gredzikk/kubisat/hardware/resource/RP2040-zero-09.png

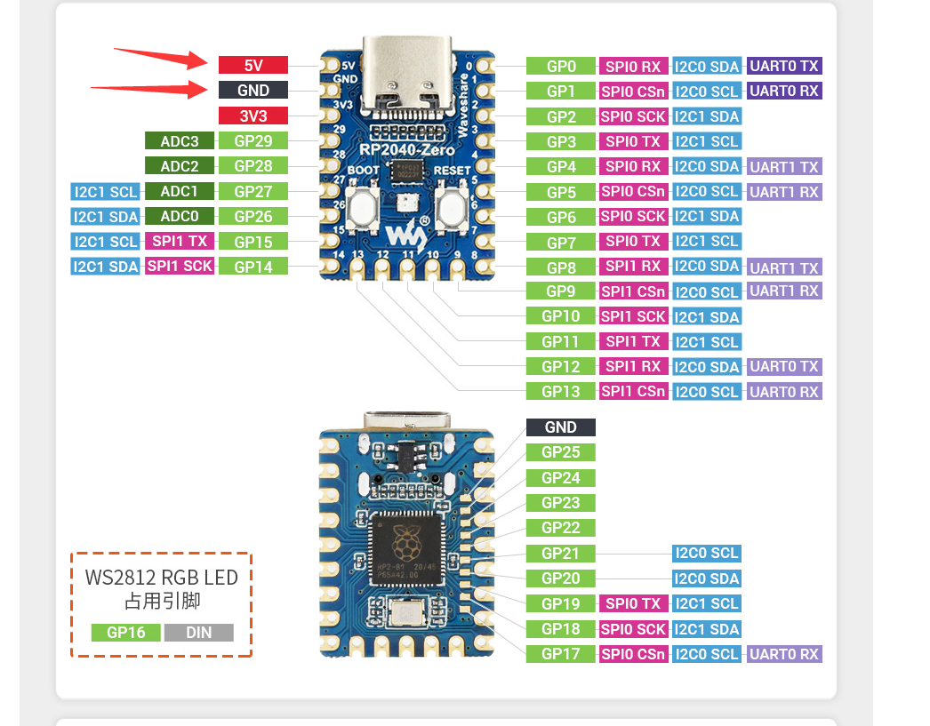
hardware/resource/RP2040-zero-09.png
