gredzikk/kubisat/hardware/resource/6bpcdpvqeob91.webp

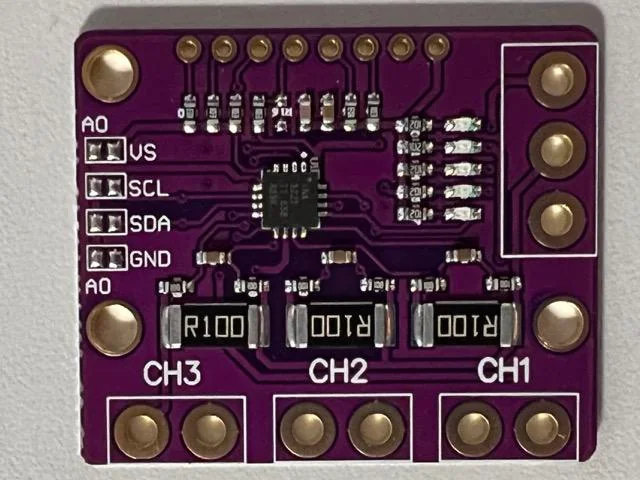
hardware/resource/6bpcdpvqeob91.webp
