gredzikk/kubisat/main.pdf

### Uniwersytet Mikołaja Kopernika w Toruniu

### Wydział Matematyki i Informatyki

### Jakub Gr˛edzicki

nr albumu: 316246

Praca dyplomowa inzynierska ˙

na kierunku Informatyka

# Budowa i działanie amatorskiego mikrosatelity w formacie CubeSat

Promotor

dr Marta Burzanska ´

Torun 2025 ´

# Spis tresci ´

1 Wst˛ep | 1
1.2 Przegl ˛ad aktualnych rozwi ˛azan | ´ | 2
2 Projekt | 6
3 Warstwa sprz˛etowa | 10
4 Software | 31
4.3 Menadzer stanu systemu | ˙ | 39
4.4 Menadzer zasilania | ˙ | 41
4.5 System zdarzen | ´ | 43

5 System operatora satelity | 72
6 Testy | 80
6.1 Testy polecen | ´ | 80
7 Podsumowanie | 84
7.2 Mozliwo ˙ | sci rozwoju | ´ | 84

# Wst˛ep

## 1.1 Wprowadzenie

W dzisiejszych czasach kosmiczne projekty uzytkowe, takie jak satelity mete- ˙

orologiczne, obserwacyjne, systemy nawigacyjne GPS czy Galileo, systemy telefonii

satelitarnej i Internetu, s ˛a powszechne w naszym codziennym zyciu. ˙

Wzrost liczby startów rakiet nosnych, rozwój współpracy agencji kosmicznych z ´

przemysłem i nauk ˛a oraz spadek cen komponentów elektronicznych i specjalistycz-

nych materiałów, umozliwiły mniejszym przedsi˛ebiorstwom specjalizuj ˛acym si˛e w okre- ˙

slonych obszarach technologii, udział w opracowaniu i przygotowaniu do wystrzelenia ´

sztucznych satelitów.

Koszty wysyłki sprz˛etu w przestrzen kosmiczn ˛a s ˛a przeliczane w dolarach na kilo- ´

gram masy ładunku, okreslanego jako tzw. payload. Współcze ´ | snie, komercyjne satelity ´

tworzone przez uczelnie i konsorcja, takze polskie, s ˛a faktem. ˙

Elektronika w przestrzeni kosmicznej to nie tylko sztuczne satelity, ale takze sys- ˙

temy kontrolne rakiet, łazików czy tez kombinezonów przeznaczonych do pracy pod- ˙

czas tzw. spacerów kosmicznych.

Sztuczne satelity mozna podzieli ˙ | c nie tylko ze wzgl˛edu na funkcjonalno ´ | s´c ale ´

takze z uwagi na rozmiary, a dokładniej - mas˛e startow ˛a: ˙

- Minisatelity - od 100 do 500 kg,
- Mikrosatelity - od 10 do 100 kg,
- Nanosatelity - od 1 do 10 kg,
- Pikosatelity - od 0,1 do 1 kg.
- Femtosatelity - ponizej 100 g. ˙
Jak widac, do kategorii satelitów małych mo ´ | zna zaliczy ˙ | c nawet relatywnie ci˛e ´ | zkie ˙
urz ˛adzenia, umozliwiaj ˛ace ˙ | swiadczenie usług komercyjnych. ´
Z uwagi na wci ˛az du ˙ | ze koszty wi ˛a ˙ | z ˛ace si˛e z wystrzeleniem aparatury na orbit˛e ˙

okołoziemsk ˛a, nowe firmy wkraczaj ˛ace w branz˛e space inwestuj ˛a głównie w mniejsze ˙

konstrukcje - nanosatelity.

Szczególnie obiecuj ˛acy okazuje si˛e przy tym standard znany jako CubeSat - jest

to szczególna grupa nanosatelitów o masie rz˛edu około 1-2 kg oraz formie, b˛ed ˛acej

wielokrotnosci ˛a “kostki jednostkowej"o wymiarach 100x100x113,5 mm [13], okre ´ | slanej ´

mianem unit st ˛ad tez cz˛esto spotykane oznaczenia typu 1U, 2U, 3U b ˛ad´z 6U. ˙

Najcz˛esciej stosowane s ˛a konstrukcje u ´ | zytkowe maj ˛ace wymiary na poziomie 3U ˙

podczas gdy mniejsze satelity (głównie 1U, rzadziej 2U) s ˛a ch˛etnie opracowywane

przez zespoły studenckie z wyzszych uczelni technicznych czy nawet amatorów elek- ˙

troniki.

Ograniczenia masowe i wymiarowe popychaj ˛a konstruktorów do stosowania nie-

zwykle interesuj ˛acych rozwi ˛azan, umo ´ | zliwiaj ˛acych zwi˛ekszenie funkcjonalno ˙ | sci minia- ´
turowego satelity juz po jego wystrzeleniu w otwart ˛a przestrze ˙ | n kosmiczn ˛a. ´

Otwarcie dost˛epu do przestrzeni kosmicznej - przede wszystkim niskiej orbity

okołoziemskiej - dla małych i srednich firm oraz wy ´ | zszych uczelni technicznych po- ˙
woduje, ze ro ˙ | snie liczba przedsi˛ebiorstw oraz projektów badawczych zwi ˛azanych z ´

branz ˛a space. ˙

## 1.2 Przegl ˛ad aktualnych rozwi ˛azan´

### 1.2.1 PW-SAT2

PW-Sat2 to innowacyjny projekt studentów Politechniki Warszawskiej, którego

głównym celem technologicznym było skonstruowanie i przetestowanie autorskiego

systemu deorbitacji. Podczas misji zostały przetestowane takze czujnik Sło ˙ | nca oraz ´

system otwieranych paneli słonecznych.

Studenci PW wpadli na pomysł, by po zakonczeniu swojej planowej misji satelita ´

rozwin ˛ał specjalny zagiel, który stopniowo obni ˙ | zaj ˛ac orbit˛e - spowoduje samoczynne ˙

spłoni˛ecie satelity w atmosferze. Dzi˛eki zastosowaniu odpowiedniej konstrukcji opartej

na spr˛ezynach płaskich oraz supercienkiej folii mylarowej, powierzchnia w pełni rozło- ˙

zonego ˙ | zagla wynosiła około 4m ˙

2
. Tak duza powierzchnia poprzez zwi˛ekszenie oporu ˙

aerodynamicznego skutecznie spowolniła ruch satelity i spowodowała jego deorbitacj˛e.

### 1.2.2 ARDUSAT

W 2013 roku wystrzelono w przestrzen kosmiczn ˛a dwa nanosatelity bazuj ˛ace na ´

platformie Arduino ArduSat-1 i ArduSat-X. Dwa bli´zniacze satelity o rozmiarze 1U były

wyposazone w komputery pokładowe o architekturze hierarchicznej (jeden procesor ˙

główny ATmega2561 zarz ˛adzaj ˛acy az szesnastoma podrz˛ednymi mikrokontrolerami ˙

ATmega328P, przeznaczonymi do realizacji poszczególnych eksperymentów).

Na pokładzie niepozornych konstrukcji znalazły si˛e liczne czujniki, w tym 3-osiowe

magnetometry, akcelerometry i zyroskopy, pirometry MLX90614, półprzewodnikowe ˙

czujniki temperatury TMP102, a takze sensory nat˛e ˙ | zenia ˙ | swiatła TSL2561, podwójne ´

liczniki Geigera, spektrometry optyczne oraz 1,3-megapikselowe kamery. CubeSaty

komunikowały si˛e z Ziemi ˛a za pomoc ˛a półdupleksowych transceiverów UHF w pasmie ´

435...438 MHz.

### 1.2.3 FossaSat-1

FossaSat-1 to kolejne osi ˛agni˛ecie w technologii pikosatelitarnej. Dzi˛eki swoim

rozmiarom wynosz ˛acym zaledwie 5 x 5 x 5 cm i wadze zaledwie 250 g jest jednym z

najmniejszych satelitów, jakie kiedykolwiek wystrzelono w przestrzen kosmiczn ˛a. ´

FossaSat-1 zapewnia bezpłatn ˛a komunikacj˛e IoT typu open source na całym

swiecie przy u ´ | zyciu niedrogich modułów radiowych LoRa, dzi˛eki którym studenci i ama- ˙

torzy radiotechniki mog ˛a komunikowac si˛e z satelit ˛a. ´

## 1.3 Cel pracy

Celem pracy było opracowanie oraz wykonanie od podstaw modelu mikrosatelity

zdolnego do odbycia lotu na balonie stratosferycznym w celu dokonania podstawowych

pomiarów oraz przetestowania sposobów komunikacji na odległos´c.´

Głównym motywem była ciekawos´c, ch˛e ´ | c poszerzenia wiedzy i umiej˛etno ´ | sci a ´

takze zainteresowanie technologiami kosmicznymi, informatyk ˛a oraz elektronik ˛a. Zde- ˙

cydowałem si˛e na samodzielne rozwi ˛azanie z racji wysokich kosztów rozwi ˛azan ko- ´

mercyjnych.

Ci ˛agły rozwój elektroniki uzytkowej i mo ˙ | zliwo ˙ | sci technologiczne pozwalaj ˛a na bu- ´

dow˛e tego typu satelit coraz mniejszym kosztem - dysponuj ˛ac budzetem 30 tys. euro ˙

jest mozliwym zbudowanie i wystrzelenie mikrosatelity na orbit˛e LEO. ˙

Przez coraz wi˛eksz ˛a dost˛epnos´c technologii space-grade powstały nawet spe- ´

cjalne serwisy oferuj ˛ace sprzedaz cz˛e ˙ sci i modułów do satelit jednak ich ceny nadal ´

s ˛a bardzo wysokie i cz˛esto nieosi ˛agalne bez sponsora lub innej formy finansowego

wsparcia.

Zmotywowało to mnie do zaprojektowania i zbudowania modelu satelity formatu

CubeSat b˛ed ˛acego w stanie odbyc co najmniej lot balonem stratosferycznym. ´

## 1.4 Zakres pracy

W niniejszej pracy poza w pełni samodzielnym projektem i wykonaniem skorzy-

stałem w pewnym stopniu z istniej ˛acych juz rozwi ˛aza ˙ | n - najcz˛e ´ | sciej sprawdzonych - ´

przeprowadzaj ˛ac na nich ewentualne modyfikacje.

Zakres pracy obejmuje trzy główne etapy: software, hardware oraz dokumentacj˛e.

### 1.4.1 Dokumentacja

- Spis wymagan funkcjonalnych i niefunkcjonalnych ´
- Diagram działania systemu operacyjnego
- Schemat obwodów elektronicznych modelu
- Zdefiniowanie modelu danych do komunikacji z modelem

### 1.4.2 Strona programowa

- Napisanie głównego programu kontroluj ˛acego prac˛e modelu
- Napisanie programu do obsługi stacji naziemnej do zdalnej komunikacji
- Testy jednostkowe i funkcjonalne

### 1.4.3 Strona sprz˛etowa

- Stworzenie obwodów drukowanych PCB
- Montaz podzespołów ˙
- Testy sprz˛etu
Przejscie wszystkich etapów powinno da ´ | c w wyniku operacyjny model satelity ´
zdolny do prowadzenia pomiarów podstawowych wielkosci fizycznych oraz umo ´ | zliwa- ˙

j ˛acym komunikacj˛e w trybie half-duplex w celu kontroli modelu oraz przesyłania zgro-

madzonych danych.

Dodatkowo w ramach pracy zaprojektowałem i skonstruowałem tez prost ˛a stacj˛e ˙

naziemn ˛a pozwalaj ˛aca na komunikacj˛e z modelem na odległos´c.´

## 1.5 Struktura pracy

Praca składa si˛e z XX rozdziałów. Rozdział pierwszy poza wprowadzeniem do

tematyki mikrosatelitów i technologii kosmicznej, oraz opisem wybranych projektów o

podobnej tematyce i funkcjonalnosci, zawiera tak ´ | ze zakres działa ˙ | n przeprowadzonych ´

w celu spełnienia stawianych załoze˙ n.´

W rozdziale drugim zdefiniowałem wymagania zarówno funkcjonalne jak i nie-

funkcjonalne przedstawianego projektu, przedstawiłem uzyte narz˛edzia oraz technolo- ˙

gie, oraz zaprezentowałem schemat blokowy modelu.

Rozdział trzeci zawiera opis projektu od strony sprz˛etowej, czyli wybór elementów

elektronicznych, wybrane schematy obwodów oraz opis wykonania.

Na rozdział czwarty składaj ˛a si˛e opisy i analizy poszczególnych elementów opro-

gramowania steruj ˛acego.

W rozdziale pi ˛atym znajduje si˛e prezentacja przykładowych danych zgromadzo-

nych podczas testu funkcjonalnego modelu oraz analiza wyników.

Ostatni rozdział to całokształt wykonanych prac, a takze wyci ˛agni˛ete przeze mnie ˙

wnioski podczas procesu tworzenia modelu.

# Projekt

## 2.1 Wprowadzenie

Całos´c projektu tworz ˛a dwa ´ | sci ´ sle poł ˛aczone ze sob ˛a moduły: ´
- sprz˛etowy - w jego skład wchodz ˛a: procesor, który kontroluje działanie pozosta-

łych podsystemów, a takze zestaw czujników zbieraj ˛acych dane fizyczne, moduł ˙

komunikacji odpowiadaj ˛acy za przesyłanie danych do i z satelity, moduł GPS

słuz ˛acy do okre ˙ | slenia pozycji oraz system zasilania. Cało ´ | s´c jest poł ˛aczona za ´

pomoc ˛a obwodów drukowanych i zamkni˛eta w obudowie formatu 1U.

- programowy - jego główn ˛a cz˛esci ˛a jest oprogramowanie pracuj ˛ace w pami˛eci ´

procesora, za posrednictwem portów IO i szyn komunikacyjnych jest w stanie ´

zarz ˛adzac cz˛e ´ | sci ˛a sprz˛etow ˛a projektu, realizowa ´ | c operacje odczytu i zapisu do ´
pami˛eci a takze odpowiada ˙ | c na pakiety komunikacyjne. ´

W ponizszym rozdziale omówiłem niektóre aspekty implementacji projektu. ˙

## 2.2 Wymagania funkcjonalne

System musi spełniac nast˛epuj ˛ace wymagania funkcjonalne: ´

- Wysyłanie danych z pomiarów do stacji naziemnych na z ˛adanie - jednorazowo ˙

lub cyklicznie

- Mozliwo ˙ s´c zmiany konfiguracji poprzez zdalne polecenie ´
- Odpowiednie reagowanie i odpowiadanie na polecenia
- Rejestrowanie danych z czujników i podsystemów do pami˛eci nieulotnej
- Podstawowa weryfikacja i kontrola poprawnosci przesyłanych danych ´
- Wykrywanie i raportowanie anomalii w systemie oparte na systemie zdarzen´
- Wszystkie operacje musz ˛a byc wykonywane w okre ´ | slonym czasie, np. przesył ´
danych nie moze trwa ˙ | c dłu ´ | zej ni ˙ | z 2 sekundy. ˙

## 2.3 Schemat blokowy modelu

Rysunek ponizej przedstawia ogólny schemat budowy modelu od strony sprz˛eto- ˙

wej. Cały system jest podzielony na mniejsze, cz˛esciowo niezale ´ | zne sekcje: ˙
- Procesor - jego głównymi zadaniami jest kontrola układów podrz˛ednych, obłsuga

pami˛eci oraz kodowanie i dekodowanie pakietów komunikacji modułu radiowego.

- Zasilanie - w skład sekcji wchodz ˛a ogniwa fotowoltaiczne, ładowarki, kontroler

zasilania oraz magazyn energii.

- Pami˛ec - na t ˛a cz˛e ´ | s´c składa si˛e karta pami˛eci SD która rejestruje dane teleme- ´

tryczne, pomiary z czujników oraz zdarzenia systemowe

- Komunikacja - podstaw ˛a tego podsystemu jest moduł radiowy działaj ˛acy w trybie

half-duplex oraz antena - słuz ˛a do wysyłania i odbierania danych telemetrycz- ˙

nych, kontrolnych oraz konfiguracyjnych

- Czujniki - ta sekcja składa si˛e z zestawu czujników maj ˛acych za zadanie dokony-
wac pomiarów ró ´ | znych wielko ˙ | sci fizycznych w trakcie lotu ´

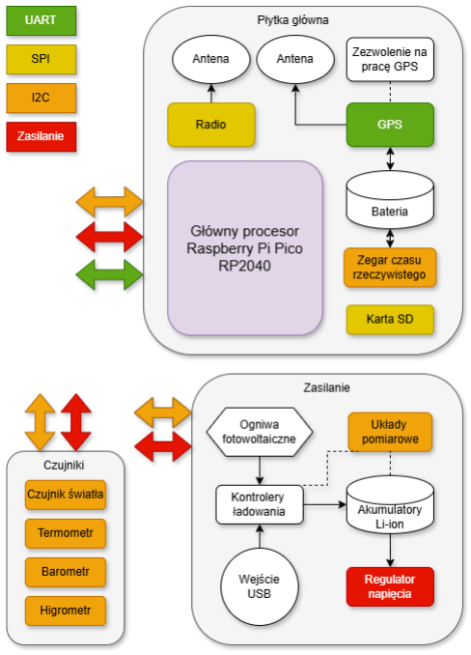
[picture p3: figure]

Rysunek 1: Schemat blokowy

## 2.4 Wykorzystane narz˛edzia

Do implementacji oprogramowania uzyłem ˙ srodowiska programistycznego Visual ´

Studio Code firmy Microsoft które jest wszechstronnym IDE wspieraj ˛acym proces two-

rzenia oprogramowania na mikrokontrolery oraz pozwalaj ˛acym na sprawne debugowa-

nie i monitorowanie działania aplikacji. Kompilacja odbywa si˛e przy uzyciu CMake. Za ˙

dostarczenie bibliotek do obsługi peryferiów mikrokontrolera odpowiada Pi Pico SDK.

W trakcie powstawania projektu korzystałem takze z platformy GitHub jako systemu ˙

kontroli wersji w celu łatwego kontrolowania zmian zachodz ˛acych w strukturze kodu.

Fusion 360 stworzony przez Autodesk były kluczowy w procesie projektowania

modelu 3d satelity. Do projektowania układów elektronicznych i obwodów drukowanych

uzyłem programu KiCad który jest open-source, a dzi˛eki du ˙ | zej dost˛epno ˙ | sci bibliotek ´
oraz rozbudowanej funkcjonalnosci pozwolił sprawnie wykona ´ | c projekt. Zarz ˛adzanie ´

projektem zrealizowałem przy uzyciu Trello produkcji Atlassian oraz funkcji Github Is- ˙

sues, co umozliwiło łatw ˛a organizacj˛e zada ˙ | n, kontrol˛e nad post˛epami w projekcie oraz ´

sledzenie bugów i wprowadzanie poprawek. ´

Wydrukowanie obudowy satelity oraz wyprodukowanie obwodów drukowanych

zrealizowałem korzystaj ˛ac z oferty firmy JLCPCB, która oferuje usługi wytwarzania ob-

wodów drukowanych w praktycznie dowolnej konfiguracji oraz drukowania 3D w wielu

technologiach.

# Warstwa sprz˛etowa

Dobór elementów elektronicznych do prezentowanego projektu nie był łatwym za-

daniem poniewaz wymagał gł˛ebszej analizy specyfikacji poszczególnych układów i ele- ˙

mentów dyskretnych w celu spełnienienia wi˛ekszych wymagan ni ´ | z typowa naziemna ˙
elektronika uzytkowa. Za cel stawiaj ˛ac sobie stworzenie modelu zdolnego odby ˙ | c lot ´

balonem stratosferycznym konieczne było dobranie elementów zdolnych do pracy w

szerszym zakresie temperatur. Bior ˛ac pod uwag˛e wysokos´c nad poziomem morza na ´

jak ˛a jest w stanie wznies´c si˛e tego typu balon odbiornik GPS równie ´ | z musi mie ˙ | c wi˛ek- ´
sze mozliwo ˙ | sci mi˛edzy innymi zdolno ´ | s´c pracy do wysoko ´ | sci 50000 m n.p.m. ´
Wi˛eksza wysokos´c oznacza równie ´ | z ni ˙ | zsz ˛a temperatur˛e co z kolei wymaga bar- ˙

dziej dokładnego zaprojektowania układu zasilania oraz izolacji termicznej całej obu-

dowy tak aby cenne ciepło zostawało w srodku. Kluczowym podzespołem s ˛a akumula- ´

tory, których pojemnos´c i sprawno ´ | s´c drastycznie spada wraz ze spadkiem temperatury. ´

Warstw˛e sprz˛etow ˛a podzieliłem na 3 osobne płytki b˛ed ˛ace niezaleznymi modu- ˙

łami.

## 3.1 Moduł zasilania

W skład tego modułu wchodz ˛a akumulatory wraz z zabezpieczeniami, układy

ładowania, przetwornica napi˛ecia oraz układ pomiarowy.

Interfejs tej płytki stanowi gniazdo JST 6 pin w którym umiesciłem sygnały szyny ´

I2C do komunikacji z układem pomiarowym, napi˛ecie wyjsciowe przetwornicy 5V oraz ´

dwa piny potencjału masowego. Ponizej umie ˙ | sciłem schemat przedstawi ˛acy przepływ ´
energii oraz zalezno ˙ | sci mi˛edzy poszczególnymi podzespołami. ´

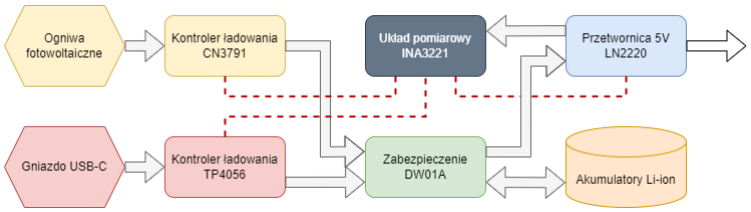
[picture p4: figure]

Rysunek 2: Diagram modułu zasilania

Magazyn energii stanowi ˛a dwa akumulatory litowo-jonowe w powszechnym for-

macie 18650 o napi˛eciu nominalnym 3.7V i pojemnosci 2000mAh. Łacz ˛ac je szere- ´

gowo uzyskałem ł ˛aczn ˛a pojemnos´c na poziomie 4000mAh. ´

Podczas pracy procesora z akumulatorów pobierany jest pr ˛ad o wartosci około ´

40mA co pozwala na teoretyczny czas pracy na poziomie 100 godzin. W praktyce czas

ten jest krótszy ze wzgl˛edu na inne układy pobieraj ˛ace pr ˛ad oraz straty w przetwornicy

napi˛ecia. Moduł GPS skonfigurowany w trybie High-Performance mode pobiera pr ˛ad

o wartosci około 80mA co w sumie daje 120mA - co skraca czas pracy 33 godzin. W ´

praktyce przelot balonu stratosferycznego trwa około 3 godzin co pozwala na zapew-

nienie zasilania przez cały lot.

Korzystaj ˛ac z tego faktu zaprojektowałem system zasilania tak aby mógł byc ła- ´

dowany na ziemi przez gniazdo USB typu C. Projekt przewiduje montaz paneli fotowol- ˙

taicznych na obudowie satelity w celu zbadania mozliwo ˙ sci ładowania akumulatorów w ´

trakcie lotu przez pomiar pr ˛adów i napi˛ec oraz pó´zniejsz ˛a analiz˛e tych danych. ´

### 3.1.1 Układ pomiaru napi˛ec i pr ˛adów ´

W trakcie pracy konieczny jest pomiar napi˛ecia baterii oraz napi˛ecia przetwornicy

5V, a takze pr ˛adów ładowania i rozładowania. Do tego celu u ˙ | zyłem układu INA3221, ˙
który pozwala na pomiar napi˛ec i pr ˛adów na trzech niezale ´ | znych kanałach. [6] Układ ˙

ten jako jedyny jest zasilany napi˛eciem 5V a komunikacja z układem steruj ˛acym od-

bywa si˛e po szynie I2C - konieczny jest konwerter poziomów logicznych z 5V na 3.3V

poniewaz na takim poziomie napi˛e ˙ | c operuje procesor. ´

INA3221 umozliwiaj pomiar pr ˛adu przez pmiar spadku napi˛ecia na rezystorach ˙

bocznikowych. Układ charakteryzuje si˛e wysok ˛a dokładnosci ˛a pomiaru ( ´ | ±0.5%) oraz

niskim poborem pr ˛adu (około 1mA w trybie pracy ci ˛agłej). Zastosowałem nast˛epuj ˛ace

konfiguracje kanałów pomiarowych:

Kanał Opis

1 | Napi˛ecie baterii i ładowanie USB
2 | Napi˛ecie przetwornicy 5V
3 | Pr ˛ad ładowania z paneli fotowoltaicznych

Tabela 3.1: Konfiguracja kanałów pomiarowych INA3221

Dzi˛eki rejestrowi konfiguracyjnemu mozliwe jest ustawienie liczby u ˙ | srednie ´ | n dla ´

pojedynczego pomiaru (od 1 do 1024), co pozwala na zwi˛ekszenie dokładnosci kosz- ´

tem cz˛estotliwosci akwizycji danych. W moim projekcie zastosowałem u ´ | srednianie 16 ´

próbek w ci ˛agłym trybie pracy, co zapewnia dobr ˛a równowag˛e mi˛edzy dokładnosci ˛a a ´

szybkosci ˛a pomiaru. ´

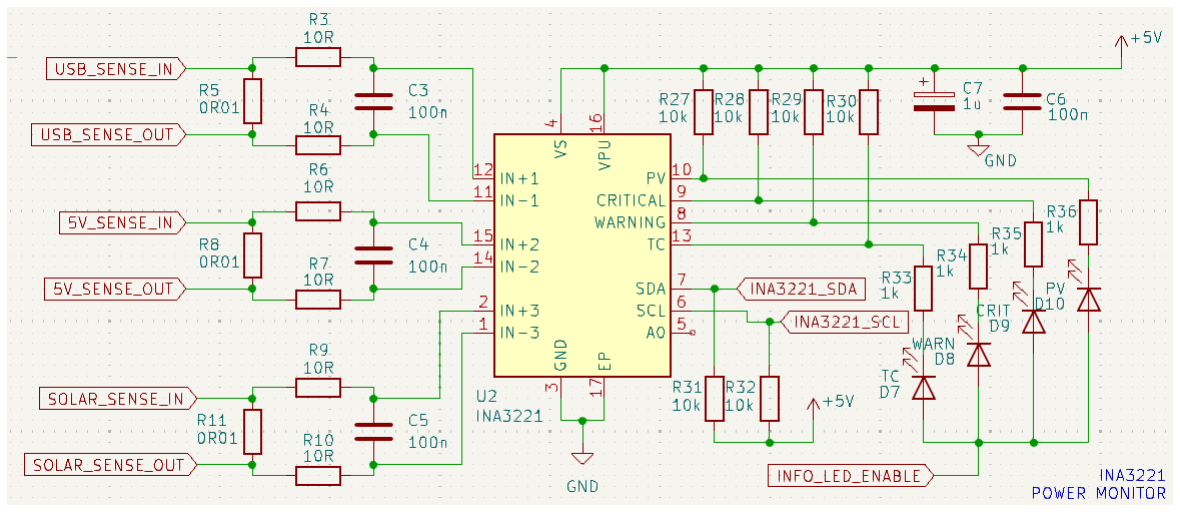
[picture p5: figure]

Rysunek 3: Schemat układu pomiarowego

### 3.1.2 Zabezpieczenie akumulatorów

Do zabezpieczenia akumulatorów uzyłem układu DW01A b˛ed ˛acego jednocze- ˙

snie zabezpieczeniem przed nadmiernym naładowaniem oraz rozładowaniem. Mini- ´

malne napi˛ecie akumulatorów jest ograniczone do 2.4V a maksymalne do 4.3V. Za-

chowuj ˛ac napi˛ecie akumulatorów mi˛edzy tymi dwiema wartosciami skutecznie chroni ´

je to przed degradacj ˛a i uszkodzeniem.

Układ DW01A współpracuje z podwójnym tranzystorem MOSFET FS8205A, two-

rz ˛ac pełne zabezpieczenie akumulatorów. Tranzystor FS8205A zawiera dwa kanały

typu N poł ˛aczone szeregowo ´zródłami, co tworzy przeł ˛acznik dwukierunkowy umoz-˙

liwiaj ˛acy odci˛ecie przepływu pr ˛adu zarówno podczas ładowania jak i rozładowywa-

nia. Taka konfiguracja eliminuje potrzeb˛e stosowania dodatkowych diod zabezpiecza-

j ˛acych.

W normalnym trybie pracy układ DW01A pobiera jedynie około 3 µA, co minimali-

zuje jego wpływ na samorozładowanie akumulatorów [3] Dzi˛eki zastosowaniu obudowy

SOT-23-6 zajmuje równiez niewiele miejsca na płytce PCB, co jest istotne przy kom- ˙

paktowej konstrukcji urz ˛adzenia.

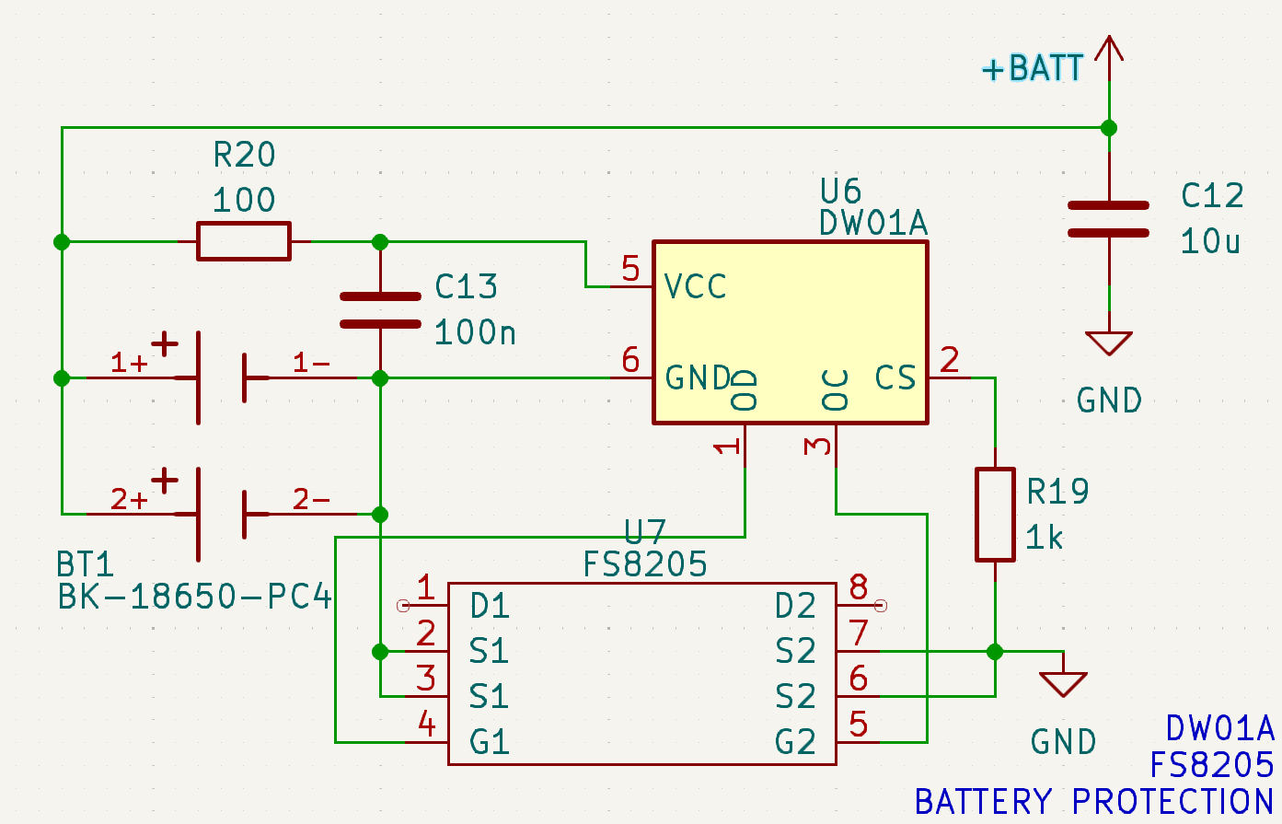
[picture p6: figure]

Rysunek 4: Schemat zabezpieczenia akumulatorów

### 3.1.3 Ładowarka 1 (USB)

W celu ładowania akumulatorów przez gniazdo USB typu C wykorzystałem po-

wszechnie stosowany układ TP4056, jego dost˛epnos´c jest bardzo wysoka i bardzo ła- ´

two go zintegrowac do własnego rozwi ˛azania. Maksymalne napi˛ecie zasilania TP4056 ´

to 8V jednak piny steruj ˛ace CC1 i CC2 gniazda USB skonfigurowałem tak aby napi˛e-

cie było równe 5V. Pr ˛ad ładowania jest konfigurowalny w zakresie 130-1000mA. Aby

ograniczyc wydzielanie ciepła w trakcie ładowania ograniczyłem je do około 780mA. ´

Układ TP4056 implementuje algorytm ładowania CC/CV (stały pr ˛ad/stałe napi˛e-

cie) odpowiedni dla akumulatorów litowo-jonowych. W pierwszej fazie ładowania do-

starcza stały pr ˛ad ustawiony za pomoc ˛a rezystora RPROG, po czym przechodzi do fazy

stałego napi˛ecia 4.2V, gdy akumulator osi ˛agnie odpowiedni poziom naładowania. Efek-

tywnos´c energetyczna układu wynosi około 80%, co jest typow ˛a warto ´ | sci ˛a dla linio- ´

wych ładowarek tego typu.

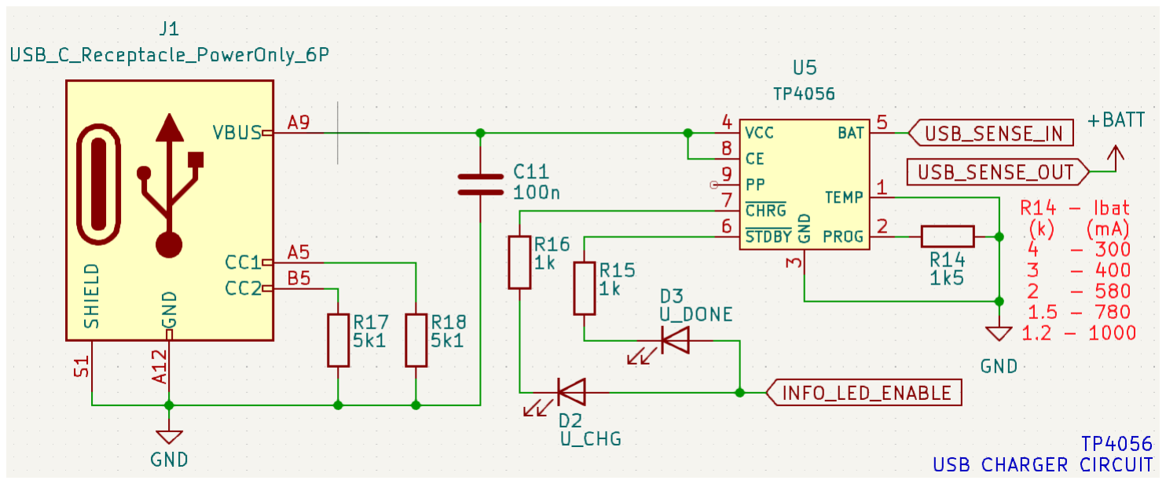
[picture p7: figure]

Rysunek 5: Schemat układu ładowania USB

### 3.1.4 Ładowarka 2 (panele fotowoltaiczne)

Do ładowania akumulatorów z paneli fotowoltaicznych zastosowałem układ CN3791.

Jest to kontroler ładowania MPPT (Maximum Power Point Tracking), który automatycz-

nie dostosowuje punkt pracy paneli fotowoltaicznych tak, aby uzyskac maksymaln ˛a ´

mozliw ˛a moc. Układ mo ˙ | ze pracowa ˙ | c z napi˛eciem wej ´ | sciowym od 4.5V do 28V, co po- ´

zwala na wykorzystanie szerokiej gamy paneli słonecznych.

CN3791 równiez realizuje algorytm ładowania CC/CV, jednak w przeciwie ˙ | nstwie ´

do TP4056 jest to przetwornica impulsowa typu buck, co zapewnia wi˛eksz ˛a sprawnos´c´

energetyczn ˛a przy konwersji napi˛ecia (do 96%). Napi˛ecie pracy MPPT ustawiłem na

poziom 4.9V, co jest optymalne dla zastosowanych paneli fotowoltaicznych.

Do sprawdzenia mozliwo ˙ | sci ładowania akumulatorów u ´ | zyłem ogniw o nast˛epuj ˛a- ˙

cych parametrach:

| | Parametr | Wartos´c´

Napi˛ecie znamionowe 5,5 V

| | Pr ˛ad znamionowy | 110 mA
| | Moc szczytowa | 0,55 W

Tabela 3.2: Parametry zastosowanego panelu fotowoltaicznego

Obudow˛e satelity zaprojektowałem tak aby umozliwi ˙ | c monta ´ | z 4 paneli fotowoltaicz- ˙

nych, po jednym na kazdej ˙ | scianie. Podstawa obudowy ma plan kwadratu co ozna- ´
cza ze maksymaln ˛a wydajno ˙ | s´c mog ˛a osi ˛agn ˛a ´ | c maksymalnie 2 panele jednocze ´ | snie. ´

Ogniwa zostały poł ˛aczone szeregowo w celu zwi˛ekszenia napi˛ecia wyjsciowego, a na- ´

st˛epnie podł ˛aczone do układu CN3791.

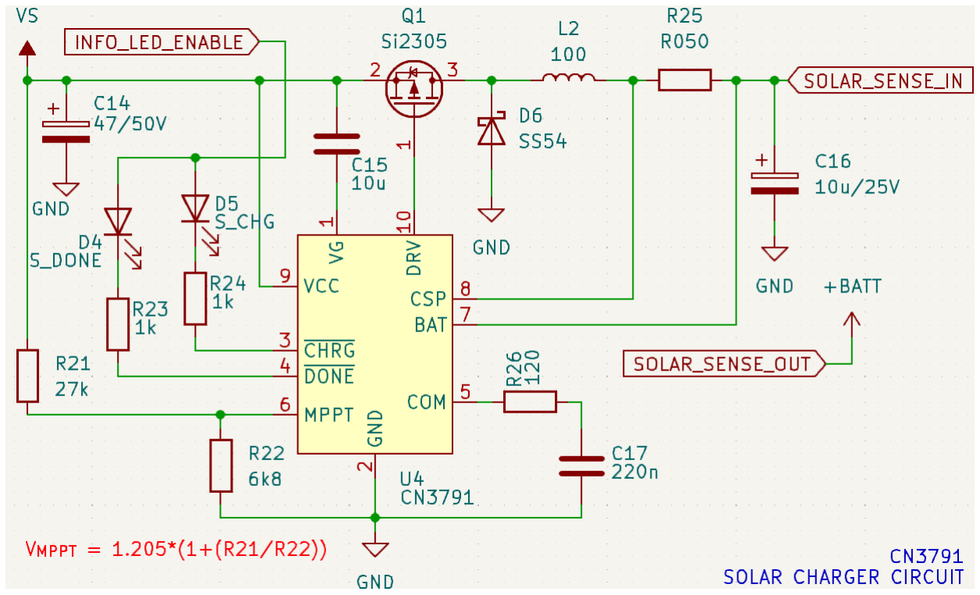
[picture p8: figure]

Rysunek 6: Schemat układu ładowania paneli fotowoltaicznych

### 3.1.5 Przetwornica 5V

Do konwersji napi˛ecia akumulatorów (3.7V nominalnie) na stabilne napi˛ecie 5V

wymagane przez układ pomiarowy INA3221 oraz inne komponenty systemu zasto-

sowałem przetwornic˛e impulsow ˛a opart ˛a na układzie LN2220. Jest to synchroniczna

przetwornica buck charakteryzuj ˛aca si˛e wysok ˛a sprawnosci ˛a (do 92%) przy obci ˛a ´ | ze- ˙

niach typowych dla projektowanego systemu [10]. Na ponizszych diagramach produ- ˙

centa mozna zauwa ˙ | zy˙ c´ ze przy obci ˛a ˙ | zeniu nieprzekraczaj ˛acym 150mA sprawno ˙ | s´c po- ´
zostaje na poziomie 90% z niewielkimi spadkami przy nizszych napi˛eciach wej ˙ | scio- ´

wych.

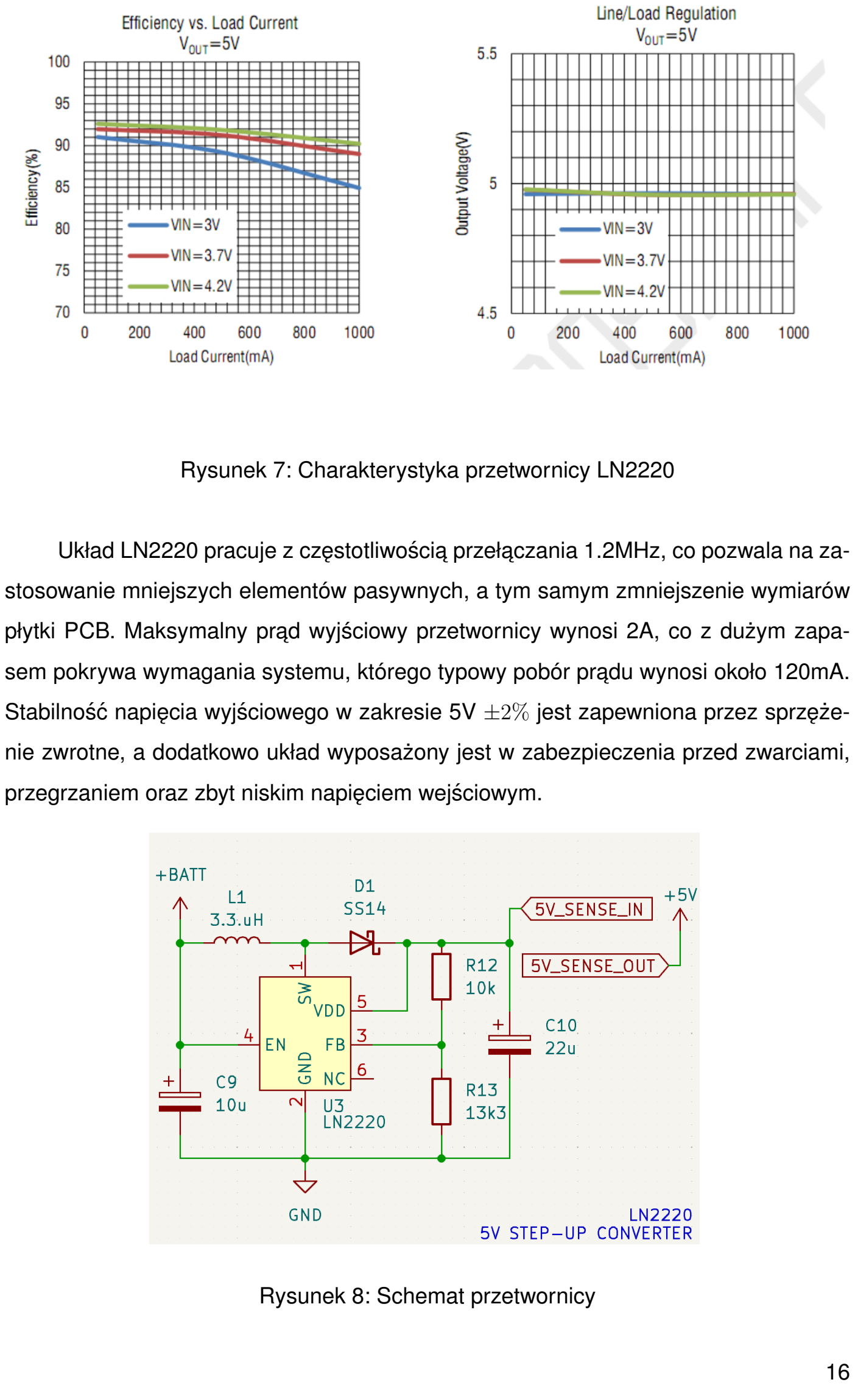
[picture p9: page 20]

Rysunek 7: Charakterystyka przetwornicy LN2220

Układ LN2220 pracuje z cz˛estotliwosci ˛a przeł ˛aczania 1.2MHz, co pozwala na za- ´

stosowanie mniejszych elementów pasywnych, a tym samym zmniejszenie wymiarów

płytki PCB. Maksymalny pr ˛ad wyjsciowy przetwornicy wynosi 2A, co z du ´ | zym zapa- ˙

sem pokrywa wymagania systemu, którego typowy pobór pr ˛adu wynosi około 120mA.

Stabilnos´c napi˛ecia wyj ´ | sciowego w zakresie 5V ´ | ±2% jest zapewniona przez sprz˛eze- ˙

nie zwrotne, a dodatkowo układ wyposazony jest w zabezpieczenia przed zwarciami, ˙

przegrzaniem oraz zbyt niskim napi˛eciem wejsciowym. ´

Rysunek 8: Schemat przetwornicy

## 3.2 Moduł steruj ˛acy

Sekcj˛e kontroli i sterowania zbudowałem w oparciu o płytk˛e prototypow ˛a Rasp-

berry Pi Pico, wspomagan ˛a odbiornikiem GPS, modułem radiowym LoRa pracuj ˛acym

w trybie half-duplex, zegarem RTC oraz kart ˛a SD do przechowywania danych. Praca

całego programu jest podzielona na dwa w ˛atki, po jednym na kazdy rdze ˙ | n procesora. ´

Rdzen 0 odpowiada tylko za obsług˛e komunikacji - odbieranie, przetwarzanie i ´

wysyłanie ramek komunikacji 4.2. Rdzen 1 odpowiada za zbieranie danych z GPS ´

oraz dane telemetryczne - pomiary z czujników, napi˛ec i pr ˛adów oraz zapisywanie ich ´

na kart˛e SD.

Wyprowadziłem osobne zł ˛acza zawieraj ˛ace magistrale I2C, SPI oraz dodatkowe

zasilanie - słuz ˛a one do podł ˛aczenia płytki z czujnikami. Uruchomienie systemu od- ˙

bywa si˛e poprzez zasilenie płytki Pi Pico z wewn˛etrznego zasilania lub z zewn˛etrznego

´zródła 5V. Sekwencja startowa została opisana w 4.1.1

### 3.2.1 Procesor

Głównym procesorem jest dwurdzeniowy mikrokontroler RP2040 produkowany

przez Raspberry Pi Foundation. Jest on zbudowany w oparciu o architektur˛e ARM Cor-

tex M0+ z taktowaniem 133MHz. Jest wyposazony w 264kB pami˛eci operacyjnej, po- ˙

dwójne interfejsy UART, SPI oraz I2C. Zaletami układu s ˛a jego mozliwo ˙ | sci, dost˛epno ´ | s´c,´
cena a takze popularno ˙ | s´c i wsparcie które oferuje sam producent oraz społeczno ´ | s´c en- ´
tuzjastów Raspberry. Przekłada si˛e to na duz ˛a dost˛epno ˙ | s´c materiałów, dokumentacji ´

oraz dobrze przygotowane SDK, które poza tworzeniem kodu pozwala takze na jego ˙

debugowanie w czasie rzeczywistym. Program aktualnie wykonywany przez procesor

znajduje si˛e w pami˛eci QSPI FLASH, w której mozna równie ˙ | z umie ˙ | sci ´ c inne dane jak ´

konfiguracje, pomiary lub logi. Przetwornica dostarcza napi˛ecia 3.3V wymaganego do

zasilania procesora, pami˛eci oraz zewn˛etrznych podzespołów.

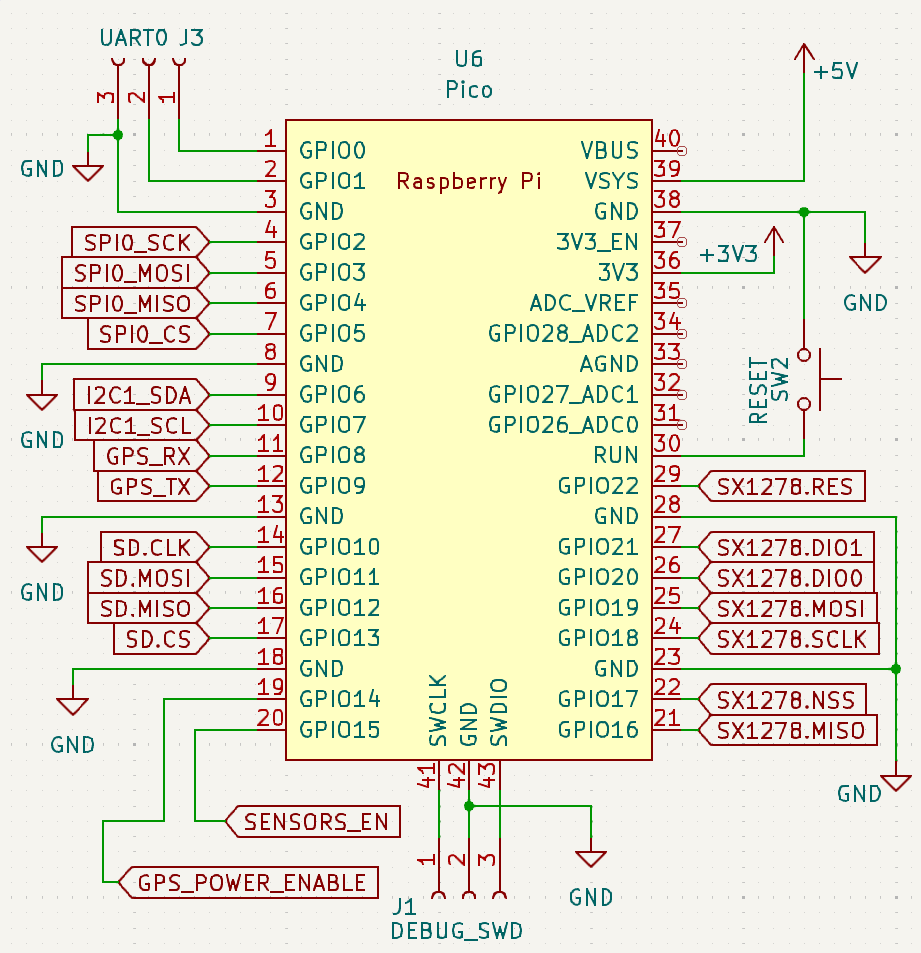
[picture p10: figure]

Rysunek 9: Schemat poł ˛aczen procesora ´

### 3.2.2 Moduł komunikacji radiowej

Odpowiada za komunikacj˛e modelu z stacj ˛a naziemn ˛a, moze pracowa ˙ | c z cz˛esto- ´
tliwosci ˛a z zakresu 410-525MHz z maksymaln ˛a pr˛edko ´ | sci ˛a 300 kbps [8]. ´

Moc wyjsciowa to +18dBi co w otwartej przestrzeni pozwala na uzyskanie zasi˛egu ´

do 700m jednak s ˛a dowody na udane przesyłanie danych na odległos´c ponad 700km. ´

[11] Moduł LoRa s ˛a bardzo popularne w przemysle i komunikacji urz ˛adze ´ | n przeno- ´
snych, cz˛esto s ˛a te ´ | z wykorzystywane jako główny moduł komunikacyjny w satelitach ˙

typu CubeSat [5].

Zuzycie pr ˛adu w stosunku do zasi˛egu jest bardzo niskie dlatego jest to idealny ˙

moduł do zastosowan gdzie zasilanie jest ograniczone np. w modelach lataj ˛acych. Dla ´

pracy na cz˛estotliwosci 433MHz pobór pr ˛adu prezentuje si˛e nast˛epuj ˛aco: ´

Stan | Pobór pr ˛adu [mA]
Odbiór | 12.1
Nadawanie | 93
Oczekiwanie | 1.6

Tabela 3.3: Pobór pr ˛adu modułu SX1278

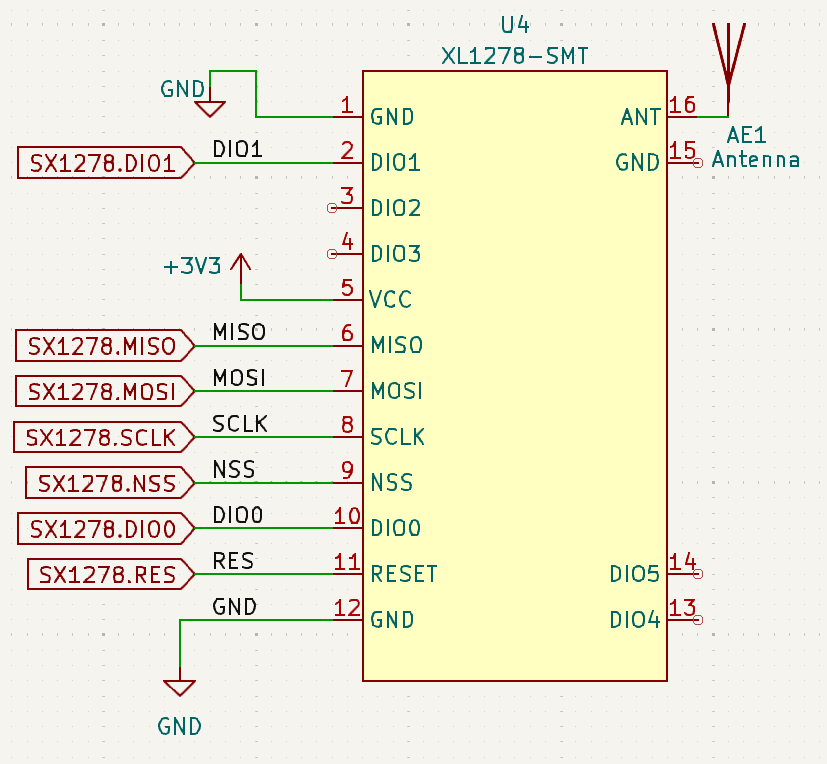
[picture p11: figure]

Rysunek 10: Schemat poł ˛aczen modułu radiowego ´

### 3.2.3 Odbiornik GPS

Moduł GPS NEO-6M jest odbiornikiem GPS pracuj ˛acym w pasmie L1 (1575.42 ´

MHz), dane nawigacyjne s ˛a aktualizowane i przesyłane co sekund˛e przez port szeregowy UART [12]. Format danych to NMEA-0183, który jest standardem w nawigacji

morskiej i lotniczej.

Słuzy do ˙ | sledzenia pozycji modelu z precyzj ˛a 2.5m co po zako ´ | nczeniu lotu po- ´

zwala na odnalezienie modelu w terenie. Z tego powodu zasilanie modułu GPS jest

wł ˛aczone na cały czas i w trybie lotu nie jest mozliwe jego zdalne wył ˛aczenie. ˙

Zmiana stanu zasilania modułu jest realizowana przez miniaturow ˛a przetwornic˛e

DC-DC, która dostarcza napi˛ecie 3.3V z zasilania 5V. Posiada ona wejscie EN (Enable) ´

które pozwala na wł ˛aczenie/wył ˛aczenie w przetwornicy i w efekcie wł ˛aczenie/wył ˛acze-

nie modułu GPS. Wejscie EN jest podł ˛aczone do pinu GPIO procesora, co pozwala na ´

zmian˛e stanu zasilania modułu GPS z poziomu oprogramowania.

Moduł posiada wbudowan ˛a anten˛e ceramiczn ˛a, która jest wystarczaj ˛aca do uzy-

skania sygnału w otwartej przestrzeni.

Zimny start ¹
| | trwa około 30 sekund, nast˛epnie almanach i efemeryda zostaj ˛a zapi-

sane w pami˛eci modułu - przy kolejnych uruchomieniach modułu (hot start²
) obliczenie

pozycji zajmuje znacznie mniej czasu gdy dane s ˛a w miar˛e aktualne.

Dodatkowa bateria CR2032 zapobiega utracie danych w przypadku zaniku zasi-

lania. Proces uzyskiwania lokalizacji przez moduł GPS przebiega nast˛epuj ˛aco:

1. Inicjalizacja modułu.
2. Nasłuchiwanie sygnałów z widocznych satelitów (minimum 3 dla pozycji 2D, 4 dla

pozycji 3D).

3. Dekodowanie danych nawigacyjnych zawieraj ˛acych efemerydy i almanachy.
4. Obliczenie pseudoodległosci do ka ´ | zdego satelity na podstawie opó´znienia sy- ˙

gnału.

5. Triangulacja pozycji na podstawie danych z wielu satelitów.

1Zimny start oznacza uruchomienie modułu po całkowitym wyczyszczeniu danych nawigacyjnych -

np. przy pierwszym uruchomieniu lub po rozładowaniu baterii podtrzymuj ˛acej. W tym trybie moduł musi

pozyskac pełne dane efemerydy od satelitów, co trwa zwykle ponad 30 sekund. ´
2Hot start to tryb uruchomienia, w którym moduł GPS posiada aktualne dane efemerydy, wazn ˛a ˙

pozycj˛e, czas oraz almanach. W takim przypadku czas do uzyskania pierwszej poprawnej pozycji (TTFF)

wynosi zaledwie 1-3 sekundy.

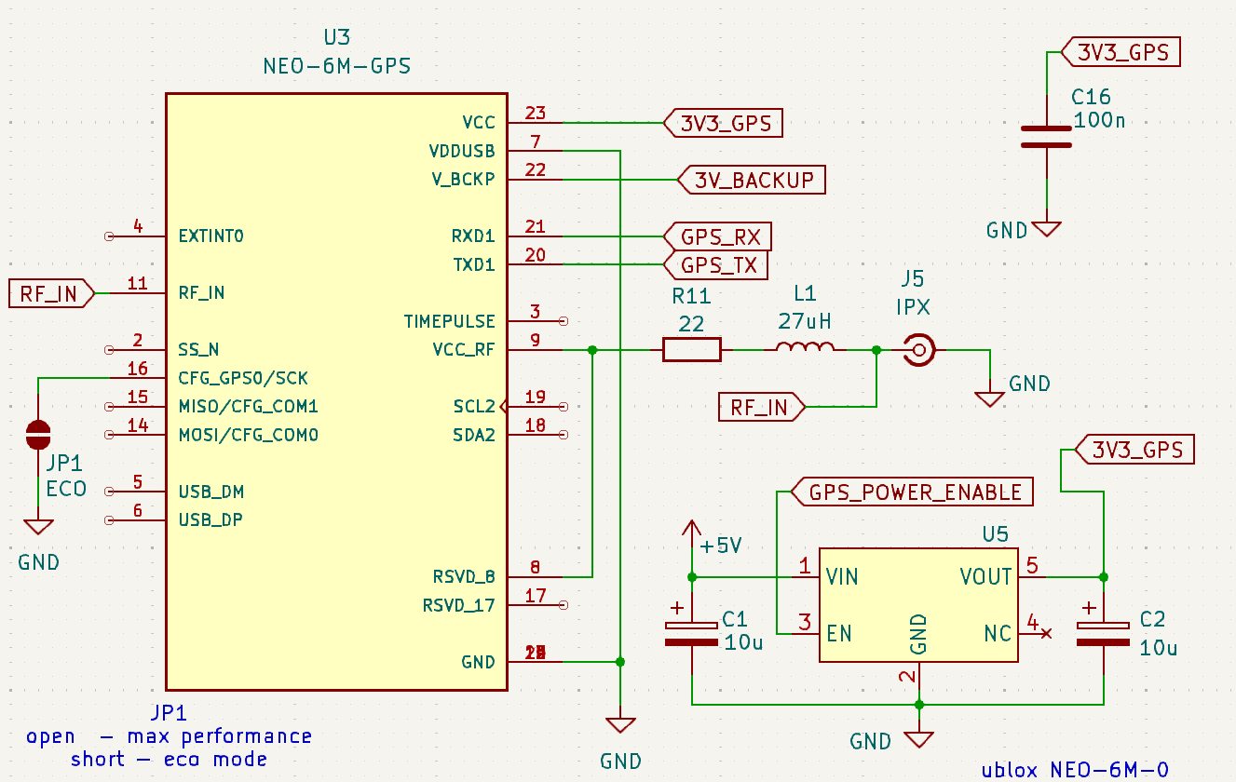
[picture p12: figure]

Rysunek 11: Schemat poł ˛aczen modułu GPS ´

### 3.2.4 Zegar czasu rzeczywistego

DS3231 to precyzyjny zegar czasu rzeczywistego z wbudowanym termometrem,

komunikuj ˛acy si˛e przez interfejs I2C.

Ten moduł przechowuje czas w postaci godzin, minut i sekund oraz dat˛e w po-

staci roku, miesi ˛aca i dnia. Cechuje go wysoka dokładnos´c - ´ ±3.5 ppm w zakresie tem-

peratur od −40◦C do +85◦C, co odpowiada odchyleniu maksymalnie około 9 sekund

na miesi ˛ac. Jest to mozliwe dzi˛eki wbudowanemu kompensowanemu temperaturowo ˙

oscylatorowi kwarcowemu (TCXO).

Zegar obsługuje format 12/24-godzinny oraz automatycznie uwzgl˛ednia róznice ˙

w długosci miesi˛ecy i lata przest˛epne, dzi˛eki czemu nie wymaga r˛ecznego korygowania ´

daty.

Do podtrzymania chodu zegara przy zaniku zasilania słuzy bateria CR2032 współ- ˙

dzielona z odbiornikiem GPS. Dzi˛eki temu system zachowuje aktualn ˛a dat˛e i czas

nawet po wył ˛aczeniu zasilania, co jest kluczowe dla prawidłowego znakowania czasowego wszystkich zbieranych danych telemetrycznych.

Moduł DS3231 jest konfigurowany przez mikrokontroler przy starcie systemu, a

w razie potrzeby jego ustawienia mog ˛a byc zmieniane zdalnie poprzez odpowiednie ´

komendy wysyłane przez ł ˛acze radiowe.

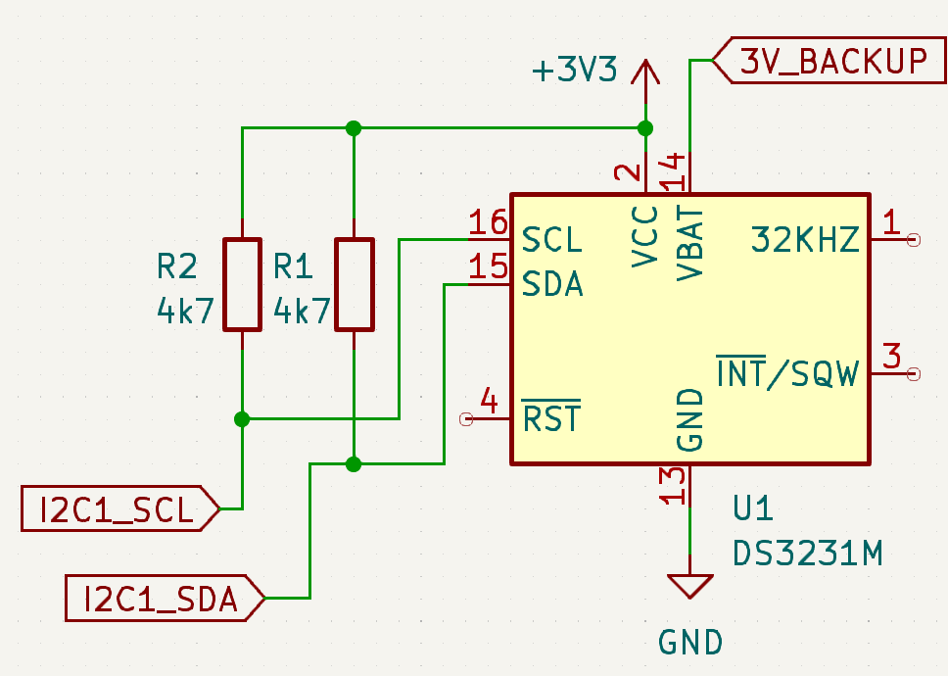
[picture p13: figure]

Rysunek 12: Schemat poł ˛aczen zegara czasu rzeczywistego ´

### 3.2.5 Pami˛ec´

Jako magazyn na dane telemetryczne, pomiary z czujników oraz logi zdarzen syste- ´

mowych uzyłem karty pami˛eci SD o pojemno ˙ | sci 2GB. Zapisuj ˛ac dane na karcie, po ´
zakonczeniu lotu mo ´ | zna w łatwy sposób odczyta ˙ | c wszystkie zebrane informacje. Karta ´

korzysta ekskluzywnie z interfejsu spi1 co pozwala na szybki i niezakłócony dost˛ep do

danych. Na karcie s ˛a rejestrowane dwa rodzaje danych: wszystkie pomiary z czujników

srodowiskowych, pomiary napi˛e ´ | c i pr ˛adów, aktualna lokalizacja oraz data i godzina, a ´
takze zdarzenia np. obni ˙ | zenie napi˛ecia poni ˙ | zej progu, zmiana zegaru itp. wraz z do- ˙
kładn ˛a dat ˛a i godzin ˛a wyst ˛apienia. Te dane mozna równie ˙ | z odczyta ˙ | c zdalnie u ´ | zywaj ˛ac ˙

odpowiednich polecen.´

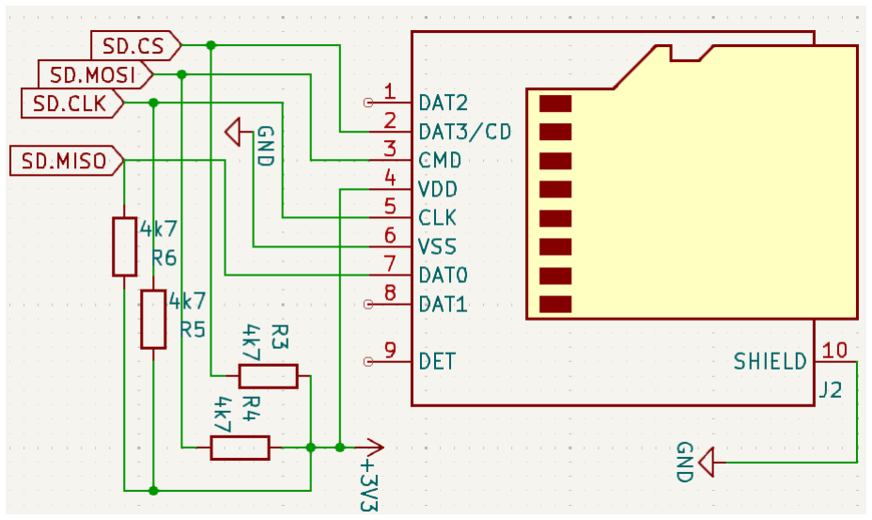
[picture p14: figure]

Rysunek 13: Schemat poł ˛aczen karty pami˛eci SD ´

## 3.3 Moduł czujników

Poza wyzej wymienionymi model daje mo ˙ | zliwo ˙ | s´c podł ˛aczenia szeregu ró ´ | znych ˙
czujników srodowiskowych, zarówno po szynie I2C jak i SPI. Płytka jest wyposa ´ | zona ˙

w zł ˛acze zasilania 5V, zł ˛acze I2C oraz SPI. W biez ˛acej konfiguracji zdecydowałem ˙

si˛e na 4 standardowe listy kołkowe o rastrze 2.54mm z 8 pinami kazda, poł ˛aczone z ˙

gniazdem I2C. Pozwala to na podł ˛aczenie 4 róznych czujników jednocze ˙ | snie, co jest ´

wystarczaj ˛ace do celów testowych. Oba moduły czujników maj ˛a identyczn ˛a kolejnos´c´

wyprowadzen co znacznie ułatwiło projektowanie oraz zadecydowało o wyborze takiej ´

a nie innej konfiguracji. Schemat poł ˛aczen modułu czujników przedstawia rysunek 14. ´

### 3.3.1 Barometr, termometr, higrometr

W projekcie wykorzystałem czujnik BME280 firmy Bosch, który integruje w jed-

nym układzie trzy podstawowe czujniki srodowiskowe. Jest to układ o niewielkich wy- ´

miarach (2.5 x 2.5 x 0.93 mm), komunikuj ˛acy si˛e przez interfejs I2C lub SPI. W moim

projekcie wybrałem komunikacj˛e I2C ze wzgl˛edu na mniejsz ˛a liczb˛e wymaganych linii.

BME280 oferuje nast˛epuj ˛ace mozliwo ˙ | sci pomiarowe: ´
- Pomiar cisnienia atmosferycznego w zakresie 300-1100 hPa z dokładno ´ | sci ˛a ´ | ±1

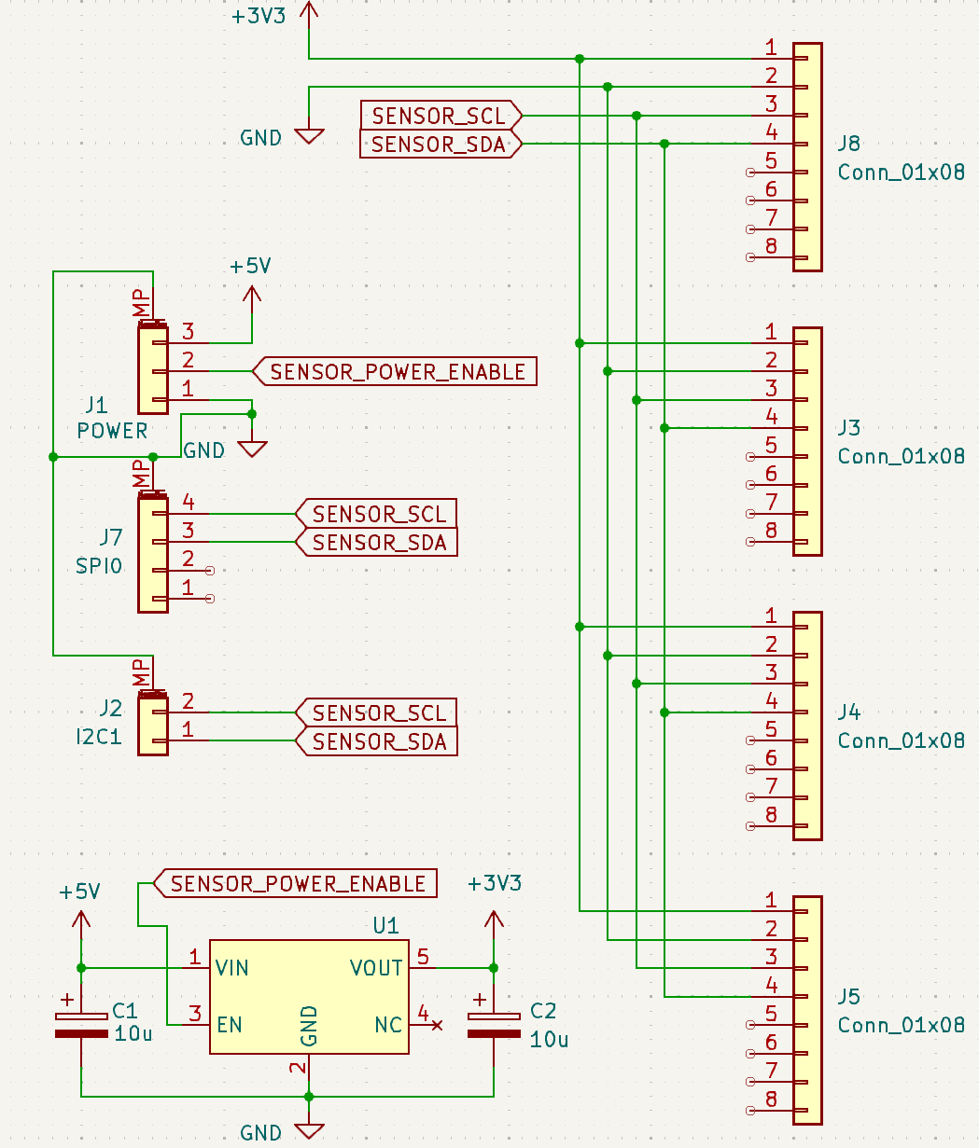
[picture p15: figure]

Rysunek 14: Schemat poł ˛aczen modułu czujników ´

hPa

- Pomiar temperatury w zakresie -40°C do +85°C z dokładnosci ˛a ´ ±1

◦C

- Pomiar wilgotnosci wzgl˛ednej w zakresie 0-100% z dokładno ´ | sci ˛a ´ | ±3%

Układ charakteryzuje si˛e niskim poborem pr ˛adu (3.6 µA przy pomiarze raz na

sekund˛e) oraz szybkim czasem reakcji. Dzi˛eki pomiarowi cisnienia atmosferycznego ´

mozliwe jest okre ˙ | slenie przybli ´ | zonej wysoko ˙ | sci modelu nad poziomem morza, co sta- ´
nowi uzupełnienie danych z GPS. Róznica ci ˙ | snienia o 1 hPa odpowiada w przybli ´ | zeniu ˙
zmianie wysokosci o około 8,3 m na niskich wysoko ´ | sciach. ´

Dane z czujnika s ˛a odczytywane w regularnych interwałach czasowych i zapisy-

wane na karcie SD oraz przekazywane w ramkach telemetrycznych do stacji naziem-

nej, dostarczaj ˛ac informacji o warunkach atmosferycznych otoczenia modelu podczas

lotu.

### 3.3.2 Czujnik swiatła ´

Do pomiaru nat˛ezenia ˙ swiatła wykorzystałem czujnik cyfrowy BH1750 komuni- ´

kuj ˛acy si˛e przez magistral˛e I2C. Jest to kompletny 16-bitowy przetwornik swiatła na ´

wartos´c cyfrow ˛a z wbudowan ˛a funkcj ˛a kompensacji czuło ´ | sci widmowej zgodnej z ludz- ´

kim okiem.

Czujnik BH1750 oferuje nast˛epuj ˛ace mozliwo ˙ sci: ´

- Szeroki zakres pomiarowy od 1 do 65535 luksów
- Pomiar z rózn ˛a rozdzielczo ˙ | sci ˛a (0.5 lx, 1 lx, 4 lx) zale ´ | znie od wybranego trybu ˙
- Niewielki pobór pr ˛adu: 120 µA podczas pomiaru, <1 µA w trybie uspienia ´
- Wbudowany filtr odpowiadaj ˛acy krzywej czułosci spektralnej oka ludzkiego ´

Czujnik ten pozwala na monitorowanie warunków oswietleniowych podczas lotu, ´

co moze by ˙ | c u´ zyteczne do rejestracji warunków ˙ | srodowiskowych. Ponadto, nagłe zmiany ´
nat˛ezenia ˙ | swiatła mog ˛a sygnalizowa ´ | c przej ´ | scie modelu z cienia w ´ | swiatło słoneczne ´
lub odwrotnie, co moze mie ˙ | c znaczenie dla interpretacji danych z innych czujników, ´

szczególnie temperatury.

Dane z czujnika swiatła s ˛a odczytywane w regularnych odst˛epach czasu i za- ´

pisywane wraz z pozostałymi danymi telemetrycznymi, co pozwala na ich pó´zniejsz ˛a

analiz˛e w kontekscie trasy lotu modelu. ´

## 3.4 Obudowa

Obudow˛e zaprojektowałem w programie Autodesk Fusion 360, który pozwala

na tworzenie modeli 3D oraz generowanie dokumentacji technicznej. Model obudowy

składa si˛e z 6 cz˛esci: 4 elementów naro ´ | znych oraz 2 elementów podstawy. Wszyst- ˙
kie elementy zostały zaprojektowane tak, aby mozna je było wydrukowa ˙ | c na drukarce ´
3D FDM. Zgodnie z wczesniejszymi zało ´ | zeniami zgodno ˙ | sci ze standardem CubeSat, ´

obudowa ma wymiary 100 x 100 x 113,5mm [13].

Podstawa ma grubos´c 10mm co jest kompromisem mi˛edzy wytrzymało ´ | sci ˛a a ilo- ´
sci ˛a miejsca wewn ˛atrz obudowy. Na ka ´ | zdym boku znajduj ˛a si˛e otwory monta ˙ | zowe o ˙
srednicy 3mm, które umo ´ | zliwiaj ˛a przykr˛ecenie elementów naro ˙ | znych. Dodatkowo w ˙
poblizu naro ˙ | zników znajduj ˛a si˛e otwory o ˙ | srednicy 3mm do monta ´ | zu obwodów dru- ˙

kowanych. Pusty obszar w srodku zapewnia łatwy dost˛ep do akumulatorów i gniazd ´

ładowania od spodu, natomiast jako górna cz˛es´c obudowy pozwala na łatwy dost˛ep do ´

modułów czujników i gniazd komunikacyjnych.

Kazdy z modułów opisanych wcze ˙ | sniej (3.1, 3.2, 3.3) posiada na swojej płytce ´
otwory montazowe, które umo ˙ | zliwiaj ˛a przykr˛ecenie ich do obudowy za pomoc ˛a po- ˙

liamidowych elementów dystansowych o długosci 22mm. Dobrałem je tak, aby suma ´

ich długosci oraz grubo ´ | sci płytki wynosiła 93.5mm dzi˛eki czemu zniwelowałem ryzyko ´

napr˛eze˙ n w obudowie. ´

Obudow˛e mozna łatwo rozdzieli ˙ | c na dwie cze ´ | sci co zapewniło łatwy dost˛ep do ´

wn˛etrza w razie potrzeby co widac na renderach 17 oraz 19. ´

Dodatkowo po zmontowaniu mi˛edzy elementami naroznymi przewidziałem moco- ˙

wania na ogniwa fotowoltaiczne o wymiarach 70x70x3mm. Render w pełni złozonego ˙

modelu bez ogniw przedstawiłem na rysunku 20. W pełni kompletny model znajduje

si˛e na rysunku 21.

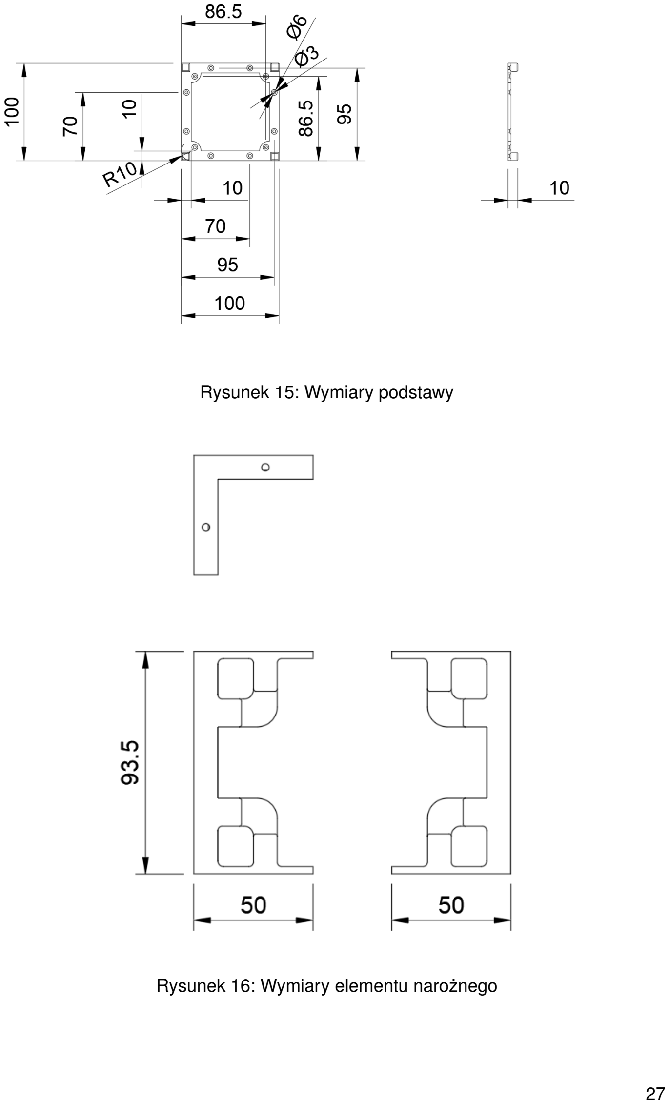
[picture p16: page 31]

Rysunek 15: Wymiary podstawy

Rysunek 16: Wymiary elementu naroznego ˙

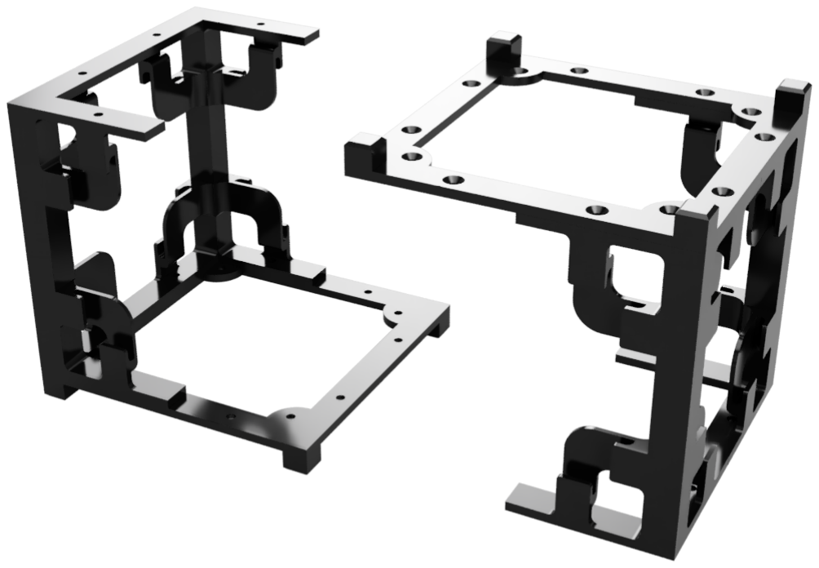
[picture p17: figure]

Rysunek 17: Obudowa podzielona na dwie czesci ´

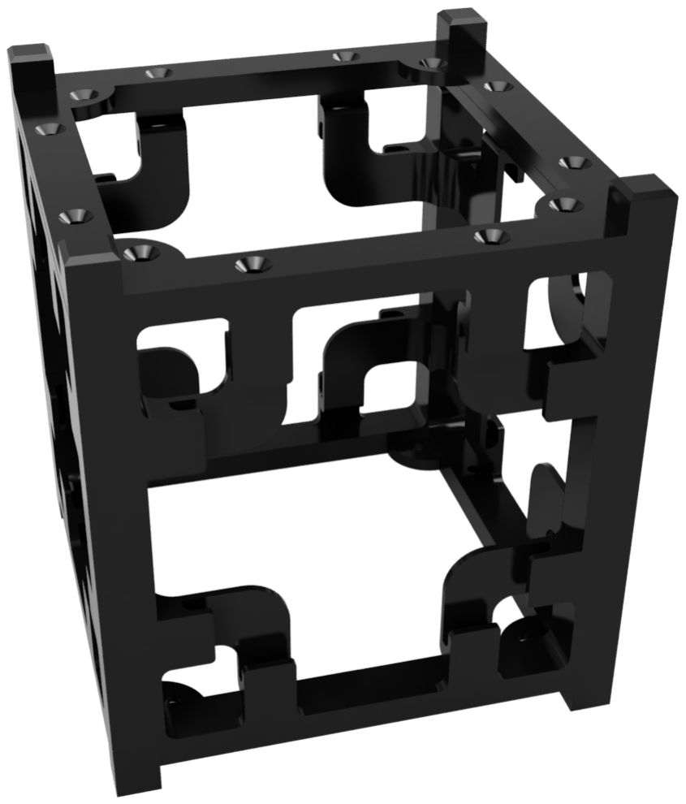
[picture p18: figure]

Rysunek 18: Obudowa zmontowana

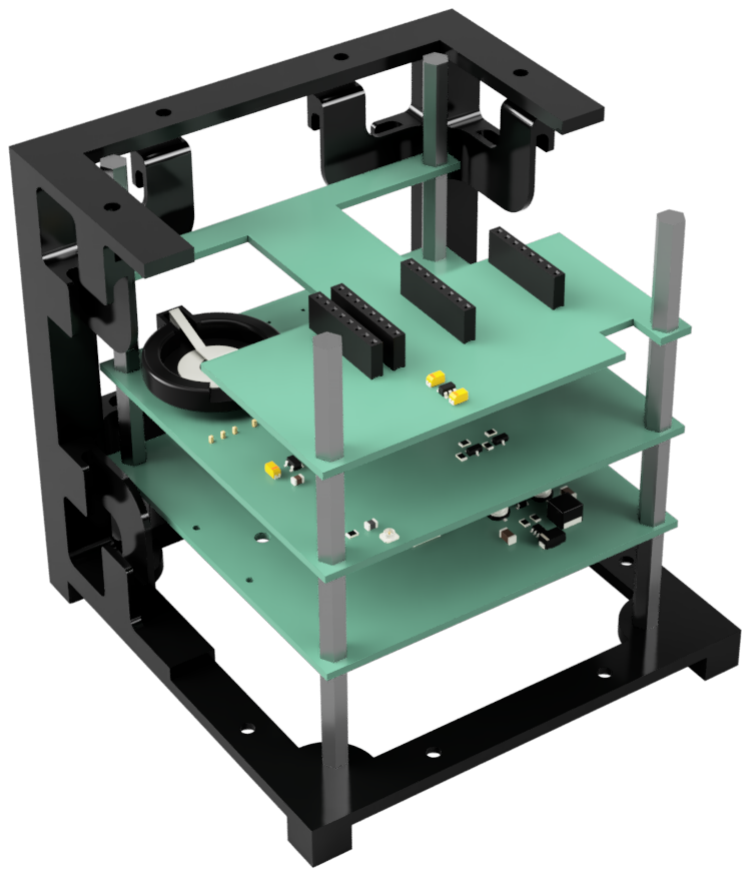
[picture p19: figure]

Rysunek 19: Czesciowo otwarta obudowa. Widoczne s ˛a elementy dystansowe oraz ´

mocuj ˛ace. Z odkrytej strony znajduj ˛a si˛e gniazdo USB płytki Raspberry Pi, slot kart SD

oraz gniazdo baterii zapasowej.

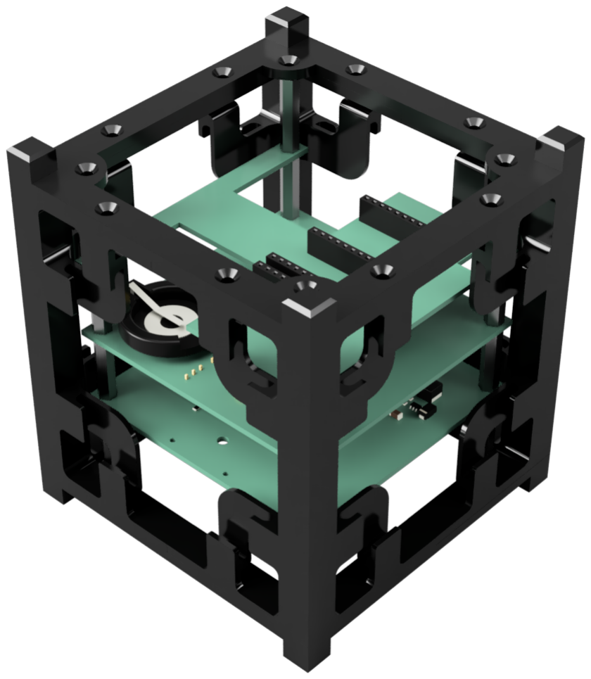
[picture p20: figure]

Rysunek 20: Obudowa kompletna bez ogniw

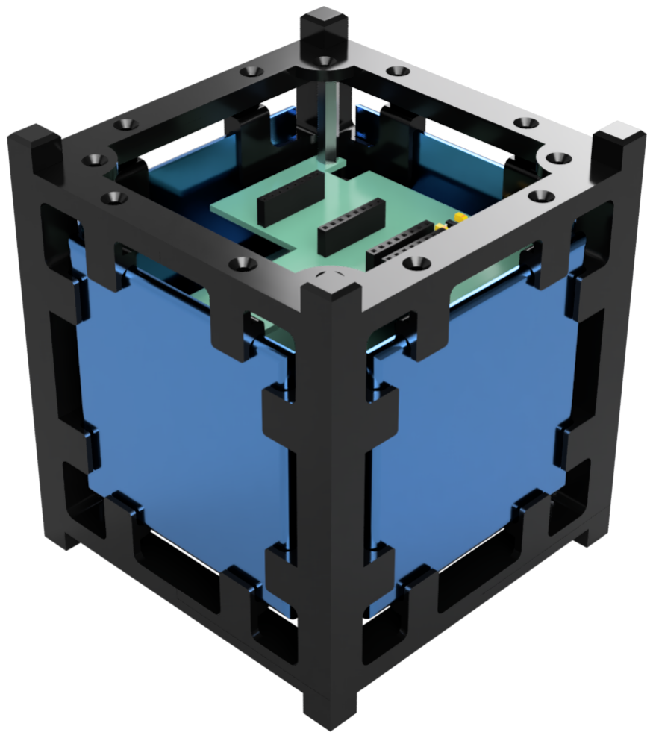
[picture p21: figure]

Rysunek 21: Obudowa z ogniwami fotowoltaicznymi

# Software

## 4.1 Architektura systemu

### 4.1.1 Uruchamianie systemu

Sekwencja startowa przebiega w nast˛epuj ˛acy sposób:

1. Inicjalizacja sprz˛etowa mikrokontrolera Raspberry Pi Pico:
(a) Konfiguracja standardowego wejscia/wyj ´ | scia poprzez ´ | stdio_init_all()
(b) Inicjalizacja portów UART:
- uart0 - debugowanie i komunikacja
- uart1 - GPS
(c) Konfiguracja pinów GPIO, w tym diody LED
(d) Inicjalizacja magistral I2C:
- i2c0 - INA3221 oraz zegar czasu rzeczywistego
- i2c1 - czujniki srodowiskowe ´
(e) Wł ˛aczenie zasilania GPS i czujników
(f) Utworzenie instancji SystemStateManager
(g) Emisja zdarzenia GPSEvent::POWER_ON
2. Inicjalizacja modułów peryferyjnych:
(a) Inicjalizacja modułu radiowego i zapisanie statusu
(b) Montowanie karty SD i weryfikacja statusu
(c) Utworzenie pliku dziennika na karcie SD (jesli dost˛epna) ´
(d) Inicjalizacja czujników srodowiskowych i ´ | swiatła ´
(e) Zapisanie statusów inicjalizacji w menedzerze stanu systemu ˙
(f) Wysłanie ramki potwierdzaj ˛acej rozpocz˛ecie pracy przez radio
3. Okreslenie trybu pracy systemu: ´

(a) Inicjalizacja i konfiguracja menedzera zasilania ˙
(b) Odczyt napi˛ecia baterii i poboru pr ˛adu
(c) Okreslenie ´zródła zasilania (USB lub bateria) ´
(d) Ustawienie odpowiedniego trybu pracy w SystemStateManager
4. Uruchomienie drugiego rdzenia:
(a) Start funkcji core1_entry() na drugim rdzeniu procesora
(b) Inicjalizacja menedzera telemetrii ˙
(c) Uruchomienie p˛etli obsługuj ˛acej:
- Zbieranie danych GPS
- Zbieranie i zapisywanie danych telemetrycznych
- Obsług˛e z ˛ada ˙ n resetu do trybu bootloadera ´
5. Finalizacja procesu uruchomienia:
(a) Wygenerowanie i wysłanie komunikatu o trybie pracy
(b) Zapisanie informacji o zakonczeniu inicjalizacji z timestampem ´
(c) Przejscie do głównej p˛etli programu na pierwszym rdzeniu ´

## 4.2 Model komunikacji

W trakcie działania satelity konieczna jest komunikacja z systemem naziemnym

w celu przesyłania danych telemetrycznych, konfiguracji oraz zarz ˛adzania systemem.

Generowane i przetwarzane s ˛a duze ilo ˙ | sci ró ´ | znego rodzaju danych - steruj ˛ace działa- ˙

niem systemu, zawieraj ˛ace informacje o stanie technicznym oraz pomiary z czujników.

Uzytkownik nie powinien mie ˙ | c mo ´ | zliwo ˙ | sci wpływania na działanie systemu w spo- ´

sób niezamierzony, dlatego zaimplementowałem prosty protokół komunikacyjny, który

pozwala na odczyt i modyfikacj˛e tylko wybranych parametrów oraz wykonywanie okre-

slonych polece ´ | n.´

Odczytywanie danych oraz zmiana parametrów odbywa si˛e za pomoc ˛a systemu

komend które bezposrednio operuj ˛a na poszczególnych podsystemach. Zdecydowa- ´

łem si˛e na to w celu zapewnienia pewnego poziomu izolacji mi˛edzy uzytkownikiem a ˙

systemem, co zwi˛eksza bezpieczenstwo i stabilno ´ | s´c działania. ´
Kazde polecenie ma zdefiniowane prawa dost˛epu, które okre ˙ | slaj ˛a dozwolone ro- ´

dzaje operacji - odczyt, zapis lub odczyt i zapis. Proces przetwarzania ramki komuni-

kacyjnej jest zabezpieczony przed bł˛edami i zapewnia bezpieczne wykonanie operacji.

Przebiega on w nast˛epuj ˛acy sposób:

1. Pocz ˛atkowy odbiór danych
- Główna p˛etla w main.cpp sprawdza czy moduł radiowy lub port szeregowy

otrzymały dane

- Po odebraniu pakietu LoRa wywoływana jest funkcja on_receive(packet_size)
- Dla danych z portu szeregowego wywoływana jest funkcja handle_uart_input()
2. Przetwarzanie odebranych danych LoRa w on_receive
- Odczyt surowych bajtów z modułu LoRa do bufora
- Sprawdzenie rozmiaru pakietu (nieprzekraczaj ˛acy MAX_PACKET_SIZE)
- Przekazanie bufora do funkcji process_lora_packet()
3. Przetwarzanie metadanych pakietu w process_lora_packet
- Sprawdzenie rozmiaru pakietu (minimum 2 bajty)
- Ekstrakcja i walidacja informacji adresowych (pierwsze 2 bajty)
- Sprawdzenie czy adres docelowy zgadza si˛e z adresem lokalnym
- Sprawdzenie czy adres ´zródłowy zgadza si˛e z oczekiwanym adresem zdal-

nym

- Utworzenie ci ˛agu znaków z pozostałych bajtów (własciwy ładunek) ´
- Wyswietlenie zrzutu szesnastkowego dla celów debugowania ´
- Przekazanie wyodr˛ebnionego ci ˛agu znaków do extract_and_process_frames()
4. Przetwarzanie danych UART w handle_uart_input
- Odczyt znaków z portu szeregowego do bufora
- Gdy napotkany zostanie znak konca linii ( ´ | \r lub \n):

– Wyswietlenie odebranego ci ˛agu znaków dla celów debugowania ´

– Przekazanie bufora do extract_and_process_frames()

– Wyczyszczenie bufora

5. Ekstrakcja i przetwarzanie ramek w extract_and_process_frames
- Iteracyjne wyszukiwanie par znaczników FRAME_BEGIN ("KBST") i FRAME_END

("TSBK")

- Dla kazdej znalezionej pary: ˙

– Wyodr˛ebnienie kompletnej ramki mi˛edzy znacznikami

– Przekazanie wyodr˛ebnionej ramki do frame_process() z odpowiednim

typem interfejsu

- Obsługa przypadku braku prawidłowych ramek w danych
6. Przetwarzanie ramki w frame_process
- Dekodowanie ramki przy uzyciu ˙ frame_decode()
- Obliczenie klucza komendy na podstawie grupy i ID komendy
- Wywołanie execute_command() z kluczem komendy, wartosci ˛a i typem ope- ´

racji

7. Wykonanie komendy w execute_command
- Wyszukanie obsługi komendy w mapie command_handlers
- Wywołanie odpowiedniej funkcji obsługi (np. handle_list_files)
- Sprawdzenie poprawnosci rodzaju operacji (GET/SET) ´
- Wygenerowanie odpowiedzi w postaci jednej lub wi˛ecej ramek
8. Wysyłanie odpowiedzi
- Zakodowanie kazdej ramki odpowiedzi przy u ˙ | zyciu ˙ | frame_encode()
- W przypadku interfejsu LoRa, przekazanie ramki przez radio
- W przypadku interfejsu UART, wysłanie ramki przez port szeregowy

### 4.2.1 Interfejsy komunikacyjne

W modelu satelity dost˛epne s ˛a dwa interfejsy: lokalny - port UART oraz zdalny

- moduł LoRa. Oba interfejsy obsługuj ˛a z ˛adania i odpowiedzi w formie ramek w iden- ˙

tyczny sposób przy czym odpowied´z jest zwracana na interfejs który wysłał z ˛adanie. ˙

Ponizszy rysunek w uproszczeniu przedstawia schemat komunikacji w systemie: ˙

Rysunek 22: Schemat komunikacji w systemie

Port szeregowy

W ramach implementacji systemu komunikacji, wykorzystałem interfejs UART

jako podstawowy kanał do debugowania i kontroli satelity. Zaimplementowałem wie-

lopoziomowy system logowania z nast˛epuj ˛acymi poziomami szczegółowosci: ´

- ERROR - krytyczne bł˛edy systemu (czerwony kolor)
- WARNING - ostrzezenia i wa ˙ | zne zdarzenia ( ˙ | zółty kolor) ˙
- INFO - informacje o normalnej pracy (zielony kolor)
- DEBUG - szczegółowe informacje diagnostyczne (niebieski kolor)

Komunikacja przez UART została zabezpieczona mutexem, co zapewnia bez-

pieczny dost˛ep z obu rdzeni procesora. Kazdy komunikat jest opatrzony znacznikiem ˙

czasu (w milisekundach od uruchomienia) oraz identyfikatorem rdzenia, z którego zo-

stał wysłany.

Port szeregowy wykorzystywany do bezposredniej interakcji z systemem, konfi- ´

guracji oraz monitorowania stanu systemu to port uart0 pracuj ˛acy z pr˛edkosci ˛a 115200 ´

baud.

Zaimplementowałem równiez tryb przekierowania komunikacji GPS na port de- ˙

bugowania, co umozliwia bezpo ˙ | sredni ˛a konfiguracj˛e modułu GPS poprzez oprogramo- ´

wanie u-center - szczegółowy opis tego trybu znajduje si˛e w sekcji4.10.5.

Moduł radiowy

Obsług˛e modułu radiowego LoRa zrealizowałem za pomoc ˛a biblioteki pico-lora[2],

która dostarcza interfejs do obsługi modułu SX1278. Moduł komunikuje si˛e z proceso-

rem za pomoc ˛a interfejsu spi0 z cz˛estotliwosci ˛a 8MHz, do którego ma ekskluzywny ´

dost˛ep. Wysyłanie i odbieranie danych odbywa si˛e w trybie half-duplex, co oznacza ze˙

moduł nie moze odbiera ˙ | c danych podczas nadawania i odwrotnie. ´

### 4.2.2 Struktura ramki komunikacyjnej

Rozmiar ramki jest ograniczony przez mozliwo ˙ sci modułu radiowego i wynosi ´

maksymalnie 255 bajtów. Odliczaj ˛ac informacje dodatkowe (nagłówek, stopka, typ ope-

racji, identyfikatory grupy i polecenia oraz znaki oddzielaj ˛ace) pozostaje około 235 baj-

tów na dane. W przypadku polecen których zło ´ | zono ˙ | s´c przekracza ten limit, dane s ˛a ´

przesyłane w formie sekwencji, gdzie kazda ramka zawiera fragment danych. ˙

Komendy s ˛a przesyłane w ustandaryzowanej formie ramki komunikacji a jej ogólna

struktura jest opisana w tabeli 4.2.

Typy operacji

Typ operacji Opis

GET | Z ˛adanie odczytu danych, wysyłane przez stacj˛e naziemn ˛a ˙
SET | Z ˛adanie ustawienia warto ˙ | sci parametru ´
RES | Potwierdzenie wykonania operacji
VAL | Przesłanie wartosci (odpowied´z na GET) ´
SEQ | Element sekwencji danych (np. przy przesyłaniu logów)
ERR | Sygnalizacja bł˛edu wykonania operacji

Tabela 4.1: Typy operacji

Element | Format | Opis
Nagłówek | KBST | Stały znacznik pocz ˛atku ramki
Kierunek | 0/1 | 0: stacja→satelita, 1: satelita→stacja

Typ operacji GET/SET
| RES/VAL/ERR/SEQ | Rodzaj operacji w ramce
Grupa | 0-10 | Identyfikator podsystemu (np. zasilanie,
| | GPS)
Polecenie | 0-10 | Identyfikator konkretnej komendy w grupie
Wartos´c | string | Parametry lub dane odpowiedzi ´
Jednostka | string | Jednostka wartosci (np. V, mA, s) (opcjo- ´
| | nalnie)
Stopka | TSBK | Stały znacznik konca ramki ´

Tabela 4.2: Struktura ramki komunikacyjnej

Poszczególne pola s ˛a oddzielone znakiem srednika (;), co ułatwia parsowanie i ´

debugowanie.

Grupy komend

Grupa Opis

1 | Diagnostyka systemu
3 | Zarz ˛adzanie zegarem
5 | System zdarzen´
7 | Obsługa GPS
8 | System telemetrii

Tabela 4.3: Grupy komend

Przykładowe ramki dla róznych typów operacji: ˙

KBST;0;GET;1;1;;TSBK

Pobranie wartosci parametru z grupy 1, polecenie 1 - wersja oprogramowania. W ´

przypadku operacji GET pole wartosci jest puste. ´

KBST;0;SET;7;1;1;TSBK

Zapis wartosci 1 do parametru z grupy 7, polecenie 1 - sterowanie zasilaniem ´

GPS (0 - wył ˛aczony, 1 - wł ˛aczony). W przypadku operacji SET pole wartosci ´

zawiera wartos´c do zapisu. ´

KBST;1;RES;1;8;3;TSBK

Potwierdzenie wykonania operacji SET w grupie 1, polecenie 5 - zmiana poziomu

logowania wiadomosci UART. Pole warto ´ | sci zawiera warto ´ | s´c w postaci tekstowej ´

oznaczaj ˛acy wynik operacji.

KBST;1;VAL;3;4;25.25;C;TSBK

Odpowied´z na z ˛adanie odczytu warto ˙ | sci z grupy 3, polecenie 4 - temperatura ´
zmierzona przez układ zegara. Pole wartosci zawiera odczytan ˛a warto ´ | s´c (25.25), ´

a pole jednostki zawiera ’C’.

KBST;1;SEQ;1;0;1.0-1.1-1.2-1.3-1.8-1.9-3.0-3.1-3.4-5.1-5.2-7.1-7.2-8.2-8.3;TSBK

KBST;1;VAL;1;0;SEQ_DONE;TSBK

Element sekwencji danych - odpowied´z na z ˛adanie odczytu danych z grupy 1, po- ˙

lecenie 0 - odczyt informacji o dost˛epnosci polece ´ | n w aktualnie pracuj ˛acej wersji ´

programu. Pole wartosci zawiera sekwencj˛e grupa-polecenie oddzielone krop- ´

kami. W przypadku gdy dost˛epnych polecen byłoby wi˛ecej, sekwencja zostałaby ´

podzielona na kilka ramek. Ostatnia ramka zawiera informacj˛e o zakonczeniu se- ´

kwencji.

KBST;1;ERR;3;0;INVALID_FORMAT;;TSBK

Sygnalizacja bł˛edu w przetwarzaniu polecenia w grupie 3, polecenie 0 - ustawie-

nie czasu. Pole wartosci zawiera kod bł˛edu ’INVALID_FORMAT’ informuj ˛acy o ´

przyczynie bł˛edu - nieprawidłowy format danych.

Taka struktura ramek zapewnia jednoznaczn ˛a identyfikacj˛e pocz ˛atku i konca ramki, ´

łatw ˛a rozszerzalnos´c protokołu o nowe komendy, efektywne wykrywanie i obsług˛e bł˛e- ´

dów oraz mozliwo ˙ | s´c przesyłania danych w ró ´ | znych formatach i jednostkach. ˙

## 4.3 Menad˙zer stanu systemu

### 4.3.1 Wprowadzenie

W ramach implementacji systemu zarz ˛adzania stanem całego systemu stwo-

rzyłem klas˛e SystemStateManager, która wykorzystuje wzorzec projektowy Singleton.

Klasa ta słuzy jako centralny punkt do przechowywania i zarz ˛adzania ró ˙ | znymi stanami ˙

systemowymi satelity.

### 4.3.2 Zarz ˛adzanie stanem

Zaimplementowałem nast˛epuj ˛ace stany systemowe:

1 | // Flaga oznaczająca oczekujące żądanie ponownego uruchomienia systemu w trybie
| wymiany oprogramowania
| bool pending_bootloader_reset;
| // Flaga oznaczająca żadanie wstrzymania zbierania danych GPS
| bool gps_collection_paused;
| // Flaga oznaczająca stan zamontowania karty SD
6 | bool sd_card_mounted;
| // Poziom szczegółowości logów UART
| VerbosityLevel uart_verbosity;
| // Flaga oznaczają stan inicjacjizacji karty SD
| bool sd_card_init_status;
11 | // Flaga oznaczają stan inicjalizacji radia
| bool radio_init_status;
| // Flaga oznaczają stan inicjalizacji czujnika poziomu oświetlenia
| bool light_sensor_init_status;
| // Flaga informująca o stanie inicjalizacji czujnika środowiskowego
16 | bool env_sensor_init_status;
| // Mutex dla bezpiecznego dostępu do zmiennych stanu
| recursive_mutex_t mutex_;

Listing 4.1: Stany systemowe

### 4.3.3 Tryb pracy satelity

Przy starcie systemu, układ pomiarowy na podstawie wartosci napi˛e ´ | c baterii i ´

zasilania oraz pobieranego przez system pr ˛adu okresla czy satelita jest w trakcie lotu ´

(pracuje na własnym zasilaniu) czy w trybie naziemnym (zasilany z USB).

W trybie naziemnym wszystkie polecenia s ˛a aktywne i dozwolone jest ich wyko-

nywanie. W trybie lotu niektóre polecenia np. wył ˛aczenie zasilania GPS s ˛a dezaktywo-

wane aby zapobiec niepoz ˛adanemu działaniu systemu. ˙

### 4.3.4 Komendy diagnostyczne

System diagnostyczny udost˛epnia nast˛epuj ˛ace komendy słuz ˛ace do monitorowa- ˙

nia i kontroli stanu systemu:

ID | Format komendy | Opis
1.0 KBST;0;GET;1;0;;TSBK | Wyswietla list˛e wszystkich dost˛epnych ko- ´
| | mend systemowych wraz z ich identyfika-
| | torami.
1.1 KBST;0;GET;1;1;;TSBK | Pobiera numer wersji oprogramowania
| | układowego (firmware).
1.2 KBST;0;GET;1;2;;TSBK | Pobiera aktualny tryb pracy systemu
| | (USB/akumulatory).
1.3 KBST;0;GET;1;3;;TSBK | Pobiera czas pracy w sekundach od uru-
| | chomienia.
1.8 KBST;0;GET;1;8;;TSBK | Pobiera aktualny poziom szczegółowosci ´
| | logów UART (0-4).

1.8 KBST;0;SET;1;8;[poziom];TSBK Ustawia nowy poziom szczegółowosci lo- ´

| | gów UART (0-4).
1.9 KBST;0;SET;1;9;USB;TSBK | Uruchamia system ponownie w trybie bo-
| | otloadera USB (tryb programowania).

Tabela 4.4: Komendy diagnostyczne systemu

## 4.4 Menad˙zer zasilania

### 4.4.1 Wprowadzenie

Klasa PowerManager stanowi centralny punkt interakcji z układem INA3221. Jej

głównym zadaniem jest zapewnienie abstrakcji sprz˛etowej, umozliwiaj ˛ac łatwy odczyt ˙

danych pomiarowych oraz konfiguracj˛e parametrów pracy układu. W ramach tej klasy

zaimplementowałem szereg funkcji, które obejmuj ˛a inicjalizacj˛e układu INA3221, od-

czyt jego identyfikatorów, pomiar napi˛ec i pr ˛adów na poszczególnych kanałach oraz ´

konfiguracj˛e trybów pracy.

### 4.4.2 Architektura systemu

Inicjalizacja układu odbywa si˛e przez wywołanie metody INA3221::begin(). Me-

toda ta sprawdza poprawnos´c poł ˛aczenia z układem oraz weryfikuje jego identyfika- ´

tory, aby upewnic si˛e, ´ ze komunikacja przebiega prawidłowo. Odczyt identyfikatorów ˙

urz ˛adzenia, takich jak identyfikator producenta (INA3221::get_manufacturer_id())

oraz identyfikator wersji (INA3221::get_die_id()), pozwala na jednoznaczn ˛a identyfi-

kacj˛e układu i weryfikacj˛e jego autentycznosci. ´

Konstruktor klasy PowerManager przyjmuje jako argument wska´znik na instancj˛e

i2c_inst_t, co daje duz ˛a elastyczno ˙ | s´c w wyborze portu I2C, do którego podł ˛aczony ´

jest układ INA3221. Dodatkowo, w konstruktorze inicjalizowany jest mutex o nazwie

powerman_mutex_. Mutex ten pełni kluczow ˛a rol˛e w zapewnieniu bezpiecznego dost˛epu

do zasobów klasy z róznych rdzeni procesora, co jest szczególnie istotne w systemach ˙

wielow ˛atkowych, gdzie równoczesny dost˛ep do danych pomiarowych mógłby prowa-

dzic do niepo ´ | z ˛adanych konfliktów i bł˛edów. ˙
1 | class PowerManager {
2 | private: INA3221 ina3221_; bool initialized_; recursive_mutex_t powerman_mutex_;

7 | static constexpr float SOLAR_CURRENT_THRESHOLD = 50.0f;
| static constexpr float USB_CURRENT_THRESHOLD = 50.0f;
| static constexpr float BATTERY_LOW_THRESHOLD = 2.8f;
| static constexpr float BATTERY_FULL_THRESHOLD = 4.2f;

Listing 4.2: Klasa PowerManager

### 4.4.3 Konfiguracja INA3221

Po pomyslnej inicjalizacji układu INA3221, nast˛epuje proces jego konfiguracji. ´

W ramach tego procesu ustawiane s ˛a progi alarmowe dla napi˛ecia baterii, definiuj ˛ac

zakresy wartosci, które uznawane s ˛a za normalne, zbyt niskie lub zbyt wysokie. Progi ´

te, zdefiniowane jako VOLTAGE_LOW_THRESHOLD oraz VOLTAGE_OVERCHARGE_THRESHOLD,

pozwalaj ˛a na wczesne wykrywanie potencjalnych problemów z zasilaniem.

Do konfiguracji układu słuzy metoda ˙ | configure, która przyjmuje jako argument

map˛e konfiguracji. Mapa ta zawiera pary klucz-wartos´c, gdzie kluczem jest nazwa pa- ´

rametru do skonfigurowania, a wartosci ˛a jest jego nowa warto ´ | s´c. Metoda ´ | configure

pozwala na zmian˛e trybu pracy układu (ci ˛agły, wyzwalany) oraz trybu usredniania pró- ´

bek. Dost˛epne tryby usredniania pozwalaj ˛a na redukcj˛e szumów i zwi˛ekszenie dokład- ´

nosci pomiarów, kosztem wydłu ´ | zenia czasu konwersji. ˙

### 4.4.4 Pomiary

Klasa PowerManager udost˛epnia szereg metod, które umozliwiaj ˛a odczyt kluczo- ˙

wych parametrów systemu zasilania. Metody te obejmuj ˛a pomiary napi˛ec: baterii oraz ´

wyjscia przetwornicy 5V, a tak ´ | ze pr ˛adów: ładowania - zarówno z paneli fotowoltaicz- ˙

nych jak i z USB - oraz rozładowania.

| Wszystkie metody odczytu s ˛a zabezpieczone mutexem powerman_mutex_, co gwa-

rantuje spójnos´c danych i zapobiega konfliktom w przypadku równoczesnego dost˛epu ´

z róznych rdzeni procesora. Z metod tych korzysta system telemetrii do przesyłania ˙

danych o stanie zasilania do stacji naziemnej oraz logowania ich na karcie SD.

## 4.5 System zdarzen´

System zdarzen jest kluczowym elementem oprogramowania satelity, pozwalaj ˛a- ´

cym na sledzenie wszystkich istotnych procesów zachodz ˛acych w systemie. Głównym ´

celem systemu zarz ˛adzania zdarzeniami jest umozliwienie: ˙

- Rejestrowania wszystkich istotnych zdarzen w systemie ´
- Przechowywania historii zdarzen w pami˛eci nieulotnej (na karcie SD) ´
- Szybkiego dost˛epu do ostatnich zdarzen nawet w przypadku braku dost˛epu do ´

pami˛eci trwałej

- Kategoryzacji zdarzen według grup i typów ´
- Zdalnego dost˛epu do zarejestrowanych zdarzen poprzez system komunikacji ´

### 4.5.1 Architektura systemu zarz ˛adzania zdarzeniami

Struktura klas

System zarz ˛adzania zdarzeniami składa si˛e z nast˛epuj ˛acych głównych kompo-

nentów:

1. Klasa EventManager - singleton zarz ˛adzaj ˛acy buforem zdarzen i operacjami I/O ´
2. Klasa EventEmitter - interfejs umozliwiaj ˛acy emisj˛e zdarze ˙ | n z dowolnego miej- ´

sca w kodzie

3. Struktura EventLog - przechowuj ˛aca dane pojedynczego zdarzenia
4. Enumy EventGroup i specyficzne dla grup - definiuj ˛ace kategorie i typy zda-

rzen´

Struktura EventLog

Dla efektywnego przechowywania zdarzen zaprojektowałem struktur˛e EventLog, ´

która zawiera nast˛epuj ˛ace pola:

1 class EventLog {

public:

uint32_t timestamp; | // znacznik czasu w formacie Unix
uint16_t id; | // unikalne ID zdarzenia
5 | uint8_t group; | // grupa zdarzeń (np. SYSTEM, POWER)
uint8_t event; | // konkretny typ zdarzenia

} __attribute__((packed));

Listing 4.3: Struktura EventLog

Struktura ta jest zoptymalizowana pod k ˛atem rozmiaru - zajmuje tylko 8 bajtów

w pami˛eci, co umozliwia efektywne przechowywanie du ˙ | zej liczby zdarze ˙ | n nawet przy ´

ograniczonych zasobach pami˛eciowych mikrokontrolera RP2040.

Klasa EventManager

Sercem całego systemu jest klasa EventManager, któr ˛a zaimplementowałem zgod-

nie z wzorcem projektowym Singleton. Zapewnia to jeden punkt dost˛epu do funkcji

zarz ˛adzania zdarzeniami w całym systemie. Jej implementacja wygl ˛ada nast˛epuj ˛aco:

1 | class EventManager {
| private:
3 | EventLog events[EVENT_BUFFER_SIZE]; // bufor cykliczny zdarzeń
| size_t eventCount; | // liczba zdarzeń w buforze
| size_t writeIndex; | // indeks do zapisu nowego zdarzenia
| mutex_t eventMutex; | // mutex do synchronizacji wątków
| uint16_t nextEventId; | // inkrementalne ID dla zdarzeń
8 | size_t eventsSinceFlush; | // liczba zdarzeń od ostatniego zapisu na
| SD

// prywatny konstruktor - wzorzec Singleton

EventManager();

13 | public:
| static EventManager& get_instance();

bool init();

void log_event(uint8_t group, uint8_t event);

const EventLog& get_event(size_t index) const;

18 | size_t get_event_count() const;
| bool save_to_storage();

};

Listing 4.4: Klasa EventManager

Grupy i typy zdarzen´

Przy projektowaniu systemu okresliłem hierarchiczn ˛a struktur˛e zdarze ´ | n, co umo ´ | z-˙

liwia ich efektywn ˛a kategoryzacj˛e i filtrowanie. Zdarzenia s ˛a podzielone na grupy, a w

ramach kazdej grupy wyró ˙ | znione s ˛a konkretne typy zdarze ˙ | n:´
1 | enum class EventGroup : uint8_t {
| SYSTEM = 0x00,
| POWER = 0x01,
| COMMS = 0x02,
5 | GPS = 0x03,
| CLOCK = 0x04

};

enum class SystemEvent : uint8_t {

10 | BOOT = 0x01, SHUTDOWN = 0x02, WATCHDOG_RESET = 0x03, CORE1_START = 0x04, CORE1_STOP = 0x05
15 | };

// Podobne enumy istnieją dla pozostałych grup

Listing 4.5: Przykładowe enumeracje zdarzen´

Ta hierarchiczna struktura pozwala mi na łatwe dodawanie nowych grup i typów

zdarzen w przyszło ´ | sci, bez konieczno ´ | sci znacz ˛acych zmian w istniej ˛acym kodzie. ´

### 4.5.2 Generowanie zdarzen´

Dzi˛eki zastosowaniu klasy EventEmitter, kazdy moduł systemu mo ˙ | ze generowa ˙ | c´
zdarzenia w prosty sposób - wystarczy wywołac funkcj˛e ´ | emit z odpowiednimi parame-

trami, na przykład:

1 | EventEmitter::emit(EventGroup::SYSTEM, SystemEvent::BOOT);

Listing 4.6: Funkcja emituj ˛aca zdarzenie

Wywołanie tej funkcji spowoduje zarejestrowanie zdarzenia z grupy SYSTEM i

typie BOOT w buforze zdarzen przez metod˛e ´ | log_event klasy EventManager.
1 | class EventEmitter {
| public: /**
4 | * @brief Emits an event. * @param[in] group Event group. * @param[in] event Event code.
| * @tparam T Type of the event enumeration. */
9 | template<typename T> static void emit(EventGroup group, T event) { EventManager::get_instance().log_event( static_cast<uint8_t>(group), static_cast<uint8_t>(event)
14 | );

}

};

Listing 4.7: Klasa EventEmitter

### 4.5.3 Rejestracja zdarzen´

Centralnym punktem systemu jest funkcja log_event. Odpowiada ona za zapisy-

wanie zdarzen w buforze cyklicznym, aktualizacj˛e indeksów, logowanie do UART oraz ´

automatyczne zapisywanie zdarzen do pami˛eci nieulotnej. Zapis do pami˛eci nieulotnej ´

odbywa si˛e wtedy, gdy osi ˛agni˛eto próg zdarzen lub gdy zdarzenie jest krytyczne (np. ´

zwi ˛azane z zasilaniem).

1 | void EventManager::log_event(uint8_t group, uint8_t event) {
| // Blokowanie mutexu, aby zapewnić atomowość operacji
| mutex_enter_blocking(&eventMutex);

4

// Pobieranie znacznika czasu z zegara RTC

uint32_t timestamp = DS3231::get_instance().get_local_time();

uint16_t id = nextEventId++;

9 | // Zapisanie zdarzenia w buforze cyklicznym
| EventLog& log = events[writeIndex];
| log.id = id;
| log.timestamp = timestamp;
| log.group = group;
14 | log.event = event;

// Aktualizacja indeksów i liczników

writeIndex = (writeIndex + 1) % EVENT_BUFFER_SIZE;

if (eventCount < EVENT_BUFFER_SIZE) {

19 | eventCount++;

}

| eventsSinceFlush++;

// Zwolnienie mutexu

24 | mutex_exit(&eventMutex);

// Logowanie do UART dla celów diagnostycznych

std::string event_string = "Event: " + std::to_string(id) +

" Group: " + std::to_string(group) +

29 | " Event: " + std::to_string(event);
| uart_print(event_string, VerbosityLevel::WARNING);

// Automatyczny zapis do pamięci trwałej jeśli:

// - osiągnięto próg zdarzeń lub

34 | // - zdarzenie dotyczy zasilania (krytyczne)
| if (eventsSinceFlush >= EVENT_FLUSH_THRESHOLD ||
| group == static_cast<uint8_t>(EventGroup::POWER)) {
| save_to_storage();
| eventsSinceFlush = 0;
39 | }

}

Listing 4.8: Implementacja funkcji log_event

### 4.5.4 Dost˛ep do zdarzen´

Dla dost˛epu do zarejestrowanych zdarzen zaimplementowałem funkcj˛e ´ | get_event.
Jest ona uzywana przez system polece ˙ | n do zdalnego odczytu logu zdarze ´ | n.´
1 | const EventLog& EventManager::get_event(size_t index) const {
| mutex_enter_blocking(const_cast<mutex_t*>(&eventMutex));

// Sprawdzenie poprawności indeksu

5 | if (index >= eventCount) {
| static EventLog emptyEvent; mutex_exit(const_cast<mutex_t*>(&eventMutex));
| return emptyEvent;

}

10

// Obliczenie rzeczywistego indeksu w buforze cyklicznym

size_t readIndex;

if (eventCount == EVENT_BUFFER_SIZE) {

readIndex = (writeIndex + index) % EVENT_BUFFER_SIZE;

15 | }

else {

readIndex = index;

}

20 | const EventLog& event = events[readIndex];
| mutex_exit(const_cast<mutex_t*>(&eventMutex));
| return event;

}

Listing 4.9: Implementacja funkcji get_event

### 4.5.5 Polecenia systemu zdarzen´

Z systemem zdarzen s ˛a zwi ˛azane nast˛epuj ˛ace polecenia: ´

ID | Format komendy | Opis
5.1 KBST;0;GET;5;1;[N];TSBK Pobiera ostatnie N zdarzen z logu zdarze ´ | n.´
| | Jesli N=0, pobiera wszystkie zdarzenia. ´
5.2 KBST;0;GET;5;2;;TSBK | Pobiera całkowit ˛a liczb˛e zdarzen w logu. ´

Tabela 4.5: Komendy systemu zdarzen´

## 4.6 System telemetrii

### 4.6.1 Wprowadzenie

System telemetrii jest jednym z kluczowych podsystemów, który zaprojektowa-

łem, aby umozliwi ˙ c monitoring stanu urz ˛adzenia podczas jego pracy. W niniejszym ´

rozdziale szczegółowo omówi˛e architektur˛e systemu, jego implementacj˛e oraz zasad˛e

działania.

System telemetrii odpowiada za zbieranie, przechowywanie i udost˛epnianie da-

nych z róznych czujników i podsystemów satelity, takich jak: podsystem zasilania, czuj- ˙

niki srodowiskowe oraz moduł GPS. Gromadzenie tych danych pozwala na bie ´ | z ˛acy ˙

monitoring parametrów satelity oraz umozliwia wykrywanie potencjalnych problemów ˙

zanim stan ˛a si˛e krytyczne.

### 4.6.2 Architektura systemu telemetrii

System telemetrii zaimplementowałem w oparciu o wzorzec projektowy Single-

ton, co zapewnia istnienie tylko jednej instancji menedzera telemetrii w całym syste- ˙

mie. Jest to szczególnie istotne, poniewaz dost˛ep do systemu telemetrii jest wymagany ˙

z róznych miejsc w kodzie, a jednocze ˙ | snie musimy zapewni ´ | c spójno ´ | s´c gromadzonych ´

danych.

Centralnym elementem systemu jest klasa TelemetryManager, która udost˛epnia

interfejs do zbierania i zarz ˛adzania danymi telemetrycznymi. Dost˛ep do tej klasy mozna ˙

uzyskac poprzez metod˛e statyczn ˛a ´ | get_instance().

Dane telemetryczne przechowywane s ˛a w dwóch strukturach: TelemetryRecord

przechowuje informacje o napi˛eciach, pr ˛adach oraz dane z GPS, oraz SensorDataRecord

która przechowuje odczyty z czujników srodowiskowych. Obie struktury wyposa ´ | zyłem ˙

w metod˛e to_csv(), która konwertuje dane na format CSV, co ułatwia zapisywanie

rekordów telemetrycznych do plików oraz ich przesyłanie za pomoc ˛a systemu komuni-

kacji.

Inicjalizacja systemu telemetrii jest przeprowadzana przez metod˛e init(), która

wykonuje nast˛epuj ˛ace kroki:

1. Inicjalizacja muteksu do synchronizacji dost˛epu do buforów
2. Sprawdzenie, czy karta SD jest zamontowana
3. Utworzenie plików CSV z nagłówkami, jesli nie istniej ˛a, w przeciwnym razie wy- ´

czyszczenie zawartosci istniej ˛acych plików ´

Pole | Opis
timestamp | Znacznik czasu (Unix timestamp)
build_version | Wersja oprogramowania
battery_voltage | Napi˛ecie baterii (V)
system_voltage | Napi˛ecie systemowe 5V (V)
charge_current_usb | Pr ˛ad ładowania z USB (mA)
charge_current_solar | Pr ˛ad ładowania z paneli słonecznych (mA)
discharge_current | Pr ˛ad rozładowania baterii (mA)
time | Czas UTC (GPS RMC)
latitude | Szerokos´c geograficzna (GPS RMC) ´
lat_dir | Kierunek szerokosci geograficznej (N/S, GPS RMC) ´
longitude | Długos´c geograficzna (GPS RMC) ´
lon_dir | Kierunek długosci geograficznej (E/W, GPS RMC) ´
speed | Pr˛edkos´c (w w˛ezłach, GPS RMC) ´
course | Kurs (w stopniach, GPS RMC)
date | Data (GPS RMC)
fix_quality | Jakos´c fixa GPS (GPS GGA) ´
satellites | Liczba satelitów (GPS GGA)
altitude | Wysokos´c (m, GPS GGA) ´
Tabela 4.6: Zawartos´c struktury ´ | TelemetryRecord
Pole | Opis
timestamp | Znacznik czasu
temperature | Temperatura
pressure | Cisnienie ´
humidity | Wilgotnos´c´
light | Nat˛ezenie ˙ | swiatła ´
Tabela 4.7: Zawartos´c struktury ´ | | SensorDataRecord

### 4.6.3 Zbieranie danych telemetrycznych

Zbieranie danych telemetrycznych podzieliłem na kilka specjalizowanych funkcji,

co pozwala na lepsz ˛a organizacj˛e kodu oraz jego łatwiejsz ˛a konserwacj˛e. Główn ˛a funk-

cj ˛a odpowiedzialn ˛a za zbieranie danych jest collect_telemetry(), która koordynuje

proces pozyskiwania informacji z róznych podsystemów. ˙

Proces zbierania danych rozpoczyna si˛e od pobrania aktualnego czasu z mo-

dułu RTC (DS3231), który słuzy jako znacznik czasowy dla rekordów telemetrycznych. ˙

Nast˛epnie kolejno zbierane s ˛a dane z poszczególnych podsystemów: dane o stanie

zasilania pozyskiwane s ˛a za pomoc ˛a metody collect_power_telemetry(), która ko-

rzysta z instancji klasy PowerManager do odczytu aktualnych wartosci napi˛e ´ | c i pr ˛adów. ´

Na podstawie tych danych generowane s ˛a równiez zdarzenia systemowe, które mog ˛a ˙

byc wykorzystane przez inne podsystemy do reagowania na zmiany w stanie zasilania. ´

Na podstawie zebranych danych o zasilaniu, system telemetrii generuje zdarze-

nia informuj ˛ace o istotnych zmianach stanu, takich jak podł ˛aczenie zasilania USB, roz-

pocz˛ecie ładowania z paneli słonecznych czy niski poziom naładowania baterii. Funk-

cja emit_power_events() analizuje aktualne parametry i emituje odpowiednie zdarze-

nia, które s ˛a nast˛epnie przetwarzane przez system zarz ˛adzania zdarzeniami satelity.

Dane z modułu GPS pobierane s ˛a za pomoc ˛a funkcji collect_gps_telemetry(),

która odczytuje przetworzone ramki NMEA z klasy NMEAData. System analizuje za-

równo ramki RMC (Recommended Minimum Navigation Information), które zawieraj ˛a

podstawowe informacje nawigacyjne, jak i ramki GGA (Global Positioning System Fix

Data), które dostarczaj ˛a dodatkowych informacji o jakosci fixa GPS i wysoko ´ | sci. ´
Dane srodowiskowe s ˛a zbierane przez funkcj˛e ´ | collect_sensor_telemetry(),

która korzysta z klasy SensorWrapper do komunikacji z czujnikami. System odczy-

tuje wartosci temperatury, ci ´ | snienia, wilgotno ´ | sci oraz nat˛e ´ | zenia ˙ | swiatła i zapisuje je ´

w strukturze SensorDataRecord.

Zebrane dane telemetryczne s ˛a przechowywane w buforach cyklicznych, co po-

zwala na efektywne zarz ˛adzanie pami˛eci ˛a. System wykorzystuje dwa bufory: jeden dla

danych TelemetryRecord i drugi dla danych SensorDataRecord. Zaimplementowany

mechanizm buforowania pozwala na przechowywanie okreslonej liczby najnowszych ´

rekordów (domyslnie 20), która jest definiowana przez stał ˛a ´ | TELEMETRY_BUFFER_SIZE.

Bufor cykliczny to efektywna struktura danych, która działa jak kolejka o stałym

rozmiarze. Gdy bufor jest pełny, najstarsze dane s ˛a nadpisywane przez nowe. W im-

plementacji systemu telemetrii wykorzystałem tablice o stałym rozmiarze wraz z indek-

sami wskazuj ˛acymi na pozycje zapisu i licznikiem przechowywanych rekordów.

Poniewaz dane telemetryczne mog ˛a by ˙ | c zbierane i odczytywane z ró ´ | znych w ˛at- ˙

ków, konieczne było zastosowanie mechanizmów synchronizacji. W tym celu wykorzy-

stałem muteksy z biblioteki Raspberry Pi Pico, które zapewniaj ˛a bezpieczny dost˛ep

do buforów. Wszystkie operacje na buforach s ˛a chronione przez telemetry_mutex, co

zapobiega konfliktom dost˛epu i zapewnia spójnos´c danych. ´

Bufory telemetryczne s ˛a okresowo zapisywane na karcie SD, co pozwala na prze-

chowywanie danych w przypadku braku zasilania oraz ich odzyskanie po zakonczeniu ´

lotu. Za zapisywanie danych odpowiada funkcja flush_telemetry(), która zapisuje

wszystkie rekordy z buforów do plików CSV. System tworzy dwa pliki: /telemetry.csv

dla głównych danych telemetrycznych oraz /sensors.csv dla danych z czujników.

System telemetrii działa według ustalonego harmonogramu, który okresla cz˛e- ´

stotliwos´c zbierania danych i ich zapisywania na karcie SD. Harmonogram ten jest ´

kontrolowany przez dwie kluczowe funkcje: is_telemetry_collection_time() oraz

is_telemetry_flush_time().

Dane telemetryczne s ˛a zbierane w regularnych odst˛epach czasu, które domysl- ´

nie wynosz ˛a 1 sekund˛e (zdefiniowane przez DEFAULT_SAMPLE_INTERVAL_MS). Funkcja

is_telemetry_collection_time() sprawdza, czy min ˛ał wymagany czas od ostatniego

pomiaru i aktualizuje znacznik czasowy ostatniego zbierania danych.

Zebrane dane s ˛a zapisywane na karcie SD po zgromadzeniu okreslonej liczby re- ´

kordów, domyslnie 10 (zdefiniowane przez stał ˛a ´ | | DEFAULT_FLUSH_THRESHOLD). Funkcja

is_telemetry_flush_time() sprawdza, czy licznik zebranych rekordów osi ˛agn ˛ał próg

zapisywania i resetuje licznik, jesli jest to konieczne. ´

Opisane mechanizmy zbierania i zapisywania danych s ˛a zintegrowane z główn ˛a

p˛etl ˛a drugiego rdzenia mikrokontrolera (Core 1). W kazdej iteracji p˛etli sprawdzany ˙

jest czas zbierania danych, a po zgromadzeniu odpowiedniej liczby rekordów, s ˛a one

zapisywane na karcie SD.

### 4.6.4 Dost˛ep do danych telemetrycznych przez system komunika-

### cji

System telemetrii udost˛epnia zebrane dane za posrednictwem interfejsu komu- ´

nikacyjnego satelity. Zaimplementowałem dwie komendy, które pozwalaj ˛a na pobranie

ostatnich zarejestrowanych rekordów telemetrycznych i czujnikowych.

Funkcja handle_get_last_telemetry_record() obsługuje komend˛e pobierania

ostatniego rekordu telemetrycznego. Funkcja ta pobiera ostatni rekord z menedzera ˙

telemetrii, konwertuje go na format CSV i zwraca jako ramk˛e komunikacyjn ˛a.

Podobnie działa funkcja handle_get_last_sensor_record(), która obsługuje ko-

mend˛e pobierania ostatniego rekordu czujnikowego. Funkcja ta pobiera ostatni rekord

danych z czujników i zwraca go jako ramk˛e komunikacyjn ˛a.

### 4.6.5 Komendy systemu telemetrii

System telemetrii udost˛epnia nast˛epuj ˛ace komendy, które mog ˛a byc wykorzy- ´

stane do interakcji z danymi telemetrycznymi:

ID | Format komendy | Opis

8.2 KBST;0;GET;8;2;;TSBK Pobiera ostatni rekord telemetryczny w for-

macie CSV. Zwraca dane o zasilaniu, poło-

zeniu GPS i inne parametry systemowe. ˙

8.3 KBST;0;GET;8;3;;TSBK Pobiera ostatni rekord danych z czujników

w formacie CSV. Zwraca wartosci tempera- ´

tury, cisnienia, wilgotno ´ | sci i nat˛e ´ | zenia ˙ | swia- ´

tła.

Tabela 4.8: Komendy systemu telemetrii

## 4.7 Implementacja systemu plików

### 4.7.1 Architektura systemu

System plików został zaimplementowany w sposób warstwowy, gdzie główne

komponenty to:

- Warstwa urz ˛adzen blokowych (obsługa karty SD) ´
- Warstwa systemu plików (FAT)
- Warstwa abstrakcji VFS (pico-vfs)

W ramach implementacji systemu plików dla KubiSat zdecydowałem si˛e wyko-

rzystac bibliotek˛e pico-vfs[7], Bazuje ona na architekturze wirtualnego systemu plików ´

zaprojektowanej specjalnie dla Raspberry Pi Pico. Zapewnia ona ujednolicony interfejs

do operacji plikowych poprzez standardowe API POSIX oraz funkcje standardowe j˛e-

zyka C, umozliwiaj ˛ac tym samym efektywne i proste wykorzystanie ró ˙ | znych no ˙ | sników ´

pami˛eci, takich jak wbudowana pami˛ec flash oraz karty SD. ´

Modularna architektura pico-vfs pozwala na wymian˛e i dodawanie poszczegól-

nych komponentów, dzi˛eki czemu system jest elastyczny i skalowalny. Do jej uzycia ˙

wymagane jest wywołanie funkcji fs_init z odpowiednimi parametrami, które two-

rz ˛a instancje systemu plików i urz ˛adzenia blokowego; w przypadku karty SD jest to

blockdevice_sd_create.

1 | bool fs_init(void) {
2 | blockdevice_t *sd = blockdevice_sd_create(SD_SPI_PORT,
| SD_MOSI_PIN,
| SD_MISO_PIN,
| SD_SCK_PIN,
| SD_CS_PIN,
7 | 24 * MHZ, false);
| filesystem_t *fat = filesystem_fat_create();

int err = fs_mount("/", fat, sd);

12 | if (err == -1) {
| err = fs_format(fat, sd);
| if (err == -1) {
| return false;

}

17 | err = fs_mount("/", fat, sd);

}

| return err != -1;

}

Listing 4.10: Inicjalizacja systemu plików

Powyzszy kod inicjalizuje system plików, montuje system plików FAT na karcie ˙

SD i formatuje go w przypadku braku dost˛epu.

### 4.7.2 Monitorowanie stanu

Stan systemu plików jest monitorowany poprzez klas˛e SystemStateManager: 4.3.2.

1 | SystemStateManager::get_instance()
| .set_sd_card_mounted(true);

Listing 4.11: Pobieranie stanu karty SD

Kazda operacja zamontowania/odmontowania systemu plików karty SD jest au- ˙

tomatycznie odzwierciedlana w mendadzerze stanu. Magazyn danych jest wykorzysty- ˙

wany przez system telemetrii oraz system zdarzen do zapisywania ich stanu. ´

## 4.8 System czujników

### 4.8.1 Wprowadzenie

Moduł czujników stanowi kluczowy podsystem, który zaprojektowałem w celu mo-

nitorowania warunków srodowiskowych zarówno wewn ˛atrz samego satelity, jak i w jego ´

otoczeniu.

Głównym celem systemu czujników jest dostarczanie aktualnych danych o para-

metrach fizycznych, które s ˛a istotne z punktu widzenia misji satelity oraz monitorowa-

nia jego stanu. System zaprojektowałem z mysl ˛a o modularno ´ | sci i rozszerzalno ´ | sci, co ´
pozwala na łatwe dodawanie nowych czujników w przyszłosci bez konieczno ´ | sci mody- ´

fikacji całej architektury.

### 4.8.2 Architektura systemu czujników

System czujników opiera si˛e na interfejsie abstrakcyjnym ISensor, który zapew-

nia jednolity sposób interakcji z róznymi typami czujników, niezale ˙ | znie od ich produ- ˙

centa czy modelu. Ta abstrakcja pozwala na łatw ˛a wymian˛e czujników i upraszcza kod

obsługuj ˛acy dane pomiarowe.

Architektura systemu czujników składa si˛e z kilku kluczowych elementów:

- Interfejs ISensor - definiuje wspólny interfejs dla wszystkich czujników
- Klasa SensorWrapper - zarz ˛adza wszystkimi czujnikami w systemie
- Implementacje konkretnych czujników (np. BME280, BH1750)
- Klasy opakowuj ˛ace (wrappery) dla czujników, implementuj ˛ace interfejs ISensor

Interfejs ISensor

Sercem systemu czujników jest interfejs ISensor, który zdefiniowałem jako abs-

trakcyjn ˛a klas˛e bazow ˛a dla wszystkich czujników w satelicie. Interfejs ten zapewnia

jednolity sposób inicjalizacji czujników, konfiguracji ich parametrów oraz odczytywania

danych pomiarowych. Dzi˛eki temu reszta systemu moze korzysta ˙ | c z czujników bez ´

znajomosci ich szczegółów implementacyjnych. ´

1 | class ISensor {
| public:
3 | virtual ~ISensor() = default;
| virtual bool init() = 0;

virtual float read_data(SensorDataTypeIdentifier type) = 0;

virtual bool is_initialized() const = 0;

virtual SensorType get_type() const = 0;

8 | virtual bool configure(const std::map<std::string, std::string>& config) =
| 0; virtual uint8_t get_address() const = 0;

};

Listing 4.12: Definicja interfejsu ISensor

Interfejs ISensor definiuje nast˛epuj ˛ace metody:

- init() - inicjalizuje czujnik i przygotowuje go do pracy
- read_data() - odczytuje dane z czujnika dla okreslonego typu pomiaru ´
- is_initialized() - sprawdza, czy czujnik został poprawnie zainicjalizowany
- get_type() - zwraca typ czujnika
- configure() - konfiguruje czujnik za pomoc ˛a mapy parametrów
- get_address() - zwraca adres I2C czujnika

Typy czujników i danych

Aby uprosci ´ c zarz ˛adzanie ró ´ | znymi rodzajami czujników i typami danych, które ˙

oferuj ˛a, zdefiniowałem dwie enumeracje: SensorType oraz SensorDataTypeIdentifier.

Enumeracja SensorType okresla rodzaj czujnika, natomiast ´ | SensorDataTypeIdentifier

definiuje rodzaje danych, które mog ˛a byc odczytane z czujników. ´

1 | enum class SensorType : uint8_t {
| NONE = 0x00,
| LIGHT = 0x01,
| ENVIRONMENT = 0x02,
5 | };

enum class SensorDataTypeIdentifier : uint8_t {

NONE = 0x00,

LIGHT_LEVEL = 0x01,

10 | TEMPERATURE = 0x02,

HUMIDITY = 0x03,

PRESSURE = 0x04,

};

Listing 4.13: Definicje typów czujników i danych

Takie podejscie pozwala na jednoznaczne identyfikowanie czujników i danych, ´

co jest szczególnie istotne w systemie, który moze zawiera ˙ | c wiele ró ´ | znych czujników ˙

dostarczaj ˛acych rózne rodzaje pomiarów. ˙

Klasa SensorWrapper

Klasa SensorWrapper pełni rol˛e centralnego menedzera dla wszystkich czujników ˙

w systemie. Implementuje ona wzorzec projektowy Singleton, co zapewnia jednolity

punkt dost˛epu do wszystkich czujników w całym systemie. Jest to szczególnie przy-

datne, gdy rózne podsystemy satelity potrzebuj ˛a dost˛epu do tych samych danych z ˙

czujników.

Klasa SensorWrapper udost˛epnia metody do inicjalizacji, konfiguracji i odczyty-

wania danych z czujników.

### 4.8.3 Implementacja czujnika srodowiskowego BME280 ´

Klasa BME280

Klasa BME280 implementuje niskopoziomow ˛a komunikacj˛e z czujnikiem poprzez

interfejs I2C. Jest odpowiedzialna za inicjalizacj˛e sprz˛etu, konfiguracj˛e rejestrów, od-

czytywanie surowych danych pomiarowych oraz ich konwersj˛e na wartosci fizyczne w ´

odpowiednich jednostkach.

Procedura inicjalizacji czujnika BME280 jest wieloetapowa i obejmuje:

1. Sprawdzenie poprawnosci inicjalizacji portu I2C ´
2. Weryfikacj˛e identyfikatora urz ˛adzenia (chip ID)

3. Konfiguracj˛e parametrów pracy czujnika
4. Odczytanie parametrów kalibracyjnych z czujnika

Konwersja danych pomiarowych

Jednym z najwazniejszych aspektów działania czujnika BME280 jest konwersja ˙

surowych wartosci odczytanych z rejestrów na rzeczywiste warto ´ | sci fizyczne. W tym ´

celu BME280 wykorzystuje zaawansowane algorytmy kompensacji, które uwzgl˛edniaj ˛a

parametry kalibracyjne zapisane w pami˛eci czujnika. W celu implementacji tych algo-

rytmów, skorzystałem z oficjalnej dokumentacji producenta [9] oraz udost˛epnionych

przez niego przykładowych implementacji.

Klasa opakowuj ˛aca BME280Wrapper

Aby zintegrowac czujnik BME280 z abstrakcyjnym interfejsem ´ | ISensor, stworzy-

łem klas˛e opakowuj ˛ac ˛a BME280Wrapper. Klasa ta implementuje interfejs ISensor i prze-

kierowuje wywołania metod do odpowiednich funkcji własciwego czujnika. ´

Warto zwrócic uwag˛e na metod˛e ´ | read_data(), która odczytuje wszystkie dane

surowe jednoczesnie (co jest bardziej efektywne), a nast˛epnie dokonuje odpowiedniej ´

konwersji w zalezno ˙ | sci od ´ | z ˛adanego typu danych. Jest to optymalizacja, która pozwala ˙

na zmniejszenie liczby operacji I2C, co przekłada si˛e na wi˛eksz ˛a dost˛epnos´c czasow ˛a ´

szyny dla innych czujników.

### 4.8.4 Implementacja czujnika swiatła BH1750 ´

Klasa BH1750

Klasa BH1750 implementuje niskopoziomow ˛a komunikacj˛e z czujnikiem poprzez

interfejs I2C. Podobnie jak w przypadku BME280, jest odpowiedzialna za inicjalizacj˛e

sprz˛etu, konfiguracj˛e rejestrów i odczytywanie danych pomiarowych.

Czujnik BH1750 oferuje rózne tryby pracy, które ró ˙ | zni ˛a si˛e rozdzielczo ˙ | sci ˛a i cz˛e- ´

stotliwosci ˛a pomiarów. Zaimplementowałem obsług˛e wszystkich trybów pracy poprzez ´

enumeracj˛e Mode i metod˛e configure().

Odczyt danych z czujnika BH1750

Odczyt danych z czujnika BH1750 jest znacznie prostszy niz w przypadku BME280, ˙

poniewaz czujnik ten dokonuje konwersji warto ˙ | sci surowej na luksy wewn˛etrznie. Wy- ´
starczy wi˛ec odczytac 2 bajty danych z rejestru i zastosowa ´ | c prosty wzór konwersji. ´

Klasa opakowuj ˛aca BH1750Wrapper

Podobnie jak w przypadku BME280, stworzyłem klas˛e opakowuj ˛ac ˛a BH1750Wrapper,

która implementuje interfejs ISensor i przekierowuje wywołania metod do własciwego ´

czujnika.

Interesuj ˛acym aspektem implementacji klasy BH1750Wrapper jest metoda configure(),

która pozwala na dynamiczn ˛a zmian˛e trybu pracy czujnika za pomoc ˛a mapy parame-

trów. Domyslnie czujnik jest konfigurowany w trybie ci ˛agłym wysokiej rozdzielczo ´ | sci. ´

### 4.8.5 Implementacja klasy SensorWrapper

Implementacja klasy SensorWrapper obejmuje szereg metod, które umozliwiaj ˛a ˙

zarz ˛adzanie czujnikami w systemie. Jedn ˛a z najwazniejszych funkcjonalno ˙ | sci jest ini- ´

cjalizacja czujników, która jest realizowana przez metod˛e sensor_init().

1 | bool SensorWrapper::sensor_init(SensorType type, i2c_inst_t* i2c) {
2 | switch (type) {
| case SensorType::LIGHT:
| sensors[type] = new BH1750Wrapper(i2c);
| break;
| case SensorType::ENVIRONMENT:
7 | sensors[type] = new BME280Wrapper(i2c);
| break;
| default:
| return false;

}

12 | return sensors[type]->init();

}

Listing 4.14: Inicjalizacja czujników w klasie SensorWrapper

Metoda ta tworzy odpowiedni ˛a instancj˛e klasy opakowuj ˛acej w zalezno ˙ sci od ´

typu czujnika, a nast˛epnie wywołuje metod˛e init(), która inicjalizuje sprz˛et. Nast˛ep-

nie czujnik jest przechowywany w mapie sensors, która mapuje typy czujników na ich

instancje.

Kolejn ˛a wazn ˛a funkcjonalno ˙ | sci ˛a jest odczytywanie danych z czujników, które jest ´

realizowane przez metod˛e sensor_read_data():

1 | float SensorWrapper::sensor_read_data(SensorType sensorType,
| SensorDataTypeIdentifier dataType) {
2 | if (sensors.find(sensorType) == sensors.end()) {
| return -1.0f;

}

| return sensors[sensorType]->read_data(dataType);

}

Listing 4.15: Odczytywanie danych z czujników w klasie SensorWrapper

### 4.8.6 Integracja z systemem telemetrii

System czujników jest sci ´ sle zintegrowany z systemem telemetrii satelity. Dane ´

z czujników s ˛a regularnie odczytywane i zapisywane w rekordach telemetrycznych,

które s ˛a nast˛epnie przechowywane w buforze i zapisywane na karcie SD. Szczegółowo

opisałem t˛e funkcjonalnos´c w rozdziale 4.6.3. ´

## 4.9 Zegar

Klasa DS3231 stanowi interfejs do odczytu i konfiguracji układu DS3231. Jej głów-

nym zadaniem jest zapewnienie abstrakcji sprz˛etowej, umozliwiaj ˛ac łatwy odczyt da- ˙

nych czasowych oraz konfiguracj˛e parametrów pracy układu.

W ramach tej klasy zaimplementowałem szereg funkcji, które obejmuj ˛a odczyt i zapis czasu i daty, odczyt temperatury, konwersj˛e mi˛edzy formatami BCD i binar-

nym oraz obsług˛e stref czasowych . Konstruktor klasy DS3231 przyjmuje jako argument

wska´znik na instancj˛e i2c_inst_t, co daje duz ˛a elastyczno ˙ | s´c w wyborze portu I2C, ´

do którego podł ˛aczony jest układ DS3231.

Dodatkowo, w konstruktorze inicjalizowany jest mutex clock_mutex_, który pełni

kluczow ˛a rol˛e w zapewnieniu bezpiecznego dost˛epu do zasobów klasy z róznych rdzeni ˙

procesora.

### 4.9.1 Odczyt i zapis czasu

Do odczytu czasu z układu DS3231 słuzy metoda ˙ | get_time(), która pobiera dane

z odpowiednich rejestrów układu i zapisuje je w strukturze ds3231_data_t. Struktura

ta zawiera pola reprezentuj ˛ace sekundy, minuty, godziny, dzien tygodnia, dzie ´ | n mie- ´

si ˛aca, miesi ˛ac, rok oraz informacj˛e o stuleciu. Metoda set_time() pozwala na usta-

wienie czasu w układzie DS3231. Obie metody korzystaj ˛a z funkcji i2c_read_reg() i

i2c_write_reg() do komunikacji z układem poprzez interfejs I2C.

Układ DS3231 przechowuje czas w formacie BCD (Binary Coded Decimal), dla-

tego konieczna jest konwersja mi˛edzy formatami binarnym i BCD.

1 | /**
| * @brief Gets current RTC time as Unix timestamp
| * @return Unix timestamp or -1 on error
4 | */ time_t DS3231::get_time() { uint8_t time_data[7]; if (i2c_read_reg(DS3231_SECONDS_REG, 7, time_data) != 0) { uart_print("Failed to read time from RTC", VerbosityLevel::ERROR);
9 | return -1;

}

struct tm timeinfo = {};

// Konwersja z formatu BCD na binarny i zapis do struktury tm

14 | timeinfo.tm_sec = ((time_data[0] >> 4) * 10) + (time_data[0] & 0x0F);
| timeinfo.tm_min = ((time_data[1] >> 4) * 10) + (time_data[1] & 0x0F);

timeinfo.tm_hour = ((time_data[2] >> 4) * 10) + (time_data[2] & 0x0F);

timeinfo.tm_mday = ((time_data[4] >> 4) * 10) + (time_data[4] & 0x0F);

timeinfo.tm_mon = (((time_data[5] & 0x1F) >> 4) * 10) + (time_data[5] & 0x0F

) - 1;

19 | timeinfo.tm_year = ((time_data[6] >> 4) * 10) + (time_data[6] & 0x0F) + 100;
| timeinfo.tm_isdst = 0;

time_t unix_time = mktime(&timeinfo);

if (unix_time == -1) {

24 | uart_print("Failed to convert RTC time", VerbosityLevel::ERROR);
| return -1;

}

return unix_time;

29 }

Listing 4.16: Funkcja pobieraj ˛aca czas z układu DS3231

### 4.9.2 Strefa czasowa

Klasa DS3231 umozliwia ustawienie strefy czasowej za pomoc ˛a metody ˙ | set_timezone_offset().

Przesuni˛ecie strefy czasowej jest przechowywane w zmiennej timezone_offset_minutes_

i jest uwzgl˛edniane podczas odczytu czasu lokalnego za pomoc ˛a metody get_local_time().

### 4.9.3 Temperatura

Pomiar temperatury jest uzywany przez układ głównie do kompensacji tempera- ˙

turowej oscylatora kwarcowego, jednak producent daje mozliwo ˙ | s´c odczytu tej warto ´ | sci ´

przez interfejs I2C. Klasa DS3231 udost˛epnia metod˛e get_temperature(), która zwraca

temperatur˛e w stopniach Celsjusza z dokładnosci ˛a do 0.25°C. Dzi˛eki temu mo ´ | zna mo- ˙

nitorowac temperatur˛e wewn ˛atrz obudowy satelity. ´

### 4.9.4 Polecenia zegara

ID | Format komendy | Opis
3.0 KBST;0;GET;3;0;;TSBK | Pobiera aktualny czas. Zwraca czas w for-
| | macie Unix timestamp.

KBST;0;SET;3;0;TIMESTAMP;TSBK Ustawia aktualny czas. Oczekuje Unix ti-

| | mestamp jako parametr.
3.1 KBST;0;GET;3;1;;TSBK | Pobiera aktualne przesuni˛ecie strefy cza-
| | sowej w minutach.
| KBST;0;SET;3;1;OFFSET;TSBK | Ustawia przesuni˛ecie strefy czasowej w mi-
| | nutach (od -720 do +720).
3.4 KBST;0;GET;3;4;;TSBK | Pobiera temperatur˛e wewn˛etrzn ˛a z czuj-
| | nika DS3231. Zwraca temperatur˛e w stop-
| | niach Celsjusza.

Tabela 4.9: Komendy systemu zegara

## 4.10 System lokalizacji i komunikacji GPS

### 4.10.1 Wprowadzenie

System lokalizacji stanowi kluczowy element funkcjonalny, który zaprojektowa-

łem, aby umozliwi ˙ | c precyzyjne okre ´ | slanie pozycji satelity. W niniejszym rozdziale omó- ´

wi˛e szczegółowo architektur˛e systemu lokalizacji, mechanizmy przetwarzania danych

GPS oraz implementacj˛e protokołu NMEA, który jest standardem komunikacji z modu-

łami GPS.

Głównym celem systemu lokalizacji jest ci ˛agły odbiór, przetwarzanie i udost˛ep-

nianie danych pozycyjnych z modułu GPS dla innych podsystemów satelity.

### 4.10.2 Architektura systemu lokalizacji

System lokalizacji składa si˛e z kilku kluczowych komponentów:

- Moduł odbiornika GPS podł ˛aczony do mikrokontrolera poprzez interfejs UART
- Kolektor danych GPS (gps_collector) odpowiedzialny za odczytywanie suro-

wych danych z UART

- Klasa NMEAData przechowuj ˛aca przetworzone dane z protokołu NMEA
- Zestaw komend do zarz ˛adzania i odczytu danych GPS

Najwazniejszym elementem systemu jest moduł odbiorczy GPS, który komuni- ˙

kuje si˛e z mikrokontrolerem poprzez dedykowany port UART. Komunikacja odbywa si˛e

przy wykorzystaniu standardowego protokołu NMEA 0183 [1], który definiuje format

komunikatów wysyłanych przez odbiornik GPS. Zdecydowałem si˛e na wykorzystanie

tego protokołu ze wzgl˛edu na jego powszechne zastosowanie w przemysle oraz do- ´

st˛epnos´c gotowych bibliotek do jego obsługi. ´

### 4.10.3 Protokół NMEA i jego obsługa

Protokół NMEA 0183 jest standardowym protokołem komunikacyjnym uzywanym ˙

przez wi˛ekszos´c odbiorników GPS. Protokół ten definiuje format komunikatów teksto- ´

wych, które składaj ˛a si˛e z sekwencji ASCII rozpoczynaj ˛acych si˛e znakiem $ i zakon-´

czonych znakami konca linii (\r\n). Ka ´ | zda wiadomo ˙ | s´c protokołu NMEA zawiera okre- ´

slony typ danych identyfikowany przez prefiks po znaku $. ´

Typy komunikatów NMEA

W systemie lokalizacji satelity KubiSat zdecydowałem si˛e na przetwarzanie dwóch

najwazniejszych typów komunikatów NMEA: ˙

- GPRMC (Recommended Minimum Navigation Information) - zawiera podstawowe

informacje nawigacyjne takie jak czas, data, pozycja, pr˛edkos´c i kurs ´

- GPGGA (Global Positioning System Fix Data) - zawiera dane o jakosci fixa GPS, ´

liczbie widocznych satelitów i wysokosci nad poziomem morza ´

Ponizej przedstawiam przykład komunikatu GPRMC: ˙

$GPRMC,123519,A,4807.038,N,01131.000,E,022.4,084.4,230394,003.1,W*6A

Gdzie:

- 123519 - czas UTC w formacie hhmmss (12:35:19)
- A - status (A = aktywny, V = niewazny) ˙
- 4807.038,N - szerokos´c geograficzna (48° 07.038’ N) ´
- 01131.000,E - długos´c geograficzna (11° 31.000’ E) ´
- 022.4 - pr˛edkos´c w w˛ezłach ´
- 084.4 - kierunek w stopniach
- 230394 - data w formacie ddmmyy (23.03.1994)
- 003.1,W - deklinacja magnetyczna
- *6A - suma kontrolna

Klasa NMEAData

Do przechowywania i zarz ˛adzania danymi z protokołu NMEA stworzyłem klas˛e

NMEAData, która implementuje wzorzec projektowy Singleton. Klasa ta przechowuje to-

keny z ostatnio odebranych komunikatów GPRMC i GPGGA oraz udost˛epnia metody

do ich aktualizacji i odczytu. Dzi˛eki zastosowaniu wzorca Singleton, dane GPS s ˛a do-

st˛epne dla wszystkich podsystemów satelity za pomoc ˛a jednej instancji klasy.

Zdecydowałem si˛e na zabezpieczenie dost˛epu do danych GPS za pomoc ˛a mu-

teksów, poniewaz dane te mog ˛a by ˙ | c aktualizowane i odczytywane z ró ´ | znych w ˛atków. ˙
Muteksy zapewniaj ˛a, ze operacje odczytu i zapisu nie b˛ed ˛a si˛e nakłada ˙ | | c, co mogłoby ´
prowadzic do niespójno ´ | sci danych. ´

### 4.10.4 Kolektor danych GPS

Głównym elementem systemu odpowiedzialnym za zbieranie danych z odbior-

nika GPS jest funkcja collect_gps_data(). Funkcja ta jest wywoływana cyklicznie w

głównej p˛etli programu i odpowiada za:

- Odczytywanie surowych danych z portu UART podł ˛aczonego do odbiornika GPS
- Buforowanie danych i wykrywanie kompletnych komunikatów NMEA
- Przetwarzanie komunikatów NMEA i aktualizacj˛e danych w klasie NMEAData
1 | void collect_gps_data() {

if (SystemStateManager::get_instance().is_gps_collection_paused()) {

return;

}

6

std::array<char, MAX_RAW_DATA_LENGTH> raw_data_buffer;

static int raw_data_index = 0;

while (uart_is_readable(GPS_UART_PORT)) {

11 | char c = uart_getc(GPS_UART_PORT);

if (c == ’\r’ || c == ’\n’) {

// End of message

if (raw_data_index > 0) {

16 | raw_data_buffer[raw_data_index] = ’\0’;
| std::string message(raw_data_buffer.data());
| raw_data_index = 0;

// Split the message into tokens

21 | std::vector<std::string> tokens = splitString(message, ’,’);

// Update the global vectors based on the sentence type

if (message.find("$GPRMC") == 0) {

NMEAData::get_instance().update_rmc_tokens(tokens);

26 | } else if (message.find("$GPGGA") == 0) {
| NMEAData::get_instance().update_gga_tokens(tokens);

}

}

} else {

31 | // Append to buffer
| if (raw_data_index < MAX_RAW_DATA_LENGTH - 1) {
| raw_data_buffer[raw_data_index++] = c;
| } else {
| raw_data_index = 0;
36 | }

}

}

}

Listing 4.17: Funkcja zbieraj ˛aca dane GPS

Stan systemowy is_gps_collection_paused jest sprawdzany na pocz ˛atku funk-

cji, aby w przypadku jego aktywacji zatrzymac zbieranie danych GPS - jest to koniecz- ´

nie w sytuacji aktywnego trybu przekierowania UART (opisanego w 4.10.5).

### 4.10.5 Komendy systemu lokalizacji

System lokalizacji udost˛epnia nast˛epuj ˛ace komendy, które mog ˛a byc wykorzy- ´

stane do zarz ˛adzania modułem GPS:

Sterowanie zasilaniem modułu GPS

Funkcja handle_gps_power_status() obsługuje komend˛e sterowania zasilaniem

modułu GPS. Pozwala ona na wł ˛aczenie lub wył ˛aczenie modułu GPS, co jest istotne

dla oszcz˛edzania energii w okresach, gdy dane pozycyjne nie s ˛a potrzebne.

To polecenie jest dost˛epne tylko w trybie naziemnym, opisanym w 4.3.3 - w trybie

lotu nie ma mozliwo ˙ sci r˛ecznego wył ˛aczenia zasilania. ´

Algorytm funkcji handle_gps_power_status() realizuje nast˛epuj ˛ac ˛a logik˛e:

W pierwszym kroku funkcja inicjalizuje pust ˛a tablic˛e ramek odpowiedzi. Nast˛ep-

nie, zaleznie od typu operacji, wykonuje odpowiednie działania. ˙

Dla operacji typu SET (ustawianie stanu zasilania):

1. Sprawdza, czy system pracuje w trybie zasilania bateryjnego. Jesli tak, zwraca ´

ID | Format komendy | Opis
7.1 KBST;0;GET;7;1;;TSBK | Pobiera aktualny stan zasilania modułu
| | GPS (wł ˛aczony/wył ˛aczony).
7.1 KBST;0;SET;7;1;POWER;TSBK | Ustawia stan zasilania modułu GPS. PO-
| | WER=0 (wył ˛aczony), POWER=1 (wł ˛a-
| | czony).

7.2 KBST;0;SET;7;2;TIMEOUT;TSBK Wł ˛acza tryb transparentny UART dla mo-

| | dułu GPS. TIMEOUT okresla czas trwa- ´
| | nia trybu w sekundach (domyslnie 60s). W ´
trybie transparentnym mozna bezpo ˙ | sred- ´
| | nio komunikowac si˛e z modułem GPS. Aby ´
| | wyjs´c z trybu przed upływem limitu czasu, ´
nalezy wysła ˙ | c sekwencj˛e "##EXIT##". ´

Tabela 4.10: Komendy systemu lokalizacji

bł ˛ad INVALID_OPERATION, poniewaz zmiana stanu zasilania GPS jest niedo- ˙

zwolona w tym trybie.

2. Weryfikuje, czy parametr jest pusty. W przypadku braku parametru zwraca bł ˛ad
PARAM_REQUIRED, poniewaz warto ˙ | s´c stanu zasilania jest wymagana. ´
3. Próbuje skonwertowac parametr na warto ´ | s´c liczbow ˛a całkowit ˛a. Je ´ | sli konwersja ´

nie powiedzie si˛e lub wartos´c nie jest równa 0 lub 1, zwraca bł ˛ad PARAM_INVALID. ´

4. Po pomyslnej walidacji ustawia pin zasilaj ˛acy moduł GPS na ´ | z ˛adan ˛a warto ˙ | s´c (0 ´
- wył ˛aczony, 1 - wł ˛aczony).
5. Emituje odpowiednie zdarzenie systemowe (POWER_ON lub POWER_OFF).
6. Zwraca odpowied´z sukcesu wraz z informacj ˛a o nowym stanie zasilania.

Dla operacji typu GET (odczyt stanu zasilania):

1. Sprawdza, czy parametr nie jest pusty. Jesli zawiera jak ˛a ´ | s warto ´ | s´c, zwraca bł ˛ad ´

PARAM_UNNECESSARY, poniewaz operacja odczytu nie wymaga parametrów. ˙

2. Odczytuje aktualny stan pinu zasilaj ˛acego moduł GPS.

3. Zwraca odpowied´z zawieraj ˛ac ˛a aktualny stan zasilania modułu GPS.

Taka implementacja zapewnia bezpieczn ˛a kontrol˛e nad zasilaniem modułu GPS,

uwzgl˛edniaj ˛ac aktualny tryb pracy systemu oraz poprawnos´c parametrów wej ´ | sciowych. ´

Tryb transparentny UART

Funkcja handle_enable_gps_uart_passthrough() umozliwia wej ˙ | scie w tryb trans- ´

parentny, w którym komunikacja z modułem GPS odbywa si˛e bezposrednio przez port ´

UART. Jest to szczególnie przydatne podczas debugowania i konfiguracji modułu GPS,

poniewaz pozwala na wysyłanie specjalnych komend konfiguracyjnych do odbiornika ˙

przez oprogramowanie producenta.

Ten tryb jest dost˛epny tylko w trybie naziemnym 4.3.3, poniewaz jego aktywacja ˙

blokuje zbieranie danych GPS przez system lokalizacji na czas trwania trybu.

Funkcja handle_enable_gps_uart_passthrough() realizuje nast˛epuj ˛acy algorytm:

1. Sprawdzenie typu operacji (musi byc SET). ´
2. Wył ˛aczenie komendy w trybie bateryjnym.
3. Parsowanie i walidacja parametru timeout.
4. Konfiguracja parametrów UART i sekwencji wyjscia. ´
5. Wstrzymanie zbierania danych GPS.
6. Emisja zdarzenia rozpocz˛ecia trybu.
7. Zmiana baudrate UART na baudrate GPS.
8. Przekazywanie danych mi˛edzy portami UART.
9. Przywrócenie oryginalnego baudrate UART.
10. Wznowienie zbierania danych GPS.
11. Emisja zdarzenia zakonczenia trybu. ´
12. Budowa i zwrot ramki odpowiedzi.

# System operatora satelity

W celu ułatwienia zdalnej komunikacji z modelem stworzyłem prosty system słu-

z ˛acy do wysyłania polece ˙ | n i odbierania danych z satelity. System ten składa si˛e z płytki ´

Raspberry Pi RP2040-Zero, modułu LoRa SX1278, identycznego jak w satelicie, oraz

z konwertera USB-UART słuz ˛acego do komunikacji z komputerem. Funkcj˛e konwer- ˙

tera realizuje prosty i powszechny układ CH340N, który emuluje port szeregowy na

komputerze.

Prosty program pracuj ˛acy w pami˛eci mikrokontrolera RP2040 odpowiada za dwu-

stronn ˛a komunikacj˛e z modułem LoRa. Wysyła on dane odebrane z komputera przez

port szeregowy do modułu LoRa i odbiera dane z modułu LoRa, które przekazuje do

komputera. Główna p˛etla programu jest wywoływana praktycznie od razu po podł ˛acze-

niu konwertera do komputera, co pozwala na natychmiastow ˛a komunikacj˛e z modelem.

Istnieje mozliwo ˙ | s´c wysyłania ramek komunikacji bezpo ´ | srednio na utworzony wir- ´

tualny port COM, jednak w celu ułatwienia interakcji z uzytkownikiem stworzyłem pro- ˙

sty interfejs graficzny bazuj ˛acy na j˛ezyku C# i frameworku WPF (Windows Presentation

Foundation). Interfejs ten pozwala na wysyłanie komend do satelity, odbieranie odpo-

wiedzi, wizualizacj˛e danych telemetrycznych, zarz ˛adanie konfiguracj ˛a systemu oraz

podgl ˛ad komunikacji w czasie rzeczywistym.

Ponadto program pozwala na eksport wizualizacji telemetrii do formatu PNG, za-

pisywanie logów komunikacji do pliku tekstowego a co najwazniejsze, umo ˙ | zliwia wczy- ˙
tanie danych telemetrycznych z pliku i ich wizualizacj˛e. Dzi˛eki temu uzytkownik mo ˙ | ze˙
analizowac dane telemetryczne zebrane na kart˛e SD w trakcie lotu po jego zako ´ | ncze- ´
niu, bez koniecznosci korzystania z ł ˛aczno ´ | sci radiowej z modelem. ´

## 5.1 Warstwa sprz˛etowa

## 5.2 Warstwa programowa

### 5.2.1 Wprowadzenie

Program został zaprojektowany z mysl ˛a o zapewnieniu prostego w obsłudze in- ´

terfejsu do monitorowania i kontrolowania satelity poprzez port szeregowy, realizuj ˛ac

komunikacj˛e w oparciu o protokół LoRa.

### 5.2.2 Architektura systemu

Model komunikacji

W sercu systemu znajduje si˛e model komunikacji oparty na protokole tekstowym,

który zaimplementowałem przy pomocy klas SerialCommunicator i CommandManager.

Struktura klas

System kubisat_operator zorganizowałem wokół nast˛epuj ˛acych kluczowych klas:

- SerialCommunicator - odpowiada za niskopoziomow ˛a komunikacj˛e przez port

szeregowy, buforowanie danych oraz wykrywanie kompletnych ramek.

- CommandManager - implementuje mechanizm asynchronicznego wywołania ko-

mend i oczekiwania na odpowiedzi przy uzyciu ˙ TaskCompletionSource.

- CommandDefinition - definiuje struktur˛e komendy wraz z jej identyfikatorami, na-

zw ˛a, uprawnieniami dost˛epu i opisem.

- CommandRegistry - centralny rejestr wszystkich dost˛epnych komend w systemie.
- CommandViewModel - implementuje wzorzec MVVM dla komend, umozliwiaj ˛ac po- ˙

wi ˛azanie logiki aplikacji z interfejsem uzytkownika. ˙

Wykorzystałem architektur˛e MVVM (Model-View-ViewModel), która umozliwia se- ˙

paracj˛e logiki biznesowej od warstwy prezentacji, co znacz ˛aco ułatwia testowanie i

rozbudow˛e systemu.

### 5.2.3 Asynchroniczny system obsługi komend

Mechanizm wywołania i oczekiwania

Jednym z kluczowych elementów, który zaimplementowałem, jest asynchroniczny

system obsługi komend. Zastosowałem nowoczesne podejscie oparte na ´ | async/await
w C#, które eliminuje złozon ˛a logik˛e obsługi wywoła ˙ | n zwrotnych (callbacks). ´
Kazde wywołanie komendy zwraca ˙ | Task<string>, który jest realizowany dopiero

po otrzymaniu odpowiedzi z satelity. Przykładowo:

1 | public async Task<string> ExecuteCommandAsync(CommandDefinition command,
| string parameter = "", string operationType = "GET")

{

| // Utworzenie klucza komendy
6 | string commandKey = $"{command.GroupId}-{command.Id}-{operationType}";

// Utworzenie źródła zakończenia zadania (TaskCompletionSource)

var commandTask = new TaskCompletionSource<string>();

_pendingCommands[commandKey] = commandTask;

11

// Wysłanie komendy

await _serialCommunicator.SendFrameAsync(CreateCommandFrame(...));

// Oczekiwanie na odpowiedź z timeout’em

16 | return await commandTask.Task.WaitAsync(TimeSpan.FromSeconds(10));

}

Listing 5.1: Asynchroniczne wywołanie komendy

Gdy odpowied´z z satelity zostanie odebrana, system automatycznie identyfikuje odpowiedni ˛a TaskCompletionSource i sygnalizuje jej zakonczenie, co wznawia wyko- ´

nanie kodu czekaj ˛acego na wynik.

Obsługa bł˛edów i timeout’ów

W ramach systemu zaimplementowałem kompleksow ˛a obsług˛e bł˛edów, która

uwzgl˛ednia:

- Timeout komunikacji (maksymalnie 2 sekundy oczekiwania na odpowied´z)
- Bł˛edy raportowane przez satelit˛e (ramki typu ERR)
- Wyj ˛atki zwi ˛azane z komunikacj ˛a szeregow ˛a
- Bł˛edy parsowania danych

Dzi˛eki mechanizmowi wyj ˛atków C# i konstrukcji try/catch, kazdy bł ˛ad jest od- ˙

powiednio przechwytywany i prezentowany uzytkownikowi w sposób przyst˛epny. ˙

### 5.2.4 Wizualizacja danych

Z ˛adanie pobrania ostatniego rekordu telemtrii lub odczytów ˙ | srodowiskowych z ´

satelity automatycznie wypełnia pola tabeli w interfejsie uzytkownika. Zaimplemento- ˙

wałem mechanizm automatycznego odswie ´ zania danych co 1 sekund˛e, co pozwala na ˙

monitorowanie zmian w czasie rzeczywistym - w tym przypadku dane s ˛a na biez ˛aco ˙

wizualizowane na wykresach.

System wykresów

Dla efektywnego monitorowania parametrów satelity, zaimplementowałem sys-

tem wizualizacji danych oparty na bibliotece OxyPlot [4]. Dane s ˛a organizowane w

kilku kategoriach:

- Telemetria zasilania (napi˛ecia, pr ˛ady ładowania i rozładowania)
- Dane sensoryczne (temperatura, cisnienie, wilgotno ´ | s´c, nat˛e ´ | zenie ˙ | swiatła) ´

- Dane pozycyjne GPS

Dla kazdego typu danych utworzyłem dedykowane klasy zarz ˛adzaj ˛ace wykre- ˙

sami, takie jak TelemetryPlotManager i SensorPlotManager, które obsługuj ˛a:

- Dynamiczne dodawanie punktów danych
- Automatyczne skalowanie osi
- Obsług˛e legendy
- Eksport wykresów do plików PNG

Wizualizacja lokalizacji

W przypadku pobrania jednego rekordu z lokalizacj ˛a GPS, system automatycznie

wyswietla link przekierowuj ˛acy do mapy Google z zaznaczon ˛a pozycj ˛a, natomiast po ´

zakonczeniu trybu monitorowania, system generuje plik KML, który mo ´ | zna zaimporto- ˙
wac do Google Earth w celu wizualizacji trasy w trzech wymiarach. Plik KML mo ´ | zna ˙
takze wygenerowa ˙ | c dla zaimportowanych danych historycznych. ´

### 5.2.5 Zarz ˛adzanie danymi

System obsługuje nast˛epuj ˛ace formaty danych:

- Format CSV dla importu/eksportu danych telemetrycznych i sensorycznych
- Format tekstowy dla logów komunikacji
- Format PNG dla eksportu wykresów

Dane s ˛a przechowywane w strukturach takich jak TelemetryRecord i SensorDataRecord,

które enkapsuluj ˛a wszystkie istotne parametry wraz z metodami konwersji.

System automatycznie generuje nazwy plików zawieraj ˛ace dat˛e i czas, ułatwiaj ˛ac

organizacj˛e danych.

### 5.2.6 Interfejs u˙zytkownika

Organizacja interfejsu

Interfejs uzytkownika zorganizowałem wokół zakładek tematycznych, odpowiada- ˙

j ˛acych głównym funkcjom systemu:

- Parametry systemowe - ustawienia i diagnostyka
- GPS - kontrola modułu GPS i wizualizacja pozycji
- Telemetria - monitoring parametrów zasilania i pracy systemu
- Sensory - dane z czujników srodowiskowych ´
- Log komunikacji - monitorowanie surowej komunikacji

Kazda zakładka zawiera odpowiednie elementy steruj ˛ace i prezentacyjne, zorga- ˙

nizowane w logiczne grupy.

Kolorowanie logów

Dla ułatwienia analizy komunikacji, zaimplementowałem system kolorowania lo-

gów w monitorze komunikacji:

- Kolor niebieski - komunikaty przychodz ˛ace (kierunek = 1)
- Kolor zielony - komunikaty wychodz ˛ace (kierunek = 0)
- Kolor czarny - pozostałe informacje diagnostyczne

System obsługuje równiez opcjonalne znaczniki czasu oraz automatyczne prze- ˙

wijanie do najnowszych wpisów.

### 5.2.7 Automatyczne wykrywanie urz ˛adzen´

Zaimplementowałem mechanizm automatycznego wykrywania zmian w dost˛ep-

nych portach szeregowych, wykorzystuj ˛ac klas˛e ManagementEventWatcher z przestrzeni

nazw System.Management. System reaguje na podł ˛aczenie lub odł ˛aczenie urz ˛adzen,´

dynamicznie aktualizuj ˛ac list˛e dost˛epnych portów.

### 5.2.8 Mechanizmy odswie˙zania danych ´

Dla zapewnienia aktualnosci informacji, zaimplementowałem kilka mechanizmów ´

odswie ´ | zania danych: ˙
- R˛eczne odswie ´ | zanie po klikni˛eciu odpowiednich przycisków ˙
- Automatyczne odswie ´ | zanie z konfigurowalnymi czasem trwania dla telemetrii i ˙

danych sensorycznych

- Pasek post˛epu wizualizuj ˛acy pozostały czas

Mechanizm ten opiera si˛e na klasie DispatcherTimer, która zapewnia wykony-

wanie operacji odswie ´ | zania w kontek ˙ | scie w ˛atku UI. Po ustawieniu czasu od ´ | swie ´ | zania, ˙

system automatycznie aktualizuje dane i wykresy co 1 sekund˛e poprzez wysłanie za-

pytania do satelity o aktualne wartosci. ´

### 5.2.9 Informacje o jakosci poł ˛aczenia ´

Na górze okna programu umiesciłem przeł ˛acznik diagnostyki poł ˛aczenia - po wł ˛a- ´

czeniu tej opcji, do kazdej ramki przesyłanej przez port szeregowy do stacji naziemnej ˙

dodawany jest wczesniej ustalony znak specjalny - w tym przypadku znak zapytania ´

(?). Po otrzymaniu ramki z tym znakiem, program ustawia flag˛e zad ˛ania informacji o ja- ˙

kosci poł ˛aczenia, a nast˛epnie po oedbraniu ramki odpowiedzi z satelity, doł ˛acza do niej ´

informacje o RSSI i SNR, a nast˛epnie przekazuje do portu UART. Program na stacji

naziemnej odczytuje te dane i prezentuje je w interfejsie uzytkownika. ˙

### 5.2.10 Zrzuty ekranu

W tej sekcji prezentuj˛e kilka zrzutów ekranu z działania systemu kubisat_operator,

które ilustruj ˛a główne funkcje i interfejs uzytkownika. ˙

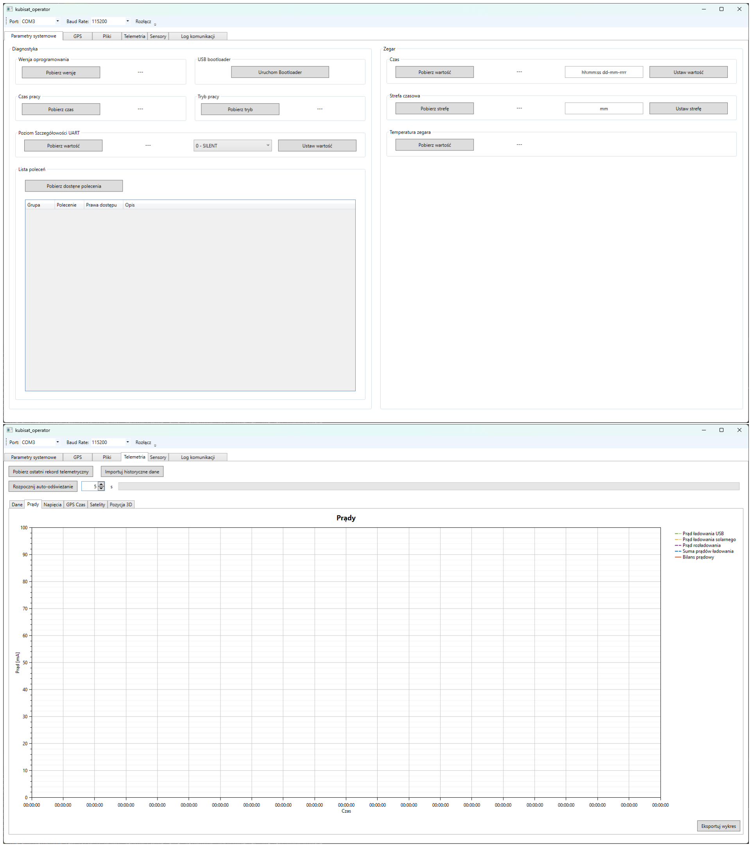
[picture p22: figure]

Rysunek 23: Główne okno programu kubisat_operator

# Testy

## 6.1 Testy polecen´

Testy poprawnosci działania systemu komunikacji oraz zale ´ | zno ˙ | sci mi˛edzy syste- ´

mami wykonałem uzywaj ˛ac do tego celu zakładki Testy w programie Operator 5. ˙

Kazde z dost˛epnych polece ˙ | n przetestowałem pod k ˛atem poprawno ´ | sci działania, ´

poprzez wysłanie odpowiednich komend do modelu i sprawdzenie czy odpowied´z jest

zgodna z oczekiwaniami. Sprawdziłem czy polecenia maj ˛a prawa dostepu zgodne z

załozeniami, poprawno ˙ | s´c odpowiedzi, formatowanie oraz czas odpowiedzi systemu na ´

polecenie.

## 6.2 Testy telemetrii

Testy systemu telemetrii przeprowadziłem w formie ograniczonej symulacji lotu

modelu. W tym celu wykonałem przejazd samochodem z wł ˛aczonym modelem na tra-

sie o długosci około 17km Satelita pracował cały czas na własnym zasilaniu, zgodnie ´

z załozeniami system telemetrii rejestrował dane z modułu GPS, pomiary parametrów ˙

zasilania oraz dane z czujników.

Korzystaj ˛ac z programu Operator (opis w 5) odczytałem zapisane dane z pami˛eci

urz ˛adzenia. Dane zostały zapisane w pliku CSV, który nast˛epnie zaimportowałem jako

dane historyczne do programu w celu analizy. Ponizej przedstawiam wyniki testów w ˙

formie wykresów, tabel oraz sladu GPS. ´

Na wykresie nat˛ezenia ˙ | swiatła oraz temperatury i wilgotno ´ | sci około godziny 21:58 ´
widac nagłe zmiany warto ´ | sci. Wynika to z faktu ´ | ze w tym momencie przenosiłem model ˙

z samochodu do domu, co spowodowało zmian˛e warunków srodowiskowych. ´

Skoki pobieranego pr ˛adu zasilania wynikaj ˛a z pracy modułu radiowego - po prze-

niesieniu modelu do domu odczytałem zdalnie jego parametry w celu sprawdzenia

poprawnosci działania. ´

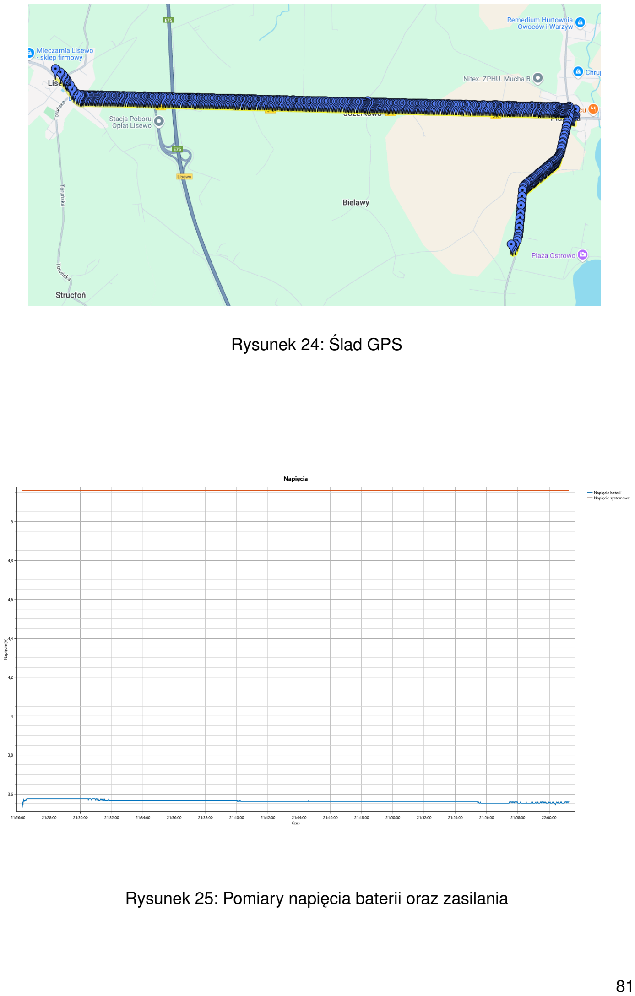
[picture p23: page 85]

Rysunek 24: Slad GPS ´

Rysunek 25: Pomiary napi˛ecia baterii oraz zasilania

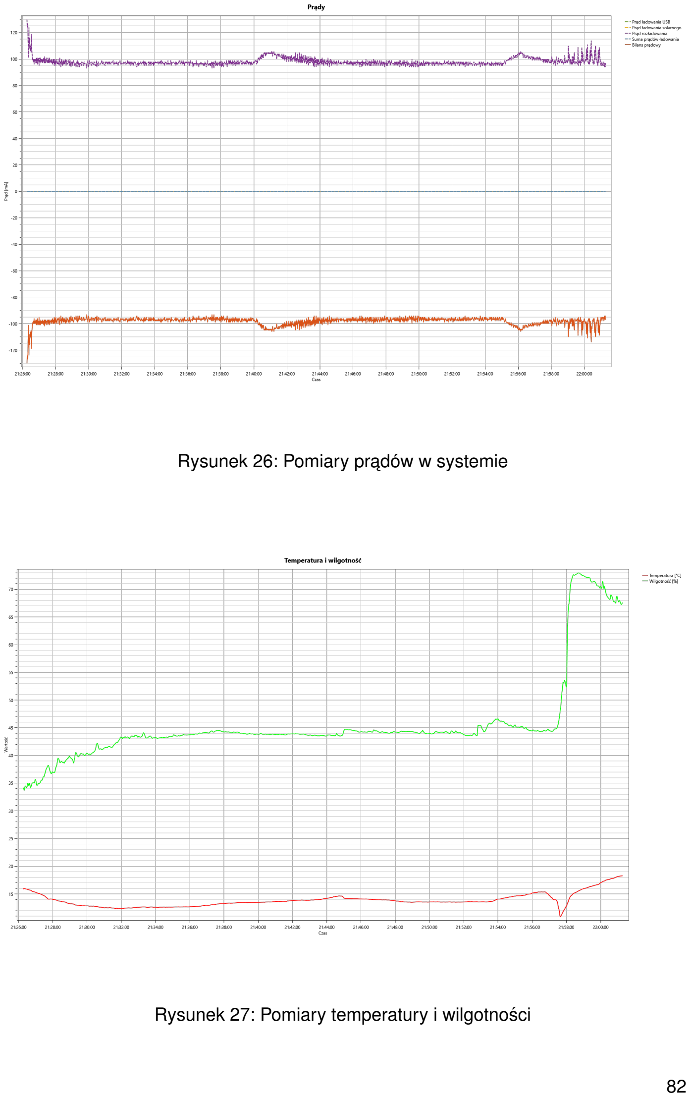
[picture p24: page 86]

Rysunek 26: Pomiary pr ˛adów w systemie

Rysunek 27: Pomiary temperatury i wilgotnosci ´

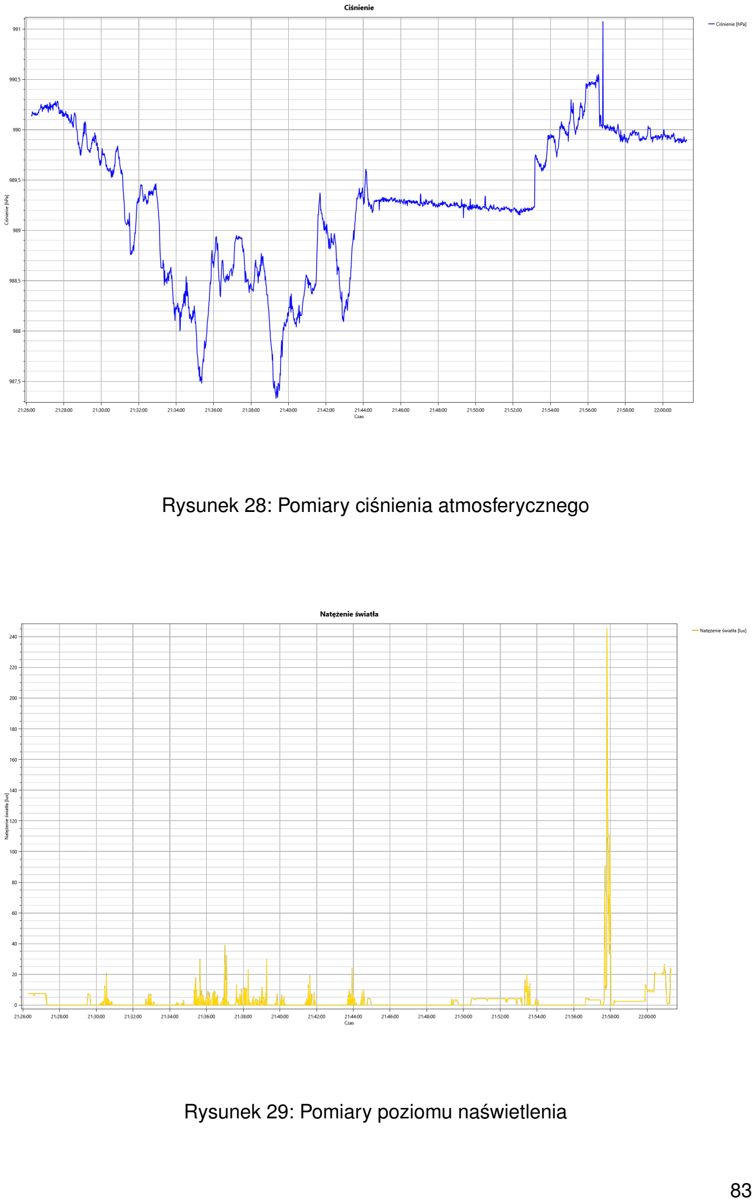
[picture p25: page 87]

Rysunek 28: Pomiary cisnienia atmosferycznego ´

Rysunek 29: Pomiary poziomu naswietlenia ´

# Podsumowanie

## 7.1 Wnioski

Celem pracy było zaprojektowanie i zbudowanie systemu komunikacji z satelit ˛a

typu CubeSat. System miał umozliwi ˙ c zdalne sterowanie satelit ˛a, pobieranie danych ´

telemetrii oraz konfiguracj˛e parametrów pracy. Postawione cele zrealizowałem a sys-

tem działa zgodnie z załozeniami co potwierdzaj ˛a testy przeprowadzone na modelu ˙

satelity.

## 7.2 Mo˙zliwosci rozwoju ´

System komunikacji z satelit ˛a jest w pełni funkcjonalny, jednak istnieje wiele moz-˙

liwosci rozwoju i ulepszenia. Poni ´ | zej przedstawiam kilka propozycji rozwoju systemu: ˙
- Rozbudowa systemu o dodatkowe moduły komunikacji, takie jak moduł GSM,

który umozliwiłby komunikacj˛e z satelit ˛a w dowolnym miejscu na ziemi. ˙

- Implementacja systemu w oparciu o FreeRTOS, co pozwoliłoby na zwi˛ekszenie
stabilnosci systemu oraz mo ´ | zliwo ˙ | s´c uruchomienia wielu zada ´ | n równolegle. ´
- Implementacja trybów oszcz˛edzania energii, które pozwoliłyby na zwi˛ekszenie

czasu pracy satelity.

- Rozbudowa systemu o dodatkowe czujniki, które pozwoliłyby na zbieranie dodat-

kowych danych telemetrii.

- Implementacja systemu kontroli dost˛epu, który pozwoliłby na zabezpieczenie do-

st˛epu do systemu przed niepowołanymi osobami.

- Rozbudowa systemu o prost ˛a kamer˛e, która pozwoliłaby na wykonywanie zdj˛ec´

z orbity.

Dla docelowego systemu satelitarnego mozliwe jest równie ˙ | z rozszerzenie funk- ˙
cjonalnosci o polecenia pobierania plików z karty SD, a tak ´ | ze system automatycznej ˙

synchronizacji czasu z GPS, automatycznego wykrywania i inicjalizacji nowych mo-

dułów w trakcie pracy systemu oraz rozbudowa systemu zarz ˛adzania energi ˛a w celu

zwi˛ekszenia czasu pracy satelity.

Aby ładowanie z ogniw fotowołtaicznych było bardziej efektywne, nalezałoby zmie- ˙

nic ich konfiguracj˛e na wi˛eksz ˛a ilo ´ | s´c paneli mniejszego rozmiaru, co przez zwi˛ekszenie ´

napi˛ecia zwi˛ekszyłoby sprawnos´c ładowania. ´

# Bibliografia

[1] National Marine Electronics Association. Nmea 0183 standard for interfacing

marine electronic devices. https://www.plaisance-pratique.com/IMG/pdf/

NMEA0183-2.pdf, (https://www.plaisance-pratique.com/IMG/pdf/NMEA0183-2.pdf) 2002. Version 3.01, dost˛ep 03-2025.

[2] Akshaya Bali. Raspberry pi pico lora library. https://github.com/akshayabali/

pico-lora, (https://github.com/akshayabali/pico-lora) 2021. MIT, dost˛ep 12-2024.

[3] Shenzhen H&M Semiconductor Co.Ltd. Dw01a. https://hmsemi.com/downfile/

dw01a.pdf, (https://hmsemi.com/downfile/dw01a.pdf) 2023. Dost˛ep 11-2024.

[4] OxyPlot Contributors. Oxyplot: Cross-platform plotting library for .net, 2024. Do-

st˛ep 03-2025.

[5] Doroshkin, Alexander, Zadorozhny, Alexander, Kus, Oleg, Prokopyev, Vitaliy, and

Prokopyev, Yuri. Laboratory testing of lora modulation for cubesat radio commu-

nications. MATEC Web Conf., 158:01008, 2018.

[6] Texas Instruments. Ina3221. https://www.ti.com/lit/ds/symlink/ina3221.

pdf, (https://www.ti.com/lit/ds/symlink/ina3221.pdf) 2012. SBOS576B, dost˛ep 11-2024.

[7] Hiroyuki OYAMA. pico-vfs: Virtual file system for raspberry pi pico. https://

github.com/raspberrypi/pico-vfs, 2024. BSD-3-Clause, dost˛ep 02-2025.

[8] Semtech. | Sx1278. | https://semtech.my.salesforce.com/sfc/p/

#E0000000JelG/a/2R0000001Rc1/QnUuV9TviODKUgt_rpBlPz.EZA_PNK7Rpi8HA5.

.Sbo, (https://semtech.my.salesforce.com/sfc/p/) 2020. Rev. 7 - May 2020, dost˛ep 11-2024.

[9] Bosch Sensortec. | Bme280. | https://www.bosch-sensortec.com/media/
boschsensortec/downloads/datasheets/bst-bme280-ds002.pdf, (https://www.bosch-sensortec.com/media/boschsensortec/downloads/datasheets/bst-bme280-ds002.pdf) 2015. | BST-

BME280-DS002, dost˛ep 11-2024.

[10] Ltd. Shanghai Natlinear Electronics Co. | Ln2220 2a high efficiency boost
dc/dc voltage regulator. | https://www.lcsc.com/datasheet/lcsc_datasheet_

2105242005_NATLINEAR-LN2220PAR_C2833712.pdf, (https://www.lcsc.com/datasheet/lcsc_datasheet_2105242005_NATLINEAR-LN2220PAR_C2833712.pdf) 2014. Rev. 1.0, dost˛ep 11-

2024.

[11] The Things Network Global Team. Lorawan® distance world record broken,

twice. 766 km (476 miles) using 25mw transmission power. https://www.

thethingsnetwork.org/article/lorawan-distance-world-record, 2019, do-

st˛ep 11-2024.

[12] u blox. Neo-6m. https://www.u-blox.com/sites/default/files/products/

documents/NEO-6_DataSheet_%28GPS.G6-HW-09005%29.pdf, (https://www.u-blox.com/sites/default/files/products/documents/NEO-6_DataSheet_%28GPS.G6-HW-09005%29.pdf) 2015. GPS.G6-HW-

09005, dost˛ep 12-2024.

[13] California Polytechnic State University. Cubesat design specification rev.
13. https://static1.squarespace.com/static/5418c831e4b0fa4ecac1bacd/t/

56e9b62337013b6c063a655a/1458157095454/cds_rev13_final2.pdf, (https://static1.squarespace.com/static/5418c831e4b0fa4ecac1bacd/t/56e9b62337013b6c063a655a/1458157095454/cds_rev13_final2.pdf) 2014. The

CubeSat Program, Cal Poly SLO, dost˛ep 09-2024.

# Spis rysunków

1 | Schemat blokowy | | 8
2 | Diagram modułu zasilania | | 10
3 | Schemat układu pomiarowego | | 12
4 | Schemat zabezpieczenia akumulatorów | | 13
5 | Schemat układu ładowania USB | | 14
6 | Schemat układu ładowania paneli fotowoltaicznych | | 15
7 | Charakterystyka przetwornicy LN2220 | | 16
8 | Schemat przetwornicy | | 16
9 | Schemat poł ˛aczen procesora | ´ | 18
10 | Schemat poł ˛aczen modułu radiowego | ´ | 19
11 | Schemat poł ˛aczen modułu GPS | ´ | 21
12 | Schemat poł ˛aczen zegara czasu rzeczywistego | ´ | 22
13 | Schemat poł ˛aczen karty pami˛eci SD | ´ | 23
14 | Schemat poł ˛aczen modułu czujników | ´ | 24
15 | Wymiary podstawy | | 27
16 | Wymiary elementu naroznego | ˙ | 27
17 | Obudowa podzielona na dwie czesci | ´ | 28
18 | Obudowa zmontowana | | 28
19 | Cz˛esciowo otwarta obudowa | ´ | 29
20 | Obudowa kompletna bez ogniw | | 29
21 | Obudowa z ogniwami fotowoltaicznymi | | 30
22 | Schemat komunikacji w systemie | | 35
23 | Główne okno programu kubisat_operator | | 79
24 | Slad GPS | ´ | 81

25 | Pomiary napi˛ecia baterii oraz zasilania | | 81
26 | Pomiary pr ˛adów w systemie | | 82
27 | Pomiary temperatury i wilgotnosci | ´ | 82
28 | Pomiary cisnienia atmosferycznego | ´ | 83
29 | Pomiary poziomu naswietlenia | ´ | 83

# Spis listingów

4.1 Stany systemowe | | 39
4.2 Klasa PowerManager | | 41
4.3 Struktura EventLog | | 44
4.4 Klasa EventManager | | 44
4.5 Przykładowe enumeracje zdarzen | ´ | 45
4.6 Funkcja emituj ˛aca zdarzenie | | 46
4.7 Klasa EventEmitter | | 46
4.8 Implementacja funkcji log_event | | 47
4.9 Implementacja funkcji get_event | | 48
4.10 Inicjalizacja systemu plików | | 55
4.11 Pobieranie stanu karty SD | | 56
4.12 Definicja interfejsu ISensor | | 57
4.13 Definicje typów czujników i danych | | 58
4.14 Inicjalizacja czujników w klasie SensorWrapper | | 61
4.15 Odczytywanie danych z czujników w klasie SensorWrapper | | 62
4.16 Funkcja pobieraj ˛aca czas z układu DS3231 | | 63
4.17 Funkcja zbieraj ˛aca dane GPS | | 68
5.1 Asynchroniczne wywołanie komendy | | 74

# Spis tabel

4.5 Komendy systemu zdarzen | ´ | 49
