gredzikk/kubisat/software/kubisat_firmware/release/doc/doc_540.pdf

## KubiSat Firmware

Generated by Doxygen 1.13.2

i

1 credits | 1
2 Clock Commands | 3
3 Topic Index | 5
4 Hierarchical Index | 7
5 Class Index | 9
6 File Index | 11
7 Topic Documentation | 13

Generated by Doxygen

ii

iii

iv

v

vi

8 Class Documentation | 97

vii

viii

ix

x

xi

xii

xiii

9 File Documentation | 185

xiv

xv

xvi

xvii

xviii

xix

xx

Index | 319

# Chapter 1

# credits

this software uses following external libraries

## 1.1 pico-vfs

Copyright 2024, Hiroyuki OYAMA. All rights reserved.

Redistribution and use in source and binary forms, with or without modification, are permitted provided that the following conditions are met:

- Redistributions of source code must retain the above copyright notice, this list of conditions and the following disclaimer.
- Redistributions in binary form must reproduce the above copyright notice, this list of conditions and the following disclaimer in the documentation and/or other materials provided with the distribution.
- Neither the name of the copyright holder nor the names of its contributors may be used to endorse or promote products derived from this software without specific prior written permission.

THIS SOFTWARE IS PROVIDED BY THE COPYRIGHT HOLDERS AND CONTRIBUTORS “ AS IS” AND ANY EXPRESS OR IMPLIED WARRANTIES, INCLUDING, BUT NOT LIMITED TO, THE IMPLIED WARRANTIES OF MERCHANTABILITY AND FITNESS FOR A PARTICULAR PURPOSE ARE DISCLAIMED. IN NO EVENT SHALL THE COPYRIGHT HOLDER OR CONTRIBUTORS BE LIABLE FOR ANY DIRECT, INDIRECT, INCIDENTAL, SPE-CIAL, EXEMPLARY, OR CONSEQUENTIAL DAMAGES (INCLUDING, BUT NOT LIMITED TO, PROCUREMENT OF SUBSTITUTE GOODS OR SERVICES; LOSS OF USE, DATA, OR PROFITS; OR BUSINESS INTERRUPTION) HOWEVER CAUSED AND ON ANY THEORY OF LIABILITY, WHETHER IN CONTRACT, STRICT LIABILITY, OR TORT (INCLUDING NEGLIGENCE OR OTHERWISE) ARISING IN ANY WAY OUT OF THE USE OF THIS SOFT-WARE, EVEN IF ADVISED OF THE POSSIBILITY OF SUCH DAMAGE.

The following source code has been written with reference to the ARM Embed OS (https://github.com/ARMmbed/mbed-os) source code; ARM Embed OS is licensed under the Apache 2.0 licence.

- src/blockdevice/sd.c

Folders containing files by third parties are listed below. Each folder must contain a README file specifying the licence for that file. The original licence text is contained in these source files.

- vendor/ff15 - BSD-2-Clause, Copyright ChaN (http://www.elm-chan.org/fsw/ff/doc/appnote.html)
- vendor/littlefs- BSD-3-Clause

### 2 credits

## 1.2 pico-lora

MIT License

Copyright (c) 2021 Akshaya Bali

Permission is hereby granted, free of charge, to any person obtaining a copy of this software and associated documentation files (the "Software"), to deal in the Software without restriction, including without limitation the rights to use, copy, modify, merge, publish, distribute, sublicense, and/or sell copies of the Software, and to permit persons to whom the Software is furnished to do so, subject to the following conditions:

The above copyright notice and this permission notice shall be included in all copies or substantial portions of the Software.

THE SOFTWARE IS PROVIDED "AS IS", WITHOUT WARRANTY OF ANY KIND, EXPRESS OR IMPLIED, IN-CLUDING BUT NOT LIMITED TO THE WARRANTIES OF MERCHANTABILITY, FITNESS FOR A PARTICULAR PURPOSE AND NONINFRINGEMENT. IN NO EVENT SHALL THE AUTHORS OR COPYRIGHT HOLDERS BE LIABLE FOR ANY CLAIM, DAMAGES OR OTHER LIABILITY, WHETHER IN AN ACTION OF CONTRACT, TORT OR OTHERWISE, ARISING FROM, OUT OF OR IN CONNECTION WITH THE SOFTWARE OR THE USE OR OTHER DEALINGS IN THE SOFTWARE.

# Chapter 2

# Clock Commands

Member handle_enable_gps_uart_passthrough (const std::string &param, OperationType operationType)

Command ID: 7.2

Member handle_enter_bootloader_mode (const std::string &param, OperationType operationType)

Command ID: 2

Member handle_get_build_version (const std::string &param, OperationType operationType)

Command ID: 1

Member handle_get_commands_list (const std::string &param, OperationType operationType)

Command ID: 0

Member handle_get_event_count (const std::string &param, OperationType operationType)

Command ID: 5.2

Member handle_get_internal_temperature (const std::string &param, OperationType operationType)

Command ID: 3.4

Member handle_get_last_events (const std::string &param, OperationType operationType)

Command ID: 5.1

Member handle_get_last_telemetry_record (const std::string &param, OperationType operationType)

Command ID: 8.2

Member handle_get_power_mode (const std::string &param, OperationType operationType)

Command ID: 1.2

Member handle_get_uptime (const std::string &param, OperationType operationType)

Command ID: 1.3

Member handle_gps_power_status (const std::string &param, OperationType operationType)

Command ID: 7.1

### 4 Clock Commands

Member handle_time (const std::string &param, OperationType operationType)

Command ID: 3.0

Member handle_timezone_offset (const std::string &param, OperationType operationType)

Command ID: 3.1

Member handle_verbosity (const std::string &param, OperationType operationType)

Command ID: 1.8

# Chapter 3

# Topic Index

## 3.1 Topics

Here is a list of all topics with brief descriptions:

### 6 Topic Index

# Chapter 4

# Hierarchical Index

## 4.1 Class Hierarchy

This inheritance list is sorted roughly, but not completely, alphabetically:

BH1750 | 97
BME280 | 103
BME280CalibParam | 114
INA3221::conf_reg_t | 122
DS3231 | 124
ds3231_data_t | 128
EventEmitter | 130
EventLog | 131
EventManager | 133
Frame | 137
INA3221 | 139
ISensor | 143
BH1750Wrapper | 99
BME280Wrapper | 119
INA3221::masken_reg_t | 146
NMEAData | 148
PowerManager | 153
SensorDataRecord | 158
SensorWrapper | 159
SystemStateManager | 162
TelemetryManager | 175
TelemetryRecord | 180

### 8 Hierarchical Index

# Chapter 5

# Class Index

## 5.1 Class List

Here are the classes, structs, unions and interfaces with brief descriptions:

BH1750

BME280

BME280CalibParam

INA3221::conf_reg_t

DS3231

ds3231_data_t

EventEmitter

EventLog

EventManager

Frame

INA3221

ISensor

INA3221::masken_reg_t

NMEAData

PowerManager

SensorDataRecord

SensorWrapper

### 10 Class Index

SystemStateManager

TelemetryManager

TelemetryRecord

# Chapter 6

# File Index

## 6.1 File List

Here is a list of all files with brief descriptions:

build_number.h | 185
includes.h | 186
main.cpp | 311
lib/pin_config.h | 249
lib/system_state_manager.h
Manages the system state of the Kubisat firmware | 291
lib/utils.cpp
Implementation of utility functions for the Kubisat firmware | 301
lib/utils.h
Utility functions and definitions for the Kubisat firmware | 306
lib/clock/DS3231.cpp | 187
lib/clock/DS3231.h | 190
lib/comms/communication.cpp | 212
lib/comms/communication.h | 214
lib/comms/frame.cpp
Implements functions for encoding, decoding, building, and processing Frames | 221
lib/comms/protocol.h | 224
lib/comms/receive.cpp | 227
lib/comms/send.cpp
Implements functions for sending data, including LoRa messages and Frames | 232
lib/comms/utils_converters.cpp
Implements utility functions for converting between different data types | 235
lib/comms/commands/clock_commands.cpp | 195
lib/comms/commands/commands.cpp | 198
lib/comms/commands/commands.h | 199
lib/comms/commands/diagnostic_commands.cpp | 202
lib/comms/commands/event_commands.cpp | 205
lib/comms/commands/gps_commands.cpp | 207
lib/comms/commands/telemetry_commands.cpp | 210
lib/eventman/event_manager.cpp
Implementation of the Event Manager and Event Emitter classes | 237
lib/eventman/event_manager.h
Header file for the Event Manager and Event Emitter classes | 239
lib/location/gps_collector.cpp
Implementation of the GPS data collector module | 243

### 12 File Index

lib/location/gps_collector.h
Header file for the GPS data collector module | 245
lib/location/NMEA/NMEA_data.h
Header file for the NMEAData class, which manages parsed NMEA sentences | 247
lib/powerman/PowerManager.cpp
Implementation of the PowerManager class, which manages power-related functions | 265
lib/powerman/PowerManager.h
Header file for the PowerManager class, which manages power-related functions | 267
lib/powerman/INA3221/INA3221.cpp
Implementation of the INA3221 power monitor driver | 256
lib/powerman/INA3221/INA3221.h
Header file for the INA3221 triple-channel power monitor driver | 259
lib/sensors/ISensor.cpp
Implementation of the ISensor interface and SensorWrapper class | 284
lib/sensors/ISensor.h
Header file for the ISensor interface and SensorWrapper class | 286
lib/sensors/BH1750/BH1750.cpp
Implementation of the BH1750 light sensor class | 269
lib/sensors/BH1750/BH1750.h
Header file for the BH1750 light sensor class | 270
lib/sensors/BH1750/BH1750_WRAPPER.cpp | 272
lib/sensors/BH1750/BH1750_WRAPPER.h | 274
lib/sensors/BME280/BME280.cpp
Implementation of the BME280 environmental sensor class | 275
lib/sensors/BME280/BME280.h
Header file for the BME280 environmental sensor class | 279
lib/sensors/BME280/BME280_WRAPPER.cpp | 282
lib/sensors/BME280/BME280_WRAPPER.h | 283
lib/storage/storage.cpp
Implements file system operations for the Kubisat firmware | 288
lib/storage/storage.h
Header file for file system operations on the Kubisat firmware | 289
lib/telemetry/telemetry_manager.cpp
Implementation of telemetry collection and storage functionality | 293
lib/telemetry/telemetry_manager.h
System telemetry collection and logging | 298

# Chapter 7

# Topic Documentation

## 7.1 Clock Management Commands

Commands for managing system time and clock settings.

Functions

- std::vector< Frame > handle_time (const std::string &param, OperationType operationType)

Handler for getting and setting system time.
- std::vector< Frame > handle_timezone_offset (const std::string &param, OperationType operationType)

Handler for getting and setting timezone offset.
- std::vector< Frame > handle_get_internal_temperature (const std::string &param, OperationType operationType)

Handler for reading the DS3231's internal temperature sensor.

### 7.1.1 Detailed Description

Commands for managing system time and clock settings.

### 7.1.2 Function Documentation

### 7.1.2.1 handle_time()

std::vector< Frame > handle_time (

const std::string & param,

OperationType operationType)

Handler for getting and setting system time.

Parameters

param | For SET: Unix timestamp as string, for GET: empty string
operationType | GET/SET

### 14 Topic Documentation

Returns

Vector of frames containing success/error and current time or confirmation

Note

GET: KBST;0;GET;3;0;;KBST

When getting time, returns format "HH:MM:SS Weekday DD.MM.YYYY"

SET: KBST;0;SET;3;0;TIMESTAMP;KBST

When setting time, expects Unix timestamp as parameter

Command Command ID: 3.0

Definition at line 29 of file clock_commands.cpp.

Here is the call graph for this function:

### 7.1.2.2 handle_timezone_offset()

std::vector< Frame > handle_timezone_offset (

const std::string & param,

OperationType operationType)

Handler for getting and setting timezone offset.

Parameters

param | For SET: Timezone offset in minutes (-720 to +720), for GET: empty string
operationType | GET/SET

Returns

Vector of frames containing success/error and timezone offset in minutes

7.1 Clock Management Commands | 15

Note

GET: KBST;0;GET;3;1;;KBST

SET: KBST;0;SET;3;1;OFFSET;KBST

Command Command ID: 3.1

Definition at line 94 of file clock_commands.cpp.

Here is the call graph for this function:

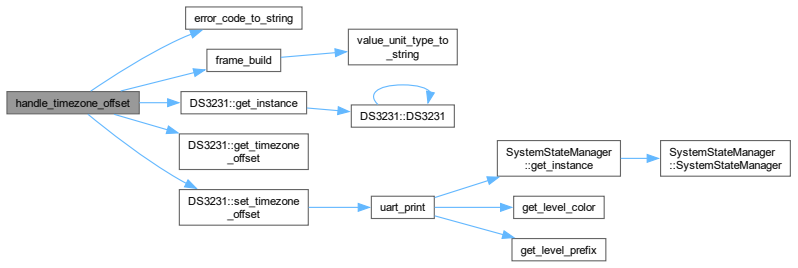
[picture p32: figure]
handle_timezone_offset; error_code_to_string; frame_build; DS3231::get_instance; DS3231::get_timezone _offset; DS3231::set_timezone _offset; value_unit_type_to _string; uart_print; SystemStateManager ::get_instance; get_level_color; get_level_prefix; SystemStateManager ::SystemStateManager

### 7.1.2.3 handle_get_internal_temperature()

std::vector< Frame > handle_get_internal_temperature (

const std::string & param,

OperationType operationType)

Handler for reading the DS3231's internal temperature sensor.

Parameters

param | Empty string expected
operationType | GET

Returns

Vector with frame containing success/error and temperature in Celsius

Note

GET: KBST;0;GET;3;4;;KBST

Returns temperature in format "XX.XX" where XX.XX is temperature in Celsius

Command Command ID: 3.4

### 16 Topic Documentation

Definition at line 153 of file clock_commands.cpp.

Here is the call graph for this function:

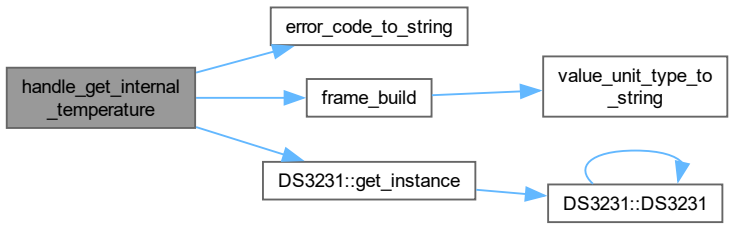
[picture p33: figure]
handle_get_internal _temperature; error_code_to_string; frame_build; DS3231::get_instance; value_unit_type_to _string

## 7.2 Command System

Core command system implementation.

Macros

- #define CMD(group, cmd)

Typedefs

- using CommandHandler = std::function<std::vector<Frame>(const std::string&, OperationType)>

Function type for command handlers.
- using CommandMap = std::map<uint32_t, CommandHandler>

Map type for storing command handlers.

Functions

- std::vector< Frame > execute_command (uint32_t commandKey, const std::string &param, OperationType operationType)

Executes a command based on its key.

Variables

- CommandMap command_handlers

Global map of all command handlers.

### 7.2.1 Detailed Description

Core command system implementation.

7.2 Command System | 17

### 7.2.2 Macro Definition Documentation

### 7.2.2.1 CMD

#define CMD(

group,

cmd)

Value:

((static_cast<uint32_t>(group) « 8) | static_cast<uint32_t>(cmd))

Definition at line 10 of file commands.cpp.

### 7.2.3 Typedef Documentation

### 7.2.3.1 CommandHandler

using CommandHandler = std::function<std::vector<Frame>(const std::string&, OperationType)>

Function type for command handlers.

Definition at line 16 of file commands.cpp.

### 7.2.3.2 CommandMap

using CommandMap = std::map<uint32_t, CommandHandler>

Map type for storing command handlers.

Definition at line 22 of file commands.cpp.

### 7.2.4 Function Documentation

### 7.2.4.1 execute_command()

std::vector< Frame > execute_command (

uint32_t commandKey,

const std::string & param,

OperationType operationType)

Executes a command based on its key.

Parameters

commandKey | Combined group and command ID (group << 8 | command)
param | Command parameter string
operationType | Operation type (GET/SET)

### 18 Topic Documentation

Returns

Frame Response frame containing execution result

Looks up the command handler in commandHandlers map and executes it

Definition at line 59 of file commands.cpp.

Here is the call graph for this function:

execute_command | frame_build | value_unit_type_to _string

Here is the caller graph for this function:

frame_process | execute_command extract_and_process
_frames

handle_uart_input

process_lora_packet

main
on_receive

### 7.2.5 Variable Documentation

### 7.2.5.1 command_handlers

CommandMap command_handlers

Initial value:

= {
{CMD(1, 0), handle_get_commands_list}, {CMD(1, 1), handle_get_build_version}, {CMD(1, 2), handle_get_power_mode}, {CMD(1, 3), handle_get_uptime},
{CMD(1, 8), handle_verbosity},
{CMD(1, 9), handle_enter_bootloader_mode},

{CMD(3, 0), handle_time},
{CMD(3, 1), handle_timezone_offset}, {CMD(3, 4), handle_get_internal_temperature},

{CMD(5, 1), handle_get_last_events}, {CMD(5, 2), handle_get_event_count},

{CMD(7, 1), handle_gps_power_status},
{CMD(7, 2), handle_enable_gps_uart_passthrough},

{CMD(8, 2), handle_get_last_telemetry_record}, {CMD(8, 3), handle_get_last_sensor_record},
}

Global map of all command handlers.

Maps command keys (group << 8 | command) to their handler functions

Definition at line 28 of file commands.cpp.

7.3 Diagnostic Commands | 19

## 7.3 Diagnostic Commands

Functions

- std::vector< Frame > handle_get_commands_list (const std::string &param, OperationType operationType)

Handler for listing all available commands on UART.
- std::vector< Frame > handle_get_build_version (const std::string &param, OperationType operationType)

Get firmware build version.
- std::vector< Frame > handle_get_uptime (const std::string &param, OperationType operationType)

Get system uptime.
- std::vector< Frame > handle_get_power_mode (const std::string &param, OperationType operationType)

Get system power mode.
- std::vector< Frame > handle_verbosity (const std::string &param, OperationType operationType)

Handles setting or getting the UART verbosity level.
- std::vector< Frame > handle_enter_bootloader_mode (const std::string &param, OperationType operation←-Type)

Reboot system to USB firmware loader.

Variables

- static constexpr uint8_t diagnostic_commands_group_id = 1
- static constexpr uint8_t commands_list_command_id = 0
- static constexpr uint8_t build_version_command_id = 1
- static constexpr uint8_t power_mode_command_id = 2
- static constexpr uint8_t uptime_command_id = 3
- static constexpr uint8_t verbosity_command_id = 8
- static constexpr uint8_t enter_bootloader_command_id = 9

### 7.3.1 Detailed Description

### 7.3.2 Function Documentation

### 7.3.2.1 handle_get_commands_list()

std::vector< Frame > handle_get_commands_list (

const std::string & param,

OperationType operationType)

Handler for listing all available commands on UART.

Parameters

param | Empty string expected
operationType | GET

Returns

Vector of response frames - start frame, sequence of elements, end frame

### 20 Topic Documentation

Note

KBST;0;GET;1;0;;TSBK

Print all available commands on UART port

Command Command ID: 0

Definition at line 29 of file diagnostic_commands.cpp.

Here is the call graph for this function:

handle_get_commands_list

error_code_to_string

frame_build | value_unit_type_to _string

### 7.3.2.2 handle_get_build_version()

std::vector< Frame > handle_get_build_version (

const std::string & param,

OperationType operationType)

Get firmware build version.

Parameters

param | Empty string expected
operationType | GET

Returns

One-element vector with result frame

Note

KBST;0;GET;1;1;;TSBK

Get the firmware build version

Command Command ID: 1

Definition at line 83 of file diagnostic_commands.cpp.

Here is the call graph for this function:

handle_get_build_version

error_code_to_string

frame_build | value_unit_type_to
_string | Generated by Doxygen

7.3 Diagnostic Commands | 21

### 7.3.2.3 handle_get_uptime()

std::vector< Frame > handle_get_uptime (

const std::string & param,

OperationType operationType)

Get system uptime.

Parameters

param | Empty string expected
operationType | GET

Returns

One-element vector with result frame

Note

KBST;0;GET;1;3;;TSBK

Get the system uptime in seconds

Command Command ID: 1.3

Definition at line 114 of file diagnostic_commands.cpp.

Here is the call graph for this function:

handle_get_uptime

error_code_to_string

frame_build | value_unit_type_to _string

### 7.3.2.4 handle_get_power_mode()

std::vector< Frame > handle_get_power_mode (

const std::string & param,

OperationType operationType)

Get system power mode.

Parameters

param | Empty string expected
operationType | GET

### 22 Topic Documentation

Returns

One-element vector with result frame

Note

KBST;0;GET;1;2;;TSBK

Get the system power mode (BATTERY or USB)

Command Command ID: 1.2

Definition at line 146 of file diagnostic_commands.cpp.

Here is the call graph for this function:

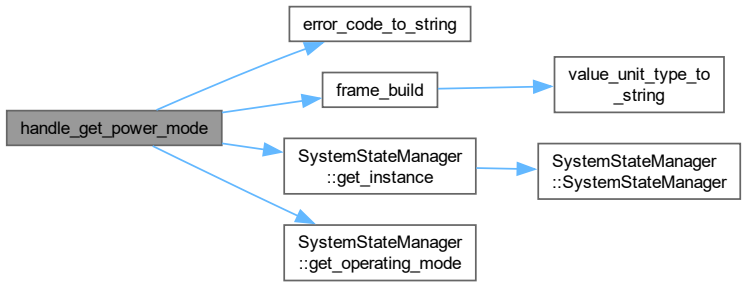
[picture p34: figure]
handle_get_power_mode; error_code_to_string; frame_build; SystemStateManager ::get_instance; SystemStateManager ::get_operating_mode; value_unit_type_to _string; SystemStateManager ::SystemStateManager

### 7.3.2.5 handle_verbosity()

std::vector< Frame > handle_verbosity (

const std::string & param,

OperationType operationType)

Handles setting or getting the UART verbosity level.

This function allows the user to either retrieve the current UART verbosity level or set a new verbosity level.

Parameters

param | The desired verbosity level (0-5) as a string. If empty, the current level is returned.
operationType | The operation type. Must be GET to retrieve the current level, or SET to set a new level.

Returns

Vector containing one frame indicating the result of the operation.

- Success (GET): Frame containing the current verbosity level.
- Success (SET): Frame with "LEVEL SET" message.
- Error: Frame with error message (e.g., "INVALID LEVEL (0-5)", "INVALID FORMAT").

7.3 Diagnostic Commands | 23

Note

KBST;0;GET;1;8;;TSBK - Gets the current verbosity level.

KBST;0;SET;1;8;[level];TSBK - Sets the verbosity level.

Example: KBST;0;SET;1;8;2;TSBK - Sets the verbosity level to 2.

Command Command ID: 1.8

Definition at line 190 of file diagnostic_commands.cpp.

Here is the call graph for this function:

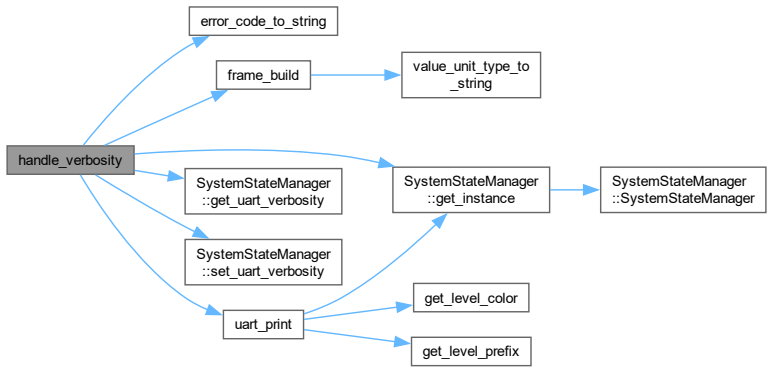
[picture p35: figure]
handle_verbosity; error_code_to_string; frame_build; SystemStateManager ::get_instance; SystemStateManager ::get_uart_verbosity; SystemStateManager ::set_uart_verbosity; uart_print; value_unit_type_to _string; SystemStateManager ::SystemStateManager; get_level_color; get_level_prefix

### 7.3.2.6 handle_enter_bootloader_mode()

std::vector< Frame > handle_enter_bootloader_mode (

const std::string & param,

OperationType operationType)

Reboot system to USB firmware loader.

Parameters

param | Empty string expected
operationType | Must be SET

Returns

Frame with operation result

### 24 Topic Documentation

Note

KBST;0;SET;1;9;;TSBK

Reboot the system to USB firmware loader

Command Command ID: 2

Definition at line 243 of file diagnostic_commands.cpp.

Here is the call graph for this function:

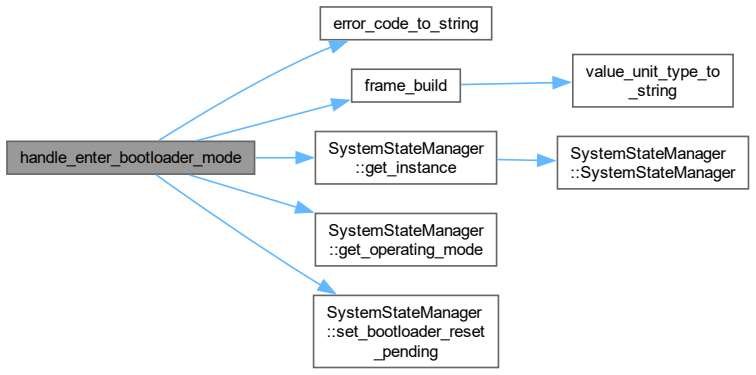
[picture p36: figure]
handle_enter_bootloader_mode; error_code_to_string; frame_build; SystemStateManager ::get_instance; SystemStateManager ::get_operating_mode; SystemStateManager ::set_bootloader_reset _pending; value_unit_type_to _string; SystemStateManager ::SystemStateManager

### 7.3.3 Variable Documentation

### 7.3.3.1 diagnostic_commands_group_id

uint8_t diagnostic_commands_group_id = 1 [static], [constexpr]

Definition at line 11 of file diagnostic_commands.cpp.

### 7.3.3.2 commands_list_command_id

uint8_t commands_list_command_id = 0 [static], [constexpr]

Definition at line 12 of file diagnostic_commands.cpp.

### 7.3.3.3 build_version_command_id

uint8_t build_version_command_id = 1 [static], [constexpr]

Definition at line 13 of file diagnostic_commands.cpp.

7.4 Event Commands | 25

### 7.3.3.4 power_mode_command_id

uint8_t power_mode_command_id = 2 [static], [constexpr]

Definition at line 14 of file diagnostic_commands.cpp.

### 7.3.3.5 uptime_command_id

uint8_t uptime_command_id = 3 [static], [constexpr]

Definition at line 15 of file diagnostic_commands.cpp.

### 7.3.3.6 verbosity_command_id

uint8_t verbosity_command_id = 8 [static], [constexpr]

Definition at line 16 of file diagnostic_commands.cpp.

### 7.3.3.7 enter_bootloader_command_id

uint8_t enter_bootloader_command_id = 9 [static], [constexpr]

Definition at line 17 of file diagnostic_commands.cpp.

## 7.4 Event Commands

Commands for accessing and managing system event logs.

Functions

- std::vector< Frame > handle_get_last_events (const std::string &param, OperationType operationType)

Handler for retrieving last N events from the event log.
- std::vector< Frame > handle_get_event_count (const std::string &param, OperationType operationType)

Handler for getting total number of events in the log.

Variables

- static constexpr uint8_t event_commands_group_id = 5
- static constexpr uint8_t last_events_command_id = 1
- static constexpr uint8_t event_count_command_id = 2

### 7.4.1 Detailed Description

Commands for accessing and managing system event logs.

### 7.4.2 Function Documentation

### 7.4.2.1 handle_get_last_events()

std::vector< Frame > handle_get_last_events (

const std::string & param,

OperationType operationType)

Handler for retrieving last N events from the event log.

### 26 Topic Documentation

Parameters

param | Number of events to retrieve (optional, default 10). If 0, all events are returned.
operationType | GET

Returns

Frame containing:

- Success: A sequence of frames, each containing up to 10 hex-encoded events. Each event is in the format IIIITTTTTTTTGGEE, separated by '-'.

– IIII: Event ID (16-bit, 4 hex characters)
– TTTTTTTT: Unix Timestamp (32-bit, 8 hex characters)
– GG: Event Group (8-bit, 2 hex characters)
– EE: Event Type (8-bit, 2 hex characters) The last frame in the sequence is a VAL frame with the message "SEQ_DONE".
- Error: A single frame with an error message:

– "INVALID OPERATION": If the operation type is not GET.
– "INVALID COUNT": If the count is greater than EVENT_BUFFER_SIZE. – "INVALID PARAMETER": If the parameter is not a valid unsigned integer.

Note

KBST;0;GET;5;1;[N];TSBK - Retrieves the last N events. If N is 0, retrieves all events.

Returns up to 10 most recent events per frame.

Command Command ID: 5.1

Definition at line 38 of file event_commands.cpp.

Here is the call graph for this function:

handle_get_last_events

error_code_to_string

frame_build

EventManager::get_instance

value_unit_type_to
_string

EventManager::EventManager

### 7.4.2.2 handle_get_event_count()

std::vector< Frame > handle_get_event_count (

const std::string & param,

OperationType operationType)

Handler for getting total number of events in the log.

7.4 Event Commands | 27

Parameters

param | Empty string expected
operationType | GET

Returns

Frame containing:

- Success: Number of events currently in the log
- Error: "INVALID REQUEST"

Note

KBST;0;GET;5;2;;TSBK

Returns the total number of events in the log

Command Command ID: 5.2

Definition at line 106 of file event_commands.cpp.

Here is the call graph for this function:

handle_get_event_count

error_code_to_string

frame_build

EventManager::get_instance

value_unit_type_to
_string

EventManager::EventManager

### 7.4.3 Variable Documentation

### 7.4.3.1 event_commands_group_id

uint8_t event_commands_group_id = 5 [static], [constexpr]

Definition at line 12 of file event_commands.cpp.

### 7.4.3.2 last_events_command_id

uint8_t last_events_command_id = 1 [static], [constexpr]

Definition at line 13 of file event_commands.cpp.

### 28 Topic Documentation

### 7.4.3.3 event_count_command_id

uint8_t event_count_command_id = 2 [static], [constexpr]

Definition at line 14 of file event_commands.cpp.

## 7.5 GPS Commands

Commands for controlling and monitoring the GPS module.

Functions

- std::vector< Frame > handle_gps_power_status (const std::string &param, OperationType operationType)

Handler for controlling GPS module power state.
- std::vector< Frame > handle_enable_gps_uart_passthrough (const std::string &param, OperationType operationType)

Handler for enabling GPS transparent mode (UART pass-through)

### 7.5.1 Detailed Description

Commands for controlling and monitoring the GPS module.

### 7.5.2 Function Documentation

### 7.5.2.1 handle_gps_power_status()

std::vector< Frame > handle_gps_power_status (

const std::string & param,

OperationType operationType)

Handler for controlling GPS module power state.

Parameters

param | For SET: "0" to power off, "1" to power on. For GET: empty
operationType | GET to read current state, SET to change state

Returns

Vector of Frames containing:

- Success: Current power state (0/1) or
- Error: Error reason

7.5 GPS Commands | 29

Note

KBST;0;GET;7;1;;TSBK

Return current GPS module power state: ON/OFF

KBST;0;SET;7;1;POWER;TSBK

POWER - 0 - OFF, 1 - ON

Command Command ID: 7.1

Definition at line 31 of file gps_commands.cpp.

Here is the call graph for this function:

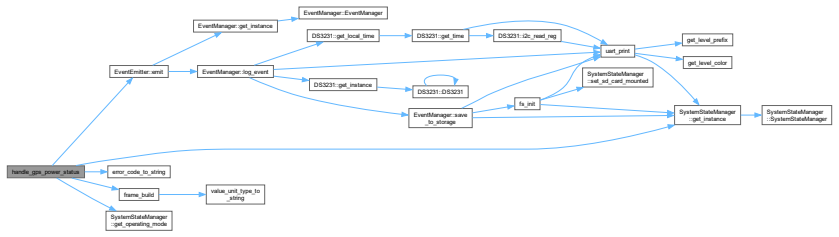
[picture p37: figure]
handle_gps_power_status; EventEmitter::emit; SystemStateManager ::get_instance; error_code_to_string; frame_build; SystemStateManager ::get_operating_mode; EventManager::get_instance; EventManager::log_event; EventManager::EventManager; DS3231::get_instance; DS3231::get_local_time; uart_print; EventManager::save _to_storage; DS3231::get_time; DS3231::i2c_read_reg; get_level_color; get_level_prefix; SystemStateManager ::SystemStateManager; fs_init; SystemStateManager ::set_sd_card_mounted; value_unit_type_to _string

### 7.5.2.2 handle_enable_gps_uart_passthrough()

std::vector< Frame > handle_enable_gps_uart_passthrough (

const std::string & param,

OperationType operationType)

Handler for enabling GPS transparent mode (UART pass-through)

Parameters

param | TIMEOUT in seconds (optional, defaults to 60)
operationType | SET

Returns

Vector of Frames containing:

- Success: Exit message + reason or
- Error: Error reason

### 30 Topic Documentation

Note

KBST;0;SET;7;2;TIMEOUT;TSBK

TIMEOUT - 1-600s, default 60s

Enters a pass-through mode where UART communication is bridged directly to GPS

Send "##EXIT##" to exit mode before TIMEOUT

Command Command ID: 7.2

Definition at line 100 of file gps_commands.cpp.

Here is the call graph for this function:

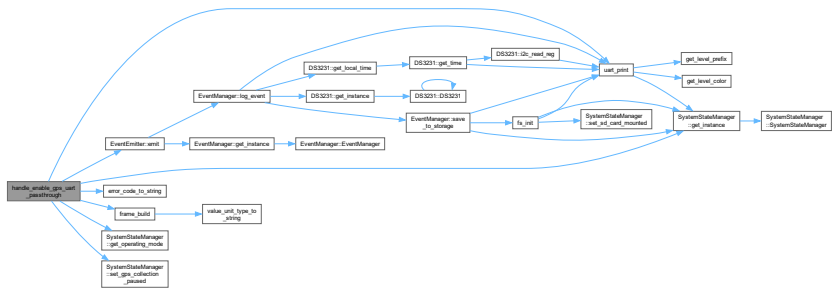
[picture p38: figure]
handle_enable_gps_uart _passthrough; EventEmitter::emit; uart_print; SystemStateManager ::get_instance; error_code_to_string; frame_build; SystemStateManager ::get_operating_mode; SystemStateManager ::set_gps_collection _paused; EventManager::get_instance; EventManager::log_event; EventManager::EventManager; DS3231::get_instance; DS3231::get_local_time; EventManager::save _to_storage; DS3231::get_time; DS3231::i2c_read_reg; get_level_color; get_level_prefix; SystemStateManager ::SystemStateManager fs_init; SystemStateManager ::set_sd_card_mounted; value_unit_type_to _string

## 7.6 Telemetry Buffer Commands

Commands for interacting with the telemetry buffer.

Functions

- std::vector< Frame > handle_get_last_telemetry_record (const std::string &param, OperationType operationType)

Handles the get last record command.
- std::vector< Frame > handle_get_last_sensor_record (const std::string &param, OperationType operation←-Type)

Handles the get last sensor record command.

### 7.6.1 Detailed Description

Commands for interacting with the telemetry buffer.

### 7.6.2 Function Documentation

### 7.6.2.1 handle_get_last_telemetry_record()

std::vector< Frame > handle_get_last_telemetry_record (

const std::string & param,

OperationType operationType)

Handles the get last record command.

This function reads the last record from the telemetry buffer, base64 encodes it, and sends the encoded data as a response.

7.6 Telemetry Buffer Commands | 31

Parameters

param | Unused.
operationType | The operation type (must be GET).

Returns

A vector of Frames indicating the result of the operation.

- Success: Frame with base64 encoded telemetry data.
- Error: Frame with error message (e.g., "No telemetry data available").

Note

KBST;0;GET;8;2;;TSBK

This command retrieves the last telemetry record from the buffer and sends it base64 encoded.

Command Command ID: 8.2

Definition at line 32 of file telemetry_commands.cpp.

Here is the call graph for this function:

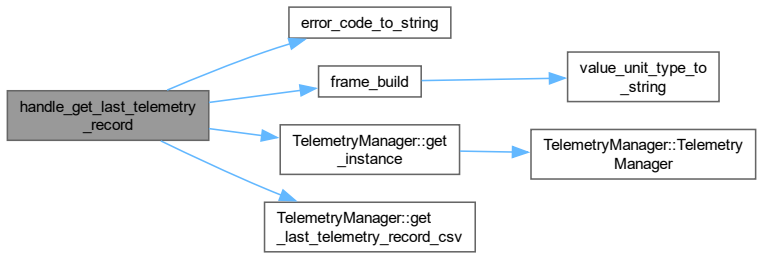
[picture p39: figure]
handle_get_last_telemetry _record; error_code_to_string; frame_build; TelemetryManager::get _instance; TelemetryManager::get _last_telemetry_record_csv; value_unit_type_to _string; TelemetryManager::Telemetry Manager

### 7.6.2.2 handle_get_last_sensor_record()

std::vector< Frame > handle_get_last_sensor_record (

const std::string & param,

OperationType operationType)

Handles the get last sensor record command.

This function retrieves the last sensor record from the telemetry manager, and sends the data as a response.

Parameters

param | Unused.
operationType | The operation type (must be GET).

### 32 Topic Documentation

Returns

A vector of Frames indicating the result of the operation.

Definition at line 71 of file telemetry_commands.cpp.

Here is the call graph for this function:

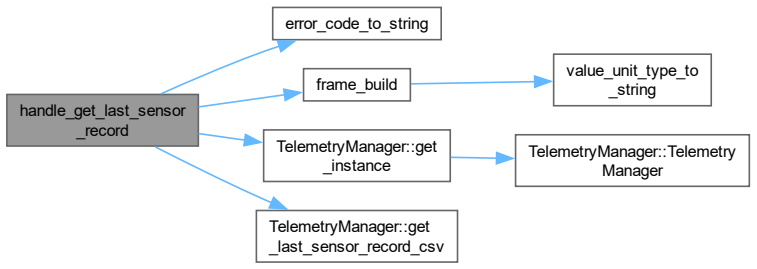
[picture p40: figure]
handle_get_last_sensor _record; error_code_to_string; frame_build; TelemetryManager::get _instance; TelemetryManager::get _last_sensor_record_csv; value_unit_type_to _string; TelemetryManager::Telemetry Manager

## 7.7 Frame Handling

Functions for encoding, decoding and building communication frames.

Functions

- std::string frame_encode (const Frame &frame)

Encodes a Frame instance into a string.
- Frame frame_decode (const std::string &data)

Decodes a string into a Frame instance.
- void frame_process (const std::string &data, Interface interface)

Executes a command based on the command key and the parameter.
- Frame frame_build (OperationType operation, uint8_t group, uint8_t command, const std::string &value, const ValueUnit unitType)

Builds a Frame instance based on the execution result, group, command, value, and unit.

### 7.7.1 Detailed Description

Functions for encoding, decoding and building communication frames.

### 7.7.2 Function Documentation

### 7.7.2.1 frame_encode()

std::string frame_encode (

const Frame & frame)

Encodes a Frame instance into a string.

7.7 Frame Handling | 33

Parameters

frame The Frame instance to encode.

Returns

The Frame encoded as a string.

The encoded string includes the frame direction, operation type, group, command, value, and unit, all delimited by the DELIMITER character. The string is encapsulated by FRAME_BEGIN and FRAME_END.

Frame myFrame;
myFrame.header = FRAME_BEGIN;
myFrame.direction = 0;
myFrame.operationType = OperationType::GET; myFrame.group = 1;
myFrame.command = 1;
myFrame.value = "";
myFrame.unit = "";
myFrame.footer = FRAME_END;

std::string encoded = frame_encode(myFrame); // encoded will be "KBST;0;GET;1;1;;TSBK"

Definition at line 36 of file frame.cpp.

Here is the call graph for this function:

frame_encode | operation_type_to_string

Here is the caller graph for this function:

frame_encode
send_frame_lora
frame_process | send_frame_uart
main

init_modules

extract_and_process
_frames

handle_uart_input

on_receive | process_lora_packet

### 7.7.2.2 frame_decode()

Frame frame_decode (

const std::string & data)

Decodes a string into a Frame instance.

### 34 Topic Documentation

Parameters

encodedFrame The string to decode.

Returns

The Frame instance decoded from the string.

Exceptions

std::runtime_error if the frame is invalid.

The decoded string is expected to be in the format: FRAME_BEGIN;direction;operationType;group;command;value;unit;FRAME←-_END

Definition at line 61 of file frame.cpp.

Here is the call graph for this function:

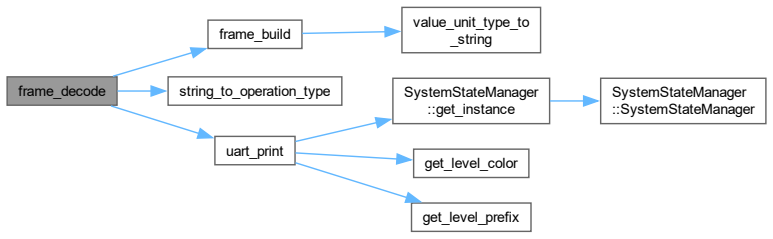
[picture p41: figure]
frame_decode; frame_build; string_to_operation_type; uart_print; value_unit_type_to _string; SystemStateManager ::get_instance; get_level_color; get_level_prefix; SystemStateManager ::SystemStateManager

Here is the caller graph for this function:

frame_process | frame_decode extract_and_process
_frames

handle_uart_input

process_lora_packet

main
on_receive

### 7.7.2.3 frame_process()

void frame_process (

const std::string & data,

Interface interface)

Executes a command based on the command key and the parameter.

7.7 Frame Handling | 35

Parameters

data The Frame data in string format.

Decodes the frame data, extracts the command key, and executes the corresponding command. Sends the response frame. If an error occurs, an error frame is built and sent.

Definition at line 131 of file frame.cpp.

Here is the call graph for this function:

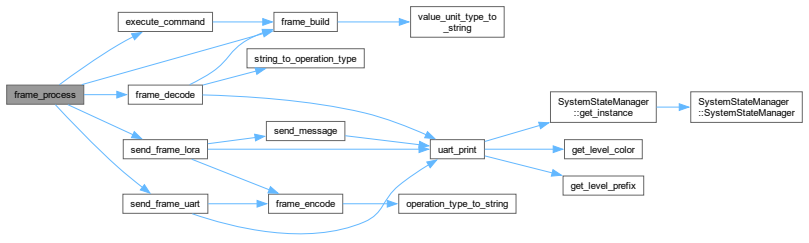
[picture p42: figure]
frame_process; execute_command; frame_build; frame_decode; send_frame_lora; send_frame_uart; value_unit_type_to _string; string_to_operation_type; uart_print; SystemStateManager ::get_instance; get_level_color; get_level_prefix; SystemStateManager ::SystemStateManager; frame_encode; send_message; operation_type_to_string

Here is the caller graph for this function:

frame_process extract_and_process _frames

handle_uart_input

process_lora_packet

main
on_receive

### 7.7.2.4 frame_build()

Frame frame_build (

OperationType operation,

uint8_t group,

uint8_t command,

const std::string & value,

const ValueUnit unitType)

Builds a Frame instance based on the execution result, group, command, value, and unit.

Parameters

result | The execution result.
group | The group ID.
command | The command ID within the group.
value | The payload value.
unit | The unit of measurement for the payload value.

### 36 Topic Documentation

Returns

The Frame instance.

Definition at line 171 of file frame.cpp.

Here is the call graph for this function:

frame_build | value_unit_type_to _string

Here is the caller graph for this function:

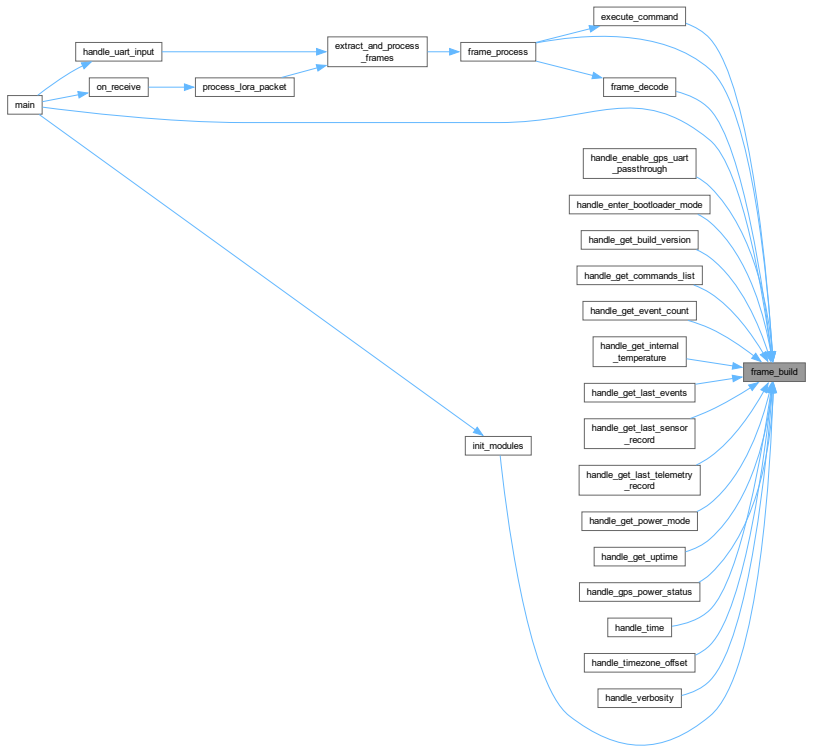
[picture p43: figure]
frame_build; execute_command; frame_process; main; frame_decode; handle_enable_gps_uart _passthrough; handle_enter_bootloader_mode; handle_get_build_version; handle_get_commands_list; handle_get_event_count; handle_get_internal _temperature; handle_get_last_events; handle_get_last_sensor _record; handle_get_last_telemetry _record; handle_get_power_mode; handle_get_uptime; handle_gps_power_status; handle_time; handle_timezone_offset; handle_verbosity; init_modules; extract_and_process _frames handle_uart_input; on_receive; process_lora_packet

## 7.8 Protocol

Definitions for the communication protocol used by the satellite.

7.8 Protocol | 37

Classes

- struct Frame

Represents a communication frame used for data exchange.

Enumerations

- enum class ErrorCode : uint8_t {
ErrorCode::PARAM_UNNECESSARY , ErrorCode::PARAM_REQUIRED , ErrorCode::PARAM_INVALID , ErrorCode::INVALID_OPERATION ,
ErrorCode::NOT_ALLOWED , ErrorCode::INVALID_FORMAT , ErrorCode::INVALID_VALUE , ErrorCode::FAIL_TO_SET ,
ErrorCode::INTERNAL_FAIL_TO_READ , ErrorCode::UNKNOWN_ERROR }

Standard error codes for command responses.
- enum class OperationType : uint8_t {
OperationType::GET , OperationType::SET , OperationType::RES , OperationType::VAL , OperationType::SEQ , OperationType::ERR }

Represents the type of operation being performed.
- enum class ValueUnit : uint8_t {
ValueUnit::UNDEFINED , ValueUnit::SECOND , ValueUnit::VOLT , ValueUnit::BOOL , ValueUnit::DATETIME , ValueUnit::TEXT , ValueUnit::MILIAMP , ValueUnit::CELSIUS }

Represents the unit of measurement for a payload value.
- enum class Interface : uint8_t { Interface::UART , Interface::LORA }

Represents the communication interface being used.

### 7.8.1 Detailed Description

Definitions for the communication protocol used by the satellite.

### 7.8.2 Enumeration Type Documentation

### 7.8.2.1 ErrorCode

enum class ErrorCode : | uint8_t | [strong]

Standard error codes for command responses.

Enumerator

PARAM_UNNECESSARY
PARAM_REQUIRED
PARAM_INVALID
INVALID_OPERATION
NOT_ALLOWED
INVALID_FORMAT
INVALID_VALUE
FAIL_TO_SET
INTERNAL_FAIL_TO_READ
UNKNOWN_ERROR

Definition at line 53 of file protocol.h.

### 38 Topic Documentation

### 7.8.2.2 OperationType

enum class OperationType : | uint8_t | [strong]

Represents the type of operation being performed.

Enumerator

GET | Get data.
SET | Set data.
RES | Set command result.
VAL | Get command value.
SEQ | Sequence element response.
ERR | Error occurred during command execution.

Definition at line 72 of file protocol.h.

### 7.8.2.3 ValueUnit

enum class ValueUnit : | uint8_t | [strong]

Represents the unit of measurement for a payload value.

Enumerator

UNDEFINED | Unit is undefined.
SECOND | Unit is seconds.
VOLT | Unit is volts.
BOOL | Unit is boolean.
DATETIME | Unit is date and time.
TEXT | Unit is text.
MILIAMP | Unit is milliamperes.
CELSIUS | Unit is degrees Celsius.

Definition at line 94 of file protocol.h.

### 7.8.2.4 Interface

enum class Interface : | uint8_t | [strong]

Represents the communication interface being used.

Enumerator

UART | UART interface.
LORA | LoRa interface.

Definition at line 119 of file protocol.h.

7.9 Utility Converters | 39

## 7.9 Utility Converters

Functions

- std::string value_unit_type_to_string (ValueUnit unit)

Converts a ValueUnit to a string.
- std::string operation_type_to_string (OperationType type)

Converts an OperationType to a string.
- OperationType string_to_operation_type (const std::string &str)

Converts a string to an OperationType.
- std::string error_code_to_string (ErrorCode code)

Converts an ErrorCode to its string representation.

### 7.9.1 Detailed Description

### 7.9.2 Function Documentation

### 7.9.2.1 value_unit_type_to_string()

std::string value_unit_type_to_string (

ValueUnit unit)

Converts a ValueUnit to a string.

Parameters

unit The ValueUnit to convert.

Returns

The string representation of the ValueUnit.

Definition at line 17 of file utils_converters.cpp.

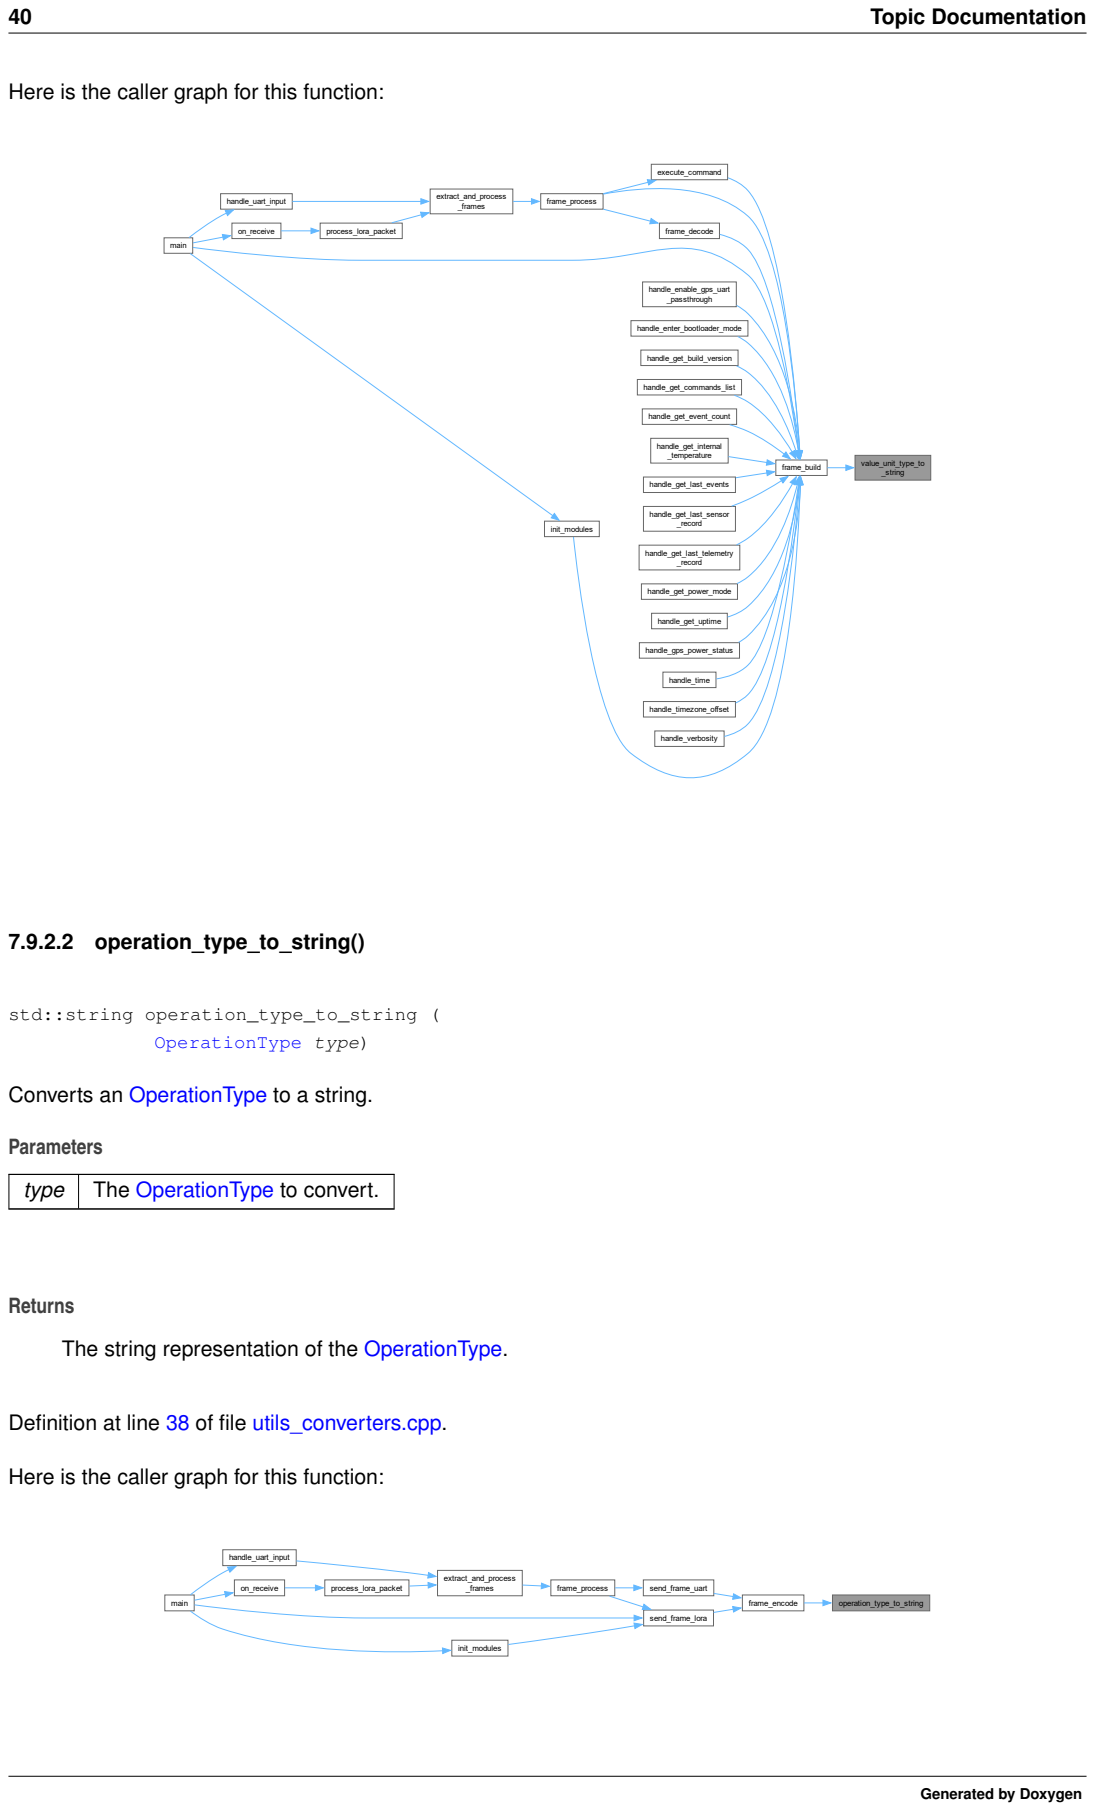
[picture p44: page 62]
40 Topic Documentation; value_unit_type_to _string frame_build; execute_command; frame_process; main; frame_decode; handle_enable_gps_uart _passthrough; handle_enter_bootloader_mode; handle_get_build_version; handle_get_commands_list; handle_get_event_count; handle_get_internal _temperature; handle_get_last_events; handle_get_last_sensor _record; handle_get_last_telemetry _record; handle_get_power_mode; handle_get_uptime; handle_gps_power_status; handle_time; handle_timezone_offset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

Here is the caller graph for this function:

Converts an OperationType to a string.

The string representation of the OperationType.

Definition at line 38 of file utils_converters.cpp.

7.9 Utility Converters | 41

### 7.9.2.3 string_to_operation_type()

OperationType string_to_operation_type (

const std::string & str)

Converts a string to an OperationType.

Parameters

str The string to convert.

Returns

The OperationType corresponding to the string. Defaults to GET if the string is not recognized.

Definition at line 57 of file utils_converters.cpp.

Here is the caller graph for this function:

frame_process | frame_decode | string_to_operation_type extract_and_process
_frames

handle_uart_input

process_lora_packet

main

on_receive

### 7.9.2.4 error_code_to_string()

std::string error_code_to_string (

ErrorCode code)

Converts an ErrorCode to its string representation.

Parameters

code The error code

Returns

String representation of the error code

Definition at line 73 of file utils_converters.cpp.

### 42 Topic Documentation

Here is the caller graph for this function:

## 7.10 RTC clock

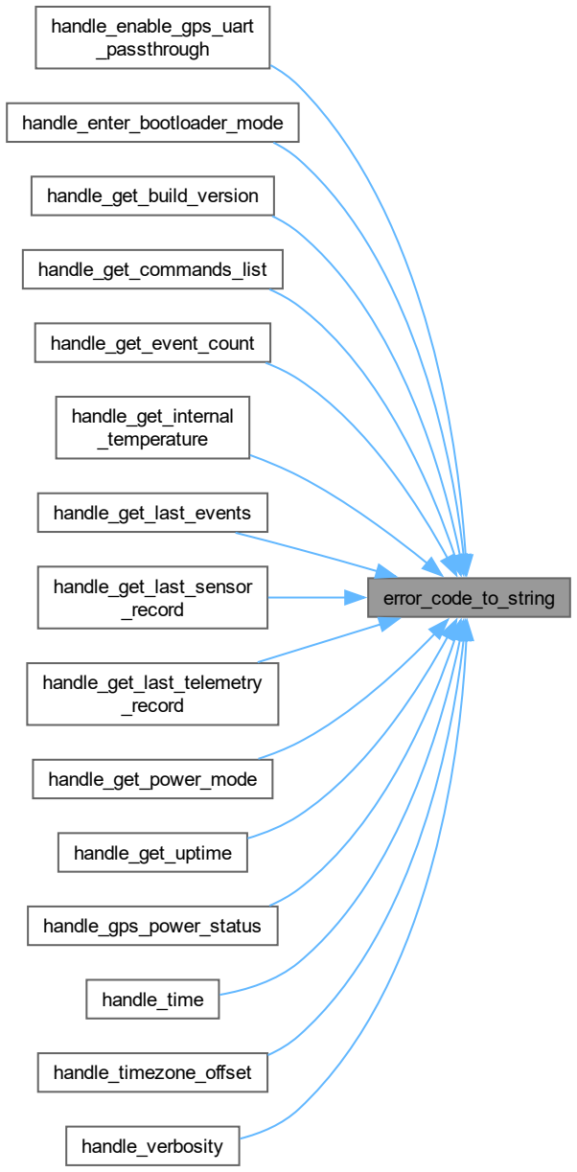
[picture p45: figure]
error_code_to_string; handle_enable_gps_uart _passthrough; handle_enter_bootloader_mode; handle_get_build_version; handle_get_commands_list; handle_get_event_count; handle_get_internal _temperature; handle_get_last_events; handle_get_last_sensor _record; handle_get_last_telemetry _record; handle_get_power_mode; handle_get_uptime; handle_gps_power_status; handle_time; handle_timezone_offset; handle_verbosity

Functions for interfacing with the DS3231 RTC module.

7.10 RTC clock | 43

Functions

- DS3231::DS3231 ()

Constructor for the DS3231 class.
- static DS3231 & DS3231::get_instance ()

Gets the singleton instance of the DS3231 class.
- time_t DS3231::get_time ()

Gets the current RTC time as Unix timestamp.
- int DS3231::set_time (time_t unix_time)

Sets the RTC time using a Unix timestamp.
- int DS3231::read_temperature (float ∗resolution)

Reads the current temperature from the DS3231.
- int16_t DS3231::get_timezone_offset () const

Gets the current timezone offset.
- void DS3231::set_timezone_offset (int16_t offset_minutes)

Sets the timezone offset.
- time_t DS3231::get_local_time ()

Gets the current local time (including timezone offset)
- int DS3231::i2c_read_reg (uint8_t reg_addr, size_t length, uint8_t ∗data)

Reads data from a specific register on the DS3231.
- int DS3231::i2c_write_reg (uint8_t reg_addr, size_t length, uint8_t ∗data)

Writes data to a specific register on the DS3231.

### 7.10.1 Detailed Description

Functions for interfacing with the DS3231 RTC module.

### 7.10.2 Function Documentation

### 7.10.2.1 DS3231()

DS3231::DS3231 () [private]

Constructor for the DS3231 class.

Initializes the I2C interface and sets the device address for the DS3231 RTC module. The constructor is private to enforce the singleton pattern, ensuring that only one instance of the class can be created. The mutex for the class is also initialized.

Note

The DS3231 device address is defined in the header file as DS3231_DEVICE_ADRESS.

Definition at line 23 of file DS3231.cpp.

### 44 Topic Documentation

### 7.10.2.2 get_instance()

DS3231 & DS3231::get_instance () [static]

Gets the singleton instance of the DS3231 class.

Returns

A reference to the singleton instance of the DS3231 class

A reference to the singleton instance of the DS3231 class

This function provides access to the single instance of the DS3231 class, ensuring that only one object manages the RTC module. The instance is created upon the first call to this function and remains available for the lifetime of the program.

Definition at line 38 of file DS3231.cpp.

Here is the call graph for this function:

DS3231::get_instance | DS3231::DS3231

Here is the caller graph for this function:

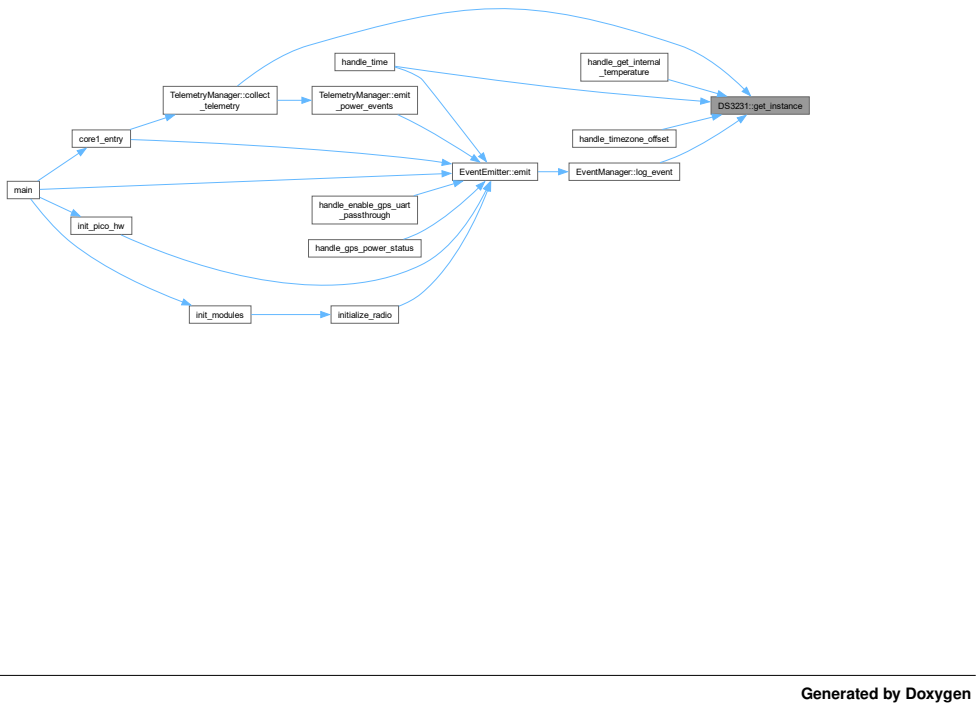
[picture p46: figure]
DS3231::get_instance; TelemetryManager::collect _telemetry; handle_get_internal _temperature; handle_time; handle_timezone_offset; EventManager::log_event; core1_entry; main; EventEmitter::emit; TelemetryManager::emit _power_events; handle_enable_gps_uart _passthrough; handle_gps_power_status; init_pico_hw; init_modules; initialize_radio; Generated by Doxygen

7.10 RTC clock | 45

### 7.10.2.3 get_time()

time_t DS3231::get_time ()

Gets the current RTC time as Unix timestamp.

Gets current RTC time as Unix timestamp.

Returns

Unix timestamp or -1 on error

Definition at line 47 of file DS3231.cpp.

Here is the call graph for this function:

DS3231::get_time

DS3231::i2c_read_reg
uart_print

SystemStateManager
::get_instance

get_level_color

get_level_prefix

SystemStateManager
::SystemStateManager

Here is the caller graph for this function:

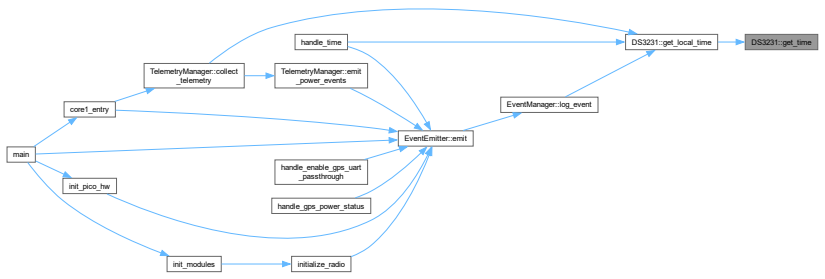
[picture p47: figure]
DS3231::get_local_time; DS3231::get_time; TelemetryManager::collect _telemetry; handle_time; EventManager::log_event core1_entry; main; EventEmitter::emit; TelemetryManager::emit _power_events; handle_enable_gps_uart _passthrough; handle_gps_power_status; init_pico_hw; init_modules; initialize_radio

### 7.10.2.4 set_time()

int DS3231::set_time (

time_t unix_time)

Sets the RTC time using a Unix timestamp.

Sets the RTC time using Unix timestamp.

Parameters

unix_time Time in seconds since Unix epoch

### 46 Topic Documentation

Returns

0 on success, -1 on failure

Definition at line 79 of file DS3231.cpp.

Here is the call graph for this function:

DS3231::set_time

DS3231::i2c_write_reg
uart_print

SystemStateManager
::get_instance

get_level_color

get_level_prefix

SystemStateManager
::SystemStateManager

### 7.10.2.5 read_temperature()

int DS3231::read_temperature (

float ∗ resolution)

Reads the current temperature from the DS3231.

Reads the temperature from the DS3231's internal temperature sensor.

Parameters

out | resolution | Pointer to store the temperature value in Celsius

Returns

0 on success, -1 on failure

Parameters

out | resolution | Pointer to a float to store the temperature value

Returns

0 on success, -1 on failure

The DS3231 includes an internal temperature sensor with 0.25°C resolution. This function reads the sensor value and calculates the temperature in degrees Celsius. The temperature sensor is primarily used for the oscillator's temperature compensation, but can be used for general temperature monitoring as well.

Definition at line 118 of file DS3231.cpp.

Here is the call graph for this function:

DS3231::read_temperature

DS3231::i2c_read_reg

uart_print

SystemStateManager
::get_instance

get_level_color

get_level_prefix

SystemStateManager
::SystemStateManager

7.10 RTC clock | 47

### 7.10.2.6 get_timezone_offset()

int16_t DS3231::get_timezone_offset () const

Gets the current timezone offset.

Gets the currently configured timezone offset.

Returns

Timezone offset in minutes (-720 to +720)

The timezone offset in minutes

Returns the current timezone offset in minutes relative to UTC. Positive values represent timezones ahead of UTC (east), negative values represent timezones behind UTC (west).

Definition at line 146 of file DS3231.cpp.

Here is the caller graph for this function:

### DS3231::get_timezone _offset handle_timezone_offset

### 7.10.2.7 set_timezone_offset()

void DS3231::set_timezone_offset (

int16_t offset_minutes)

Sets the timezone offset.

Parameters

| offset_minutes | Offset in minutes (-720 to +720)
in | offset_minutes | The timezone offset in minutes

Sets the timezone offset in minutes relative to UTC. This value is used when converting between UTC and local time. The function validates that the offset is within a valid range (-720 to +720 minutes, which corresponds to -12 to +12 hours).

### 48 Topic Documentation

Note

This setting is stored in memory and does not persist across reboots.

Definition at line 162 of file DS3231.cpp.

Here is the call graph for this function:

DS3231::set_timezone
_offset | uart_print

SystemStateManager
::get_instance

get_level_color

get_level_prefix

SystemStateManager
::SystemStateManager

Here is the caller graph for this function:

### DS3231::set_timezone _offset handle_timezone_offset

### 7.10.2.8 get_local_time()

time_t DS3231::get_local_time ()

Gets the current local time (including timezone offset)

Gets the current local time by applying the timezone offset to UTC time.

Returns

Unix timestamp adjusted for timezone, or -1 on error

Local time as Unix timestamp, or -1 on error

Retrieves the current UTC time from the RTC and applies the configured timezone offset (in minutes) to calculate the local time.

Definition at line 179 of file DS3231.cpp.

7.10 RTC clock | 49

Here is the call graph for this function:

DS3231::get_local_time | DS3231::get_time

DS3231::i2c_read_reg
uart_print

SystemStateManager
::get_instance

get_level_color

get_level_prefix

SystemStateManager
::SystemStateManager

Here is the caller graph for this function:

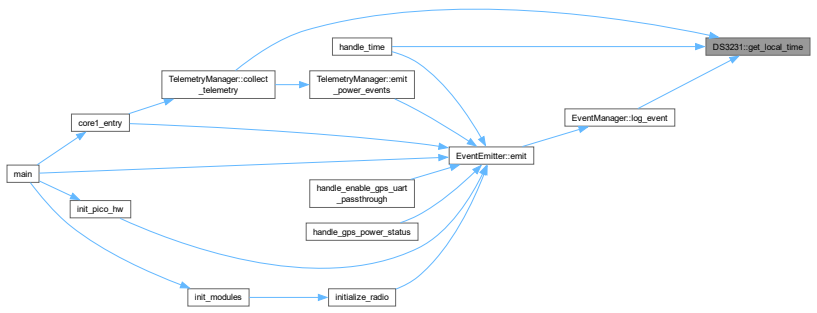
[picture p48: figure]
DS3231::get_local_time; TelemetryManager::collect _telemetry; handle_time; EventManager::log_event core1_entry; main; EventEmitter::emit; TelemetryManager::emit _power_events; handle_enable_gps_uart _passthrough; handle_gps_power_status; init_pico_hw; init_modules; initialize_radio

### 7.10.2.9 i2c_read_reg()

int DS3231::i2c_read_reg (

uint8_t reg_addr,

size_t length,

uint8_t ∗ data) [private]

Reads data from a specific register on the DS3231.

Parameters

in | reg_addr | Register address to read from
in | length | Number of bytes to read
out | data | Buffer to store read data

Returns

0 on success, -1 on failure

Parameters

in | reg_addr | Register address to read from
in | length | Number of bytes to read
out | data | Buffer to store read data

### 50 Topic Documentation

Returns

0 on success, -1 on failure

This method performs a thread-safe I²C read operation from the DS3231. It first writes the register address to the device, then reads the requested number of bytes. All access is protected by a mutex to prevent concurrent I²C operations that could corrupt data.

Note

This is a low-level method used internally by the class.

Definition at line 206 of file DS3231.cpp.

Here is the call graph for this function:

DS3231::i2c_read_reg | uart_print

SystemStateManager
::get_instance

get_level_color

get_level_prefix

SystemStateManager
::SystemStateManager

Here is the caller graph for this function:

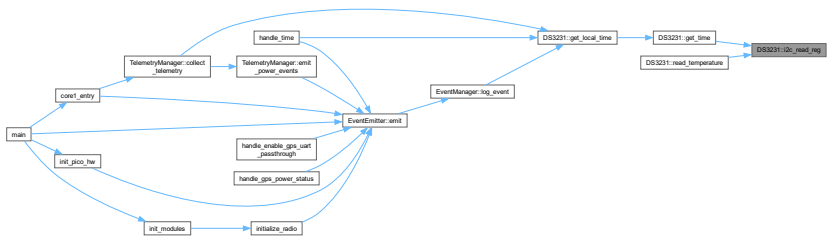
[picture p49: figure]
DS3231::i2c_read_reg; DS3231::get_time; DS3231::read_temperature; DS3231::get_local_time; TelemetryManager::collect _telemetry; handle_time; EventManager::log_event core1_entry; main; EventEmitter::emit; TelemetryManager::emit _power_events; handle_enable_gps_uart _passthrough; handle_gps_power_status; init_pico_hw; init_modules; initialize_radio

### 7.10.2.10 i2c_write_reg()

int DS3231::i2c_write_reg (

uint8_t reg_addr,

size_t length,

uint8_t ∗ data) [private]

Writes data to a specific register on the DS3231.

Parameters

in | reg_addr | Register address to write to
in | length | Number of bytes to write
in | data | Buffer containing data to write

Returns

0 on success, -1 on failure

7.11 Event Management | 51

Parameters

in | reg_addr | Register address to write to
in | length | Number of bytes to write
in | data | Buffer containing data to write

Returns

0 on success, -1 on failure

This method performs a thread-safe I²C write operation to the DS3231. It combines the register address and data into a single buffer and sends it to the device. All access is protected by a mutex to prevent concurrent I²C operations that could corrupt data.

Note

This is a low-level method used internally by the class.

Definition at line 247 of file DS3231.cpp.

Here is the call graph for this function:

DS3231::i2c_write_reg | uart_print

SystemStateManager
::get_instance

get_level_color

get_level_prefix

SystemStateManager
::SystemStateManager

Here is the caller graph for this function:

DS3231::set_time | DS3231::i2c_write_reg

## 7.11 Event Management

Classes and enums for handling system events.

### 52 Topic Documentation

Classes

- class EventLog

Structure for storing event log data.
- class EventManager

Manages event logging and storage.
- class EventEmitter

Provides a simple interface for emitting events.

Macros

- #define EVENT_BUFFER_SIZE 100

Size of the event buffer.
- #define EVENT_FLUSH_THRESHOLD 10

Number of events to accumulate before flushing to storage.
- #define EVENT_LOG_FILE "/event_log.csv"

Path to the event log file.

Enumerations

- enum class EventGroup : uint8_t {
EventGroup::SYSTEM = 0x00 , EventGroup::POWER = 0x01 , EventGroup::COMMS = 0x02 , EventGroup::GPS = 0x03 ,
EventGroup::CLOCK = 0x04 }

Enumeration of event groups.
- enum class SystemEvent : uint8_t {
SystemEvent::BOOT = 0x01 , SystemEvent::SHUTDOWN = 0x02 , SystemEvent::WATCHDOG_RESET = 0x03 , SystemEvent::CORE1_START = 0x04 ,
SystemEvent::CORE1_STOP = 0x05 }

Enumeration of system events.
- enum class PowerEvent : uint8_t {
PowerEvent::BATTERY_LOW = 0x01 , PowerEvent::BATTERY_FULL = 0x02 , PowerEvent::POWER_FALLING
= 0x03 , PowerEvent::BATTERY_NORMAL = 0x04 ,
PowerEvent::SOLAR_ACTIVE = 0x05 , PowerEvent::SOLAR_INACTIVE = 0x06 , PowerEvent::USB_CONNECTED = 0x07 , PowerEvent::USB_DISCONNECTED = 0x08 ,
PowerEvent::DISCHARGING = 0x09 , PowerEvent::CHARGING = 0x0A }

Enumeration of power events.
- enum class CommsEvent : uint8_t {
CommsEvent::RADIO_INIT = 0x01 , CommsEvent::RADIO_ERROR = 0x02 , CommsEvent::MSG_RECEIVED = 0x03 , CommsEvent::MSG_SENT = 0x04 ,
CommsEvent::UART_ERROR = 0x06 }

Enumeration of communications events.
- enum class GPSEvent : uint8_t {
GPSEvent::LOCK = 0x01 , GPSEvent::LOST = 0x02 , GPSEvent::ERROR = 0x03 , GPSEvent::POWER_ON = 0x04 ,
GPSEvent::POWER_OFF = 0x05 , GPSEvent::DATA_READY = 0x06 , GPSEvent::PASS_THROUGH_START = 0x07 , GPSEvent::PASS_THROUGH_END = 0x08 }

Enumeration of GPS events.
- enum class ClockEvent : uint8_t { ClockEvent::CHANGED = 0x01 , ClockEvent::GPS_SYNC = 0x02 , ClockEvent::GPS_SYNC_DATA_NOT_READY = 0x03 }

Enumeration of clock events.

7.11 Event Management | 53

Functions

- class EventLog __attribute__ ((packed))
- bool EventManager::init ()

Initializes the event manager.
- void EventManager::log_event (uint8_t group, uint8_t event)

Logs an event to the event buffer.
- const EventLog & EventManager::get_event (size_t index) const

Gets an event from the event buffer.
- bool EventManager::save_to_storage ()

Saves the event buffer to persistent storage.

Variables

- class EventManager __attribute__

### 7.11.1 Detailed Description

Classes and enums for handling system events.

### 7.11.2 Macro Definition Documentation

### 7.11.2.1 EVENT_BUFFER_SIZE

#define EVENT_BUFFER_SIZE 100

Size of the event buffer.

Definition at line 32 of file event_manager.h.

### 7.11.2.2 EVENT_FLUSH_THRESHOLD

#define EVENT_FLUSH_THRESHOLD 10

Number of events to accumulate before flushing to storage.

Definition at line 37 of file event_manager.h.

### 7.11.2.3 EVENT_LOG_FILE

#define EVENT_LOG_FILE "/event_log.csv"

Path to the event log file.

Definition at line 42 of file event_manager.h.

### 7.11.3 Enumeration Type Documentation

### 7.11.3.1 EventGroup

enum class EventGroup : | uint8_t | [strong]

Enumeration of event groups.

Defines the different categories of events that can be logged.

### 54 Topic Documentation

Enumerator

SYSTEM | System-level events.
POWER | Power management events.
COMMS | Communications events.
GPS | GPS events.
CLOCK | Clock events.

Definition at line 50 of file event_manager.h.

### 7.11.3.2 SystemEvent

enum class SystemEvent : | uint8_t | [strong]

Enumeration of system events.

Defines specific system-level events.

Enumerator

BOOT | System boot event.
SHUTDOWN | System shutdown event.
WATCHDOG_RESET | Watchdog reset event.
CORE1_START | Core 1 start event.
CORE1_STOP | Core 1 stop event.

Definition at line 69 of file event_manager.h.

### 7.11.3.3 PowerEvent

enum class PowerEvent : | uint8_t | [strong]

Enumeration of power events.

Defines specific power management events.

Enumerator

BATTERY_LOW | Low battery event.
BATTERY_FULL | Overcharge event.
POWER_FALLING | Power falling event.
BATTERY_NORMAL | Power normal event.
SOLAR_ACTIVE | Solar charging active event.
SOLAR_INACTIVE | Solar charging inactive event.
USB_CONNECTED | USB connected event.
USB_DISCONNECTED | USB disconnected event.
DISCHARGING | Current balance negative.
CHARGING | Current balance positive.

Definition at line 87 of file event_manager.h.

7.11 Event Management | 55

### 7.11.3.4 CommsEvent

enum class CommsEvent : | uint8_t | [strong]

Enumeration of communications events.

Defines specific communications events.

Enumerator

RADIO_INIT | Radio initialization event.
RADIO_ERROR | Radio error event.
MSG_RECEIVED | Message received event.
MSG_SENT | Message sent event.
UART_ERROR | UART error event.

Definition at line 116 of file event_manager.h.

### 7.11.3.5 GPSEvent

enum class GPSEvent : | uint8_t | [strong]

Enumeration of GPS events.

Defines specific GPS events.

Enumerator

LOCK | GPS lock event.
LOST | GPS lost event.
ERROR | GPS error event.
POWER_ON | GPS power on event.
POWER_OFF | GPS power off event.
DATA_READY | GPS data ready event.
PASS_THROUGH_START | GPS pass-through start event.
PASS_THROUGH_END | GPS pass-through end event.

Definition at line 134 of file event_manager.h.

### 7.11.3.6 ClockEvent

enum class ClockEvent : | uint8_t | [strong]

Enumeration of clock events.

Defines specific clock-related events.

### 56 Topic Documentation

Enumerator

CHANGED | Clock changed event.
GPS_SYNC | GPS sync event.
GPS_SYNC_DATA_NOT_READY | GPS sync data not ready event.

Definition at line 158 of file event_manager.h.

### 7.11.4 Function Documentation

### 7.11.4.1 __attribute__()

class EventLog __attribute__ (

(packed) )

### 7.11.4.2 init()

bool EventManager::init ()

Initializes the event manager.

Returns

True if initialization was successful, false otherwise.

Definition at line 30 of file event_manager.cpp.

Here is the call graph for this function:

EventManager::init

SystemStateManager
::get_instance

uart_print

SystemStateManager
::SystemStateManager

get_level_color

get_level_prefix

### 7.11.4.3 log_event()

void EventManager::log_event (

uint8_t group,

uint8_t event)

Logs an event to the event buffer.

7.11 Event Management | 57

Parameters

in | group | Event group.
in | event | Event code.

Definition at line 63 of file event_manager.cpp.

Here is the call graph for this function:

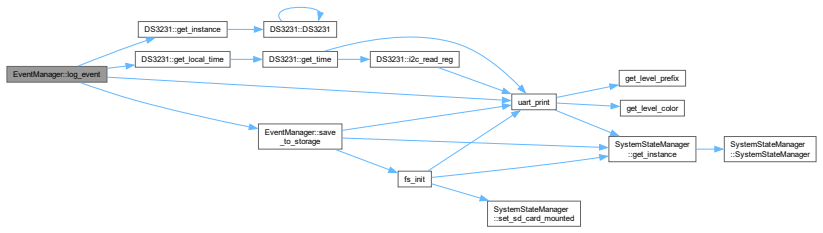
[picture p50: figure]
EventManager::log_event; DS3231::get_instance; DS3231::get_local_time; uart_print; EventManager::save _to_storage; DS3231::get_time; DS3231::i2c_read_reg; SystemStateManager ::get_instance; get_level_color; get_level_prefix; SystemStateManager ::SystemStateManager; fs_init; SystemStateManager ::set_sd_card_mounted

Here is the caller graph for this function:

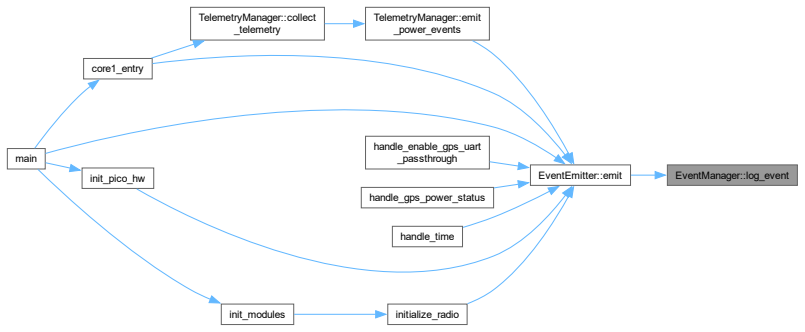
[picture p51: figure]
EventEmitter::emit; EventManager::log_event; core1_entry; main; TelemetryManager::emit _power_events; handle_enable_gps_uart _passthrough; handle_gps_power_status; handle_time; init_pico_hw; initialize_radio; TelemetryManager::collect _telemetry; init_modules

### 7.11.4.4 get_event()

const EventLog & EventManager::get_event (

size_t index) const

Gets an event from the event buffer.

Parameters

in | index | Index of the event to retrieve.

Returns

A const reference to the event log entry.

Definition at line 102 of file event_manager.cpp.

### 58 Topic Documentation

### 7.11.4.5 save_to_storage()

bool EventManager::save_to_storage ()

Saves the event buffer to persistent storage.

Returns

True if the save was successful, false otherwise.

Definition at line 128 of file event_manager.cpp.

Here is the call graph for this function:

EventManager::save
_to_storage | fs_init

SystemStateManager
::get_instance

uart_print

SystemStateManager
::set_sd_card_mounted

SystemStateManager
::SystemStateManager

get_level_color

get_level_prefix

Here is the caller graph for this function:

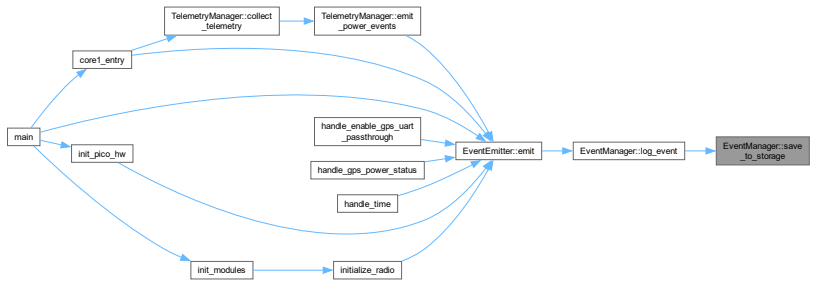
[picture p52: figure]
EventManager::save; _to_storage EventEmitter::emit; EventManager::log_event; core1_entry; main; TelemetryManager::emit _power_events; handle_enable_gps_uart _passthrough; handle_gps_power_status; handle_time; init_pico_hw; initialize_radio; TelemetryManager::collect _telemetry; init_modules

### 7.11.5 Variable Documentation

### 7.11.5.1 __attribute__

class EventManager __attribute__

## 7.12 Location

Classes for handling location data.

7.12 Location | 59

Classes

- class NMEAData

Manages parsed NMEA sentences.

Macros

- #define MAX_RAW_DATA_LENGTH 256

Maximum length of the raw data buffer for NMEA sentences.

Functions

- std::vector< std::string > splitString (const std::string &str, char delimiter)

Splits a string into tokens based on a delimiter.
- void collect_gps_data ()

Collects GPS data from the UART and updates the NMEA data.

### 7.12.1 Detailed Description

Classes for handling location data.

### 7.12.2 Macro Definition Documentation

### 7.12.2.1 MAX_RAW_DATA_LENGTH

#define MAX_RAW_DATA_LENGTH 256

Maximum length of the raw data buffer for NMEA sentences.

Definition at line 30 of file gps_collector.cpp.

### 7.12.3 Function Documentation

### 7.12.3.1 splitString()

std::vector< std::string > splitString (

const std::string & str,

char delimiter)

Splits a string into tokens based on a delimiter.

Parameters

in | str | The string to split.
in | delimiter | The delimiter character.

### 60 Topic Documentation

Returns

A vector of strings representing the tokens.

Definition at line 40 of file gps_collector.cpp.

Here is the caller graph for this function:

main | core1_entry | collect_gps_data | splitString

### 7.12.3.2 collect_gps_data()

void collect_gps_data ()

Collects GPS data from the UART and updates the NMEA data.

This function reads raw NMEA sentences from the GPS UART, parses them, and updates the RMC and GGA tokens in the NMEAData singleton. It also handles buffer overflow and checks for bootloader reset pending status.

Definition at line 59 of file gps_collector.cpp.

Here is the call graph for this function:

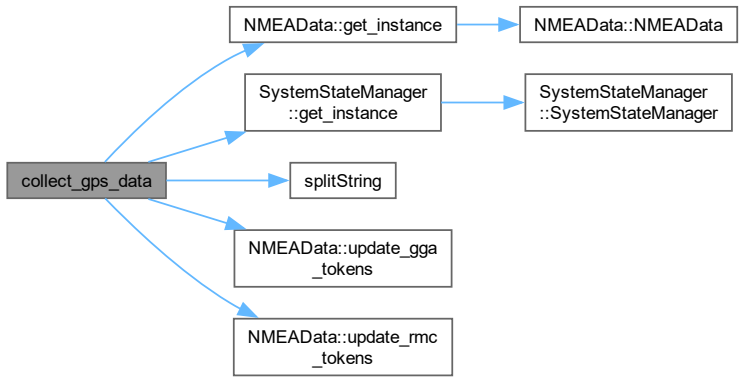
[picture p53: figure]
collect_gps_data; NMEAData::get_instance; SystemStateManager ::get_instance; splitString; NMEAData::update_gga _tokens; NMEAData::update_rmc _tokens; NMEAData::NMEAData; SystemStateManager ::SystemStateManager

Here is the caller graph for this function:

main | core1_entry | collect_gps_data | Generated by Doxygen

7.13 INA3221 Power Monitor | 61

## 7.13 INA3221 Power Monitor

Collaboration diagram for INA3221 Power Monitor:

### INA3221 Power Monitor

### Configuration Functions

### Measurement Functions

Topics

- Configuration Functions
- Measurement Functions

### 7.13.1 Detailed Description

### 7.13.2 Configuration Functions

Collaboration diagram for Configuration Functions:

INA3221 Power Monitor | Configuration Functions

Functions

- INA3221::INA3221 (ina3221_addr_t addr, i2c_inst_t ∗i2c)

Constructor for INA3221 class.
- bool INA3221::begin ()

Initialize the INA3221 device.
- uint16_t INA3221::get_manufacturer_id ()

Get the manufacturer ID of the device.
- uint16_t INA3221::get_die_id ()

Get the die ID of the device.
- uint16_t INA3221::read_register (ina3221_reg_t reg)

Read a register from the device.
- void INA3221::set_mode_continuous ()

Set device to continuous measurement mode.
- void INA3221::set_mode_triggered ()

Set device to triggered measurement mode.
- void INA3221::set_averaging_mode (ina3221_avg_mode_t mode)

Set the averaging mode for measurements.

### 62 Topic Documentation

### 7.13.2.1 Detailed Description

Functions for configuring the INA3221 device

### 7.13.2.2 Function Documentation

### 7.13.2.2.1 INA3221()

INA3221::INA3221 (

ina3221_addr_t addr,

i2c_inst_t ∗ i2c)

Constructor for INA3221 class.

Parameters

addr | I2C address of the device
i2c | Pointer to I2C instance

Definition at line 41 of file INA3221.cpp.

### 7.13.2.2.2 begin()

bool INA3221::begin ()

Initialize the INA3221 device.

Returns

true if initialization successful, false otherwise

Sets up shunt resistors, filter resistors, and verifies device IDs

Definition at line 51 of file INA3221.cpp.

Here is the call graph for this function:

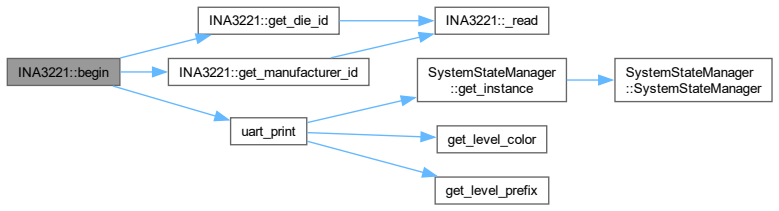
[picture p54: figure]
INA3221::begin; INA3221::get_die_id; INA3221::get_manufacturer_id; uart_print; INA3221::_read; SystemStateManager ::get_instance; get_level_color; get_level_prefix; SystemStateManager ::SystemStateManager

7.13 INA3221 Power Monitor | 63

### 7.13.2.2.3 get_manufacturer_id()

uint16_t INA3221::get_manufacturer_id ()

Get the manufacturer ID of the device.

Returns

16-bit manufacturer ID (should be 0x5449)

Definition at line 83 of file INA3221.cpp.

Here is the call graph for this function:

INA3221::get_manufacturer_id | INA3221::_read

Here is the caller graph for this function:

INA3221::begin | INA3221::get_manufacturer_id

### 7.13.2.2.4 get_die_id()

uint16_t INA3221::get_die_id ()

Get the die ID of the device.

### 64 Topic Documentation

Returns

16-bit die ID (should be 0x3220)

Definition at line 95 of file INA3221.cpp.

Here is the call graph for this function:

INA3221::get_die_id | INA3221::_read

Here is the caller graph for this function:

INA3221::begin | INA3221::get_die_id

### 7.13.2.2.5 read_register()

uint16_t INA3221::read_register (

ina3221_reg_t reg)

Read a register from the device.

Parameters

reg Register address to read

Returns

16-bit value read from the register

Definition at line 108 of file INA3221.cpp.

Here is the call graph for this function:

INA3221::read_register | INA3221::_read | Generated by Doxygen

7.13 INA3221 Power Monitor | 65

### 7.13.2.2.6 set_mode_continuous()

void INA3221::set_mode_continuous ()

Set device to continuous measurement mode.

Enables continuous measurement of bus voltage and shunt voltage

Definition at line 122 of file INA3221.cpp.

Here is the call graph for this function:

### INA3221::set_mode_continuous

### INA3221::_read

### INA3221::_write

### 7.13.2.2.7 set_mode_triggered()

void INA3221::set_mode_triggered ()

Set device to triggered measurement mode.

Disables continuous measurements, requiring manual triggers

Definition at line 136 of file INA3221.cpp.

Here is the call graph for this function:

### INA3221::set_mode_triggered

### INA3221::_read

### INA3221::_write

### 7.13.2.2.8 set_averaging_mode()

void INA3221::set_averaging_mode (

ina3221_avg_mode_t mode)

Set the averaging mode for measurements.

### 66 Topic Documentation

Parameters

mode Number of samples to average

Definition at line 149 of file INA3221.cpp.

Here is the call graph for this function:

### INA3221::set_averaging_mode

### INA3221::_read

### INA3221::_write

### 7.13.3 Measurement Functions

Collaboration diagram for Measurement Functions:

INA3221 Power Monitor | Measurement Functions

Functions

- int32_t INA3221::get_shunt_voltage (ina3221_ch_t channel)

Get shunt voltage for a specific channel.
- float INA3221::get_current_ma (ina3221_ch_t channel)

Get current for a specific channel.
- float INA3221::get_voltage (ina3221_ch_t channel)

Get bus voltage for a specific channel.

### 7.13.3.1 Detailed Description

Functions for reading voltage, current and power measurements

### 7.13.3.2 Function Documentation

### 7.13.3.2.1 get_shunt_voltage()

int32_t INA3221::get_shunt_voltage (

ina3221_ch_t channel)
Get shunt voltage for a specific channel.

7.13 INA3221 Power Monitor | 67

Parameters

channel Channel number (1-3)

Returns

Shunt voltage in microvolts (µV)

Definition at line 164 of file INA3221.cpp.

Here is the call graph for this function:

### INA3221::get_shunt

_voltage | INA3221::_read

Here is the caller graph for this function:

### INA3221::get_shunt _voltage INA3221::get_current_ma

### 7.13.3.2.2 get_current_ma()

float INA3221::get_current_ma (

ina3221_ch_t channel)

Get current for a specific channel.

Parameters

channel Channel number (1-3)

### 68 Topic Documentation

Returns

Current in milliamps (mA)

Definition at line 196 of file INA3221.cpp.

Here is the call graph for this function:

INA3221::get_current_ma | INA3221::get_shunt
_voltage | INA3221::_read

### 7.13.3.2.3 get_voltage()

float INA3221::get_voltage (

ina3221_ch_t channel)

Get bus voltage for a specific channel.

Parameters

channel Channel number (1-3)

Returns

Voltage in volts (V)

Definition at line 212 of file INA3221.cpp.

Here is the call graph for this function:

INA3221::get_voltage | INA3221::_read

## 7.14 Power Management

Classes for handling power-related functions.

7.14 Power Management | 69

Classes

- class PowerManager

Manages power-related functions.

Functions

- PowerManager::PowerManager ()

Private constructor for the singleton pattern.
- static PowerManager & PowerManager::get_instance ()

Gets the singleton instance of the PowerManager class.
- bool PowerManager::initialize ()

Initializes the PowerManager.
- std::string PowerManager::read_device_ids ()

Reads the manufacturer and die IDs from the INA3221.
- float PowerManager::get_voltage_battery ()

Gets the battery voltage.
- float PowerManager::get_voltage_5v ()

Gets the 5V voltage.
- float PowerManager::get_voltage_solar ()

Gets solar voltage.
- float PowerManager::get_current_charge_usb ()

Gets the USB charging current.
- float PowerManager::get_current_draw ()

Gets the current draw.
- float PowerManager::get_current_charge_solar ()

Gets the solar charging current.
- float PowerManager::get_current_charge_total ()

Gets the total charging current.
- void PowerManager::configure (ina3221_op_mode_t op_mode, ina3221_avg_mode_t avg_mode)

Configures the INA3221.

### 7.14.1 Detailed Description

Classes for handling power-related functions.

### 7.14.2 Function Documentation

### 7.14.2.1 PowerManager()

PowerManager::PowerManager () [private]

Private constructor for the singleton pattern.

Initializes the INA3221 and mutex.

Definition at line 25 of file PowerManager.cpp.

### 70 Topic Documentation

### 7.14.2.2 get_instance()

PowerManager & PowerManager::get_instance () [static]

Gets the singleton instance of the PowerManager class.

Returns

A reference to the singleton instance.

Definition at line 35 of file PowerManager.cpp.

Here is the call graph for this function:

PowerManager::get_instance | PowerManager::PowerManager

Here is the caller graph for this function:

PowerManager::get_instance

TelemetryManager::collect
_power_telemetry

main

define_system_operating_mode

TelemetryManager::collect
_telemetry core1_entry

### 7.14.2.3 initialize()

bool PowerManager::initialize ()

Initializes the PowerManager.

Returns

True if initialization was successful, false otherwise.

Definition at line 45 of file PowerManager.cpp.

Here is the caller graph for this function:

main | PowerManager::initialize | Generated by Doxygen

7.14 Power Management | 71

### 7.14.2.4 read_device_ids()

std::string PowerManager::read_device_ids ()

Reads the manufacturer and die IDs from the INA3221.

Returns

A string containing the manufacturer and die IDs.

Definition at line 58 of file PowerManager.cpp.

### 7.14.2.5 get_voltage_battery()

float PowerManager::get_voltage_battery ()

Gets the battery voltage.

Returns

The battery voltage in volts.

Definition at line 77 of file PowerManager.cpp.

Here is the caller graph for this function:

PowerManager::get_voltage
_battery

TelemetryManager::collect
_power_telemetry

define_system_operating_mode

TelemetryManager::collect
_telemetry core1_entry

main

### 7.14.2.6 get_voltage_5v()

float PowerManager::get_voltage_5v ()

Gets the 5V voltage.

Returns

The 5V voltage in volts.

Definition at line 90 of file PowerManager.cpp.

Here is the caller graph for this function:

PowerManager::get_voltage_5v TelemetryManager::collect _power_telemetry

TelemetryManager::collect
_telemetry main | core1_entry

### 72 Topic Documentation

### 7.14.2.7 get_voltage_solar()

float PowerManager::get_voltage_solar ()

Gets solar voltage.

Gets the solar voltage.

Returns

The solar voltage in volts.

Definition at line 103 of file PowerManager.cpp.

### 7.14.2.8 get_current_charge_usb()

float PowerManager::get_current_charge_usb ()

Gets the USB charging current.

Returns

The USB charging current in milliamperes.

Definition at line 116 of file PowerManager.cpp.

Here is the caller graph for this function:

PowerManager::get_current
_charge_usb

TelemetryManager::collect
_power_telemetry

TelemetryManager::collect
_telemetry main | core1_entry

### 7.14.2.9 get_current_draw()

float PowerManager::get_current_draw ()

Gets the current draw.

Returns

The current draw in milliamperes.

Definition at line 129 of file PowerManager.cpp.

Here is the caller graph for this function:

PowerManager::get_current_draw

TelemetryManager::collect
_power_telemetry

define_system_operating_mode

TelemetryManager::collect
_telemetry core1_entry

main

7.14 Power Management | 73

### 7.14.2.10 get_current_charge_solar()

float PowerManager::get_current_charge_solar ()

Gets the solar charging current.

Returns

The solar charging current in milliamperes.

Definition at line 142 of file PowerManager.cpp.

Here is the caller graph for this function:

PowerManager::get_current
_charge_solar

TelemetryManager::collect
_power_telemetry

TelemetryManager::collect
_telemetry main | core1_entry

### 7.14.2.11 get_current_charge_total()

float PowerManager::get_current_charge_total ()

Gets the total charging current.

Returns

The total charging current in milliamperes.

Definition at line 155 of file PowerManager.cpp.

### 7.14.2.12 configure()

void PowerManager::configure (

ina3221_op_mode_t op_mode,

ina3221_avg_mode_t avg_mode)

Configures the INA3221.

Parameters

in | config | A map of configuration parameters.
in | op_mode | Operating mode
in | avg_mode | Averaging mode.

Definition at line 169 of file PowerManager.cpp.

Here is the caller graph for this function:

main | PowerManager::configure Generated by Doxygen

### 74 Topic Documentation

## 7.15 BH1750 Light Sensor

Driver for the BH1750 digital light sensor.

Collaboration diagram for BH1750 Light Sensor:

### BH1750 Light Sensor

### Constants

### Types

Topics

- Constants

Defines constants used by the BH1750 driver.
- Types

Defines types used by the BH1750 driver.

Classes

- class BH1750

Class to interface with the BH1750 light sensor.

Functions

- BH1750::BH1750 (i2c_inst_t ∗i2c, uint8_t addr=0x23)

Constructor for the BH1750 class.
- bool BH1750::begin (Mode mode=Mode::CONTINUOUS_HIGH_RES_MODE)

Initializes the BH1750 sensor.
- bool BH1750::configure (Mode mode)

Configures the BH1750 sensor with the specified mode.
- float BH1750::get_light_level ()

Reads the light level from the BH1750 sensor.
- void BH1750::write8 (uint8_t data)

Writes a single byte of data to the BH1750 sensor.

### 7.15.1 Detailed Description

Driver for the BH1750 digital light sensor.

7.15 BH1750 Light Sensor | 75

### 7.15.2 Function Documentation

### 7.15.2.1 BH1750()

BH1750::BH1750 (

i2c_inst_t ∗ i2c,

uint8_t addr = 0x23)

Constructor for the BH1750 class.

Parameters

i2c | Pointer to the I2C interface.
addr | I2C address of the BH1750 sensor (default: 0x23).

Definition at line 20 of file BH1750.cpp.

### 7.15.2.2 begin()

bool BH1750::begin (

Mode mode = Mode::CONTINUOUS_HIGH_RES_MODE)

Initializes the BH1750 sensor.

Parameters

mode Measurement mode to use (default: CONTINUOUS_HIGH_RES_MODE).

Returns

True if initialization was successful, false otherwise.

Definition at line 28 of file BH1750.cpp.

Here is the call graph for this function:

BH1750::begin

BH1750::configure
BH1750::write8

### 7.15.2.3 configure()

bool BH1750::configure (

Mode mode)

Configures the BH1750 sensor with the specified mode.

### 76 Topic Documentation

Parameters

mode Measurement mode to configure.

Returns

True if configuration was successful, false otherwise.

Definition at line 42 of file BH1750.cpp.

Here is the call graph for this function:

BH1750::configure | BH1750::write8

Here is the caller graph for this function:

BH1750::begin | BH1750::configure

### 7.15.2.4 get_light_level()

float BH1750::get_light_level ()

Reads the light level from the BH1750 sensor.

Returns

Light level in lux.

Definition at line 67 of file BH1750.cpp.

### 7.15.2.5 write8()

void BH1750::write8 (

uint8_t data) [private]

Writes a single byte of data to the BH1750 sensor.

7.15 BH1750 Light Sensor | 77

Parameters

data Byte of data to write.

Definition at line 81 of file BH1750.cpp.

Here is the caller graph for this function:

BH1750::begin | BH1750::write8
BH1750::configure

### 7.15.3 Constants

Defines constants used by the BH1750 driver.

Collaboration diagram for Constants:

BH1750 Light Sensor | Constants

Macros

- #define _BH1750_DEVICE_ID 0xE1

Correct content of WHO_AM_I register (not actually used in this driver).
- #define _BH1750_MTREG_MIN 31

Minimum value for the MTREG register.
- #define _BH1750_MTREG_MAX 254

Maximum value for the MTREG register.
- #define _BH1750_DEFAULT_MTREG 69

Default value for the MTREG register.

### 7.15.3.1 Detailed Description

Defines constants used by the BH1750 driver.

### 78 Topic Documentation

### 7.15.3.2 Macro Definition Documentation

### 7.15.3.2.1 _BH1750_DEVICE_ID

#define _BH1750_DEVICE_ID 0xE1

Correct content of WHO_AM_I register (not actually used in this driver).

Definition at line 36 of file BH1750.h.

### 7.15.3.2.2 _BH1750_MTREG_MIN

#define _BH1750_MTREG_MIN 31

Minimum value for the MTREG register.

Definition at line 42 of file BH1750.h.

### 7.15.3.2.3 _BH1750_MTREG_MAX

#define _BH1750_MTREG_MAX 254

Maximum value for the MTREG register.

Definition at line 48 of file BH1750.h.

### 7.15.3.2.4 _BH1750_DEFAULT_MTREG

#define _BH1750_DEFAULT_MTREG 69

Default value for the MTREG register.

Definition at line 54 of file BH1750.h.

### 7.15.4 Types

Defines types used by the BH1750 driver.

Collaboration diagram for Types:

BH1750 Light Sensor | Types | Generated by Doxygen

7.16 Sensors | 79

Enumerations

- enum class BH1750::Mode : uint8_t {
BH1750::Mode::UNCONFIGURED_POWER_DOWN = 0x00 , BH1750::Mode::POWER_ON = 0x01 , BH1750::Mode::RESET = 0x07 , BH1750::Mode::CONTINUOUS_HIGH_RES_MODE = 0x10 , BH1750::Mode::CONTINUOUS_HIGH_RES_MODE_2 = 0x11 , BH1750::Mode::CONTINUOUS_LOW_RES_MODE = 0x13 , BH1750::Mode::ONE_TIME_HIGH_RES_MODE = 0x20 , BH1750::Mode::ONE_TIME_HIGH_RES_MODE_2 = 0x21 ,
BH1750::Mode::ONE_TIME_LOW_RES_MODE = 0x23 }

Enumeration of measurement modes for the BH1750 sensor.

### 7.15.4.1 Detailed Description

Defines types used by the BH1750 driver.

### 7.15.4.2 Enumeration Type Documentation

### 7.15.4.2.1 Mode

enum class BH1750::Mode : | uint8_t | [strong]

Enumeration of measurement modes for the BH1750 sensor.

Enumerator

UNCONFIGURED_POWER_DOWN | Power down mode.
POWER_ON | Power on mode.
RESET | Reset mode.
CONTINUOUS_HIGH_RES_MODE | Continuous high resolution mode.
CONTINUOUS_HIGH_RES_MODE←-_2 | Continuous high resolution mode 2.
CONTINUOUS_LOW_RES_MODE | Continuous low resolution mode.
ONE_TIME_HIGH_RES_MODE | One-time high resolution mode.
ONE_TIME_HIGH_RES_MODE_2 | One-time high resolution mode 2.
ONE_TIME_LOW_RES_MODE | One-time low resolution mode.

Definition at line 66 of file BH1750.h.

## 7.16 Sensors

Classes for handling sensor-related functions.

Classes

- class ISensor

Abstract base class for sensors.
- class SensorWrapper

Manages a collection of sensors.

### 80 Topic Documentation

Enumerations

- enum class SensorType : uint8_t { SensorType::NONE = 0x00 , SensorType::LIGHT = 0x01 , SensorType::ENVIRONMENT = 0x02 }

Enumeration of sensor types.
- enum class SensorDataTypeIdentifier : uint8_t {
SensorDataTypeIdentifier::NONE = 0x00 , SensorDataTypeIdentifier::LIGHT_LEVEL = 0x01 , SensorDataTypeIdentifier::TEMPERATURE = 0x02 , SensorDataTypeIdentifier::HUMIDITY = 0x03 ,
SensorDataTypeIdentifier::PRESSURE = 0x04 }

Enumeration of sensor data type identifiers.

Functions

- bool SensorWrapper::sensor_init (SensorType type, i2c_inst_t ∗i2c=nullptr)

Initializes a sensor.
- bool SensorWrapper::sensor_configure (SensorType type, const std::map< std::string, std::string > &config)

Configures a sensor.
- float SensorWrapper::sensor_read_data (SensorType sensorType, SensorDataTypeIdentifier dataType)

Reads data from a sensor.
- ISensor ∗ SensorWrapper::get_sensor (SensorType type)

Gets a sensor.

### 7.16.1 Detailed Description

Classes for handling sensor-related functions.

### 7.16.2 Enumeration Type Documentation

### 7.16.2.1 SensorType

enum class SensorType : | uint8_t | [strong]

Enumeration of sensor types.

Defines the different types of sensors that can be managed.

Enumerator

NONE | No sensor.
LIGHT | Light sensor.
ENVIRONMENT | Environment sensor.

Definition at line 31 of file ISensor.h.

### 7.16.2.2 SensorDataTypeIdentifier

enum class SensorDataTypeIdentifier : | uint8_t | [strong]

Enumeration of sensor data type identifiers.

Defines the different types of data that can be read from a sensor.

7.16 Sensors | 81

Enumerator

NONE | No data.
LIGHT_LEVEL | Light level.
TEMPERATURE | Temperature.
HUMIDITY | Humidity.
PRESSURE | Pressure.

Definition at line 45 of file ISensor.h.

### 7.16.3 Function Documentation

### 7.16.3.1 sensor_init()

bool SensorWrapper::sensor_init (

SensorType type,

i2c_inst_t ∗ i2c = nullptr)

Initializes a sensor.

Parameters

in | type | Sensor type to initialize.
in | i2c | I2C instance to use for communication.

Returns

True if initialization was successful, false otherwise.

Definition at line 27 of file ISensor.cpp.

Here is the caller graph for this function:

main | init_modules | SensorWrapper::sensor_init

### 7.16.3.2 sensor_configure()

bool SensorWrapper::sensor_configure (

SensorType type,

const std::map< std::string, std::string > & config)

Configures a sensor.

### 82 Topic Documentation

Parameters

in | type | Sensor type to configure.
in | config | A map of configuration parameters.

Returns

True if configuration was successful, false otherwise.

Definition at line 48 of file ISensor.cpp.

### 7.16.3.3 sensor_read_data()

float SensorWrapper::sensor_read_data (

SensorType sensorType,

SensorDataTypeIdentifier dataType)

Reads data from a sensor.

Parameters

in | sensorType | Sensor type to read from.
in | dataType | Data type to read.

Returns

The sensor data.

Definition at line 62 of file ISensor.cpp.

Here is the caller graph for this function:

SensorWrapper::sensor
_read_data

TelemetryManager::collect
_sensor_telemetry

TelemetryManager::collect
_telemetry main | core1_entry

### 7.16.3.4 get_sensor()

ISensor ∗ SensorWrapper::get_sensor (

SensorType type)

Gets a sensor.

Parameters

in | type | Sensor type to get.

Returns

A pointer to the sensor.

Definition at line 75 of file ISensor.cpp.

7.17 Storage | 83

## 7.17 Storage

Classes and functions for managing file system operations.

Functions

- bool fs_init (void)

Initializes the file system on the SD card.
- bool fs_stop (void)

Unmounts the file system from the SD card.

### 7.17.1 Detailed Description

Classes and functions for managing file system operations.

### 7.17.2 Function Documentation

### 7.17.2.1 fs_init()

bool fs_init (

void )

Initializes the file system on the SD card.

Returns

True if initialization was successful, false otherwise.

Mounts the littlefs file system on the SD card. If mounting fails, it formats the SD card with littlefs and then attempts to mount again.

Returns

True if initialization was successful, false otherwise.

Mounts the FAT file system on the SD card. If mounting fails, it formats the SD card with FAT and then attempts to mount again.

Definition at line 25 of file storage.cpp.

Here is the call graph for this function:

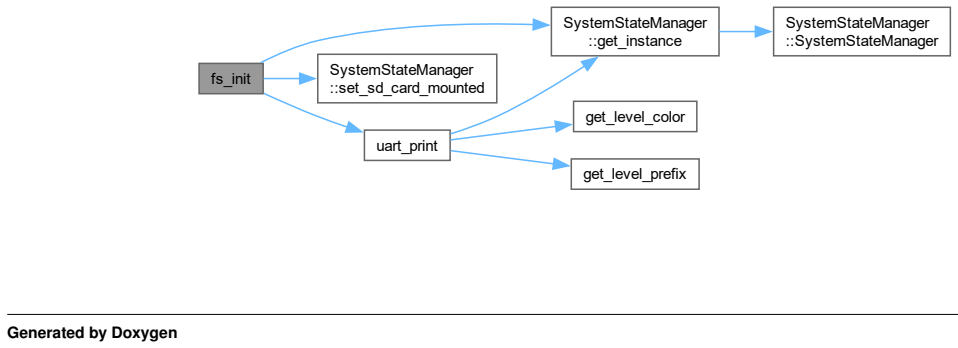
[picture p55: figure]
fs_init; SystemStateManager ::get_instance; SystemStateManager ::set_sd_card_mounted; uart_print; SystemStateManager ::SystemStateManager; get_level_color; get_level_prefix Generated by Doxygen

### 84 Topic Documentation

Here is the caller graph for this function:

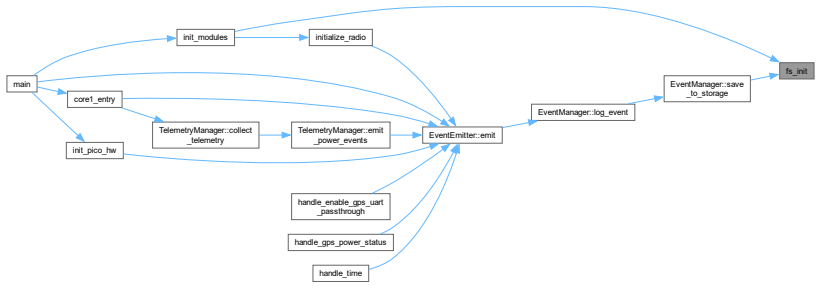
[picture p56: figure]
fs_init; init_modules; EventManager::save _to_storage; main; EventManager::log_event; EventEmitter::emit; core1_entry; TelemetryManager::emit _power_events; handle_enable_gps_uart _passthrough; handle_gps_power_status; handle_time; init_pico_hw; initialize_radio; TelemetryManager::collect _telemetry

### 7.17.2.2 fs_stop()

bool fs_stop (

void )

Unmounts the file system from the SD card.

Returns

True if unmounting was successful, false otherwise.

Definition at line 65 of file storage.cpp.

Here is the call graph for this function:

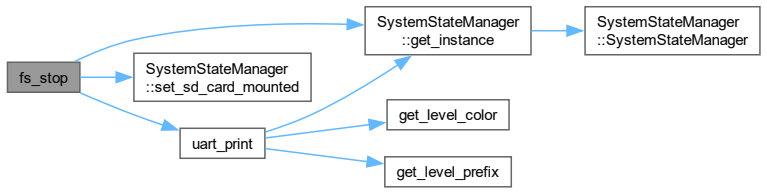
[picture p57: figure]
fs_stop; SystemStateManager ::get_instance; SystemStateManager ::set_sd_card_mounted; uart_print; SystemStateManager ::SystemStateManager; get_level_color; get_level_prefix

## 7.18 System State Manager

Classes for handling system state management.

Classes

- class SystemStateManager

Manages the system state of the Kubisat firmware.

7.19 Telemetry Manager | 85

Enumerations

- enum class SystemOperatingMode : uint8_t { SystemOperatingMode::BATTERY_POWERED = 0 , SystemOperatingMode::USB_POWERED = 1 }

Enumeration of system operating modes.

### 7.18.1 Detailed Description

Classes for handling system state management.

### 7.18.2 Enumeration Type Documentation

### 7.18.2.1 SystemOperatingMode

enum class SystemOperatingMode : | uint8_t | [strong]

Enumeration of system operating modes.

Enumerator

BATTERY_POWERED | Battery powered mode
USB_POWERED | USB powered mode

Definition at line 27 of file system_state_manager.h.

## 7.19 Telemetry Manager

Classes

- struct TelemetryRecord

Structure representing a single telemetry data point.
- struct SensorDataRecord

Structure representing a single sensor data point.
- class TelemetryManager

Manages the collection, storage, and retrieval of telemetry data.

Macros

- #define TELEMETRY_CSV_PATH "/telemetry.csv"

Path to the telemetry CSV file on storage media.
- #define SENSOR_DATA_CSV_PATH "/sensors.csv"

Path to the sensor data CSV file on storage media.
- #define DEFAULT_SAMPLE_INTERVAL_MS 1000

Default interval between telemetry samples in milliseconds (2 seconds)
- #define DEFAULT_FLUSH_THRESHOLD 10

Default number of records to collect before flushing to storage.

### 86 Topic Documentation

Functions

- std::string TelemetryRecord::to_csv () const

Converts the telemetry record to a CSV string.
- std::string SensorDataRecord::to_csv () const

Converts the sensor data record to a CSV string.
- void TelemetryManager::collect_power_telemetry (TelemetryRecord &record)

Collects power subsystem telemetry data.
- void TelemetryManager::emit_power_events (float battery_voltage, float charge_current_usb, float charge←-_current_solar, float discharge_current)

Emits power-related events based on current and voltage levels.
- void TelemetryManager::collect_gps_telemetry (TelemetryRecord &record)

Collects GPS telemetry data.
- void TelemetryManager::collect_sensor_telemetry (SensorDataRecord &sensor_record)

Collects sensor telemetry data.
- TelemetryManager::TelemetryManager ()
- bool TelemetryManager::init ()

Initialize the telemetry system.
- bool TelemetryManager::collect_telemetry ()

Collect telemetry data from sensors and power subsystems.
- bool TelemetryManager::flush_telemetry ()

Save buffered telemetry data to storage.
- bool TelemetryManager::is_telemetry_collection_time (uint32_t current_time, uint32_t &last_collection_time)

Check if it's time to collect telemetry based on interval.
- bool TelemetryManager::is_telemetry_flush_time (uint32_t &collection_counter)

Check if it's time to flush telemetry buffer based on count.
- std::string TelemetryManager::get_last_telemetry_record_csv ()

Gets the last telemetry record as a CSV string.
- std::string TelemetryManager::get_last_sensor_record_csv ()

Gets the last sensor data record as a CSV string.

### 7.19.1 Detailed Description

### 7.19.2 Macro Definition Documentation

### 7.19.2.1 TELEMETRY_CSV_PATH

#define TELEMETRY_CSV_PATH "/telemetry.csv"

Path to the telemetry CSV file on storage media.

Definition at line 27 of file telemetry_manager.cpp.

### 7.19.2.2 SENSOR_DATA_CSV_PATH

#define SENSOR_DATA_CSV_PATH "/sensors.csv"

Path to the sensor data CSV file on storage media.

Definition at line 32 of file telemetry_manager.cpp.

7.19 Telemetry Manager | 87

### 7.19.2.3 DEFAULT_SAMPLE_INTERVAL_MS

#define DEFAULT_SAMPLE_INTERVAL_MS 1000

Default interval between telemetry samples in milliseconds (2 seconds)

Definition at line 37 of file telemetry_manager.cpp.

### 7.19.2.4 DEFAULT_FLUSH_THRESHOLD

#define DEFAULT_FLUSH_THRESHOLD 10

Default number of records to collect before flushing to storage.

Definition at line 42 of file telemetry_manager.cpp.

### 7.19.3 Function Documentation

### 7.19.3.1 to_csv() [1/2]

std::string TelemetryRecord::to_csv () const [inline]

Converts the telemetry record to a CSV string.

Returns

A CSV string representing the telemetry record.

Definition at line 77 of file telemetry_manager.h.

### 7.19.3.2 to_csv() [2/2]

std::string SensorDataRecord::to_csv () const [inline]

Converts the sensor data record to a CSV string.

Returns

A CSV string representing the sensor data record.

Definition at line 123 of file telemetry_manager.h.

### 7.19.3.3 collect_power_telemetry()

void TelemetryManager::collect_power_telemetry (

TelemetryRecord & record)

Collects power subsystem telemetry data.

### 88 Topic Documentation

Parameters

out | record | The telemetry record to update with power data.

Definition at line 108 of file telemetry_manager.cpp.

Here is the call graph for this function:

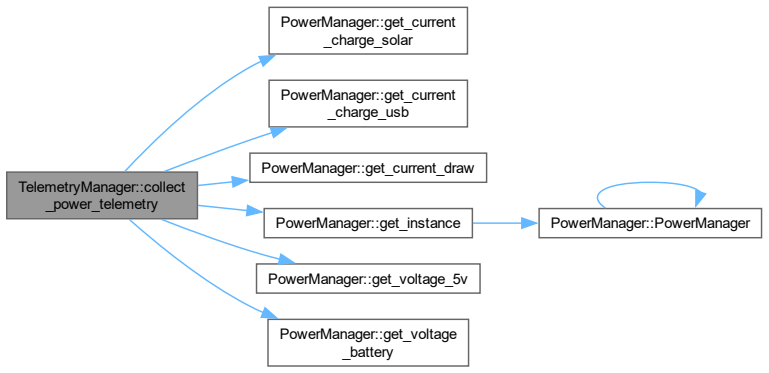
[picture p58: figure]
TelemetryManager::collect _power_telemetry; PowerManager::get_current _charge_solar; PowerManager::get_current _charge_usb; PowerManager::get_current_draw; PowerManager::get_instance; PowerManager::get_voltage_5v; PowerManager::get_voltage _battery; PowerManager::PowerManager

Here is the caller graph for this function:

TelemetryManager::collect
_power_telemetry

TelemetryManager::collect
_telemetry main | core1_entry

### 7.19.3.4 emit_power_events()

void TelemetryManager::emit_power_events (

float battery_voltage,

float charge_current_usb,

float charge_current_solar,

float discharge_current)

Emits power-related events based on current and voltage levels.

Parameters

in | battery_voltage | The current battery voltage.
in | charge_current_usb | The current USB charging current.
in | charge_current_solar | The current solar charging current.
in | discharge_current | The current battery discharge current.

7.19 Telemetry Manager | 89

Definition at line 124 of file telemetry_manager.cpp.

Here is the call graph for this function:

TelemetryManager::emit
_power_events | EventEmitter::emit

EventManager::get_instance

EventManager::log_event

EventManager::EventManager

DS3231::get_instance

DS3231::get_local_time

uart_print

EventManager::save
_to_storage

DS3231::DS3231

DS3231::get_time | DS3231::i2c_read_reg

SystemStateManager
::get_instance

get_level_color

get_level_prefix

SystemStateManager
fs_init | ::SystemStateManager

SystemStateManager
::set_sd_card_mounted

Here is the caller graph for this function:

TelemetryManager::emit
_power_events

TelemetryManager::collect
_telemetry main | core1_entry

### 7.19.3.5 collect_gps_telemetry()

void TelemetryManager::collect_gps_telemetry (

TelemetryRecord & record)

Collects GPS telemetry data.

Parameters

out | record | The telemetry record to update with GPS data.

Definition at line 183 of file telemetry_manager.cpp.

Here is the call graph for this function:

TelemetryManager::collect
_gps_telemetry | NMEAData::get_instance | NMEAData::NMEAData

Here is the caller graph for this function:

TelemetryManager::collect
_gps_telemetry

TelemetryManager::collect
_telemetry main | core1_entry

### 90 Topic Documentation

### 7.19.3.6 collect_sensor_telemetry()

void TelemetryManager::collect_sensor_telemetry (

SensorDataRecord & sensor_record)

Collects sensor telemetry data.

Parameters

out | sensor_record | The sensor data record to update with sensor data.

Definition at line 233 of file telemetry_manager.cpp.

Here is the call graph for this function:

TelemetryManager::collect
_sensor_telemetry

SensorWrapper::get
_instance

SensorWrapper::sensor
_read_data

SensorWrapper::SensorWrapper

Here is the caller graph for this function:

TelemetryManager::collect
_sensor_telemetry

TelemetryManager::collect
_telemetry main | core1_entry

### 7.19.3.7 TelemetryManager()

TelemetryManager::TelemetryManager () [private]

Definition at line 44 of file telemetry_manager.cpp.

Here is the caller graph for this function:

7.19 Telemetry Manager | 91

### 7.19.3.8 init()

bool TelemetryManager::init ()

Initialize the telemetry system.

Initializes the telemetry manager.

Returns

True if initialization was successful

Sets up the mutex for thread-safe buffer access and creates a telemetry CSV file with appropriate headers if it doesn't already exist

Returns

True if initialization was successful, false otherwise.

Initializes the telemetry mutex, checks if the SD card is mounted, and creates the telemetry and sensor data CSV files if they don't exist. Also writes the CSV headers to the files.

Definition at line 54 of file telemetry_manager.cpp.

Here is the call graph for this function:

TelemetryManager::init

SystemStateManager
::get_instance

uart_print

SystemStateManager
::SystemStateManager

get_level_color

get_level_prefix

Here is the caller graph for this function:

main | core1_entry | TelemetryManager::init Generated by Doxygen

### 92 Topic Documentation

### 7.19.3.9 collect_telemetry()

bool TelemetryManager::collect_telemetry ()

Collect telemetry data from sensors and power subsystems.

Returns

True if data was successfully collected

Reads data from power manager, sensors, and GPS and stores it in the telemetry buffer with proper mutex protection

Definition at line 248 of file telemetry_manager.cpp.

Here is the call graph for this function:

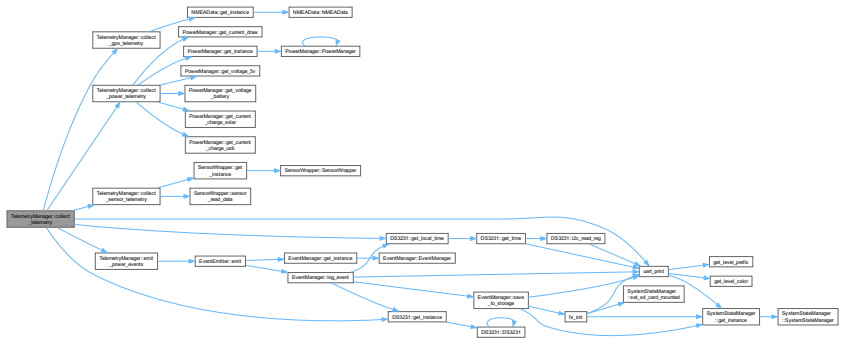
[picture p59: figure]
TelemetryManager::collect _telemetry; TelemetryManager::collect _gps_telemetry; TelemetryManager::collect _power_telemetry; TelemetryManager::collect _sensor_telemetry; TelemetryManager::emit _power_events; DS3231::get_instance; DS3231::get_local_time; uart_print; NMEAData::get_instance; NMEAData::NMEAData; PowerManager::get_current _charge_solar; PowerManager::get_current _charge_usb; PowerManager::get_current_draw; PowerManager::get_instance; PowerManager::get_voltage_5v; PowerManager::get_voltage _battery; PowerManager::PowerManager; SensorWrapper::get _instance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

Here is the caller graph for this function:

TelemetryManager::collect
_telemetry main | core1_entry

### 7.19.3.10 flush_telemetry()

bool TelemetryManager::flush_telemetry ()

Save buffered telemetry data to storage.

Save buffered telemetry and sensor data to storage.

7.19 Telemetry Manager | 93

Returns

True if data was successfully saved

Writes all records from the telemetry buffer to the CSV file and clears the buffer after successful writing

Returns

True if data was successfully saved

Writes all records from the telemetry and sensor data buffers to their respective CSV files and clears the buffers after successful writing

Definition at line 290 of file telemetry_manager.cpp.

Here is the call graph for this function:

TelemetryManager::flush
_telemetry

SystemStateManager
::get_instance

uart_print

SystemStateManager
::SystemStateManager

get_level_color

get_level_prefix

Here is the caller graph for this function:

### TelemetryManager::flush

_telemetry main | core1_entry

### 7.19.3.11 is_telemetry_collection_time()

bool TelemetryManager::is_telemetry_collection_time (

uint32_t current_time,

uint32_t & last_collection_time)

Check if it's time to collect telemetry based on interval.

Parameters

current_time | Current system time in milliseconds
last_collection_time | Previous collection time in milliseconds

Returns

True if collection interval has passed

Updates last_collection_time if the interval has passed

Definition at line 346 of file telemetry_manager.cpp.

### 94 Topic Documentation

### 7.19.3.12 is_telemetry_flush_time()

bool TelemetryManager::is_telemetry_flush_time (

uint32_t & collection_counter)

Check if it's time to flush telemetry buffer based on count.

Parameters

collection_counter Current collection counter

Returns

True if flush threshold has been reached

Resets collection_counter to zero if the threshold has been reached

Definition at line 362 of file telemetry_manager.cpp.

### 7.19.3.13 get_last_telemetry_record_csv()

std::string TelemetryManager::get_last_telemetry_record_csv ()

Gets the last telemetry record as a CSV string.

Returns

A CSV string representing the last telemetry record, or an empty string if no data is available.

Definition at line 375 of file telemetry_manager.cpp.

Here is the caller graph for this function:

TelemetryManager::get
_last_telemetry_record_csv

handle_get_last_telemetry

_record | Generated by Doxygen

7.19 Telemetry Manager | 95

### 7.19.3.14 get_last_sensor_record_csv()

std::string TelemetryManager::get_last_sensor_record_csv ()

Gets the last sensor data record as a CSV string.

Returns

A CSV string representing the last sensor data record, or an empty string if no data is available.

Definition at line 384 of file telemetry_manager.cpp.

Here is the caller graph for this function:

### TelemetryManager::get _last_sensor_record_csv

### handle_get_last_sensor

# _record Generated by Doxygen

### 96 Topic Documentation

# Chapter 8

# Class Documentation

## 8.1 BH1750 Class Reference

Class to interface with the BH1750 light sensor.

#include <BH1750.h>

Public Types

- enum class Mode : uint8_t {
Mode::UNCONFIGURED_POWER_DOWN = 0x00 , Mode::POWER_ON = 0x01 , Mode::RESET = 0x07 , Mode::CONTINUOUS_HIGH_RES_MODE = 0x10 ,
Mode::CONTINUOUS_HIGH_RES_MODE_2 = 0x11 , Mode::CONTINUOUS_LOW_RES_MODE = 0x13 , Mode::ONE_TIME_HIGH_RES_MODE = 0x20 , Mode::ONE_TIME_HIGH_RES_MODE_2 = 0x21 , Mode::ONE_TIME_LOW_RES_MODE = 0x23 }

Enumeration of measurement modes for the BH1750 sensor.

Public Member Functions

- BH1750 (i2c_inst_t ∗i2c, uint8_t addr=0x23)

Constructor for the BH1750 class.
- bool begin (Mode mode=Mode::CONTINUOUS_HIGH_RES_MODE)

Initializes the BH1750 sensor.
- bool configure (Mode mode)

Configures the BH1750 sensor with the specified mode.
- float get_light_level ()

Reads the light level from the BH1750 sensor.

Private Member Functions

- void write8 (uint8_t data)

Writes a single byte of data to the BH1750 sensor.

### 98 Class Documentation

Private Attributes

- uint8_t _i2c_addr

I2C address of the BH1750 sensor.
- i2c_inst_t ∗ i2c_port_

Pointer to the I2C interface.

### 8.1.1 Detailed Description

Class to interface with the BH1750 light sensor.

Definition at line 60 of file BH1750.h.

### 8.1.2 Member Data Documentation

### 8.1.2.1 _i2c_addr

uint8_t BH1750::_i2c_addr [private]

I2C address of the BH1750 sensor.

Definition at line 122 of file BH1750.h.

### 8.1.2.2 i2c_port_

i2c_inst_t∗ BH1750::i2c_port_ [private]

Pointer to the I2C interface.

Definition at line 124 of file BH1750.h.

The documentation for this class was generated from the following files:

- lib/sensors/BH1750/BH1750.h
- lib/sensors/BH1750/BH1750.cpp

8.2 BH1750Wrapper Class Reference | 99

## 8.2 BH1750Wrapper Class Reference

#include <BH1750_WRAPPER.h>

Inheritance diagram for BH1750Wrapper:

### BH1750Wrapper

### ISensor

Collaboration diagram for BH1750Wrapper:

### BH1750Wrapper

ISensor | BH1750
| sensor_

Public Member Functions

- BH1750Wrapper (i2c_inst_t ∗i2c)
- BH1750Wrapper ()
- int get_i2c_addr ()
- bool init () override

Initializes the sensor.
- float read_data (SensorDataTypeIdentifier type) override

Reads data from the sensor.
- bool is_initialized () const override

Checks if the sensor is initialized.
- SensorType get_type () const override

Gets the sensor type.
- bool configure (const std::map< std::string, std::string > &config)

Configures the sensor.
- uint8_t get_address () const override

Gets the I2C address of the sensor.

100 Class Documentation

Public Member Functions inherited from ISensor

- virtual ∼ISensor ()=default

Virtual destructor.

Private Attributes

- BH1750 sensor_
- bool initialized_ = false

### 8.2.1 Detailed Description

Definition at line 9 of file BH1750_WRAPPER.h.

### 8.2.2 Constructor & Destructor Documentation

### 8.2.2.1 BH1750Wrapper() [1/2]

BH1750Wrapper::BH1750Wrapper (

i2c_inst_t ∗ i2c)

Definition at line 5 of file BH1750_WRAPPER.cpp.

### 8.2.2.2 BH1750Wrapper() [2/2]

BH1750Wrapper::BH1750Wrapper ()

### 8.2.3 Member Function Documentation

### 8.2.3.1 get_i2c_addr()

int BH1750Wrapper::get_i2c_addr ()

### 8.2.3.2 init()

bool BH1750Wrapper::init () [override], [virtual]

Initializes the sensor.

Returns

True if initialization was successful, false otherwise.

Implements ISensor.

Definition at line 9 of file BH1750_WRAPPER.cpp.

### 8.2.3.3 read_data()

float BH1750Wrapper::read_data (

SensorDataTypeIdentifier type) [override], [virtual]

Reads data from the sensor.

8.2 BH1750Wrapper Class Reference | 101

Parameters

in | type | Data type to read.

Returns

The sensor data.

Implements ISensor.

Definition at line 14 of file BH1750_WRAPPER.cpp.

### 8.2.3.4 is_initialized()

bool BH1750Wrapper::is_initialized () const [override], [virtual]

Checks if the sensor is initialized.

Returns

True if the sensor is initialized, false otherwise.

Implements ISensor.

Definition at line 21 of file BH1750_WRAPPER.cpp.

### 8.2.3.5 get_type()

SensorType BH1750Wrapper::get_type () const [override], [virtual]

Gets the sensor type.

Returns

The sensor type.

Implements ISensor.

Definition at line 25 of file BH1750_WRAPPER.cpp.

### 8.2.3.6 configure()

bool BH1750Wrapper::configure (

const std::map< std::string, std::string > & config) [virtual]

Configures the sensor.

102 Class Documentation

Parameters

in | config | A map of configuration parameters.

Returns

True if configuration was successful, false otherwise.

Implements ISensor.

Definition at line 29 of file BH1750_WRAPPER.cpp.

### 8.2.3.7 get_address()

uint8_t BH1750Wrapper::get_address () const [inline], [override], [virtual]

Gets the I2C address of the sensor.

Returns

The I2C address of the sensor.

Implements ISensor.

Definition at line 25 of file BH1750_WRAPPER.h.

### 8.2.4 Member Data Documentation

### 8.2.4.1 sensor_

BH1750 BH1750Wrapper::sensor_ [private]

Definition at line 11 of file BH1750_WRAPPER.h.

### 8.2.4.2 initialized_

bool BH1750Wrapper::initialized_ = false [private]

Definition at line 12 of file BH1750_WRAPPER.h.

The documentation for this class was generated from the following files:

- lib/sensors/BH1750/BH1750_WRAPPER.h
- lib/sensors/BH1750/BH1750_WRAPPER.cpp

8.3 BME280 Class Reference | 103

## 8.3 BME280 Class Reference

Class to interface with the BME280 environmental sensor.

#include <BME280.h>

Collaboration diagram for BME280:

### BME280

### BME280CalibParam

### calib_params

Public Types

- enum { ADDR_SDO_LOW = 0x76 , ADDR_SDO_HIGH = 0x77 }

I2C Address Options for the BME280 sensor.
- enum class Oversampling : uint8_t {
OSR_X0 = 0x00 , OSR_X1 = 0x01 , OSR_X2 = 0x02 , OSR_X4 = 0x03 , OSR_X8 = 0x04 , OSR_X16 = 0x05 }

Enum class for oversampling settings.

Public Member Functions

- BME280 (i2c_inst_t ∗i2cPort, uint8_t address=ADDR_SDO_LOW)

Constructor for the BME280 class.
- bool init ()

Initializes the BME280 sensor.
- void reset ()

Resets the BME280 sensor.
- bool read_raw_all (int32_t ∗temperature, int32_t ∗pressure, int32_t ∗humidity)

Reads all raw data from the sensor.
- float convert_temperature (int32_t temp_raw) const

Converts raw temperature data to degrees Celsius.
- float convert_pressure (int32_t pressure_raw) const

Converts raw pressure data to hectopascals (hPa).
- float convert_humidity (int32_t humidity_raw) const

Converts raw humidity data to relative humidity (%).

104 Class Documentation

Private Types

- enum {
REG_CONFIG = 0xF5 , REG_CTRL_MEAS = 0xF4 , REG_CTRL_HUM = 0xF2 , REG_RESET = 0xE0 , REG_PRESSURE_MSB = 0xF7 , REG_TEMPERATURE_MSB = 0xFA , REG_HUMIDITY_MSB = 0xFD , REG_DIG_T1_LSB = 0x88 ,
REG_DIG_T1_MSB = 0x89 , REG_DIG_T2_LSB = 0x8A , REG_DIG_T2_MSB = 0x8B , REG_DIG_T3_LSB = 0x8C ,
REG_DIG_T3_MSB = 0x8D , REG_DIG_P1_LSB = 0x8E , REG_DIG_P1_MSB = 0x8F , REG_DIG_P2_LSB = 0x90 ,
REG_DIG_P2_MSB = 0x91 , REG_DIG_P3_LSB = 0x92 , REG_DIG_P3_MSB = 0x93 , REG_DIG_P4_LSB = 0x94 ,
REG_DIG_P4_MSB = 0x95 , REG_DIG_P5_LSB = 0x96 , REG_DIG_P5_MSB = 0x97 , REG_DIG_P6_LSB = 0x98 ,
REG_DIG_P6_MSB = 0x99 , REG_DIG_P7_LSB = 0x9A , REG_DIG_P7_MSB = 0x9B , REG_DIG_P8_LSB = 0x9C ,
REG_DIG_P8_MSB = 0x9D , REG_DIG_P9_LSB = 0x9E , REG_DIG_P9_MSB = 0x9F , REG_DIG_H1 = 0xA1 ,
REG_DIG_H2 = 0xE1 , REG_DIG_H3 = 0xE3 , REG_DIG_H4 = 0xE4 , REG_DIG_H5 = 0xE5 ,
REG_DIG_H6 = 0xE7 }

Register Definitions for the BME280 sensor.
- enum { HUMIDITY_OVERSAMPLING = static_cast<uint8_t>(Oversampling::OSR_X16) , TEMPERATURE_OVERSAMPLING = static_cast<uint8_t>(Oversampling::OSR_X16) , PRESSURE_OVERSAMPLING = static_cast<uint8_←-t>(Oversampling::OSR_X16) , NORMAL_MODE = 0xB7 }

Sensor settings.
- enum { NUM_CALIB_PARAMS = 26 , NUM_HUM_CALIB_PARAMS = 7 }

Calibration data length.

Private Member Functions

- bool write_register (uint8_t reg, uint8_t value)

Helper function for I2C writes.
- bool read_register (uint8_t reg, uint8_t ∗data)

Helper function for I2C reads.
- bool read_register (uint8_t reg, uint8_t ∗data, size_t len)

Helper function for I2C reads with a specified length.
- bool configure_sensor ()

Configures the sensor with default settings.
- bool get_calibration_parameters ()

Retrieves the calibration parameters from the sensor.

Private Attributes

- i2c_inst_t ∗ i2c_port

Pointer to the I2C interface.
- uint8_t device_addr

I2C device address.
- BME280CalibParam calib_params

Calibration parameters for the sensor.
- bool initialized_

Initialization status of the sensor.
- int32_t t_fine

Fine temperature parameter needed for compensation.

8.3 BME280 Class Reference | 105

### 8.3.1 Detailed Description

Class to interface with the BME280 environmental sensor.

This class provides methods to initialize the sensor, read raw data, convert raw data to physical units (temperature, pressure, humidity), and configure the sensor's operating mode.

Definition at line 71 of file BME280.h.

### 8.3.2 Member Enumeration Documentation

### 8.3.2.1 anonymous enum

anonymous enum

I2C Address Options for the BME280 sensor.

Enumerator

ADDR_SDO_LOW | I2C address when SDO pin is low.
ADDR_SDO_HIGH | I2C address when SDO pin is high.

Definition at line 76 of file BME280.h.

### 8.3.2.2 Oversampling

enum class BME280::Oversampling : | uint8_t | [strong]

Enum class for oversampling settings.

These settings determine the number of measurements that are averaged to reduce noise and improve the accuracy of the sensor readings.

Enumerator

OSR_X0 | No oversampling.
OSR_X1 | 1x oversampling
OSR_X2 | 2x oversampling
OSR_X4 | 4x oversampling
OSR_X8 | 8x oversampling
OSR_X16 | 16x oversampling

Definition at line 89 of file BME280.h.

### 8.3.2.3 anonymous enum

anonymous enum [private]

Register Definitions for the BME280 sensor.

106 Class Documentation

Enumerator

REG_CONFIG | Configuration register.
REG_CTRL_MEAS | Control measurement register.
REG_CTRL_HUM | Control humidity register.
REG_RESET | Reset register.
REG_PRESSURE_MSB | Pressure data MSB.
REG_TEMPERATURE_MSB | Temperature data MSB.
REG_HUMIDITY_MSB | Humidity data MSB.
REG_DIG_T1_LSB | Calibration data LSB.
REG_DIG_T1_MSB | Calibration data MSB.
REG_DIG_T2_LSB | Calibration data LSB.
REG_DIG_T2_MSB | Calibration data MSB.
REG_DIG_T3_LSB | Calibration data LSB.
REG_DIG_T3_MSB | Calibration data MSB.
REG_DIG_P1_LSB | Calibration data LSB.
REG_DIG_P1_MSB | Calibration data MSB.
REG_DIG_P2_LSB | Calibration data LSB.
REG_DIG_P2_MSB | Calibration data MSB.
REG_DIG_P3_LSB | Calibration data LSB.
REG_DIG_P3_MSB | Calibration data MSB.
REG_DIG_P4_LSB | Calibration data LSB.
REG_DIG_P4_MSB | Calibration data MSB.
REG_DIG_P5_LSB | Calibration data LSB.
REG_DIG_P5_MSB | Calibration data MSB.
REG_DIG_P6_LSB | Calibration data LSB.
REG_DIG_P6_MSB | Calibration data MSB.
REG_DIG_P7_LSB | Calibration data LSB.
REG_DIG_P7_MSB | Calibration data MSB.
REG_DIG_P8_LSB | Calibration data LSB.
REG_DIG_P8_MSB | Calibration data MSB.
REG_DIG_P9_LSB | Calibration data LSB.
REG_DIG_P9_MSB | Calibration data MSB.
REG_DIG_H1 | Humidity calibration data.
REG_DIG_H2 | Humidity calibration data.
REG_DIG_H3 | Humidity calibration data.
REG_DIG_H4 | Humidity calibration data.
REG_DIG_H5 | Humidity calibration data.
REG_DIG_H6 | Humidity calibration data.

Definition at line 207 of file BME280.h.

### 8.3.2.4 anonymous enum

anonymous enum [private]

Sensor settings.

8.3 BME280 Class Reference | 107

Enumerator

HUMIDITY_OVERSAMPLING | Humidity oversampling setting.
TEMPERATURE_OVERSAMPLING | Temperature oversampling setting.
PRESSURE_OVERSAMPLING | Pressure oversampling setting.
NORMAL_MODE | Normal mode setting.

Definition at line 256 of file BME280.h.

### 8.3.2.5 anonymous enum

anonymous enum [private]

Calibration data length.

Enumerator

NUM_CALIB_PARAMS | Number of calibration parameters.
NUM_HUM_CALIB_PARAMS | Number of humidity calibration parameters.

Definition at line 266 of file BME280.h.

### 8.3.3 Constructor & Destructor Documentation

### 8.3.3.1 BME280()

BME280::BME280 (

i2c_inst_t ∗ i2cPort,

uint8_t address = ADDR_SDO_LOW)

Constructor for the BME280 class.

Parameters

i2cPort | Pointer to the I2C interface.
address | I2C address of the BME280 sensor (default: ADDR_SDO_LOW).

Definition at line 24 of file BME280.cpp.

108 Class Documentation

### 8.3.4 Member Function Documentation

### 8.3.4.1 init()

bool BME280::init ()

Initializes the BME280 sensor.

Returns

True if initialization was successful, false otherwise.

Definition at line 32 of file BME280.cpp.

Here is the call graph for this function:

### 8.3.4.2 reset()

void BME280::reset ()

Resets the BME280 sensor.

Definition at line 70 of file BME280.cpp.

Here is the call graph for this function:

BME280::reset | BME280::write_register

### 8.3.4.3 read_raw_all()

bool BME280::read_raw_all (

int32_t ∗ temperature,

int32_t ∗ pressure,

int32_t ∗ humidity)

Reads all raw data from the sensor.

8.3 BME280 Class Reference | 109

Parameters

temperature | Pointer to store the raw temperature value.
pressure | Pointer to store the raw pressure value.
humidity | Pointer to store the raw humidity value.

Returns

True if the data was read successfully, false otherwise.

Definition at line 82 of file BME280.cpp.

Here is the call graph for this function:

BME280::read_raw_all

uart_print

BME280::write_register

SystemStateManager
::get_instance

get_level_color

get_level_prefix

SystemStateManager
::SystemStateManager

### 8.3.4.4 convert_temperature()

float BME280::convert_temperature (

int32_t temp_raw) const

Converts raw temperature data to degrees Celsius.

Parameters

temp_raw Raw temperature value.

Returns

Temperature in degrees Celsius.

Definition at line 119 of file BME280.cpp.

### 8.3.4.5 convert_pressure()

float BME280::convert_pressure (

int32_t pressure_raw) const

Converts raw pressure data to hectopascals (hPa).

110 Class Documentation

Parameters

pressure_raw Raw pressure value.

Returns

Pressure in hPa.

Definition at line 133 of file BME280.cpp.

### 8.3.4.6 convert_humidity()

float BME280::convert_humidity (

int32_t humidity_raw) const

Converts raw humidity data to relative humidity (%).

Parameters

humidity_raw Raw humidity value.

Returns

Relative humidity in %.

Definition at line 159 of file BME280.cpp.

### 8.3.4.7 write_register()

bool BME280::write_register (

uint8_t reg,

uint8_t value) [private]

Helper function for I2C writes.

Parameters

reg | Register address to write to.
value | Value to write to the register.

Returns

True if the write was successful, false otherwise.

Definition at line 250 of file BME280.cpp.

Here is the caller graph for this function:

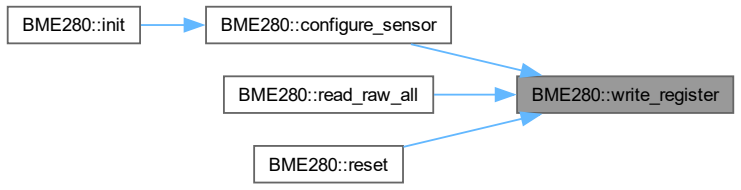
[picture p60: figure]
BME280::write_register; BME280::configure_sensor; BME280::read_raw_all; BME280::reset; BME280::init

8.3 BME280 Class Reference | 111

### 8.3.4.8 read_register() [1/2]

bool BME280::read_register (

uint8_t reg,

uint8_t ∗ data) [private]

Helper function for I2C reads.

Parameters

reg | Register address to read from.
data | Pointer to store the read data.

Returns

True if the read was successful, false otherwise.

Definition at line 278 of file BME280.cpp.

Here is the call graph for this function:

### BME280::read_register

Here is the caller graph for this function:

BME280::read_register

BME280::get_calibration
_parameters
BME280::init

### 8.3.4.9 read_register() [2/2]

bool BME280::read_register (

uint8_t reg,

uint8_t ∗ data,

size_t len) [private]

Helper function for I2C reads with a specified length.

112 Class Documentation

Parameters

reg | Register address to read from.
data | Pointer to store the read data.
len | Number of bytes to read.

Returns

True if the read was successful, false otherwise.

Definition at line 263 of file BME280.cpp.

### 8.3.4.10 configure_sensor()

bool BME280::configure_sensor () [private]

Configures the sensor with default settings.

Returns

True if the configuration was successful, false otherwise.

Definition at line 222 of file BME280.cpp.

Here is the call graph for this function:

BME280::configure_sensor

uart_print

BME280::write_register

SystemStateManager
::get_instance

get_level_color

get_level_prefix

SystemStateManager
::SystemStateManager

Here is the caller graph for this function:

BME280::init | BME280::configure_sensor | Generated by Doxygen

8.3 BME280 Class Reference | 113

### 8.3.4.11 get_calibration_parameters()

bool BME280::get_calibration_parameters () [private]

Retrieves the calibration parameters from the sensor.

Returns

True if the parameters were read successfully, false otherwise.

Definition at line 175 of file BME280.cpp.

Here is the call graph for this function:

BME280::get_calibration
_parameters

BME280::read_register

uart_print

SystemStateManager
::get_instance

get_level_color

get_level_prefix

SystemStateManager
::SystemStateManager

Here is the caller graph for this function:

### BME280::get_calibration _parameters BME280::init

### 8.3.5 Member Data Documentation

### 8.3.5.1 i2c_port

i2c_inst_t∗ BME280::i2c_port [private]

Pointer to the I2C interface.

Definition at line 191 of file BME280.h.

### 8.3.5.2 device_addr

uint8_t BME280::device_addr [private]

I2C device address.

Definition at line 193 of file BME280.h.

114 Class Documentation

### 8.3.5.3 calib_params

BME280CalibParam BME280::calib_params [private]

Calibration parameters for the sensor.

Definition at line 196 of file BME280.h.

### 8.3.5.4 initialized_

bool BME280::initialized_ [private]

Initialization status of the sensor.

Definition at line 199 of file BME280.h.

### 8.3.5.5 t_fine

int32_t BME280::t_fine [mutable], [private]

Fine temperature parameter needed for compensation.

Definition at line 202 of file BME280.h.

The documentation for this class was generated from the following files:

- lib/sensors/BME280/BME280.h
- lib/sensors/BME280/BME280.cpp

## 8.4 BME280CalibParam Struct Reference

Structure to hold the BME280 calibration parameters.

#include <BME280.h>

8.4 BME280CalibParam Struct Reference | 115

Public Attributes

- uint16_t dig_t1

Temperature calibration parameter 1.
- int16_t dig_t2

Temperature calibration parameter 2.
- int16_t dig_t3

Temperature calibration parameter 3.
- uint16_t dig_p1

Pressure calibration parameter 1.
- int16_t dig_p2

Pressure calibration parameter 2.
- int16_t dig_p3

Pressure calibration parameter 3.
- int16_t dig_p4

Pressure calibration parameter 4.
- int16_t dig_p5

Pressure calibration parameter 5.
- int16_t dig_p6

Pressure calibration parameter 6.
- int16_t dig_p7

Pressure calibration parameter 7.
- int16_t dig_p8

Pressure calibration parameter 8.
- int16_t dig_p9

Pressure calibration parameter 9.
- uint8_t dig_h1

Humidity calibration parameter 1.
- int16_t dig_h2

Humidity calibration parameter 2.
- uint8_t dig_h3

Humidity calibration parameter 3.
- int16_t dig_h4

Humidity calibration parameter 4.
- int16_t dig_h5

Humidity calibration parameter 5.
- int8_t dig_h6

Humidity calibration parameter 6.

### 8.4.1 Detailed Description

Structure to hold the BME280 calibration parameters.

These parameters are unique to each sensor and are used to compensate for manufacturing variations and improve the accuracy of the sensor readings.

Definition at line 23 of file BME280.h.

116 Class Documentation

### 8.4.2 Member Data Documentation

### 8.4.2.1 dig_t1

uint16_t BME280CalibParam::dig_t1

Temperature calibration parameter 1.

Definition at line 25 of file BME280.h.

### 8.4.2.2 dig_t2

int16_t BME280CalibParam::dig_t2

Temperature calibration parameter 2.

Definition at line 27 of file BME280.h.

### 8.4.2.3 dig_t3

int16_t BME280CalibParam::dig_t3

Temperature calibration parameter 3.

Definition at line 29 of file BME280.h.

### 8.4.2.4 dig_p1

uint16_t BME280CalibParam::dig_p1

Pressure calibration parameter 1.

Definition at line 32 of file BME280.h.

### 8.4.2.5 dig_p2

int16_t BME280CalibParam::dig_p2

Pressure calibration parameter 2.

Definition at line 34 of file BME280.h.

### 8.4.2.6 dig_p3

int16_t BME280CalibParam::dig_p3

Pressure calibration parameter 3.

Definition at line 36 of file BME280.h.

8.4 BME280CalibParam Struct Reference | 117

### 8.4.2.7 dig_p4

int16_t BME280CalibParam::dig_p4

Pressure calibration parameter 4.

Definition at line 38 of file BME280.h.

### 8.4.2.8 dig_p5

int16_t BME280CalibParam::dig_p5

Pressure calibration parameter 5.

Definition at line 40 of file BME280.h.

### 8.4.2.9 dig_p6

int16_t BME280CalibParam::dig_p6

Pressure calibration parameter 6.

Definition at line 42 of file BME280.h.

### 8.4.2.10 dig_p7

int16_t BME280CalibParam::dig_p7

Pressure calibration parameter 7.

Definition at line 44 of file BME280.h.

### 8.4.2.11 dig_p8

int16_t BME280CalibParam::dig_p8

Pressure calibration parameter 8.

Definition at line 46 of file BME280.h.

### 8.4.2.12 dig_p9

int16_t BME280CalibParam::dig_p9

Pressure calibration parameter 9.

Definition at line 48 of file BME280.h.

118 Class Documentation

### 8.4.2.13 dig_h1

uint8_t BME280CalibParam::dig_h1

Humidity calibration parameter 1.

Definition at line 51 of file BME280.h.

### 8.4.2.14 dig_h2

int16_t BME280CalibParam::dig_h2

Humidity calibration parameter 2.

Definition at line 53 of file BME280.h.

### 8.4.2.15 dig_h3

uint8_t BME280CalibParam::dig_h3

Humidity calibration parameter 3.

Definition at line 55 of file BME280.h.

### 8.4.2.16 dig_h4

int16_t BME280CalibParam::dig_h4

Humidity calibration parameter 4.

Definition at line 57 of file BME280.h.

### 8.4.2.17 dig_h5

int16_t BME280CalibParam::dig_h5

Humidity calibration parameter 5.

Definition at line 59 of file BME280.h.

### 8.4.2.18 dig_h6

int8_t BME280CalibParam::dig_h6

Humidity calibration parameter 6.

Definition at line 61 of file BME280.h.

The documentation for this struct was generated from the following file:

- lib/sensors/BME280/BME280.h

8.5 BME280Wrapper Class Reference | 119

## 8.5 BME280Wrapper Class Reference

#include <BME280_WRAPPER.h>

Inheritance diagram for BME280Wrapper:

### BME280Wrapper

### ISensor

Collaboration diagram for BME280Wrapper:

### BME280Wrapper

ISensor | BME280
| sensor_

### BME280CalibParam

### calib_params

Public Member Functions

- BME280Wrapper (i2c_inst_t ∗i2c)
- bool init () override

Initializes the sensor.
- float read_data (SensorDataTypeIdentifier type) override

Reads data from the sensor.
- bool is_initialized () const override

Checks if the sensor is initialized.
- SensorType get_type () const override

120 Class Documentation

Gets the sensor type.
- bool configure (const std::map< std::string, std::string > &config) override

Configures the sensor.
- uint8_t get_address () const override

Gets the I2C address of the sensor.

Public Member Functions inherited from ISensor

- virtual ∼ISensor ()=default

Virtual destructor.

Private Attributes

- BME280 sensor_
- bool initialized_ = false

### 8.5.1 Detailed Description

Definition at line 8 of file BME280_WRAPPER.h.

### 8.5.2 Constructor & Destructor Documentation

### 8.5.2.1 BME280Wrapper()

BME280Wrapper::BME280Wrapper (

i2c_inst_t ∗ i2c)

Definition at line 3 of file BME280_WRAPPER.cpp.

### 8.5.3 Member Function Documentation

### 8.5.3.1 init()

bool BME280Wrapper::init () [override], [virtual]

Initializes the sensor.

Returns

True if initialization was successful, false otherwise.

Implements ISensor.

Definition at line 5 of file BME280_WRAPPER.cpp.

### 8.5.3.2 read_data()

float BME280Wrapper::read_data (

SensorDataTypeIdentifier type) [override], [virtual]

Reads data from the sensor.

8.5 BME280Wrapper Class Reference | 121

Parameters

in | type | Data type to read.

Returns

The sensor data.

Implements ISensor.

Definition at line 10 of file BME280_WRAPPER.cpp.

### 8.5.3.3 is_initialized()

bool BME280Wrapper::is_initialized () const [override], [virtual]

Checks if the sensor is initialized.

Returns

True if the sensor is initialized, false otherwise.

Implements ISensor.

Definition at line 26 of file BME280_WRAPPER.cpp.

### 8.5.3.4 get_type()

SensorType BME280Wrapper::get_type () const [override], [virtual]

Gets the sensor type.

Returns

The sensor type.

Implements ISensor.

Definition at line 30 of file BME280_WRAPPER.cpp.

### 8.5.3.5 configure()

bool BME280Wrapper::configure (

const std::map< std::string, std::string > & config) [override], [virtual]

Configures the sensor.

122 Class Documentation

Parameters

in | config | A map of configuration parameters.

Returns

True if configuration was successful, false otherwise.

Implements ISensor.

Definition at line 34 of file BME280_WRAPPER.cpp.

### 8.5.3.6 get_address()

uint8_t BME280Wrapper::get_address () const [inline], [override], [virtual]

Gets the I2C address of the sensor.

Returns

The I2C address of the sensor.

Implements ISensor.

Definition at line 22 of file BME280_WRAPPER.h.

### 8.5.4 Member Data Documentation

### 8.5.4.1 sensor_

BME280 BME280Wrapper::sensor_ [private]

Definition at line 10 of file BME280_WRAPPER.h.

### 8.5.4.2 initialized_

bool BME280Wrapper::initialized_ = false [private]

Definition at line 11 of file BME280_WRAPPER.h.

The documentation for this class was generated from the following files:

- lib/sensors/BME280/BME280_WRAPPER.h
- lib/sensors/BME280/BME280_WRAPPER.cpp

## 8.6 INA3221::conf_reg_t Struct Reference

Configuration register bit fields.

8.6 INA3221::conf_reg_t Struct Reference | 123

Public Attributes

- uint16_t mode_shunt_en:1
- uint16_t mode_bus_en:1
- uint16_t mode_continious_en:1
- uint16_t shunt_conv_time:3
- uint16_t bus_conv_time:3
- uint16_t avg_mode:3
- uint16_t ch3_en:1
- uint16_t ch2_en:1
- uint16_t ch1_en:1
- uint16_t reset:1

### 8.6.1 Detailed Description

Configuration register bit fields.

Definition at line 91 of file INA3221.h.

### 8.6.2 Member Data Documentation

### 8.6.2.1 mode_shunt_en

uint16_t INA3221::conf_reg_t::mode_shunt_en

Definition at line 92 of file INA3221.h.

### 8.6.2.2 mode_bus_en

uint16_t INA3221::conf_reg_t::mode_bus_en

Definition at line 93 of file INA3221.h.

### 8.6.2.3 mode_continious_en

uint16_t INA3221::conf_reg_t::mode_continious_en

Definition at line 94 of file INA3221.h.

### 8.6.2.4 shunt_conv_time

uint16_t INA3221::conf_reg_t::shunt_conv_time

Definition at line 95 of file INA3221.h.

124 Class Documentation

### 8.6.2.5 bus_conv_time

uint16_t INA3221::conf_reg_t::bus_conv_time

Definition at line 96 of file INA3221.h.

### 8.6.2.6 avg_mode

uint16_t INA3221::conf_reg_t::avg_mode

Definition at line 97 of file INA3221.h.

### 8.6.2.7 ch3_en

uint16_t INA3221::conf_reg_t::ch3_en

Definition at line 98 of file INA3221.h.

### 8.6.2.8 ch2_en

uint16_t INA3221::conf_reg_t::ch2_en

Definition at line 99 of file INA3221.h.

### 8.6.2.9 ch1_en

uint16_t INA3221::conf_reg_t::ch1_en

Definition at line 100 of file INA3221.h.

### 8.6.2.10 reset

uint16_t INA3221::conf_reg_t::reset

Definition at line 101 of file INA3221.h.

The documentation for this struct was generated from the following file:

- lib/powerman/INA3221/INA3221.h

## 8.7 DS3231 Class Reference

Class for interfacing with the DS3231 real-time clock.

#include <DS3231.h>

8.7 DS3231 Class Reference | 125

Public Member Functions

- DS3231 (i2c_inst_t ∗i2c_instance)

Constructor for the DS3231 class.
- int set_time (time_t unix_time)

Sets the RTC time using a Unix timestamp.
- time_t get_time ()

Gets the current RTC time as Unix timestamp.
- int read_temperature (float ∗resolution)

Reads the current temperature from the DS3231.
- int16_t get_timezone_offset () const

Gets the current timezone offset.
- void set_timezone_offset (int16_t offset_minutes)

Sets the timezone offset.
- time_t get_local_time ()

Gets the current local time (including timezone offset)

Static Public Member Functions

- static DS3231 & get_instance ()

Gets the singleton instance of the DS3231 class.

Private Member Functions

- DS3231 ()

Constructor for the DS3231 class.
- DS3231 (const DS3231 &)=delete
- DS3231 & operator= (const DS3231 &)=delete
- int i2c_read_reg (uint8_t reg_addr, size_t length, uint8_t ∗data)

Reads data from a specific register on the DS3231.
- int i2c_write_reg (uint8_t reg_addr, size_t length, uint8_t ∗data)

Writes data to a specific register on the DS3231.

Private Attributes

- i2c_inst_t ∗ i2c
- uint8_t ds3231_addr
- recursive_mutex_t clock_mutex_
- int16_t timezone_offset_minutes_ = 60
- uint32_t sync_interval_minutes_ = 1440
- time_t last_sync_time_ = 0

### 8.7.1 Detailed Description

Class for interfacing with the DS3231 real-time clock.

This class provides methods to set and get time from a DS3231 RTC module, handle timezone offsets, perform clock synchronization, and more.

Definition at line 108 of file DS3231.h.

126 Class Documentation

### 8.7.2 Constructor & Destructor Documentation

### 8.7.2.1 DS3231() [1/2]

DS3231::DS3231 (

i2c_inst_t ∗ i2c_instance)

Constructor for the DS3231 class.

Parameters

in | i2c_instance | Pointer to the I2C instance to use

Here is the call graph for this function:

### DS3231::DS3231

Here is the caller graph for this function:

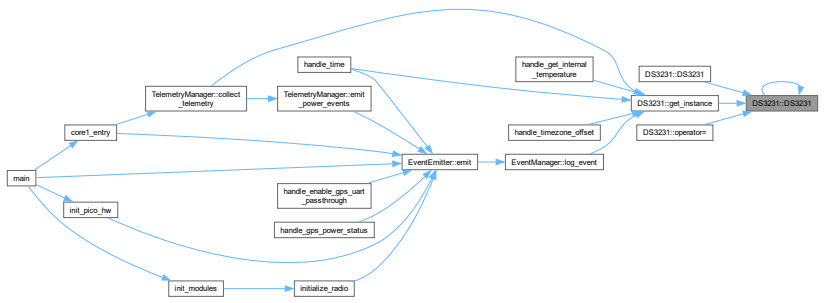
[picture p61: figure]
DS3231::get_instance; DS3231::operator=; TelemetryManager::collect _telemetry; handle_get_internal _temperature; handle_time; handle_timezone_offset; EventManager::log_event; core1_entry; main; EventEmitter::emit; TelemetryManager::emit _power_events; handle_enable_gps_uart _passthrough; handle_gps_power_status; init_pico_hw; init_modules; initialize_radio

### 8.7.2.2 DS3231() [2/2]

DS3231::DS3231 (

const DS3231 & ) [private], [delete]

8.7 DS3231 Class Reference | 127

Here is the call graph for this function:

DS3231::DS3231 | DS3231::DS3231

### 8.7.3 Member Function Documentation

### 8.7.3.1 operator=()

DS3231 & DS3231::operator= (

const DS3231 & ) [private], [delete]

Here is the call graph for this function:

DS3231::operator= | DS3231::DS3231

### 8.7.4 Member Data Documentation

### 8.7.4.1 i2c

i2c_inst_t∗ DS3231::i2c [private]

Definition at line 169 of file DS3231.h.

### 8.7.4.2 ds3231_addr

uint8_t DS3231::ds3231_addr [private]

Definition at line 170 of file DS3231.h.

128 Class Documentation

### 8.7.4.3 clock_mutex_

recursive_mutex_t DS3231::clock_mutex_ [private]

Definition at line 171 of file DS3231.h.

### 8.7.4.4 timezone_offset_minutes_

int16_t DS3231::timezone_offset_minutes_ = 60 [private]

Definition at line 172 of file DS3231.h.

### 8.7.4.5 sync_interval_minutes_

uint32_t DS3231::sync_interval_minutes_ = 1440 [private]

Definition at line 173 of file DS3231.h.

### 8.7.4.6 last_sync_time_

time_t DS3231::last_sync_time_ = 0 [private]

Definition at line 174 of file DS3231.h.

The documentation for this class was generated from the following files:

- lib/clock/DS3231.h
- lib/clock/DS3231.cpp

## 8.8 ds3231_data_t Struct Reference

Structure to hold time and date information from DS3231.

#include <DS3231.h>

Public Attributes

- uint8_t seconds

Seconds (0-59)
- uint8_t minutes

Minutes (0-59)
- uint8_t hours

Hours (0-23)
- uint8_t day

Day of the week (1-7)
- uint8_t date

Date (1-31)
- uint8_t month

Month (1-12)
- uint8_t year

Year (0-99)
- bool century

Century flag (0-1)

8.8 ds3231_data_t Struct Reference | 129

### 8.8.1 Detailed Description

Structure to hold time and date information from DS3231.

Definition at line 90 of file DS3231.h.

### 8.8.2 Member Data Documentation

### 8.8.2.1 seconds

uint8_t ds3231_data_t::seconds

Seconds (0-59)

Definition at line 91 of file DS3231.h.

### 8.8.2.2 minutes

uint8_t ds3231_data_t::minutes

Minutes (0-59)

Definition at line 92 of file DS3231.h.

### 8.8.2.3 hours

uint8_t ds3231_data_t::hours

Hours (0-23)

Definition at line 93 of file DS3231.h.

### 8.8.2.4 day

uint8_t ds3231_data_t::day

Day of the week (1-7)

Definition at line 94 of file DS3231.h.

### 8.8.2.5 date

uint8_t ds3231_data_t::date

Date (1-31)

Definition at line 95 of file DS3231.h.

130 Class Documentation

### 8.8.2.6 month

uint8_t ds3231_data_t::month

Month (1-12)

Definition at line 96 of file DS3231.h.

### 8.8.2.7 year

uint8_t ds3231_data_t::year

Year (0-99)

Definition at line 97 of file DS3231.h.

### 8.8.2.8 century

bool ds3231_data_t::century

Century flag (0-1)

Definition at line 98 of file DS3231.h.

The documentation for this struct was generated from the following file:

- lib/clock/DS3231.h

## 8.9 EventEmitter Class Reference

Provides a simple interface for emitting events.

#include <event_manager.h>

Static Public Member Functions

- template<typename T>
static void emit (EventGroup group, T event)

Emits an event.

### 8.9.1 Detailed Description

Provides a simple interface for emitting events.

This class provides a static method for emitting events, which logs the event to the EventManager.

Definition at line 264 of file event_manager.h.

### 8.9.2 Member Function Documentation

### 8.9.2.1 emit()

template<typename T>

static void EventEmitter::emit (

EventGroup group,

T event) [inline], [static]

Emits an event.

8.10 EventLog Class Reference | 131

Parameters

in | group | Event group.
in | event | Event code.

Template Parameters

T Type of the event enumeration.

Definition at line 273 of file event_manager.h.

Here is the call graph for this function:

EventEmitter::emit

EventManager::get_instance

EventManager::log_event

EventManager::EventManager

DS3231::get_instance

DS3231::get_local_time

uart_print

EventManager::save
_to_storage

DS3231::DS3231

DS3231::get_time | DS3231::i2c_read_reg

SystemStateManager
::get_instance

get_level_color

get_level_prefix

SystemStateManager
fs_init | ::SystemStateManager

SystemStateManager
::set_sd_card_mounted

Here is the caller graph for this function:

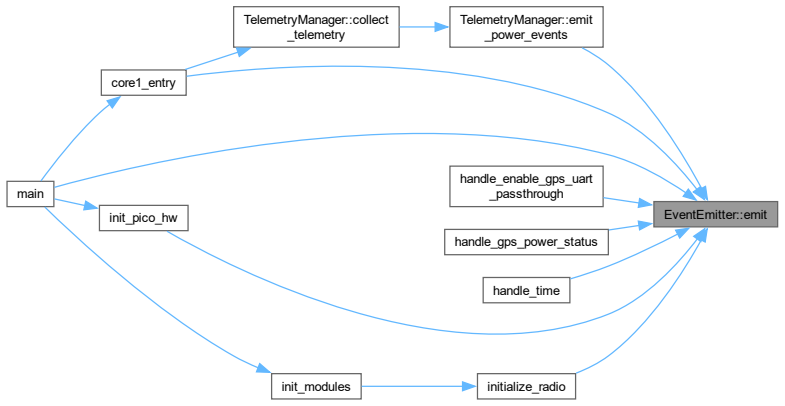
[picture p62: figure]
EventEmitter::emit; core1_entry; main; TelemetryManager::emit _power_events; handle_enable_gps_uart _passthrough; handle_gps_power_status; handle_time; init_pico_hw; initialize_radio; TelemetryManager::collect _telemetry; init_modules

The documentation for this class was generated from the following file:

- lib/eventman/event_manager.h

## 8.10 EventLog Class Reference

Structure for storing event log data.

#include <event_manager.h>

132 Class Documentation

Public Attributes

- uint32_t timestamp

Timestamp of the event in milliseconds since boot.
- uint16_t id

Unique identifier for the event.
- uint8_t group

Event group.
- uint8_t event

Event code.

### 8.10.1 Detailed Description

Structure for storing event log data.

Represents a single event log entry with an ID, timestamp, group, and event code.

Definition at line 173 of file event_manager.h.

### 8.10.2 Member Data Documentation

### 8.10.2.1 timestamp

uint32_t EventLog::timestamp

Timestamp of the event in milliseconds since boot.

Definition at line 176 of file event_manager.h.

### 8.10.2.2 id

uint16_t EventLog::id

Unique identifier for the event.

Definition at line 178 of file event_manager.h.

### 8.10.2.3 group

uint8_t EventLog::group

Event group.

Definition at line 180 of file event_manager.h.

8.11 EventManager Class Reference | 133

### 8.10.2.4 event

uint8_t EventLog::event

Event code.

Definition at line 182 of file event_manager.h.

The documentation for this class was generated from the following file:

- lib/eventman/event_manager.h

## 8.11 EventManager Class Reference

Manages event logging and storage.

#include <event_manager.h>

Collaboration diagram for EventManager:

### EventManager

### EventLog

### events

Public Member Functions

- bool init ()

Initializes the event manager.
- void log_event (uint8_t group, uint8_t event)

Logs an event to the event buffer.
- const EventLog & get_event (size_t index) const

Gets an event from the event buffer.
- size_t get_event_count () const

Gets the number of events in the buffer.
- bool save_to_storage ()

Saves the event buffer to persistent storage.

134 Class Documentation

Static Public Member Functions

- static EventManager & get_instance ()

Gets the singleton instance of the EventManager class.

Private Member Functions

- EventManager ()
- EventManager (const EventManager &)=delete
- EventManager & operator= (const EventManager &)=delete

Private Attributes

- EventLog events [EVENT_BUFFER_SIZE]
- size_t eventCount
- size_t writeIndex
- mutex_t eventMutex
- uint16_t nextEventId
- size_t eventsSinceFlush

### 8.11.1 Detailed Description

Manages event logging and storage.

This class provides a singleton instance for logging events to a circular buffer and saving them to persistent storage. It ensures thread-safe access to the event log and provides methods for initializing, logging, retrieving, saving, and loading events.

Definition at line 194 of file event_manager.h.

### 8.11.2 Constructor & Destructor Documentation

### 8.11.2.1 EventManager() [1/2]

EventManager::EventManager () [inline], [private]

Definition at line 203 of file event_manager.h.

Here is the caller graph for this function:

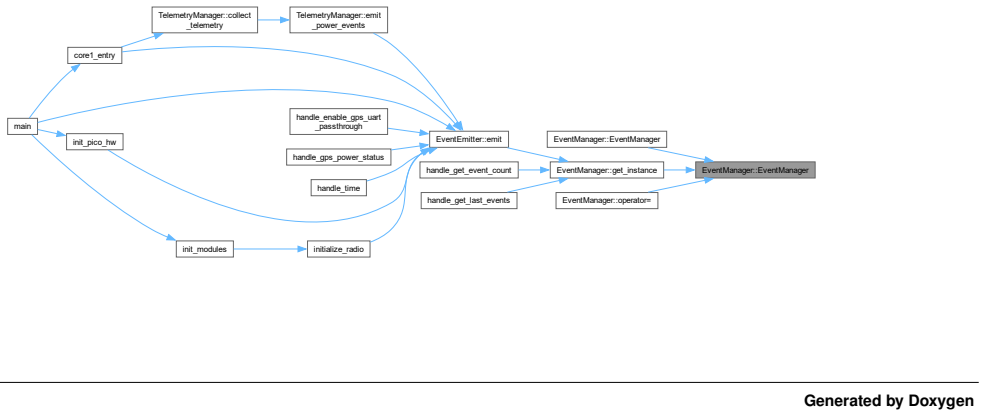
[picture p63: figure]
EventManager::EventManager; EventManager::get_instance; EventManager::operator=; EventEmitter::emit; handle_get_event_count; handle_get_last_events; core1_entry; main; TelemetryManager::emit _power_events; handle_enable_gps_uart _passthrough; handle_gps_power_status; handle_time; init_pico_hw; initialize_radio; TelemetryManager::collect _telemetry; init_modules; Generated by Doxygen

8.11 EventManager Class Reference | 135

### 8.11.2.2 EventManager() [2/2]

EventManager::EventManager (

const EventManager & ) [private], [delete]

Here is the call graph for this function:

EventManager::EventManager | EventManager::EventManager

### 8.11.3 Member Function Documentation

### 8.11.3.1 operator=()

EventManager & EventManager::operator= (

const EventManager & ) [private], [delete]

Here is the call graph for this function:

EventManager::operator= | EventManager::EventManager

### 8.11.3.2 get_instance()

static EventManager & EventManager::get_instance () [inline], [static]

Gets the singleton instance of the EventManager class.

136 Class Documentation

Returns

A reference to the singleton instance.

Definition at line 220 of file event_manager.h.

Here is the call graph for this function:

EventManager::get_instance | EventManager::EventManager

Here is the caller graph for this function:

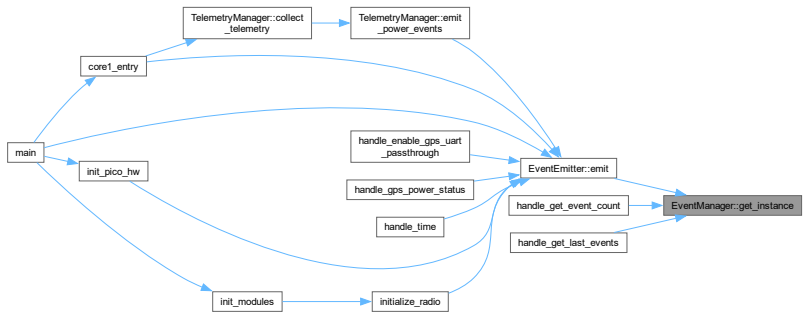
[picture p64: figure]
EventManager::get_instance; EventEmitter::emit; handle_get_event_count; handle_get_last_events; core1_entry; main; TelemetryManager::emit _power_events; handle_enable_gps_uart _passthrough; handle_gps_power_status; handle_time; init_pico_hw; initialize_radio; TelemetryManager::collect _telemetry; init_modules

### 8.11.3.3 get_event_count()

size_t EventManager::get_event_count () const [inline]

Gets the number of events in the buffer.

Returns

The number of events in the buffer.

Definition at line 249 of file event_manager.h.

### 8.11.4 Member Data Documentation

### 8.11.4.1 events

EventLog EventManager::events[EVENT_BUFFER_SIZE] [private]

Definition at line 196 of file event_manager.h.

8.12 Frame Struct Reference | 137

### 8.11.4.2 eventCount

size_t EventManager::eventCount [private]

Definition at line 197 of file event_manager.h.

### 8.11.4.3 writeIndex

size_t EventManager::writeIndex [private]

Definition at line 198 of file event_manager.h.

### 8.11.4.4 eventMutex

mutex_t EventManager::eventMutex [private]

Definition at line 199 of file event_manager.h.

### 8.11.4.5 nextEventId

uint16_t EventManager::nextEventId [private]

Definition at line 200 of file event_manager.h.

### 8.11.4.6 eventsSinceFlush

size_t EventManager::eventsSinceFlush [private]

Definition at line 201 of file event_manager.h.

The documentation for this class was generated from the following files:

- lib/eventman/event_manager.h
- lib/eventman/event_manager.cpp

## 8.12 Frame Struct Reference

Represents a communication frame used for data exchange.

#include <protocol.h>

138 Class Documentation

Public Attributes

- std::string header
- uint8_t direction
- OperationType operationType
- uint8_t group
- uint8_t command
- std::string value
- std::string unit
- std::string footer

### 8.12.1 Detailed Description

Represents a communication frame used for data exchange.

This structure encapsulates the different components of a communication frame, including the header, direction, operation type, group ID, command ID, payload value, unit, and footer. It is used for both encoding and decoding messages.

Note

The header and footer fields are used to mark the beginning and end of the frame, respectively.

The direction field indicates the direction of the communication (0 = ground->sat, 1 = sat->ground).

The operationType field specifies the type of operation being performed (e.g., GET, SET, ANS, ERR, INF).

The group and command fields identify the specific command being executed.

The value field contains the payload data.

The unit field specifies the unit of measurement for the payload data.

Definition at line 143 of file protocol.h.

### 8.12.2 Member Data Documentation

### 8.12.2.1 header

std::string Frame::header

Definition at line 144 of file protocol.h.

### 8.12.2.2 direction

uint8_t Frame::direction

Definition at line 145 of file protocol.h.

### 8.12.2.3 operationType

OperationType Frame::operationType

Definition at line 146 of file protocol.h.

8.13 INA3221 Class Reference | 139

### 8.12.2.4 group

uint8_t Frame::group

Definition at line 147 of file protocol.h.

### 8.12.2.5 command

uint8_t Frame::command

Definition at line 148 of file protocol.h.

### 8.12.2.6 value

std::string Frame::value

Definition at line 149 of file protocol.h.

### 8.12.2.7 unit

std::string Frame::unit

Definition at line 150 of file protocol.h.

### 8.12.2.8 footer

std::string Frame::footer

Definition at line 151 of file protocol.h.

The documentation for this struct was generated from the following file:

- lib/comms/protocol.h

## 8.13 INA3221 Class Reference

INA3221 Triple-Channel Power Monitor driver class.

#include <INA3221.h>

Collaboration diagram for INA3221:

### INA3221

### INA3221::masken_reg_t

### _masken_reg

140 Class Documentation

Classes

- struct conf_reg_t

Configuration register bit fields.
- struct masken_reg_t

Mask/Enable register bit fields.

Public Member Functions

- INA3221 (ina3221_addr_t addr, i2c_inst_t ∗i2c)

Constructor for INA3221 class.
- bool begin ()

Initialize the INA3221 device.
- uint16_t read_register (ina3221_reg_t reg)

Read a register from the device.
- void set_mode_continuous ()

Set device to continuous measurement mode.
- void set_mode_triggered ()

Set device to triggered measurement mode.
- void set_averaging_mode (ina3221_avg_mode_t mode)

Set the averaging mode for measurements.
- uint16_t get_manufacturer_id ()

Get the manufacturer ID of the device.
- uint16_t get_die_id ()

Get the die ID of the device.
- int32_t get_shunt_voltage (ina3221_ch_t channel)

Get shunt voltage for a specific channel.
- float get_current_ma (ina3221_ch_t channel)

Get current for a specific channel.
- float get_voltage (ina3221_ch_t channel)

Get bus voltage for a specific channel.

Private Member Functions

- void _read (ina3221_reg_t reg, uint16_t ∗val)

Read a 16-bit register from the device.
- void _write (ina3221_reg_t reg, uint16_t ∗val)

Write a 16-bit value to a register.

Private Attributes

- ina3221_addr_t _i2c_addr
- i2c_inst_t ∗ _i2c
- uint32_t _shuntRes [INA3221_CH_NUM]
- uint32_t _filterRes [INA3221_CH_NUM]
- masken_reg_t _masken_reg

8.13 INA3221 Class Reference | 141

### 8.13.1 Detailed Description

INA3221 Triple-Channel Power Monitor driver class.

Provides functionality for voltage, current, and power monitoring with configurable alerts and power valid monitoring

Definition at line 86 of file INA3221.h.

### 8.13.2 Member Function Documentation

### 8.13.2.1 _read()

void INA3221::_read (

ina3221_reg_t reg,

uint16_t ∗ val) [private]

Read a 16-bit register from the device.

Parameters

reg | Register address
val | Pointer to store the read value

Definition at line 242 of file INA3221.cpp.

Here is the caller graph for this function:

### 8.13.2.2 _write()

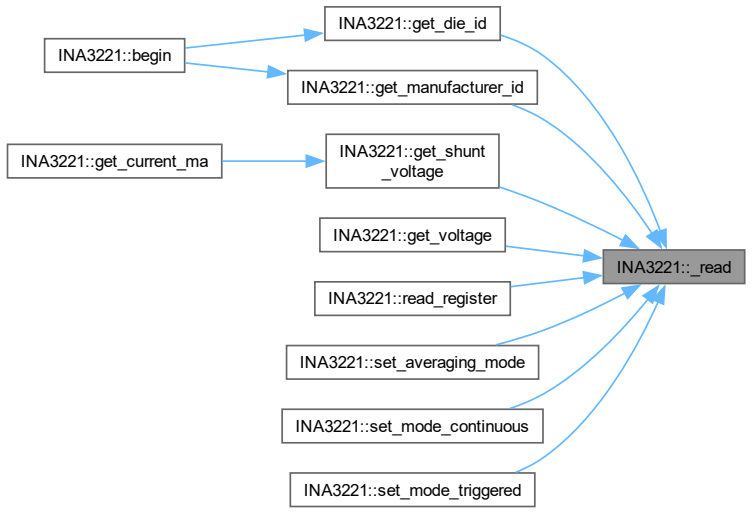
[picture p65: figure]
INA3221::_read; INA3221::get_die_id; INA3221::get_manufacturer_id; INA3221::get_shunt _voltage; INA3221::get_voltage; INA3221::read_register; INA3221::set_averaging_mode; INA3221::set_mode_continuous; INA3221::set_mode_triggered; INA3221::begin; INA3221::get_current_ma

void INA3221::_write (

ina3221_reg_t reg,

uint16_t ∗ val) [private]

Write a 16-bit value to a register.

142 Class Documentation

Parameters

reg | Register address
val | Pointer to the value to write

Definition at line 268 of file INA3221.cpp.

Here is the caller graph for this function:

### INA3221::_write

### INA3221::set_averaging_mode

### INA3221::set_mode_continuous

### INA3221::set_mode_triggered

### 8.13.3 Member Data Documentation

### 8.13.3.1 _i2c_addr

ina3221_addr_t INA3221::_i2c_addr [private]

Definition at line 127 of file INA3221.h.

### 8.13.3.2 _i2c

i2c_inst_t∗ INA3221::_i2c [private]

Definition at line 128 of file INA3221.h.

### 8.13.3.3 _shuntRes

uint32_t INA3221::_shuntRes[INA3221_CH_NUM] [private]

Definition at line 131 of file INA3221.h.

### 8.13.3.4 _filterRes

uint32_t INA3221::_filterRes[INA3221_CH_NUM] [private]

Definition at line 134 of file INA3221.h.

8.14 ISensor Class Reference | 143

### 8.13.3.5 _masken_reg

masken_reg_t INA3221::_masken_reg [private]

Definition at line 137 of file INA3221.h.

The documentation for this class was generated from the following files:

- lib/powerman/INA3221/INA3221.h
- lib/powerman/INA3221/INA3221.cpp

## 8.14 ISensor Class Reference

Abstract base class for sensors.

#include <ISensor.h>

Inheritance diagram for ISensor:

### ISensor

BH1750Wrapper | BME280Wrapper

Public Member Functions

- virtual ∼ISensor ()=default

Virtual destructor.
- virtual bool init ()=0

Initializes the sensor.
- virtual float read_data (SensorDataTypeIdentifier type)=0

Reads data from the sensor.
- virtual bool is_initialized () const =0

Checks if the sensor is initialized.
- virtual SensorType get_type () const =0

Gets the sensor type.
- virtual bool configure (const std::map< std::string, std::string > &config)=0

Configures the sensor.
- virtual uint8_t get_address () const =0

Gets the I2C address of the sensor.

144 Class Documentation

### 8.14.1 Detailed Description

Abstract base class for sensors.

Defines the interface for interacting with different types of sensors.

Definition at line 63 of file ISensor.h.

### 8.14.2 Constructor & Destructor Documentation

8.14.2.1 ∼ISensor()

virtual ISensor::∼ISensor () [virtual], [default]

Virtual destructor.

Ensures proper cleanup of derived classes.

### 8.14.3 Member Function Documentation

### 8.14.3.1 init()

virtual bool ISensor::init () [pure virtual]

Initializes the sensor.

Returns

True if initialization was successful, false otherwise.

Implemented in BH1750Wrapper, and BME280Wrapper.

### 8.14.3.2 read_data()

virtual float ISensor::read_data (

SensorDataTypeIdentifier type) [pure virtual]

Reads data from the sensor.

Parameters

in | type | Data type to read.

Returns

The sensor data.

Implemented in BH1750Wrapper, and BME280Wrapper.

8.14 ISensor Class Reference | 145

### 8.14.3.3 is_initialized()

virtual bool ISensor::is_initialized () const [pure virtual]

Checks if the sensor is initialized.

Returns

True if the sensor is initialized, false otherwise.

Implemented in BH1750Wrapper, and BME280Wrapper.

### 8.14.3.4 get_type()

virtual SensorType ISensor::get_type () const [pure virtual]

Gets the sensor type.

Returns

The sensor type.

Implemented in BH1750Wrapper, and BME280Wrapper.

### 8.14.3.5 configure()

virtual bool ISensor::configure (

const std::map< std::string, std::string > & config) [pure virtual]

Configures the sensor.

Parameters

in | config | A map of configuration parameters.

Returns

True if configuration was successful, false otherwise.

Implemented in BH1750Wrapper, and BME280Wrapper.

### 8.14.3.6 get_address()

virtual uint8_t ISensor::get_address () const [pure virtual]

Gets the I2C address of the sensor.

Returns

The I2C address of the sensor.

Implemented in BH1750Wrapper, and BME280Wrapper.

The documentation for this class was generated from the following file:

- lib/sensors/ISensor.h

146 Class Documentation

## 8.15 INA3221::masken_reg_t Struct Reference

Mask/Enable register bit fields.

Public Attributes

- uint16_t conv_ready:1
- uint16_t timing_ctrl_alert:1
- uint16_t pwr_valid_alert:1
- uint16_t warn_alert_ch3:1
- uint16_t warn_alert_ch2:1
- uint16_t warn_alert_ch1:1
- uint16_t shunt_sum_alert:1
- uint16_t crit_alert_ch3:1
- uint16_t crit_alert_ch2:1
- uint16_t crit_alert_ch1:1
- uint16_t crit_alert_latch_en:1
- uint16_t warn_alert_latch_en:1
- uint16_t shunt_sum_en_ch3:1
- uint16_t shunt_sum_en_ch2:1
- uint16_t shunt_sum_en_ch1:1
- uint16_t reserved:1

### 8.15.1 Detailed Description

Mask/Enable register bit fields.

Definition at line 107 of file INA3221.h.

### 8.15.2 Member Data Documentation

### 8.15.2.1 conv_ready

uint16_t INA3221::masken_reg_t::conv_ready

Definition at line 108 of file INA3221.h.

### 8.15.2.2 timing_ctrl_alert

uint16_t INA3221::masken_reg_t::timing_ctrl_alert

Definition at line 109 of file INA3221.h.

### 8.15.2.3 pwr_valid_alert

uint16_t INA3221::masken_reg_t::pwr_valid_alert

Definition at line 110 of file INA3221.h.

8.15 INA3221::masken_reg_t Struct Reference | 147

### 8.15.2.4 warn_alert_ch3

uint16_t INA3221::masken_reg_t::warn_alert_ch3

Definition at line 111 of file INA3221.h.

### 8.15.2.5 warn_alert_ch2

uint16_t INA3221::masken_reg_t::warn_alert_ch2

Definition at line 112 of file INA3221.h.

### 8.15.2.6 warn_alert_ch1

uint16_t INA3221::masken_reg_t::warn_alert_ch1

Definition at line 113 of file INA3221.h.

### 8.15.2.7 shunt_sum_alert

uint16_t INA3221::masken_reg_t::shunt_sum_alert

Definition at line 114 of file INA3221.h.

### 8.15.2.8 crit_alert_ch3

uint16_t INA3221::masken_reg_t::crit_alert_ch3

Definition at line 115 of file INA3221.h.

### 8.15.2.9 crit_alert_ch2

uint16_t INA3221::masken_reg_t::crit_alert_ch2

Definition at line 116 of file INA3221.h.

### 8.15.2.10 crit_alert_ch1

uint16_t INA3221::masken_reg_t::crit_alert_ch1

Definition at line 117 of file INA3221.h.

### 8.15.2.11 crit_alert_latch_en

uint16_t INA3221::masken_reg_t::crit_alert_latch_en

Definition at line 118 of file INA3221.h.

148 Class Documentation

### 8.15.2.12 warn_alert_latch_en

uint16_t INA3221::masken_reg_t::warn_alert_latch_en

Definition at line 119 of file INA3221.h.

### 8.15.2.13 shunt_sum_en_ch3

uint16_t INA3221::masken_reg_t::shunt_sum_en_ch3

Definition at line 120 of file INA3221.h.

### 8.15.2.14 shunt_sum_en_ch2

uint16_t INA3221::masken_reg_t::shunt_sum_en_ch2

Definition at line 121 of file INA3221.h.

### 8.15.2.15 shunt_sum_en_ch1

uint16_t INA3221::masken_reg_t::shunt_sum_en_ch1

Definition at line 122 of file INA3221.h.

### 8.15.2.16 reserved

uint16_t INA3221::masken_reg_t::reserved

Definition at line 123 of file INA3221.h.

The documentation for this struct was generated from the following file:

- lib/powerman/INA3221/INA3221.h

## 8.16 NMEAData Class Reference

Manages parsed NMEA sentences.

#include <NMEA_data.h>

Public Member Functions

- void update_rmc_tokens (const std::vector< std::string > &tokens)

Updates the RMC tokens with new data.
- void update_gga_tokens (const std::vector< std::string > &tokens)

Updates the GGA tokens with new data.
- std::vector< std::string > get_rmc_tokens () const

Gets a copy of the RMC tokens.
- std::vector< std::string > get_gga_tokens () const

Gets a copy of the GGA tokens.

8.16 NMEAData Class Reference | 149

Static Public Member Functions

- static NMEAData & get_instance ()

Gets the singleton instance of the NMEAData class.

Private Member Functions

- NMEAData ()

Private constructor for the singleton pattern.
- NMEAData (const NMEAData &)=delete

Deleted copy constructor to prevent copying.
- NMEAData & operator= (const NMEAData &)=delete

Deleted assignment operator to prevent assignment.

Private Attributes

- std::vector< std::string > rmc_tokens_

Vector of tokens from the most recent RMC sentence.
- std::vector< std::string > gga_tokens_

Vector of tokens from the most recent GGA sentence.
- mutex_t rmc_mutex_

Mutex for thread-safe access to the RMC tokens.
- mutex_t gga_mutex_

Mutex for thread-safe access to the GGA tokens.

### 8.16.1 Detailed Description

Manages parsed NMEA sentences.

This class is a singleton that stores and provides access to parsed data from NMEA sentences received from a GPS module. It includes methods for updating and retrieving RMC and GGA tokens, as well as converting the data to a Unix timestamp.

Definition at line 32 of file NMEA_data.h.

### 8.16.2 Constructor & Destructor Documentation

### 8.16.2.1 NMEAData() [1/2]

NMEAData::NMEAData () [inline], [private]

Private constructor for the singleton pattern.

Initializes the mutexes.

Definition at line 47 of file NMEA_data.h.

Here is the caller graph for this function:

NMEAData::NMEAData

NMEAData::get_instance

NMEAData::NMEAData

NMEAData::operator=

collect_gps_data

TelemetryManager::collect
_gps_telemetry
main | core1_entry
TelemetryManager::collect
_telemetry

150 Class Documentation

### 8.16.2.2 NMEAData() [2/2]

NMEAData::NMEAData (

const NMEAData & ) [private], [delete]

Deleted copy constructor to prevent copying.

Here is the call graph for this function:

NMEAData::NMEAData | NMEAData::NMEAData

### 8.16.3 Member Function Documentation

### 8.16.3.1 operator=()

NMEAData & NMEAData::operator= (

const NMEAData & ) [private], [delete]

Deleted assignment operator to prevent assignment.

Here is the call graph for this function:

NMEAData::operator= | NMEAData::NMEAData

### 8.16.3.2 get_instance()

static NMEAData & NMEAData::get_instance () [inline], [static]

Gets the singleton instance of the NMEAData class.

8.16 NMEAData Class Reference | 151

Returns

A reference to the singleton instance.

Definition at line 66 of file NMEA_data.h.

Here is the call graph for this function:

NMEAData::get_instance | NMEAData::NMEAData

Here is the caller graph for this function:

NMEAData::get_instance

collect_gps_data

TelemetryManager::collect
_gps_telemetry
main | core1_entry
TelemetryManager::collect
_telemetry

### 8.16.3.3 update_rmc_tokens()

void NMEAData::update_rmc_tokens (

const std::vector< std::string > & tokens) [inline]

Updates the RMC tokens with new data.

Parameters

in | tokens | Vector of strings representing the RMC tokens.

Definition at line 75 of file NMEA_data.h.

Here is the caller graph for this function:

NMEAData::update_rmc
_tokens main | core1_entry | collect_gps_data

### 8.16.3.4 update_gga_tokens()

void NMEAData::update_gga_tokens (

const std::vector< std::string > & tokens) [inline]

Updates the GGA tokens with new data.

152 Class Documentation

Parameters

in | tokens | Vector of strings representing the GGA tokens.

Definition at line 85 of file NMEA_data.h.

Here is the caller graph for this function:

NMEAData::update_gga
_tokens main | core1_entry | collect_gps_data

### 8.16.3.5 get_rmc_tokens()

std::vector< std::string > NMEAData::get_rmc_tokens () const [inline]

Gets a copy of the RMC tokens.

Returns

A copy of the RMC tokens.

Definition at line 95 of file NMEA_data.h.

### 8.16.3.6 get_gga_tokens()

std::vector< std::string > NMEAData::get_gga_tokens () const [inline]

Gets a copy of the GGA tokens.

Returns

A copy of the GGA tokens.

Definition at line 106 of file NMEA_data.h.

### 8.16.4 Member Data Documentation

### 8.16.4.1 rmc_tokens_

std::vector<std::string> NMEAData::rmc_tokens_ [private]

Vector of tokens from the most recent RMC sentence.

Definition at line 35 of file NMEA_data.h.

8.17 PowerManager Class Reference | 153

### 8.16.4.2 gga_tokens_

std::vector<std::string> NMEAData::gga_tokens_ [private]

Vector of tokens from the most recent GGA sentence.

Definition at line 37 of file NMEA_data.h.

### 8.16.4.3 rmc_mutex_

mutex_t NMEAData::rmc_mutex_ [private]

Mutex for thread-safe access to the RMC tokens.

Definition at line 39 of file NMEA_data.h.

### 8.16.4.4 gga_mutex_

mutex_t NMEAData::gga_mutex_ [private]

Mutex for thread-safe access to the GGA tokens.

Definition at line 41 of file NMEA_data.h.

The documentation for this class was generated from the following file:

- lib/location/NMEA/NMEA_data.h

## 8.17 PowerManager Class Reference

Manages power-related functions.

#include <PowerManager.h>

Collaboration diagram for PowerManager:

### PowerManager

### INA3221

### ina3221_

### INA3221::masken_reg_t

### _masken_reg

154 Class Documentation

Public Member Functions

- PowerManager (i2c_inst_t ∗i2c)

Constructor for the PowerManager class.
- bool initialize ()

Initializes the PowerManager.
- std::string read_device_ids ()

Reads the manufacturer and die IDs from the INA3221.
- float get_current_charge_solar ()

Gets the solar charging current.
- float get_current_charge_usb ()

Gets the USB charging current.
- float get_current_charge_total ()

Gets the total charging current.
- float get_current_draw ()

Gets the current draw.
- float get_voltage_battery ()

Gets the battery voltage.
- float get_voltage_5v ()

Gets the 5V voltage.
- float get_voltage_solar ()

Gets solar voltage.
- void configure (ina3221_op_mode_t op_mode, ina3221_avg_mode_t avg_mode)

Configures the INA3221.

Static Public Member Functions

- static PowerManager & get_instance ()

Gets the singleton instance of the PowerManager class.

Static Public Attributes

- static constexpr float SOLAR_CURRENT_THRESHOLD = 50.0f

Solar current threshold in milliamperes.
- static constexpr float USB_CURRENT_THRESHOLD = 50.0f

USB current threshold in milliamperes.
- static constexpr float BATTERY_LOW_THRESHOLD = 2.8f

Low voltage threshold in volts.
- static constexpr float BATTERY_FULL_THRESHOLD = 4.2f

Overcharge voltage threshold in volts.

Private Member Functions

- PowerManager ()

Private constructor for the singleton pattern.
- PowerManager (const PowerManager &)=delete

Deleted copy constructor to prevent copying.
- PowerManager & operator= (const PowerManager &)=delete

Deleted assignment operator to prevent assignment.

8.17 PowerManager Class Reference | 155

Private Attributes

- INA3221 ina3221_

INA3221 instance for power monitoring.
- bool initialized_

Flag indicating if the PowerManager is initialized.
- recursive_mutex_t powerman_mutex_

Mutex for thread-safe access to the PowerManager.

### 8.17.1 Detailed Description

Manages power-related functions.

This class is a singleton that provides methods for reading voltage and current values, configuring the INA3221 power monitor, and checking power alerts.

Definition at line 32 of file PowerManager.h.

### 8.17.2 Constructor & Destructor Documentation

### 8.17.2.1 PowerManager() [1/2]

PowerManager::PowerManager (

i2c_inst_t ∗ i2c)

Constructor for the PowerManager class.

Parameters

in | i2c | I2C instance to use for communication with the INA3221.

Here is the call graph for this function:

### PowerManager::PowerManager

Here is the caller graph for this function:

PowerManager::PowerManager

PowerManager::get_instance

PowerManager::operator=

PowerManager::PowerManager

TelemetryManager::collect
_power_telemetry

main

define_system_operating_mode

TelemetryManager::collect
_telemetry core1_entry

156 Class Documentation

### 8.17.2.2 PowerManager() [2/2]

PowerManager::PowerManager (

const PowerManager & ) [private], [delete]

Deleted copy constructor to prevent copying.

Here is the call graph for this function:

PowerManager::PowerManager | PowerManager::PowerManager

### 8.17.3 Member Function Documentation

### 8.17.3.1 operator=()

PowerManager & PowerManager::operator= (

const PowerManager & ) [private], [delete]

Deleted assignment operator to prevent assignment.

Here is the call graph for this function:

PowerManager::operator= | PowerManager::PowerManager

### 8.17.4 Member Data Documentation

### 8.17.4.1 SOLAR_CURRENT_THRESHOLD

float PowerManager::SOLAR_CURRENT_THRESHOLD = 50.0f [static], [constexpr]

Solar current threshold in milliamperes.

Definition at line 108 of file PowerManager.h.

8.17 PowerManager Class Reference | 157

### 8.17.4.2 USB_CURRENT_THRESHOLD

float PowerManager::USB_CURRENT_THRESHOLD = 50.0f [static], [constexpr]

USB current threshold in milliamperes.

Definition at line 110 of file PowerManager.h.

### 8.17.4.3 BATTERY_LOW_THRESHOLD

float PowerManager::BATTERY_LOW_THRESHOLD = 2.8f [static], [constexpr]

Low voltage threshold in volts.

Definition at line 112 of file PowerManager.h.

### 8.17.4.4 BATTERY_FULL_THRESHOLD

float PowerManager::BATTERY_FULL_THRESHOLD = 4.2f [static], [constexpr]

Overcharge voltage threshold in volts.

Definition at line 114 of file PowerManager.h.

### 8.17.4.5 ina3221_

INA3221 PowerManager::ina3221_ [private]

INA3221 instance for power monitoring.

Definition at line 118 of file PowerManager.h.

### 8.17.4.6 initialized_

bool PowerManager::initialized_ [private]

Flag indicating if the PowerManager is initialized.

Definition at line 120 of file PowerManager.h.

### 8.17.4.7 powerman_mutex_

recursive_mutex_t PowerManager::powerman_mutex_ [private]

Mutex for thread-safe access to the PowerManager.

Definition at line 122 of file PowerManager.h.

The documentation for this class was generated from the following files:

- lib/powerman/PowerManager.h
- lib/powerman/PowerManager.cpp

158 Class Documentation

## 8.18 SensorDataRecord Struct Reference

Structure representing a single sensor data point.

#include <telemetry_manager.h>

Public Member Functions

- std::string to_csv () const

Converts the sensor data record to a CSV string.

Public Attributes

- uint32_t timestamp
- float temperature
- float pressure
- float humidity
- float light

### 8.18.1 Detailed Description

Structure representing a single sensor data point.

Contains measurements from the environment and light sensors collected at a specific point in time

Definition at line 111 of file telemetry_manager.h.

### 8.18.2 Member Data Documentation

### 8.18.2.1 timestamp

uint32_t SensorDataRecord::timestamp

Unix timestamp of the record

Definition at line 112 of file telemetry_manager.h.

### 8.18.2.2 temperature

float SensorDataRecord::temperature

Temperature in degrees Celsius

Definition at line 113 of file telemetry_manager.h.

8.19 SensorWrapper Class Reference | 159

### 8.18.2.3 pressure

float SensorDataRecord::pressure

Pressure in hPa

Definition at line 114 of file telemetry_manager.h.

### 8.18.2.4 humidity

float SensorDataRecord::humidity

Relative humidity in %

Definition at line 115 of file telemetry_manager.h.

### 8.18.2.5 light

float SensorDataRecord::light

Light intensity in lux

Definition at line 116 of file telemetry_manager.h.

The documentation for this struct was generated from the following file:

- lib/telemetry/telemetry_manager.h

## 8.19 SensorWrapper Class Reference

Manages a collection of sensors.

#include <ISensor.h>

Public Member Functions

- bool sensor_init (SensorType type, i2c_inst_t ∗i2c=nullptr)

Initializes a sensor.
- bool sensor_configure (SensorType type, const std::map< std::string, std::string > &config)

Configures a sensor.
- float sensor_read_data (SensorType sensorType, SensorDataTypeIdentifier dataType)

Reads data from a sensor.
- ISensor ∗ get_sensor (SensorType type)

Gets a sensor.
- std::vector< std::pair< SensorType, uint8_t > > scan_connected_sensors (i2c_inst_t ∗i2c)

Scans for connected sensors.
- std::vector< std::pair< SensorType, uint8_t > > get_available_sensors ()

Gets a list of available sensors.

160 Class Documentation

Static Public Member Functions

- static SensorWrapper & get_instance ()

Gets the singleton instance of the SensorWrapper class.

Private Member Functions

- SensorWrapper ()=default

Private constructor for the singleton pattern.

Private Attributes

- std::map< SensorType, ISensor ∗ > sensors

Map of sensor types to sensor instances.

### 8.19.1 Detailed Description

Manages a collection of sensors.

This class provides methods for initializing, configuring, and reading data from different types of sensors.

Definition at line 116 of file ISensor.h.

### 8.19.2 Constructor & Destructor Documentation

### 8.19.2.1 SensorWrapper()

SensorWrapper::SensorWrapper () [private], [default]

Private constructor for the singleton pattern.

Here is the caller graph for this function:

SensorWrapper::SensorWrapper SensorWrapper::get _instance

TelemetryManager::collect
_sensor_telemetry

init_modules

TelemetryManager::collect
_telemetry core1_entry

main

8.19 SensorWrapper Class Reference | 161

### 8.19.3 Member Function Documentation

### 8.19.3.1 get_instance()

static SensorWrapper & SensorWrapper::get_instance () [inline], [static]

Gets the singleton instance of the SensorWrapper class.

Returns

A reference to the singleton instance.

Definition at line 122 of file ISensor.h.

Here is the call graph for this function:

### SensorWrapper::get

_instance | SensorWrapper::SensorWrapper

Here is the caller graph for this function:

SensorWrapper::get
_instance

TelemetryManager::collect
_sensor_telemetry

init_modules

TelemetryManager::collect
_telemetry core1_entry

main

### 8.19.3.2 scan_connected_sensors()

std::vector< std::pair< SensorType, uint8_t > > SensorWrapper::scan_connected_sensors (

i2c_inst_t ∗ i2c)

Scans for connected sensors.

Parameters

in | i2c | I2C instance to use for scanning.

Returns

A vector of pairs, where each pair contains a sensor type and its address.

162 Class Documentation

### 8.19.3.3 get_available_sensors()

std::vector< std::pair< SensorType, uint8_t > > SensorWrapper::get_available_sensors ()

Gets a list of available sensors.

Returns

A vector of pairs, where each pair contains a sensor type and its address.

### 8.19.4 Member Data Documentation

### 8.19.4.1 sensors

std::map<SensorType, ISensor∗> SensorWrapper::sensors [private]

Map of sensor types to sensor instances.

Definition at line 173 of file ISensor.h.

The documentation for this class was generated from the following files:

- lib/sensors/ISensor.h
- lib/sensors/ISensor.cpp

## 8.20 SystemStateManager Class Reference

Manages the system state of the Kubisat firmware.

#include <system_state_manager.h>

Public Member Functions

- bool is_bootloader_reset_pending () const

Checks if a bootloader reset is pending.
- void set_bootloader_reset_pending (bool pending)

Sets whether a bootloader reset is pending.
- bool is_gps_collection_paused () const

Checks if GPS collection is paused.
- void set_gps_collection_paused (bool paused)

Sets whether GPS collection is paused.
- bool is_sd_card_mounted () const

Checks if the SD card is mounted.
- void set_sd_card_mounted (bool mounted)

Sets whether the SD card is mounted.
- VerbosityLevel get_uart_verbosity () const

Gets the UART verbosity level.
- void set_uart_verbosity (VerbosityLevel level)

Sets the UART verbosity level.

8.20 SystemStateManager Class Reference | 163
- bool is_radio_init_ok () const

Checks if the radio initialization was successful.
- void set_radio_init_ok (bool status)

Sets whether the radio initialization was successful.
- bool is_light_sensor_init_ok () const

Checks if the light sensor initialization was successful.
- void set_light_sensor_init_ok (bool status)

Sets whether the light sensor initialization was successful.
- bool is_env_sensor_init_ok () const

Checks if the environment sensor initialization was successful.
- void set_env_sensor_init_ok (bool status)

Sets whether the environment sensor initialization was successful.
- SystemOperatingMode get_operating_mode () const

Gets the system operating mode.
- void set_operating_mode (SystemOperatingMode mode)

Sets the system operating mode.

Static Public Member Functions

- static SystemStateManager & get_instance ()

Gets the singleton instance of the SystemStateManager class.

Private Member Functions

- SystemStateManager ()

Private constructor for the singleton pattern.
- SystemStateManager (const SystemStateManager &)=delete

Deleted copy constructor to prevent copying.
- SystemStateManager & operator= (const SystemStateManager &)=delete

Deleted assignment operator to prevent assignment.

Private Attributes

- bool pending_bootloader_reset

Flag indicating whether a bootloader reset is pending.
- bool gps_collection_paused

Flag indicating whether GPS collection is paused.
- bool sd_card_mounted

Flag indicating whether the SD card is mounted.
- VerbosityLevel uart_verbosity

The UART verbosity level.
- bool sd_card_init_status

Flag indicating whether the SD card initialization was successful.
- bool radio_init_status

Flag indicating whether the radio initialization was successful.
- bool light_sensor_init_status

Flag indicating whether the light sensor initialization was successful.
- bool env_sensor_init_status

Flag indicating whether the environment sensor initialization was successful.
- SystemOperatingMode system_operating_mode

The system operating mode.
- recursive_mutex_t mutex_

Mutex for thread-safe access to the system state.

164 Class Documentation

### 8.20.1 Detailed Description

Manages the system state of the Kubisat firmware.

This class is a singleton that provides methods for getting and setting various system states, such as whether a bootloader reset is pending, whether GPS collection is paused, whether the SD card is mounted, and the UART verbosity level.

Definition at line 40 of file system_state_manager.h.

### 8.20.2 Constructor & Destructor Documentation

### 8.20.2.1 SystemStateManager() [1/2]

SystemStateManager::SystemStateManager () [inline], [private]

Private constructor for the singleton pattern.

Initializes the system state and mutex.

Definition at line 67 of file system_state_manager.h.

Here is the caller graph for this function:

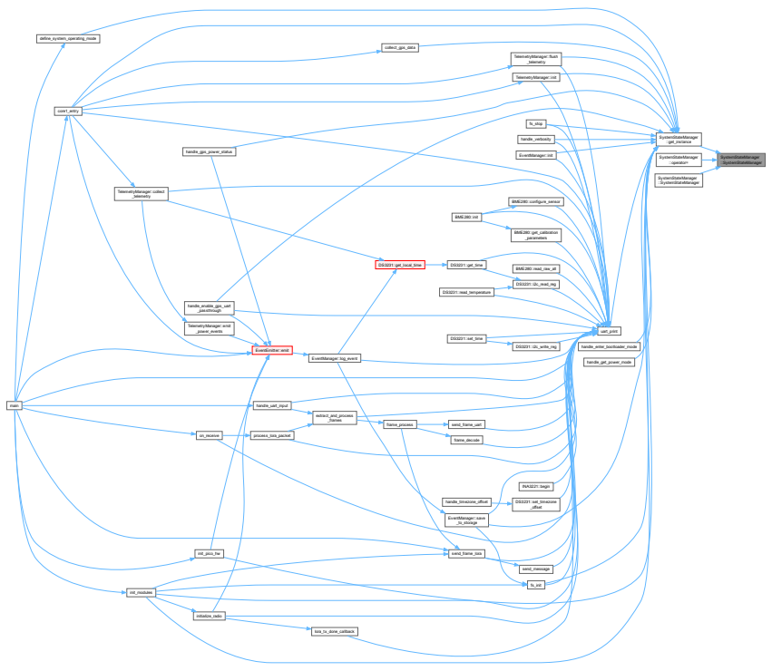
[picture p66: figure]
SystemStateManager ::SystemStateManager; SystemStateManager ::get_instance; SystemStateManager ::operator=; collect_gps_data; core1_entry; define_system_operating_mode; TelemetryManager::flush _telemetry; fs_init; init_modules; EventManager::save _to_storage; handle_enable_gps_uart _passthrough; handle_gps_power_status; init_pico_hw; fs_stop; handle_enter_bootloader_mode; handle_get_power_mode; handle_verbosity; EventManager::init; TelemetryManager::init; uart_print; main; EventManager::log_event; EventEmitter::emit; TelemetryManager::emit _power_events; initialize_radio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

8.20 SystemStateManager Class Reference | 165

### 8.20.2.2 SystemStateManager() [2/2]

SystemStateManager::SystemStateManager (

const SystemStateManager & ) [private], [delete]

Deleted copy constructor to prevent copying.

Here is the call graph for this function:

### SystemStateManager ::SystemStateManager

### SystemStateManager ::SystemStateManager

### 8.20.3 Member Function Documentation

### 8.20.3.1 operator=()

SystemStateManager & SystemStateManager::operator= (

const SystemStateManager & ) [private], [delete]

Deleted assignment operator to prevent assignment.

Here is the call graph for this function:

### SystemStateManager ::operator=

### SystemStateManager ::SystemStateManager

### 8.20.3.2 get_instance()

static SystemStateManager & SystemStateManager::get_instance () [inline], [static]

Gets the singleton instance of the SystemStateManager class.

### SystemStateManager

### SystemStateManager

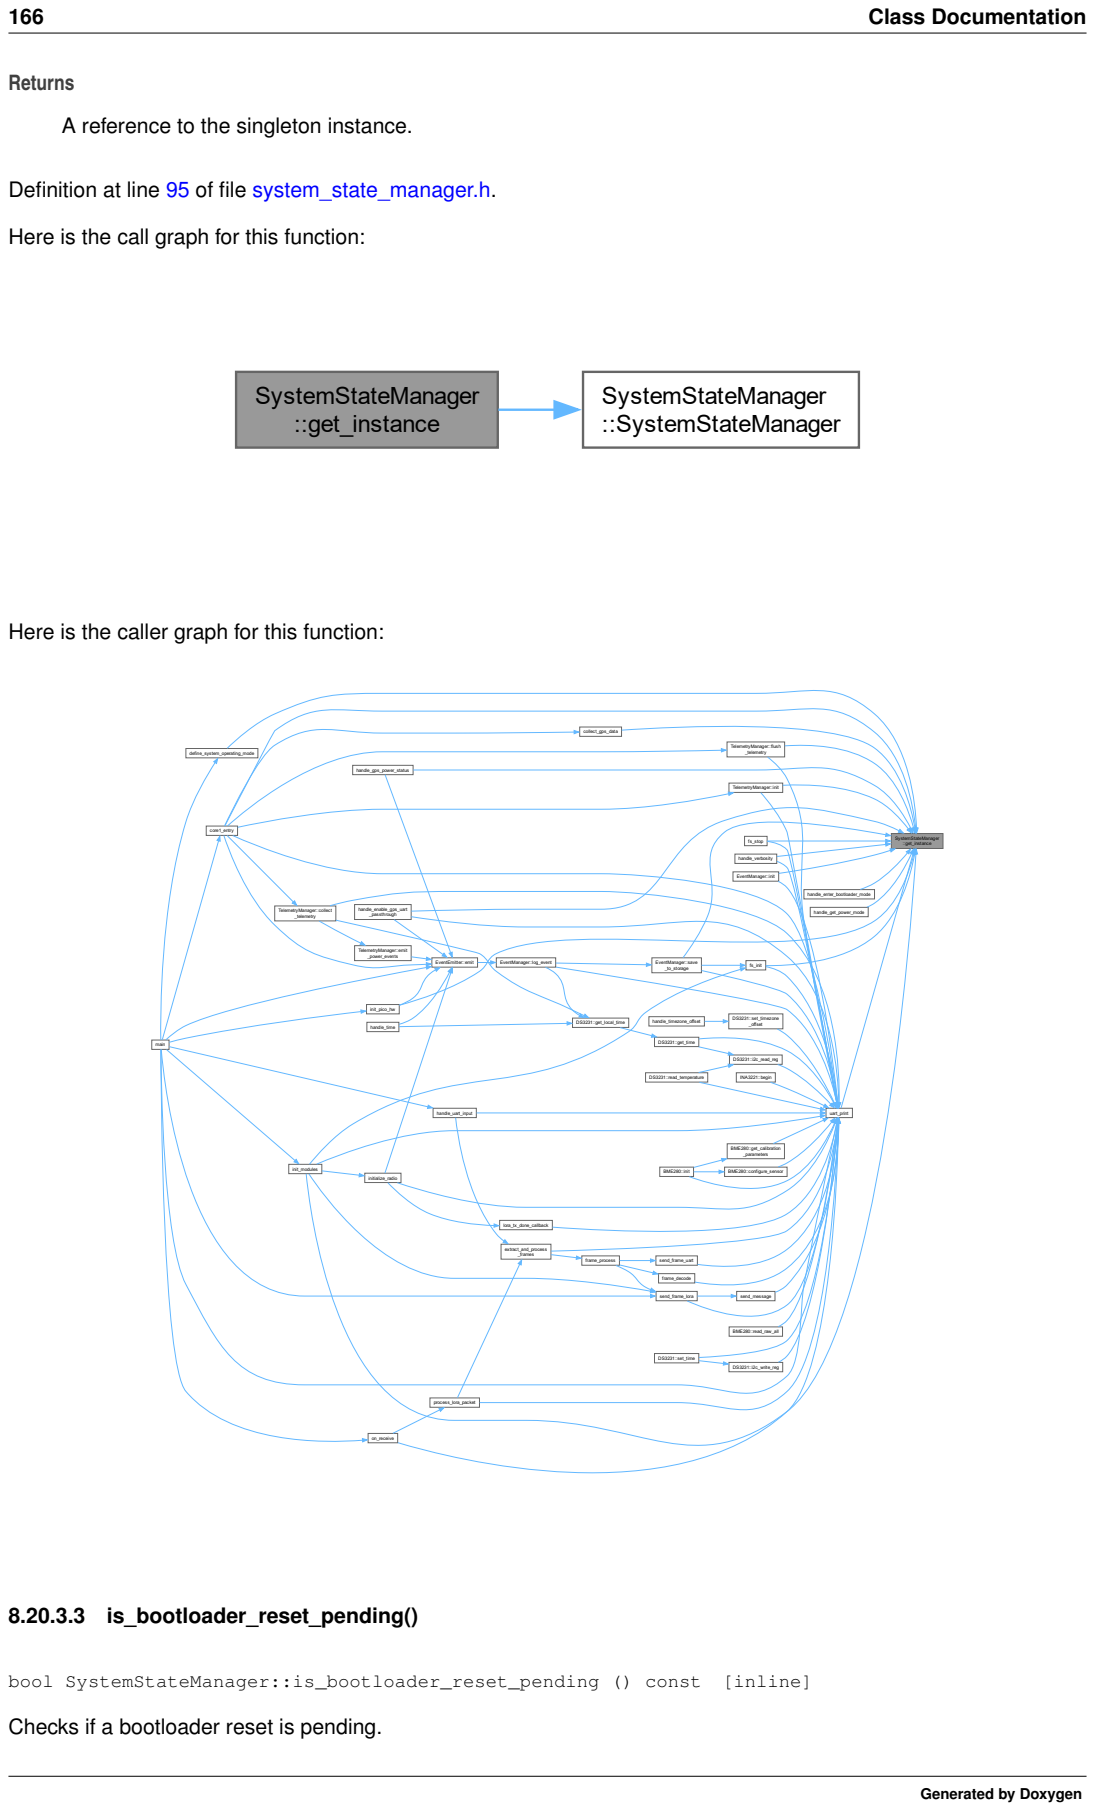
[picture p67: page 188]
166 Class Documentation; Returns; ::get_instance; ::SystemStateManager; SystemStateManager ::get_instance; collect_gps_data; core1_entry; define_system_operating_mode; TelemetryManager::flush _telemetry; fs_init; init_modules; EventManager::save _to_storage; handle_enable_gps_uart _passthrough; handle_gps_power_status; init_pico_hw; fs_stop; handle_enter_bootloader_mode; handle_get_power_mode; handle_verbosity; EventManager::init; TelemetryManager::init; uart_print; main; EventEmitter::emit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

A reference to the singleton instance.

Definition at line 95 of file system_state_manager.h.

Here is the call graph for this function:

Here is the caller graph for this function:

Checks if a bootloader reset is pending.

8.20 SystemStateManager Class Reference | 167

Returns

True if a bootloader reset is pending, false otherwise.

Definition at line 104 of file system_state_manager.h.

### 8.20.3.4 set_bootloader_reset_pending()

void SystemStateManager::set_bootloader_reset_pending (

bool pending) [inline]

Sets whether a bootloader reset is pending.

Parameters

in | pending | True if a bootloader reset is pending, false otherwise.

Definition at line 115 of file system_state_manager.h.

Here is the caller graph for this function:

SystemStateManager
::set_bootloader_reset
_pending

handle_enter_bootloader_mode

### 8.20.3.5 is_gps_collection_paused()

bool SystemStateManager::is_gps_collection_paused () const [inline]

Checks if GPS collection is paused.

Returns

True if GPS collection is paused, false otherwise.

Definition at line 125 of file system_state_manager.h.

### 8.20.3.6 set_gps_collection_paused()

void SystemStateManager::set_gps_collection_paused (

bool paused) [inline]

Sets whether GPS collection is paused.

168 Class Documentation

Parameters

in | paused | True if GPS collection is paused, false otherwise.

Definition at line 136 of file system_state_manager.h.

Here is the caller graph for this function:

### SystemStateManager ::set_gps_collection _paused

### handle_enable_gps_uart _passthrough

### 8.20.3.7 is_sd_card_mounted()

bool SystemStateManager::is_sd_card_mounted () const [inline]

Checks if the SD card is mounted.

Returns

True if the SD card is mounted, false otherwise.

Definition at line 146 of file system_state_manager.h.

### 8.20.3.8 set_sd_card_mounted()

void SystemStateManager::set_sd_card_mounted (

bool mounted) [inline]

Sets whether the SD card is mounted.

Parameters

in | mounted | True if the SD card is mounted, false otherwise.

Definition at line 157 of file system_state_manager.h.

8.20 SystemStateManager Class Reference | 169

Here is the caller graph for this function:

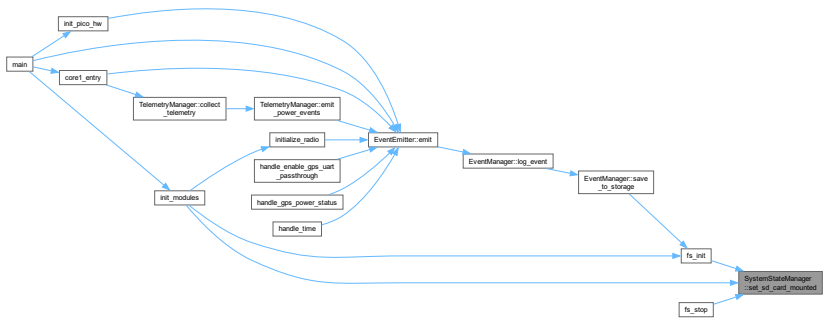
[picture p68: figure]
SystemStateManager ::set_sd_card_mounted; fs_init; init_modules; fs_stop; EventManager::save _to_storage; main; EventManager::log_event; EventEmitter::emit; core1_entry; TelemetryManager::emit _power_events; handle_enable_gps_uart _passthrough; handle_gps_power_status; handle_time; init_pico_hw; initialize_radio; TelemetryManager::collect _telemetry

### 8.20.3.9 get_uart_verbosity()

VerbosityLevel SystemStateManager::get_uart_verbosity () const [inline]

Gets the UART verbosity level.

Returns

The UART verbosity level.

Definition at line 167 of file system_state_manager.h.

Here is the caller graph for this function:

### SystemStateManager ::get_uart_verbosity handle_verbosity

### 8.20.3.10 set_uart_verbosity()

void SystemStateManager::set_uart_verbosity (

VerbosityLevel level) [inline]

Sets the UART verbosity level.

Parameters

in | level | The UART verbosity level.

170 Class Documentation

Definition at line 178 of file system_state_manager.h.

Here is the caller graph for this function:

### SystemStateManager ::set_uart_verbosity handle_verbosity

### 8.20.3.11 is_radio_init_ok()

bool SystemStateManager::is_radio_init_ok () const [inline]

Checks if the radio initialization was successful.

Returns

True if the radio initialization was successful, false otherwise.

Definition at line 188 of file system_state_manager.h.

### 8.20.3.12 set_radio_init_ok()

void SystemStateManager::set_radio_init_ok (

bool status) [inline]

Sets whether the radio initialization was successful.

Parameters

in | status | True if the radio initialization was successful, false otherwise.

Definition at line 199 of file system_state_manager.h.

Here is the caller graph for this function:

### SystemStateManager

::set_radio_init_ok main | init_modules

8.20 SystemStateManager Class Reference | 171

### 8.20.3.13 is_light_sensor_init_ok()

bool SystemStateManager::is_light_sensor_init_ok () const [inline]

Checks if the light sensor initialization was successful.

Returns

True if the light sensor initialization was successful, false otherwise.

Definition at line 209 of file system_state_manager.h.

### 8.20.3.14 set_light_sensor_init_ok()

void SystemStateManager::set_light_sensor_init_ok (

bool status) [inline]

Sets whether the light sensor initialization was successful.

Parameters

in | status | True if the light sensor initialization was successful, false otherwise.

Definition at line 220 of file system_state_manager.h.

Here is the caller graph for this function:

SystemStateManager
::set_light_sensor_init_ok main | init_modules

### 8.20.3.15 is_env_sensor_init_ok()

bool SystemStateManager::is_env_sensor_init_ok () const [inline]

Checks if the environment sensor initialization was successful.

Returns

True if the environment sensor initialization was successful, false otherwise.

Definition at line 230 of file system_state_manager.h.

### 8.20.3.16 set_env_sensor_init_ok()

void SystemStateManager::set_env_sensor_init_ok (

bool status) [inline]

Sets whether the environment sensor initialization was successful.

172 Class Documentation

Parameters

in | status | True if the environment sensor initialization was successful, false otherwise.

Definition at line 241 of file system_state_manager.h.

Here is the caller graph for this function:

SystemStateManager
::set_env_sensor_init_ok main | init_modules

### 8.20.3.17 get_operating_mode()

SystemOperatingMode SystemStateManager::get_operating_mode () const [inline]

Gets the system operating mode.

Returns

The system operating mode.

Definition at line 251 of file system_state_manager.h.

Here is the caller graph for this function:

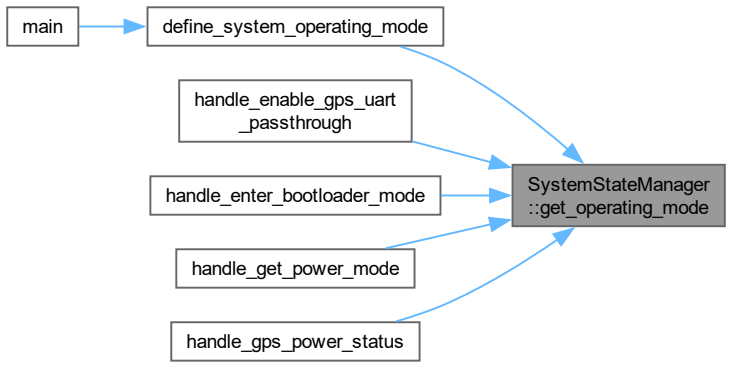
[picture p69: figure]
SystemStateManager ::get_operating_mode; define_system_operating_mode; handle_enable_gps_uart _passthrough; handle_enter_bootloader_mode; handle_get_power_mode; handle_gps_power_status; main

### 8.20.3.18 set_operating_mode()

void SystemStateManager::set_operating_mode (

SystemOperatingMode mode) [inline]

Sets the system operating mode.

8.20 SystemStateManager Class Reference | 173

Parameters

in | mode | The system operating mode.

Definition at line 262 of file system_state_manager.h.

Here is the caller graph for this function:

SystemStateManager
::set_operating_mode main | define_system_operating_mode

### 8.20.4 Member Data Documentation

### 8.20.4.1 pending_bootloader_reset

bool SystemStateManager::pending_bootloader_reset [private]

Flag indicating whether a bootloader reset is pending.

Definition at line 43 of file system_state_manager.h.

### 8.20.4.2 gps_collection_paused

bool SystemStateManager::gps_collection_paused [private]

Flag indicating whether GPS collection is paused.

Definition at line 45 of file system_state_manager.h.

### 8.20.4.3 sd_card_mounted

bool SystemStateManager::sd_card_mounted [private]

Flag indicating whether the SD card is mounted.

Definition at line 47 of file system_state_manager.h.

### 8.20.4.4 uart_verbosity

VerbosityLevel SystemStateManager::uart_verbosity [private]

The UART verbosity level.

Definition at line 49 of file system_state_manager.h.

174 Class Documentation

### 8.20.4.5 sd_card_init_status

bool SystemStateManager::sd_card_init_status [private]

Flag indicating whether the SD card initialization was successful.

Definition at line 51 of file system_state_manager.h.

### 8.20.4.6 radio_init_status

bool SystemStateManager::radio_init_status [private]

Flag indicating whether the radio initialization was successful.

Definition at line 53 of file system_state_manager.h.

### 8.20.4.7 light_sensor_init_status

bool SystemStateManager::light_sensor_init_status [private]

Flag indicating whether the light sensor initialization was successful.

Definition at line 55 of file system_state_manager.h.

### 8.20.4.8 env_sensor_init_status

bool SystemStateManager::env_sensor_init_status [private]

Flag indicating whether the environment sensor initialization was successful.

Definition at line 57 of file system_state_manager.h.

### 8.20.4.9 system_operating_mode

SystemOperatingMode SystemStateManager::system_operating_mode [private]

The system operating mode.

Definition at line 59 of file system_state_manager.h.

### 8.20.4.10 mutex_

recursive_mutex_t SystemStateManager::mutex_ [private]

Mutex for thread-safe access to the system state.

Definition at line 61 of file system_state_manager.h.

The documentation for this class was generated from the following file:

- lib/system_state_manager.h

8.21 TelemetryManager Class Reference | 175

## 8.21 TelemetryManager Class Reference

Manages the collection, storage, and retrieval of telemetry data.

#include <telemetry_manager.h>

Collaboration diagram for TelemetryManager:

### TelemetryManager

### TelemetryRecord

### last_telemetry_record_copy

### SensorDataRecord

### last_sensor_record_copy

Public Member Functions

- bool init ()

Initialize the telemetry system.
- bool collect_telemetry ()

Collect telemetry data from sensors and power subsystems.
- void collect_power_telemetry (TelemetryRecord &record)

Collects power subsystem telemetry data.
- void emit_power_events (float battery_voltage, float charge_current_usb, float charge_current_solar, float discharge_current)

Emits power-related events based on current and voltage levels.
- void collect_gps_telemetry (TelemetryRecord &record)

Collects GPS telemetry data.
- void collect_sensor_telemetry (SensorDataRecord &sensor_record)

Collects sensor telemetry data.
- bool flush_telemetry ()

Save buffered telemetry data to storage.
- bool flush_sensor_data ()

Save buffered sensor data to storage.
- bool is_telemetry_collection_time (uint32_t current_time, uint32_t &last_collection_time)

Check if it's time to collect telemetry based on interval.
- bool is_telemetry_flush_time (uint32_t &collection_counter)

Check if it's time to flush telemetry buffer based on count.
- std::string get_last_telemetry_record_csv ()

Gets the last telemetry record as a CSV string.
- std::string get_last_sensor_record_csv ()

Gets the last sensor data record as a CSV string.
- size_t get_telemetry_buffer_count () const
- size_t get_telemetry_buffer_write_index () const

176 Class Documentation

Static Public Member Functions

- static TelemetryManager & get_instance ()

Gets the singleton instance of the TelemetryManager class.

Static Public Attributes

- static constexpr int TELEMETRY_BUFFER_SIZE = 20

Private Member Functions

- TelemetryManager ()
- ∼TelemetryManager ()=default

Private Attributes

- uint32_t sample_interval_ms = DEFAULT_SAMPLE_INTERVAL_MS
- uint32_t flush_threshold = DEFAULT_FLUSH_THRESHOLD

Current flush threshold (number of records that triggers a flush)
- std::array< TelemetryRecord, TELEMETRY_BUFFER_SIZE > telemetry_buffer

Circular buffer for telemetry records.
- size_t telemetry_buffer_count = 0
- size_t telemetry_buffer_write_index = 0
- std::array< SensorDataRecord, TELEMETRY_BUFFER_SIZE > sensor_data_buffer

Circular buffer for sensor data records.
- TelemetryRecord last_telemetry_record_copy

Last record copies for retrieval.
- SensorDataRecord last_sensor_record_copy
- mutex_t telemetry_mutex

Mutex for thread-safe access to the telemetry buffer.

Static Private Attributes

- static constexpr uint32_t DEFAULT_SAMPLE_INTERVAL_MS = 1000

Current sampling interval in milliseconds.
- static constexpr uint32_t DEFAULT_FLUSH_THRESHOLD = 10

Default number of records to collect before flushing to storage.

### 8.21.1 Detailed Description

Manages the collection, storage, and retrieval of telemetry data.

This class implements a singleton pattern to provide a single point of access for managing telemetry data. It handles the collection of data from various subsystems, stores the data in circular buffers, and provides methods for flushing the data to persistent storage and retrieving the last recorded data.

Definition at line 146 of file telemetry_manager.h.

8.21 TelemetryManager Class Reference | 177

### 8.21.2 Constructor & Destructor Documentation

8.21.2.1 ∼TelemetryManager()

TelemetryManager::∼TelemetryManager () [private], [default]

### 8.21.3 Member Function Documentation

### 8.21.3.1 get_instance()

static TelemetryManager & TelemetryManager::get_instance () [inline], [static]

Gets the singleton instance of the TelemetryManager class.

Returns

A reference to the singleton instance.

Definition at line 152 of file telemetry_manager.h.

Here is the call graph for this function:

### TelemetryManager::get _instance

### TelemetryManager::Telemetry Manager

Here is the caller graph for this function:

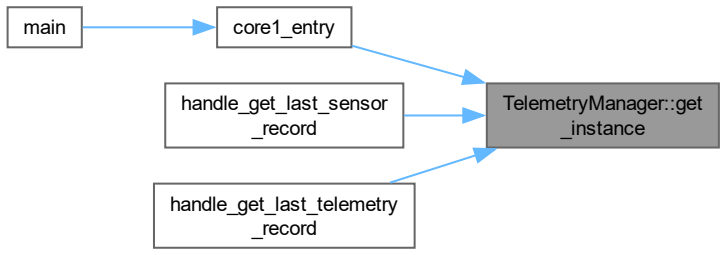
[picture p70: figure]
TelemetryManager::get _instance; core1_entry; handle_get_last_sensor _record; handle_get_last_telemetry _record; main

178 Class Documentation

### 8.21.3.2 flush_sensor_data()

bool TelemetryManager::flush_sensor_data ()

Save buffered sensor data to storage.

Returns

True if data was successfully saved

Writes all records from the sensor data buffer to the CSV file and clears the buffer after successful writing

### 8.21.3.3 get_telemetry_buffer_count()

size_t TelemetryManager::get_telemetry_buffer_count () const [inline]

Definition at line 252 of file telemetry_manager.h.

### 8.21.3.4 get_telemetry_buffer_write_index()

size_t TelemetryManager::get_telemetry_buffer_write_index () const [inline]

Definition at line 253 of file telemetry_manager.h.

### 8.21.4 Member Data Documentation

### 8.21.4.1 TELEMETRY_BUFFER_SIZE

int TelemetryManager::TELEMETRY_BUFFER_SIZE = 20 [static], [constexpr]

Definition at line 250 of file telemetry_manager.h.

### 8.21.4.2 DEFAULT_SAMPLE_INTERVAL_MS

uint32_t TelemetryManager::DEFAULT_SAMPLE_INTERVAL_MS = 1000 [static], [constexpr], [private]

Current sampling interval in milliseconds.

Definition at line 262 of file telemetry_manager.h.

### 8.21.4.3 DEFAULT_FLUSH_THRESHOLD

uint32_t TelemetryManager::DEFAULT_FLUSH_THRESHOLD = 10 [static], [constexpr], [private]

Default number of records to collect before flushing to storage.

Definition at line 267 of file telemetry_manager.h.

8.21 TelemetryManager Class Reference | 179

### 8.21.4.4 sample_interval_ms

uint32_t TelemetryManager::sample_interval_ms = DEFAULT_SAMPLE_INTERVAL_MS [private]

Definition at line 269 of file telemetry_manager.h.

### 8.21.4.5 flush_threshold

uint32_t TelemetryManager::flush_threshold = DEFAULT_FLUSH_THRESHOLD [private]

Current flush threshold (number of records that triggers a flush)

Definition at line 274 of file telemetry_manager.h.

### 8.21.4.6 telemetry_buffer

std::array<TelemetryRecord, TELEMETRY_BUFFER_SIZE> TelemetryManager::telemetry_buffer [private]

Circular buffer for telemetry records.

Definition at line 278 of file telemetry_manager.h.

### 8.21.4.7 telemetry_buffer_count

size_t TelemetryManager::telemetry_buffer_count = 0 [private]

Definition at line 279 of file telemetry_manager.h.

### 8.21.4.8 telemetry_buffer_write_index

size_t TelemetryManager::telemetry_buffer_write_index = 0 [private]

Definition at line 280 of file telemetry_manager.h.

### 8.21.4.9 sensor_data_buffer

std::array<SensorDataRecord, TELEMETRY_BUFFER_SIZE> TelemetryManager::sensor_data_buffer

[private]

Circular buffer for sensor data records.

Definition at line 285 of file telemetry_manager.h.

### 8.21.4.10 last_telemetry_record_copy

TelemetryRecord TelemetryManager::last_telemetry_record_copy [private]

Last record copies for retrieval.

Definition at line 290 of file telemetry_manager.h.

180 Class Documentation

### 8.21.4.11 last_sensor_record_copy

SensorDataRecord TelemetryManager::last_sensor_record_copy [private]

Definition at line 291 of file telemetry_manager.h.

### 8.21.4.12 telemetry_mutex

mutex_t TelemetryManager::telemetry_mutex [private]

Mutex for thread-safe access to the telemetry buffer.

Definition at line 296 of file telemetry_manager.h.

The documentation for this class was generated from the following files:

- lib/telemetry/telemetry_manager.h
- lib/telemetry/telemetry_manager.cpp

## 8.22 TelemetryRecord Struct Reference

Structure representing a single telemetry data point.

#include <telemetry_manager.h>

Public Member Functions

- std::string to_csv () const

Converts the telemetry record to a CSV string.

Public Attributes

- uint32_t timestamp
- std::string build_version
- float battery_voltage
- float system_voltage
- float charge_current_usb
- float charge_current_solar
- float discharge_current
- std::string time
- std::string latitude
- std::string lat_dir
- std::string longitude
- std::string lon_dir
- std::string speed
- std::string course
- std::string date
- std::string fix_quality
- std::string satellites
- std::string altitude

8.22 TelemetryRecord Struct Reference | 181

### 8.22.1 Detailed Description

Structure representing a single telemetry data point.

Contains all measurements from power subsystem, sensors, and GPS data collected at a specific point in time

Definition at line 44 of file telemetry_manager.h.

### 8.22.2 Member Data Documentation

### 8.22.2.1 timestamp

uint32_t TelemetryRecord::timestamp

Unix timestamp of the record

Definition at line 45 of file telemetry_manager.h.

### 8.22.2.2 build_version

std::string TelemetryRecord::build_version

Build version of the firmware

Definition at line 47 of file telemetry_manager.h.

### 8.22.2.3 battery_voltage

float TelemetryRecord::battery_voltage

Battery voltage in volts

Definition at line 50 of file telemetry_manager.h.

### 8.22.2.4 system_voltage

float TelemetryRecord::system_voltage

System 5V rail voltage in volts

Definition at line 51 of file telemetry_manager.h.

### 8.22.2.5 charge_current_usb

float TelemetryRecord::charge_current_usb

USB charging current in mA

Definition at line 52 of file telemetry_manager.h.

182 Class Documentation

### 8.22.2.6 charge_current_solar

float TelemetryRecord::charge_current_solar

Solar charging current in mA

Definition at line 53 of file telemetry_manager.h.

### 8.22.2.7 discharge_current

float TelemetryRecord::discharge_current

Battery discharge current in mA

Definition at line 54 of file telemetry_manager.h.

### 8.22.2.8 time

std::string TelemetryRecord::time

UTC time from GPS

Definition at line 57 of file telemetry_manager.h.

### 8.22.2.9 latitude

std::string TelemetryRecord::latitude

Latitude from GPS

Definition at line 58 of file telemetry_manager.h.

### 8.22.2.10 lat_dir

std::string TelemetryRecord::lat_dir

N/S latitude direction

Definition at line 59 of file telemetry_manager.h.

### 8.22.2.11 longitude

std::string TelemetryRecord::longitude

Longitude from GPS

Definition at line 60 of file telemetry_manager.h.

8.22 TelemetryRecord Struct Reference | 183

### 8.22.2.12 lon_dir

std::string TelemetryRecord::lon_dir

E/W longitude direction

Definition at line 61 of file telemetry_manager.h.

### 8.22.2.13 speed

std::string TelemetryRecord::speed

Speed in knots

Definition at line 62 of file telemetry_manager.h.

### 8.22.2.14 course

std::string TelemetryRecord::course

Course in degrees

Definition at line 63 of file telemetry_manager.h.

### 8.22.2.15 date

std::string TelemetryRecord::date

Date from GPS

Definition at line 64 of file telemetry_manager.h.

### 8.22.2.16 fix_quality

std::string TelemetryRecord::fix_quality

GPS fix quality

Definition at line 67 of file telemetry_manager.h.

### 8.22.2.17 satellites

std::string TelemetryRecord::satellites

Number of satellites in view

Definition at line 68 of file telemetry_manager.h.

### 8.22.2.18 altitude

std::string TelemetryRecord::altitude

Altitude in meters

Definition at line 69 of file telemetry_manager.h.

The documentation for this struct was generated from the following file:

- lib/telemetry/telemetry_manager.h

184 Class Documentation

# Chapter 9

# File Documentation

## 9.1 build_number.h File Reference

This graph shows which files directly or indirectly include this file:

Macros

- #define BUILD_NUMBER 541

### 9.1.1 Macro Definition Documentation

### 9.1.1.1 BUILD_NUMBER

#define BUILD_NUMBER 541

Definition at line 6 of file build_number.h.

## 9.2 build_number.h

Go to the documentation of this file.

00001 //This file is automatically generated by build_number.cmake 00002
00003 #ifndef CMAKE_BUILD_NUMBER_HEADER
00004 #define CMAKE_BUILD_NUMBER_HEADER
00005
00006 #define BUILD_NUMBER 541
00007
00008 #endif

## 9.3 credits.md File Reference

## 9.4 includes.h File Reference

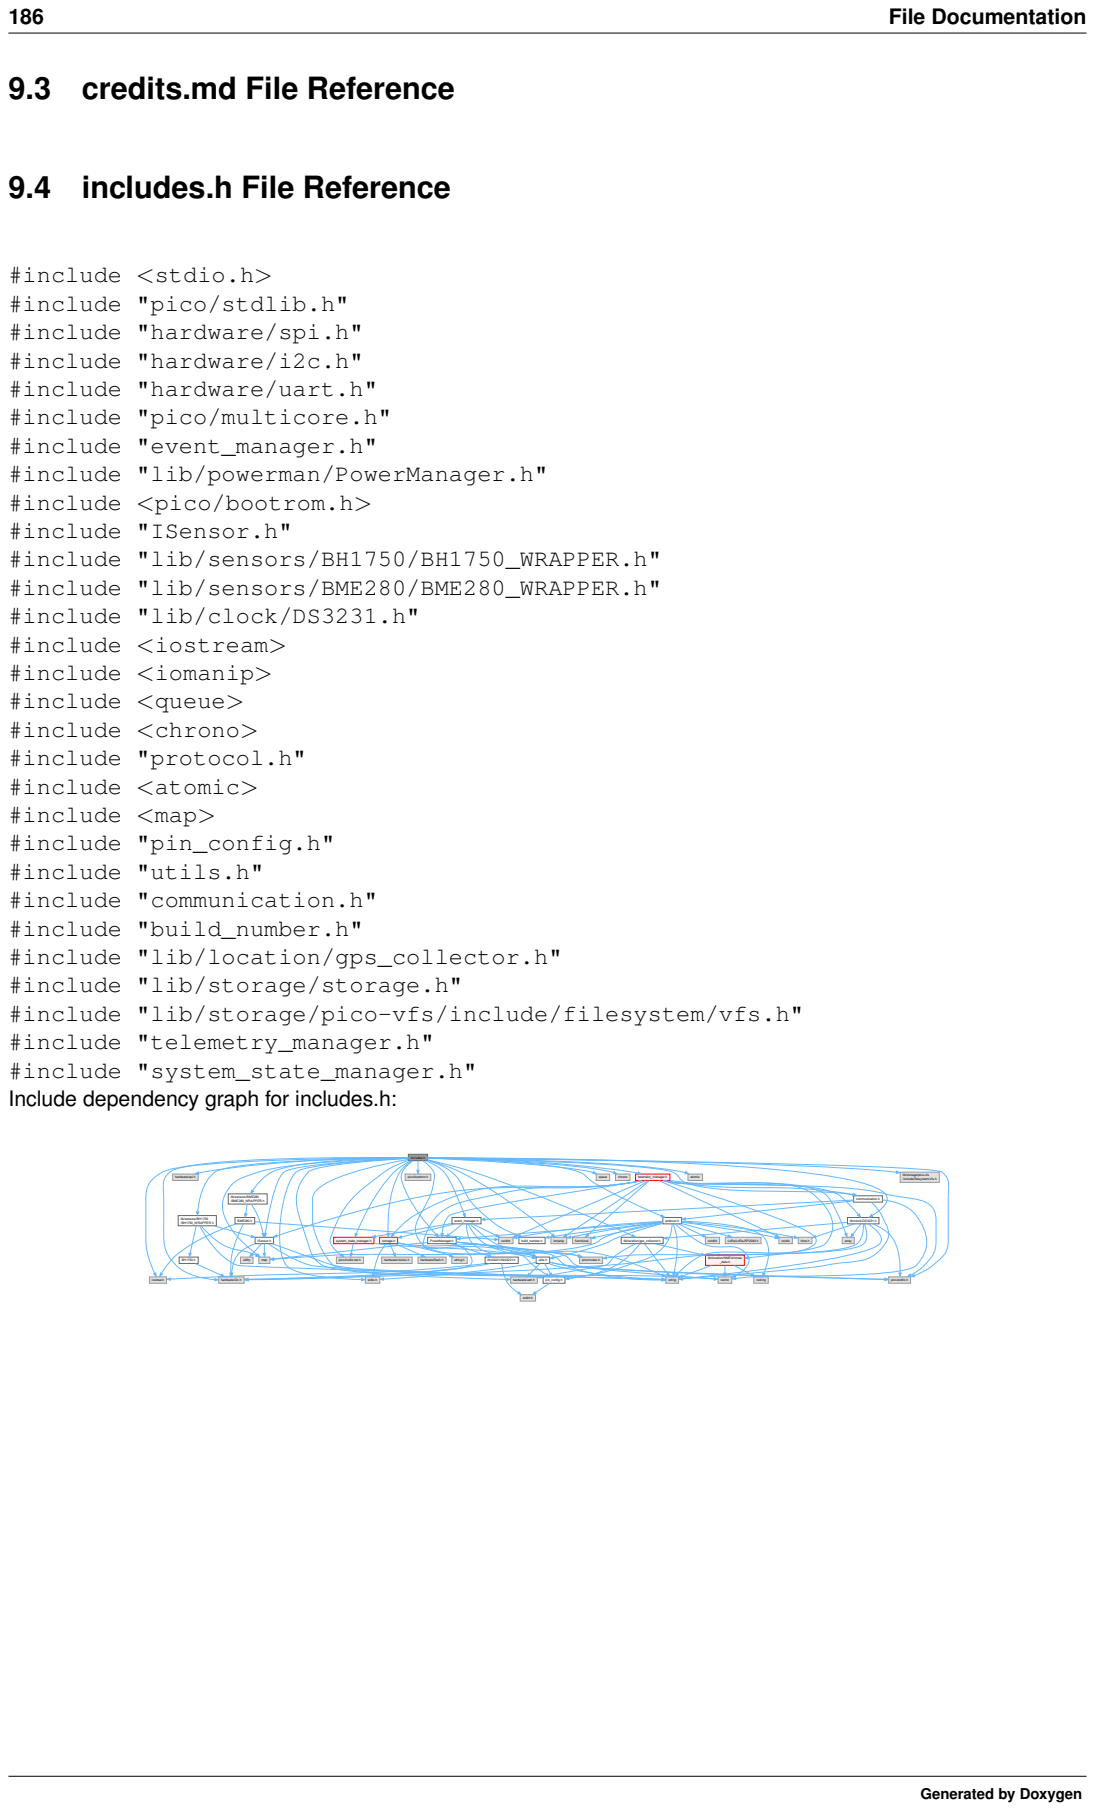
[picture p71: page 208]
186 File Documentation; includes.h; stdio.h; pico/stdlib.h; hardware/spi.h; hardware/i2c.h; hardware/uart.h; pico/multicore.h; event_manager.h; PowerManager.h; iostream; map; storage.h; pin_config.h; utils.h; system_state_manager.h; pico/bootrom.h; ISensor.h; lib/sensors/BH1750 /BH1750_WRAPPER.h; lib/sensors/BME280 /BME280_WRAPPER.h; lib/clock/DS3231.h; iomanip; lib/location/gps_collector.h; queue; chrono; protocol.h; build_number.h; atomic; communication.h; string; pico/mutex.h; cstdint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

#include <stdio.h>
#include "pico/stdlib.h"
#include "hardware/spi.h"
#include "hardware/i2c.h"
#include "hardware/uart.h"
#include "pico/multicore.h"
#include "event_manager.h"
#include "lib/powerman/PowerManager.h"
#include <pico/bootrom.h>
#include "ISensor.h"
#include "lib/sensors/BH1750/BH1750_WRAPPER.h"
#include "lib/sensors/BME280/BME280_WRAPPER.h"
#include "lib/clock/DS3231.h"
#include <iostream>
#include <iomanip>
#include <queue>
#include <chrono>
#include "protocol.h"
#include <atomic>
#include <map>
#include "pin_config.h"
#include "utils.h"
#include "communication.h"
#include "build_number.h"
#include "lib/location/gps_collector.h"
#include "lib/storage/storage.h"
#include "lib/storage/pico-vfs/include/filesystem/vfs.h"
#include "telemetry_manager.h"
#include "system_state_manager.h"
Include dependency graph for includes.h:

/include/filesystem/vfs.h telemetry_manager.h

lib/storage/pico-vfs

lib/location/NMEA/nmea

9.5 includes.h | 187

This graph shows which files directly or indirectly include this file:

### includes.h

### main.cpp

## 9.5 includes.h

Go to the documentation of this file.

00001 #ifndef INCLUDES_H
00002 #define INCLUDES_H
00003
00004 #include <stdio.h>
00005 #include "pico/stdlib.h" 00006 #include "hardware/spi.h" 00007 #include "hardware/i2c.h" 00008 #include "hardware/uart.h"
00009 #include "pico/multicore.h"
00010 #include "event_manager.h"
00011 #include "lib/powerman/PowerManager.h" 00012 #include <pico/bootrom.h>
00013
00014 #include "ISensor.h"
00015 #include "lib/sensors/BH1750/BH1750_WRAPPER.h" 00016 #include "lib/sensors/BME280/BME280_WRAPPER.h" 00017 #include "lib/clock/DS3231.h"
00018 #include <iostream>
00019 #include <iomanip>
00020 #include <queue>
00021 #include <chrono>
00022 #include "protocol.h" 00023 #include <atomic>
00024 #include <iostream>
00025 #include <map>
00026 #include "pin_config.h" 00027 #include "utils.h"
00028 #include "communication.h"
00029 #include "build_number.h"
00030 #include "lib/location/gps_collector.h"
00031 #include "lib/storage/storage.h"
00032 #include "lib/storage/pico-vfs/include/filesystem/vfs.h" 00033 #include "telemetry_manager.h"
00034 #include "system_state_manager.h"
00035
00036 #endif

## 9.6 lib/clock/DS3231.cpp File Reference

#include "DS3231.h"

#include "utils.h"

#include <cstdio>

#include <mutex>

#include "event_manager.h"

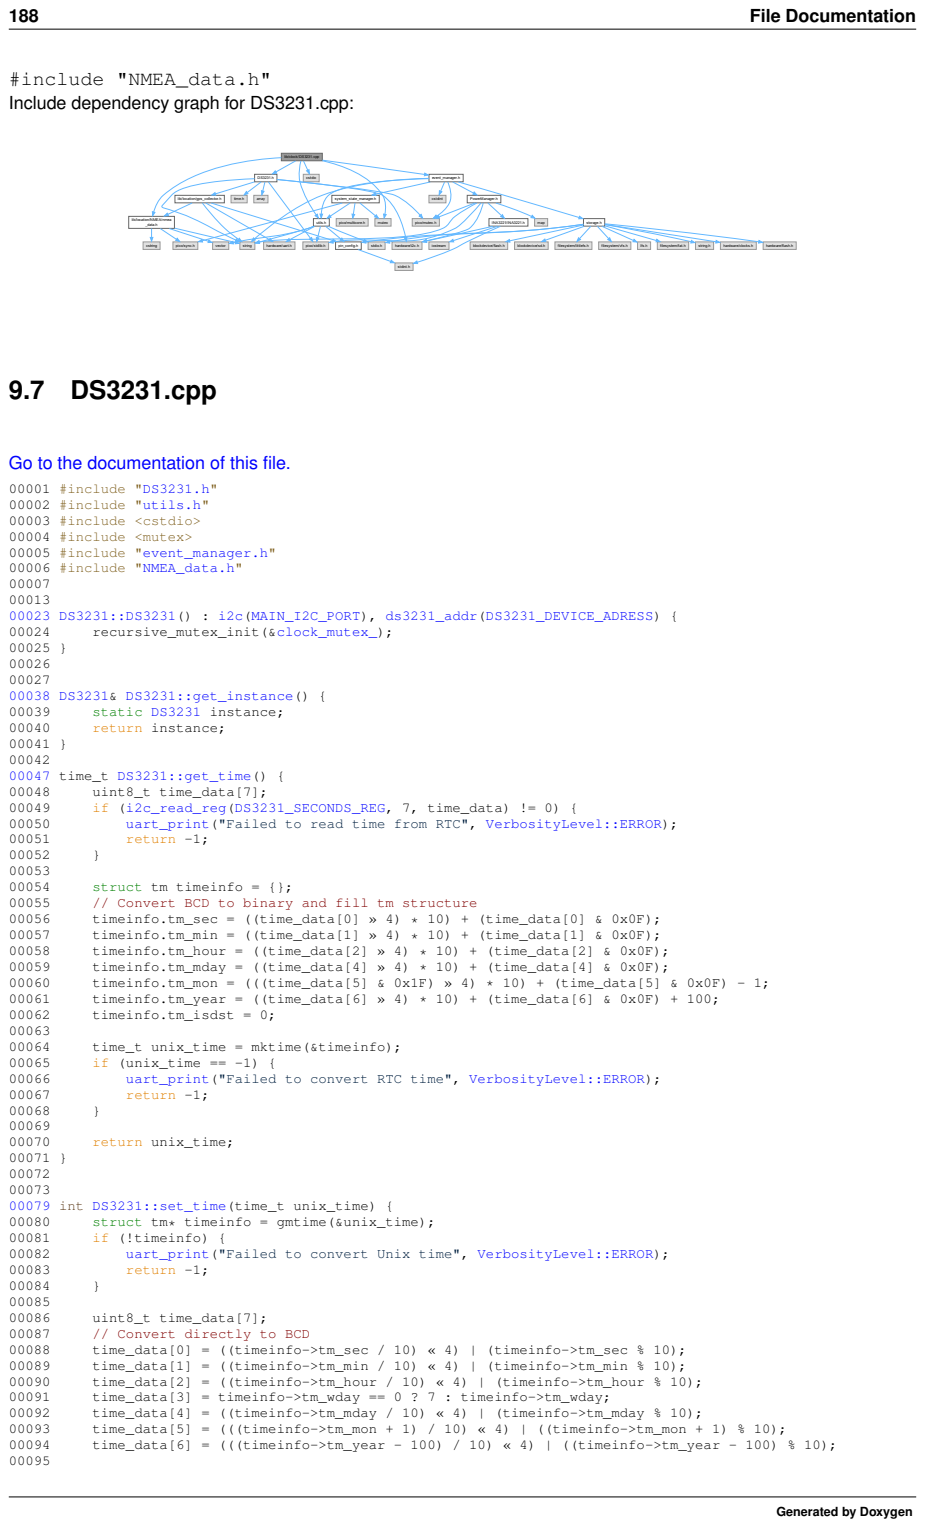
[picture p72: page 210]
188 File Documentation; _data.h; utils.h; cstdio; mutex; event_manager.h; string; array; pico/stdlib.h; hardware/i2c.h; time.h; pico/mutex.h; lib/location/gps_collector.h; cstring; pico/sync.h; vector; hardware/uart.h; pin_config.h; stdint.h; stdio.h; cstdint; PowerManager.h; storage.h; system_state_manager.h; INA3221/INA3221.h; map; iostream; blockdevice/flash.h; blockdevice/sd.h; filesystem/littlefs.h; filesystem/vfs.h; lfs.h; filesystem/fat.h; string.h; hardware/clocks.h; hardware/flash.h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

#include "NMEA_data.h"
Include dependency graph for DS3231.cpp:

lib/clock/DS3231.cpp

lib/location/NMEA/nmea

Go to the documentation of this file.

9.7 DS3231.cpp | 189
00096 | if (i2c_write_reg(DS3231_SECONDS_REG, 7, time_data) != 0) {
00097 | uart_print("Failed to write time to RTC", VerbosityLevel::ERROR);
00098
00099 | return -1;
00100 | }
00101
00102 | return 0;
00103 }
00104
00105
00118 int DS3231::read_temperature(float *resolution) {
00119 | std::string status;
00120 | uint8_t temp[2];
00121 | int result = i2c_read_reg(DS3231_TEMPERATURE_MSB_REG, 2, temp);
00122 | if (result != 0) {
00123 | status = "Failed to read temperature from DS3231";
00124 | uart_print(status, VerbosityLevel::ERROR);
00125 | return -1;
00126 | }
00127
00128 | int8_t temperature_msb = (int8_t)temp[0];
00129 | uint8_t temperature_lsb = temp[1] » 6; | // Only the 2 MSB are valid
00130
00131 | *resolution = temperature_msb + (temperature_lsb * 0.25f); // 0.25 degree resolution
00132
00133 | return 0;
00134 }
00135
00136
00146 int16_t DS3231::get_timezone_offset() const {
00147 | return timezone_offset_minutes_;
00148 }
00149
00150
00162 void DS3231::set_timezone_offset(int16_t offset_minutes) {
00163 | // Validate range: -12 hours to +12 hours (-720 to +720 minutes)
00164 | if (offset_minutes >= -720 && offset_minutes <= 720) {
00165 | timezone_offset_minutes_ = offset_minutes;
00166 | } else {
00167 | uart_print("Error: Invalid timezone offset", VerbosityLevel::ERROR);
00168 | }
00169 }
00170
00179 time_t DS3231::get_local_time() {
00180 | time_t utc_time = get_time();
00181 | if (utc_time == -1) {
00182 | return -1;
00183 | }
00184
00185 | return utc_time + (timezone_offset_minutes_ * 60);
00186 }
00187
00188
00189 // ==================== private methods
00190
00206 int DS3231::i2c_read_reg(uint8_t reg_addr, size_t length, uint8_t *data) {
00207 | if (!length)
00208 | return -1;
00209 | std::string status;
00210
00211 | recursive_mutex_enter_blocking(&clock_mutex_);
00212 | uint8_t reg = reg_addr;
00213 | int write_result = i2c_write_blocking(i2c, ds3231_addr, &reg, 1, true);
00214 | if (write_result == PICO_ERROR_GENERIC) {
00215 | status = "Failed to write register address to DS3231";
00216 | uart_print(status, VerbosityLevel::ERROR);
00217 | recursive_mutex_exit(&clock_mutex_);
00218 | return -1;
00219 | }
00220 | int read_result = i2c_read_blocking(i2c, ds3231_addr, data, length, false);
00221 | if (read_result == PICO_ERROR_GENERIC) {
00222 | status = "Failed to read register data from DS3231";
00223 | uart_print(status, VerbosityLevel::ERROR);
00224 | recursive_mutex_exit(&clock_mutex_);
00225 | return -1;
00226 | }
00227 | recursive_mutex_exit(&clock_mutex_);
00228
00229 | return 0;
00230 }
00231
00247 int DS3231::i2c_write_reg(uint8_t reg_addr, size_t length, uint8_t *data) {
00248 | if (!length)
00249 | return -1;
00250
00251 | recursive_mutex_enter_blocking(&clock_mutex_);
00252 | std::vector<uint8_t> message(length + 1);

190 File Documentation

00253 | message[0] = reg_addr;
00254 | for (size_t i = 0; i < length; i++) {
00255 | message[i + 1] = data[i];
00256 | }
00257 | int write_result = i2c_write_blocking(i2c, ds3231_addr, message.data(), (length + 1), false);
00258 | if (write_result == PICO_ERROR_GENERIC) {
00259 | uart_print("Error: i2c_write_blocking failed in i2c_write_reg", VerbosityLevel::ERROR);
00260 | recursive_mutex_exit(&clock_mutex_);
00261 | return -1;
00262 | }
00263 | recursive_mutex_exit(&clock_mutex_);
00264
00265 | return 0;
00266 } // End of DS3231_RTC group

## 9.8 lib/clock/DS3231.h File Reference

#include <string>

#include <array>

#include "pico/stdlib.h"

#include "hardware/i2c.h"

#include <time.h>

#include "pico/mutex.h"

#include "lib/location/gps_collector.h" Include dependency graph for DS3231.h:

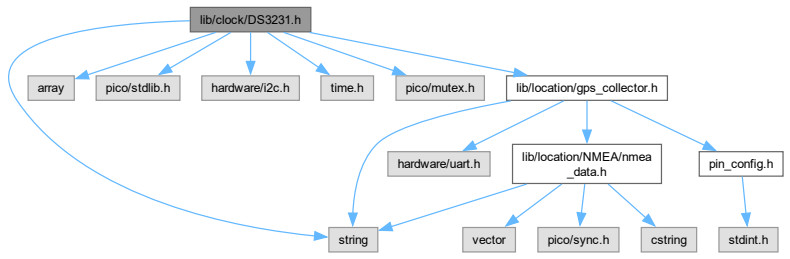
[picture p73: figure]
lib/clock/DS3231.h; string; array; pico/stdlib.h; hardware/i2c.h; time.h; pico/mutex.h; lib/location/gps_collector.h; hardware/uart.h; lib/location/NMEA/nmea; _data.h; pin_config.h; vector; pico/sync.h; cstring; stdint.h

This graph shows which files directly or indirectly include this file:

Classes

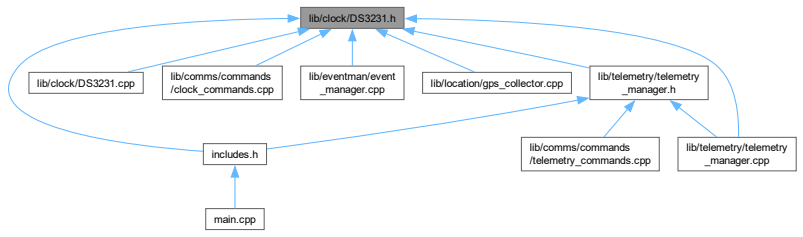
[picture p74: figure]
lib/clock/DS3231.h; includes.h; lib/clock/DS3231.cpp; lib/comms/commands; /clock_commands.cpp; lib/eventman/event; _manager.cpp; lib/location/gps_collector.cpp; lib/telemetry/telemetry _manager.cpp; lib/telemetry/telemetry _manager.h; main.cpp; lib/comms/commands /telemetry_commands.cpp

- struct ds3231_data_t

Structure to hold time and date information from DS3231.
- class DS3231

Class for interfacing with the DS3231 real-time clock.

9.8 lib/clock/DS3231.h File Reference | 191

Macros

- #define DS3231_DEVICE_ADRESS 0x68

DS3231 I2C device address.
- #define DS3231_SECONDS_REG 0x00

Register address: Seconds (0-59)
- #define DS3231_MINUTES_REG 0x01

Register address: Minutes (0-59)
- #define DS3231_HOURS_REG 0x02

Register address: Hours (0-23 in 24hr mode)
- #define DS3231_DAY_REG 0x03

Register address: Day of the week (1-7)
- #define DS3231_DATE_REG 0x04

Register address: Date (1-31)
- #define DS3231_MONTH_REG 0x05

Register address: Month (1-12) & Century bit.
- #define DS3231_YEAR_REG 0x06

Register address: Year (00-99)
- #define DS3231_CONTROL_REG 0x0E

Register address: Control register.
- #define DS3231_CONTROL_STATUS_REG 0x0F

Register address: Control/Status register.
- #define DS3231_TEMPERATURE_MSB_REG 0x11

Register address: Temperature register (MSB)
- #define DS3231_TEMPERATURE_LSB_REG 0x12

Register address: Temperature register (LSB)

Enumerations

- enum days_of_week {
MONDAY = 1 , TUESDAY , WEDNESDAY , THURSDAY , FRIDAY , SATURDAY , SUNDAY }

Enumeration of days of the week.

### 9.8.1 Macro Definition Documentation

### 9.8.1.1 DS3231_DEVICE_ADRESS

#define DS3231_DEVICE_ADRESS 0x68

DS3231 I2C device address.

Definition at line 15 of file DS3231.h.

### 9.8.1.2 DS3231_SECONDS_REG

#define DS3231_SECONDS_REG 0x00

Register address: Seconds (0-59)

Definition at line 20 of file DS3231.h.

192 File Documentation

### 9.8.1.3 DS3231_MINUTES_REG

#define DS3231_MINUTES_REG 0x01

Register address: Minutes (0-59)

Definition at line 25 of file DS3231.h.

### 9.8.1.4 DS3231_HOURS_REG

#define DS3231_HOURS_REG 0x02

Register address: Hours (0-23 in 24hr mode)

Definition at line 30 of file DS3231.h.

### 9.8.1.5 DS3231_DAY_REG

#define DS3231_DAY_REG 0x03

Register address: Day of the week (1-7)

Definition at line 35 of file DS3231.h.

### 9.8.1.6 DS3231_DATE_REG

#define DS3231_DATE_REG 0x04

Register address: Date (1-31)

Definition at line 40 of file DS3231.h.

### 9.8.1.7 DS3231_MONTH_REG

#define DS3231_MONTH_REG 0x05

Register address: Month (1-12) & Century bit.

Definition at line 45 of file DS3231.h.

### 9.8.1.8 DS3231_YEAR_REG

#define DS3231_YEAR_REG 0x06

Register address: Year (00-99)

Definition at line 50 of file DS3231.h.

9.8 lib/clock/DS3231.h File Reference | 193

### 9.8.1.9 DS3231_CONTROL_REG

#define DS3231_CONTROL_REG 0x0E

Register address: Control register.

Definition at line 55 of file DS3231.h.

### 9.8.1.10 DS3231_CONTROL_STATUS_REG

#define DS3231_CONTROL_STATUS_REG 0x0F

Register address: Control/Status register.

Definition at line 60 of file DS3231.h.

### 9.8.1.11 DS3231_TEMPERATURE_MSB_REG

#define DS3231_TEMPERATURE_MSB_REG 0x11

Register address: Temperature register (MSB)

Definition at line 65 of file DS3231.h.

### 9.8.1.12 DS3231_TEMPERATURE_LSB_REG

#define DS3231_TEMPERATURE_LSB_REG 0x12

Register address: Temperature register (LSB)

Definition at line 70 of file DS3231.h.

### 9.8.2 Enumeration Type Documentation

### 9.8.2.1 days_of_week

enum days_of_week

Enumeration of days of the week.

Enumerator

MONDAY | Monday.
TUESDAY | Tuesday.
WEDNESDAY | Wednesday.
THURSDAY | Thursday.
FRIDAY | Friday.
SATURDAY | Saturday.
SUNDAY | Sunday.

Definition at line 76 of file DS3231.h.

194 File Documentation

## 9.9 DS3231.h

Go to the documentation of this file.

00001 #ifndef DS3231_H
00002 #define DS3231_H
00003
00004 #include <string>
00005 #include <array>
00006 #include "pico/stdlib.h" 00007 #include "hardware/i2c.h"
00008 #include <time.h>
00009 #include "pico/mutex.h"
00010 #include "lib/location/gps_collector.h" 00011
00015 #define DS3231_DEVICE_ADRESS | 0x68
00016
00020 #define DS3231_SECONDS_REG | 0x00
00021
00025 #define DS3231_MINUTES_REG | 0x01
00026
00030 #define DS3231_HOURS_REG | 0x02
00031
00035 #define DS3231_DAY_REG | 0x03
00036
00040 #define DS3231_DATE_REG | 0x04
00041
00045 #define DS3231_MONTH_REG | 0x05
00046
00050 #define DS3231_YEAR_REG | 0x06
00051
00055 #define DS3231_CONTROL_REG | 0x0E
00056
00060 #define DS3231_CONTROL_STATUS_REG | 0x0F
00061
00065 #define DS3231_TEMPERATURE_MSB_REG | 0x11
00066
00070 #define DS3231_TEMPERATURE_LSB_REG | 0x12
00071
00076 enum days_of_week {
00077 | MONDAY | = 1,
00078 | TUESDAY,
00079 | WEDNESDAY,
00080 | THURSDAY,
00081 | FRIDAY,
00082 | SATURDAY,
00083 | SUNDAY
00084 };
00085
00090 typedef struct {
00091 | uint8_t seconds;
00092 | uint8_t minutes;
00093 | uint8_t hours;
00094 | uint8_t day;
00095 | uint8_t date;
00096 | uint8_t month;
00097 | uint8_t year;
00098 | bool century;
00099 } ds3231_data_t;
00100
00108 class DS3231 {
00109 public:
00115 | DS3231(i2c_inst_t *i2c_instance);
00121 | static DS3231& get_instance();
00122
00128 | int set_time(time_t unix_time);
00129
00134 | time_t get_time();
00135
00142 | int read_temperature(float *resolution);
00143
00144
00150 | int16_t get_timezone_offset() const;
00151
00157 | void set_timezone_offset(int16_t offset_minutes);
00158
00164 | time_t get_local_time();
00165
00166
00167
00168 private:
00169 | i2c_inst_t *i2c;
00170 | uint8_t ds3231_addr;
00171 | recursive_mutex_t clock_mutex_;
00172 | int16_t timezone_offset_minutes_ = 60;
00173 | uint32_t sync_interval_minutes_ = 1440;

9.10 lib/comms/commands/clock_commands.cpp File Reference | 195
00174 | time_t last_sync_time_ = 0;
00175
00176 | // Private constructor
00177 | DS3231();
00178
00179 | // Delete copy constructor and assignment operator
00180 | DS3231(const DS3231&) = delete;
00181 | DS3231& operator=(const DS3231&) = delete;
00182
00191 | int i2c_read_reg(uint8_t reg_addr, size_t length, uint8_t *data);
00192
00201 | int i2c_write_reg(uint8_t reg_addr, size_t length, uint8_t *data);
00202
00203 };
00204
00205 #endif // DS3231_H

## 9.10 lib/comms/commands/clock_commands.cpp File Reference

#include "communication.h"

#include <time.h>

#include "DS3231.h"

Include dependency graph for clock_commands.cpp:

lib/comms/commands
/clock_commands.cpp

communication.h

time.h

DS3231.h

string | vector
event_manager.h | protocol.h

map

cstdint | functional | iomanip

pin_config.h

PowerManager.h | cstdio | cstdlib

cstring

utils.h

build_number.h | LoRa/LoRa-RP2040.h

stdint.h

INA3221/INA3221.h

pico/stdlib.h | hardware/i2c.h

pico/mutex.h

iostream | stdio.h | hardware/uart.h

storage.h

system_state_manager.h

blockdevice/sd.h | filesystem/littlefs.h | filesystem/vfs.h | lfs.h | filesystem/fat.h | string.h | hardware/clocks.h | hardware/flash.h | blockdevice/flash.h
| | | | | | | mutex | pico/multicore.h

pico/sync.h

lib/location/gps_collector.h | array

lib/location/NMEA/nmea
_data.h

Functions

- std::vector< Frame > handle_time (const std::string &param, OperationType operationType)

Handler for getting and setting system time.
- std::vector< Frame > handle_timezone_offset (const std::string &param, OperationType operationType)

Handler for getting and setting timezone offset.
- std::vector< Frame > handle_get_internal_temperature (const std::string &param, OperationType operationType)

Handler for reading the DS3231's internal temperature sensor.

Variables

- static constexpr uint8_t clock_commands_group_id = 3
- static constexpr uint8_t time_command_id = 0
- static constexpr uint8_t timezone_offset_command_id = 1
- static constexpr uint8_t internal_temperature_command_id = 4

### 9.10.1 Variable Documentation

### 9.10.1.1 clock_commands_group_id

uint8_t clock_commands_group_id = 3 [static], [constexpr]

Definition at line 5 of file clock_commands.cpp.

196 File Documentation

### 9.10.1.2 time_command_id

uint8_t time_command_id = 0 [static], [constexpr]

Definition at line 6 of file clock_commands.cpp.

### 9.10.1.3 timezone_offset_command_id

uint8_t timezone_offset_command_id = 1 [static], [constexpr]

Definition at line 7 of file clock_commands.cpp.

### 9.10.1.4 internal_temperature_command_id

uint8_t internal_temperature_command_id = 4 [static], [constexpr]

Definition at line 8 of file clock_commands.cpp.

## 9.11 clock_commands.cpp

Go to the documentation of this file.

00001 #include "communication.h"
00002 #include <time.h>
00003 #include "DS3231.h" // Include the DS3231 header

00005 static constexpr uint8_t clock_commands_group_id = 3;
00006 static constexpr uint8_t time_command_id = 0;
00007 static constexpr uint8_t timezone_offset_command_id = 1; 00008 static constexpr uint8_t internal_temperature_command_id = 4;

00029 std::vector<Frame> handle_time(const std::string& param, OperationType operationType) { std::vector<Frame> frames;
std::string error_msg;

if (operationType == OperationType::SET) {
if (param.empty()) {
error_msg = error_code_to_string(ErrorCode::PARAM_REQUIRED); frames.push_back(frame_build(OperationType::ERR, clock_commands_group_id, time_command_id, error_msg));
return frames;
}
try {
time_t newTime = std::stoll(param);
if (newTime <= 1742487032 || newTime >= 1893520044) {
error_msg = error_code_to_string(ErrorCode::INVALID_VALUE); frames.push_back(frame_build(OperationType::ERR, clock_commands_group_id, time_command_id, error_msg)); return frames;
}

if (DS3231::get_instance().set_time(newTime) != 0) {
error_msg = error_code_to_string(ErrorCode::FAIL_TO_SET); frames.push_back(frame_build(OperationType::ERR, clock_commands_group_id, time_command_id, error_msg)); return frames;
}

EventEmitter::emit(EventGroup::CLOCK, ClockEvent::CHANGED); frames.push_back(frame_build(OperationType::RES, clock_commands_group_id, time_command_id, std::to_string(DS3231::get_instance().get_time()))); return frames;
} catch (...) {
error_msg = error_code_to_string(ErrorCode::INVALID_FORMAT); frames.push_back(frame_build(OperationType::ERR, clock_commands_group_id, time_command_id, error_msg));
return frames;

9.11 clock_commands.cpp | 197

}
} else if (operationType == OperationType::GET) {
if (!param.empty()) {
error_msg = error_code_to_string(ErrorCode::PARAM_UNNECESSARY); frames.push_back(frame_build(OperationType::ERR, clock_commands_group_id, time_command_id, error_msg));
return frames;
}

uint32_t time_unix = DS3231::get_instance().get_local_time();
if (time_unix == 0) {
error_msg = error_code_to_string(ErrorCode::INTERNAL_FAIL_TO_READ); frames.push_back(frame_build(OperationType::ERR, clock_commands_group_id, time_command_id, error_msg));
return frames;
}

frames.push_back(frame_build(OperationType::VAL, clock_commands_group_id, time_command_id, std::to_string(time_unix)));
return frames;
}

error_msg = error_code_to_string(ErrorCode::INVALID_OPERATION); frames.push_back(frame_build(OperationType::ERR, clock_commands_group_id, time_command_id, error_msg));
return frames;
00082 }

00094 std::vector<Frame> handle_timezone_offset(const std::string& param, OperationType operationType) { std::vector<Frame> frames;
std::string error_msg;

if (!(operationType == OperationType::GET || operationType == OperationType::SET)) { error_msg = error_code_to_string(ErrorCode::INVALID_OPERATION); frames.push_back(frame_build(OperationType::ERR, clock_commands_group_id, timezone_offset_command_id, error_msg));
return frames;
}

if (operationType == OperationType::GET) {
if (!param.empty()) {
error_msg = error_code_to_string(ErrorCode::PARAM_UNNECESSARY); frames.push_back(frame_build(OperationType::ERR, clock_commands_group_id, timezone_offset_command_id, error_msg)); return frames;
}

int offset = DS3231::get_instance().get_timezone_offset();
std::string offset_set = std::to_string(offset); frames.push_back(frame_build(OperationType::VAL, clock_commands_group_id, timezone_offset_command_id, offset_set));
return frames;
}

if (param.empty()) {
error_msg = error_code_to_string(ErrorCode::PARAM_REQUIRED); frames.push_back(frame_build(OperationType::ERR, clock_commands_group_id, timezone_offset_command_id, error_msg));
return frames;
}

try {
int16_t offset = std::stoi(param);
if (offset < -720 || offset > 720) {
error_msg = error_code_to_string(ErrorCode::PARAM_INVALID); frames.push_back(frame_build(OperationType::ERR, clock_commands_group_id, timezone_offset_command_id, error_msg)); return frames;
}

DS3231::get_instance().set_timezone_offset(offset);
std::string offset_set = std::to_string(offset); frames.push_back(frame_build(OperationType::RES, clock_commands_group_id, timezone_offset_command_id, offset_set));
return frames;
} catch (...) {
error_msg = error_code_to_string(ErrorCode::PARAM_INVALID); frames.push_back(frame_build(OperationType::ERR, clock_commands_group_id, timezone_offset_command_id, error_msg));
return frames;
}
00140 }

00153 std::vector<Frame> handle_get_internal_temperature(const std::string& param, OperationType operationType) {
std::vector<Frame> frames;

198 File Documentation

00155 | std::string error_msg;
00156
00157 | if (operationType != OperationType::GET || !param.empty()) {
00158 | error_msg = error_code_to_string(ErrorCode::INVALID_OPERATION);
00159 | frames.push_back(frame_build(OperationType::ERR, clock_commands_group_id,
| internal_temperature_command_id, error_msg));
00160 | return frames;
00161 | }
00162
00163 | float temperature;
00164 | if (DS3231::get_instance().read_temperature(&temperature) != 0) {
00165 | error_msg = error_code_to_string(ErrorCode::INTERNAL_FAIL_TO_READ);
00166 | frames.push_back(frame_build(OperationType::ERR, clock_commands_group_id,
| internal_temperature_command_id, error_msg));
00167 | return frames;
00168 | }
00169
00170 | std::stringstream ss;
00171 | ss « std::fixed « std::setprecision(2) « temperature;
00172 | frames.push_back(frame_build(OperationType::VAL, clock_commands_group_id,
| internal_temperature_command_id, ss.str(), ValueUnit::CELSIUS));
00173
00174 | return frames;
00175 }
00176 // end of ClockCommands group

## 9.12 lib/comms/commands/commands.cpp File Reference

#include "commands.h"

#include "communication.h" Include dependency graph for commands.cpp:

lib/comms/commands
/commands.cpp

commands.h

communication.h

string

functional

map

protocol.h

vector

iomanip | cstdint

pin_config.h

cstdio | cstdlib | cstring | time.h | build_number.h | LoRa/LoRa-RP2040.h | utils.h | PowerManager.h

stdint.h

INA3221/INA3221.h

hardware/i2c.h

pico/stdlib.h | pico/mutex.h

iostream

hardware/uart.h | stdio.h

event_manager.h

storage.h

system_state_manager.h

hardware/clocks.h | hardware/flash.h | blockdevice/flash.h | blockdevice/sd.h | filesystem/littlefs.h | filesystem/vfs.h | lfs.h | filesystem/fat.h | string.h
mutex | pico/multicore.h | pico/sync.h

Macros

- #define CMD(group, cmd)

Typedefs

- using CommandHandler = std::function<std::vector<Frame>(const std::string&, OperationType)>

Function type for command handlers.
- using CommandMap = std::map<uint32_t, CommandHandler>

Map type for storing command handlers.

Functions

- std::vector< Frame > execute_command (uint32_t commandKey, const std::string &param, OperationType operationType)

Executes a command based on its key.

9.13 commands.cpp | 199

Variables

- CommandMap command_handlers

Global map of all command handlers.

## 9.13 commands.cpp

Go to the documentation of this file.

00001 // commands/commands.cpp 00002 #include "commands.h"
00003 #include "communication.h"
00004
00010 #define CMD(group, cmd) ((static_cast<uint32_t>(group) « 8) | static_cast<uint32_t>(cmd))
00011
00016 using CommandHandler = std::function<std::vector<Frame>(const std::string&, OperationType)>; 00017
00022 using CommandMap = std::map<uint32_t, CommandHandler>;
00023
00028 CommandMap command_handlers = {
00029 | {CMD(1, 0), handle_get_commands_list}, | // Group 1, Command 0
00030 | {CMD(1, 1), handle_get_build_version}, | // Group 1, Command 1
00031 | {CMD(1, 2), handle_get_power_mode}, | // Group 1, Command 2
00032 | {CMD(1, 3), handle_get_uptime}, | // Group 1, Command 3
00033 | {CMD(1, 8), handle_verbosity}, | // Group 1, Command 8
00034 | {CMD(1, 9), handle_enter_bootloader_mode}, | // Group 1, Command 9
00035
00036 | {CMD(3, 0), handle_time}, | // Group 3, Command 0
00037 | {CMD(3, 1), handle_timezone_offset}, | // Group 3, Command 1
00038 | {CMD(3, 4), handle_get_internal_temperature}, | // Group 3, Command 4
00039
00040 | {CMD(5, 1), handle_get_last_events}, | // Group 5, Command 1
00041 | {CMD(5, 2), handle_get_event_count}, | // Group 5, Command 2
00042
00043 | {CMD(7, 1), handle_gps_power_status}, | // Group 7, Command 1
00044 | {CMD(7, 2), handle_enable_gps_uart_passthrough}, | // Group 7, Command 2
00045
00046 | {CMD(8, 2), handle_get_last_telemetry_record}, | // Group 8, Command 2
00047 | {CMD(8, 3), handle_get_last_sensor_record}, | // Group 8, Command 3
00048 };
00049
00050
00059 std::vector<Frame> execute_command(uint32_t commandKey, const std::string& param, OperationType
| operationType) {
00060 | auto it = command_handlers.find(commandKey);
00061 | if (it != command_handlers.end()) {
00062 | CommandHandler handler = it->second;
00063 | return handler(param, operationType);
00064 | } else {
00065 | std::vector<Frame> frames;
00066 | frames.push_back(frame_build(OperationType::ERR, 0, 0, "INVALID COMMAND"));
00067 | return frames;
00068 | }
00069 } // end of CommandSystem group

## 9.14 lib/comms/commands/commands.h File Reference

#include <string>

#include <functional>

#include <map>

#include "protocol.h"

200 File Documentation

Include dependency graph for commands.h:

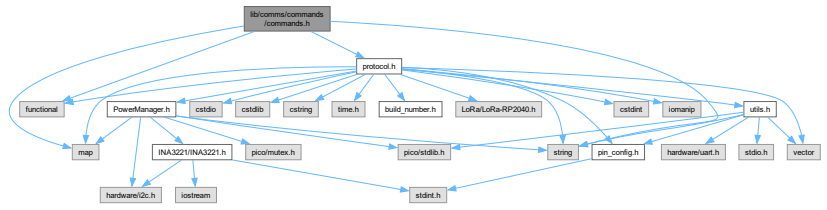
[picture p75: figure]
lib/comms/commands /commands.h; string; functional; map; protocol.h; vector; cstdint; iomanip; pin_config.h; PowerManager.h; cstdio; cstdlib; cstring; time.h; build_number.h; LoRa/LoRa-RP2040.h; utils.h; stdint.h; INA3221/INA3221.h; hardware/i2c.h; pico/mutex.h; pico/stdlib.h; iostream; hardware/uart.h; stdio.h

This graph shows which files directly or indirectly include this file:

lib/comms/commands
/commands.h

lib/comms/commands
/commands.cpp

lib/comms/commands
/diagnostic_commands.cpp

lib/comms/commands
/telemetry_commands.cpp

Functions

- std::vector< Frame > handle_time (const std::string &param, OperationType operationType)

Handler for getting and setting system time.
- std::vector< Frame > handle_timezone_offset (const std::string &param, OperationType operationType)

Handler for getting and setting timezone offset.
- std::vector< Frame > handle_get_internal_temperature (const std::string &param, OperationType operationType)

Handler for reading the DS3231's internal temperature sensor.
- std::vector< Frame > handle_get_commands_list (const std::string &param, OperationType operationType)

Handler for listing all available commands on UART.
- std::vector< Frame > handle_get_build_version (const std::string &param, OperationType operationType)

Get firmware build version.
- std::vector< Frame > handle_get_power_mode (const std::string &param, OperationType operationType)

Get system power mode.
- std::vector< Frame > handle_get_uptime (const std::string &param, OperationType operationType)

Get system uptime.
- std::vector< Frame > handle_verbosity (const std::string &param, OperationType operationType)

Handles setting or getting the UART verbosity level.
- std::vector< Frame > handle_enter_bootloader_mode (const std::string &param, OperationType operation←-Type)

Reboot system to USB firmware loader.
- std::vector< Frame > handle_gps_power_status (const std::string &param, OperationType operationType)

Handler for controlling GPS module power state.
- std::vector< Frame > handle_enable_gps_uart_passthrough (const std::string &param, OperationType operationType)

9.15 commands.h | 201

Handler for enabling GPS transparent mode (UART pass-through)
- std::vector< Frame > handle_get_last_events (const std::string &param, OperationType operationType)

Handler for retrieving last N events from the event log.
- std::vector< Frame > handle_get_event_count (const std::string &param, OperationType operationType)

Handler for getting total number of events in the log.
- std::vector< Frame > handle_get_last_telemetry_record (const std::string &param, OperationType operationType)

Handles the get last record command.
- std::vector< Frame > handle_get_last_sensor_record (const std::string &param, OperationType operation←-Type)

Handles the get last sensor record command.
- std::vector< Frame > execute_command (uint32_t commandKey, const std::string &param, OperationType operationType)

Executes a command based on its key.

Variables

- std::map< uint32_t, std::function< std::vector< Frame >(const std::string &, OperationType)> > command_handlers

Global map of all command handlers.

## 9.15 commands.h

Go to the documentation of this file.

00001 // commands/commands.h 00002 #ifndef COMMANDS_H
00003 #define COMMANDS_H
00004
00005 #include <string>
00006 #include <functional> 00007 #include <map>
00008 #include "protocol.h"
00009
00010 // CLOCK
00011 std::vector<Frame> handle_time(const std::string& param, OperationType operationType);
00012 std::vector<Frame> handle_timezone_offset(const std::string& param, OperationType operationType); 00013 std::vector<Frame> handle_get_internal_temperature(const std::string& param, OperationType operationType);
00014
00015
00016 // DIAG
00017 std::vector<Frame> handle_get_commands_list(const std::string& param, OperationType operationType); 00018 std::vector<Frame> handle_get_build_version(const std::string& param, OperationType operationType); 00019 std::vector<Frame> handle_get_power_mode(const std::string& param, OperationType operationType); 00020 std::vector<Frame> handle_get_uptime(const std::string& param, OperationType operationType); 00021 std::vector<Frame> handle_verbosity(const std::string& param, OperationType operationType);
00022 std::vector<Frame> handle_enter_bootloader_mode(const std::string& param, OperationType operationType);
00023
00024
00025 // GPS
00026 std::vector<Frame> handle_gps_power_status(const std::string& param, OperationType operationType); 00027 std::vector<Frame> handle_enable_gps_uart_passthrough(const std::string& param, OperationType operationType);
00028
00029
00030 // EVENT
00031 std::vector<Frame> handle_get_last_events(const std::string& param, OperationType operationType); 00032 std::vector<Frame> handle_get_event_count(const std::string& param, OperationType operationType); 00033
00034
00035 // TELEMETRY
00036 std::vector<Frame> handle_get_last_telemetry_record(const std::string& param, OperationType operationType);
00037 std::vector<Frame> handle_get_last_sensor_record(const std::string& param, OperationType operationType);
00038

202 File Documentation

00039 std::vector<Frame> execute_command(uint32_t commandKey, const std::string& param, OperationType operationType);
00040 extern std::map<uint32_t, std::function<std::vector<Frame>(const std::string&, OperationType)» command_handlers;
00041
00042 #endif

## 9.16 lib/comms/commands/diagnostic_commands.cpp File Reference

#include "communication.h" #include "commands.h"

#include "pico/stdlib.h"

#include "pico/bootrom.h"

#include "system_state_manager.h" Include dependency graph for diagnostic_commands.cpp:

lib/comms/commands
/diagnostic_commands.cpp

communication.h

pico/stdlib.h

system_state_manager.h

commands.h

pico/bootrom.h

vector | string

protocol.h

event_manager.h

map

cstdint | iomanip | functional

pin_config.h

utils.h | PowerManager.h | cstdlib | cstring | time.h | build_number.h | LoRa/LoRa-RP2040.h | cstdio

stdint.h

INA3221/INA3221.h

hardware/i2c.h

pico/mutex.h

iostream

stdio.h | hardware/uart.h

storage.h

blockdevice/flash.h | blockdevice/sd.h | filesystem/littlefs.h | filesystem/vfs.h | lfs.h | string.h | filesystem/fat.h | hardware/clocks.h | hardware/flash.h
pico/multicore.h | pico/sync.h | mutex

Functions

- std::vector< Frame > handle_get_commands_list (const std::string &param, OperationType operationType)

Handler for listing all available commands on UART.
- std::vector< Frame > handle_get_build_version (const std::string &param, OperationType operationType)

Get firmware build version.
- std::vector< Frame > handle_get_uptime (const std::string &param, OperationType operationType)

Get system uptime.
- std::vector< Frame > handle_get_power_mode (const std::string &param, OperationType operationType)

Get system power mode.
- std::vector< Frame > handle_verbosity (const std::string &param, OperationType operationType)

Handles setting or getting the UART verbosity level.
- std::vector< Frame > handle_enter_bootloader_mode (const std::string &param, OperationType operation←-Type)

Reboot system to USB firmware loader.

Variables

- static constexpr uint8_t diagnostic_commands_group_id = 1
- static constexpr uint8_t commands_list_command_id = 0
- static constexpr uint8_t build_version_command_id = 1
- static constexpr uint8_t power_mode_command_id = 2
- static constexpr uint8_t uptime_command_id = 3
- static constexpr uint8_t verbosity_command_id = 8
- static constexpr uint8_t enter_bootloader_command_id = 9

9.17 diagnostic_commands.cpp | 203

## 9.17 diagnostic_commands.cpp

Go to the documentation of this file.

00001 #include "communication.h" 00002 #include "commands.h"
00003 #include "pico/stdlib.h"
00004 #include "pico/bootrom.h"
00005 #include "system_state_manager.h"

00011 static constexpr uint8_t diagnostic_commands_group_id = 1; 00012 static constexpr uint8_t commands_list_command_id = 0; 00013 static constexpr uint8_t build_version_command_id = 1; 00014 static constexpr uint8_t power_mode_command_id = 2; 00015 static constexpr uint8_t uptime_command_id = 3;
00016 static constexpr uint8_t verbosity_command_id = 8;
00017 static constexpr uint8_t enter_bootloader_command_id = 9;

00029 std::vector<Frame> handle_get_commands_list(const std::string& param, OperationType operationType) { std::vector<Frame> frames;
std::string error_msg;

if (!(operationType == OperationType::GET)) {
error_msg = error_code_to_string(ErrorCode::INVALID_OPERATION); frames.push_back(frame_build(OperationType::ERR, diagnostic_commands_group_id, commands_list_command_id, error_msg));
return frames;
}

if (!param.empty()) {
error_msg = error_code_to_string(ErrorCode::PARAM_UNNECESSARY); frames.push_back(frame_build(OperationType::ERR, diagnostic_commands_group_id, commands_list_command_id, error_msg));
return frames;
}

std::string combined_command_details;
for (const auto& entry : command_handlers) { uint32_t command_key = entry.first; uint8_t group = (command_key » 8) & 0xFF;
uint8_t command = command_key & 0xFF;

std::string command_details = std::to_string(group) + "." + std::to_string(command);

if (combined_command_details.length() + command_details.length() + 1 > 100) { frames.push_back(frame_build(OperationType::SEQ, diagnostic_commands_group_id, commands_list_command_id, combined_command_details));
combined_command_details = "";
}

if (!combined_command_details.empty()) { combined_command_details += "-";
}
combined_command_details += command_details; }

if (!combined_command_details.empty()) { frames.push_back(frame_build(OperationType::SEQ, diagnostic_commands_group_id, commands_list_command_id, combined_command_details));
}

frames.push_back(frame_build(OperationType::VAL, diagnostic_commands_group_id, commands_list_command_id, "SEQ_DONE"));
return frames;
00070 }

00083 std::vector<Frame> handle_get_build_version(const std::string& param, OperationType operationType) { std::vector<Frame> frames;
std::string error_msg;

if (!(operationType == OperationType::GET)) {
error_msg = error_code_to_string(ErrorCode::INVALID_OPERATION); frames.push_back(frame_build(OperationType::ERR, diagnostic_commands_group_id, build_version_command_id, error_msg));
return frames;
}

if (!param.empty()) {
error_msg = error_code_to_string(ErrorCode::PARAM_UNNECESSARY); frames.push_back(frame_build(OperationType::ERR, diagnostic_commands_group_id, build_version_command_id, error_msg));
return frames;
}

204 File Documentation

frames.push_back(frame_build(OperationType::VAL, diagnostic_commands_group_id, build_version_command_id, std::to_string(BUILD_NUMBER)));
return frames;
00101 }

00114 std::vector<Frame> handle_get_uptime(const std::string& param, OperationType operationType) { std::vector<Frame> frames;
std::string error_msg;

if (!(operationType == OperationType::GET)) {
error_msg = error_code_to_string(ErrorCode::INVALID_OPERATION); frames.push_back(frame_build(OperationType::ERR, diagnostic_commands_group_id, uptime_command_id, error_msg));
return frames;
}

if (!param.empty()) {
error_msg = error_code_to_string(ErrorCode::PARAM_UNNECESSARY); frames.push_back(frame_build(OperationType::ERR, diagnostic_commands_group_id, uptime_command_id, error_msg));
return frames;
}

uint32_t uptime = to_ms_since_boot(get_absolute_time()) / 1000; frames.push_back(frame_build(OperationType::VAL, diagnostic_commands_group_id, uptime_command_id, std::to_string(uptime)));
return frames;
00133 }

00146 std::vector<Frame> handle_get_power_mode(const std::string& param, OperationType operationType) { std::vector<Frame> frames;
std::string error_msg;

if (!(operationType == OperationType::GET)) {
error_msg = error_code_to_string(ErrorCode::INVALID_OPERATION); frames.push_back(frame_build(OperationType::ERR, diagnostic_commands_group_id, power_mode_command_id, error_msg));
return frames;
}

if (!param.empty()) {
error_msg = error_code_to_string(ErrorCode::PARAM_UNNECESSARY); frames.push_back(frame_build(OperationType::ERR, diagnostic_commands_group_id, power_mode_command_id, error_msg));
return frames;
}

SystemOperatingMode mode = SystemStateManager::get_instance().get_operating_mode(); std::string mode_str = (mode == SystemOperatingMode::BATTERY_POWERED) ? "BATTERY" : "USB"; frames.push_back(frame_build(OperationType::VAL, diagnostic_commands_group_id, power_mode_command_id, mode_str));
return frames;
00166 }

00190 std::vector<Frame> handle_verbosity(const std::string& param, OperationType operationType) { std::vector<Frame> frames;
std::string error_msg;

if (operationType == OperationType::GET) {
if (!param.empty()) {
error_msg = error_code_to_string(ErrorCode::PARAM_UNNECESSARY); frames.push_back(frame_build(OperationType::ERR, diagnostic_commands_group_id, verbosity_command_id, error_msg)); return frames;
}

VerbosityLevel current_level = SystemStateManager::get_instance().get_uart_verbosity(); uart_print("GET_VERBOSITY_" + std::to_string(static_cast<int>(current_level)), VerbosityLevel::INFO);
frames.push_back(frame_build(OperationType::VAL, diagnostic_commands_group_id, verbosity_command_id,
std::to_string(static_cast<int>(current_level)))); return frames;
}
else if (operationType == OperationType::SET) { try {
int level = std::stoi(param);
if (level < 0 || level > 4) {
error_msg = error_code_to_string(ErrorCode::PARAM_INVALID); frames.push_back(frame_build(OperationType::ERR, diagnostic_commands_group_id, verbosity_command_id, error_msg)); return frames;
}
SystemStateManager::get_instance().set_uart_verbosity(static_cast<VerbosityLevel>(level));

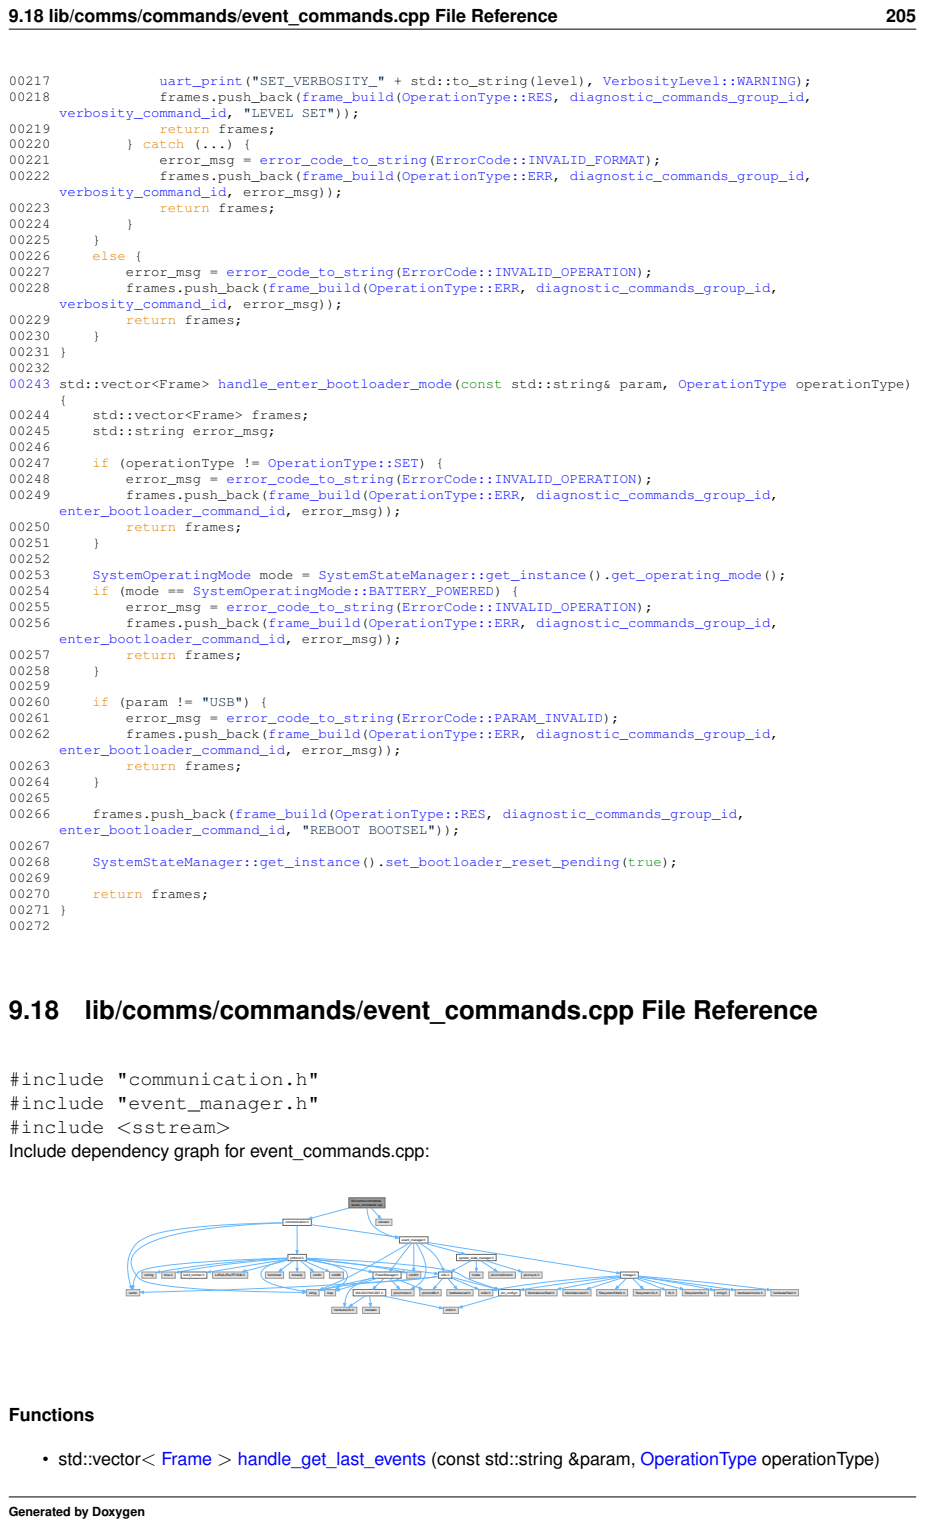
[picture p76: page 227]
9.18 lib/comms/commands/event_commands.cpp File Reference; uart_print("SET_VERBOSITY_" + std::to_string(level), VerbosityLevel::WARNING);; frames.push_back(frame_build(OperationType::RES, diagnostic_commands_group_id,; verbosity_command_id, "LEVEL SET"));; return frames;; } catch (...) {; error_msg = error_code_to_string(ErrorCode::INVALID_FORMAT);; frames.push_back(frame_build(OperationType::ERR, diagnostic_commands_group_id,; verbosity_command_id, error_msg));; else {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

00243 std::vector<Frame> handle_enter_bootloader_mode(const std::string& param, OperationType operationType)

9.18 lib/comms/commands/event_commands.cpp File Reference

#include "communication.h"
#include "event_manager.h"
#include <sstream>
Include dependency graph for event_commands.cpp:

lib/comms/commands
/event_commands.cpp

• std::vector< Frame > handle_get_last_events (const std::string &param, OperationType operationType)

206 File Documentation

Handler for retrieving last N events from the event log.
- std::vector< Frame > handle_get_event_count (const std::string &param, OperationType operationType)

Handler for getting total number of events in the log.

Variables

- static constexpr uint8_t event_commands_group_id = 5
- static constexpr uint8_t last_events_command_id = 1
- static constexpr uint8_t event_count_command_id = 2

## 9.19 event_commands.cpp

Go to the documentation of this file.

00001 #include "communication.h" 00002 #include "event_manager.h" 00003 #include <sstream>

00012 static constexpr uint8_t event_commands_group_id = 5; 00013 static constexpr uint8_t last_events_command_id = 1; 00014 static constexpr uint8_t event_count_command_id = 2;

00038 std::vector<Frame> handle_get_last_events(const std::string& param, OperationType operationType) { std::vector<Frame> frames;
std::string error_msg;

if (operationType != OperationType::GET) {
error_msg = error_code_to_string(ErrorCode::INVALID_OPERATION); frames.push_back(frame_build(OperationType::ERR, event_commands_group_id, last_events_command_id, error_msg));
return frames;
}

size_t count = 10; // Default number of events to return if (!param.empty()) {
try {
count = std::stoul(param);
if (count > EVENT_BUFFER_SIZE) {
error_msg = error_code_to_string(ErrorCode::INVALID_VALUE); frames.push_back(frame_build(OperationType::ERR, event_commands_group_id, last_events_command_id, error_msg)); return frames;
}
} catch (...) {
error_msg = error_code_to_string(ErrorCode::PARAM_INVALID); frames.push_back(frame_build(OperationType::ERR, event_commands_group_id, last_events_command_id, error_msg)); return frames;
}
}

auto& event_manager = EventManager::get_instance();
size_t available = event_manager.get_event_count();
size_t to_return = (count == 0) ? available : std::min(count, available); size_t event_index = available;

while (to_return > 0) {
std::stringstream ss;
ss « std::hex « std::uppercase « std::setfill(’0’); size_t events_in_frame = 0;

for (size_t i = 0; i < 10 && to_return > 0; ++i) { event_index--;
const EventLog& event = event_manager.get_event(event_index);

ss « std::setw(4) « event.id
« std::setw(8) « event.timestamp
« std::setw(2) « static_cast<int>(event.group) « std::setw(2) « static_cast<int>(event.event);

if (to_return > 1) ss « "-";
to_return--;

9.20 lib/comms/commands/gps_commands.cpp File Reference | 207
00085 | events_in_frame++;
00086 | }
00087 | frames.push_back(frame_build(OperationType::SEQ, event_commands_group_id,
| last_events_command_id, ss.str()));
00088 | }
00089 | frames.push_back(frame_build(OperationType::VAL, event_commands_group_id, last_events_command_id,
| "SEQ_DONE"));
00090 | return frames;
00091 }
00092
00093
00106 std::vector<Frame> handle_get_event_count(const std::string& param, OperationType operationType) {
00107 | std::vector<Frame> frames;
00108 | std::string error_msg;
00109
00110 | if (operationType != OperationType::GET || !param.empty()) {
00111 | error_msg = error_code_to_string(ErrorCode::INVALID_OPERATION);
00112 | frames.push_back(frame_build(OperationType::ERR, event_commands_group_id,
| event_count_command_id, error_msg));
00113 | return frames;
00114 | }
00115
00116 | auto& event_manager = EventManager::get_instance();
00117 | frames.push_back(frame_build(OperationType::VAL, event_commands_group_id, event_count_command_id,
00118 | std::to_string(event_manager.get_event_count())));
00119 | return frames;
00120 } // end of EventCommands group

## 9.20 lib/comms/commands/gps_commands.cpp File Reference

#include "communication.h"

#include "lib/location/gps_collector.h" #include <sstream>

#include "system_state_manager.h" Include dependency graph for gps_commands.cpp:

lib/comms/commands
/gps_commands.cpp

communication.h

lib/location/gps_collector.h | system_state_manager.h

sstream

string | vector

protocol.h

event_manager.h

map

cstdint | iomanip | functional

pin_config.h

PowerManager.h | cstdio | cstdlib

cstring

time.h | build_number.h | LoRa/LoRa-RP2040.h | utils.h

stdint.h

INA3221/INA3221.h

hardware/i2c.h

pico/mutex.h | pico/stdlib.h

iostream

stdio.h | hardware/uart.h

storage.h

hardware/flash.h | blockdevice/flash.h | blockdevice/sd.h | filesystem/littlefs.h | filesystem/vfs.h | lfs.h | filesystem/fat.h | string.h | hardware/clocks.h
mutex | pico/multicore.h

pico/sync.h

lib/location/NMEA/nmea
_data.h

Functions

- std::vector< Frame > handle_gps_power_status (const std::string &param, OperationType operationType)

Handler for controlling GPS module power state.
- std::vector< Frame > handle_enable_gps_uart_passthrough (const std::string &param, OperationType operationType)

Handler for enabling GPS transparent mode (UART pass-through)

Variables

- static constexpr uint8_t gps_commands_group_id = 7
- static constexpr uint8_t power_status_command_id = 1
- static constexpr uint8_t passthrough_command_id = 2

208 File Documentation

### 9.20.1 Variable Documentation

### 9.20.1.1 gps_commands_group_id

uint8_t gps_commands_group_id = 7 [static], [constexpr]

Definition at line 6 of file gps_commands.cpp.

### 9.20.1.2 power_status_command_id

uint8_t power_status_command_id = 1 [static], [constexpr]

Definition at line 7 of file gps_commands.cpp.

### 9.20.1.3 passthrough_command_id

uint8_t passthrough_command_id = 2 [static], [constexpr]

Definition at line 8 of file gps_commands.cpp.

## 9.21 gps_commands.cpp

Go to the documentation of this file.

00001 #include "communication.h"
00002 #include "lib/location/gps_collector.h" 00003 #include <sstream>
00004 #include "system_state_manager.h"

00006 static constexpr uint8_t gps_commands_group_id = 7; 00007 static constexpr uint8_t power_status_command_id = 1; 00008 static constexpr uint8_t passthrough_command_id = 2;

00031 std::vector<Frame> handle_gps_power_status(const std::string& param, OperationType operationType) { std::vector<Frame> frames;
std::string error_str;

if (operationType == OperationType::SET) {
// command allowed only in ground mode
SystemOperatingMode mode = SystemStateManager::get_instance().get_operating_mode(); if (mode == SystemOperatingMode::BATTERY_POWERED) {
error_str = error_code_to_string(ErrorCode::INVALID_OPERATION); frames.push_back(frame_build(OperationType::ERR, gps_commands_group_id, power_status_command_id, error_str));
return frames;
}

if (param.empty()) {
error_str = error_code_to_string(ErrorCode::PARAM_REQUIRED); frames.push_back(frame_build(OperationType::ERR, gps_commands_group_id, power_status_command_id, error_str)); return frames;
}

try {
int power_status = std::stoi(param);
if (power_status != 0 && power_status != 1) {
error_str = error_code_to_string(ErrorCode::PARAM_INVALID); frames.push_back(frame_build(OperationType::ERR, gps_commands_group_id, power_status_command_id, error_str)); return frames;
}
gpio_put(GPS_POWER_ENABLE_PIN, power_status); EventEmitter::emit(EventGroup::GPS, power_status ? GPSEvent::POWER_ON : GPSEvent::POWER_OFF);

9.21 gps_commands.cpp | 209

frames.push_back(frame_build(OperationType::RES, gps_commands_group_id, power_status_command_id, std::to_string(power_status))); return frames;
} catch (...) {
error_str = error_code_to_string(ErrorCode::PARAM_INVALID); frames.push_back(frame_build(OperationType::ERR, gps_commands_group_id, power_status_command_id, error_str)); return frames;
}
}
else if (operationType == OperationType::GET) {
if (!param.empty()) {
error_str = error_code_to_string(ErrorCode::PARAM_UNNECESSARY); frames.push_back(frame_build(OperationType::ERR, gps_commands_group_id, power_status_command_id, error_str)); return frames;
}

bool power_status = gpio_get(GPS_POWER_ENABLE_PIN); frames.push_back(frame_build(OperationType::VAL, gps_commands_group_id, power_status_command_id, std::to_string(power_status)));
return frames;
}

error_str = error_code_to_string(ErrorCode::INVALID_OPERATION); frames.push_back(frame_build(OperationType::ERR, gps_commands_group_id, power_status_command_id, error_str));
return frames;
00082 }

00100 std::vector<Frame> handle_enable_gps_uart_passthrough(const std::string& param, OperationType operationType) {
std::vector<Frame> frames;
std::string error_str;

if (!(operationType == OperationType::SET)) {
error_str = error_code_to_string(ErrorCode::INVALID_OPERATION); frames.push_back(frame_build(OperationType::ERR, gps_commands_group_id, passthrough_command_id, error_str));
return frames;
}

// disable command if in battery mode
SystemOperatingMode mode = SystemStateManager::get_instance().get_operating_mode(); if (mode == SystemOperatingMode::BATTERY_POWERED) {
error_str = error_code_to_string(ErrorCode::INVALID_OPERATION); frames.push_back(frame_build(OperationType::ERR, gps_commands_group_id, passthrough_command_id, error_str));
return frames;
}

// Parse and validate timeout parameter
uint32_t timeout_ms;
try {
timeout_ms = param.empty() ? 60000u : std::stoul(param) * 1000;
} catch (...) {
error_str = error_code_to_string(ErrorCode::INVALID_VALUE); frames.push_back(frame_build(OperationType::ERR, gps_commands_group_id, passthrough_command_id, error_str));
return frames;
}

// Setup UART parameters and exit sequence const std::string EXIT_SEQUENCE = "##EXIT##";
std::string input_buffer;
bool exit_requested = false; SystemStateManager::get_instance().set_gps_collection_paused(true); sleep_ms(100);

uint32_t original_baud_rate = DEBUG_UART_BAUD_RATE;
uint32_t gps_baud_rate = GPS_UART_BAUD_RATE;
uint32_t start_time = to_ms_since_boot(get_absolute_time());

EventEmitter::emit(EventGroup::GPS, GPSEvent::PASS_THROUGH_START);

std::string message = "Entering GPS Serial Pass-Through Mode @" + std::to_string(gps_baud_rate) + " for " + std::to_string(timeout_ms/1000) + "s\r\n" + "Send " + EXIT_SEQUENCE + " to exit"; uart_print(message, VerbosityLevel::INFO);

sleep_ms(10);

// Change main UART baudrate to GPS module baudrate for passthrough duration uart_set_baudrate(DEBUG_UART_PORT, gps_baud_rate);

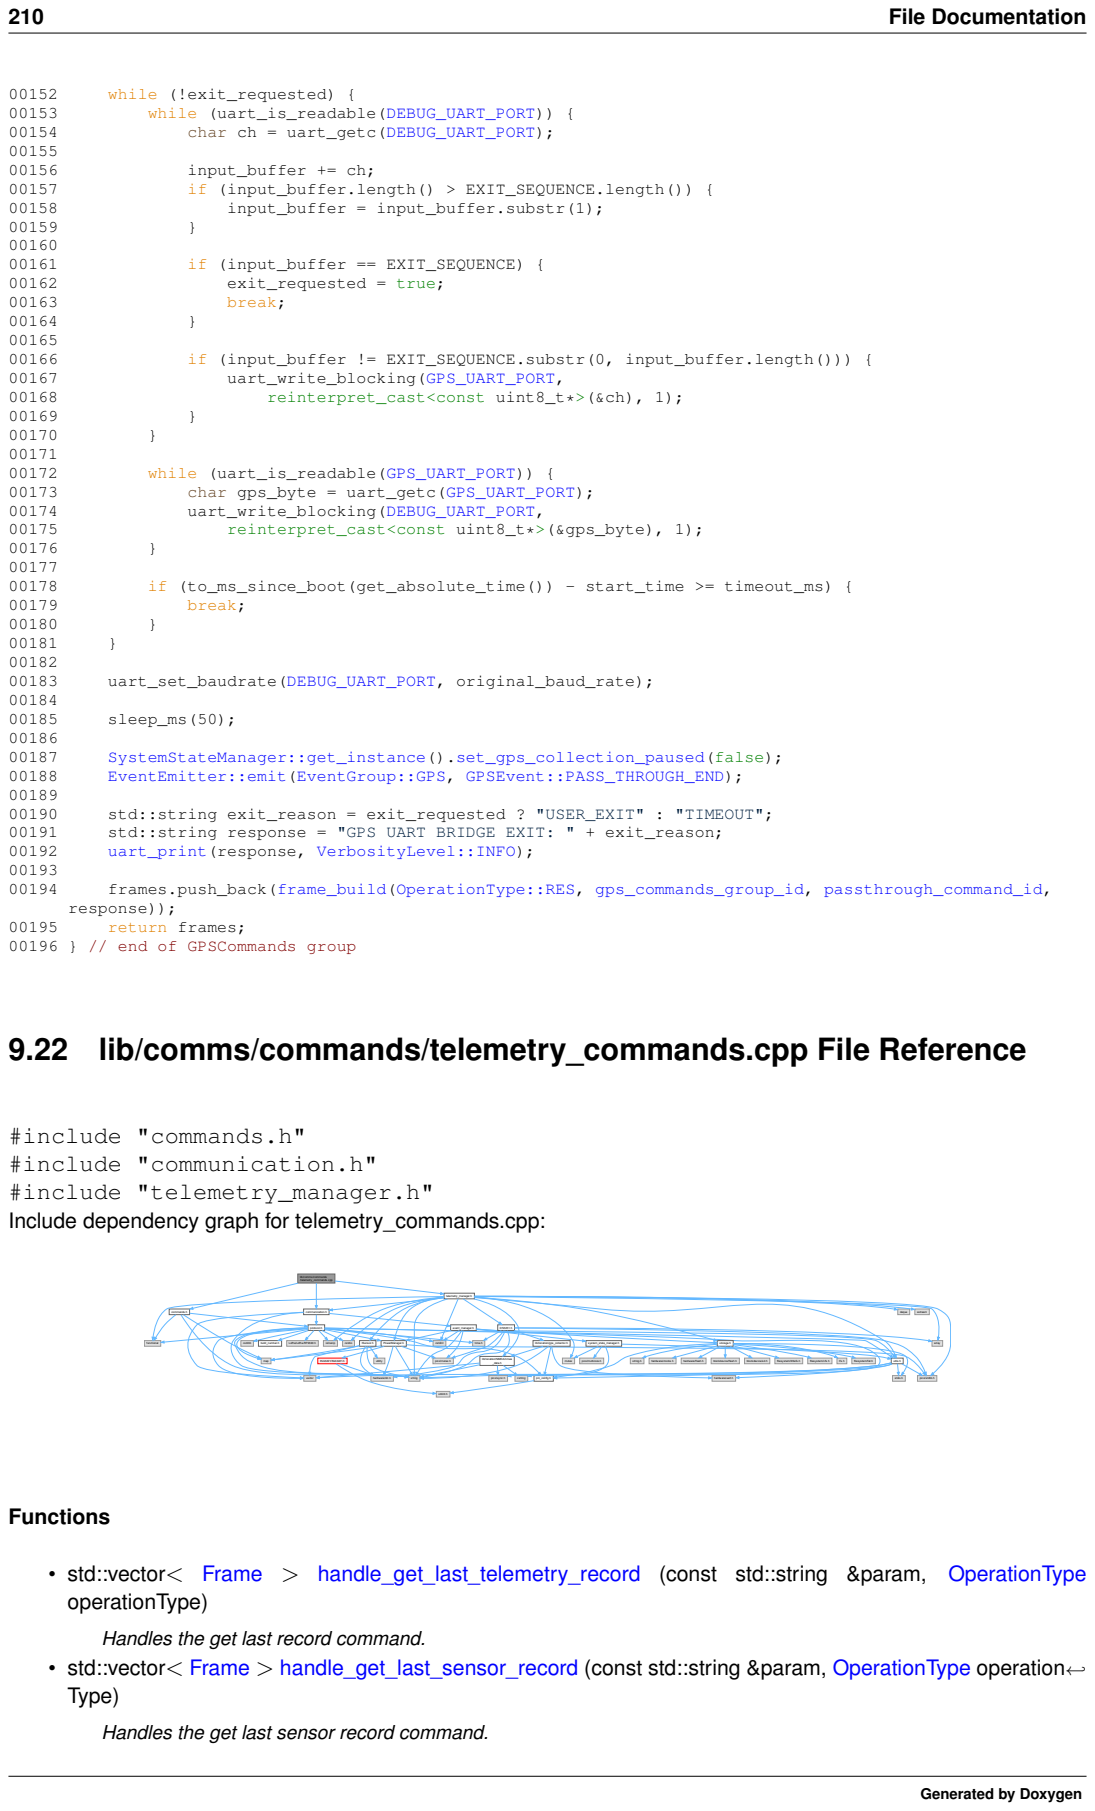
[picture p77: page 232]
210 File Documentation; while (!exit_requested) {; while (uart_is_readable(DEBUG_UART_PORT)) {; char ch = uart_getc(DEBUG_UART_PORT);; input_buffer += ch;; if (input_buffer.length() > EXIT_SEQUENCE.length()) {; input_buffer = input_buffer.substr(1);; if (input_buffer == EXIT_SEQUENCE) {; exit_requested = true;; break;; if (input_buffer != EXIT_SEQUENCE.substr(0, input_buffer.length())) {; uart_write_blocking(GPS_UART_PORT,; reinterpret_cast<const uint8_t*>(&ch), 1);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

00196 } // end of GPSCommands group

9.22 lib/comms/commands/telemetry_commands.cpp File Reference

#include "commands.h"
#include "communication.h"
#include "telemetry_manager.h"
Include dependency graph for telemetry_commands.cpp:

lib/comms/commands
/telemetry_commands.cpp

lib/location/NMEA/nmea
_data.h

• std::vector< Frame > handle_get_last_telemetry_record (const std::string &param, OperationType
operationType)

Handles the get last record command.
• std::vector< Frame > handle_get_last_sensor_record (const std::string &param, OperationType operation←-
Type)

Handles the get last sensor record command.

9.23 telemetry_commands.cpp | 211

Variables

- static constexpr uint8_t telemetry_commands_group = 8
- static constexpr uint8_t last_telemetry_command_id = 2
- static constexpr uint8_t last_sensor_command_id = 3

### 9.22.1 Variable Documentation

### 9.22.1.1 telemetry_commands_group

uint8_t telemetry_commands_group = 8 [static], [constexpr]

Definition at line 5 of file telemetry_commands.cpp.

### 9.22.1.2 last_telemetry_command_id

uint8_t last_telemetry_command_id = 2 [static], [constexpr]

Definition at line 6 of file telemetry_commands.cpp.

### 9.22.1.3 last_sensor_command_id

uint8_t last_sensor_command_id = 3 [static], [constexpr]

Definition at line 7 of file telemetry_commands.cpp.

## 9.23 telemetry_commands.cpp

Go to the documentation of this file.

00001 #include "commands.h"
00002 #include "communication.h"
00003 #include "telemetry_manager.h"

00005 static constexpr uint8_t telemetry_commands_group = 8; 00006 static constexpr uint8_t last_telemetry_command_id = 2; 00007 static constexpr uint8_t last_sensor_command_id = 3;

00032 std::vector<Frame> handle_get_last_telemetry_record([[maybe_unused]] const std::string& param, OperationType operationType) {
std::vector<Frame> frames;
std::string error_msg;

if (operationType != OperationType::GET) {
if (!(param.empty())) {
error_msg = error_code_to_string(ErrorCode::PARAM_UNNECESSARY); frames.push_back(frame_build(OperationType::ERR, telemetry_commands_group, last_telemetry_command_id, error_msg));
return frames;
}
error_msg = error_code_to_string(ErrorCode::INVALID_OPERATION); frames.push_back(frame_build(OperationType::ERR, telemetry_commands_group, last_telemetry_command_id, error_msg));
return frames;
}

std::string csv_data = TelemetryManager::get_instance().get_last_telemetry_record_csv(); sleep_ms(10);

if (csv_data.empty()) {

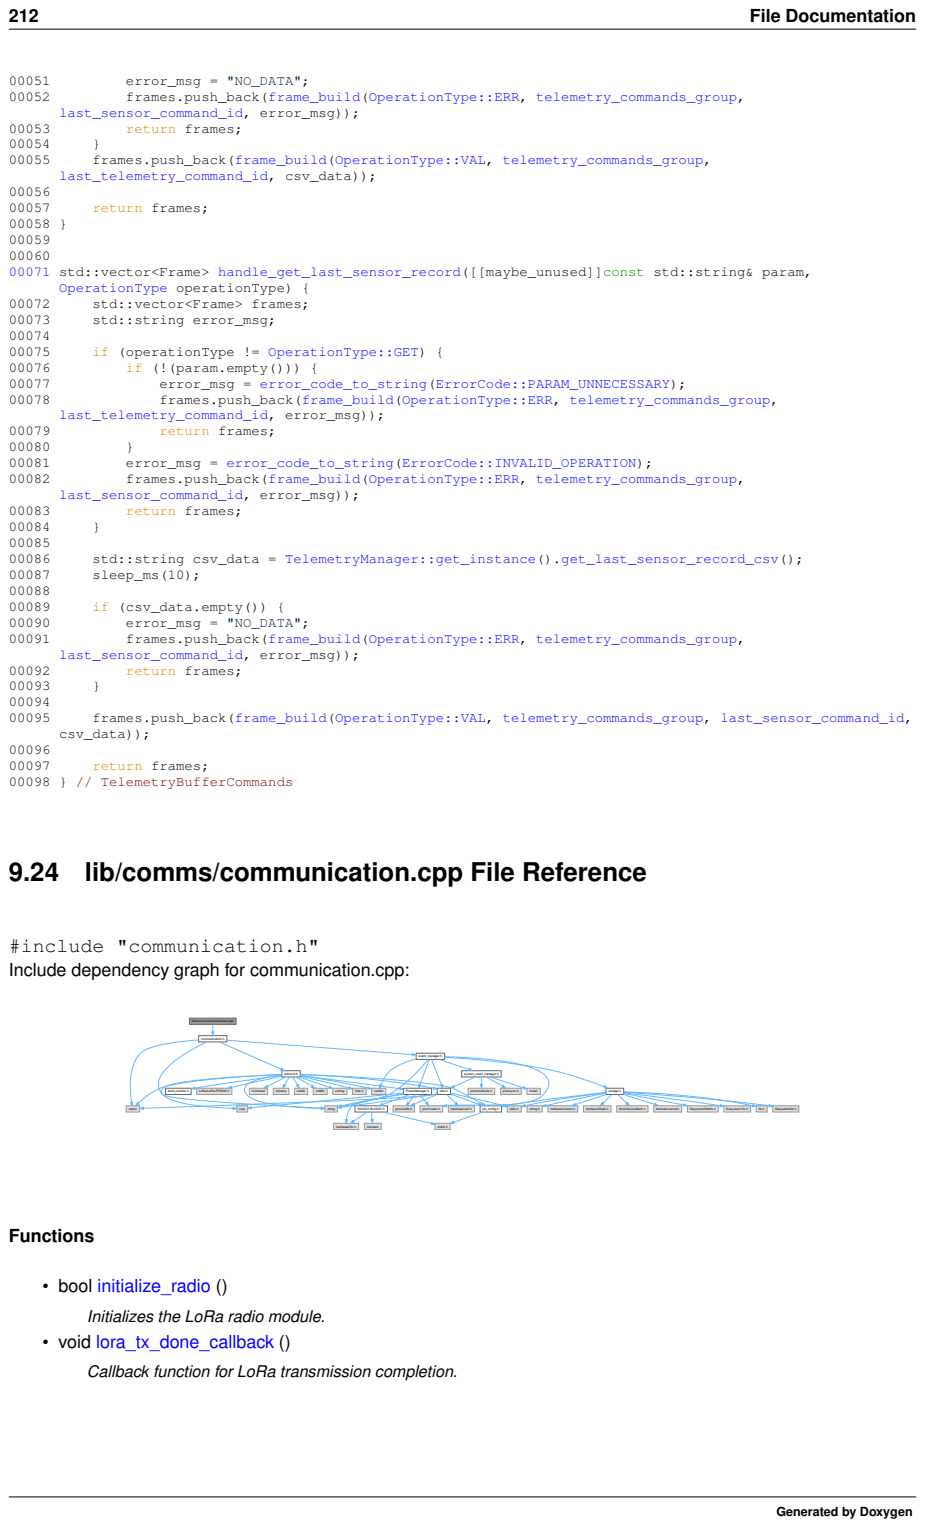
[picture p78: page 234]
212 File Documentation; error_msg = "NO_DATA";; frames.push_back(frame_build(OperationType::ERR, telemetry_commands_group,; last_sensor_command_id, error_msg));; return frames;; frames.push_back(frame_build(OperationType::VAL, telemetry_commands_group,; last_telemetry_command_id, csv_data));; 00058 } 00059 00060 00071 std::vector<Frame> handle_get_last_sensor_record([[maybe_unused]]const std::string& param, OperationType operationType) {; std::vector<Frame> frames;; std::string error_msg;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

9.24 lib/comms/communication.cpp File Reference

#include "communication.h"
Include dependency graph for communication.cpp:

lib/comms/communication.cpp

Initializes the LoRa radio module.
• void lora_tx_done_callback ()

Callback function for LoRa transmission completion.

9.24 lib/comms/communication.cpp File Reference | 213

### 9.24.1 Function Documentation

### 9.24.1.1 initialize_radio()

bool initialize_radio ()

Initializes the LoRa radio module.

Returns

True if initialization was successful, false otherwise.

Sets the LoRa pins and attempts to begin LoRa communication at a specified frequency. Emits a CommsEvent::RADIO_INIT event on success or a CommsEvent::RADIO_ERROR event on failure.

Definition at line 9 of file communication.cpp.

Here is the call graph for this function:

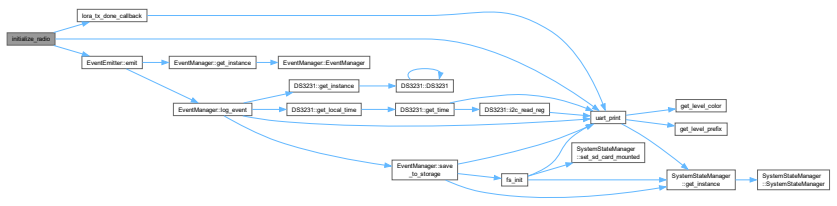
[picture p79: figure]
initialize_radio; EventEmitter::emit; uart_print; lora_tx_done_callback; EventManager::get_instance; EventManager::log_event; EventManager::EventManager; DS3231::get_instance; DS3231::get_local_time; EventManager::save _to_storage; DS3231::get_time; DS3231::i2c_read_reg; SystemStateManager ::get_instance; get_level_color; get_level_prefix; SystemStateManager ::SystemStateManager fs_init; SystemStateManager ::set_sd_card_mounted

Here is the caller graph for this function:

main | init_modules | initialize_radio

### 9.24.1.2 lora_tx_done_callback()

void lora_tx_done_callback ()

Callback function for LoRa transmission completion.

Prints a debug message to the UART and sets the LoRa module to receive mode.

Definition at line 36 of file communication.cpp.

214 File Documentation

Here is the call graph for this function:

lora_tx_done_callback | uart_print

SystemStateManager
::get_instance

get_level_color

get_level_prefix

SystemStateManager
::SystemStateManager

Here is the caller graph for this function:

main | init_modules | initialize_radio | lora_tx_done_callback

## 9.25 communication.cpp

Go to the documentation of this file.

00001 #include "communication.h"
00002
00009 bool initialize_radio() {
00010 | LoRa.set_pins(lora_cs_pin, lora_reset_pin, lora_irq_pin);
00011 | long frequency = 433E6;
00012 | bool init_status = false;
00013 | if (!LoRa.begin(frequency))
00014 | {
00015 | uart_print("LoRa init failed. Check your connections.", VerbosityLevel::WARNING);
00016 | init_status = false;
00017 | } else {
00018 | uart_print("LoRa initialized with frequency " + std::to_string(frequency),
| VerbosityLevel::INFO);
00019
00020 | LoRa.onTxDone(lora_tx_done_callback);
00021
00022 | LoRa.receive(0);
00023
00024 | init_status = true;
00025 | }
00026
00027 | EventEmitter::emit(EventGroup::COMMS, init_status ? CommsEvent::RADIO_INIT :
| CommsEvent::RADIO_ERROR);
00028
00029 | return init_status;
00030 }
00031
00036 void lora_tx_done_callback() {
00037 | uart_print("LoRa transmission complete", VerbosityLevel::DEBUG);
00038 | LoRa.receive(0);
00039 }

## 9.26 lib/comms/communication.h File Reference

#include <string>

#include <vector>

9.26 lib/comms/communication.h File Reference | 215

#include "protocol.h"

#include "event_manager.h" Include dependency graph for communication.h:

lib/comms/communication.h

vector | string

protocol.h

event_manager.h

map

functional | iomanip | cstdint

pin_config.h

build_number.h | LoRa/LoRa-RP2040.h | cstdio | cstdlib | cstring | time.h | PowerManager.h | utils.h

stdint.h

INA3221/INA3221.h

hardware/i2c.h

pico/stdlib.h | pico/mutex.h

iostream

hardware/uart.h | stdio.h

storage.h

system_state_manager.h

string.h | hardware/clocks.h | hardware/flash.h | blockdevice/flash.h | blockdevice/sd.h | filesystem/littlefs.h | filesystem/vfs.h | lfs.h | filesystem/fat.h
pico/multicore.h | pico/sync.h | mutex

This graph shows which files directly or indirectly include this file:

lib/comms/communication.h

includes.h

lib/comms/commands
/clock_commands.cpp

lib/comms/commands
/commands.cpp

lib/comms/commands
/diagnostic_commands.cpp

lib/comms/commands
/event_commands.cpp

lib/comms/commands
/gps_commands.cpp

lib/comms/commands
/telemetry_commands.cpp
lib/comms/communication.cpp | lib/comms/frame.cpp | lib/comms/receive.cpp | lib/comms/send.cpp | lib/comms/utils_converters.cpp | lib/eventman/event _manager.cpp

lib/telemetry/telemetry
_manager.cpp

lib/telemetry/telemetry
_manager.h

main.cpp

Functions

- bool initialize_radio ()

Initializes the LoRa radio module.
- void lora_tx_done_callback ()

Callback function for LoRa transmission completion.
- void on_receive (int packetSize)

Callback function for handling received LoRa packets.
- void handle_uart_input ()

Handles UART input.
- void send_message (std::string outgoing)

Sends a message using LoRa.
- void send_frame_uart (const Frame &frame)
- void send_frame_lora (const Frame &frame)
- std::vector< Frame > execute_command (uint32_t commandKey, const std::string &param, OperationType operationType)

Executes a command based on its key.
- void frame_process (const std::string &data, Interface interface)

Executes a command based on the command key and the parameter.
- std::string frame_encode (const Frame &frame)

Encodes a Frame instance into a string.
- Frame frame_decode (const std::string &data)

Decodes a string into a Frame instance.
- Frame frame_build (OperationType operation, uint8_t group, uint8_t command, const std::string &value, const ValueUnit unitType=ValueUnit::UNDEFINED)

Builds a Frame instance based on the execution result, group, command, value, and unit.

216 File Documentation

### 9.26.1 Function Documentation

### 9.26.1.1 initialize_radio()

bool initialize_radio ()

Initializes the LoRa radio module.

Returns

True if initialization was successful, false otherwise.

Sets the LoRa pins and attempts to begin LoRa communication at a specified frequency. Emits a CommsEvent::RADIO_INIT event on success or a CommsEvent::RADIO_ERROR event on failure.

Definition at line 9 of file communication.cpp.

Here is the call graph for this function:

Here is the caller graph for this function:

main | init_modules | initialize_radio

### 9.26.1.2 lora_tx_done_callback()

void lora_tx_done_callback ()

Callback function for LoRa transmission completion.

Prints a debug message to the UART and sets the LoRa module to receive mode.

Definition at line 36 of file communication.cpp.

9.26 lib/comms/communication.h File Reference | 217

Here is the call graph for this function:

lora_tx_done_callback | uart_print

SystemStateManager
::get_instance

get_level_color

get_level_prefix

SystemStateManager
::SystemStateManager

Here is the caller graph for this function:

main | init_modules | initialize_radio | lora_tx_done_callback

### 9.26.1.3 on_receive()

void on_receive (

int packet_size)

Callback function for handling received LoRa packets.

Parameters

packet_size The size of the received packet.

Reads the received LoRa packet, extracts metadata, validates addresses, and processes any frames found in the data.

Definition at line 92 of file receive.cpp.

Here is the call graph for this function:

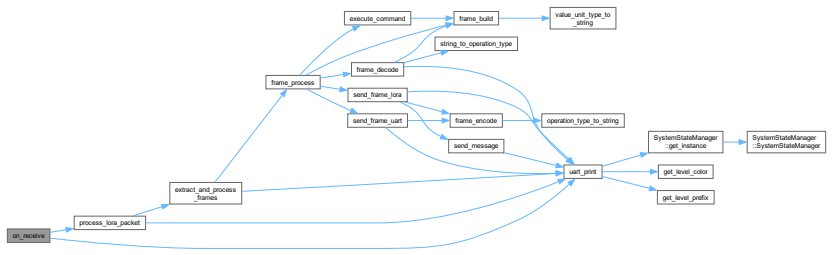
[picture p80: figure]
on_receive; process_lora_packet; uart_print; extract_and_process _frames; frame_process; execute_command; frame_build; frame_decode; send_frame_lora; send_frame_uart; value_unit_type_to _string; string_to_operation_type; SystemStateManager ::get_instance; get_level_color; get_level_prefix; SystemStateManager ::SystemStateManager; frame_encode; send_message; operation_type_to_string

218 File Documentation

Here is the caller graph for this function:

main | on_receive

### 9.26.1.4 handle_uart_input()

void handle_uart_input ()

Handles UART input.

Reads characters from the UART port, appends them to a buffer, and processes the buffer when a newline character is received, looking for valid frames in the received data.

Definition at line 121 of file receive.cpp.

Here is the call graph for this function:

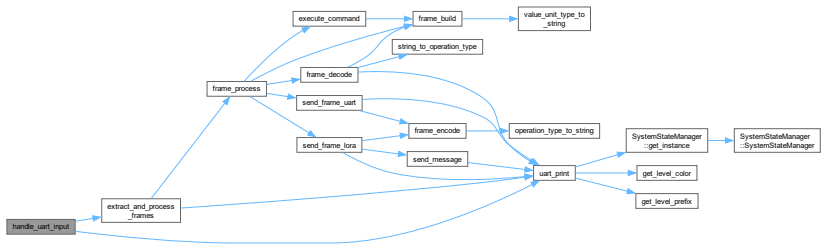
[picture p81: figure]
handle_uart_input; extract_and_process _frames; uart_print; frame_process; execute_command; frame_build; frame_decode; send_frame_lora; send_frame_uart; value_unit_type_to _string; string_to_operation_type; SystemStateManager ::get_instance; get_level_color; get_level_prefix; SystemStateManager ::SystemStateManager; frame_encode; send_message; operation_type_to_string

Here is the caller graph for this function:

main | handle_uart_input

### 9.26.1.5 send_message()

void send_message (

std::string outgoing)

Sends a message using LoRa.

9.26 lib/comms/communication.h File Reference | 219

Parameters

outgoing The message to send.

Converts the outgoing string to a C-style string, adds destination and local addresses, and sends the message using LoRa. Prints a log message to the UART.

Definition at line 15 of file send.cpp.

Here is the call graph for this function:

Here is the caller graph for this function:

send_frame_lora | send_message

frame_process

main

init_modules

extract_and_process
_frames

handle_uart_input

on_receive | process_lora_packet

### 9.26.1.6 send_frame_uart()

void send_frame_uart (

const Frame & frame)

Definition at line 49 of file send.cpp.

Here is the call graph for this function:

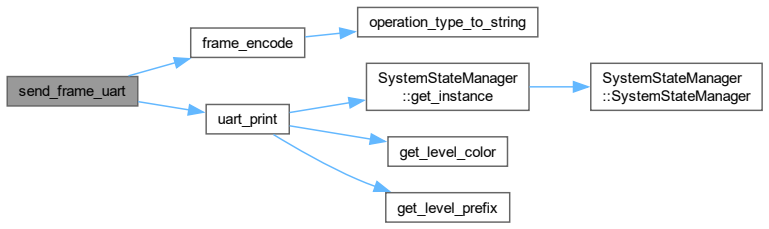
[picture p82: figure]
send_frame_uart; frame_encode; uart_print; operation_type_to_string; SystemStateManager ::get_instance; get_level_color; get_level_prefix; SystemStateManager ::SystemStateManager

220 File Documentation

Here is the caller graph for this function:

frame_process | send_frame_uart extract_and_process
_frames

handle_uart_input

process_lora_packet

main
on_receive

### 9.26.1.7 send_frame_lora()

void send_frame_lora (

const Frame & frame)

Definition at line 41 of file send.cpp.

Here is the call graph for this function:

send_frame_lora

frame_encode

send_message

uart_print

operation_type_to_string | SystemStateManager
| ::get_instance

get_level_color

get_level_prefix

SystemStateManager
::SystemStateManager

Here is the caller graph for this function:

send_frame_lora

frame_process

main

init_modules

extract_and_process
_frames

handle_uart_input

on_receive | process_lora_packet

## 9.27 communication.h

Go to the documentation of this file.

00001 #ifndef COMMUNICATION_H 00002 #define COMMUNICATION_H 00003
00004 #include <string>
00005 #include <vector>
00006 #include "protocol.h" 00007 #include "event_manager.h" 00008
00009 bool initialize_radio();
00010 void lora_tx_done_callback();
00011 void on_receive(int packetSize);
00012 void handle_uart_input();
00013 void send_message(std::string outgoing);

9.28 lib/comms/frame.cpp File Reference | 221

00014 void send_frame_uart(const Frame& frame);
00015 void send_frame_lora(const Frame& frame);
00016
00017 std::vector<Frame> execute_command(uint32_t commandKey, const std::string& param, OperationType operationType);
00018
00019 void frame_process(const std::string& data, Interface interface);
00020 std::string frame_encode(const Frame& frame);
00021 Frame frame_decode(const std::string& data);
00022 Frame frame_build(OperationType operation, uint8_t group, uint8_t command,const std::string& value, const ValueUnit unitType = ValueUnit::UNDEFINED);
00023
00024 #endif

## 9.28 lib/comms/frame.cpp File Reference

Implements functions for encoding, decoding, building, and processing Frames.

#include "communication.h"

Include dependency graph for frame.cpp:

lib/comms/frame.cpp

communication.h

vector | string

protocol.h

event_manager.h

map

functional | iomanip | cstdint

pin_config.h

build_number.h | LoRa/LoRa-RP2040.h | cstdio | cstdlib | cstring | time.h | PowerManager.h | utils.h

stdint.h

INA3221/INA3221.h

hardware/i2c.h

pico/stdlib.h | pico/mutex.h

iostream

hardware/uart.h | stdio.h

storage.h

system_state_manager.h

string.h | hardware/clocks.h | hardware/flash.h | blockdevice/flash.h | blockdevice/sd.h | filesystem/littlefs.h | filesystem/vfs.h | lfs.h | filesystem/fat.h
pico/multicore.h | pico/sync.h | mutex

Typedefs

- using CommandHandler = std::function<std::vector<Frame>(const std::string&, OperationType)>

Functions

- std::string frame_encode (const Frame &frame)

Encodes a Frame instance into a string.
- Frame frame_decode (const std::string &data)

Decodes a string into a Frame instance.
- void frame_process (const std::string &data, Interface interface)

Executes a command based on the command key and the parameter.
- Frame frame_build (OperationType operation, uint8_t group, uint8_t command, const std::string &value, const ValueUnit unitType)

Builds a Frame instance based on the execution result, group, command, value, and unit.

Variables

- std::map< uint32_t, CommandHandler > command_handlers

Global map of all command handlers.

### 9.28.1 Detailed Description

Implements functions for encoding, decoding, building, and processing Frames.

Definition in file frame.cpp.

222 File Documentation

### 9.28.2 Typedef Documentation

### 9.28.2.1 CommandHandler

using CommandHandler = std::function<std::vector<Frame>(const std::string&, OperationType)>

Definition at line 3 of file frame.cpp.

## 9.29 frame.cpp

Go to the documentation of this file.

00001 #include "communication.h"

00003 using CommandHandler = std::function<std::vector<Frame>(const std::string&, OperationType)>; 00004 extern std::map<uint32_t, CommandHandler> command_handlers;

00036 std::string frame_encode(const Frame& frame) { std::stringstream ss;
ss « static_cast<int>(frame.direction) « DELIMITER
« operation_type_to_string(frame.operationType) « DELIMITER « static_cast<int>(frame.group) « DELIMITER
« static_cast<int>(frame.command) « DELIMITER
« frame.value;

if (!frame.unit.empty()) {
ss « DELIMITER « frame.unit;
}

return FRAME_BEGIN + DELIMITER + ss.str() + DELIMITER + FRAME_END; 00049 }

00061 Frame frame_decode(const std::string& data) { Frame frame;
frame.header = FRAME_BEGIN; frame.footer = FRAME_END;
try {
std::stringstream ss(data);
std::string token;

uart_print("Decoding frame: " + data, VerbosityLevel::WARNING);

if (!std::getline(ss, token, DELIMITER) || token != FRAME_BEGIN) { throw std::runtime_error("DECODE_INVALID_HEADER");
}

std::getline(ss, token, DELIMITER);
int direction = std::stoi(token);
if (direction != 0 && direction != 1) {
throw std::runtime_error("DECODE_INVALID_DIR"); }
frame.direction = direction;

if (!std::getline(ss, token, DELIMITER)) {
throw std::runtime_error("DECODE_MISSING_OP");
}
frame.operationType = string_to_operation_type(token);

if (!std::getline(ss, token, DELIMITER)) {
throw std::runtime_error("DECODE_MISSING_GROUP"); }
int group = std::stoi(token);
if (group < 0 || group > 10) {
throw std::runtime_error("DECODE_INVALID_GROUP"); }
frame.group = group;

if (!std::getline(ss, token, DELIMITER)) {
throw std::runtime_error("DECODE_MISSING_CMD"); }
int command = std::stoi(token);
if (command < 0 || command > 10) {
throw std::runtime_error("DECODE_INVALID_CMD"); }
frame.command = command;

9.29 frame.cpp | 223

if (!std::getline(ss, token, DELIMITER)) frame.value = ""; else frame.value = token;

if (!std::getline(ss, token, DELIMITER)) frame.unit = ""; else frame.unit = token;

std::getline(ss, token, DELIMITER);
if (token != FRAME_END) {
throw std::runtime_error("DECODE_INVALID_FOOTER"); }
frame.footer = token;

return frame;

} catch (const std::exception& e) {
uart_print("Frame decode error: " + std::string(e.what()), VerbosityLevel::ERROR); return frame_build(OperationType::ERR, 0, 0, e.what());
}
00123 }

00131 void frame_process(const std::string& data, Interface interface) { gpio_put(PICO_DEFAULT_LED_PIN, false);

try {
Frame frame = frame_decode(data);
uint32_t command_key = (static_cast<uint32_t>(frame.group) « 8) | static_cast<uint32_t>(frame.command);

std::vector<Frame> response_frames = execute_command(command_key, frame.value, frame.operationType);

gpio_put(PICO_DEFAULT_LED_PIN, true);

// Send all responses through the same interface that received the command for (const auto& response_frame : response_frames) {
if (interface == Interface::UART) {
send_frame_uart(response_frame);
} else if (interface == Interface::LORA) { send_frame_lora(response_frame); sleep_ms(25);
}
}
} catch (const std::exception& e) {
Frame error_frame = frame_build(OperationType::ERR, 0, 0, e.what()); if (interface == Interface::UART) {
send_frame_uart(error_frame);
} else if (interface == Interface::LORA) { send_frame_lora(error_frame);
}
}
00159 }

00171 Frame frame_build(OperationType operation, uint8_t group, uint8_t command, const std::string& value, const ValueUnit unitType) { Frame frame;
frame.header = FRAME_BEGIN; frame.footer = FRAME_END;

switch (operation) {
case OperationType::VAL:
frame.direction = 1;
frame.operationType = OperationType::VAL; frame.value = value;
frame.unit = value_unit_type_to_string(unitType); break;

case OperationType::ERR:
frame.direction = 1;
frame.operationType = OperationType::ERR;
frame.value = value;
frame.unit = value_unit_type_to_string(ValueUnit::UNDEFINED); break;

case OperationType::RES:
frame.direction = 1;
frame.operationType = OperationType::RES; frame.value = value;
frame.unit = value_unit_type_to_string(unitType); break;

case OperationType::SEQ:
frame.direction = 1;
frame.operationType = OperationType::SEQ; frame.value = value;
frame.unit = value_unit_type_to_string(unitType); break;

## 9.30 lib/comms/protocol.h File Reference

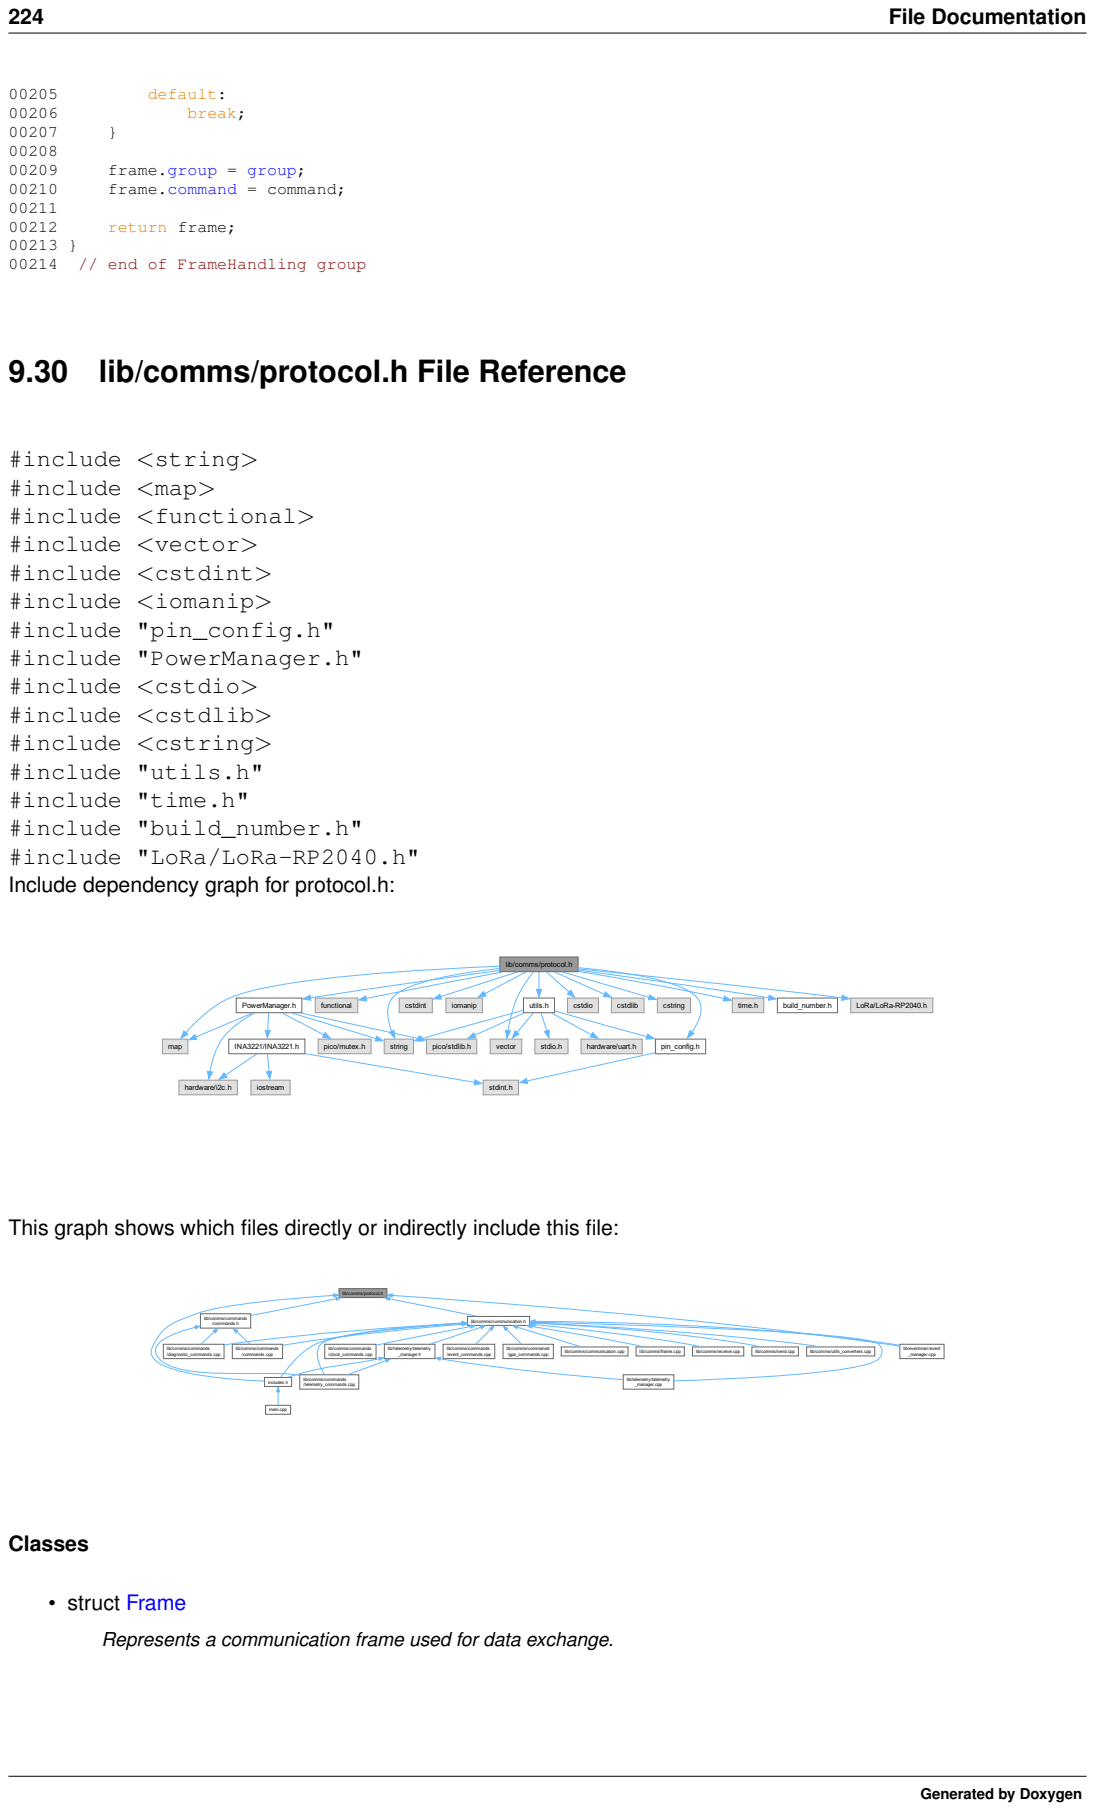
[picture p83: page 246]
224 File Documentation; default:; break;; frame.group = group;; frame.command = command;; return frame;; // end of FrameHandling group; map; string; functional; vector; cstdint; iomanip; pin_config.h; PowerManager.h; utils.h; cstdio; cstdlib; cstring; time.h; build_number.h; LoRa/LoRa-RP2040.h; stdint.h; INA3221/INA3221.h; hardware/i2c.h; pico/mutex.h; pico/stdlib.h; iostream; stdio.h; hardware/uart.h; includes.h; /commands.h; lib/comms/communication.h; main.cpp; /gps_commands.cpp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

#include <string>
#include <map>
#include <functional>
#include <vector>
#include <cstdint>
#include <iomanip>
#include "pin_config.h"
#include "PowerManager.h"
#include <cstdio>
#include <cstdlib>
#include <cstring>
#include "utils.h"
#include "time.h"
#include "build_number.h"
#include "LoRa/LoRa-RP2040.h"
Include dependency graph for protocol.h:

lib/comms/protocol.h

This graph shows which files directly or indirectly include this file:

lib/comms/commands

/diagnostic_commands.cpp

/commands.cpp

/clock_commands.cpp

lib/telemetry/telemetry
_manager.h

/event_commands.cpp

lib/eventman/event
_manager.cpp

/telemetry_commands.cpp

Represents a communication frame used for data exchange.

9.30 lib/comms/protocol.h File Reference | 225

Enumerations

- enum class ErrorCode : uint8_t {
ErrorCode::PARAM_UNNECESSARY , ErrorCode::PARAM_REQUIRED , ErrorCode::PARAM_INVALID , ErrorCode::INVALID_OPERATION ,
ErrorCode::NOT_ALLOWED , ErrorCode::INVALID_FORMAT , ErrorCode::INVALID_VALUE , ErrorCode::FAIL_TO_SET ,
ErrorCode::INTERNAL_FAIL_TO_READ , ErrorCode::UNKNOWN_ERROR }

Standard error codes for command responses.
- enum class OperationType : uint8_t {
OperationType::GET , OperationType::SET , OperationType::RES , OperationType::VAL , OperationType::SEQ , OperationType::ERR }

Represents the type of operation being performed.
- enum class ValueUnit : uint8_t {
ValueUnit::UNDEFINED , ValueUnit::SECOND , ValueUnit::VOLT , ValueUnit::BOOL , ValueUnit::DATETIME , ValueUnit::TEXT , ValueUnit::MILIAMP , ValueUnit::CELSIUS }

Represents the unit of measurement for a payload value.
- enum class Interface : uint8_t { Interface::UART , Interface::LORA }

Represents the communication interface being used.

Functions

- std::string error_code_to_string (ErrorCode code)

Converts an ErrorCode to its string representation.
- std::string operation_type_to_string (OperationType type)

Converts an OperationType to a string.
- OperationType string_to_operation_type (const std::string &str)

Converts a string to an OperationType.
- std::string value_unit_type_to_string (ValueUnit unit)

Converts a ValueUnit to a string.

Variables

- const std::string FRAME_BEGIN = "KBST"
- const std::string FRAME_END = "TSBK"
- const char DELIMITER = ';'

### 9.30.1 Variable Documentation

### 9.30.1.1 FRAME_BEGIN

const std::string FRAME_BEGIN = "KBST"

Definition at line 31 of file protocol.h.

### 9.30.1.2 FRAME_END

const std::string FRAME_END = "TSBK"

Definition at line 38 of file protocol.h.

226 File Documentation

### 9.30.1.3 DELIMITER

const char DELIMITER = ';'

Definition at line 45 of file protocol.h.

## 9.31 protocol.h

Go to the documentation of this file.

00001 // protocol.h
00002 #ifndef PROTOCOL_H
00003 #define PROTOCOL_H
00004
00005 #include <string>
00006 #include <map>
00007 #include <functional> 00008 #include <vector>
00009 #include <cstdint>
00010 #include <iomanip>
00011 #include "pin_config.h" 00012 #include "PowerManager.h" 00013 #include <cstdio>
00014 #include <cstdlib>
00015 #include <map>
00016 #include <cstring>
00017 #include "utils.h"
00018 #include "time.h"
00019 #include "build_number.h"
00020 #include "LoRa/LoRa-RP2040.h"
00021
00031 const std::string FRAME_BEGIN = "KBST"; 00032
00038 const std::string FRAME_END = "TSBK"; 00039
00045 const char DELIMITER = ’;’;
00046
00047
00053 enum class ErrorCode : uint8_t {
00054 | PARAM_UNNECESSARY, | // Parameter provided but not needed
00055 | PARAM_REQUIRED, | // Required parameter missing
00056 | PARAM_INVALID, | // Parameter has invalid format or value
00057 | INVALID_OPERATION, | // Operation not allowed for this command
00058 | NOT_ALLOWED, | // Operation not permitted
00059 | INVALID_FORMAT, | // Input format is incorrect
00060 | INVALID_VALUE, | // Value is outside expected range
00061 | FAIL_TO_SET, | // Failed to set provided value
00062 | INTERNAL_FAIL_TO_READ,// Failed to read from device in remote
00063 | UNKNOWN_ERROR | // Generic error
00064 };
00065
00066
00072 enum class OperationType : uint8_t {
00074 | GET,
00076 | SET,
00078 | RES,
00080 | VAL,
00082 | SEQ,
00084 | ERR,
00085
00086 };
00087
00088
00094 enum class ValueUnit : uint8_t {
00096 | UNDEFINED,
00098 | SECOND,
00100 | VOLT,
00102 | BOOL,
00104 | DATETIME,
00106 | TEXT,
00108 | MILIAMP,
00110 | CELSIUS,
00111 };
00112
00113
00119 enum class Interface : uint8_t {
00121 | UART,
00123 | LORA
00124 };

9.32 lib/comms/receive.cpp File Reference | 227

00125
00126
00143 struct Frame {
00144 | std::string header; | // Start marker
00145 | uint8_t direction; | // 0 = ground->sat, 1 = sat->ground
00146 | OperationType operationType;
00147 | uint8_t group; | // Group ID
00148 | uint8_t command; | // Command ID within group
00149 | std::string value; | // Payload value
00150 | std::string unit; | // Payload unit
00151 | std::string footer; | // End marker
00152 };
00153
00154 std::string error_code_to_string(ErrorCode code);
00155 std::string operation_type_to_string(OperationType type); 00156 OperationType string_to_operation_type(const std::string& str); 00157 std::string value_unit_type_to_string(ValueUnit unit);
00158
00159 #endif
00160

## 9.32 lib/comms/receive.cpp File Reference

#include "communication.h" Include dependency graph for receive.cpp:

lib/comms/receive.cpp

communication.h

vector | string

protocol.h

event_manager.h

map

functional | iomanip | cstdint

pin_config.h

build_number.h | LoRa/LoRa-RP2040.h | cstdio | cstdlib | cstring | time.h | PowerManager.h | utils.h

stdint.h

INA3221/INA3221.h

hardware/i2c.h

pico/stdlib.h | pico/mutex.h

iostream

hardware/uart.h | stdio.h

storage.h

system_state_manager.h

string.h | hardware/clocks.h | hardware/flash.h | blockdevice/flash.h | blockdevice/sd.h | filesystem/littlefs.h | filesystem/vfs.h | lfs.h | filesystem/fat.h
pico/multicore.h | pico/sync.h | mutex

Macros

- #define MAX_PACKET_SIZE 255

Functions

- bool extract_and_process_frames (const std::string &buffer, Interface interface)

Extract and process frames from a buffer.
- bool process_lora_packet (const std::vector< uint8_t > &buffer, int bytes_read)

Process LoRa packet metadata and extract frame data.
- void on_receive (int packet_size)

Callback function for handling received LoRa packets.
- void handle_uart_input ()

Handles UART input.

### 9.32.1 Macro Definition Documentation

### 9.32.1.1 MAX_PACKET_SIZE

#define MAX_PACKET_SIZE 255

Definition at line 3 of file receive.cpp.

228 File Documentation

### 9.32.2 Function Documentation

### 9.32.2.1 extract_and_process_frames()

bool extract_and_process_frames (

const std::string & buffer,

Interface interface)

Extract and process frames from a buffer.

Parameters

buffer | The buffer containing potential frame data
interface | The interface the data was received on (UART or LoRa)

Returns

bool True if at least one valid frame was found and processed

Definition at line 12 of file receive.cpp.

Here is the call graph for this function:

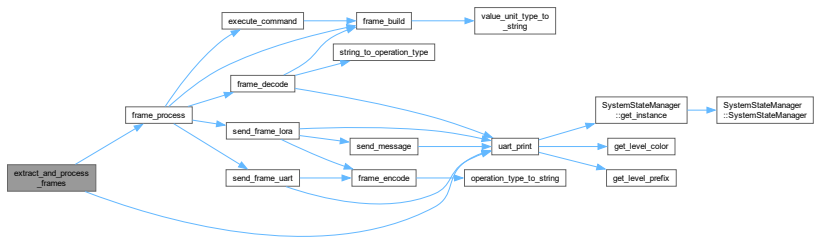
[picture p84: figure]
extract_and_process _frames; frame_process; uart_print; execute_command; frame_build; frame_decode; send_frame_lora; send_frame_uart; value_unit_type_to _string; string_to_operation_type; SystemStateManager ::get_instance; get_level_color; get_level_prefix; SystemStateManager ::SystemStateManager; frame_encode; send_message; operation_type_to_string

Here is the caller graph for this function:

extract_and_process
_frames

handle_uart_input

process_lora_packet

main
on_receive

### 9.32.2.2 process_lora_packet()

bool process_lora_packet (

const std::vector< uint8_t > & buffer,

int bytes_read)

Process LoRa packet metadata and extract frame data.

9.32 lib/comms/receive.cpp File Reference | 229

Parameters

buffer | The raw buffer containing the LoRa packet
bytes_read | The number of bytes in the buffer

Returns

bool True if packet was valid and processed

Definition at line 48 of file receive.cpp.

Here is the call graph for this function:

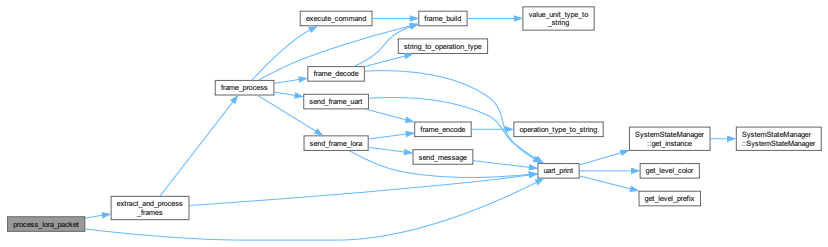
[picture p85: figure]
process_lora_packet; extract_and_process _frames; uart_print; frame_process; execute_command; frame_build; frame_decode; send_frame_lora; send_frame_uart; value_unit_type_to _string; string_to_operation_type; SystemStateManager ::get_instance; get_level_color; get_level_prefix; SystemStateManager ::SystemStateManager; frame_encode; send_message; operation_type_to_string

Here is the caller graph for this function:

main | on_receive | process_lora_packet

### 9.32.2.3 on_receive()

void on_receive (

int packet_size)

Callback function for handling received LoRa packets.

Parameters

packet_size The size of the received packet.

230 File Documentation

Reads the received LoRa packet, extracts metadata, validates addresses, and processes any frames found in the data.

Definition at line 92 of file receive.cpp.

Here is the call graph for this function:

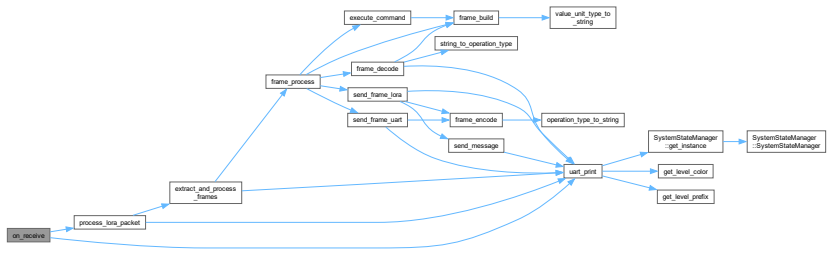
[picture p86: figure]
on_receive; process_lora_packet; uart_print; extract_and_process _frames; frame_process; execute_command; frame_build; frame_decode; send_frame_lora; send_frame_uart; value_unit_type_to _string; string_to_operation_type; SystemStateManager ::get_instance; get_level_color; get_level_prefix; SystemStateManager ::SystemStateManager; frame_encode; send_message; operation_type_to_string

Here is the caller graph for this function:

main | on_receive

### 9.32.2.4 handle_uart_input()

void handle_uart_input ()

Handles UART input.

Reads characters from the UART port, appends them to a buffer, and processes the buffer when a newline character is received, looking for valid frames in the received data.

Definition at line 121 of file receive.cpp.

Here is the call graph for this function:

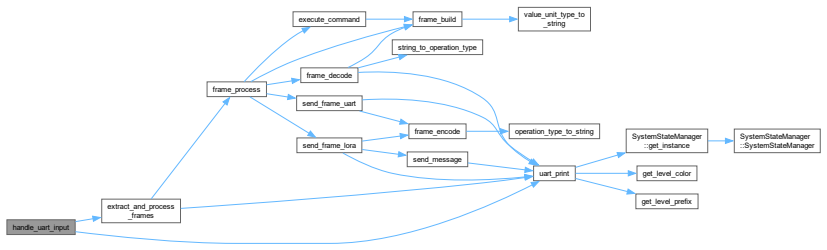
[picture p87: figure]
handle_uart_input; extract_and_process _frames; uart_print; frame_process; execute_command; frame_build; frame_decode; send_frame_lora; send_frame_uart; value_unit_type_to _string; string_to_operation_type; SystemStateManager ::get_instance; get_level_color; get_level_prefix; SystemStateManager ::SystemStateManager; frame_encode; send_message; operation_type_to_string

9.33 receive.cpp | 231

Here is the caller graph for this function:

main | handle_uart_input

## 9.33 receive.cpp

Go to the documentation of this file.

00001 #include "communication.h"

00003 #define MAX_PACKET_SIZE 255

00012 bool extract_and_process_frames(const std::string& buffer, Interface interface) { size_t search_pos = 0;
bool found_frame = false;

while (search_pos < buffer.length()) {
size_t header_pos = buffer.find(FRAME_BEGIN, search_pos); if (header_pos == std::string::npos) break;

size_t footer_pos = buffer.find(FRAME_END, header_pos); if (footer_pos == std::string::npos) break;

if (footer_pos > header_pos) {
std::string frame_data = buffer.substr(header_pos, footer_pos + FRAME_END.length() -header_pos);
uart_print("Extracted frame (length=" + std::to_string(frame_data.length()) +
"): " + frame_data, VerbosityLevel::DEBUG); frame_process(frame_data, interface);
found_frame = true;
}

search_pos = footer_pos + FRAME_END.length(); }

if (!found_frame) {
uart_print("No valid frame found in received data", VerbosityLevel::WARNING); }

return found_frame;
00039 }

00048 bool process_lora_packet(const std::vector<uint8_t>& buffer, int bytes_read) { if (bytes_read < 2) {
uart_print("Error: Packet too small to contain metadata!", VerbosityLevel::ERROR); return false;
}

uint8_t received_destination = buffer[0]; uint8_t received_local_address = buffer[1];

if (received_destination != lora_address_local) {
uart_print("Error: Destination address mismatch!", VerbosityLevel::ERROR); return false;
}

if (received_local_address != lora_address_remote) { uart_print("Error: Local address mismatch!", VerbosityLevel::ERROR); return false;
}

// Skip 2 bytes being local and remote address appended by ground station int start_index = 2;
std::string received(buffer.begin() + start_index, buffer.end());

if (received.empty()) return false;

std::stringstream hex_dump;

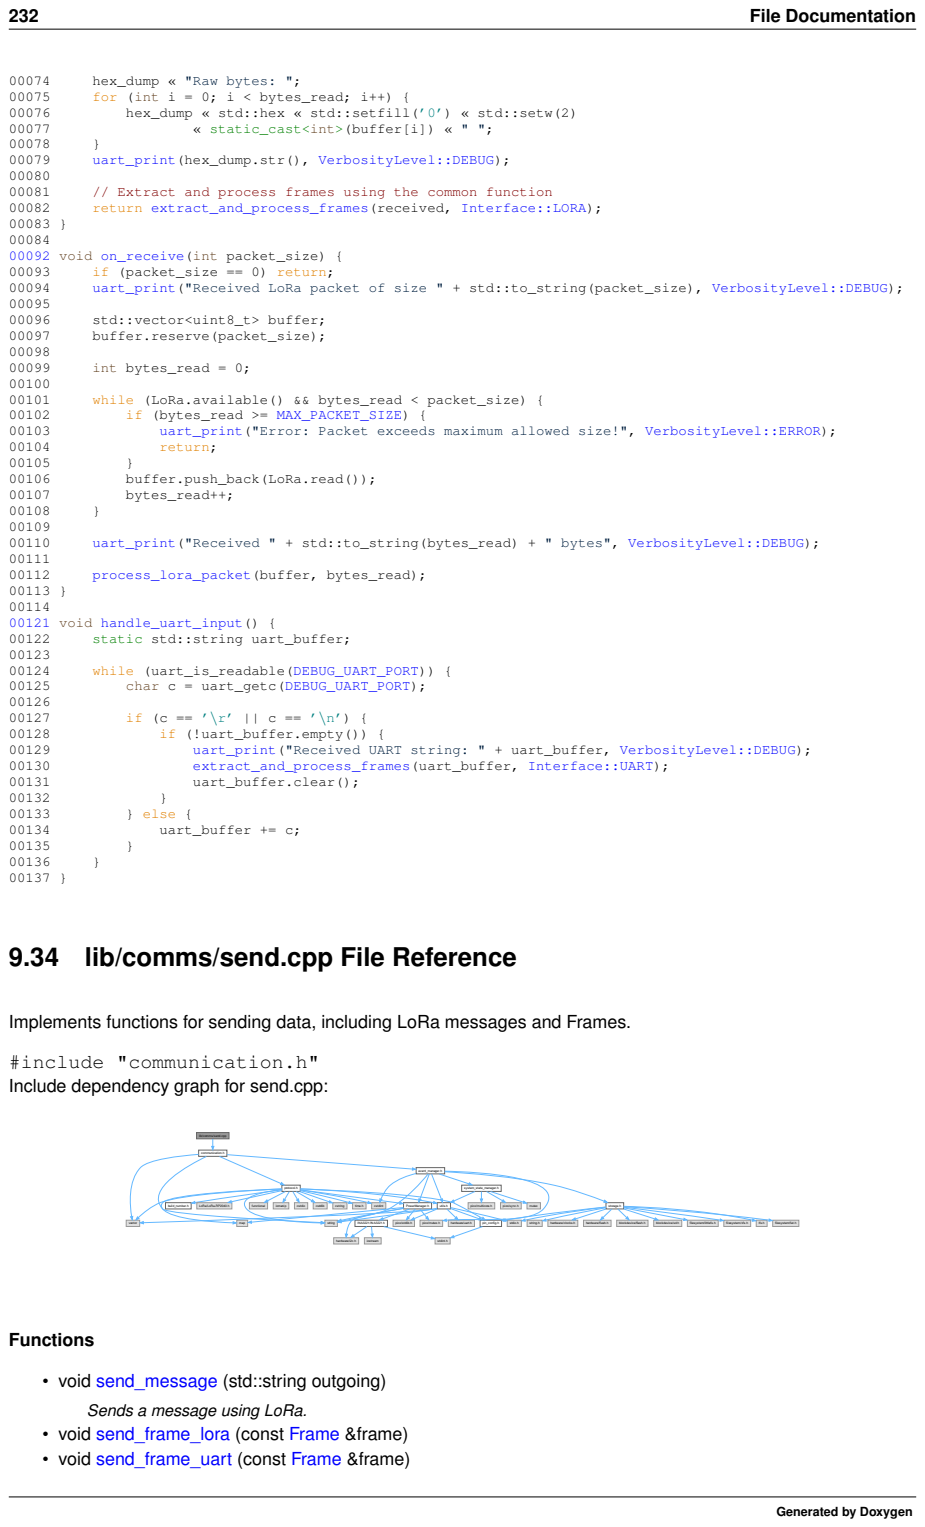
[picture p88: page 254]
232 File Documentation; hex_dump « "Raw bytes: ";; for (int i = 0; i < bytes_read; i++) {; hex_dump « std::hex « std::setfill(’0’) « std::setw(2); « static_cast<int>(buffer[i]) « " ";; uart_print(hex_dump.str(), VerbosityLevel::DEBUG);; // Extract and process frames using the common function; return extract_and_process_frames(received, Interface::LORA);; 00083 } 00084 00092 void on_receive(int packet_size) {; if (packet_size == 0) return;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

9.34 lib/comms/send.cpp File Reference

Implements functions for sending data, including LoRa messages and Frames.

#include "communication.h"
Include dependency graph for send.cpp:

lib/comms/send.cpp

• void send_message (std::string outgoing)

Sends a message using LoRa.
• void send_frame_lora (const Frame &frame)
• void send_frame_uart (const Frame &frame)

9.34 lib/comms/send.cpp File Reference | 233

### 9.34.1 Detailed Description

Implements functions for sending data, including LoRa messages and Frames.

Definition in file send.cpp.

### 9.34.2 Function Documentation

### 9.34.2.1 send_message()

void send_message (

std::string outgoing)

Sends a message using LoRa.

Parameters

outgoing The message to send.

Converts the outgoing string to a C-style string, adds destination and local addresses, and sends the message using LoRa. Prints a log message to the UART.

Definition at line 15 of file send.cpp.

Here is the call graph for this function:

Here is the caller graph for this function:

send_frame_lora | send_message

frame_process

main

init_modules

extract_and_process
_frames

handle_uart_input

on_receive | process_lora_packet

234 File Documentation

### 9.34.2.2 send_frame_lora()

void send_frame_lora (

const Frame & frame)

Definition at line 41 of file send.cpp.

Here is the call graph for this function:

send_frame_lora

frame_encode

send_message

uart_print

operation_type_to_string | SystemStateManager
| ::get_instance

get_level_color

get_level_prefix

SystemStateManager
::SystemStateManager

Here is the caller graph for this function:

send_frame_lora

frame_process

main

init_modules

extract_and_process
_frames

handle_uart_input

on_receive | process_lora_packet

### 9.34.2.3 send_frame_uart()

void send_frame_uart (

const Frame & frame)

Definition at line 49 of file send.cpp.

Here is the call graph for this function:

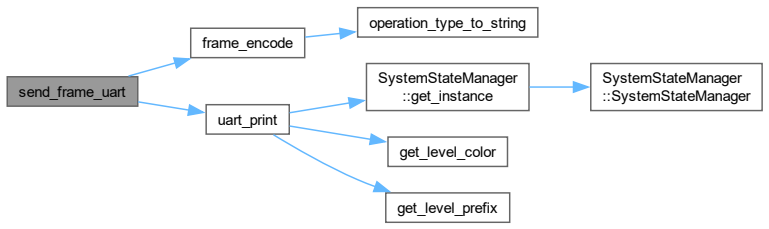
[picture p89: figure]
send_frame_uart; frame_encode; uart_print; operation_type_to_string; SystemStateManager ::get_instance; get_level_color; get_level_prefix; SystemStateManager ::SystemStateManager

9.35 send.cpp | 235

Here is the caller graph for this function:

frame_process | send_frame_uart extract_and_process
_frames

handle_uart_input

process_lora_packet

main
on_receive

## 9.35 send.cpp

Go to the documentation of this file.

00001 #include "communication.h" 00002
00003
00008
00015 void send_message(std::string outgoing)
00016 {
00017 | std::vector<char> send(outgoing.length() + 1);
00018 | strcpy(send.data(), outgoing.c_str());
00019
00020 | uart_print("LoRa packet begin", VerbosityLevel::DEBUG);
00021 | LoRa.beginPacket(); | // start packet
00022 | LoRa.write(lora_address_remote); | // add destination address
00023 | LoRa.write(lora_address_local); // add sender address
00024 | for(size_t i = 0; i < send.size(); i++) {
00025 | LoRa.write(static_cast<uint8_t>(send[i])); | // add payload byte by byte
00026 | }
00027 | LoRa.endPacket(false); | // finish packet and send it, param - async
00028
00029 | uart_print("LoRa packet end", VerbosityLevel::DEBUG);
00030
00031 | std::string message_to_log = "Sent message of size " + std::to_string(send.size());
00032 | message_to_log += " to 0x" + std::to_string(lora_address_remote);
00033 | message_to_log += " containing: " + std::string(send.data());
00034
00035 | uart_print(message_to_log, VerbosityLevel::DEBUG);
00036
00037 | LoRa.flush();
00038 }
00039
00040
00041 void send_frame_lora(const Frame& frame) {
00042 | uart_print("Sending frame via LoRa", VerbosityLevel::DEBUG);
00043 | std::string outgoing = frame_encode(frame);
00044 | send_message(outgoing);
00045 | uart_print("Frame sent via LoRa", VerbosityLevel::DEBUG);
00046 }
00047
00048 // If level is 0 - SILENT it means no diagnostic output but frame communications should still work 00049 void send_frame_uart(const Frame& frame) {
00050 | std::string encoded_frame = frame_encode(frame);
00051 | uart_print(encoded_frame, VerbosityLevel::SILENT);
00052 }
00053
00054

## 9.36 lib/comms/utils_converters.cpp File Reference

Implements utility functions for converting between different data types.

#include "communication.h"

Include dependency graph for utils_converters.cpp:

lib/comms/utils_converters.cpp

communication.h

vector | string

protocol.h

event_manager.h

map

functional | iomanip | cstdint

pin_config.h

build_number.h | LoRa/LoRa-RP2040.h | cstdio | cstdlib | cstring | time.h | PowerManager.h | utils.h

stdint.h

INA3221/INA3221.h

hardware/i2c.h

pico/stdlib.h | pico/mutex.h

iostream

hardware/uart.h | stdio.h

storage.h

system_state_manager.h

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

236 File Documentation

Functions

- std::string value_unit_type_to_string (ValueUnit unit)

Converts a ValueUnit to a string.
- std::string operation_type_to_string (OperationType type)

Converts an OperationType to a string.
- OperationType string_to_operation_type (const std::string &str)

Converts a string to an OperationType.
- std::string error_code_to_string (ErrorCode code)

Converts an ErrorCode to its string representation.

### 9.36.1 Detailed Description

Implements utility functions for converting between different data types.

Definition in file utils_converters.cpp.

## 9.37 utils_converters.cpp

Go to the documentation of this file.

00001 #include "communication.h" 00002
00003
00009
00010
00017 std::string value_unit_type_to_string(ValueUnit unit) {
00018 | switch (unit) {
00019 | case ValueUnit::UNDEFINED: | return "";
00020 | case ValueUnit::SECOND: | return "s";
00021 | case ValueUnit::VOLT: | return "V";
00022 | case ValueUnit::BOOL: | return "";
00023 | case ValueUnit::DATETIME: | return "";
00024 | case ValueUnit::TEXT: | return "";
00025 | case ValueUnit::MILIAMP: | return "mA";
00026 | case ValueUnit::CELSIUS: | return "C";
00027 | default: return "";
00028 | }
00029 }
00030
00031
00038 std::string operation_type_to_string(OperationType type) {
00039 | switch (type) {
00040 | case OperationType::GET: return "GET";
00041 | case OperationType::SET: return "SET";
00042 | case OperationType::VAL: return "VAL";
00043 | case OperationType::ERR: return "ERR";
00044 | case OperationType::RES: return "RES";
00045 | case OperationType::SEQ: return "SEQ";
00046 | default: return "UNKNOWN";
00047 | }
00048 }
00049
00050
00057 OperationType string_to_operation_type(const std::string& str) {
00058 | if (str == "GET") return OperationType::GET;
00059 | if (str == "SET") return OperationType::SET;
00060 | if (str == "VAL") return OperationType::VAL;
00061 | if (str == "ERR") return OperationType::ERR;
00062 | if (str == "RES") return OperationType::RES;
00063 | if (str == "SEQ") return OperationType::SEQ;
00064 | return OperationType::GET; // Default to GET
00065 }
00066
00073 std::string error_code_to_string(ErrorCode code) {
00074 | switch (code) {
00075 | case ErrorCode::PARAM_UNNECESSARY: | return "PARAM_UNNECESSARY";
00076 | case ErrorCode::PARAM_REQUIRED: | return "PARAM_REQUIRED";
00077 | case ErrorCode::PARAM_INVALID: | return "PARAM_INVALID";
00078 | case ErrorCode::INVALID_OPERATION: | return "INVALID_OPERATION";

9.38 lib/eventman/event_manager.cpp File Reference | 237
00079 | case ErrorCode::NOT_ALLOWED: | return "NOT_ALLOWED";
00080 | case ErrorCode::INVALID_FORMAT: | return "INVALID_FORMAT";
00081 | case ErrorCode::INVALID_VALUE: | return "INVALID_VALUE";
00082 | case ErrorCode::FAIL_TO_SET: | return "FAIL_TO_SET";
00083 | case ErrorCode::INTERNAL_FAIL_TO_READ: | return "INTERNAL_FAIL_TO_READ";
00084 | default: | return "UNKNOWN_ERROR";
00085 | }
00086 }
00087

## 9.38 lib/eventman/event_manager.cpp File Reference

Implementation of the Event Manager and Event Emitter classes.

#include "event_manager.h"

#include <cstdio>

#include "protocol.h"

#include "pico/multicore.h" #include "communication.h" #include "utils.h"

#include "DS3231.h"

Include dependency graph for event_manager.cpp:

### 9.38.1 Detailed Description

Implementation of the Event Manager and Event Emitter classes.

This file implements the EventManager class, which provides a singleton instance for logging events to a circular buffer and saving them to persistent storage. The EventEmitter class provides a simple interface for emitting events throughout the system.

Definition in file event_manager.cpp.

## 9.39 event_manager.cpp

Go to the documentation of this file.

00001
00015
00016 #include "event_manager.h" 00017 #include <cstdio>
00018 #include "protocol.h" 00019 #include "pico/multicore.h" 00020 #include "communication.h" 00021 #include "utils.h"
00022 #include "DS3231.h"
00023
00024
00030 bool EventManager::init() {
00031 | if (!SystemStateManager::get_instance().is_sd_card_mounted()) {
00032 | uart_print("Event manager initialized (storage not available)", VerbosityLevel::WARNING);

238 File Documentation

00033 | return false;
00034 | }
00035
00036 | FILE* file = fopen(EVENT_LOG_FILE, "w");
00037 | if (!file) {
00038 | file = fopen(EVENT_LOG_FILE, "w");
00039 | if (file) {
00040 | fclose(file);
00041 | uart_print("Created new event log", VerbosityLevel::INFO);
00042 | }
00043 | else {
00044 | uart_print("Failed to create event log", VerbosityLevel::ERROR);
00045 | return false;
00046 | }
00047 | }
00048 | else {
00049 | fclose(file);
00050 | }
00051
00052 | uart_print("Event manager initialized", VerbosityLevel::INFO);
00053 | return true;
00054 }
00055
00056
00063 void EventManager::log_event(uint8_t group, uint8_t event) {
00064 | mutex_enter_blocking(&eventMutex);
00065
00066 | uint32_t timestamp = DS3231::get_instance().get_local_time();
00067 | uint16_t id = nextEventId++;
00068
00069 | EventLog& log = events[writeIndex];
00070 | log.id = id;
00071 | log.timestamp = timestamp;
00072 | log.group = group;
00073 | log.event = event;
00074
00075 | writeIndex = (writeIndex + 1) % EVENT_BUFFER_SIZE;
00076 | if (eventCount < EVENT_BUFFER_SIZE) {
00077 | eventCount++;
00078 | }
00079
00080 | eventsSinceFlush++;
00081
00082 | mutex_exit(&eventMutex);
00083
00084 | std::string event_string = "Event: " + std::to_string(id) +
00085 | " Group: " + std::to_string(group) +
00086 | " Event: " + std::to_string(event);
00087 | uart_print(event_string, VerbosityLevel::WARNING);
00088
00089 | if (eventsSinceFlush >= EVENT_FLUSH_THRESHOLD || group == static_cast<uint8_t>(EventGroup::POWER))
{
00090 | save_to_storage();
00091 | eventsSinceFlush = 0;
00092 | }
00093 }
00094
00095
00102 const EventLog& EventManager::get_event(size_t index) const {
00103 | mutex_enter_blocking(const_cast<mutex_t*>(&eventMutex));
00104 | if (index >= eventCount) {
00105 | static EventLog emptyEvent;
00106 | mutex_exit(const_cast<mutex_t*>(&eventMutex));
00107 | return emptyEvent;
00108 | }
00109
00110 | size_t readIndex;
00111 | if (eventCount == EVENT_BUFFER_SIZE) {
00112 | readIndex = (writeIndex + index) % EVENT_BUFFER_SIZE;
00113 | }
00114 | else {
00115 | readIndex = index;
00116 | }
00117 | const EventLog& event = events[readIndex];
00118 | mutex_exit(const_cast<mutex_t*>(&eventMutex));
00119 | return event;
00120 }
00121
00122
00128 bool EventManager::save_to_storage() {
00129 | if (!SystemStateManager::get_instance().is_sd_card_mounted()) {
00130 | bool status = fs_init();
00131 | if (!status) {
00132 | return false;
00133 | }
00134 | }
00135

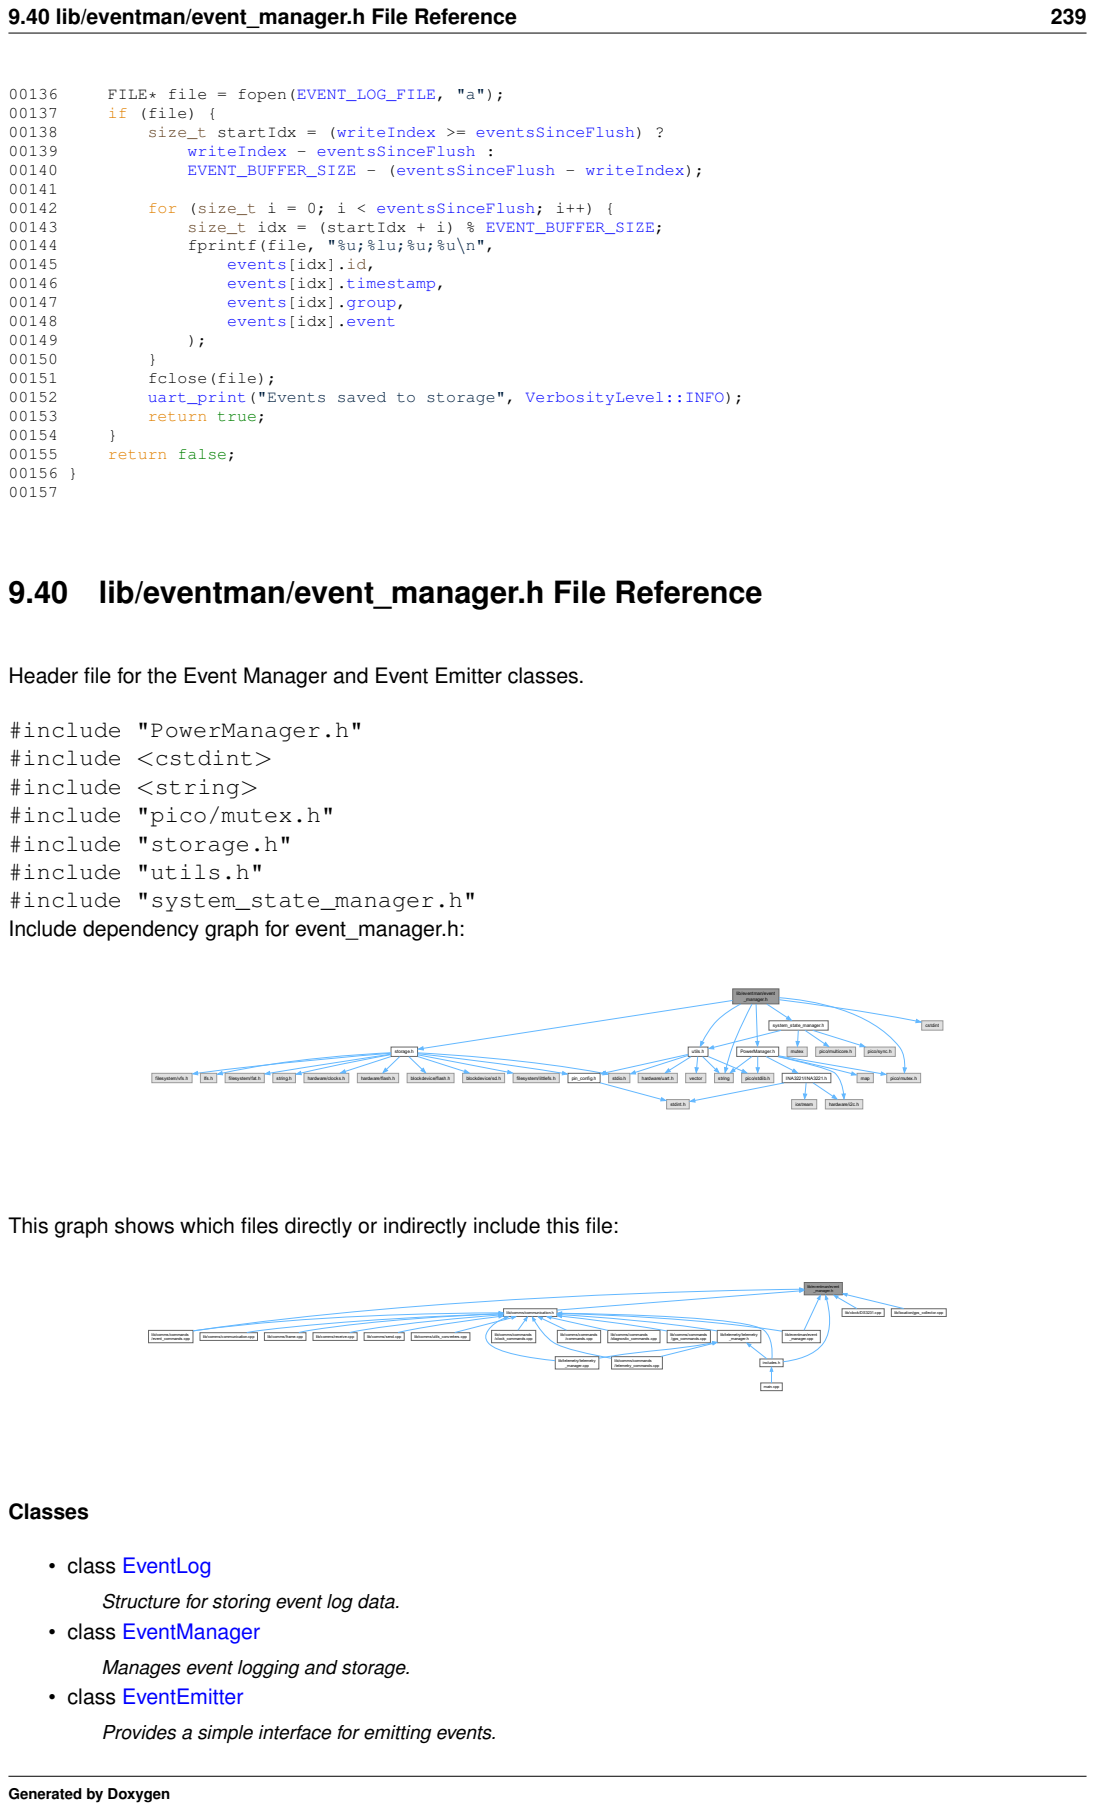
[picture p90: page 261]
9.40 lib/eventman/event_manager.h File Reference; FILE* file = fopen(EVENT_LOG_FILE, "a");; if (file) {; size_t startIdx = (writeIndex >= eventsSinceFlush) ?; writeIndex - eventsSinceFlush :; EVENT_BUFFER_SIZE - (eventsSinceFlush - writeIndex);; for (size_t i = 0; i < eventsSinceFlush; i++) {; size_t idx = (startIdx + i) % EVENT_BUFFER_SIZE;; fprintf(file, "%u;%lu;%u;%u\n",; events[idx].id,; events[idx].timestamp,; events[idx].group,; events[idx].event; fclose(file);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

9.40 lib/eventman/event_manager.h File Reference

Header file for the Event Manager and Event Emitter classes.

#include "PowerManager.h"
#include <cstdint>
#include <string>
#include "pico/mutex.h"
#include "storage.h"
#include "utils.h"
#include "system_state_manager.h"
Include dependency graph for event_manager.h:

lib/eventman/event
_manager.h

This graph shows which files directly or indirectly include this file:

lib/comms/communication.h

lib/clock/DS3231.cpp

lib/location/gps_collector.cpp

lib/comms/commands
/event_commands.cpp

/clock_commands.cpp

/commands.cpp

/diagnostic_commands.cpp

/gps_commands.cpp

lib/telemetry/telemetry

_manager.cpp

/telemetry_commands.cpp

Structure for storing event log data.
• class EventManager

Manages event logging and storage.
• class EventEmitter

Provides a simple interface for emitting events.

240 File Documentation

Macros

- #define EVENT_BUFFER_SIZE 100

Size of the event buffer.
- #define EVENT_FLUSH_THRESHOLD 10

Number of events to accumulate before flushing to storage.
- #define EVENT_LOG_FILE "/event_log.csv"

Path to the event log file.

Enumerations

- enum class EventGroup : uint8_t {
EventGroup::SYSTEM = 0x00 , EventGroup::POWER = 0x01 , EventGroup::COMMS = 0x02 , EventGroup::GPS = 0x03 ,
EventGroup::CLOCK = 0x04 }

Enumeration of event groups.
- enum class SystemEvent : uint8_t {
SystemEvent::BOOT = 0x01 , SystemEvent::SHUTDOWN = 0x02 , SystemEvent::WATCHDOG_RESET = 0x03 , SystemEvent::CORE1_START = 0x04 ,
SystemEvent::CORE1_STOP = 0x05 }

Enumeration of system events.
- enum class PowerEvent : uint8_t {
PowerEvent::BATTERY_LOW = 0x01 , PowerEvent::BATTERY_FULL = 0x02 , PowerEvent::POWER_FALLING
= 0x03 , PowerEvent::BATTERY_NORMAL = 0x04 ,
PowerEvent::SOLAR_ACTIVE = 0x05 , PowerEvent::SOLAR_INACTIVE = 0x06 , PowerEvent::USB_CONNECTED = 0x07 , PowerEvent::USB_DISCONNECTED = 0x08 ,
PowerEvent::DISCHARGING = 0x09 , PowerEvent::CHARGING = 0x0A }

Enumeration of power events.
- enum class CommsEvent : uint8_t {
CommsEvent::RADIO_INIT = 0x01 , CommsEvent::RADIO_ERROR = 0x02 , CommsEvent::MSG_RECEIVED = 0x03 , CommsEvent::MSG_SENT = 0x04 ,
CommsEvent::UART_ERROR = 0x06 }

Enumeration of communications events.
- enum class GPSEvent : uint8_t {
GPSEvent::LOCK = 0x01 , GPSEvent::LOST = 0x02 , GPSEvent::ERROR = 0x03 , GPSEvent::POWER_ON = 0x04 ,
GPSEvent::POWER_OFF = 0x05 , GPSEvent::DATA_READY = 0x06 , GPSEvent::PASS_THROUGH_START = 0x07 , GPSEvent::PASS_THROUGH_END = 0x08 }

Enumeration of GPS events.
- enum class ClockEvent : uint8_t { ClockEvent::CHANGED = 0x01 , ClockEvent::GPS_SYNC = 0x02 , ClockEvent::GPS_SYNC_DATA_NOT_READY = 0x03 }

Enumeration of clock events.

Functions

- class EventLog __attribute__ ((packed))

9.40 lib/eventman/event_manager.h File Reference | 241

Variables

- uint32_t timestamp

Timestamp of the event in milliseconds since boot.
- uint16_t id

Unique identifier for the event.
- uint8_t group

Event group.
- uint8_t event

Event code.
- class EventManager __attribute__

### 9.40.1 Detailed Description

Header file for the Event Manager and Event Emitter classes.

This file defines the classes and enumerations necessary for managing and emitting system events. The EventManager class provides a singleton instance for logging events to a circular buffer and saving them to persistent storage. The EventEmitter class provides a simple interface for emitting events throughout the system.

Definition in file event_manager.h.

### 9.40.2 Variable Documentation

### 9.40.2.1 timestamp

uint32_t timestamp

Timestamp of the event in milliseconds since boot.

Definition at line 2 of file event_manager.h.

### 9.40.2.2 id

uint16_t id

Unique identifier for the event.

Definition at line 4 of file event_manager.h.

### 9.40.2.3 group

uint8_t group

Event group.

Definition at line 6 of file event_manager.h.

242 File Documentation

### 9.40.2.4 event

uint8_t event

Event code.

Definition at line 8 of file event_manager.h.

## 9.41 event_manager.h

Go to the documentation of this file.

00001
00017
00018 #ifndef EVENT_MANAGER_H 00019 #define EVENT_MANAGER_H 00020
00021 #include "PowerManager.h" 00022 #include <cstdint>
00023 #include <string>
00024 #include "pico/mutex.h"
00025 #include "storage.h"
00026 #include "utils.h"
00027 #include "system_state_manager.h" 00028
00032 #define EVENT_BUFFER_SIZE 100 00033
00037 #define EVENT_FLUSH_THRESHOLD 10
00038
00042 #define EVENT_LOG_FILE "/event_log.csv" 00043
00044
00050 enum class EventGroup : uint8_t {
00052 | SYSTEM = 0x00,
00054 | POWER = 0x01,
00056 | COMMS = 0x02,
00058 | GPS = 0x03,
00060 | CLOCK = 0x04
00061 };
00062
00063
00069 enum class SystemEvent : uint8_t {
00071 | BOOT = 0x01,
00073 | SHUTDOWN = 0x02,
00075 | WATCHDOG_RESET = 0x03,
00077 | CORE1_START = 0x04,
00079 | CORE1_STOP = 0x05
00080 };
00081
00087 enum class PowerEvent : uint8_t {
00089 | BATTERY_LOW = 0x01,
00091 | BATTERY_FULL = 0x02,
00093 | POWER_FALLING = 0x03,
00095 | BATTERY_NORMAL = 0x04,
00097 | SOLAR_ACTIVE = 0x05,
00099 | SOLAR_INACTIVE = 0x06,
00101 | USB_CONNECTED = 0x07,
00103 | USB_DISCONNECTED = 0x08,
00105 | DISCHARGING = 0x09,
00107 | CHARGING = 0x0A,
00108 };
00109
00110
00116 enum class CommsEvent : uint8_t {
00118 | RADIO_INIT = 0x01,
00120 | RADIO_ERROR = 0x02,
00122 | MSG_RECEIVED = 0x03,
00124 | MSG_SENT = 0x04,
00126 | UART_ERROR = 0x06
00127 };
00128
00134 enum class GPSEvent : uint8_t {
00136 | LOCK = 0x01,
00138 | LOST = 0x02,
00140 | ERROR = 0x03,
00142 | POWER_ON = 0x04,
00144 | POWER_OFF = 0x05,
00146 | DATA_READY = 0x06,

9.42 lib/location/gps_collector.cpp File Reference | 243
00148 | PASS_THROUGH_START = 0x07,
00150 | PASS_THROUGH_END = 0x08
00151 };
00152
00158 enum class ClockEvent : uint8_t {
00160 | CHANGED = 0x01,
00162 | GPS_SYNC = 0x02,
00164 | GPS_SYNC_DATA_NOT_READY = 0x03
00165 };
00166
00167
00173 class EventLog {
00174 | public:
00176 | uint32_t timestamp;
00178 | uint16_t id;
00180 | uint8_t group;
00182 | uint8_t event;
00183 | } __attribute__((packed));
00184
00185
00194 class EventManager {
00195 private:
00196 | EventLog events[EVENT_BUFFER_SIZE];
00197 | size_t eventCount;
00198 | size_t writeIndex;
00199 | mutex_t eventMutex;
00200 | uint16_t nextEventId;
00201 | size_t eventsSinceFlush;
00202
00203 | EventManager() :
00204 | eventCount(0),
00205 | writeIndex(0),
00206 | nextEventId(0),
00207 | eventsSinceFlush(0)
00208 | {
00209 | mutex_init(&eventMutex);
00210 | }
00211
00212 | EventManager(const EventManager&) = delete;
00213 | EventManager& operator=(const EventManager&) = delete;
00214
00215 | public:
00220 | static EventManager& get_instance() {
00221 | static EventManager instance;
00222 | return instance;
00223 | }
00224
00229 | bool init();
00230
00236 | void log_event(uint8_t group, uint8_t event);
00237
00243 | const EventLog& get_event(size_t index) const;
00244
00249 | size_t get_event_count() const { return eventCount; }
00250
00255 | bool save_to_storage();
00256 };
00257
00264 class EventEmitter {
00265 public:
00272 | template<typename T>
00273 | static void emit(EventGroup group, T event) {
00274 | EventManager::get_instance().log_event(
00275 | static_cast<uint8_t>(group),
00276 | static_cast<uint8_t>(event)
00277 | );
00278 | }
00279 };
00280
00281 #endif // EVENT_MANAGER_H

## 9.42 lib/location/gps_collector.cpp File Reference

Implementation of the GPS data collector module.

#include "lib/location/gps_collector.h" #include "utils.h"

#include "pico/time.h"

#include "lib/location/NMEA/nmea_data.h"

244 File Documentation

#include "event_manager.h"

#include <vector>

#include <ctime>

#include <cstring>

#include "DS3231.h"

#include <sstream>

#include "system_state_manager.h" Include dependency graph for gps_collector.cpp:

lib/location/gps_collector.cpp

lib/location/gps_collector.h

lib/location/NMEA/nmea
_data.h
vector | cstring

utils.h

event_manager.h | pico/time.h

system_state_manager.h

DS3231.h | ctime | sstream
pin_config.h | string | hardware/uart.h | pico/sync.h

stdint.h

stdio.h | pico/stdlib.h

PowerManager.h

pico/mutex.h

cstdint

storage.h | INA3221/INA3221.h

hardware/i2c.h

map

blockdevice/sd.h | filesystem/littlefs.h | filesystem/vfs.h | lfs.h | filesystem/fat.h | string.h | hardware/clocks.h | hardware/flash.h | blockdevice/flash.h | iostream
pico/multicore.h | mutex
array | time.h

Macros

- #define MAX_RAW_DATA_LENGTH 256

Maximum length of the raw data buffer for NMEA sentences.

Functions

- std::vector< std::string > splitString (const std::string &str, char delimiter)

Splits a string into tokens based on a delimiter.
- void collect_gps_data ()

Collects GPS data from the UART and updates the NMEA data.

### 9.42.1 Detailed Description

Implementation of the GPS data collector module.

This file implements the function collect_gps_data, which is responsible for reading raw NMEA sentences from the GPS UART, parsing them, and updating the NMEA data in the NMEAData singleton.

Definition in file gps_collector.cpp.

## 9.43 gps_collector.cpp

Go to the documentation of this file.

00001
00014
00015 #include "lib/location/gps_collector.h" 00016 #include "utils.h"
00017 #include "pico/time.h"
00018 #include "lib/location/NMEA/nmea_data.h" 00019 #include "event_manager.h"
00020 #include <vector>
00021 #include <ctime>
00022 #include <cstring>
00023 #include "DS3231.h"
00024 #include <sstream>
00025 #include "system_state_manager.h" 00026
00030 #define MAX_RAW_DATA_LENGTH 256

9.44 lib/location/gps_collector.h File Reference | 245

00040 std::vector<std::string> splitString(const std::string& str, char delimiter) { std::vector<std::string> tokens; std::stringstream ss(str);
std::string token;
while (std::getline(ss, token, delimiter)) { tokens.push_back(token);
}
return tokens;
00048 }

00059 void collect_gps_data() {

if (SystemStateManager::get_instance().is_gps_collection_paused()) { return;
}

std::array<char, MAX_RAW_DATA_LENGTH> raw_data_buffer; static int raw_data_index = 0;

while (uart_is_readable(GPS_UART_PORT)) {
char c = uart_getc(GPS_UART_PORT);

if (c == ’\r’ || c == ’\n’) {
// End of message
if (raw_data_index > 0) {
raw_data_buffer[raw_data_index] = ’\0’; std::string message(raw_data_buffer.data()); raw_data_index = 0;

// Split the message into tokens
std::vector<std::string> tokens = splitString(message, ’,’);

// Update the global vectors based on the sentence type
if (message.find("$GPRMC") == 0) { NMEAData::get_instance().update_rmc_tokens(tokens); } else if (message.find("$GPGGA") == 0) { NMEAData::get_instance().update_gga_tokens(tokens); }
}
} else {
if (raw_data_index < MAX_RAW_DATA_LENGTH - 1) { raw_data_buffer[raw_data_index++] = c;
} else {
raw_data_index = 0;
}
}
}
00096 }

## 9.44 lib/location/gps_collector.h File Reference

Header file for the GPS data collector module.

#include <string>

#include "hardware/uart.h"

#include "lib/location/NMEA/nmea_data.h" #include "pin_config.h"

246 File Documentation

Include dependency graph for gps_collector.h:

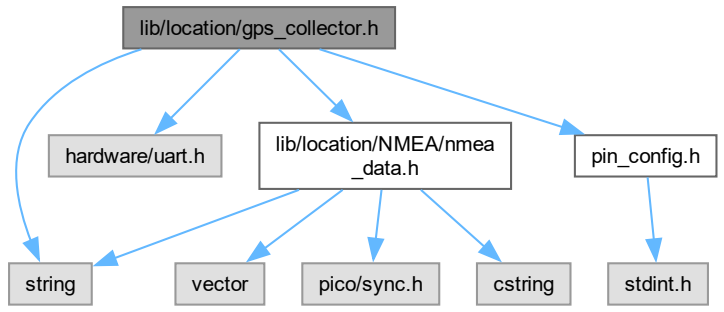
[picture p91: figure]
lib/location/gps_collector.h; string; hardware/uart.h; lib/location/NMEA/nmea; _data.h; pin_config.h; vector; pico/sync.h; cstring; stdint.h

This graph shows which files directly or indirectly include this file:

Functions

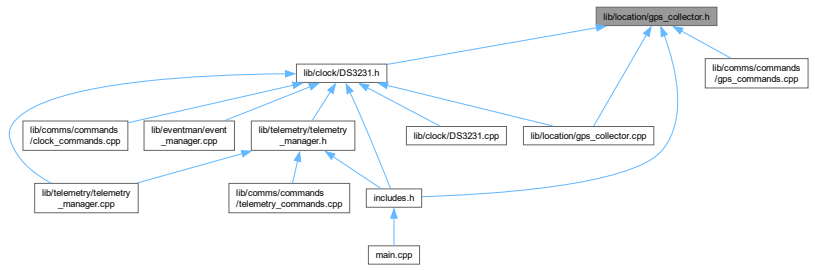
[picture p92: figure]
lib/location/gps_collector.h; includes.h; lib/clock/DS3231.h; lib/location/gps_collector.cpp; lib/comms/commands /gps_commands.cpp; main.cpp; lib/clock/DS3231.cpp lib/comms/commands /clock_commands.cpp; lib/eventman/event _manager.cpp; lib/telemetry/telemetry _manager.cpp; lib/telemetry/telemetry _manager.h; lib/comms/commands /telemetry_commands.cpp

- void collect_gps_data ()

Collects GPS data from the UART and updates the NMEA data.

### 9.44.1 Detailed Description

Header file for the GPS data collector module.

This file defines the function collect_gps_data, which is responsible for reading raw NMEA sentences from the GPS UART, parsing them, and updating the NMEA data in the NMEAData singleton.

Definition in file gps_collector.h.

9.45 gps_collector.h | 247

## 9.45 gps_collector.h

Go to the documentation of this file.

00001
00014
00015 #ifndef GPS_COLLECTOR_H 00016 #define GPS_COLLECTOR_H 00017
00018 #include <string>
00019 #include "hardware/uart.h"
00020 #include "lib/location/NMEA/nmea_data.h" // Include the new header 00021 #include "pin_config.h"
00022
00032 void collect_gps_data();
00033
00034 #endif

## 9.46 lib/location/NMEA/NMEA_data.h File Reference

Header file for the NMEAData class, which manages parsed NMEA sentences.

#include <vector>

#include <string>

#include "pico/sync.h"

#include <cstring>

Include dependency graph for NMEA_data.h:

### lib/location/NMEA/NMEA _data.h

vector | string | pico/sync.h | cstring

This graph shows which files directly or indirectly include this file:

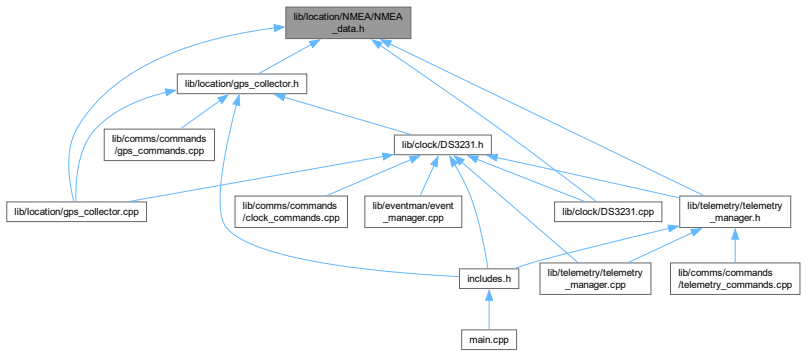
[picture p93: figure]
lib/location/NMEA/NMEA _data.h; lib/location/gps_collector.cpp; lib/clock/DS3231.cpp; lib/location/gps_collector.h; lib/telemetry/telemetry _manager.h; includes.h; lib/clock/DS3231.h lib/comms/commands /gps_commands.cpp; main.cpp; lib/comms/commands /clock_commands.cpp; lib/eventman/event _manager.cpp; lib/telemetry/telemetry _manager.cpp; lib/comms/commands /telemetry_commands.cpp

248 File Documentation

Classes

- class NMEAData

Manages parsed NMEA sentences.

### 9.46.1 Detailed Description

Header file for the NMEAData class, which manages parsed NMEA sentences.

This file defines the NMEAData class, a singleton that stores and provides access to parsed data from NMEA sentences received from a GPS module. It includes methods for updating and retrieving RMC and GGA tokens, as well as converting the data to a Unix timestamp.

Definition in file NMEA_data.h.

## 9.47 NMEA_data.h

Go to the documentation of this file.

00001
00015
00016 #ifndef NMEA_DATA_H
00017 #define NMEA_DATA_H
00018
00019 #include <vector>
00020 #include <string>
00021 #include "pico/sync.h" 00022 #include <cstring>
00023
00032 class NMEAData {
00033 private:
00035 | std::vector<std::string> rmc_tokens_;
00037 | std::vector<std::string> gga_tokens_;
00039 | mutex_t rmc_mutex_;
00041 | mutex_t gga_mutex_;
00042
00047 | NMEAData() {
00048 | mutex_init(&rmc_mutex_);
00049 | mutex_init(&gga_mutex_);
00050 | }
00051
00055 | NMEAData(const NMEAData&) = delete;
00059 | NMEAData& operator=(const NMEAData&) = delete;
00060
00061 public:
00066 | static NMEAData& get_instance() {
00067 | static NMEAData instance;
00068 | return instance;
00069 | }
00070
00075 | void update_rmc_tokens(const std::vector<std::string>& tokens) {
00076 | mutex_enter_blocking(&rmc_mutex_);
00077 | rmc_tokens_ = tokens;
00078 | mutex_exit(&rmc_mutex_);
00079 | }
00080
00085 | void update_gga_tokens(const std::vector<std::string>& tokens) {
00086 | mutex_enter_blocking(&gga_mutex_);
00087 | gga_tokens_ = tokens;
00088 | mutex_exit(&gga_mutex_);
00089 | }
00090
00095 | std::vector<std::string> get_rmc_tokens() const {
00096 | mutex_enter_blocking(const_cast<mutex_t*>(&rmc_mutex_));
00097 | std::vector<std::string> copy = rmc_tokens_;
00098 | mutex_exit(const_cast<mutex_t*>(&rmc_mutex_));
00099 | return copy;
00100 | }
00101
00106 | std::vector<std::string> get_gga_tokens() const {
00107 | mutex_enter_blocking(const_cast<mutex_t*>(&gga_mutex_));
00108 | std::vector<std::string> copy = gga_tokens_;
00109 | mutex_exit(const_cast<mutex_t*>(&gga_mutex_));
00110 | return copy;
00111 | }
00112 };
00113
00114 #endif

## 9.48 lib/pin_config.h File Reference

### lib/pin_config.h

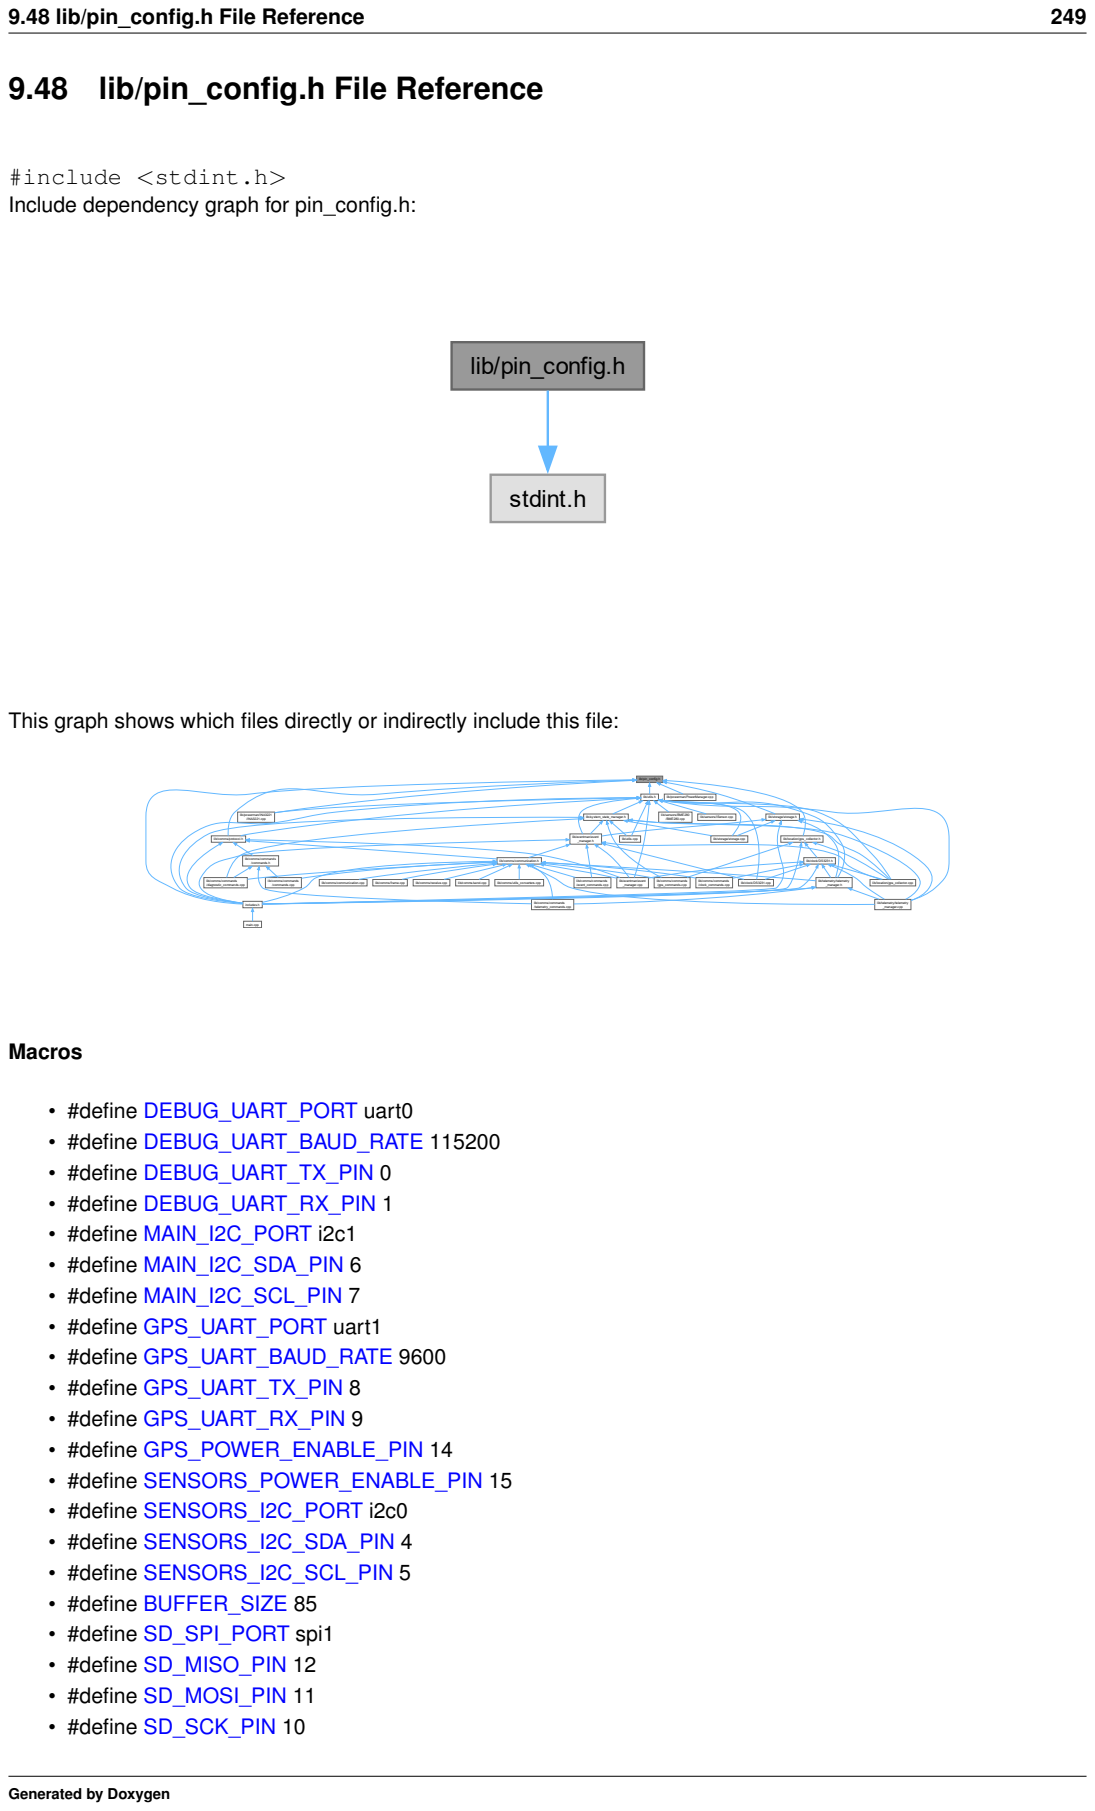
[picture p94: page 271]
9.48 lib/pin_config.h File Reference; stdint.h; lib/pin_config.h; includes.h; lib/comms/protocol.h; lib/location/gps_collector.h; lib/powerman/INA3221 /INA3221.cpp; lib/utils.h; main.cpp; /commands.h; lib/comms/communication.h; /gps_commands.cpp lib/comms/communication.cpp; lib/comms/frame.cpp; lib/comms/receive.cpp; lib/comms/send.cpp; lib/comms/utils_converters.cpp; lib/clock/DS3231.h; lib/clock/DS3231.cpp; lib/location/gps_collector.cpp; _manager.h; lib/storage/storage.cpp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

#include <stdint.h>
Include dependency graph for pin_config.h:

This graph shows which files directly or indirectly include this file:

lib/powerman/PowerManager.cpp

lib/storage/storage.h

lib/eventman/event

lib/utils.cpp

lib/comms/commands

/diagnostic_commands.cpp

/commands.cpp

/event_commands.cpp

_manager.cpp

/clock_commands.cpp

lib/telemetry/telemetry
_manager.h

/telemetry_commands.cpp

250 File Documentation

- #define SD_CS_PIN 13
- #define SD_CARD_DETECT_PIN 28
- #define SX1278_MISO 16
- #define SX1278_CS 17
- #define SX1278_SCK 18
- #define SX1278_MOSI 19
- #define SPI_PORT spi0
- #define READ_BIT 0x80
- #define LORA_DEFAULT_SPI spi0
- #define LORA_DEFAULT_SPI_FREQUENCY 8E6
- #define LORA_DEFAULT_SS_PIN 17
- #define LORA_DEFAULT_RESET_PIN 22
- #define LORA_DEFAULT_DIO0_PIN 20
- #define PA_OUTPUT_RFO_PIN 11
- #define PA_OUTPUT_PA_BOOST_PIN 12

Variables

- constexpr int lora_cs_pin = 17
- constexpr int lora_reset_pin = 22
- constexpr int lora_irq_pin = 28
- constexpr int lora_address_local = 37
- constexpr int lora_address_remote = 21

### 9.48.1 Macro Definition Documentation

### 9.48.1.1 DEBUG_UART_PORT

#define DEBUG_UART_PORT uart0

Definition at line 8 of file pin_config.h.

### 9.48.1.2 DEBUG_UART_BAUD_RATE

#define DEBUG_UART_BAUD_RATE 115200

Definition at line 9 of file pin_config.h.

### 9.48.1.3 DEBUG_UART_TX_PIN

#define DEBUG_UART_TX_PIN 0

Definition at line 11 of file pin_config.h.

### 9.48.1.4 DEBUG_UART_RX_PIN

#define DEBUG_UART_RX_PIN 1

Definition at line 12 of file pin_config.h.

9.48 lib/pin_config.h File Reference | 251

### 9.48.1.5 MAIN_I2C_PORT

#define MAIN_I2C_PORT i2c1

Definition at line 14 of file pin_config.h.

### 9.48.1.6 MAIN_I2C_SDA_PIN

#define MAIN_I2C_SDA_PIN 6

Definition at line 15 of file pin_config.h.

### 9.48.1.7 MAIN_I2C_SCL_PIN

#define MAIN_I2C_SCL_PIN 7

Definition at line 16 of file pin_config.h.

### 9.48.1.8 GPS_UART_PORT

#define GPS_UART_PORT uart1

Definition at line 19 of file pin_config.h.

### 9.48.1.9 GPS_UART_BAUD_RATE

#define GPS_UART_BAUD_RATE 9600

Definition at line 20 of file pin_config.h.

### 9.48.1.10 GPS_UART_TX_PIN

#define GPS_UART_TX_PIN 8

Definition at line 21 of file pin_config.h.

### 9.48.1.11 GPS_UART_RX_PIN

#define GPS_UART_RX_PIN 9

Definition at line 22 of file pin_config.h.

### 9.48.1.12 GPS_POWER_ENABLE_PIN

#define GPS_POWER_ENABLE_PIN 14

Definition at line 23 of file pin_config.h.

252 File Documentation

### 9.48.1.13 SENSORS_POWER_ENABLE_PIN

#define SENSORS_POWER_ENABLE_PIN 15

Definition at line 25 of file pin_config.h.

### 9.48.1.14 SENSORS_I2C_PORT

#define SENSORS_I2C_PORT i2c0

Definition at line 26 of file pin_config.h.

### 9.48.1.15 SENSORS_I2C_SDA_PIN

#define SENSORS_I2C_SDA_PIN 4

Definition at line 27 of file pin_config.h.

### 9.48.1.16 SENSORS_I2C_SCL_PIN

#define SENSORS_I2C_SCL_PIN 5

Definition at line 28 of file pin_config.h.

### 9.48.1.17 BUFFER_SIZE

#define BUFFER_SIZE 85

Definition at line 30 of file pin_config.h.

### 9.48.1.18 SD_SPI_PORT

#define SD_SPI_PORT spi1

Definition at line 33 of file pin_config.h.

### 9.48.1.19 SD_MISO_PIN

#define SD_MISO_PIN 12

Definition at line 34 of file pin_config.h.

### 9.48.1.20 SD_MOSI_PIN

#define SD_MOSI_PIN 11

Definition at line 35 of file pin_config.h.

9.48 lib/pin_config.h File Reference | 253

### 9.48.1.21 SD_SCK_PIN

#define SD_SCK_PIN 10

Definition at line 36 of file pin_config.h.

### 9.48.1.22 SD_CS_PIN

#define SD_CS_PIN 13

Definition at line 37 of file pin_config.h.

### 9.48.1.23 SD_CARD_DETECT_PIN

#define SD_CARD_DETECT_PIN 28

Definition at line 38 of file pin_config.h.

### 9.48.1.24 SX1278_MISO

#define SX1278_MISO 16

Definition at line 40 of file pin_config.h.

### 9.48.1.25 SX1278_CS

#define SX1278_CS 17

Definition at line 41 of file pin_config.h.

### 9.48.1.26 SX1278_SCK

#define SX1278_SCK 18

Definition at line 42 of file pin_config.h.

### 9.48.1.27 SX1278_MOSI

#define SX1278_MOSI 19

Definition at line 43 of file pin_config.h.

### 9.48.1.28 SPI_PORT

#define SPI_PORT spi0

Definition at line 45 of file pin_config.h.

254 File Documentation

### 9.48.1.29 READ_BIT

#define READ_BIT 0x80

Definition at line 46 of file pin_config.h.

### 9.48.1.30 LORA_DEFAULT_SPI

#define LORA_DEFAULT_SPI spi0

Definition at line 48 of file pin_config.h.

### 9.48.1.31 LORA_DEFAULT_SPI_FREQUENCY

#define LORA_DEFAULT_SPI_FREQUENCY 8E6

Definition at line 49 of file pin_config.h.

### 9.48.1.32 LORA_DEFAULT_SS_PIN

#define LORA_DEFAULT_SS_PIN 17

Definition at line 50 of file pin_config.h.

### 9.48.1.33 LORA_DEFAULT_RESET_PIN

#define LORA_DEFAULT_RESET_PIN 22

Definition at line 51 of file pin_config.h.

### 9.48.1.34 LORA_DEFAULT_DIO0_PIN

#define LORA_DEFAULT_DIO0_PIN 20

Definition at line 52 of file pin_config.h.

### 9.48.1.35 PA_OUTPUT_RFO_PIN

#define PA_OUTPUT_RFO_PIN 11

Definition at line 54 of file pin_config.h.

### 9.48.1.36 PA_OUTPUT_PA_BOOST_PIN

#define PA_OUTPUT_PA_BOOST_PIN 12

Definition at line 55 of file pin_config.h.

9.48 lib/pin_config.h File Reference | 255

### 9.48.2 Variable Documentation

### 9.48.2.1 lora_cs_pin

int lora_cs_pin = 17 [inline], [constexpr]

Definition at line 57 of file pin_config.h.

### 9.48.2.2 lora_reset_pin

int lora_reset_pin = 22 [inline], [constexpr]

Definition at line 58 of file pin_config.h.

### 9.48.2.3 lora_irq_pin

int lora_irq_pin = 28 [inline], [constexpr]

Definition at line 59 of file pin_config.h.

### 9.48.2.4 lora_address_local

int lora_address_local = 37 [inline], [constexpr]

Definition at line 61 of file pin_config.h.

### 9.48.2.5 lora_address_remote

int lora_address_remote = 21 [inline], [constexpr]

Definition at line 62 of file pin_config.h.

256 File Documentation

## 9.49 pin_config.h

Go to the documentation of this file.

00001
00002 #ifndef PIN_CONFIG_H
00003 #define PIN_CONFIG_H 00004
00005 #include <stdint.h>
00006
00007 //DEBUG uart
00008 #define DEBUG_UART_PORT uart0 00009 #define DEBUG_UART_BAUD_RATE 115200 00010
00011 #define DEBUG_UART_TX_PIN 0
00012 #define DEBUG_UART_RX_PIN 1
00013
00014 #define MAIN_I2C_PORT i2c1 00015 #define MAIN_I2C_SDA_PIN 6 00016 #define MAIN_I2C_SCL_PIN 7 00017
00018 // GPS configuration
00019 #define GPS_UART_PORT uart1 00020 #define GPS_UART_BAUD_RATE 9600 00021 #define GPS_UART_TX_PIN 8 00022 #define GPS_UART_RX_PIN 9
00023 #define GPS_POWER_ENABLE_PIN 14 00024
00025 #define SENSORS_POWER_ENABLE_PIN 15 00026 #define SENSORS_I2C_PORT i2c0 00027 #define SENSORS_I2C_SDA_PIN 4 00028 #define SENSORS_I2C_SCL_PIN 5 00029
00030 #define BUFFER_SIZE 85
00031
00032 // SPI configuration for SD card 00033 #define SD_SPI_PORT spi1
00034 #define SD_MISO_PIN 12
00035 #define SD_MOSI_PIN 11
00036 #define SD_SCK_PIN 10
00037 #define SD_CS_PIN 13
00038 #define SD_CARD_DETECT_PIN 28 00039
00040 #define SX1278_MISO 16
00041 #define SX1278_CS | 17
00042 #define SX1278_SCK | 18
00043 #define SX1278_MOSI 19 00044
00045 #define SPI_PORT spi0
00046 #define READ_BIT 0x80
00047
00048 #define LORA_DEFAULT_SPI | spi0
00049 #define LORA_DEFAULT_SPI_FREQUENCY 8E6
00050 #define LORA_DEFAULT_SS_PIN | 17
00051 #define LORA_DEFAULT_RESET_PIN | 22
00052 #define LORA_DEFAULT_DIO0_PIN | 20
00053
00054 #define PA_OUTPUT_RFO_PIN | 11
00055 #define PA_OUTPUT_PA_BOOST_PIN | 12
00056
00057 inline constexpr int lora_cs_pin = 17; | // LoRa radio chip select
00058 inline constexpr int lora_reset_pin = 22; | // LoRa radio reset
00059 inline constexpr int lora_irq_pin = 28; | // LoRa hardware interrupt pin
00060
00061 inline constexpr int lora_address_local = 37; | // address of this device
00062 inline constexpr int lora_address_remote = 21; | // destination to send to
00063
00064 #endif

## 9.50 lib/powerman/INA3221/INA3221.cpp File Reference

Implementation of the INA3221 power monitor driver.

#include "INA3221.h"

#include <stdio.h>

#include "pico/stdlib.h"

#include "hardware/i2c.h"

9.51 INA3221.cpp | 257

#include <iostream>

#include "pin_config.h"

#include "utils.h"

#include <sstream>

Include dependency graph for INA3221.cpp:

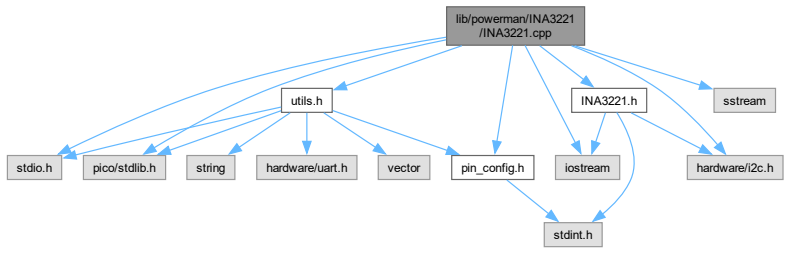
[picture p95: figure]
lib/powerman/INA3221 /INA3221.cpp; INA3221.h; stdio.h; pico/stdlib.h; pin_config.h; iostream; hardware/i2c.h; utils.h; sstream; stdint.h; string; hardware/uart.h; vector

### 9.50.1 Detailed Description

Implementation of the INA3221 power monitor driver.

This file contains the implementation for the INA3221 triple-channel power monitor, providing functionality for voltage, current, and power monitoring with alert capabilities.

Definition in file INA3221.cpp.

## 9.51 INA3221.cpp

Go to the documentation of this file.

00001 #include "INA3221.h"
00002 #include <stdio.h>
00003 #include "pico/stdlib.h" 00004 #include "hardware/i2c.h" 00005 #include <iostream>
00006 #include "pin_config.h" 00007 #include "utils.h"
00008 #include <sstream>
00009
00010
00017
00018
00033
00034
00041 INA3221::INA3221(ina3221_addr_t addr, i2c_inst_t* i2c)
00042 | : _i2c_addr(addr), _i2c(i2c) {}
00043
00044
00051 bool INA3221::begin() {
00052 | uart_print("INA3221 initializing...", VerbosityLevel::DEBUG);
00053
00054 | _shuntRes[0] = 10;
00055 | _shuntRes[1] = 10;
00056 | _shuntRes[2] = 10;
00057
00058 | _filterRes[0] = 10;
00059 | _filterRes[1] = 10;
00060 | _filterRes[2] = 10;
00061
00062 | uint16_t manuf_id = get_manufacturer_id();
00063 | uint16_t die_id = get_die_id();
00064 | std::stringstream ss;
00065 | ss « "INA3221 Manufacturer ID: 0x" « std::hex « manuf_id

258 File Documentation

00066 | « ", Die ID: 0x" « die_id;
00067 | uart_print(ss.str(), VerbosityLevel::INFO);
00068
00069 | if (manuf_id == 0x5449 && die_id == 0x3220) {
00070 | uart_print("INA3221 found and initialized.", VerbosityLevel::DEBUG);
00071 | return true;
00072 | } else {
00073 | uart_print("INA3221 initialization failed. Incorrect IDs.", VerbosityLevel::ERROR);
00074 | return false;
00075 | }
00076 }
00077
00083 uint16_t INA3221::get_manufacturer_id() {
00084 | uint16_t id = 0;
00085 | _read(INA3221_REG_MANUF_ID, &id);
00086 | return id;
00087 }
00088
00089
00095 uint16_t INA3221::get_die_id() {
00096 | uint16_t id = 0;
00097 | _read(INA3221_REG_DIE_ID, &id);
00098 | return id;
00099 }
00100
00101
00108 uint16_t INA3221::read_register(ina3221_reg_t reg){
00109 | uint16_t val = 0;
00110 | _read(reg, &val);
00111 | return val;
00112 }
00113
00114
00115 //configure
00116
00122 void INA3221::set_mode_continuous(){
00123 | conf_reg_t conf_reg;
00124
00125 | _read(INA3221_REG_CONF, (uint16_t*)&conf_reg);
00126 | conf_reg.mode_continious_en =1;
00127 | _write(INA3221_REG_CONF, (uint16_t*)&conf_reg);
00128 }
00129
00130
00136 void INA3221::set_mode_triggered(){
00137 | conf_reg_t conf_reg;
00138
00139 | _read(INA3221_REG_CONF, (uint16_t*)&conf_reg);
00140 | conf_reg.mode_continious_en = 0;
00141 | _write(INA3221_REG_CONF, (uint16_t*)&conf_reg);
00142 }
00143
00149 void INA3221::set_averaging_mode(ina3221_avg_mode_t mode) {
00150 | conf_reg_t conf_reg;
00151
00152 | _read(INA3221_REG_CONF, (uint16_t*)&conf_reg);
00153 | conf_reg.avg_mode = mode;
00154 | _write(INA3221_REG_CONF, (uint16_t*)&conf_reg);
00155 }
00156
00157 //get measurement
00164 int32_t INA3221::get_shunt_voltage(ina3221_ch_t channel) {
00165 | int32_t res;
00166 | ina3221_reg_t reg;
00167 | uint16_t val_raw = 0;
00168
00169 | switch(channel){
00170 | case INA3221_CH1:
00171 | reg = INA3221_REG_CH1_SHUNTV;
00172 | break;
00173 | case INA3221_CH2:
00174 | reg = INA3221_REG_CH2_SHUNTV;
00175 | break;
00176 | case INA3221_CH3:
00177 | reg = INA3221_REG_CH3_SHUNTV;
00178 | break;
00179 | }
00180
00181 | _read(reg, &val_raw);
00182
00183 | res = (int16_t) (val_raw » 3);
00184 | res *= SHUNT_VOLTAGE_LSB_UV;
00185
00186 | return res;
00187 }
00188
00189

9.52 lib/powerman/INA3221/INA3221.h File Reference | 259

00196 float INA3221::get_current_ma(ina3221_ch_t channel) { int32_t shunt_uV = 0;
float current_A = 0;

shunt_uV = get_shunt_voltage(channel);
current_A = shunt_uV / (int32_t)_shuntRes[channel]; return current_A;
00203 }

00212 float INA3221::get_voltage(ina3221_ch_t channel) { float voltage_V = 0.0;
ina3221_reg_t reg;
uint16_t val_raw = 0;

switch(channel){
case INA3221_CH1:
reg = INA3221_REG_CH1_BUSV; break;
case INA3221_CH2:
reg = INA3221_REG_CH2_BUSV; break;
case INA3221_CH3:
reg = INA3221_REG_CH3_BUSV; break;
}

_read(reg, &val_raw);
voltage_V = val_raw / 1000.0; return voltage_V;
00232 }

00235 // private
00242 void INA3221::_read(ina3221_reg_t reg, uint16_t *val) { uint8_t reg_buf = reg;
uint8_t data[2];

int ret = i2c_write_blocking(MAIN_I2C_PORT, _i2c_addr, &reg_buf, 1, true);
if (ret != 1) {
std::cerr « "Failed to write register address to I2C device." « std::endl; return;
}

ret = i2c_read_blocking(MAIN_I2C_PORT, _i2c_addr, data, 2, false); if (ret != 2) {
std::cerr « "Failed to read data from I2C device." « std::endl; return;
}
*val = (data[0] « 8) | data[1];
00259 }

00268 void INA3221::_write(ina3221_reg_t reg, uint16_t *val) { uint8_t buf[3];
buf[0] = reg;
buf[1] = (*val » 8) & 0xFF; // MSB
00272 | buf[2] = (*val) & 0xFF; | // LSB

int ret = i2c_write_blocking(MAIN_I2C_PORT, _i2c_addr, buf, 3, false);
| if (ret != 3) {
std::cerr « "Failed to write data to I2C device." « std::endl;
| }
00278 }

## 9.52 lib/powerman/INA3221/INA3221.h File Reference

Header file for the INA3221 triple-channel power monitor driver.

#include <stdint.h>

#include <iostream>

#include <hardware/i2c.h>

### lib/powerman/INA3221 /INA3221.h

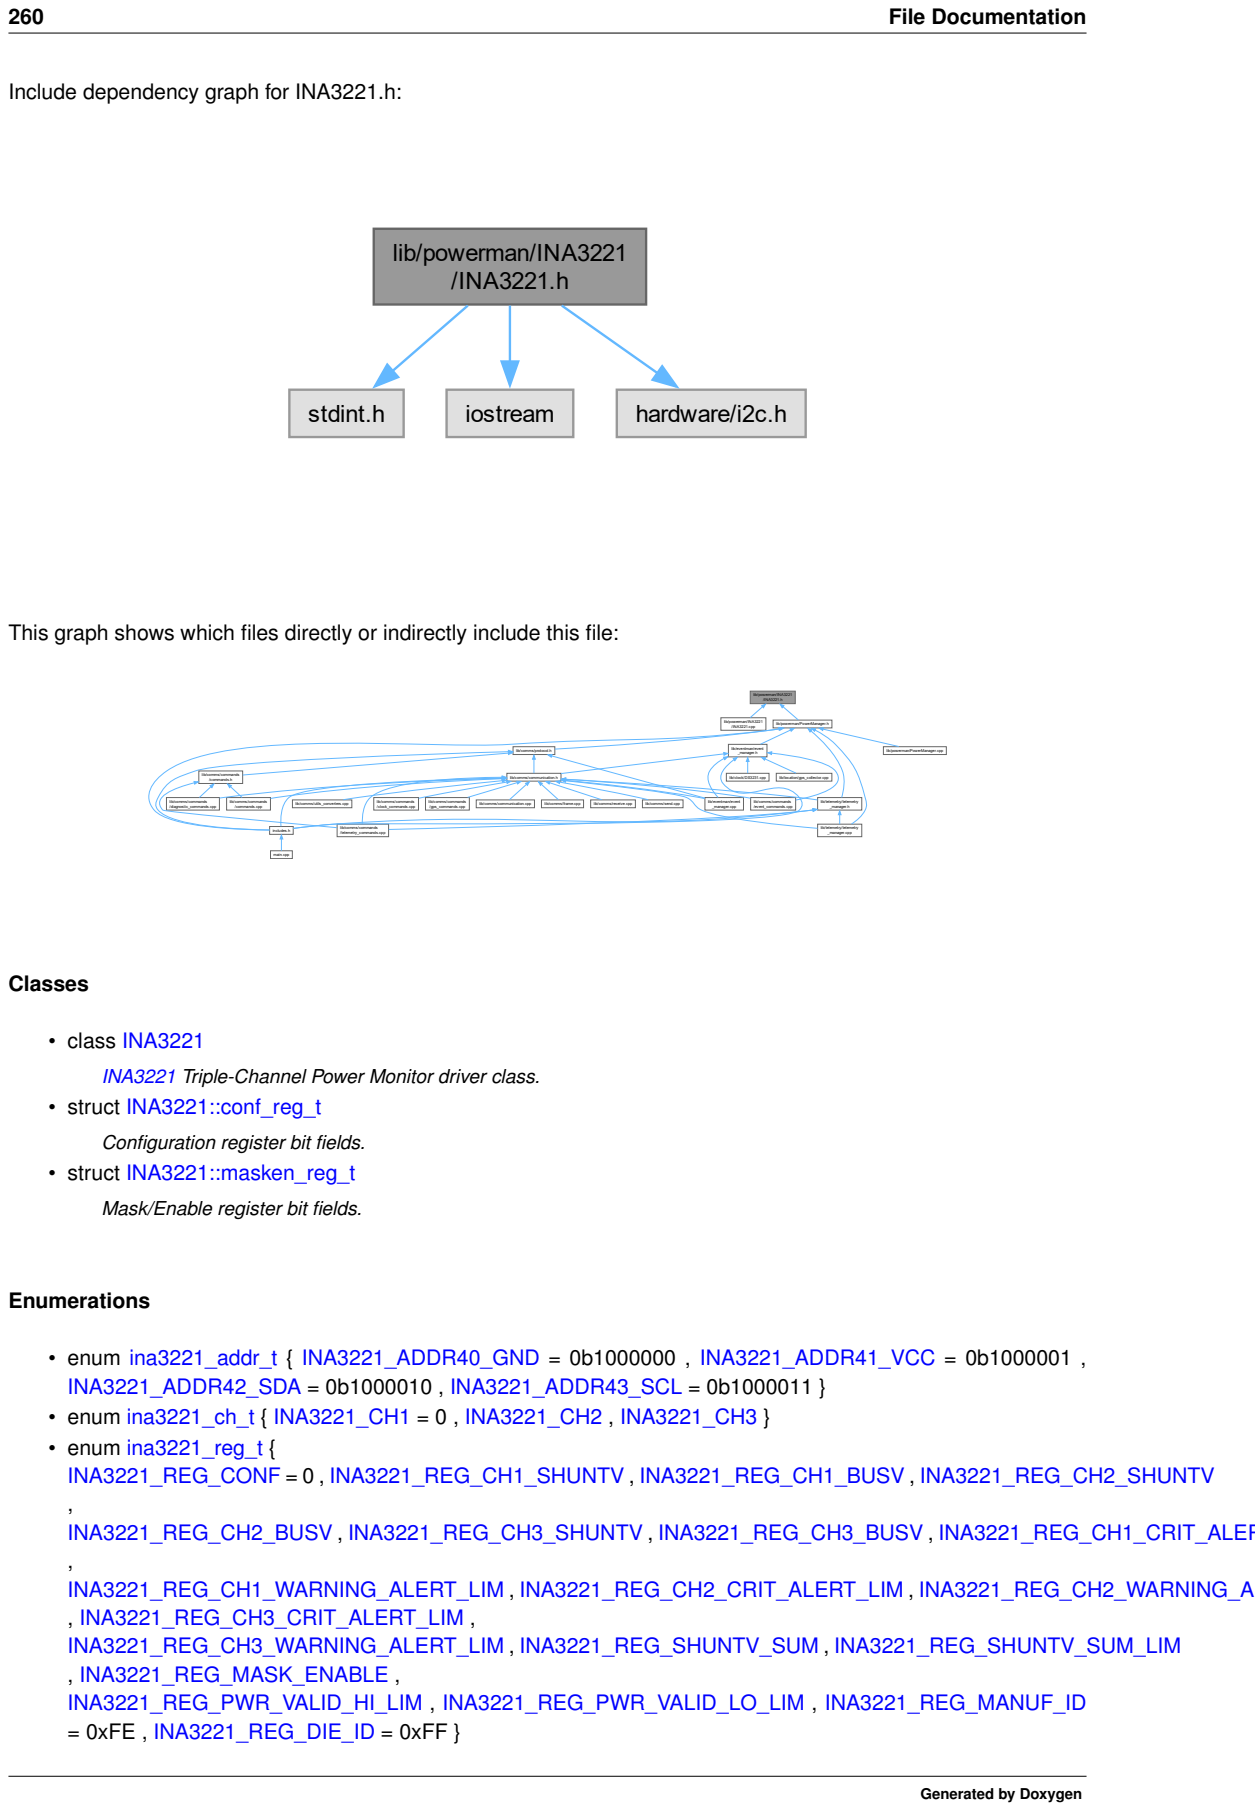
[picture p96: page 282]
260 File Documentation; stdint.h; iostream; hardware/i2c.h; lib/powerman/INA3221 /INA3221.h; lib/powerman/INA3221; /INA3221.cpp; lib/powerman/PowerManager.h; includes.h; _manager.h; lib/powerman/PowerManager.cpp; main.cpp; /commands.h; lib/comms/communication.h; /gps_commands.cpp lib/comms/utils_converters.cpp; lib/comms/communication.cpp; lib/comms/frame.cpp; lib/comms/receive.cpp; lib/comms/send.cpp; lib/clock/DS3231.cpp; lib/location/gps_collector.cpp; Classes; • class INA3221; Enumerations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

Include dependency graph for INA3221.h:

This graph shows which files directly or indirectly include this file:

lib/comms/protocol.h

lib/eventman/event

lib/comms/commands

/diagnostic_commands.cpp

/commands.cpp

/clock_commands.cpp

_manager.cpp

/event_commands.cpp

lib/telemetry/telemetry
_manager.h

/telemetry_commands.cpp

INA3221 Triple-Channel Power Monitor driver class.
• struct INA3221::conf_reg_t

Configuration register bit fields.
• struct INA3221::masken_reg_t

Mask/Enable register bit fields.

9.52 lib/powerman/INA3221/INA3221.h File Reference | 261

Register addresses for INA3221.
- enum ina3221_avg_mode_t {
INA3221_REG_CONF_AVG_1 = 0 , INA3221_REG_CONF_AVG_4 , INA3221_REG_CONF_AVG_16 , INA3221_REG_CONF_AVG_64 ,
INA3221_REG_CONF_AVG_128 , INA3221_REG_CONF_AVG_256 , INA3221_REG_CONF_AVG_512 , INA3221_REG_CONF_AVG_1024 }

Averaging mode settings.
- enum ina3221_op_mode_t { CONTINUOUS_MODE , TRIGGERED_MODE }

Operating mode settings.

Variables

- const int INA3221_CH_NUM = 3

Number of channels in INA3221.
- const int SHUNT_VOLTAGE_LSB_UV = 5

LSB value for shunt voltage measurements in microvolts.

### 9.52.1 Detailed Description

Header file for the INA3221 triple-channel power monitor driver.

Definition in file INA3221.h.

### 9.52.2 Enumeration Type Documentation

### 9.52.2.1 ina3221_addr_t

enum ina3221_addr_t

Enumerator

INA3221_ADDR40_GND
INA3221_ADDR41_VCC
INA3221_ADDR42_SDA
INA3221_ADDR43_SCL

Definition at line 12 of file INA3221.h.

### 9.52.2.2 ina3221_ch_t

enum ina3221_ch_t

Enumerator

INA3221_CH1
INA3221_CH2
INA3221_CH3

Definition at line 19 of file INA3221.h.

### 9.52.2.3 ina3221_reg_t

enum ina3221_reg_t

Register addresses for INA3221.

262 File Documentation

Enumerator

INA3221_REG_CONF
INA3221_REG_CH1_SHUNTV
INA3221_REG_CH1_BUSV
INA3221_REG_CH2_SHUNTV
INA3221_REG_CH2_BUSV
INA3221_REG_CH3_SHUNTV
INA3221_REG_CH3_BUSV
INA3221_REG_CH1_CRIT_ALERT_LIM INA3221_REG_CH1_WARNING_ALERT_LIM INA3221_REG_CH2_CRIT_ALERT_LIM INA3221_REG_CH2_WARNING_ALERT_LIM INA3221_REG_CH3_CRIT_ALERT_LIM INA3221_REG_CH3_WARNING_ALERT_LIM INA3221_REG_SHUNTV_SUM
INA3221_REG_SHUNTV_SUM_LIM INA3221_REG_MASK_ENABLE
INA3221_REG_PWR_VALID_HI_LIM INA3221_REG_PWR_VALID_LO_LIM INA3221_REG_MANUF_ID
INA3221_REG_DIE_ID

Definition at line 33 of file INA3221.h.

### 9.52.2.4 ina3221_avg_mode_t

enum ina3221_avg_mode_t

Averaging mode settings.

Number of samples to average for each measurement

Enumerator

INA3221_REG_CONF_AVG_1
INA3221_REG_CONF_AVG_4
INA3221_REG_CONF_AVG_16
INA3221_REG_CONF_AVG_64
INA3221_REG_CONF_AVG_128
INA3221_REG_CONF_AVG_256
INA3221_REG_CONF_AVG_512
INA3221_REG_CONF_AVG_1024

Definition at line 61 of file INA3221.h.

### 9.52.2.5 ina3221_op_mode_t

enum ina3221_op_mode_t

Operating mode settings.

Continuous or triggered (single-shot) mode

9.53 INA3221.h | 263

Enumerator

CONTINUOUS_MODE
TRIGGERED_MODE

Definition at line 76 of file INA3221.h.

### 9.52.3 Variable Documentation

### 9.52.3.1 INA3221_CH_NUM

const int INA3221_CH_NUM = 3

Number of channels in INA3221.

Definition at line 26 of file INA3221.h.

### 9.52.3.2 SHUNT_VOLTAGE_LSB_UV

const int SHUNT_VOLTAGE_LSB_UV = 5

LSB value for shunt voltage measurements in microvolts.

Definition at line 28 of file INA3221.h.

## 9.53 INA3221.h

Go to the documentation of this file.

00001 #ifndef BEASTDEVICES_INA3221_H 00002 #define BEASTDEVICES_INA3221_H 00003
00004 #include <stdint.h>
00005 #include <iostream>
00006 #include <hardware/i2c.h>
00007
00012 typedef enum {
00013 | INA3221_ADDR40_GND = 0b1000000, // A0 pin -> GND
00014 | INA3221_ADDR41_VCC = 0b1000001, // A0 pin -> VCC
00015 | INA3221_ADDR42_SDA = 0b1000010, // A0 pin -> SDA
00016 | INA3221_ADDR43_SCL = 0b1000011 | // A0 pin -> SCL
00017 } ina3221_addr_t;
00018
00019 typedef enum {
00020 | INA3221_CH1 = 0,
00021 | INA3221_CH2,
00022 | INA3221_CH3,
00023 } ina3221_ch_t;
00024
00026 const int INA3221_CH_NUM = 3; 00028 const int SHUNT_VOLTAGE_LSB_UV = 5; 00029
00033 typedef enum {
00034 | INA3221_REG_CONF = 0,
00035 | INA3221_REG_CH1_SHUNTV,
00036 | INA3221_REG_CH1_BUSV,
00037 | INA3221_REG_CH2_SHUNTV,
00038 | INA3221_REG_CH2_BUSV,
00039 | INA3221_REG_CH3_SHUNTV,
00040 | INA3221_REG_CH3_BUSV,
00041 | INA3221_REG_CH1_CRIT_ALERT_LIM,
00042 | INA3221_REG_CH1_WARNING_ALERT_LIM,

264 File Documentation

00043 | INA3221_REG_CH2_CRIT_ALERT_LIM,
00044 | INA3221_REG_CH2_WARNING_ALERT_LIM,
00045 | INA3221_REG_CH3_CRIT_ALERT_LIM,
00046 | INA3221_REG_CH3_WARNING_ALERT_LIM,
00047 | INA3221_REG_SHUNTV_SUM,
00048 | INA3221_REG_SHUNTV_SUM_LIM,
00049 | INA3221_REG_MASK_ENABLE,
00050 | INA3221_REG_PWR_VALID_HI_LIM,
00051 | INA3221_REG_PWR_VALID_LO_LIM,
00052 | INA3221_REG_MANUF_ID = 0xFE,
00053 | INA3221_REG_DIE_ID = 0xFF
00054 } ina3221_reg_t;
00055
00056
00061 typedef enum {
00062 | INA3221_REG_CONF_AVG_1 = 0,
00063 | INA3221_REG_CONF_AVG_4,
00064 | INA3221_REG_CONF_AVG_16,
00065 | INA3221_REG_CONF_AVG_64,
00066 | INA3221_REG_CONF_AVG_128,
00067 | INA3221_REG_CONF_AVG_256,
00068 | INA3221_REG_CONF_AVG_512,
00069 | INA3221_REG_CONF_AVG_1024
00070 } ina3221_avg_mode_t;
00071
00076 typedef enum {
00077 | CONTINUOUS_MODE,
00078 | TRIGGERED_MODE
00079 } ina3221_op_mode_t; 00080
00086 class INA3221 {
00087
00091 | typedef struct {
00092 | uint16_t mode_shunt_en:1;
00093 | uint16_t mode_bus_en:1;
00094 | uint16_t mode_continious_en:1;
00095 | uint16_t shunt_conv_time:3;
00096 | uint16_t bus_conv_time:3;
00097 | uint16_t avg_mode:3;
00098 | uint16_t ch3_en:1;
00099 | uint16_t ch2_en:1;
00100 | uint16_t ch1_en:1;
00101 | uint16_t reset:1;
00102 | } conf_reg_t;
00103
00107 | typedef struct {
00108 | uint16_t conv_ready:1;
00109 | uint16_t timing_ctrl_alert:1;
00110 | uint16_t pwr_valid_alert:1;
00111 | uint16_t warn_alert_ch3:1;
00112 | uint16_t warn_alert_ch2:1;
00113 | uint16_t warn_alert_ch1:1;
00114 | uint16_t shunt_sum_alert:1;
00115 | uint16_t crit_alert_ch3:1;
00116 | uint16_t crit_alert_ch2:1;
00117 | uint16_t crit_alert_ch1:1;
00118 | uint16_t crit_alert_latch_en:1;
00119 | uint16_t warn_alert_latch_en:1;
00120 | uint16_t shunt_sum_en_ch3:1;
00121 | uint16_t shunt_sum_en_ch2:1;
00122 | uint16_t shunt_sum_en_ch1:1;
00123 | uint16_t reserved:1;
00124 | } masken_reg_t;
00125
00126 | // I2C address
00127 | ina3221_addr_t _i2c_addr;
00128 | i2c_inst_t* _i2c;
00129
00130 | // Shunt resistance in mOhm
00131 | uint32_t _shuntRes[INA3221_CH_NUM];
00132
00133 | // Series filter resistance in Ohm
00134 | uint32_t _filterRes[INA3221_CH_NUM];
00135
00136 | // Value of Mask/Enable register.
00137 | masken_reg_t _masken_reg;
00138
00139 | // Reads 16 bytes from a register.
00140 | void _read(ina3221_reg_t reg, uint16_t *val);
00141
00142 | // Writes 16 bytes to a register.
00143 | void _write(ina3221_reg_t reg, uint16_t *val);
00144
00145 public:
00146
00147 | INA3221(ina3221_addr_t addr, i2c_inst_t* i2c);
00148 | // Initializes INA3221

9.54 lib/powerman/PowerManager.cpp File Reference | 265
00149 | bool begin();
00150
00151 | // Gets a register value.
00152 | uint16_t read_register(ina3221_reg_t reg);
00153
00154 | // Sets operating mode to continious
00155 | void set_mode_continuous();
00156
00157 | // Sets operating mode to triggered (single-shot)
00158 | void set_mode_triggered();
00159
00160 | // Sets averaging mode. Sets number of samples that are collected
00161 | // and averaged togehter.
00162 | void set_averaging_mode(ina3221_avg_mode_t mode);
00163
00164 | // Gets manufacturer ID.
00165 | // Should read 0x5449.
00166 | uint16_t get_manufacturer_id();
00167
00168 | // Gets die ID.
00169 | // Should read 0x3220.
00170 | uint16_t get_die_id();
00171
00172 | // Gets shunt voltage in uV.
00173 | int32_t get_shunt_voltage(ina3221_ch_t channel);
00174
00175 | // Gets current in mA.
00176 | float get_current_ma(ina3221_ch_t channel);
00177
00178 | // Gets bus voltage in V.
00179 | float get_voltage(ina3221_ch_t channel);
00180 };
00181
00182 #endif

## 9.54 lib/powerman/PowerManager.cpp File Reference

Implementation of the PowerManager class, which manages power-related functions.

#include "PowerManager.h"

#include <iostream>

#include <sstream>

#include "pin_config.h"

Include dependency graph for PowerManager.cpp:

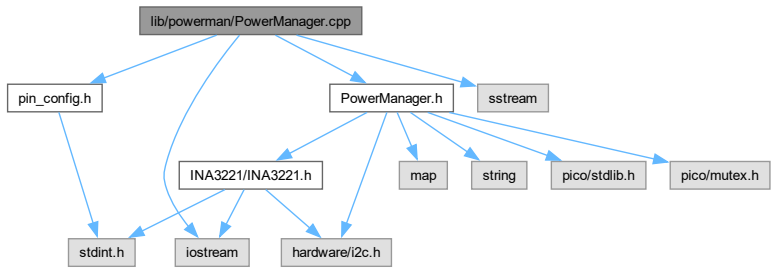
[picture p97: figure]
lib/powerman/PowerManager.cpp; PowerManager.h; iostream; pin_config.h; sstream; INA3221/INA3221.h; hardware/i2c.h; map; string; pico/stdlib.h; pico/mutex.h; stdint.h

### 9.54.1 Detailed Description

Implementation of the PowerManager class, which manages power-related functions.

This file implements the PowerManager class, a singleton that provides methods for reading voltage and current values, configuring the INA3221 power monitor, and checking power alerts.

Definition in file PowerManager.cpp.

266 File Documentation

## 9.55 PowerManager.cpp

Go to the documentation of this file.

00001
00014
00015 #include "PowerManager.h" 00016 #include <iostream>
00017 #include <sstream>
00018 #include "pin_config.h"
00019
00025 PowerManager::PowerManager()
00026 | : ina3221_(INA3221_ADDR40_GND, MAIN_I2C_PORT) {
00027 | recursive_mutex_init(&powerman_mutex_);
00028 }
00029
00035 PowerManager& PowerManager::get_instance() {
00036 | static PowerManager instance;
00037 | return instance;
00038 }
00039
00045 bool PowerManager::initialize() {
00046 | recursive_mutex_enter_blocking(&powerman_mutex_);
00047 | initialized_ = ina3221_.begin();
00048
00049 | recursive_mutex_exit(&powerman_mutex_);
00050 | return initialized_;
00051 }
00052
00058 std::string PowerManager::read_device_ids() {
00059 | if (!initialized_) return "noinit";
00060 | recursive_mutex_enter_blocking(&powerman_mutex_);
00061 | std::stringstream man_ss;
00062 | man_ss « std::hex « ina3221_.get_manufacturer_id();
00063 | std::string MAN = "MAN 0x" + man_ss.str();
00064
00065 | std::stringstream die_ss;
00066 | die_ss « std::hex « ina3221_.get_die_id();
00067 | std::string DIE = "DIE 0x" + die_ss.str();
00068 | recursive_mutex_exit(&powerman_mutex_);
00069 | return MAN + " - " + DIE;
00070 }
00071
00077 float PowerManager::get_voltage_battery() {
00078 | if (!initialized_) return 0.0f;
00079 | recursive_mutex_enter_blocking(&powerman_mutex_);
00080 | float voltage = ina3221_.get_voltage(INA3221_CH1);
00081 | recursive_mutex_exit(&powerman_mutex_);
00082 | return voltage;
00083 }
00084
00090 float PowerManager::get_voltage_5v() {
00091 | if (!initialized_) return 0.0f;
00092 | recursive_mutex_enter_blocking(&powerman_mutex_);
00093 | float voltage = ina3221_.get_voltage(INA3221_CH2);
00094 | recursive_mutex_exit(&powerman_mutex_);
00095 | return voltage;
00096 }
00097
00103 float PowerManager::get_voltage_solar() {
00104 | if (!initialized_) return 0.0f;
00105 | recursive_mutex_enter_blocking(&powerman_mutex_);
00106 | float voltage = ina3221_.get_voltage(INA3221_CH3);
00107 | recursive_mutex_exit(&powerman_mutex_);
00108 | return voltage;
00109 }
00110
00116 float PowerManager::get_current_charge_usb() {
00117 | if (!initialized_) return 0.0f;
00118 | recursive_mutex_enter_blocking(&powerman_mutex_);
00119 | float current = ina3221_.get_current_ma(INA3221_CH1);
00120 | recursive_mutex_exit(&powerman_mutex_);
00121 | return current;
00122 }
00123
00129 float PowerManager::get_current_draw() {
00130 | if (!initialized_) return 0.0f;
00131 | recursive_mutex_enter_blocking(&powerman_mutex_);
00132 | float current = ina3221_.get_current_ma(INA3221_CH2);
00133 | recursive_mutex_exit(&powerman_mutex_);
00134 | return current;
00135 }
00136
00142 float PowerManager::get_current_charge_solar() {
00143 | if (!initialized_) return 0.0f;
00144 | recursive_mutex_enter_blocking(&powerman_mutex_);

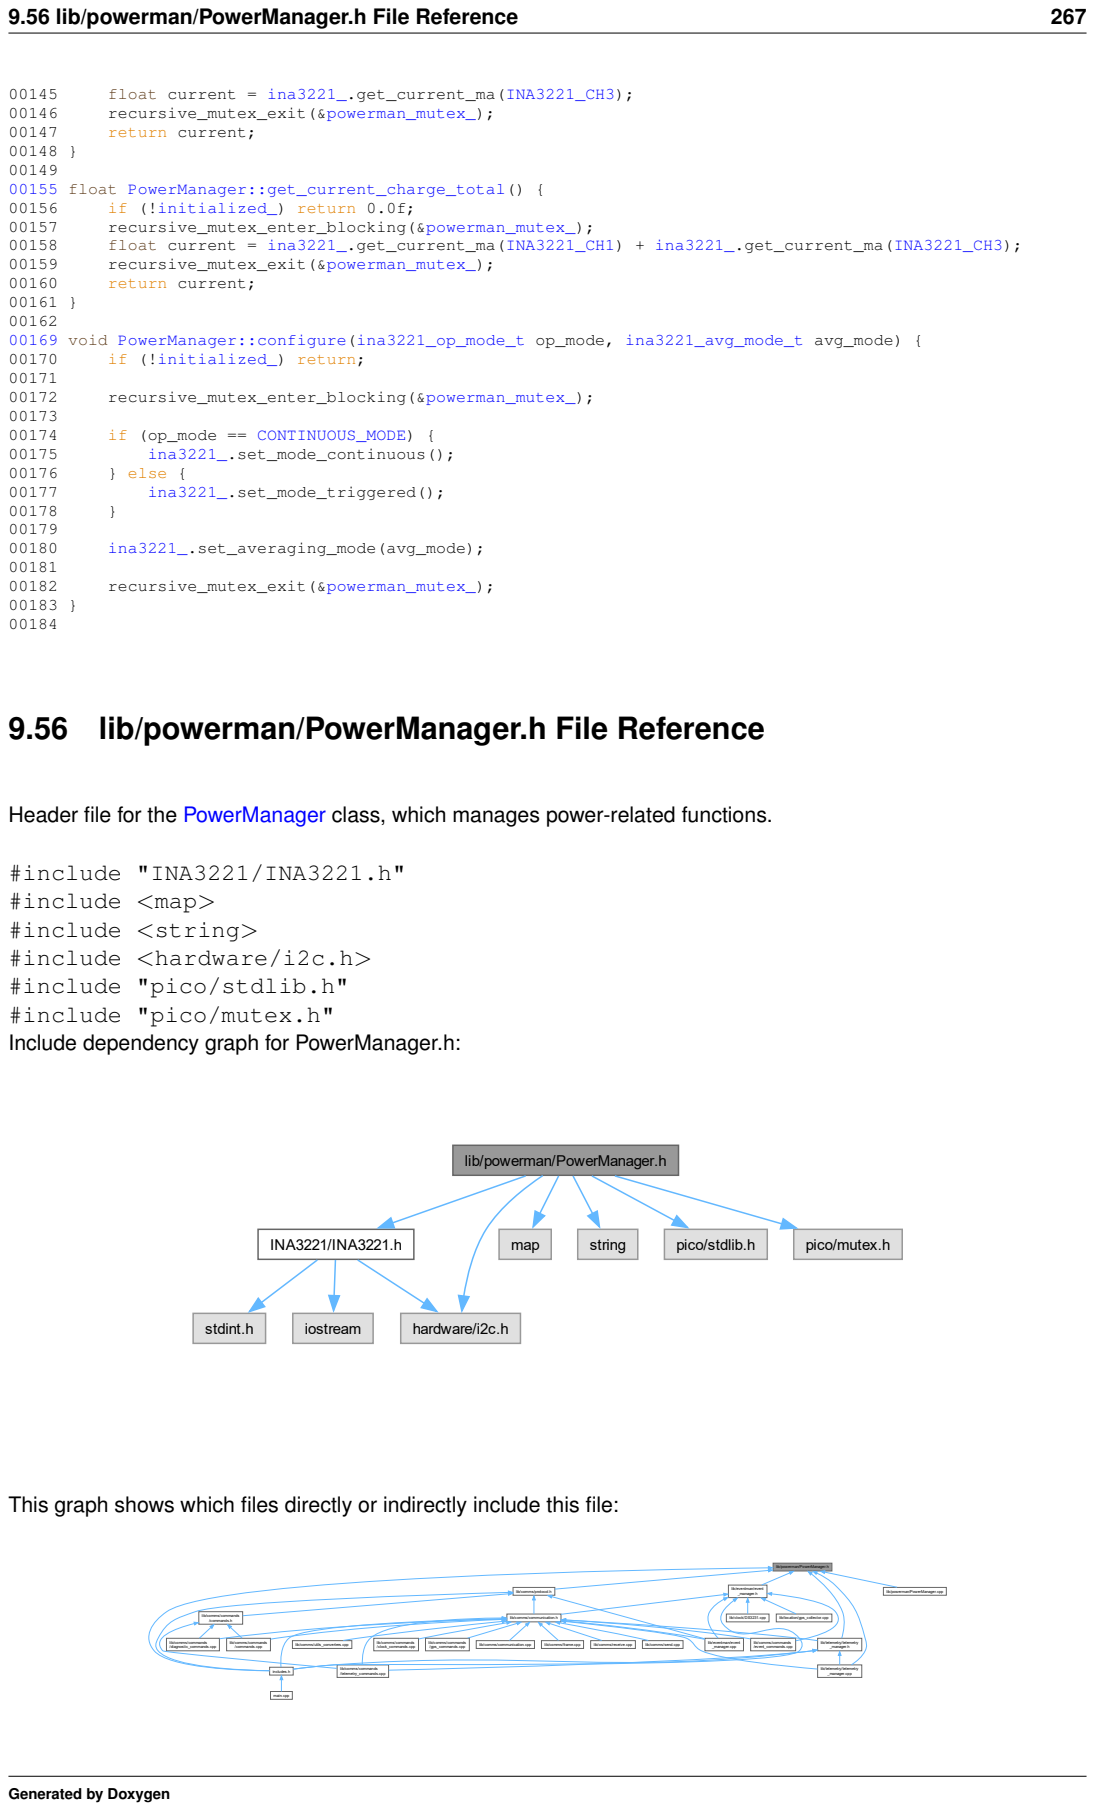
[picture p98: page 289]
9.56 lib/powerman/PowerManager.h File Reference; float current = ina3221_.get_current_ma(INA3221_CH3);; recursive_mutex_exit(&powerman_mutex_);; return current;; 00148 } 00149 00155 float PowerManager::get_current_charge_total() {; if (!initialized_) return 0.0f;; recursive_mutex_enter_blocking(&powerman_mutex_);; float current = ina3221_.get_current_ma(INA3221_CH1) + ina3221_.get_current_ma(INA3221_CH3);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

9.56 lib/powerman/PowerManager.h File Reference

Header file for the PowerManager class, which manages power-related functions.

#include "INA3221/INA3221.h"
#include <map>
#include <string>
#include <hardware/i2c.h>
#include "pico/stdlib.h"
#include "pico/mutex.h"
Include dependency graph for PowerManager.h:

lib/powerman/PowerManager.h

This graph shows which files directly or indirectly include this file:

lib/eventman/event

lib/comms/protocol.h

lib/comms/commands

/diagnostic_commands.cpp

/commands.cpp

/clock_commands.cpp

_manager.cpp

/event_commands.cpp

lib/telemetry/telemetry
_manager.h

/telemetry_commands.cpp

268 File Documentation

Classes

- class PowerManager

Manages power-related functions.

### 9.56.1 Detailed Description

Header file for the PowerManager class, which manages power-related functions.

This file defines the PowerManager class, a singleton that provides methods for reading voltage and current values, configuring the INA3221 power monitor, and checking power alerts.

Definition in file PowerManager.h.

## 9.57 PowerManager.h

Go to the documentation of this file.

00001
00014
00015 #ifndef POWER_MANAGER_H 00016 #define POWER_MANAGER_H 00017
00018 #include "INA3221/INA3221.h" 00019 #include <map>
00020 #include <string>
00021 #include <hardware/i2c.h> 00022 #include "pico/stdlib.h" 00023 #include "pico/mutex.h" 00024
00032 class PowerManager {
00033 public:
00038 | PowerManager(i2c_inst_t* i2c);
00039
00044 | static PowerManager& get_instance();
00045
00050 | bool initialize();
00051
00056 | std::string read_device_ids();
00057
00062 | float get_current_charge_solar();
00063
00068 | float get_current_charge_usb();
00069
00074 | float get_current_charge_total();
00075
00080 | float get_current_draw();
00081
00086 | float get_voltage_battery();
00087
00092 | float get_voltage_5v();
00093
00098 | float get_voltage_solar();
00099
00104 | void configure(ina3221_op_mode_t op_mode, ina3221_avg_mode_t avg_mode);
00105
00106
00108 | static constexpr float SOLAR_CURRENT_THRESHOLD = 50.0f; | // mA
00110 | static constexpr float USB_CURRENT_THRESHOLD = 50.0f; | // mA
00112 | static constexpr float BATTERY_LOW_THRESHOLD = 2.8f; | // V
00114 | static constexpr float BATTERY_FULL_THRESHOLD = 4.2f; // V
00115
00116 private:
00118 | INA3221 ina3221_;
00120 | bool initialized_;
00122 | recursive_mutex_t powerman_mutex_;
00123
00128 | PowerManager();
00129
00133 | PowerManager(const PowerManager&) = delete;
00137 | PowerManager& operator=(const PowerManager&) = delete;
00138 };
00139
00140 #endif // POWER_MANAGER_H

9.58 lib/sensors/BH1750/BH1750.cpp File Reference | 269

## 9.58 lib/sensors/BH1750/BH1750.cpp File Reference

Implementation of the BH1750 light sensor class.

#include "BH1750.h"

#include "pico/stdlib.h"

#include <stdio.h>

#include <iostream>

Include dependency graph for BH1750.cpp:

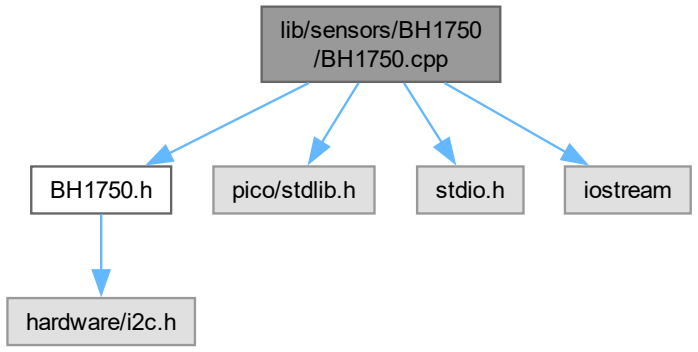
[picture p99: figure]
lib/sensors/BH1750 /BH1750.cpp; pico/stdlib.h; stdio.h; iostream; hardware/i2c.h

### 9.58.1 Detailed Description

Implementation of the BH1750 light sensor class.

This file contains the implementation of the BH1750 class, which provides an interface to the BH1750 digital light sensor using the I2C communication protocol.

Definition in file BH1750.cpp.

## 9.59 BH1750.cpp

Go to the documentation of this file.

00001
00008
00009 #include "BH1750.h"
00010 #include "pico/stdlib.h" 00011 #include <stdio.h>
00012 #include <iostream>
00013
00020 BH1750::BH1750(i2c_inst_t* i2c, uint8_t addr) : _i2c_addr(addr), i2c_port_(i2c) {} 00021
00028 bool BH1750::begin(Mode mode) {
00029 | write8(static_cast<uint8_t>(Mode::POWER_ON));
00030 | write8(static_cast<uint8_t>(Mode::RESET));
00031 | bool config_status = configure(mode);
00032
00033 | return config_status;
00034 }
00035

270 File Documentation

00042 bool BH1750::configure(Mode mode) {
00043 | uint8_t modeVal = static_cast<uint8_t>(mode);
00044 | switch (mode) {
00045 | case Mode::UNCONFIGURED_POWER_DOWN:
00046 | case Mode::POWER_ON:
00047 | case Mode::RESET:
00048 | case Mode::CONTINUOUS_HIGH_RES_MODE:
00049 | case Mode::CONTINUOUS_HIGH_RES_MODE_2:
00050 | case Mode::CONTINUOUS_LOW_RES_MODE:
00051 | case Mode::ONE_TIME_HIGH_RES_MODE:
00052 | case Mode::ONE_TIME_HIGH_RES_MODE_2:
00053 | case Mode::ONE_TIME_LOW_RES_MODE:
00054 | write8(modeVal);
00055 | sleep_ms(10);
00056 | return true;
00057 | default:
00058 | return false;
00059 | }
00060 }
00061
00067 float BH1750::get_light_level() {
00068 | uint8_t buffer[2];
00069 | i2c_read_blocking(i2c_port_, _i2c_addr, buffer, 2, false);
00070 | uint16_t level = (buffer[0] « 8) | buffer[1];
00071
00072 | float lux = static_cast<float>(level) / 1.2f;
00073 | return lux;
00074 }
00075
00081 void BH1750::write8(uint8_t data) {
00082 | uint8_t buf[1] = {data};
00083 | i2c_write_blocking(i2c_port_, _i2c_addr, buf, 1, false);
00084 }

## 9.60 lib/sensors/BH1750/BH1750.h File Reference

Header file for the BH1750 light sensor class.

#include "hardware/i2c.h"

Include dependency graph for BH1750.h:

### lib/sensors/BH1750 /BH1750.h

hardware/i2c.h | Generated by Doxygen

9.60 lib/sensors/BH1750/BH1750.h File Reference | 271

This graph shows which files directly or indirectly include this file:

Classes

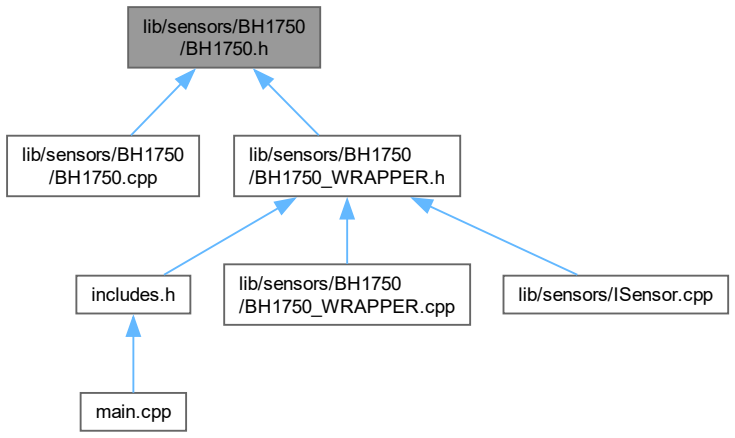
[picture p100: figure]
lib/sensors/BH1750 /BH1750.h; lib/sensors/BH1750 /BH1750.cpp; lib/sensors/BH1750 /BH1750_WRAPPER.h; includes.h; lib/sensors/BH1750; /BH1750_WRAPPER.cpp; lib/sensors/ISensor.cpp; main.cpp

- class BH1750

Class to interface with the BH1750 light sensor.

Macros

- #define _BH1750_DEVICE_ID 0xE1

Correct content of WHO_AM_I register (not actually used in this driver).
- #define _BH1750_MTREG_MIN 31

Minimum value for the MTREG register.
- #define _BH1750_MTREG_MAX 254

Maximum value for the MTREG register.
- #define _BH1750_DEFAULT_MTREG 69

Default value for the MTREG register.

### 9.60.1 Detailed Description

Header file for the BH1750 light sensor class.

This class provides an interface to the BH1750 digital light sensor using the I2C communication protocol.

Definition in file BH1750.h.

272 File Documentation

## 9.61 BH1750.h

Go to the documentation of this file.

00001
00008
00009 #ifndef __BH1750_H__ 00010 #define __BH1750_H__ 00011
00012 #include "hardware/i2c.h" 00013
00019
00025
00031
00036 #define _BH1750_DEVICE_ID 0xE1 00037
00042 #define _BH1750_MTREG_MIN 31 00043
00048 #define _BH1750_MTREG_MAX 254 00049
00054 #define _BH1750_DEFAULT_MTREG 69 00055
00060 class BH1750 {
00061 public:
00066 | enum class Mode : uint8_t {
00068 | UNCONFIGURED_POWER_DOWN = 0x00,
00070 | POWER_ON = 0x01,
00072 | RESET = 0x07,
00074 | CONTINUOUS_HIGH_RES_MODE = 0x10,
00076 | CONTINUOUS_HIGH_RES_MODE_2 = 0x11,
00078 | CONTINUOUS_LOW_RES_MODE = 0x13,
00080 | ONE_TIME_HIGH_RES_MODE = 0x20,
00082 | ONE_TIME_HIGH_RES_MODE_2 = 0x21,
00084 | ONE_TIME_LOW_RES_MODE = 0x23
00085 | };
00086
00092 | BH1750(i2c_inst_t* i2c, uint8_t addr = 0x23);
00093
00099 | bool begin(Mode mode = Mode::CONTINUOUS_HIGH_RES_MODE);
00100
00106 | bool configure(Mode mode);
00107
00112 | float get_light_level();
00113
00114 private:
00119 | void write8(uint8_t data);
00120
00122 | uint8_t _i2c_addr;
00124 | i2c_inst_t* i2c_port_;
00125 };
00126
00127 #endif // __BH1750_H__

## 9.62 lib/sensors/BH1750/BH1750_WRAPPER.cpp File Reference

#include "BH1750_WRAPPER.h" #include <string>

#include <iostream>

9.63 BH1750_WRAPPER.cpp | 273

Include dependency graph for BH1750_WRAPPER.cpp:

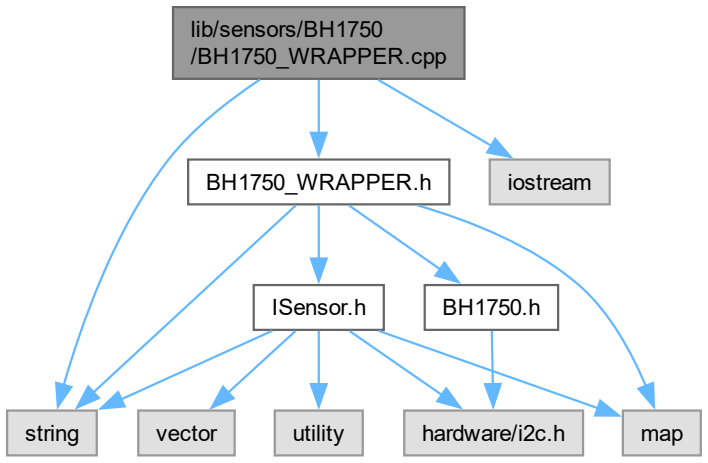
[picture p101: figure]
lib/sensors/BH1750 /BH1750_WRAPPER.cpp; BH1750_WRAPPER.h; string; iostream; ISensor.h; map; vector; utility; hardware/i2c.h

## 9.63 BH1750_WRAPPER.cpp

Go to the documentation of this file.

00001 #include "BH1750_WRAPPER.h" 00002 #include <string>
00003 #include <iostream>
00004
00005 BH1750Wrapper::BH1750Wrapper(i2c_inst_t* i2c) : sensor_(i2c) {
00006 | sensor_.configure(BH1750::Mode::CONTINUOUS_HIGH_RES_MODE);
00007 }
00008
00009 bool BH1750Wrapper::init() {
00010 | initialized_ = sensor_.begin();
00011 | return initialized_;
00012 }
00013
00014 float BH1750Wrapper::read_data(SensorDataTypeIdentifier type) {
00015 | if (type == SensorDataTypeIdentifier::LIGHT_LEVEL) {
00016 | return sensor_.get_light_level();
00017 | }
00018 | return 0.0f;
00019 }
00020
00021 bool BH1750Wrapper::is_initialized() const {
00022 | return initialized_;
00023 }
00024
00025 SensorType BH1750Wrapper::get_type() const {
00026 | return SensorType::LIGHT;
00027 }
00028
00029 bool BH1750Wrapper::configure(const std::map<std::string, std::string>& config) {
00030 | for (const auto& [key, value] : config) {
00031 | if (key == "measurement_mode") {
00032 | if (value == "continuously_high_resolution") {
00033 | sensor_.configure(BH1750::Mode::CONTINUOUS_HIGH_RES_MODE);
00034 | }
00035 | else if (value == "continuously_high_resolution_2") {
00036 | sensor_.configure(BH1750::Mode::CONTINUOUS_HIGH_RES_MODE_2);
00037 | }
00038 | else if (value == "continuously_low_resolution") {
00039 | sensor_.configure(BH1750::Mode::CONTINUOUS_LOW_RES_MODE);
00040 | }
00041 | else if (value == "one_time_high_resolution") {

274 File Documentation

00042 | sensor_.configure(BH1750::Mode::ONE_TIME_HIGH_RES_MODE);
00043 | }
00044 | else if (value == "one_time_high_resolution_2") {
00045 | sensor_.configure(BH1750::Mode::ONE_TIME_HIGH_RES_MODE_2);
00046 | }
00047 | else if (value == "one_time_low_resolution") {
00048 | sensor_.configure(BH1750::Mode::ONE_TIME_LOW_RES_MODE);
00049 | }
00050 | else {
00051 | std::cerr « "[BH1750Wrapper] Unknown measurement_mode value: " « value « std::endl;
00052 | return false;
00053 | }
00054 | }
00055 | else {
00056 | std::cerr « "[BH1750Wrapper] Unknown configuration key: " « key « std::endl;
00057 | return false;
00058 | }
00059 | }
00060 | return true;
00061 }

## 9.64 lib/sensors/BH1750/BH1750_WRAPPER.h File Reference

#include "ISensor.h"

#include "BH1750.h"

#include <map>

#include <string>

Include dependency graph for BH1750_WRAPPER.h:

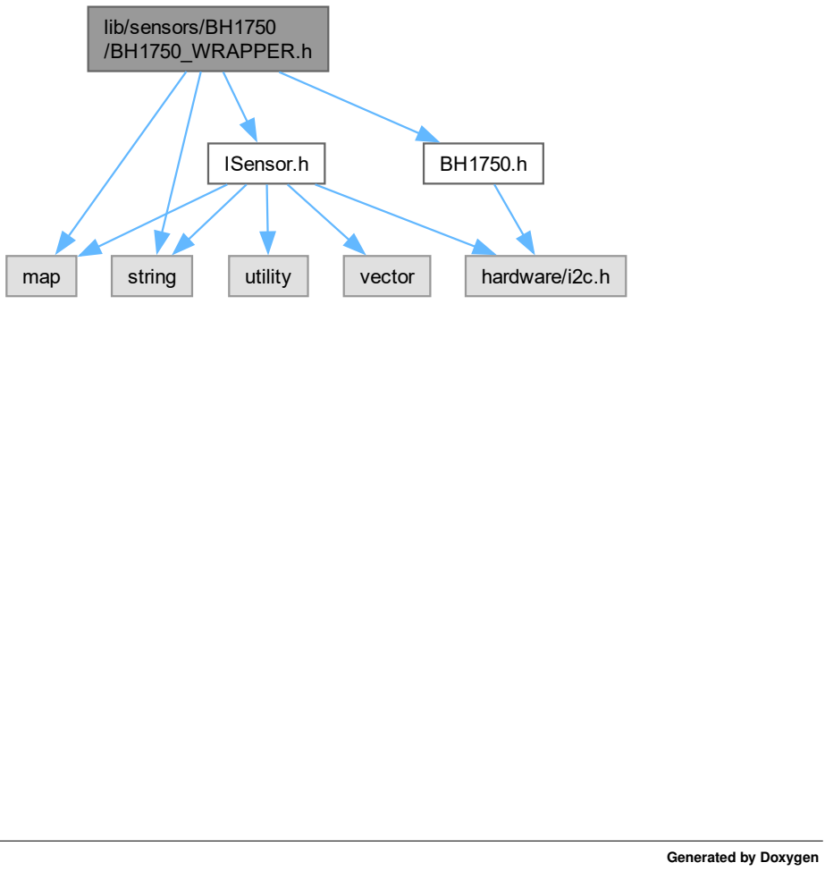
[picture p102: figure]
lib/sensors/BH1750 /BH1750_WRAPPER.h; ISensor.h; map; string; utility; vector; hardware/i2c.h; Generated by Doxygen

9.65 BH1750_WRAPPER.h | 275

This graph shows which files directly or indirectly include this file:

lib/sensors/BH1750
/BH1750_WRAPPER.h
includes.h | lib/sensors/BH1750
/BH1750_WRAPPER.cpp | lib/sensors/ISensor.cpp

main.cpp

Classes

- class BH1750Wrapper

## 9.65 BH1750_WRAPPER.h

Go to the documentation of this file.

00001 #ifndef BH1750_WRAPPER_H 00002 #define BH1750_WRAPPER_H 00003
00004 #include "ISensor.h" 00005 #include "BH1750.h"
00006 #include <map>
00007 #include <string>
00008
00009 class BH1750Wrapper : public ISensor { 00010 private:
00011 | BH1750 sensor_;
00012 | bool initialized_ = false;
00013
00014 public:
00015 | BH1750Wrapper(i2c_inst_t* i2c);
00016 | BH1750Wrapper();
00017 | int get_i2c_addr();
00018 | bool init() override;
00019 | float read_data(SensorDataTypeIdentifier type) override;
00020 | bool is_initialized() const override;
00021 | SensorType get_type() const override;
00022
00023 | bool configure(const std::map<std::string, std::string>& config);
00024
00025 | uint8_t get_address() const override {
00026 | return 0x23;
00027 | }
00028 };
00029
00030 #endif // BH1750_WRAPPER_H

## 9.66 lib/sensors/BME280/BME280.cpp File Reference

Implementation of the BME280 environmental sensor class.

276 File Documentation

#include "BME280.h"

#include <iomanip>

#include <vector>

#include <algorithm>

#include "hardware/i2c.h"

#include "pico/binary_info.h" #include "pico/stdlib.h"

#include "utils.h"

Include dependency graph for BME280.cpp:

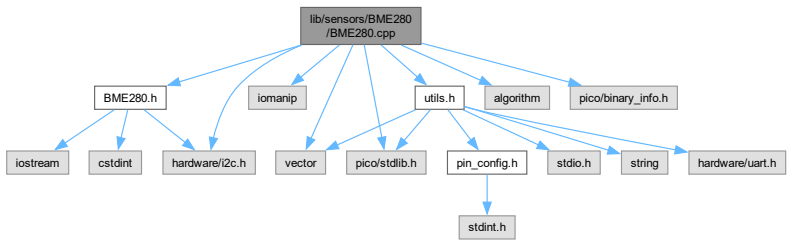
[picture p103: figure]
lib/sensors/BME280 /BME280.cpp; BME280.h; hardware/i2c.h; iomanip; vector; algorithm; pico/binary_info.h; pico/stdlib.h; utils.h; iostream; cstdint; pin_config.h; stdio.h; string; hardware/uart.h; stdint.h

### 9.66.1 Detailed Description

Implementation of the BME280 environmental sensor class.

This file contains the implementation of the BME280 class, which provides an interface to the BME280 temperature, pressure, and humidity sensor using the I2C communication protocol.

Definition in file BME280.cpp.

## 9.67 BME280.cpp

Go to the documentation of this file.

00001
00009
00010 #include "BME280.h"
00011 #include <iomanip>
00012 #include <vector>
00013 #include <algorithm>
00014 #include "hardware/i2c.h" 00015 #include "pico/binary_info.h" 00016 #include "pico/stdlib.h"
00017 #include "utils.h"
00018
00024 BME280::BME280(i2c_inst_t* i2cPort, uint8_t address)
00025 | : i2c_port(i2cPort), device_addr(address), calib_params{}, initialized_(false), t_fine(0) {
00026 }
00027
00032 bool BME280::init() {
00033 | if (!i2c_port) {
00034 | uart_print("BME280 I2C port not initialized.", VerbosityLevel::ERROR);
00035 | return false;
00036 | }
00037
00038 | // Check device ID to confirm it’s a BME280
00039 | uint8_t chip_id;
00040 | if (!read_register(0xD0, &chip_id)) {
00041 | uart_print("Failed to read chip ID from BME280.", VerbosityLevel::ERROR);
00042 | return false;
00043 | }
00044

9.67 BME280.cpp | 277

if (chip_id != 0x60) {
uart_print("Invalid BME280 chip ID.", VerbosityLevel::ERROR); return false;
}

// Configure sensor
if (!configure_sensor()) {
uart_print("Failed to configure BME280 sensor.", VerbosityLevel::ERROR); return false;
}

// Retrieve calibration parameters
if (!get_calibration_parameters()) {
uart_print("Failed to get calibration parameters from BME280.", VerbosityLevel::ERROR); return false;
}

initialized_ = true;
uart_print("BME280 initialized.", VerbosityLevel::INFO); return true;
00065 }

00070 void BME280::reset() { write_register(REG_RESET, 0xB6); sleep_ms(10); // Wait for reset to complete 00073 }

00082 bool BME280::read_raw_all(int32_t* temperature, int32_t* pressure, int32_t* humidity) { if (!initialized_) {
uart_print("BME280 not initialized.", VerbosityLevel::ERROR); return false;
}

// Define the starting register address
uint8_t start_reg = REG_PRESSURE_MSB;
// Total bytes to read: 3 (pressure) + 3 (temperature) + 2 (humidity) = 8 uint8_t buf[8] = {0};

// Write the starting register address
if (!write_register(start_reg, 1)) {
uart_print("Failed to write to BME280.", VerbosityLevel::ERROR); return false;
}

// Read data
int ret = i2c_read_blocking(i2c_port, device_addr, buf, 8, false); if (ret != 8) {
uart_print("Failed to read from BME280.", VerbosityLevel::ERROR); return false;
}

// Combine bytes to form raw values
*pressure = ((int32_t)buf[0] « 12) | ((int32_t)buf[1] « 4) | ((int32_t)(buf[2] » 4));
*temperature = ((int32_t)buf[3] « 12) | ((int32_t)buf[4] « 4) | ((int32_t)(buf[5] » 4));
*humidity = ((int32_t)buf[6] « 8) | (int32_t)buf[7];

return true;
00112 }

00119 float BME280::convert_temperature(int32_t temp_raw) const { int32_t var1, var2;
var1 = ((((temp_raw » 3) - ((int32_t)calib_params.dig_t1 « 1))) * ((int32_t)calib_params.dig_t2)) » 11;
var2 = (((((temp_raw » 4) - ((int32_t)calib_params.dig_t1)) * ((temp_raw » 4) -((int32_t)calib_params.dig_t1))) » 12) * ((int32_t)calib_params.dig_t3)) » 14;
t_fine = var1 + var2;
float T = (t_fine * 5 + 128) » 8;
return T / 100.0f;
00126 }

00133 float BME280::convert_pressure(int32_t pressure_raw) const { int64_t var1, var2, p;
var1 = ((int64_t)t_fine) - 128000;
var2 = var1 * var1 * (int64_t)calib_params.dig_p6;
var2 = var2 + ((var1 * (int64_t)calib_params.dig_p5) « 17);
var2 = var2 + (((int64_t)calib_params.dig_p4) « 35);
var1 = ((var1 * var1 * (int64_t)calib_params.dig_p3) » 8) + ((var1 * (int64_t)calib_params.dig_p2) « 12);
var1 = ((((int64_t)1 « 47) + var1)) * ((int64_t)calib_params.dig_p1) » 33;

if (var1 == 0) {
return 0.0f; // avoid exception caused by division by zero
}
p = 1048576 - pressure_raw;
p = (((p « 31) - var2) * 3125) / var1;
var1 = (((int64_t)calib_params.dig_p9) * (p » 13) * (p » 13)) » 25; var2 = (((int64_t)calib_params.dig_p8) * p) » 19;

278 File Documentation

p = ((p + var1 + var2) » 8) + (((int64_t)calib_params.dig_p7) « 4); return (float)p / 25600.0f; // in hPa
00152 }

00159 float BME280::convert_humidity(int32_t humidity_raw) const { int32_t v_x1_u32r;
v_x1_u32r = t_fine - 76800;
v_x1_u32r = (((((humidity_raw « 14) - ((int32_t)calib_params.dig_h4 « 20) -((int32_t)calib_params.dig_h5 * v_x1_u32r)) + 16384) » 15) *
(((((((v_x1_u32r * (int32_t)calib_params.dig_h6) » 10) * (((v_x1_u32r * (int32_t)calib_params.dig_h3) » 11) + 32768)) » 10) + 2097152) * (int32_t)calib_params.dig_h2 + 8192) » 14));
v_x1_u32r = std::max(v_x1_u32r, (int32_t)0);
v_x1_u32r = std::min(v_x1_u32r, (int32_t)419430400);
float h = v_x1_u32r » 12;
return h / 1024.0f;
00169 }

00175 bool BME280::get_calibration_parameters() { // Read temperature and pressure calibration data (0x88 to 0xA1)
uint8_t calib_data[NUM_CALIB_PARAMS];
if (!read_register(REG_DIG_T1_LSB, calib_data, NUM_CALIB_PARAMS)) { uart_print("Failed to read calibration data from BME280.", VerbosityLevel::ERROR); return false;
}

// Parse temperature calibration data
calib_params.dig_t1 = (uint16_t)(calib_data[1] « 8 | calib_data[0]);
calib_params.dig_t2 = (int16_t)(calib_data[3] « 8 | calib_data[2]);
calib_params.dig_t3 = (int16_t)(calib_data[5] « 8 | calib_data[4]);

// Parse pressure calibration data
calib_params.dig_p1 = (uint16_t)(calib_data[7] « 8 | calib_data[6]);
calib_params.dig_p2 = (int16_t)(calib_data[9] « 8 | calib_data[8]);
calib_params.dig_p3 = (int16_t)(calib_data[11] « 8 | calib_data[10]);
calib_params.dig_p4 = (int16_t)(calib_data[13] « 8 | calib_data[12]);
calib_params.dig_p5 = (int16_t)(calib_data[15] « 8 | calib_data[14]);
calib_params.dig_p6 = (int16_t)(calib_data[17] « 8 | calib_data[16]);
calib_params.dig_p7 = (int16_t)(calib_data[19] « 8 | calib_data[18]);
calib_params.dig_p8 = (int16_t)(calib_data[21] « 8 | calib_data[20]);
calib_params.dig_p9 = (int16_t)(calib_data[23] « 8 | calib_data[22]);

calib_params.dig_h1 = calib_data[25];

// Read humidity calibration data (0xE1 to 0xE7)
uint8_t hum_calib_data[NUM_HUM_CALIB_PARAMS];
if (!read_register(REG_DIG_H2, hum_calib_data, NUM_HUM_CALIB_PARAMS)) {
uart_print("Failed to read humidity calibration data from BME280.", VerbosityLevel::ERROR); return false;
}

// Parse humidity calibration data
calib_params.dig_h2 = (int16_t)(hum_calib_data[1] « 8 | hum_calib_data[0]);
calib_params.dig_h3 = hum_calib_data[2];
calib_params.dig_h4 = (int16_t)((hum_calib_data[3] « 4) | (hum_calib_data[4] & 0x0F));
calib_params.dig_h5 = (int16_t)((hum_calib_data[5] « 4) | (hum_calib_data[4] » 4));
calib_params.dig_h6 = (int8_t)hum_calib_data[6];

return true;
00216 }

00222 bool BME280::configure_sensor() { // Set humidity oversampling (must be set before ctrl_meas)
if (!write_register(REG_CTRL_HUM, HUMIDITY_OVERSAMPLING)) { uart_print("Failed to write CTRL_HUM to BME280.", VerbosityLevel::ERROR); return false;
}

// Write config register
if (!write_register(REG_CONFIG, 0x00)) {
uart_print("Failed to write CONFIG to BME280.", VerbosityLevel::ERROR); return false;
}

// Write ctrl_meas register
if (!write_register(REG_CTRL_MEAS, NORMAL_MODE)) {
uart_print("Failed to write CTRL_MEAS to BME280.", VerbosityLevel::ERROR); return false;
}

return true;
00242 }

00250 bool BME280::write_register(uint8_t reg, uint8_t value) { uint8_t buf[2] = {reg, value};
int ret = i2c_write_blocking(i2c_port, device_addr, buf, 2, false);

9.68 lib/sensors/BME280/BME280.h File Reference | 279
00253 | return (ret == 2);
00254 }
00255
00263 bool BME280::read_register(uint8_t reg, uint8_t* data, size_t len) {
00264 | int ret = i2c_write_blocking(i2c_port, device_addr, &reg, 1, true);
00265 | if (ret != 1) {
00266 | return false;
00267 | }
00268 | ret = i2c_read_blocking(i2c_port, device_addr, data, len, false);
00269 | return (static_cast<size_t>(ret) == len);
00270 }
00271
00278 bool BME280::read_register(uint8_t reg, uint8_t* data) {
00279 | return read_register(reg, data, 1);
00280 }

## 9.68 lib/sensors/BME280/BME280.h File Reference

Header file for the BME280 environmental sensor class.

#include <cstdint>

#include <iostream>

#include "hardware/i2c.h"

Include dependency graph for BME280.h:

### lib/sensors/BME280 /BME280.h

cstdint | iostream | hardware/i2c.h Generated by Doxygen

280 File Documentation

This graph shows which files directly or indirectly include this file:

Classes

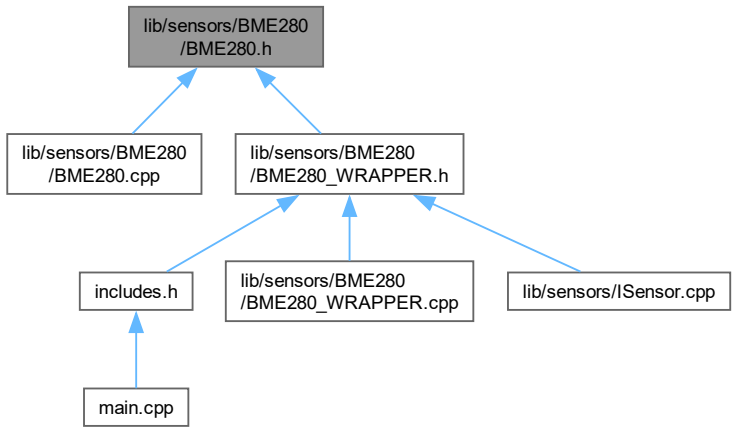
[picture p104: figure]
lib/sensors/BME280 /BME280.h; lib/sensors/BME280 /BME280.cpp; lib/sensors/BME280 /BME280_WRAPPER.h; includes.h; lib/sensors/BME280; /BME280_WRAPPER.cpp; lib/sensors/ISensor.cpp; main.cpp

- struct BME280CalibParam

Structure to hold the BME280 calibration parameters.
- class BME280

Class to interface with the BME280 environmental sensor.

### 9.68.1 Detailed Description

Header file for the BME280 environmental sensor class.

This class provides an interface to the BME280 temperature, pressure, and humidity sensor using the I2C communication protocol. It includes functions for initialization, reading raw sensor data, converting raw data to physical units, and configuring the sensor's operating mode.

Definition in file BME280.h.

## 9.69 BME280.h

Go to the documentation of this file.

00001
00009
00010 #ifndef BME280_H
00011 #define BME280_H
00012
00013 #include <cstdint>
00014 #include <iostream>
00015 #include "hardware/i2c.h" 00016
00023 struct BME280CalibParam {
00025 | uint16_t dig_t1;
00027 | int16_t | dig_t2;
00029 | int16_t | dig_t3;

9.69 BME280.h | 281

00030
00032 | uint16_t dig_p1;
00034 | int16_t | dig_p2;
00036 | int16_t | dig_p3;
00038 | int16_t | dig_p4;
00040 | int16_t | dig_p5;
00042 | int16_t | dig_p6;
00044 | int16_t | dig_p7;
00046 | int16_t | dig_p8;
00048 | int16_t | dig_p9;
00049
00051 | uint8_t | dig_h1;
00053 | int16_t | dig_h2;
00055 | uint8_t | dig_h3;
00057 | int16_t | dig_h4;
00059 | int16_t | dig_h5;
00061 | int8_t | dig_h6;
00062 };
00063
00071 class BME280 {
00072 public:
00076 | enum {
00078 | ADDR_SDO_LOW = 0x76,
00080 | ADDR_SDO_HIGH = 0x77
00081 | };
00082
00089 | enum class Oversampling : uint8_t {
00091 | OSR_X0 = 0x00,
00093 | OSR_X1 = 0x01,
00095 | OSR_X2 = 0x02,
00097 | OSR_X4 = 0x03,
00099 | OSR_X8 = 0x04,
00101 | OSR_X16 = 0x05
00102 | };
00103
00109 | BME280(i2c_inst_t* i2cPort, uint8_t address = ADDR_SDO_LOW);
00110
00115 | bool init();
00116
00120 | void reset();
00121
00129 | bool read_raw_all(int32_t* temperature, int32_t* pressure, int32_t* humidity);
00130
00136 | float convert_temperature(int32_t temp_raw) const;
00137
00143 | float convert_pressure(int32_t pressure_raw) const;
00144
00150 | float convert_humidity(int32_t humidity_raw) const;
00151
00152 private:
00159 | bool write_register(uint8_t reg, uint8_t value);
00160
00167 | bool read_register(uint8_t reg, uint8_t* data);
00168
00176 | bool read_register(uint8_t reg, uint8_t* data, size_t len);
00177
00182 | bool configure_sensor();
00183
00188 | bool get_calibration_parameters();
00189
00191 | i2c_inst_t* i2c_port;
00193 | uint8_t device_addr;
00194
00196 | BME280CalibParam calib_params;
00197
00199 | bool initialized_;
00200
00202 | mutable int32_t t_fine;
00203
00207 | enum {
00208 | REG_CONFIG | = 0xF5,
00209 | REG_CTRL_MEAS | = 0xF4,
00210 | REG_CTRL_HUM | = 0xF2,
00211 | REG_RESET | = 0xE0,
00212
00213 | REG_PRESSURE_MSB | = 0xF7,
00214 | REG_TEMPERATURE_MSB | = 0xFA,
00215 | REG_HUMIDITY_MSB | = 0xFD,
00216
00217 | // Calibration Registers
00218 | REG_DIG_T1_LSB | = 0x88,
00219 | REG_DIG_T1_MSB | = 0x89,
00220 | REG_DIG_T2_LSB | = 0x8A,
00221 | REG_DIG_T2_MSB | = 0x8B,
00222 | REG_DIG_T3_LSB | = 0x8C,
00223 | REG_DIG_T3_MSB | = 0x8D,
00224

282 File Documentation

00225 | REG_DIG_P1_LSB | = 0x8E,
00226 | REG_DIG_P1_MSB | = 0x8F,
00227 | REG_DIG_P2_LSB | = 0x90,
00228 | REG_DIG_P2_MSB | = 0x91,
00229 | REG_DIG_P3_LSB | = 0x92,
00230 | REG_DIG_P3_MSB | = 0x93,
00231 | REG_DIG_P4_LSB | = 0x94,
00232 | REG_DIG_P4_MSB | = 0x95,
00233 | REG_DIG_P5_LSB | = 0x96,
00234 | REG_DIG_P5_MSB | = 0x97,
00235 | REG_DIG_P6_LSB | = 0x98,
00236 | REG_DIG_P6_MSB | = 0x99,
00237 | REG_DIG_P7_LSB | = 0x9A,
00238 | REG_DIG_P7_MSB | = 0x9B,
00239 | REG_DIG_P8_LSB | = 0x9C,
00240 | REG_DIG_P8_MSB | = 0x9D,
00241 | REG_DIG_P9_LSB | = 0x9E,
00242 | REG_DIG_P9_MSB | = 0x9F,
00243
00244 | // Humidity Calibration Registers
00245 | REG_DIG_H1 | = 0xA1,
00246 | REG_DIG_H2 | = 0xE1,
00247 | REG_DIG_H3 | = 0xE3,
00248 | REG_DIG_H4 | = 0xE4,
00249 | REG_DIG_H5 | = 0xE5,
00250 | REG_DIG_H6 | = 0xE7
00251 | };
00252
00256 | enum {
00257 | HUMIDITY_OVERSAMPLING = static_cast<uint8_t>(Oversampling::OSR_X16),
00258 | TEMPERATURE_OVERSAMPLING = static_cast<uint8_t>(Oversampling::OSR_X16),
00259 | PRESSURE_OVERSAMPLING = static_cast<uint8_t>(Oversampling::OSR_X16),
00260 | NORMAL_MODE = 0xB7
00261 | };
00262
00266 | enum {
00267 | NUM_CALIB_PARAMS = 26,
00268 | NUM_HUM_CALIB_PARAMS = 7
00269 | };
00270 };
00271
00272 #endif // BME280_H

## 9.70 lib/sensors/BME280/BME280_WRAPPER.cpp File Reference

#include "BME280_WRAPPER.h"

Include dependency graph for BME280_WRAPPER.cpp:

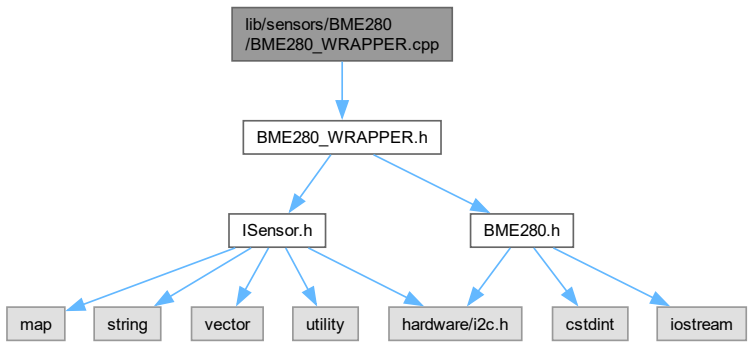
[picture p105: figure]
lib/sensors/BME280 /BME280_WRAPPER.cpp; BME280_WRAPPER.h; ISensor.h; BME280.h; map; string; vector; utility; hardware/i2c.h; cstdint; iostream

## 9.71 BME280_WRAPPER.cpp

Go to the documentation of this file.

9.72 lib/sensors/BME280/BME280_WRAPPER.h File Reference | 283

00001 #include "BME280_WRAPPER.h"
00002
00003 BME280Wrapper::BME280Wrapper(i2c_inst_t* i2c) : sensor_(i2c) {} 00004
00005 bool BME280Wrapper::init() {
00006 | initialized_ = sensor_.init();
00007 | return initialized_;
00008 }
00009
00010 float BME280Wrapper::read_data(SensorDataTypeIdentifier type) {
00011 | int32_t temp_raw, pressure_raw, humidity_raw;
00012 | sensor_.read_raw_all(&temp_raw, &pressure_raw, &humidity_raw);
00013
00014 | switch(type) {
00015 | case SensorDataTypeIdentifier::TEMPERATURE:
00016 | return sensor_.convert_temperature(temp_raw);
00017 | case SensorDataTypeIdentifier::PRESSURE:
00018 | return sensor_.convert_pressure(pressure_raw);
00019 | case SensorDataTypeIdentifier::HUMIDITY:
00020 | return sensor_.convert_humidity(humidity_raw);
00021 | default:
00022 | return 0.0f;
00023 | }
00024 }
00025
00026 bool BME280Wrapper::is_initialized() const {
00027 | return initialized_;
00028 }
00029
00030 SensorType BME280Wrapper::get_type() const {
00031 | return SensorType::ENVIRONMENT;
00032 }
00033
00034 bool BME280Wrapper::configure([[maybe_unused]] const std::map<std::string, std::string>& config) {
00035 | return true;
00036 }

## 9.72 lib/sensors/BME280/BME280_WRAPPER.h File Reference

#include "ISensor.h"

#include "BME280.h"

Include dependency graph for BME280_WRAPPER.h:

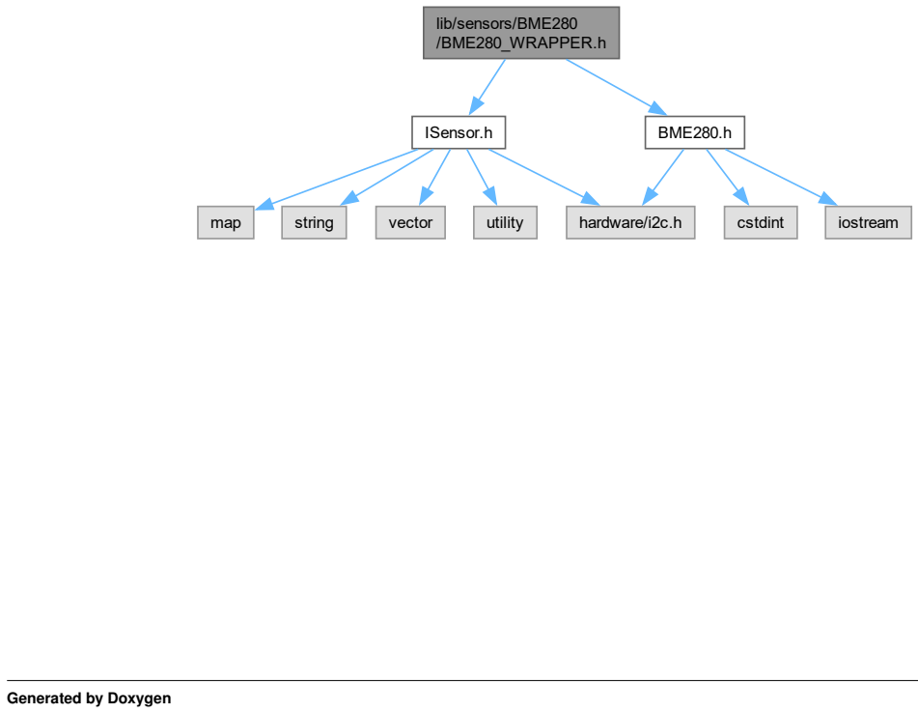
[picture p106: figure]
lib/sensors/BME280 /BME280_WRAPPER.h; ISensor.h; BME280.h; map; string; vector; utility; hardware/i2c.h; cstdint; iostream Generated by Doxygen

284 File Documentation

This graph shows which files directly or indirectly include this file:

lib/sensors/BME280
/BME280_WRAPPER.h
includes.h | lib/sensors/BME280
/BME280_WRAPPER.cpp | lib/sensors/ISensor.cpp

main.cpp

Classes

- class BME280Wrapper

## 9.73 BME280_WRAPPER.h

Go to the documentation of this file.

00001 // BME280_WRAPPER.h
00002 #ifndef BME280_WRAPPER_H 00003 #define BME280_WRAPPER_H 00004
00005 #include "ISensor.h"
00006 #include "BME280.h"
00007
00008 class BME280Wrapper : public ISensor { 00009 private:
00010 | BME280 sensor_;
00011 | bool initialized_ = false;
00012
00013 public:
00014 | BME280Wrapper(i2c_inst_t* i2c);
00015
00016 | bool init() override;
00017 | float read_data(SensorDataTypeIdentifier type) override;
00018 | bool is_initialized() const override;
00019 | SensorType get_type() const override;
00020 | bool configure(const std::map<std::string, std::string>& config) override;
00021
00022 | uint8_t get_address() const override {
00023 | return 0x76;
00024 | }
00025
00026 };
00027
00028 #endif // BME280_WRAPPER_H

## 9.74 lib/sensors/ISensor.cpp File Reference

Implementation of the ISensor interface and SensorWrapper class.

9.75 ISensor.cpp | 285

#include "ISensor.h"

#include "lib/sensors/BH1750/BH1750_WRAPPER.h" #include "lib/sensors/BME280/BME280_WRAPPER.h" #include "lib/utils.h"

Include dependency graph for ISensor.cpp:

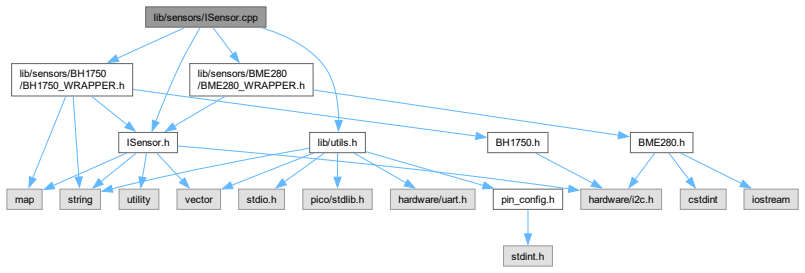
[picture p107: figure]
lib/sensors/ISensor.cpp; ISensor.h; lib/sensors/BH1750 /BH1750_WRAPPER.h; lib/sensors/BME280 /BME280_WRAPPER.h; lib/utils.h; map; string; utility; vector; hardware/i2c.h; BME280.h; stdio.h; pico/stdlib.h; hardware/uart.h; pin_config.h; cstdint; iostream; stdint.h

### 9.74.1 Detailed Description

Implementation of the ISensor interface and SensorWrapper class.

This file implements the ISensor interface and SensorWrapper class, which provide a common interface for interacting with different types of sensors.

Definition in file ISensor.cpp.

## 9.75 ISensor.cpp

Go to the documentation of this file.

00001
00014
00015 #include "ISensor.h"
00016 #include "lib/sensors/BH1750/BH1750_WRAPPER.h" 00017 #include "lib/sensors/BME280/BME280_WRAPPER.h"
00018 #include "lib/utils.h"
00019
00027 bool SensorWrapper::sensor_init(SensorType type, i2c_inst_t* i2c) {
00028 | switch (type) {
00029 | case SensorType::LIGHT:
00030 | sensors[type] = new BH1750Wrapper(i2c);
00031 | break;
00032 | case SensorType::ENVIRONMENT:
00033 | sensors[type] = new BME280Wrapper(i2c);
00034 | break;
00035 | default:
00036 | return false;
00037 | }
00038 | return sensors[type]->init();
00039 }
00040
00048 bool SensorWrapper::sensor_configure(SensorType type, const std::map<std::string, std::string>&
| config) {
00049 | if (sensors.find(type) == sensors.end()) {
00050 | return false;
00051 | }
00052 | return sensors[type]->configure(config);
00053 }
00054
00062 float SensorWrapper::sensor_read_data(SensorType sensorType, SensorDataTypeIdentifier dataType) {
00063 | if (sensors.find(sensorType) == sensors.end()) {
00064 | return -1.0f;
00065 | }
00066 | return sensors[sensorType]->read_data(dataType);
00067 }
00068
00075 ISensor* SensorWrapper::get_sensor(SensorType type) {
00076 | return sensors[type];
00077 }

286 File Documentation

## 9.76 lib/sensors/ISensor.h File Reference

Header file for the ISensor interface and SensorWrapper class.

#include <map>

#include <string>

#include <vector>

#include <utility>

#include "hardware/i2c.h"

Include dependency graph for ISensor.h:

lib/sensors/ISensor.h

map | string | vector | utility | hardware/i2c.h

This graph shows which files directly or indirectly include this file:

Classes

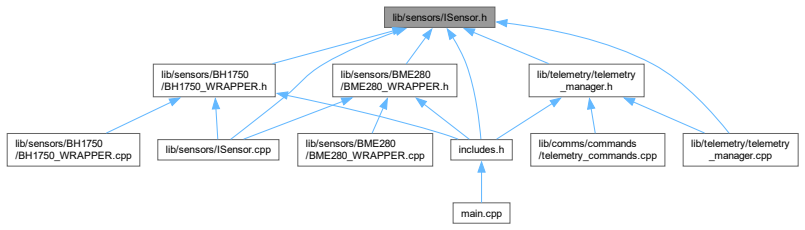
[picture p108: figure]
lib/sensors/ISensor.h; includes.h; lib/sensors/BH1750 /BH1750_WRAPPER.h; lib/sensors/ISensor.cpp; lib/sensors/BME280 /BME280_WRAPPER.h; lib/telemetry/telemetry _manager.cpp; lib/telemetry/telemetry _manager.h; main.cpp; lib/sensors/BH1750 /BH1750_WRAPPER.cpp; lib/sensors/BME280 /BME280_WRAPPER.cpp; lib/comms/commands /telemetry_commands.cpp

- class ISensor

Abstract base class for sensors.
- class SensorWrapper

Manages a collection of sensors.

Enumerations

- enum class SensorType : uint8_t { SensorType::NONE = 0x00 , SensorType::LIGHT = 0x01 , SensorType::ENVIRONMENT = 0x02 }

Enumeration of sensor types.
- enum class SensorDataTypeIdentifier : uint8_t {
SensorDataTypeIdentifier::NONE = 0x00 , SensorDataTypeIdentifier::LIGHT_LEVEL = 0x01 , SensorDataTypeIdentifier::TEMPERATURE = 0x02 , SensorDataTypeIdentifier::HUMIDITY = 0x03 ,
SensorDataTypeIdentifier::PRESSURE = 0x04 }

Enumeration of sensor data type identifiers.

9.77 ISensor.h | 287

### 9.76.1 Detailed Description

Header file for the ISensor interface and SensorWrapper class.

This file defines the ISensor interface, which provides a common interface for interacting with different types of sensors. It also defines the SensorWrapper class, which manages a collection of sensors and provides methods for initializing, configuring, and reading data from them.

Definition in file ISensor.h.

## 9.77 ISensor.h

Go to the documentation of this file.

00001
00016
00017 #ifndef ISENSOR_H
00018 #define ISENSOR_H
00019
00020 #include <map>
00021 #include <string>
00022 #include <vector>
00023 #include <utility>
00024 #include "hardware/i2c.h"
00025
00031 enum class SensorType : uint8_t {
00033 | NONE = 0x00,
00035 | LIGHT = 0x01,
00037 | ENVIRONMENT = 0x02,
00038 };
00039
00045 enum class SensorDataTypeIdentifier : uint8_t {
00047 | NONE = 0x00,
00049 | LIGHT_LEVEL = 0x01,
00051 | TEMPERATURE = 0x02,
00053 | HUMIDITY = 0x03,
00055 | PRESSURE = 0x04,
00056 };
00057
00063 class ISensor {
00064 public:
00069 | virtual ~ISensor() = default;
00070
00075 | virtual bool init() = 0;
00076
00082 | virtual float read_data(SensorDataTypeIdentifier type) = 0;
00083
00088 | virtual bool is_initialized() const = 0;
00089
00094 | virtual SensorType get_type() const = 0;
00095
00101 | virtual bool configure(const std::map<std::string, std::string>& config) = 0;
00102
00107 | virtual uint8_t get_address() const = 0;
00108 };
00109
00116 class SensorWrapper {
00117 public:
00122 | static SensorWrapper& get_instance() {
00123 | static SensorWrapper instance;
00124 | return instance;
00125 | }
00126
00133 | bool sensor_init(SensorType type, i2c_inst_t* i2c = nullptr);
00134
00141 | bool sensor_configure(SensorType type, const std::map<std::string, std::string>& config);
00142
00149 | float sensor_read_data(SensorType sensorType, SensorDataTypeIdentifier dataType);
00150
00156 | ISensor* get_sensor(SensorType type);
00157
00163 | std::vector<std::pair<SensorType, uint8_t» scan_connected_sensors(i2c_inst_t* i2c);
00164
00169 | std::vector<std::pair<SensorType, uint8_t» get_available_sensors();
00170
00171 private:
00173 | std::map<SensorType, ISensor*> sensors;

288 File Documentation

00174
00178 | SensorWrapper() = default;
00179 };
00180
00181 #endif

## 9.78 lib/storage/storage.cpp File Reference

Implements file system operations for the Kubisat firmware.

#include "storage.h"

#include "errno.h"

#include "utils.h"

#include "system_state_manager.h" Include dependency graph for storage.cpp:

lib/storage/storage.cpp

storage.h

errno.h

utils.h

system_state_manager.h

blockdevice/flash.h | blockdevice/sd.h | filesystem/littlefs.h | filesystem/vfs.h | lfs.h | filesystem/fat.h | string.h | hardware/clocks.h | hardware/flash.h | pin_config.h | stdio.h

stdint.h

pico/stdlib.h | hardware/uart.h | vector | string
mutex | pico/multicore.h | pico/sync.h

Functions

- bool fs_init (void)

Initializes the file system on the SD card.
- bool fs_stop (void)

Unmounts the file system from the SD card.

### 9.78.1 Detailed Description

Implements file system operations for the Kubisat firmware.

This file contains functions for initializing the file system, opening, writing, reading, and closing files.

Definition in file storage.cpp.

## 9.79 storage.cpp

Go to the documentation of this file.

00001
00012
00013 #include "storage.h"
00014 #include "errno.h"
00015 #include "utils.h"
00016 #include "system_state_manager.h"
00017
00025 bool fs_init(void) {
00026 | SystemStateManager::get_instance().set_sd_card_mounted(false);
00027 | uart_print("fs_init littlefs on SD card", VerbosityLevel::DEBUG);
00028 | blockdevice_t *sd = blockdevice_sd_create(SD_SPI_PORT,
00029 | SD_MOSI_PIN,

9.80 lib/storage/storage.h File Reference | 289
00030 | SD_MISO_PIN,
00031 | SD_SCK_PIN,
00032 | SD_CS_PIN,
00033 | 24 * MHZ,
00034 | false);
00035 | filesystem_t *fat = filesystem_fat_create();
00036
00037 | std::string status_string;
00038 | int err = fs_mount("/", fat, sd);
00039 | if (err == -1) {
00040 | status_string = "Formatting / with FAT";
00041 | uart_print(status_string, VerbosityLevel::WARNING);
00042 | err = fs_format(fat, sd);
00043 | if (err == -1) {
00044 | status_string = "fs_format error: " + std::string(strerror(errno));
00045 | uart_print(status_string, VerbosityLevel::ERROR);
00046 | return false;
00047 | }
00048 | err = fs_mount("/", fat, sd);
00049 | if (err == -1) {
00050 | status_string = "fs_mount error: " + std::string(strerror(errno));
00051 | uart_print(status_string, VerbosityLevel::ERROR);
00052 | return false;
00053 | }
00054 | }
00055
00056 | SystemStateManager::get_instance().set_sd_card_mounted(true);
00057 | return true;
00058 }
00059
00065 bool fs_stop(void) {
00066 | int err = fs_unmount("/");
00067 | if (err == -1) {
00068 | uart_print("fs_unmount error", VerbosityLevel::ERROR);
00069 | return false;
00070 | }
00071 | SystemStateManager::get_instance().set_sd_card_mounted(false);
00072
00073 | return true;
00074 }

## 9.80 lib/storage/storage.h File Reference

Header file for file system operations on the Kubisat firmware.

#include <stdio.h>

#include <string.h>

#include <hardware/clocks.h> #include <hardware/flash.h> #include "blockdevice/flash.h" #include "blockdevice/sd.h" #include "filesystem/littlefs.h" #include "filesystem/vfs.h" #include "pin_config.h"

#include "lfs.h"

#include "filesystem/fat.h" Include dependency graph for storage.h:

lib/storage/storage.h

stdio.h | string.h | hardware/clocks.h | hardware/flash.h | blockdevice/flash.h | blockdevice/sd.h | filesystem/littlefs.h | filesystem/vfs.h | pin_config.h | lfs.h | filesystem/fat.h

stdint.h Generated by Doxygen

290 File Documentation

This graph shows which files directly or indirectly include this file:

lib/storage/storage.h

includes.h

lib/eventman/event
_manager.h

lib/telemetry/telemetry
_manager.cpp

lib/telemetry/telemetry
_manager.h

lib/storage/storage.cpp

main.cpp

lib/clock/DS3231.cpp

lib/comms/commands
/event_commands.cpp

lib/comms/communication.h

lib/eventman/event
_manager.cpp

lib/location/gps_collector.cpp

lib/comms/commands
/clock_commands.cpp

lib/comms/commands
/commands.cpp

lib/comms/commands
/diagnostic_commands.cpp

lib/comms/commands
/gps_commands.cpp

lib/comms/commands
/telemetry_commands.cpp
lib/comms/communication.cpp | lib/comms/frame.cpp | lib/comms/receive.cpp | lib/comms/send.cpp | lib/comms/utils_converters.cpp

Functions

- bool fs_init (void)

Initializes the file system on the SD card.
- bool fs_stop (void)

Unmounts the file system from the SD card.

### 9.80.1 Detailed Description

Header file for file system operations on the Kubisat firmware.

This file defines functions for initializing, mounting, and unmounting the file system on the SD card.

Definition in file storage.h.

## 9.81 storage.h

Go to the documentation of this file.

00001
00013
00014 #ifndef STORAGE_H
00015 #define STORAGE_H
00016
00017 #include <stdio.h>
00018 #include <string.h>
00019 #include <hardware/clocks.h> 00020 #include <hardware/flash.h> 00021 #include "blockdevice/flash.h" 00022 #include "blockdevice/sd.h" 00023 #include "filesystem/littlefs.h" 00024 #include "filesystem/vfs.h" 00025 #include "pin_config.h"
00026 #include "lfs.h"
00027 #include "filesystem/fat.h" 00028
00036 bool fs_init(void);
00037
00043 bool fs_stop(void);
00044
00045 #endif

9.82 lib/system_state_manager.h File Reference | 291
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
