gredzikk/kubisat/20241212_233610.jpg

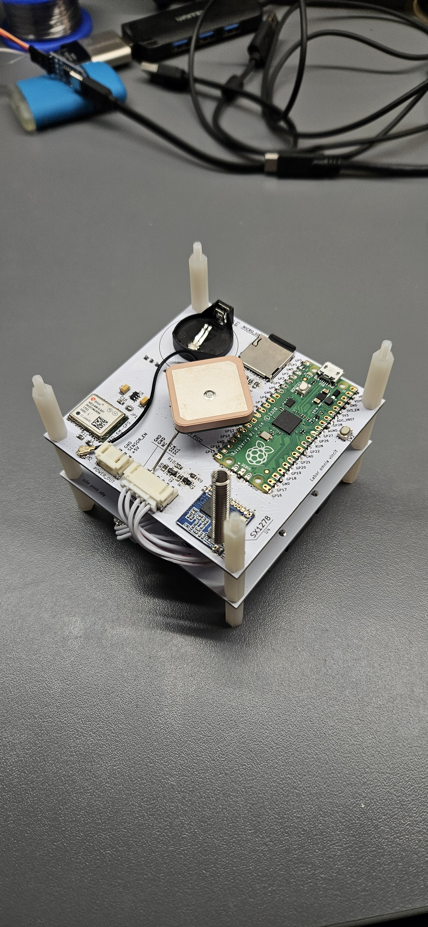
20241212_233610.jpg
