gredzikk/kubisat/20250305_213116.jpg

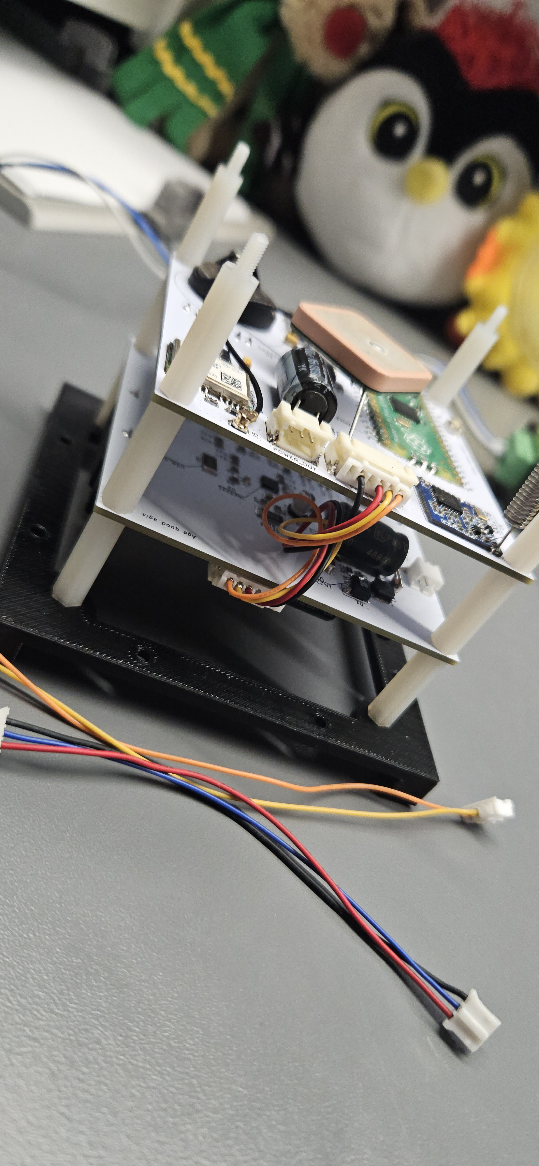
20250305_213116.jpg
