gredzikk/kubisat/20250307_170509.jpg

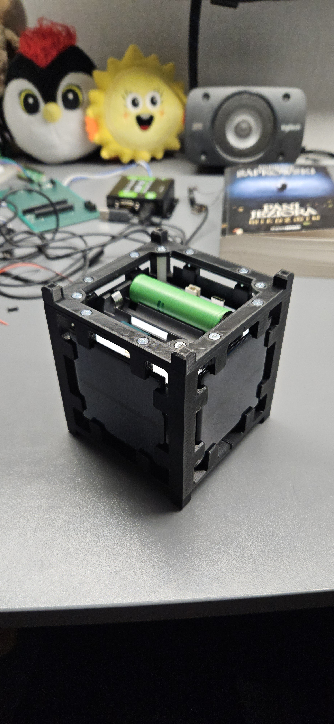
20250307_170509.jpg
