gredzikk/kubisat/case_stl/render/corner.png

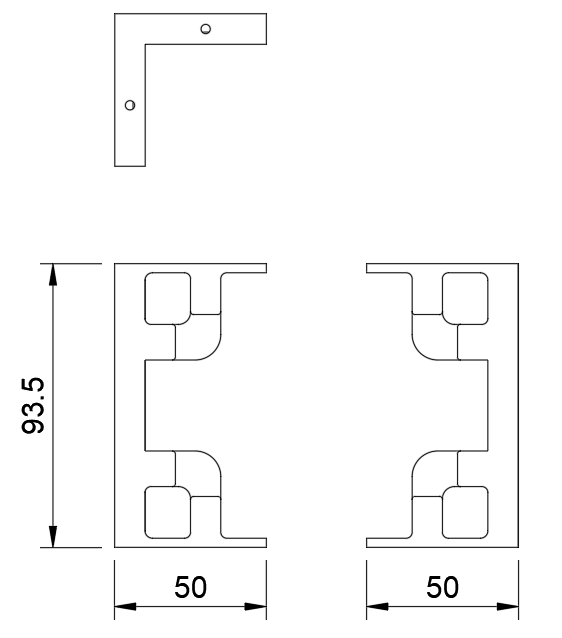
case_stl/render/corner.png
