gredzikk/kubisat/case_stl/render/render2.png

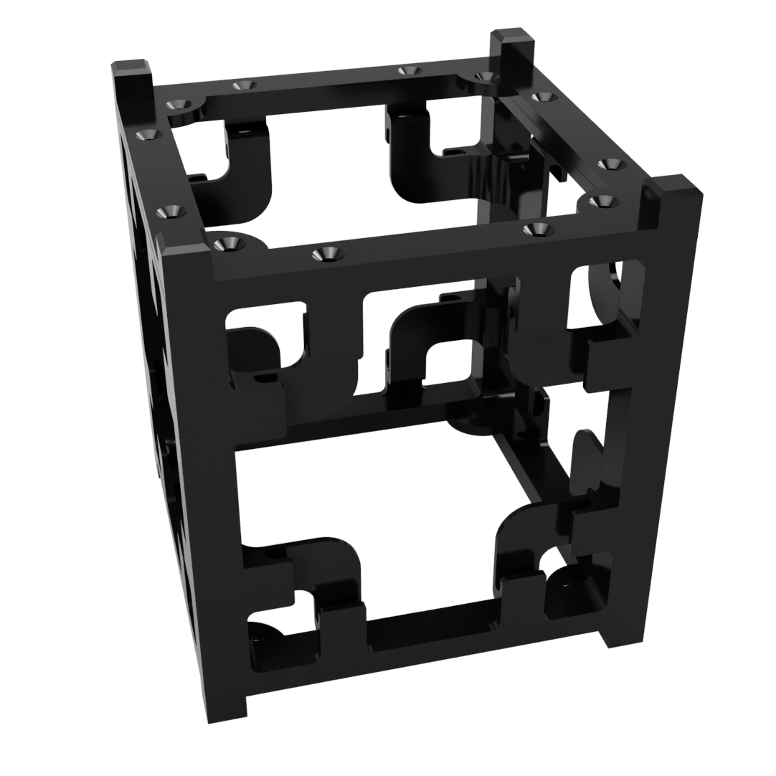
case_stl/render/render2.png
