gredzikk/kubisat/case_stl/render/render.PNG

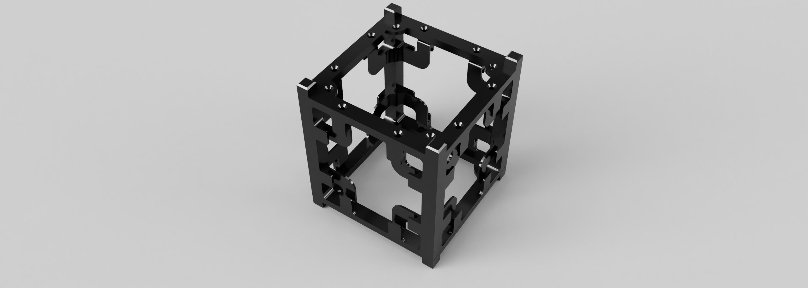
case_stl/render/render.PNG
