gredzikk/kubisat/case_stl/render/render_complete.png

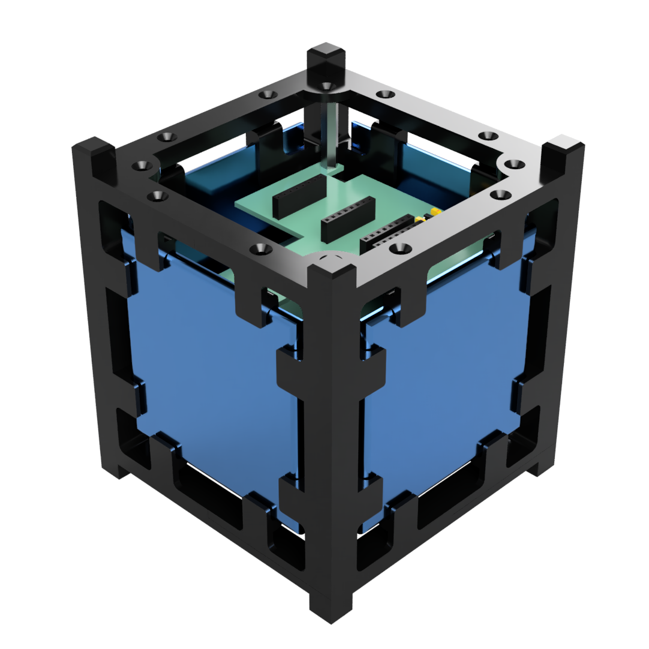
case_stl/render/render_complete.png
