gredzikk/kubisat/case_stl/render/render_corner.png

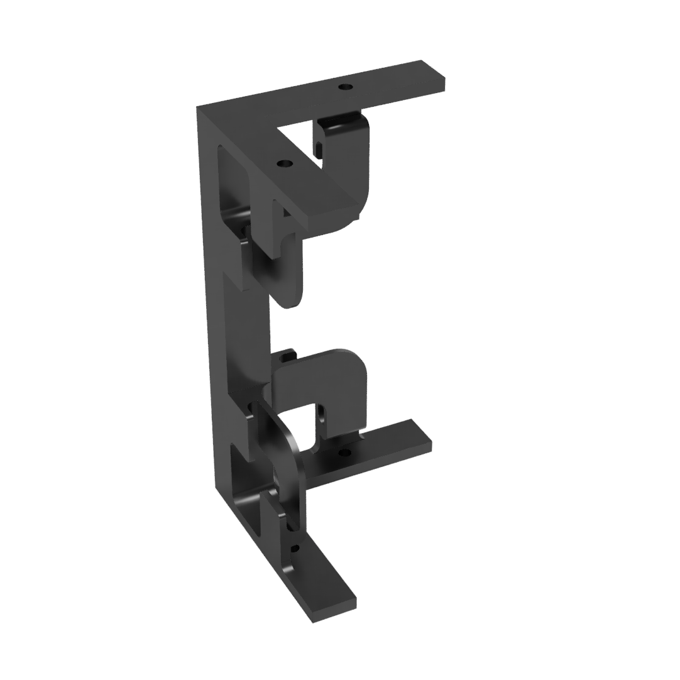
case_stl/render/render_corner.png
