gredzikk/kubisat/case_stl/render/render_full.PNG

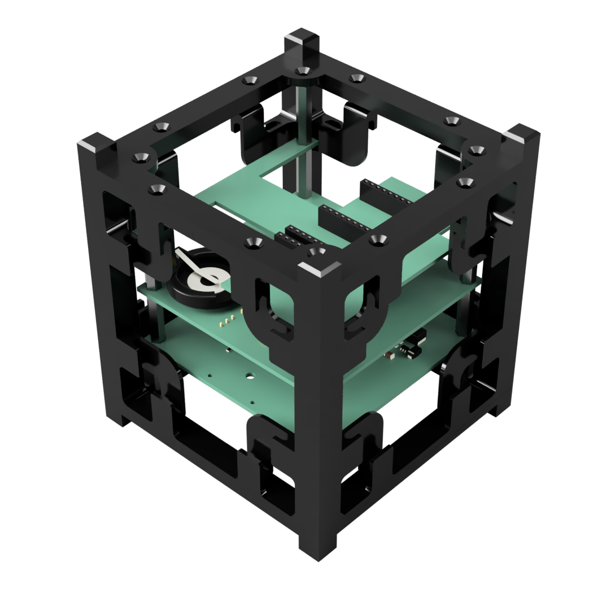
case_stl/render/render_full.PNG
