gredzikk/kubisat/case_stl/render/render_half.PNG

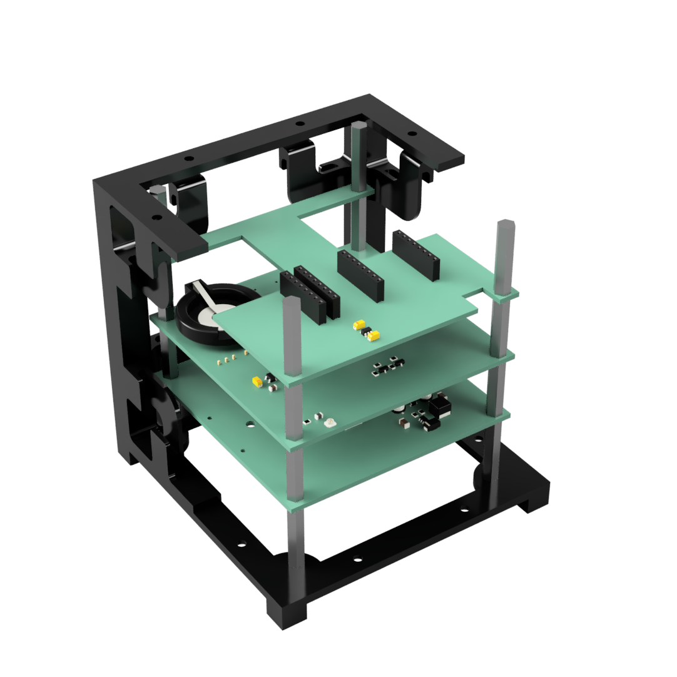
case_stl/render/render_half.PNG
