gredzikk/kubisat/case_stl/render/render_split.PNG

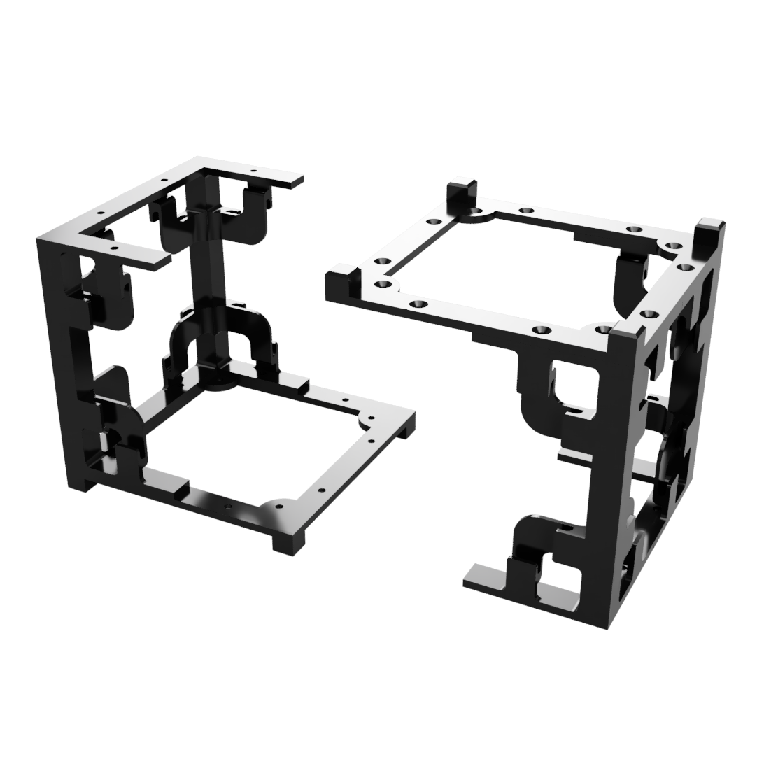
case_stl/render/render_split.PNG
