gredzikk/kubisat/case_stl/render/top.png

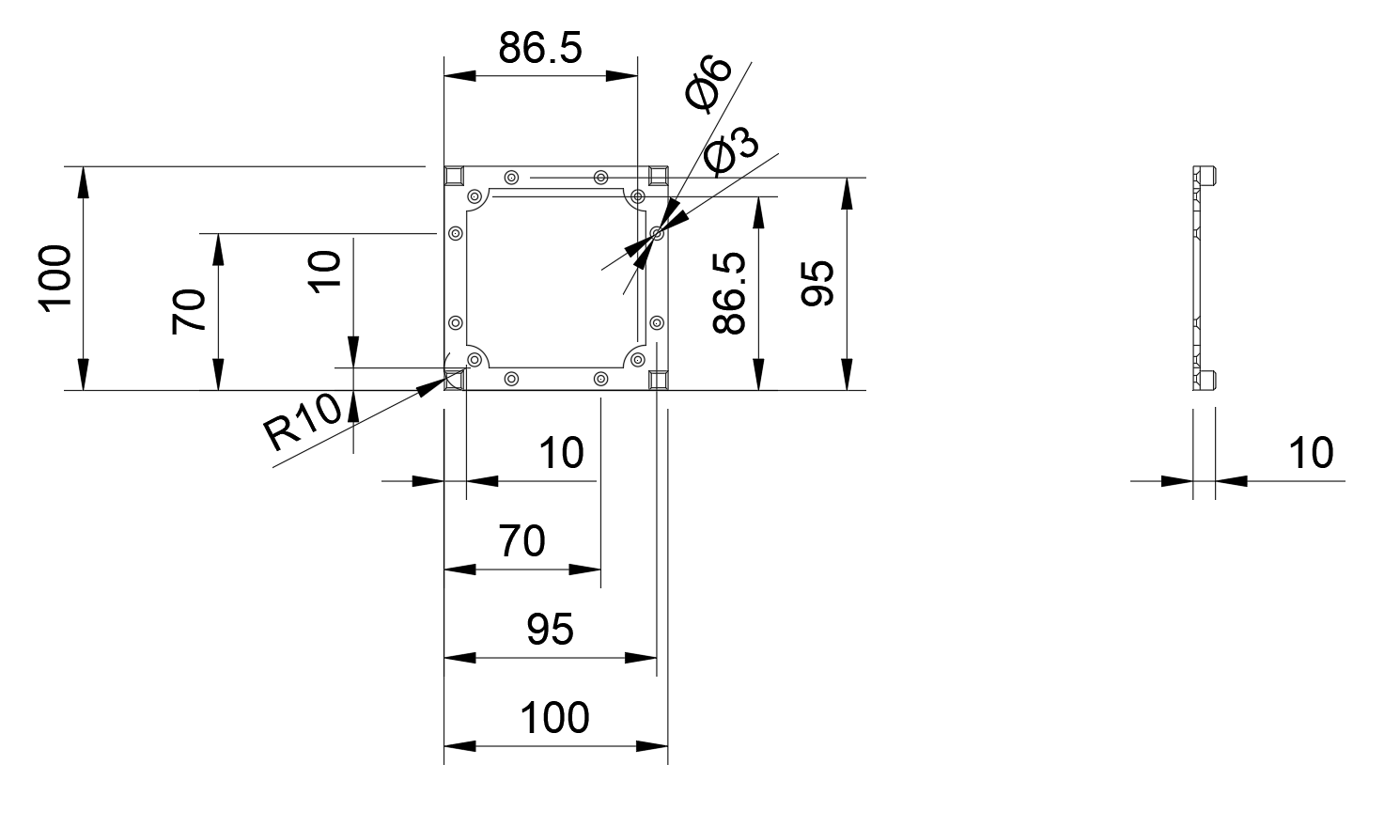
case_stl/render/top.png
