gredzikk/kubisat/doc/pobrane.png

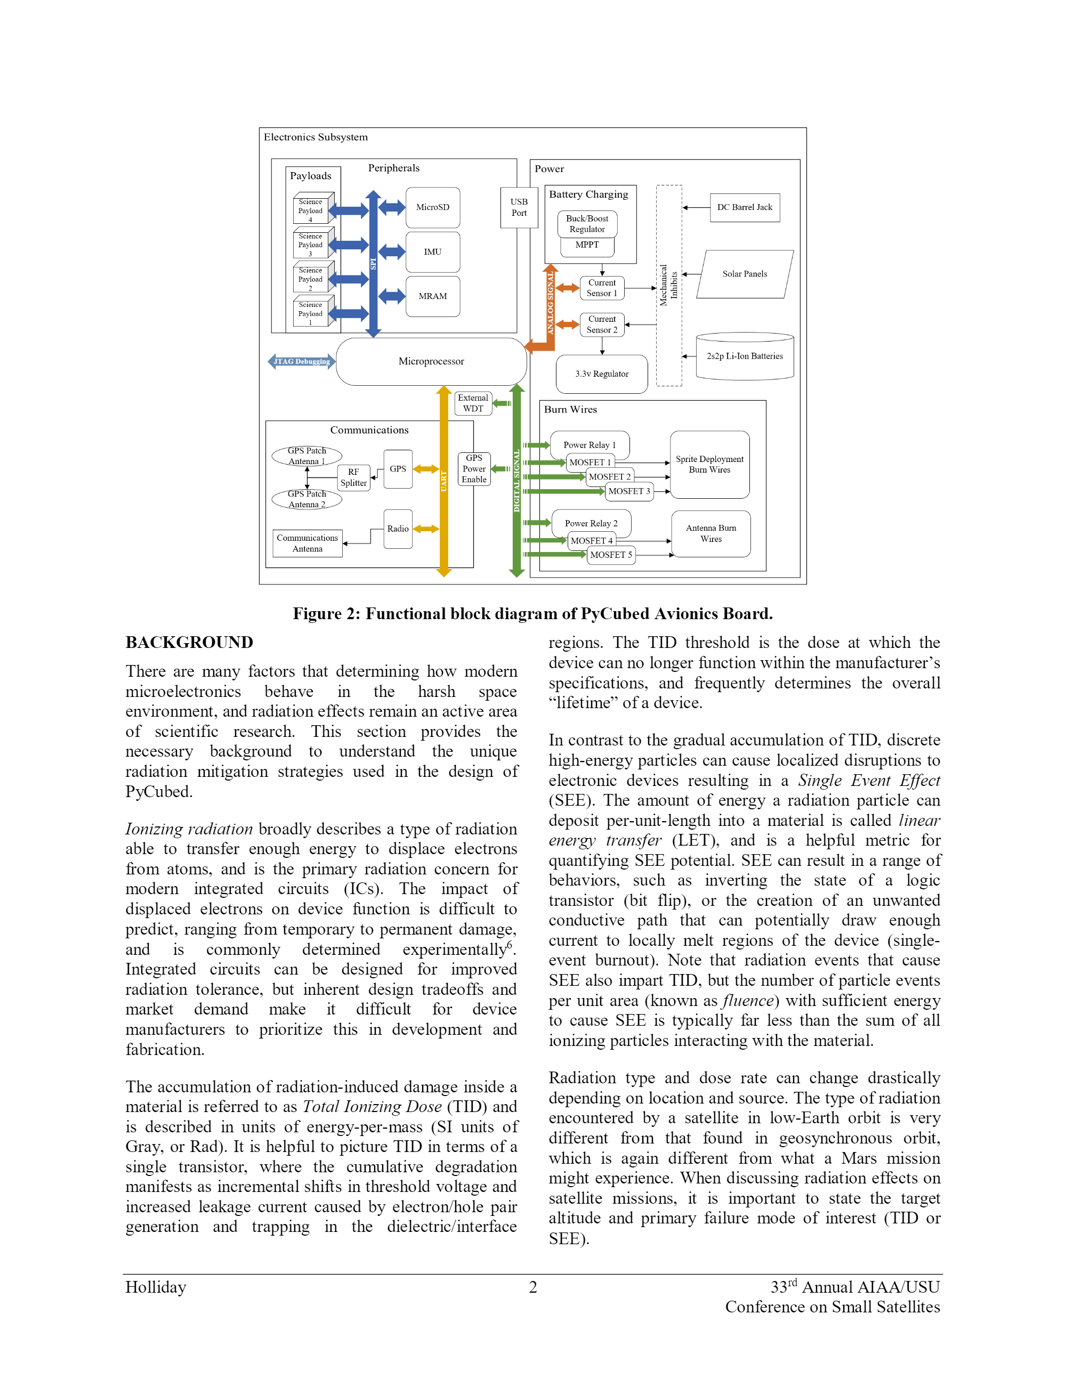
doc/pobrane.png
