gredzikk/kubisat/hardware/kubisat_power/kubisat_power_b.png

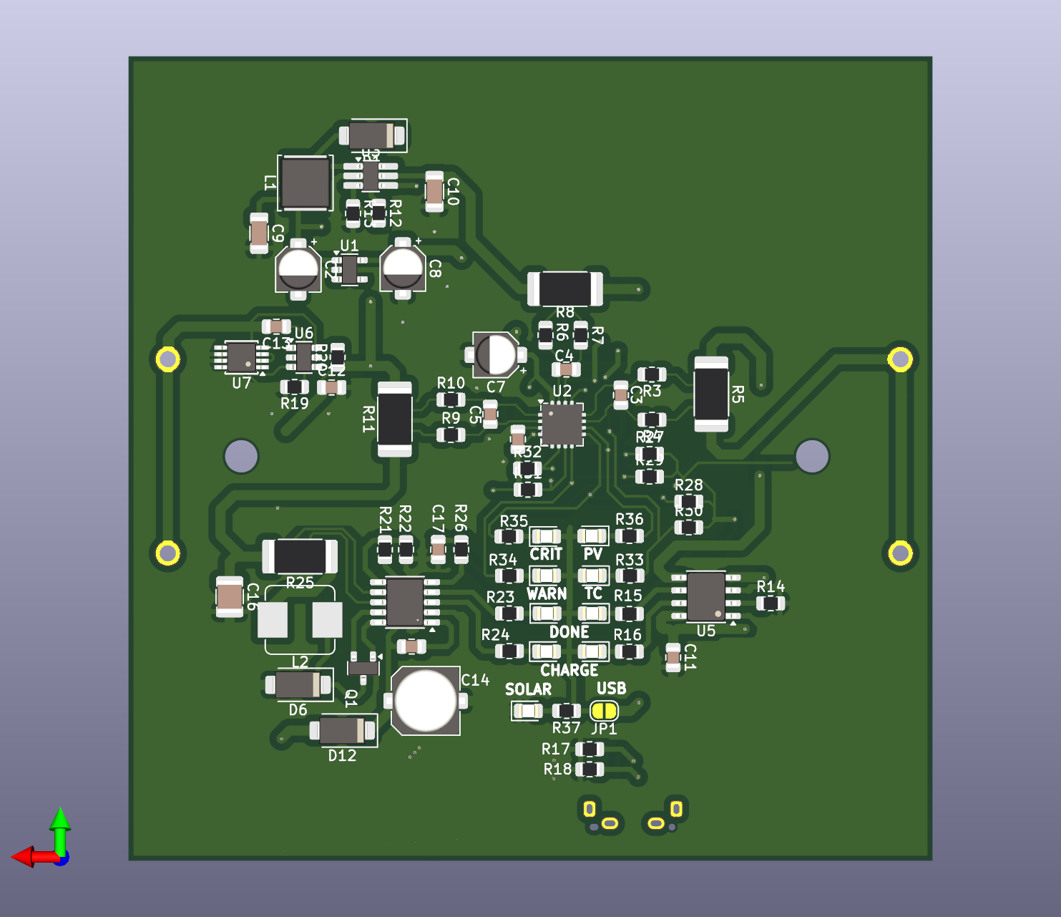
hardware/kubisat_power/kubisat_power_b.png
