gredzikk/kubisat/hardware/kubisat_power/kubisat_power_t.png

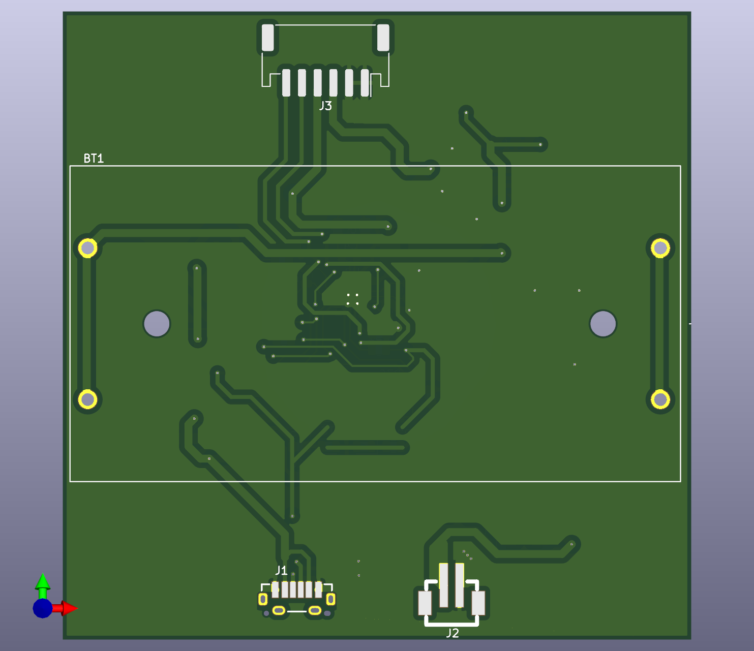
hardware/kubisat_power/kubisat_power_t.png
