gredzikk/kubisat/hardware/resource/mr2cdf43fob91.webp

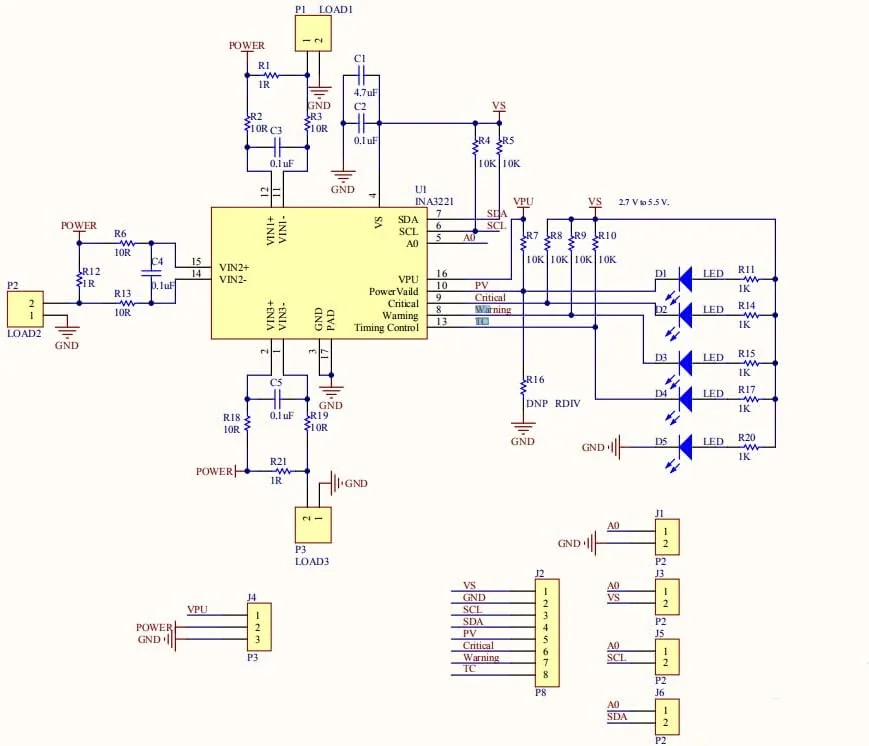
hardware/resource/mr2cdf43fob91.webp
