gredzikk/kubisat/3d/BOM.txt

mechanical BOM

side screws 2 per side x 4 sides = 8 screws 
topbot screws 8 per piece x 2 = 16
total 24 screws

1250779 BOSSARD
B3X16/BN661

or

1250760 BOSSARD
B3X12/BN661

-------------------

threaded inserts M3
24 pcs 
8mm for B3x16 screws (16 screw - 8.5 rail)
4mm for B3x12 screws (12 screw - 8.5 rail)

https://allegro.pl/oferta/insert-wkladka-gwintowana-m3-x-8mm-d4-2-10-szt-14237808799
https://allegro.pl/oferta/insert-wkladka-gwintowana-m3-x-4mm-d4-2-50-szt-13536321572
