gredzikk/kubisat/build-host-tests/Testing/Temporary/CTestCostData.txt

frame_crc_tests 3 0.000363676
ground_bridge_tests 2 0.000492048
frame_decode_vectors 1 0.000951718
---
