gredzikk/kubisat/hardware/kubisat_power/kubisat_power.csv

Reference | Value | Datasheet | Footprint | Qty | DNP
BT1 | BK-18650-PC4 |  | Library:BAT_BK-18650-PC4 | 1
C2,C8,C9,C12,C15 | 10u | ~ | -- różne wartości -- | 5
C3,C4,C5,C6,C11,C13 | 100n | ~ | Capacitor_SMD:C_0805_2012Metric | 6
C7 | 1u | ~ | Capacitor_SMD:CP_Elec_4x5.4 | 1
C10 | 22u | ~ | Capacitor_SMD:C_1206_3216Metric | 1
C14 | 47/50V | ~ | Capacitor_SMD:C_Elec_6.3x5.8 | 1
C16 | 10u/25V | ~ | Capacitor_SMD:C_1210_3225Metric | 1
C17 | 220n | ~ | Capacitor_SMD:C_0805_2012Metric | 1
D1,D12 | SS14 | -- różne wartości -- | Diode_SMD:D_SMA | 2
D2 | U_CHG | ~ | LED_SMD:LED_0805_2012Metric | 1
D3 | U_DONE | ~ | LED_SMD:LED_0805_2012Metric | 1
D4 | S_DONE | ~ | LED_SMD:LED_0805_2012Metric | 1
D5 | S_CHG | ~ | LED_SMD:LED_0805_2012Metric | 1
D6 | SS54 | ~ | Diode_SMD:D_SMA | 1
D7 | TC | ~ | LED_SMD:LED_0805_2012Metric | 1
D8 | WARN | ~ | LED_SMD:LED_0805_2012Metric | 1
D9 | CRIT | ~ | LED_SMD:LED_0805_2012Metric | 1
D10 | PV | ~ | LED_SMD:LED_0805_2012Metric | 1
D11 | 5V_OK | ~ | LED_SMD:LED_0805_2012Metric | 1
J1 | USB_C_Receptacle_PowerOnly_6P | https://www.usb.org/sites/default/files/documents/usb_type-c.zip | Connector_USB:GCT_USB4140-GF-0230-C_REV0.4 | 1
J2 | B2B-PH-SM4-TB_LF__SN_ |  | kubisat:B2B-PH-SM4-TB_LF__SN_ | 1
J3 | Conn_01x06_MountingPin | ~ | Connector_JST:JST_PH_S6B-PH-SM4-TB_1x06-1MP_P2.00mm_Horizontal | 1
L1 | 3.3.uH | ~ | Inductor_SMD:L_Cenker_CKCS5040 | 1
L2,R20 | 100 | ~ | -- różne wartości -- | 2
Q1 | Si2305 | http://www.vishay.com/docs/66709/si2319cd.pdf | Package_TO_SOT_SMD:SOT-23 | 1
R3,R4,R6,R7,R9,R10 | 10R | ~ | Resistor_SMD:R_0805_2012Metric | 6
R5,R8,R11 | 0R01 | ~ | Resistor_SMD:R_2512_6332Metric_Pad1.40x3.35mm_HandSolder | 3
R12,R27,R28,R29,R30,R31,R32 | 10k | ~ | Resistor_SMD:R_0805_2012Metric | 7
R13 | 13k3 | ~ | Resistor_SMD:R_0805_2012Metric | 1
R14 | 1k5 | ~ | Resistor_SMD:R_0805_2012Metric | 1
R15,R16,R19,R23,R24,R33,R34,R35,R36,R37 | 1k | ~ | Resistor_SMD:R_0805_2012Metric | 10
R17,R18 | 5k1 | ~ | Resistor_SMD:R_0805_2012Metric | 2
R21 | 27k | ~ | Resistor_SMD:R_0805_2012Metric | 1
R22 | 6k8 | ~ | Resistor_SMD:R_0805_2012Metric | 1
R25 | R050 | ~ | Resistor_SMD:R_2512_6332Metric_Pad1.40x3.35mm_HandSolder | 1
R26 | 120 | ~ | Resistor_SMD:R_0805_2012Metric | 1
U1 | ~ |  | Package_TO_SOT_SMD:SOT-23-5 | 1
U2 | INA3221 | http://www.ti.com/lit/ds/symlink/ina3221.pdf | Package_DFN_QFN:Texas_RGV0016A_VQFN-16-1EP_4x4mm_P0.65mm_EP2.1x2.1mm | 1
U3 | LN2220 | https://www.gdzhianxin.com/uploadfile/file/20210812/1628760551208876.pdf | Package_TO_SOT_SMD:TSOT-23-6_HandSoldering | 1
U4 | CN3791 | https://www.laskakit.cz/user/related_files/dse-cn3791-2.pdf | Package_SO:SSOP-10-1EP_3.9x4.9mm_P1mm_EP2.1x3.3mm | 1
U5 | TP4056 |  | Package_SO:SOIC-8-1EP_3.9x4.9mm_P1.27mm_EP2.29x3mm | 1
U6 | DW01A | https://hmsemi.com/downfile/DW01A.PDF | Package_TO_SOT_SMD:SOT-23-6 | 1
U7 | FS8205 | https://datasheet.lcsc.com/szlcsc/Fortune-Semicon-FS8205_C32254.pdf | Package_SO:TSSOP-8_3x3mm_P0.65mm | 1
