gredzikk/kubisat/hardware/kubisat_main/prod/kubisat_main.csv

Id | Oznaczenie | Footprint | Liczba | Oznaczenie | Dostawca i numer artykułu
1 | U4 | XL1278-SMT | 1 | XL1278-SMT
2 | C1,C2 | CP_EIA-3216-18_Kemet-A | 2 | 10u
3 | U1 | SOIC-16W_7.5x10.3mm_P1.27mm | 1 | DS3231M
4 | R4,R2,R1,R3,R5,R6 | R_0805_2012Metric | 6 | 4k7
5 | C16 | C_0805_2012Metric | 1 | 100n
6 | R10,R7,R9,R8 | R_0805_2012Metric | 4 | 10k
7 | J4 | JST_PH_S6B-PH-SM4-TB_1x06-1MP_P2.00mm_Horizontal | 1 | POWER_IN
8 | L1 | L_0805_2012Metric | 1 | 27uH
9 | BT1 | BatteryHolder_Keystone_106_1x20mm | 1 | LIR2023
10 | U6 | RPi_Pico_SMD_TH | 1 | Pico
11 | SW2 | SW_Push_1P1T_NO_CK_KMR2 | 1 | RESET
12 | J5 | U.FL_Hirose_U.FL-R-SMT-1_Vertical | 1 | IPX
13 | U5 | SOT-23-5 | 1 | ~
14 | U3 | ublox_NEO | 1 | NEO-6M-GPS
15 | J6 | JST_PH_S3B-PH-SM4-TB_1x03-1MP_P2.00mm_Horizontal | 1 | POWER
16 | J2 | J_SD_Card-micro_socket_A | 1 | Micro_SD_Card_Det1
17 | Q2,Q1 | SOT-23 | 2 | BSS138
18 | R11 | R_0805_2012Metric | 1 | 22
19 | J3 | PinHeader_1x03_P2.54mm_Horizontal | 1 | UART0
20 | J1 | PinHeader_1x03_P2.54mm_Horizontal | 1 | DEBUG_SWD
21 | J8 | JST_PH_S4B-PH-SM4-TB_1x04-1MP_P2.00mm_Horizontal | 1 | SPI0
22 | J7 | JST_PH_S2B-PH-SM4-TB_1x02-1MP_P2.00mm_Horizontal | 1 | I2C1
