gredzikk/kubisat/hardware/BOM.txt

solar x4 https://botland.com.pl/panele-sloneczne-malej-mocy/3689-ogniwo-sloneczne-04w55v-65x65x3mm-5904422356620.html
