gredzikk/kubisat/hardware/kubisat_main/kubisat_main.step

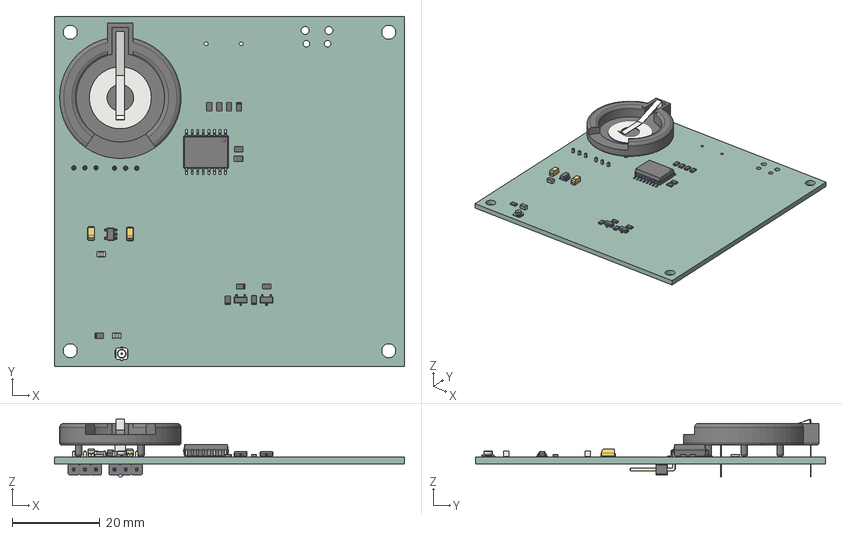
[picture p125: CAD file, 2025-03-18]
hardware/kubisat_main/kubisat_main.step
80.0 x 80.0 x 13.2 mm
CP_EIA_3216_18_Kemet_A x 2
SOIC_16W_75x103mm_P127mm
R_0805_2012Metric x 11
C_0805_2012Metric
L_0805_2012Metric
Keystone_106
U.FL_Hirose_U.FL-R-SMT-1_Vertical
SOT_23_5
SOT_23 x 2
PinHeader_1x03_P254mm_Horizontal x 2
kubisat_main_PCB
