gredzikk/kubisat/3d/side v4.stl

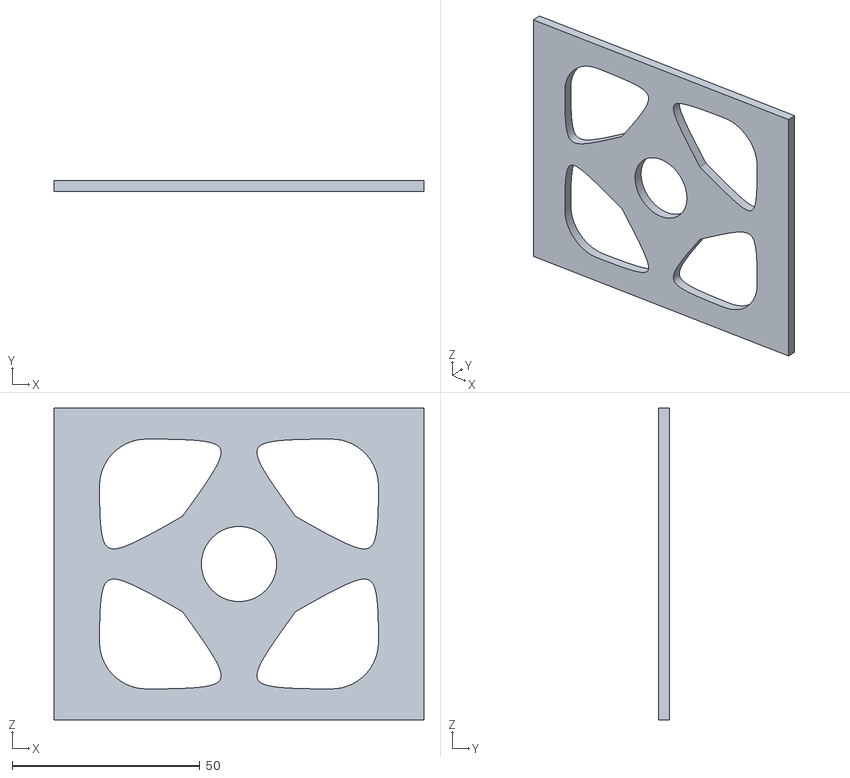
[picture p126: CAD file, 2024-08-20]
3d/side v4.stl
98.5 x 3.00 x 83.0
