gredzikk/kubisat/3d/v2/corner v1.stl

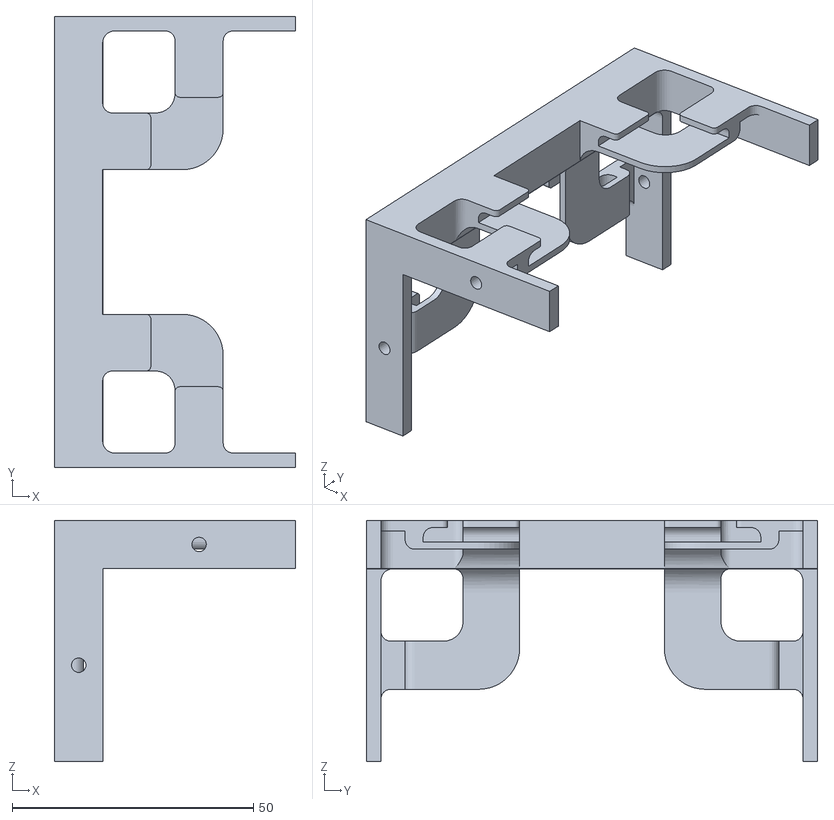
[picture p127: CAD file, 2025-02-26]
3d/v2/corner v1.stl
50.0 x 93.5 x 50.0
