gredzikk/kubisat/hardware/kubisat_power/kubisat_power_v2.step

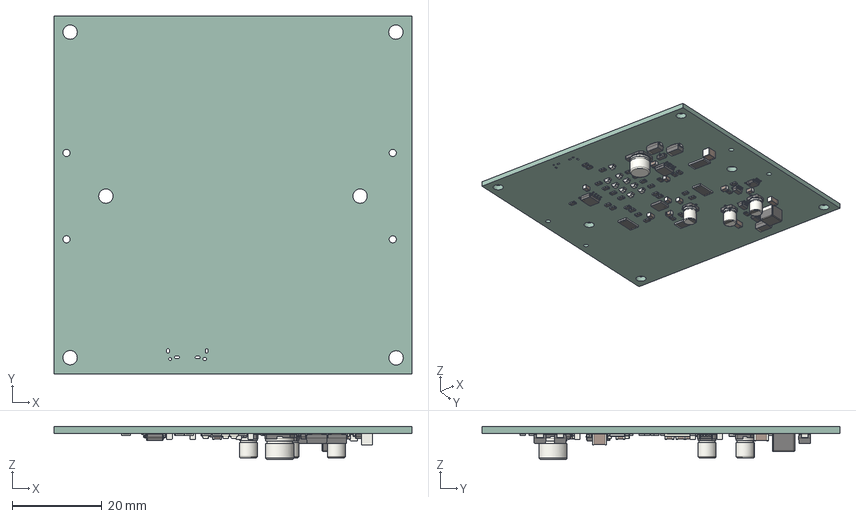
[picture p128: CAD file, 2025-03-18]
hardware/kubisat_power/kubisat_power_v2.step
80.0 x 80.0 x 7.45 mm
L_Cenker_CKCS5040
CP_Elec_4x54 x 3
SOT_23_5
TSOT_23_6
SOT_23
C_0805_2012Metric x 9
R_0805_2012Metric x 31
LED_0805_2012Metric x 9
D_SMA x 3
SOIC-8-1EP_3.9x4.9mm_P1.27mm_EP2.29x3mm
R_2512_6332Metric x 4
Texas_RSA_VQFN-16-1EP_4x4mm_P0.65mm_EP2.7x2.7mm
SSOP-10-1EP_3.9x4.9mm_P1.0mm_EP2.1x3.3mm
TSSOP_8_3x3mm_P065mm
SOT_23_6
C_Elec_63x58
C_1210_3225Metric
C_1206_3216Metric x 2
kubisat_power_v2_PCB
