gredzikk/kubisat/hardware/kubisat_sensor/kubisat_sensors/kubisat_sensors.step

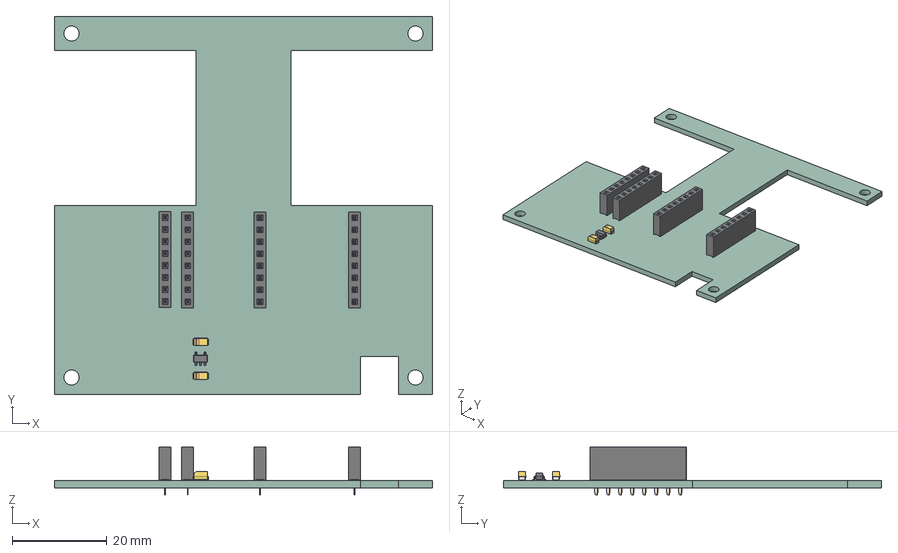
[picture p129: CAD file, 2025-03-18]
hardware/kubisat_sensor/kubisat_sensors/kubisat_sensors.step
80.0 x 80.0 x 10.1 mm
PinSocket_1x08_P254mm_Vertical x 4
SOT_23_5
CP_EIA_3216_18_Kemet_A x 2
_autosave-kubisat_sensors_PCB
