gredzikk/kubisat/3d/rail v6.stl

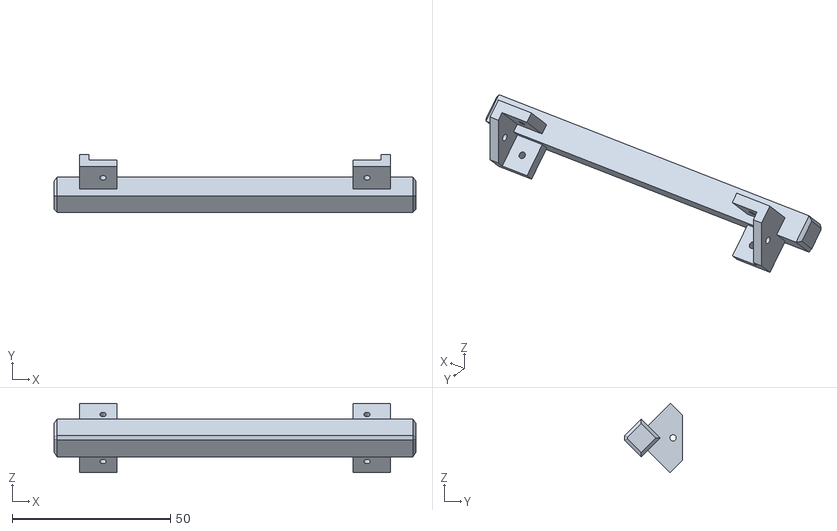
[picture p130: CAD file, 2024-08-20]
3d/rail v6.stl
114.5 x 18.4 x 21.9
