gredzikk/kubisat/3d/topbot v2.stl

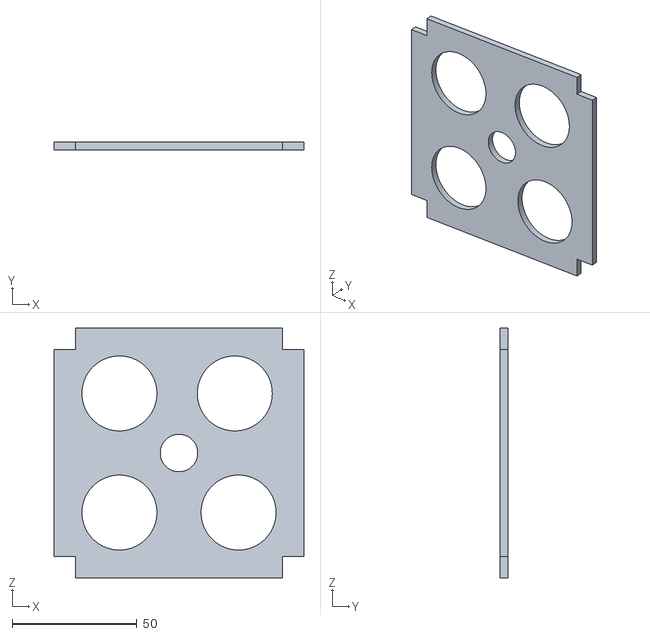
[picture p132: CAD file, 2024-08-20]
3d/topbot v2.stl
100.0 x 3.00 x 100.0
