gredzikk/kubisat/3d/v2/side2.stl

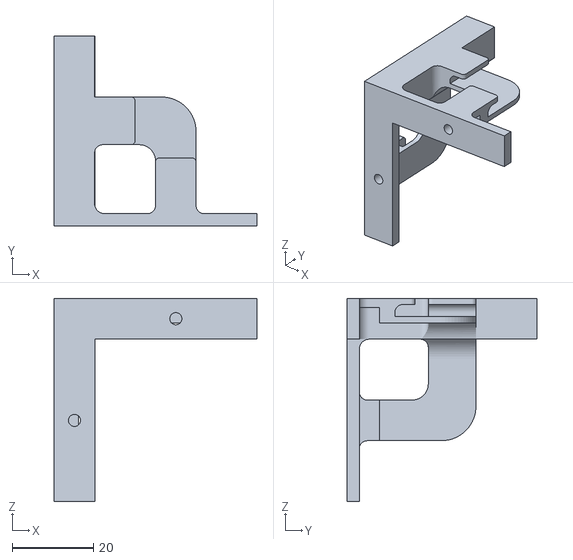
[picture p133: CAD file, 2025-02-25]
3d/v2/side2.stl
50.0 x 46.8 x 50.0
