gredzikk/kubisat/3d/v2/kubisat_topbot v13.stl

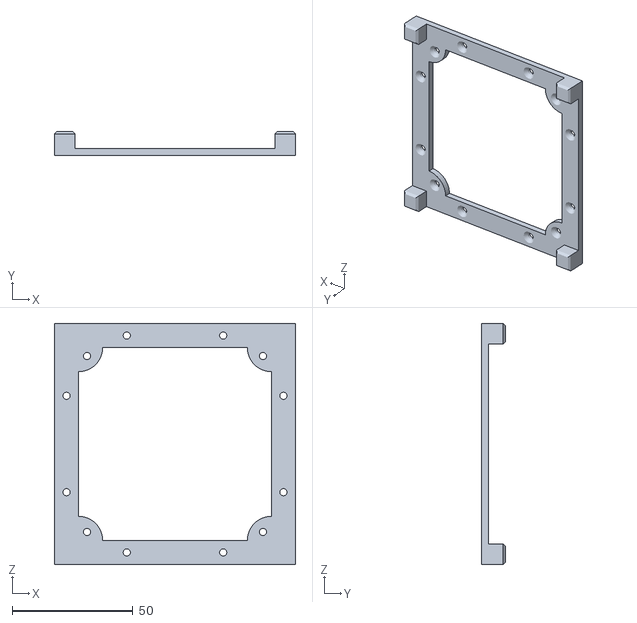
[picture p134: CAD file, 2025-01-21]
3d/v2/kubisat_topbot v13.stl
100.0 x 10.0 x 100.0
