gredzikk/kubisat/3d/v2/side_double.stl

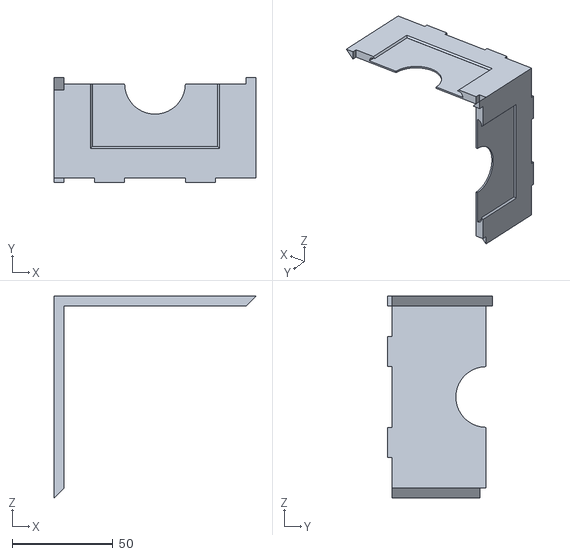
[picture p135: CAD file, 2024-11-24]
3d/v2/side_double.stl
100.0 x 51.8 x 100.0
