gredzikk/kubisat/3d/v2/side_spacer.stl

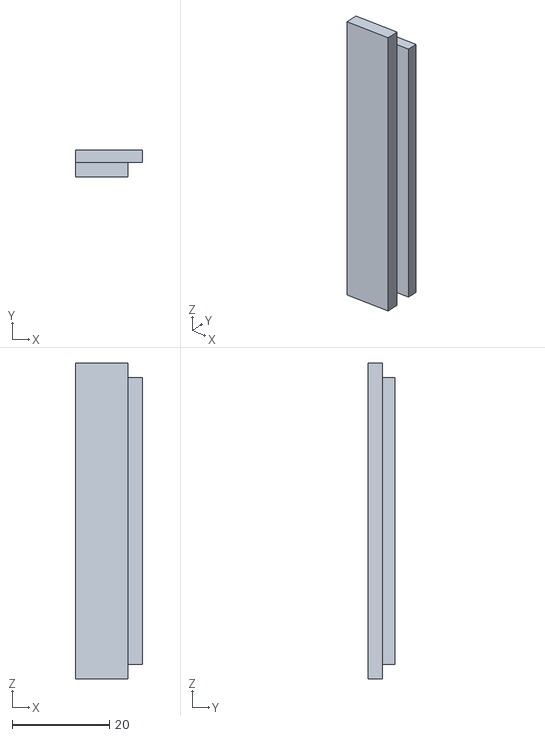
[picture p136: CAD file, 2024-08-24]
3d/v2/side_spacer.stl
13.8 x 5.50 x 65.0
