gredzikk/kubisat/3d/v2/side_simple.stl

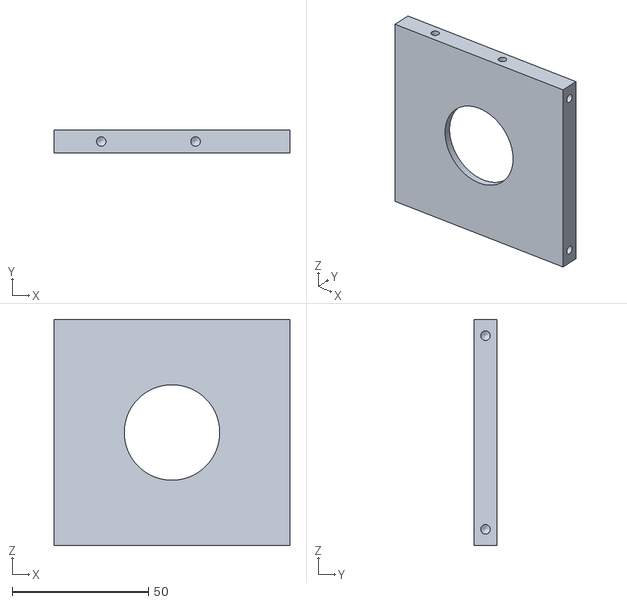
[picture p137: CAD file, 2024-08-24]
3d/v2/side_simple.stl
86.5 x 8.50 x 83.0
