gredzikk/kubisat/3d/v2/rail.stl

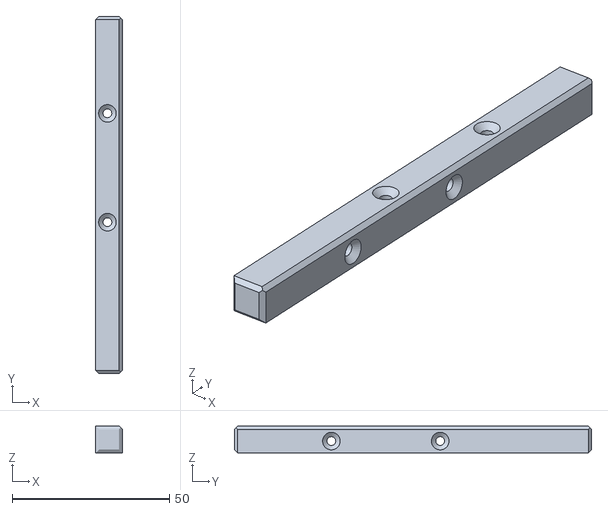
[picture p138: CAD file, 2024-08-22]
3d/v2/rail.stl
8.50 x 113.5 x 8.50
