gredzikk/kubisat/3d/v2/kubisat.stl

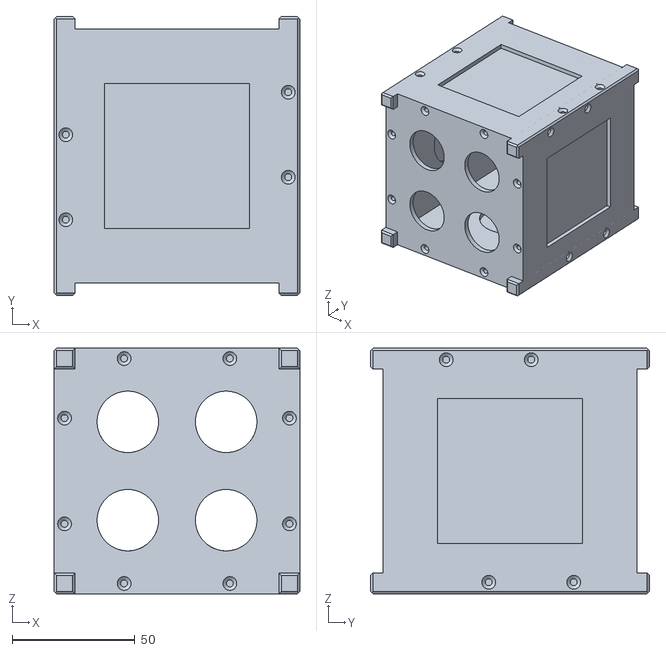
[picture p139: CAD file, 2024-08-22]
3d/v2/kubisat.stl
100.0 x 113.5 x 100.0
