gredzikk/kubisat/3d/v2/topbot.stl

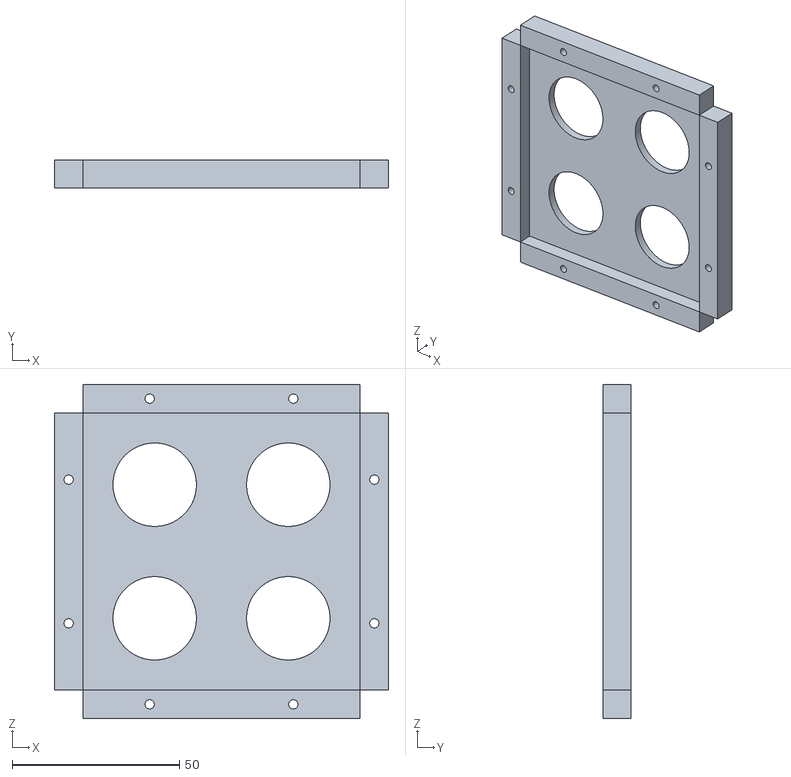
[picture p140: CAD file, 2024-08-22]
3d/v2/topbot.stl
100.0 x 8.50 x 100.0
