gredzikk/kubisat/(list of files, cad)

Other CAD files:
3d/v2/side_final.stl
3d/v2/side.stl
3d/v2/kubisat.f3z
3d/v2/kubisat_topbot v10.f3d
3d/v2/kubisat_topbot v10.stl
3d/v2/kubisat_topbot v11.stl
3d/v2/kubisat_topbot v2.stl
3d/v2/kubisat_topbot v6.stl
3d/v2/kubisat_topbot v7.stl
3d/v2/rail.f3d
3d/v2/side v4.stl
3d/v2/side v5.stl
3d/v2/side v6.f3d
3d/v2/side v9.stl
3d/v2/side.f3z
3d/v2/side_simple.f3d
3d/v2/side_spacer.f3d
3d/v2/topbot.f3d
