gredzikk/kubisat/software/ground_firmware/release/last_tested/README.txt

Last tested ground station firmware snapshot
Saved: 2026-10-19T22:05:39+02:00
Source: software/ground_firmware/release/main.uf2
Also copied build-gs/main.uf2 as main_from_build.uf2
total 364
drwxrwxr-x 2 gredzikk gredzikk   4096 paź 19 22:05 .
drwxrwxr-x 4 gredzikk gredzikk   4096 paź 19 22:05 ..
-rw-rw-r-- 1 gredzikk gredzikk 180224 paź 19 22:05 main_from_build.uf2
-rw-rw-r-- 1 gredzikk gredzikk 180224 paź 19 22:05 main.uf2
-rw-rw-r-- 1 gredzikk gredzikk    181 paź 19 22:05 README.txt
