gredzikk/kubisat/software/kubisat_firmware/telemetry_test/current_data_20250325_113844.png

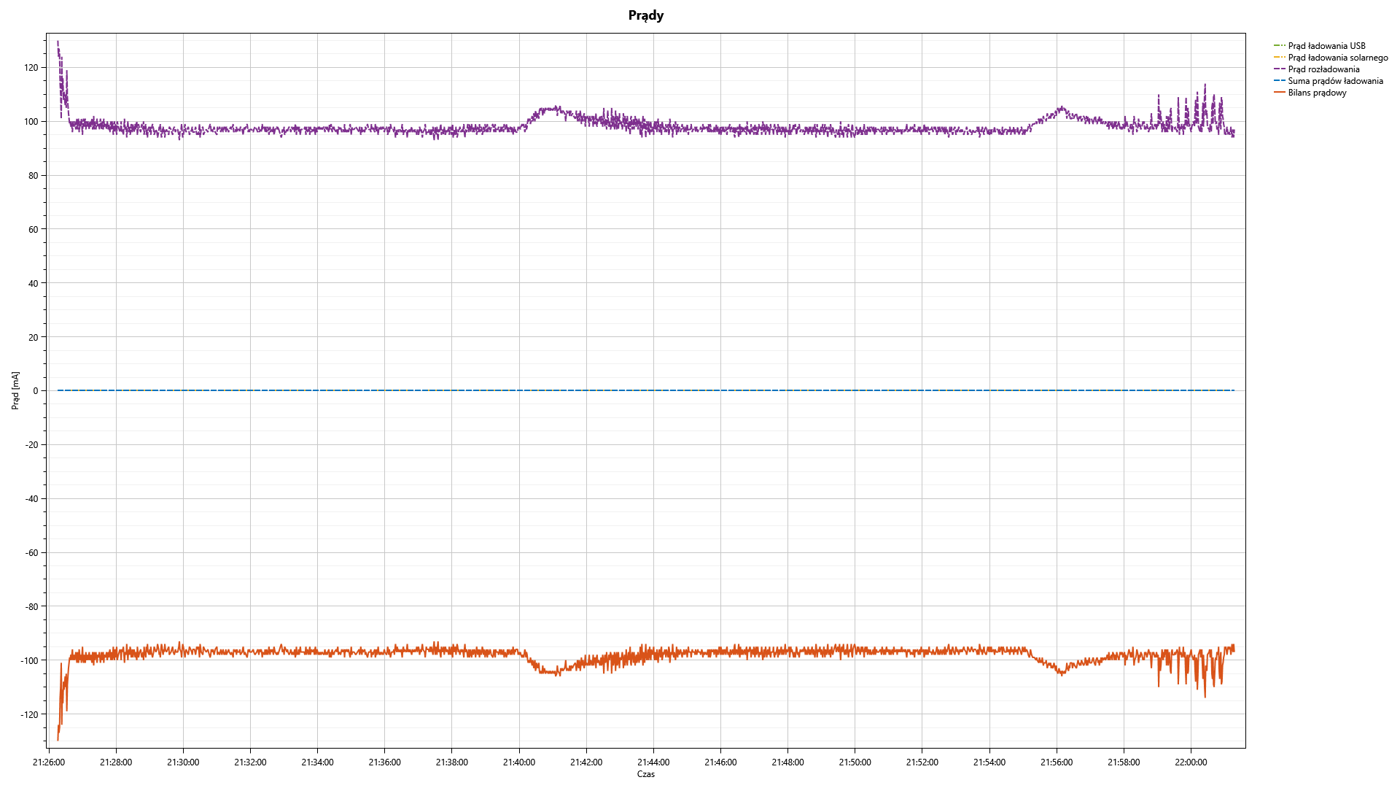
software/kubisat_firmware/telemetry_test/current_data_20250325_113844.png
