gredzikk/kubisat/software/kubisat_firmware/telemetry_test/environmental_data_20250325_114140.png

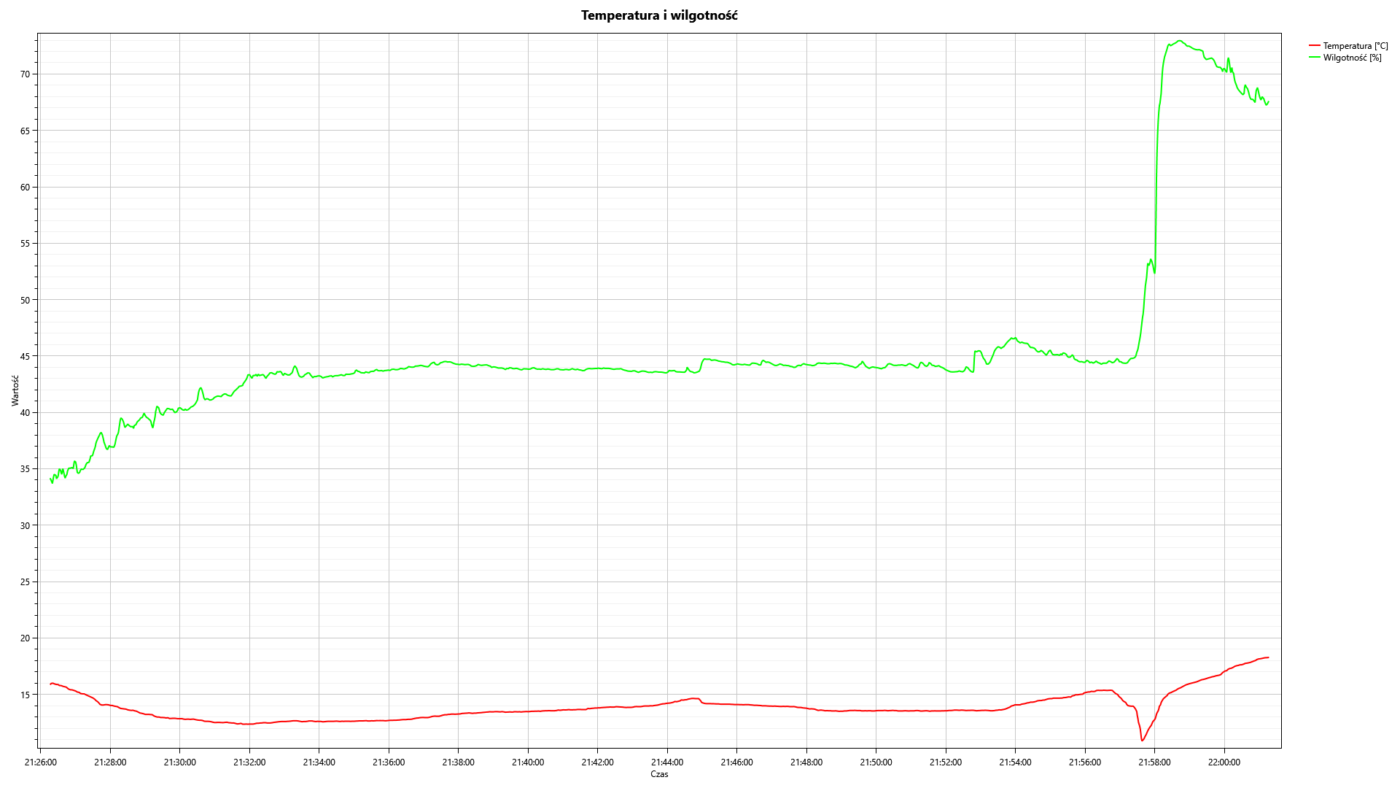
software/kubisat_firmware/telemetry_test/environmental_data_20250325_114140.png
