gredzikk/kubisat/software/kubisat_firmware/telemetry_test/light_data_20250325_113942.png

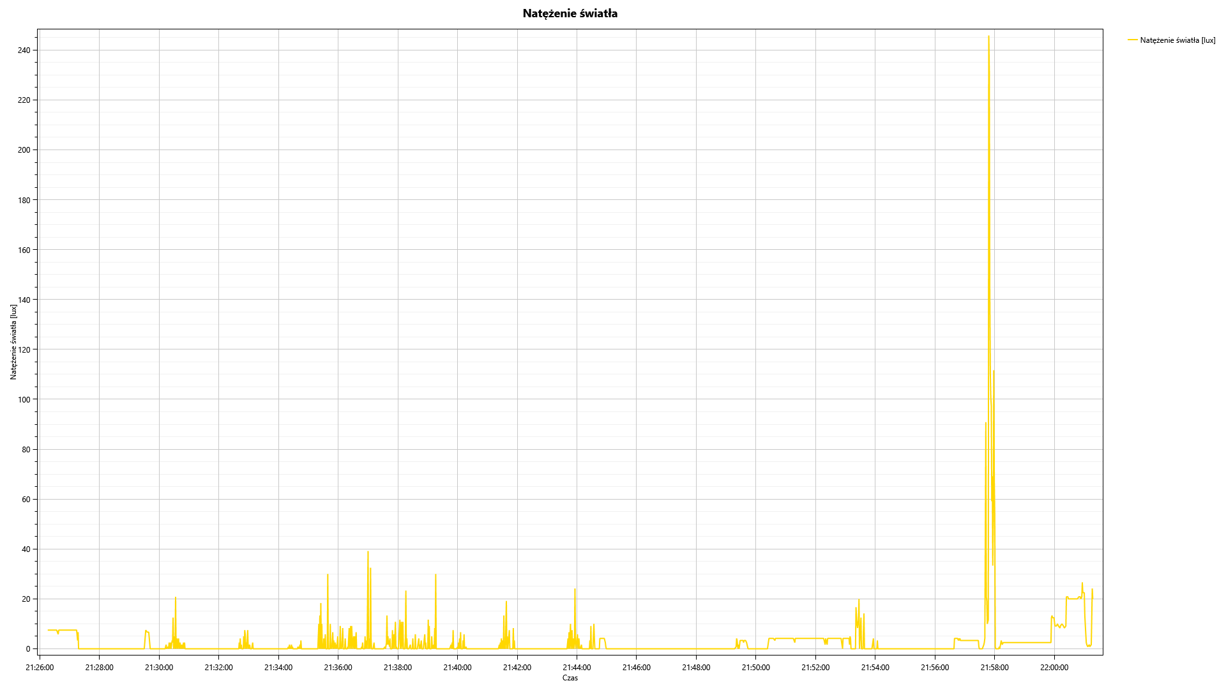
software/kubisat_firmware/telemetry_test/light_data_20250325_113942.png
