gredzikk/kubisat/software/kubisat_firmware/telemetry_test/pressure_data_20250325_113937.png

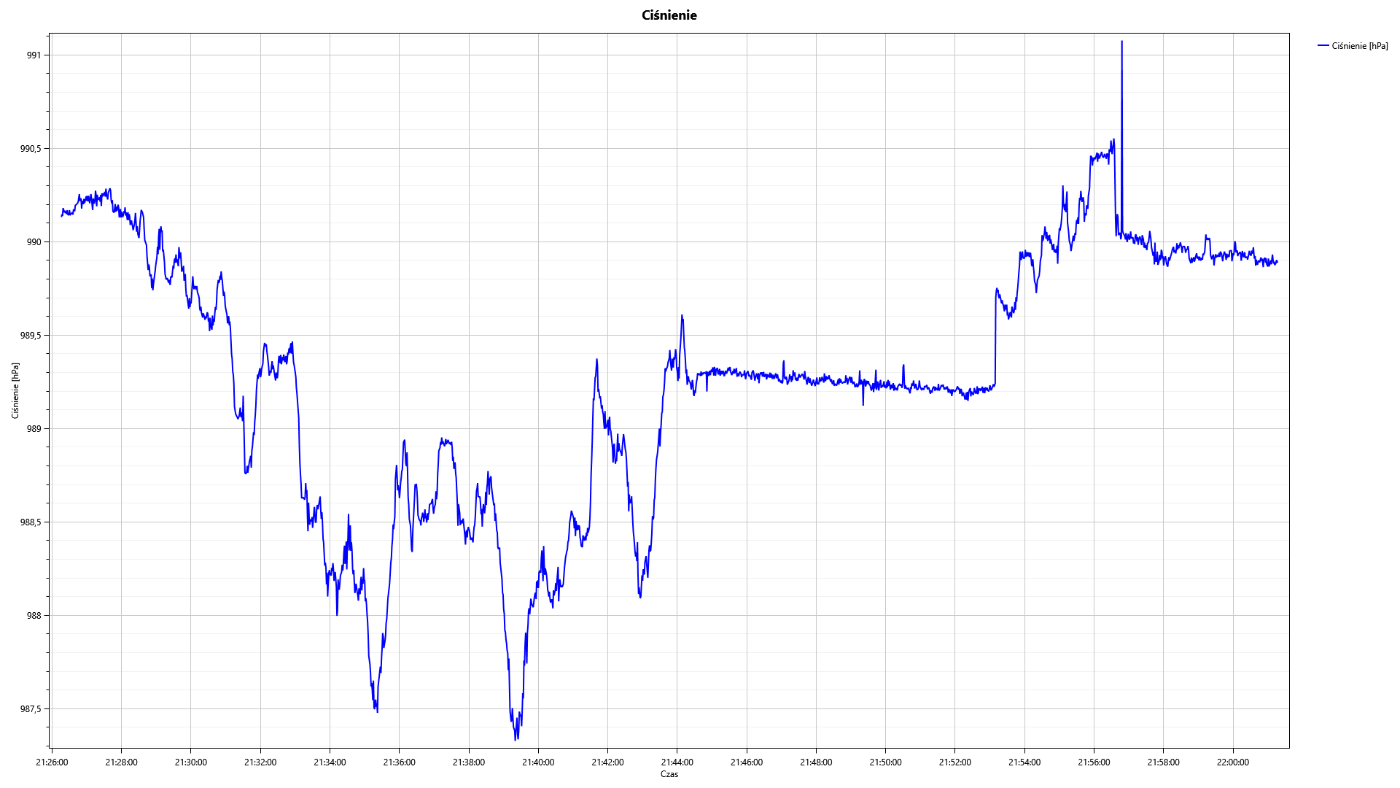
software/kubisat_firmware/telemetry_test/pressure_data_20250325_113937.png
