gredzikk/kubisat/software/kubisat_firmware/telemetry_test/voltage_data_20250325_113904.png

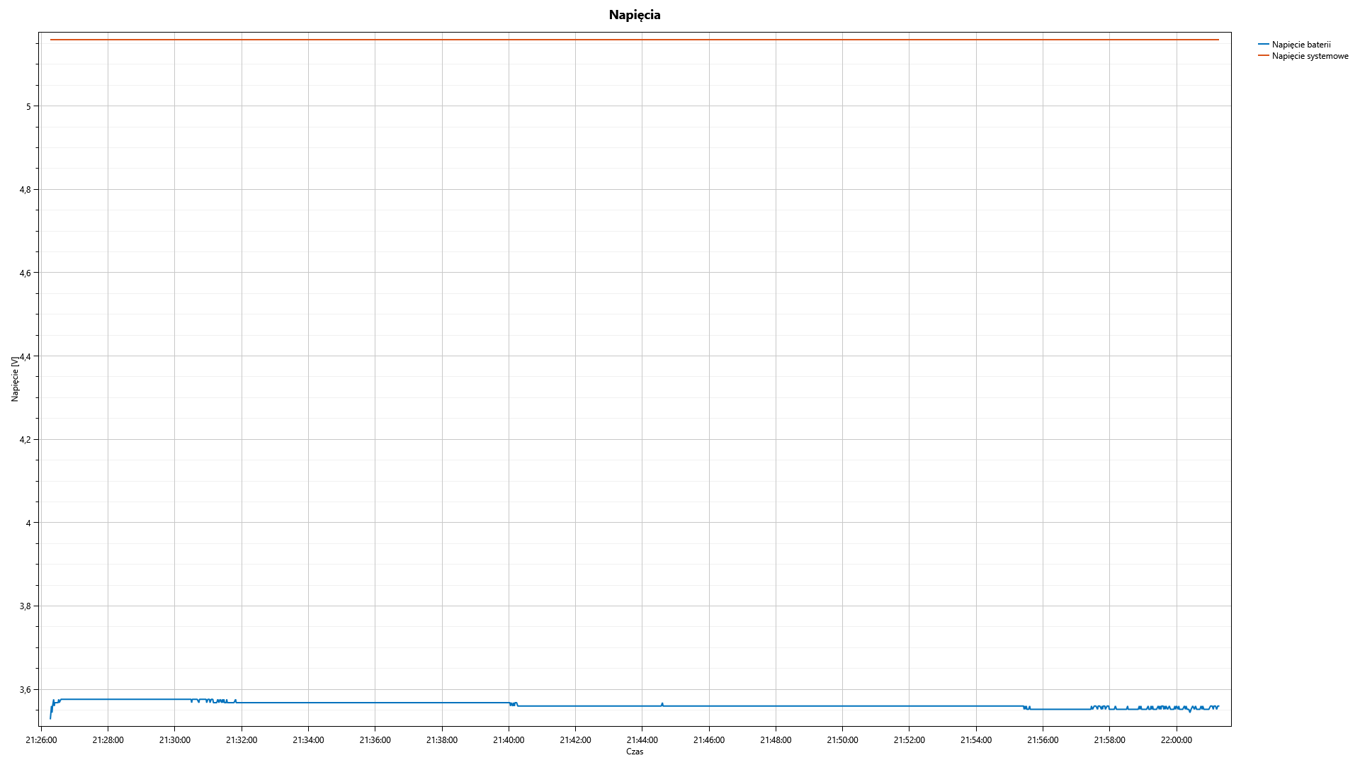
software/kubisat_firmware/telemetry_test/voltage_data_20250325_113904.png
