gredzikk/kubisat/3d/cubesat_wymiar.pdf

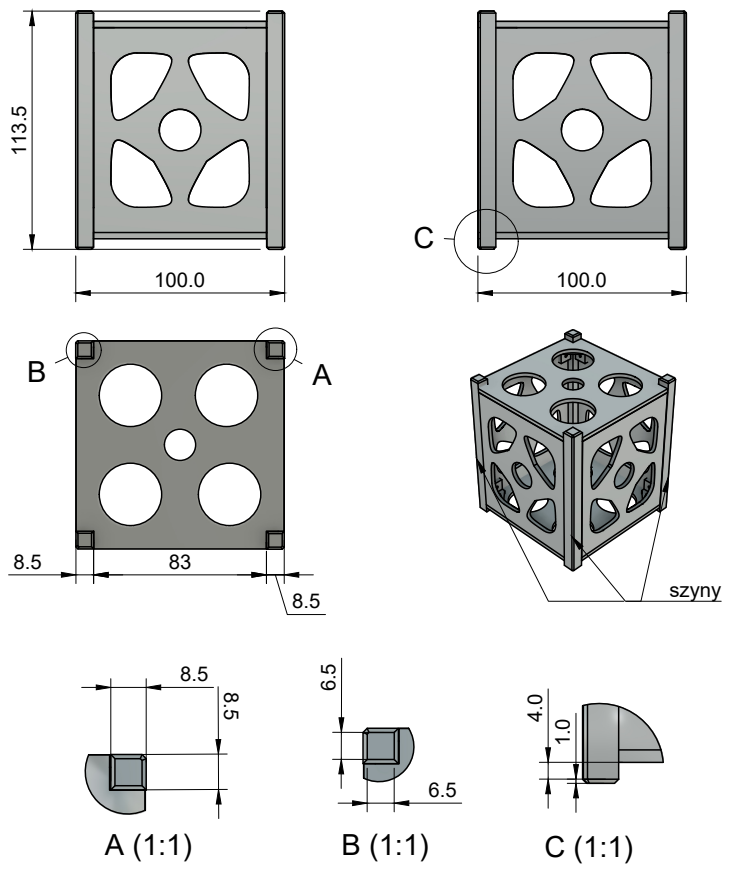
[picture p146: page 1]
