gredzikk/kubisat/3d/v2/kubisat_topbot Rysunek v2.pdf

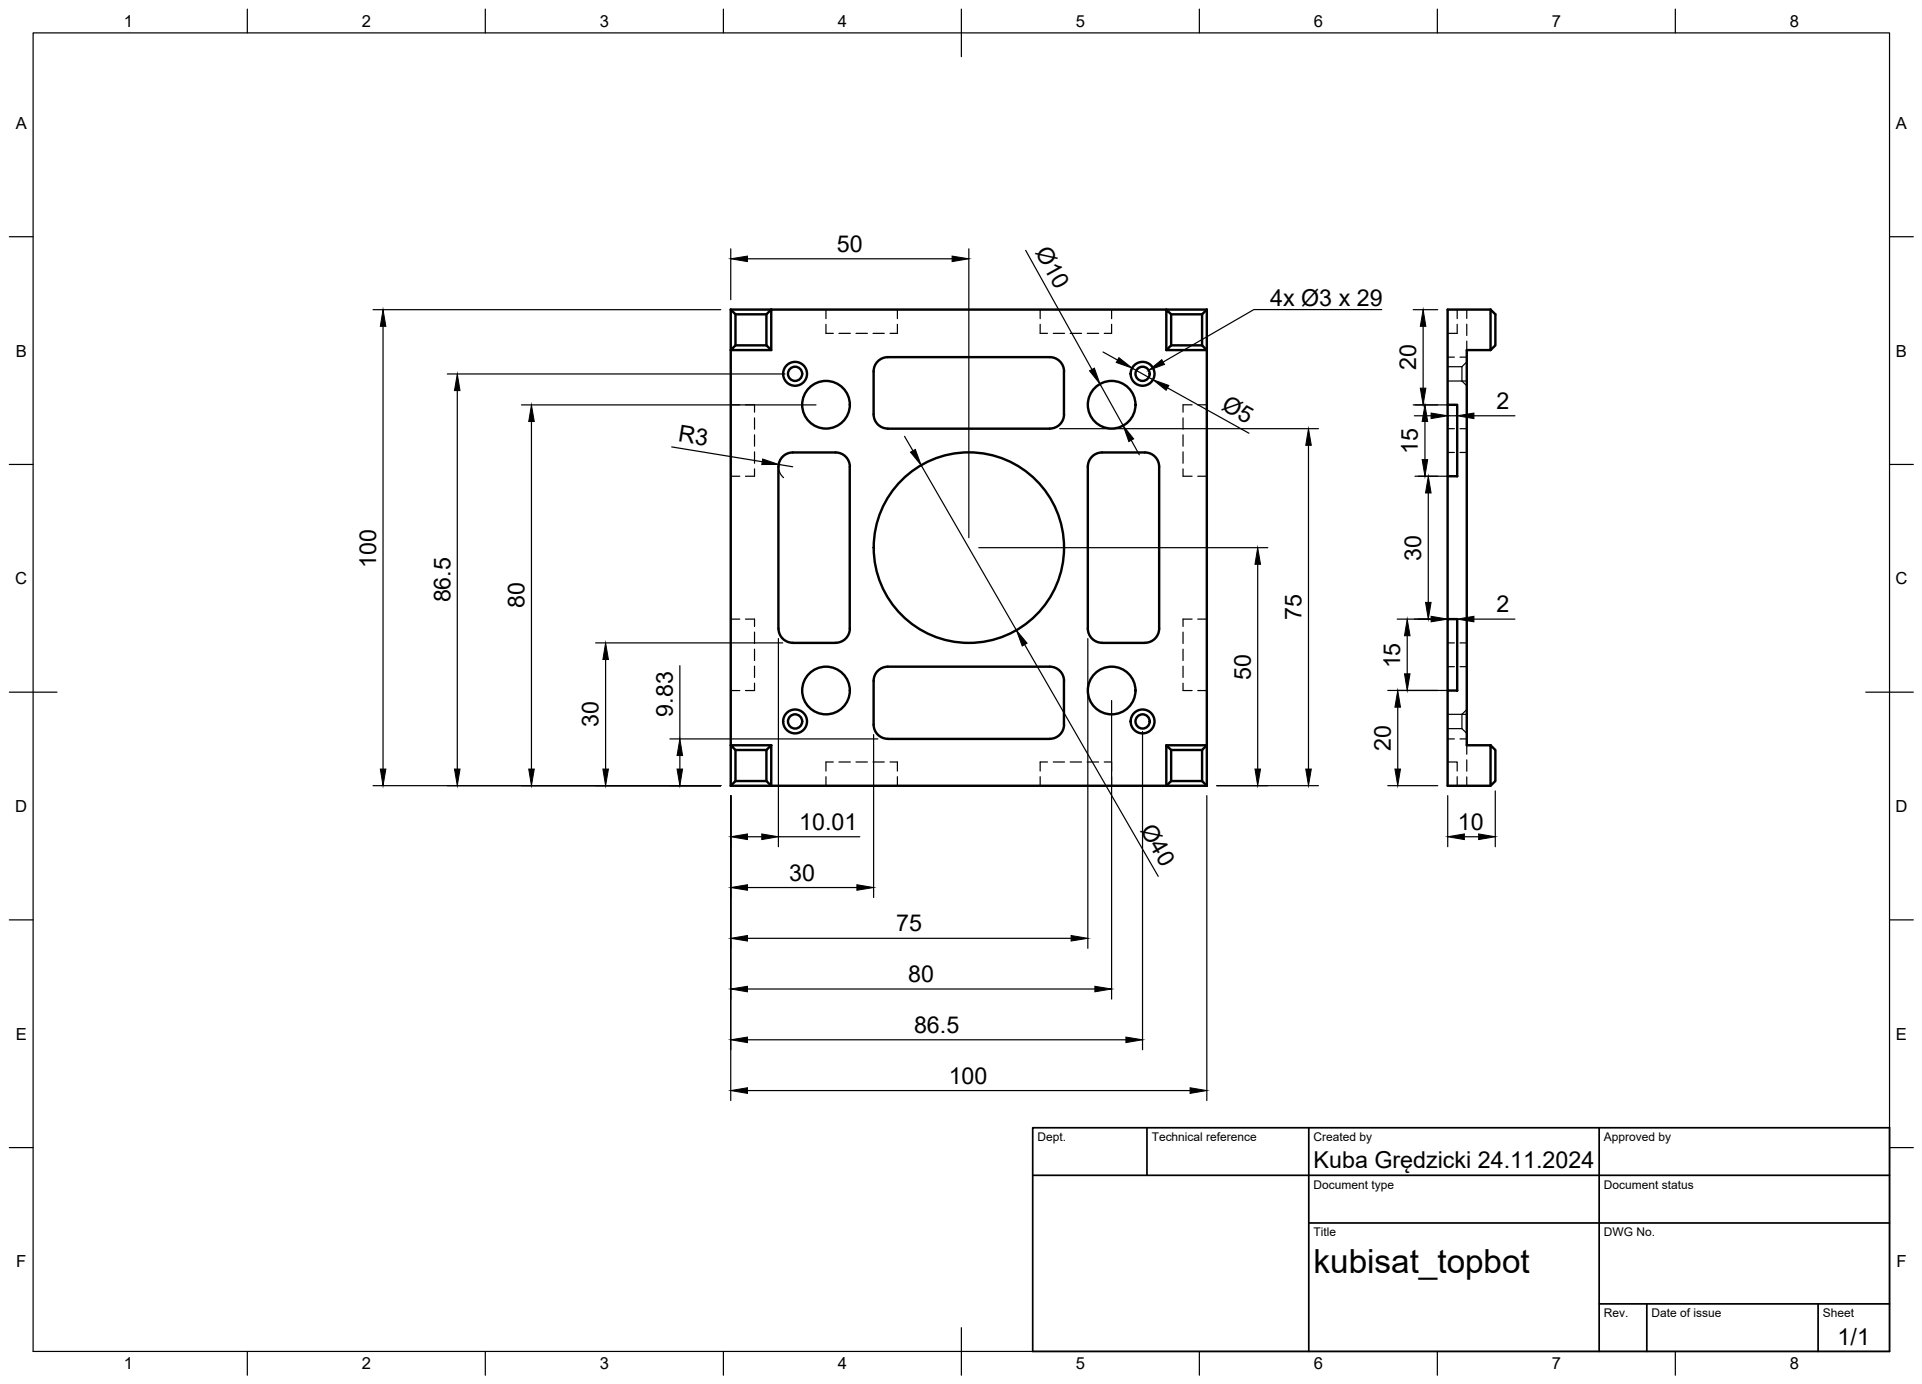
[picture p147: page 1]
Title; DWG No.; Rev.; Date of issue; Sheet

Dept. | Technical reference | Created by Kuba Grędzicki 24.11.2024 | Approved by

Document type | Document status
