gredzikk/kubisat/hardware/resource/Solar_Power_Manager_D_Schematic.pdf

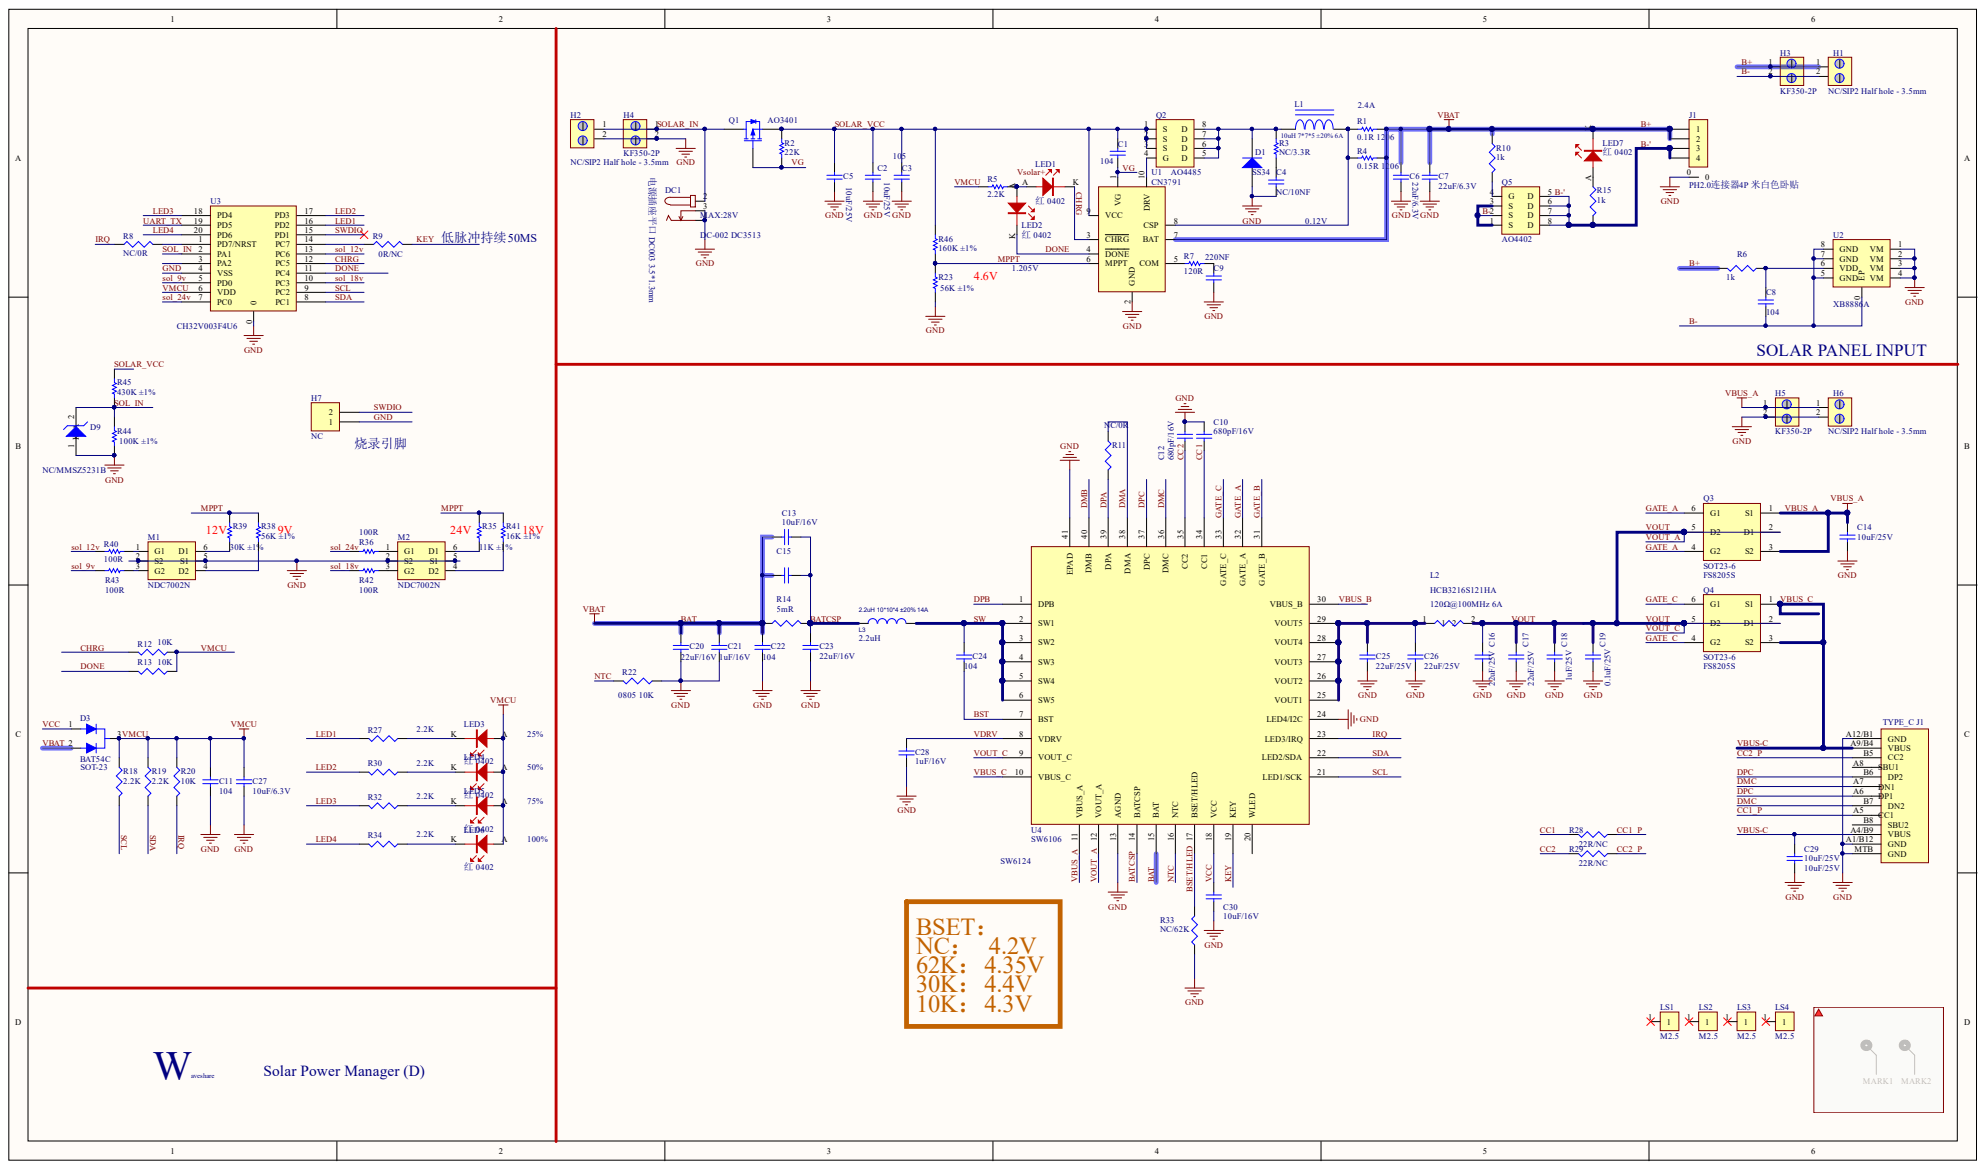
[picture p148: page 1]

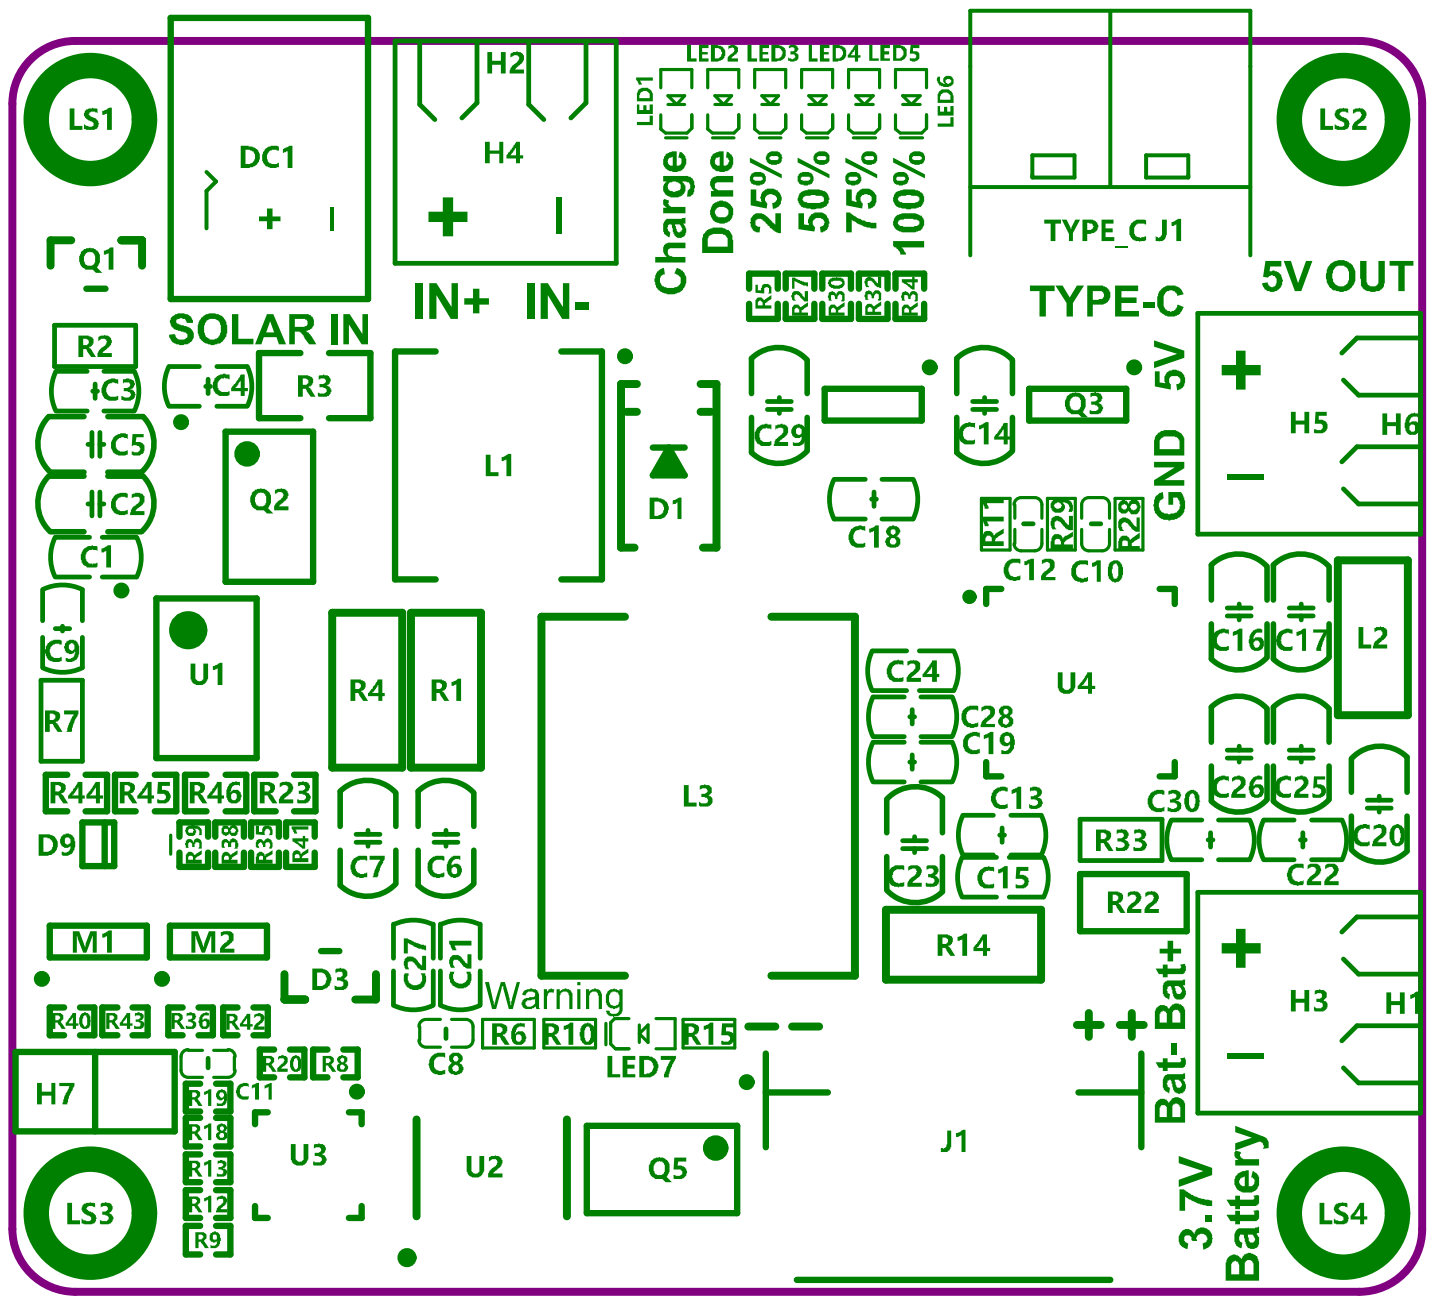
[picture p149: page 2]
