gredzikk/kubisat/hardware/kubisat_sensor/kubisat_sensors/kubisat_sensors.kicad_pcb

## KiCad design hardware/kubisat_sensor/kubisat_sensors/kubisat_sensors.kicad_pcb (2025-02-26)

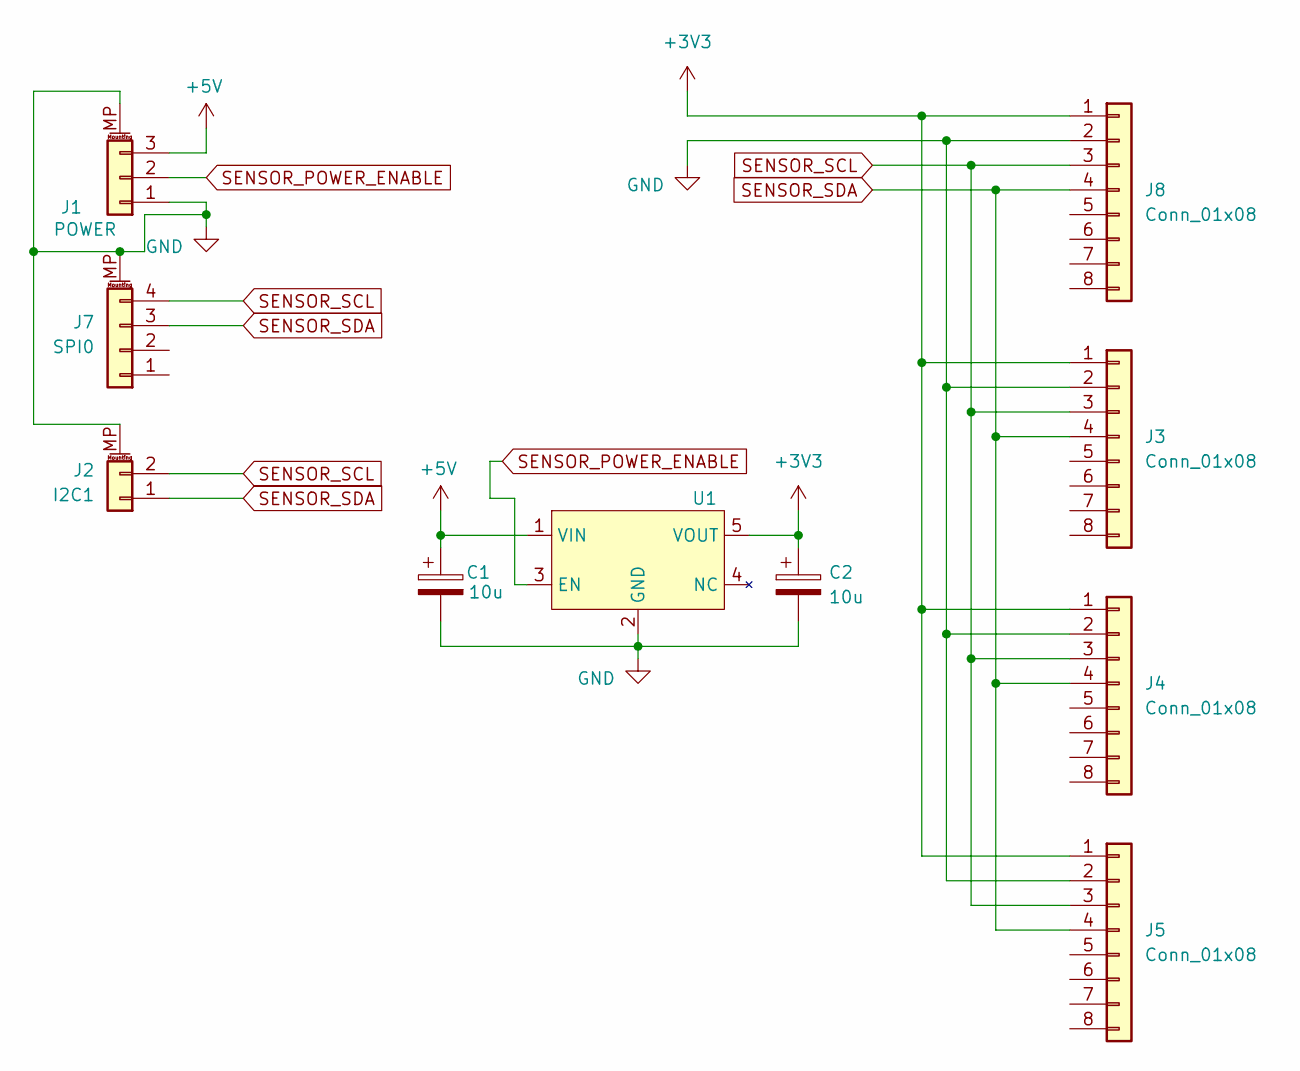
[picture p150: schematic kubisat_sensors.kicad_sch]

Parts:
C1, C2: 10u; CP_EIA-3216-18_Kemet-A
J1: POWER; JST_PH_S3B-PH-SM4-TB_1x03-1MP_P2.00mm_Horizontal
J2: I2C1; JST_PH_S2B-PH-SM4-TB_1x02-1MP_P2.00mm_Horizontal
J3, J4, J5, J8: Conn_01x08; PinSocket_1x08_P2.54mm_Vertical
J7: SPI0; JST_PH_S4B-PH-SM4-TB_1x04-1MP_P2.00mm_Horizontal
U1: SOT-23-5

Connections:
+3V3: C2.1, J3.1, J4.1, J5.1, J8.1, U1.5 (VOUT)
+5V: C1.1, J1.3, U1.1 (VIN)
GND: C1.2, C2.2, J1.1, J1.MP (MountPin), J2.MP (MountPin), J3.2, J4.2, J5.2, J7.MP (MountPin), J8.2, U1.2 (GND)
SENSOR_POWER_ENABLE: J1.2, U1.3 (EN)
SENSOR_SCL: J2.2, J3.3, J4.3, J5.3, J7.4, J8.3
SENSOR_SDA: J2.1, J3.4, J4.4, J5.4, J7.3, J8.4

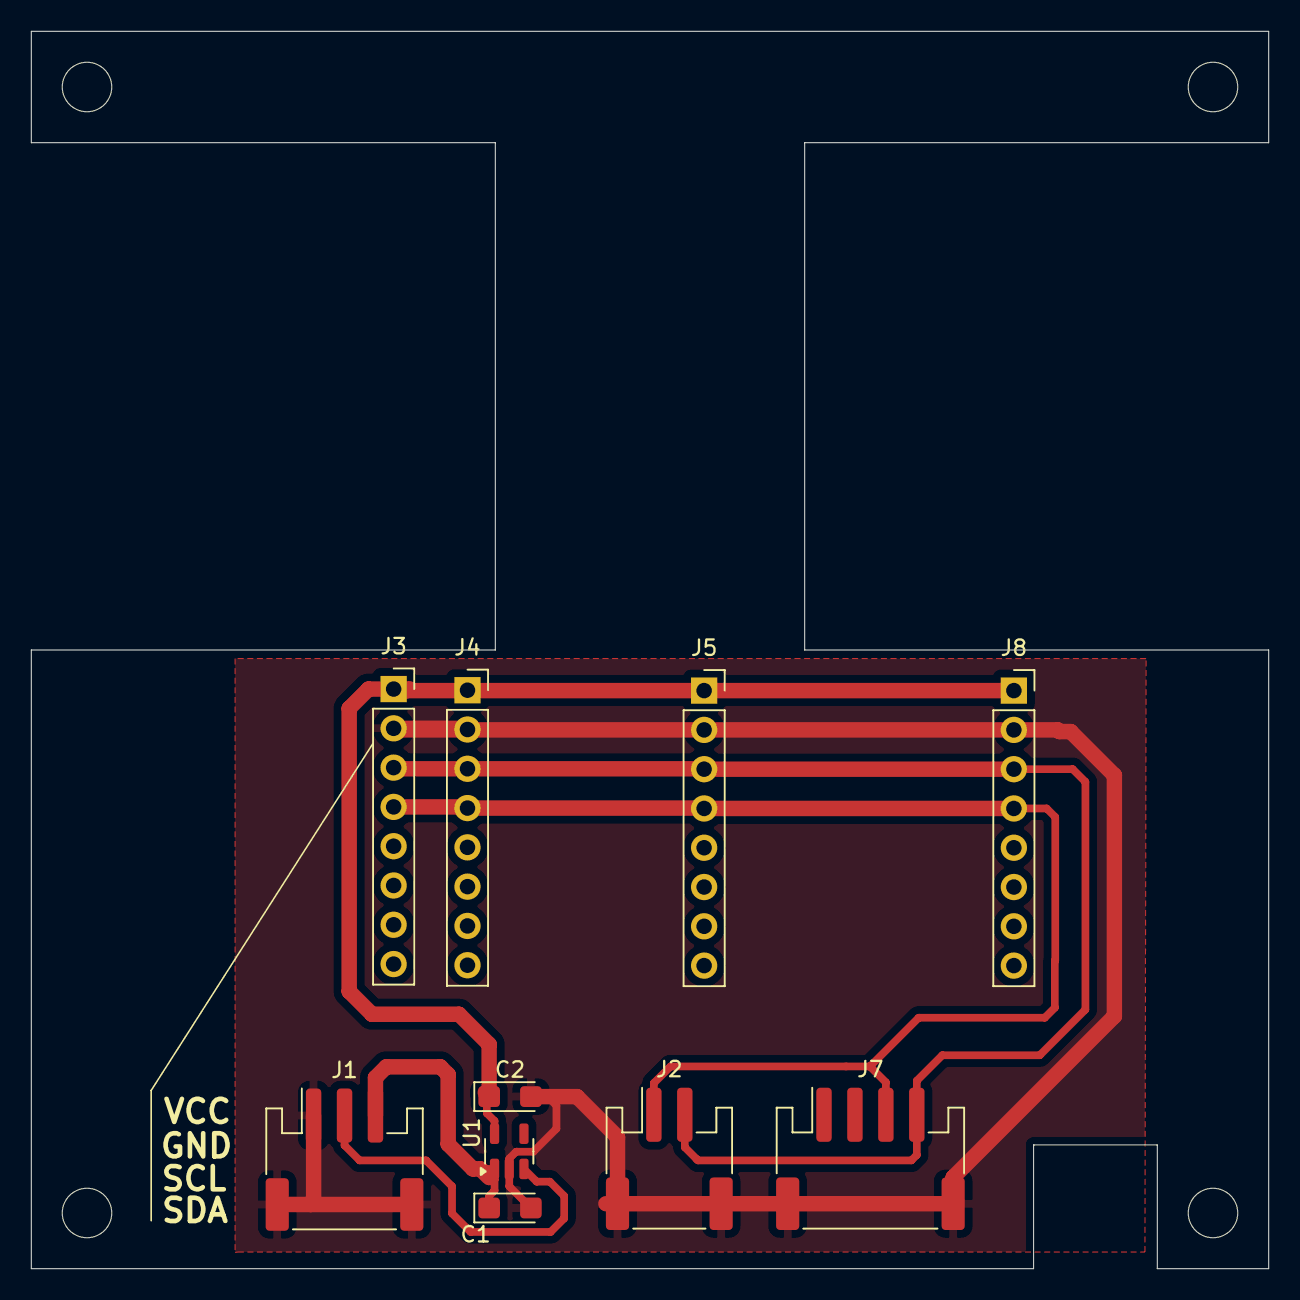
[picture p151: board kubisat_sensors.kicad_pcb from above]

Board: 2 copper layers, 80.0 x 80.0 mm, 14 parts (0 on the bottom side), 6 nets.

Other parts of the board:
H1, H1#2, H1#3, H1#4: MountingHole; MountingHole_3.2mm_M3_DIN965
