gredzikk/kubisat/hardware/kubisat_main/kubisat_main.kicad_pcb

## KiCad design hardware/kubisat_main/kubisat_main.kicad_pcb (2025-01-21)

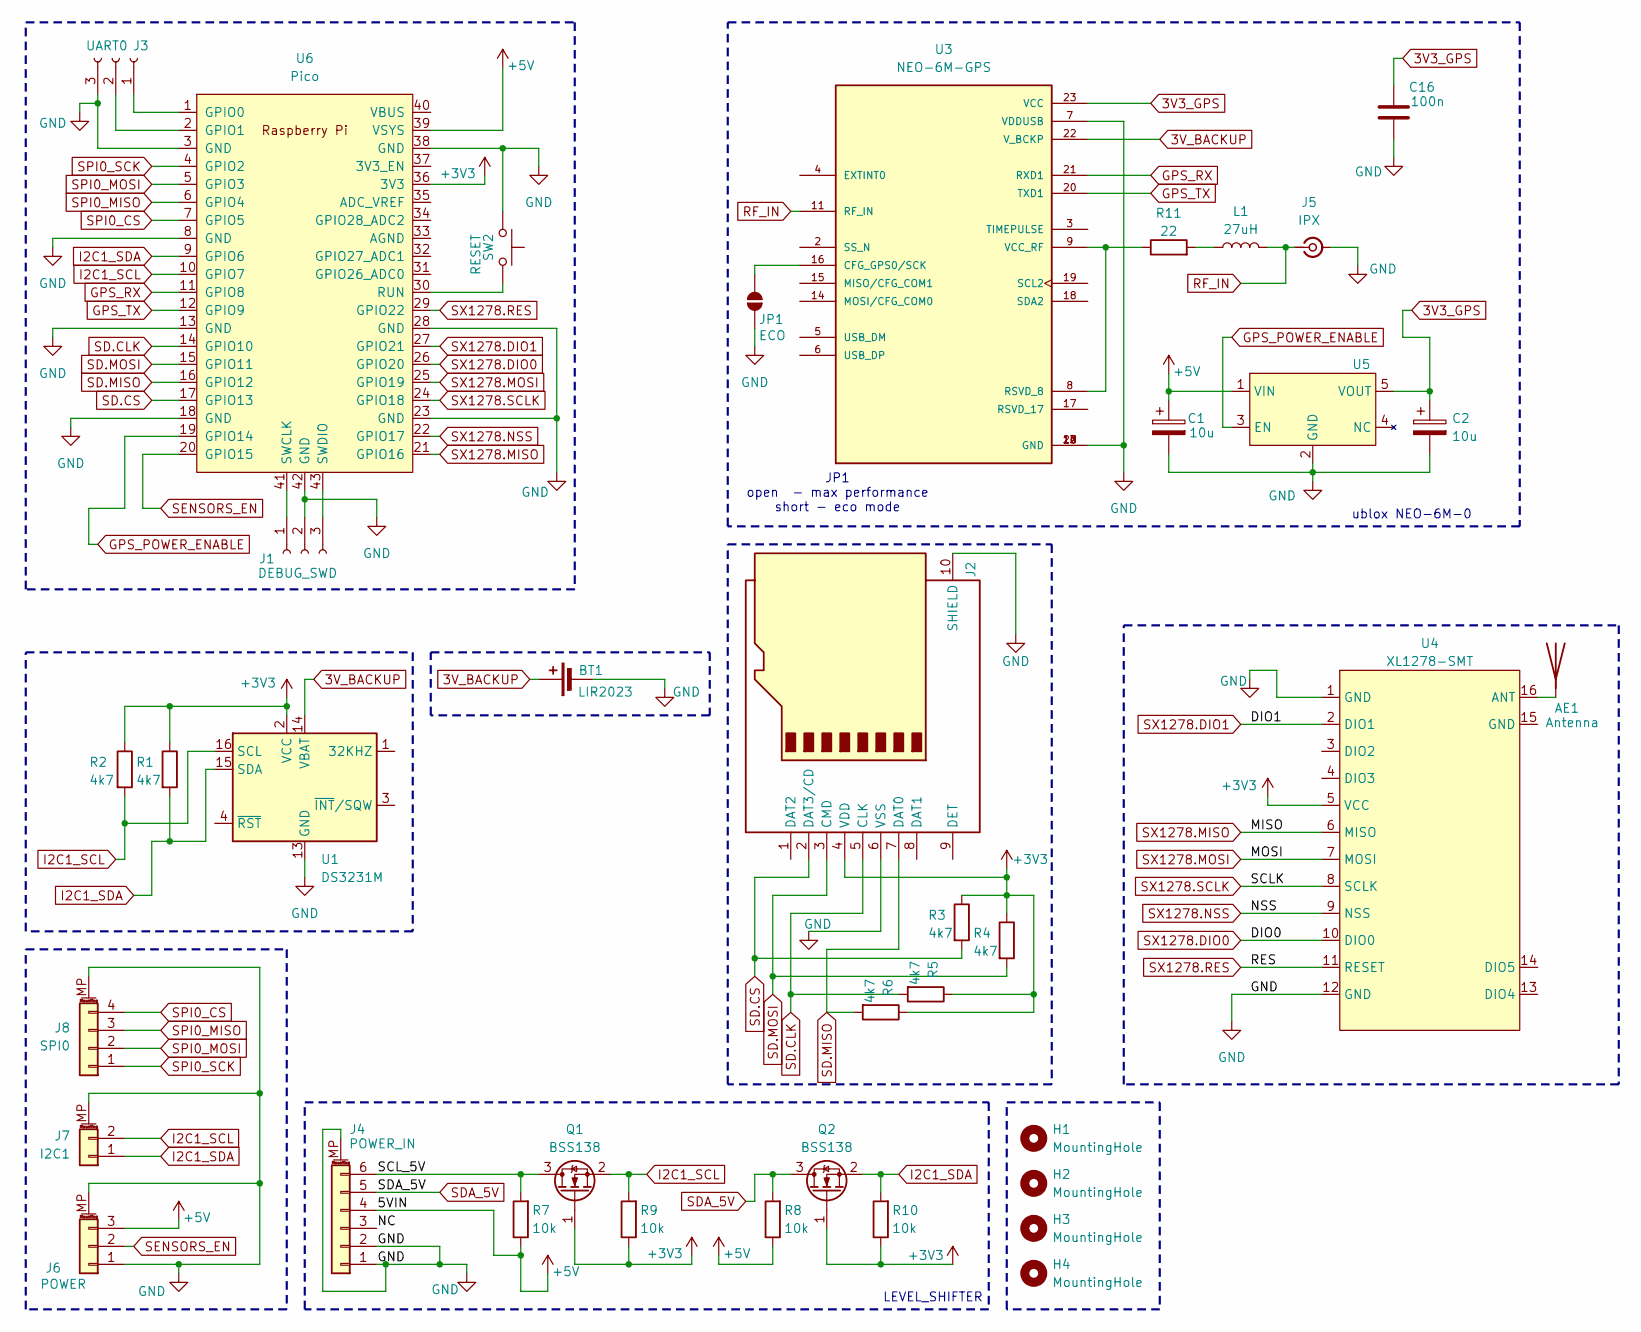
[picture p152: schematic kubisat_main.kicad_sch]

Parts:
AE1: Antenna
BT1: LIR2023; BatteryHolder_Keystone_106_1x20mm
C1, C2: 10u; CP_EIA-3216-18_Kemet-A
C16: 100n; C_0805_2012Metric
H1, H2, H3, H4: MountingHole; MountingHole_3.2mm_M3_DIN965
J1: DEBUG_SWD; PinHeader_1x03_P2.54mm_Horizontal
J2: Micro_SD_Card_Det1; J_SD_Card-micro_socket_A
J3: UART0; PinHeader_1x03_P2.54mm_Horizontal
J4: POWER_IN; JST_PH_S6B-PH-SM4-TB_1x06-1MP_P2.00mm_Horizontal
J5: IPX; U.FL_Hirose_U.FL-R-SMT-1_Vertical
J6: POWER; JST_PH_S3B-PH-SM4-TB_1x03-1MP_P2.00mm_Horizontal
J7: I2C1; JST_PH_S2B-PH-SM4-TB_1x02-1MP_P2.00mm_Horizontal
J8: SPI0; JST_PH_S4B-PH-SM4-TB_1x04-1MP_P2.00mm_Horizontal
JP1: ECO; SolderJumper-2_P1.3mm_Open_RoundedPad1.0x1.5mm
L1: 27uH; L_0805_2012Metric
Q1, Q2: BSS138; SOT-23
R1, R2, R3, R4, R5, R6: 4k7; R_0805_2012Metric
R7, R8, R9, R10: 10k; R_0805_2012Metric
R11: 22; R_0805_2012Metric
SW2: RESET; SW_Push_1P1T_NO_CK_KMR2
U1: DS3231M; SOIC-16W_7.5x10.3mm_P1.27mm
U3: NEO-6M-GPS; ublox_NEO; PARTREV R15
U4: XL1278-SMT
U5: SOT-23-5
U6: Pico; RPi_Pico_SMD_TH

Connections:
3V3_GPS: C2.1, C16.1, U3.23 (VCC), U5.5 (VOUT)
3V_BACKUP: BT1.1 (+), U1.14 (VBAT), U3.22 (V_BCKP)
+3V3: J2.4 (VDD), Q1.1 (G), Q2.1 (G), R1.1, R2.1, R3.1, R4.1, R5.1, R6.1, R9.1, R10.1, U1.2 (VCC), U4.5 (VCC), U6.36 (3V3)
+5V: C1.1, J4.4, J6.3, R7.1, R8.1, U5.1 (VIN), U6.39 (VSYS)
/NC: J4.3
/SCL_5V: J4.6, Q1.3 (D), R7.2
GND: BT1.2 (-), C1.2, C2.2, C16.2, J1.2, J2.6 (VSS), J2.10 (SHIELD), J3.3, J4.1, J4.2, J4.MP (MountPin), J5.2 (Ext), J6.1, J6.MP (MountPin), J7.MP (MountPin), J8.MP (MountPin), JP1.2 (B), SW2.1, U1.5 (GND), U1.6 (GND), U1.7 (GND), U1.8 (GND), U1.9 (GND), U1.10 (GND), U1.11 (GND), U1.12 (GND), U1.13 (GND), U3.7 (VDDUSB), U3.10 (GND), U3.12 (GND), U3.13 (GND), U3.24 (GND), U4.1 (GND), U4.12 (GND), U5.2 (GND), U6.3 (GND), U6.8 (GND), U6.13 (GND), U6.18 (GND), U6.23 (GND), U6.28 (GND), U6.38 (GND), U6.42 (GND)
GPS_POWER_ENABLE: U5.3 (EN), U6.19 (GPIO14)
GPS_RX: U3.21 (RXD1), U6.11 (GPIO8)
GPS_TX: U3.20 (TXD1), U6.12 (GPIO9)
I2C1_SCL: J7.2, Q1.2 (S), R2.2, R9.2, U1.16 (SCL), U6.10 (GPIO7)
I2C1_SDA: J7.1, Q2.2 (S), R1.2, R10.2, U1.15 (SDA), U6.9 (GPIO6)
unnamed: AE1.1, U4.16 (ANT)
unnamed: J1.1, U6.41 (SWCLK)
unnamed: J1.3, U6.43 (SWDIO)
unnamed: J3.1, U6.1 (GPIO0)
unnamed: J3.2, U6.2 (GPIO1)
unnamed: JP1.1 (A), U3.16 (CFG_GPS0/SCK)
unnamed: L1.1, R11.2
unnamed: R11.1, U3.8 (RSVD_8), U3.9 (VCC_RF)
unnamed: SW2.2, U6.30 (RUN)
RF_IN: J5.1 (In), L1.2, U3.11 (RF_IN)
SD.CLK: J2.5 (CLK), R5.2, U6.14 (GPIO10)
SD.CS: J2.2 (DAT3/CD), R3.2, U6.17 (GPIO13)
SD.MISO: J2.7 (DAT0), R6.2, U6.16 (GPIO12)
SD.MOSI: J2.3 (CMD), R4.2, U6.15 (GPIO11)
SDA_5V: J4.5, Q2.3 (D), R8.2
SENSORS_EN: J6.2, U6.20 (GPIO15)
SPI0_CS: J8.4, U6.7 (GPIO5)
SPI0_MISO: J8.3, U6.6 (GPIO4)
SPI0_MOSI: J8.2, U6.5 (GPIO3)
SPI0_SCK: J8.1, U6.4 (GPIO2)
SX1278.DIO0: U4.10 (DIO0), U6.26 (GPIO20)
SX1278.DIO1: U4.2 (DIO1), U6.27 (GPIO21)
SX1278.MISO: U4.6 (MISO), U6.21 (GPIO16)
SX1278.MOSI: U4.7 (MOSI), U6.25 (GPIO19)
SX1278.NSS: U4.9 (NSS), U6.22 (GPIO17)
SX1278.RES: U4.11 (RESET), U6.29 (GPIO22)
SX1278.SCLK: U4.8 (SCLK), U6.24 (GPIO18)

Notes on the sheet:
JP1 open - max performance short - eco mode
ublox NEO-6M-0
LEVEL_SHIFTER

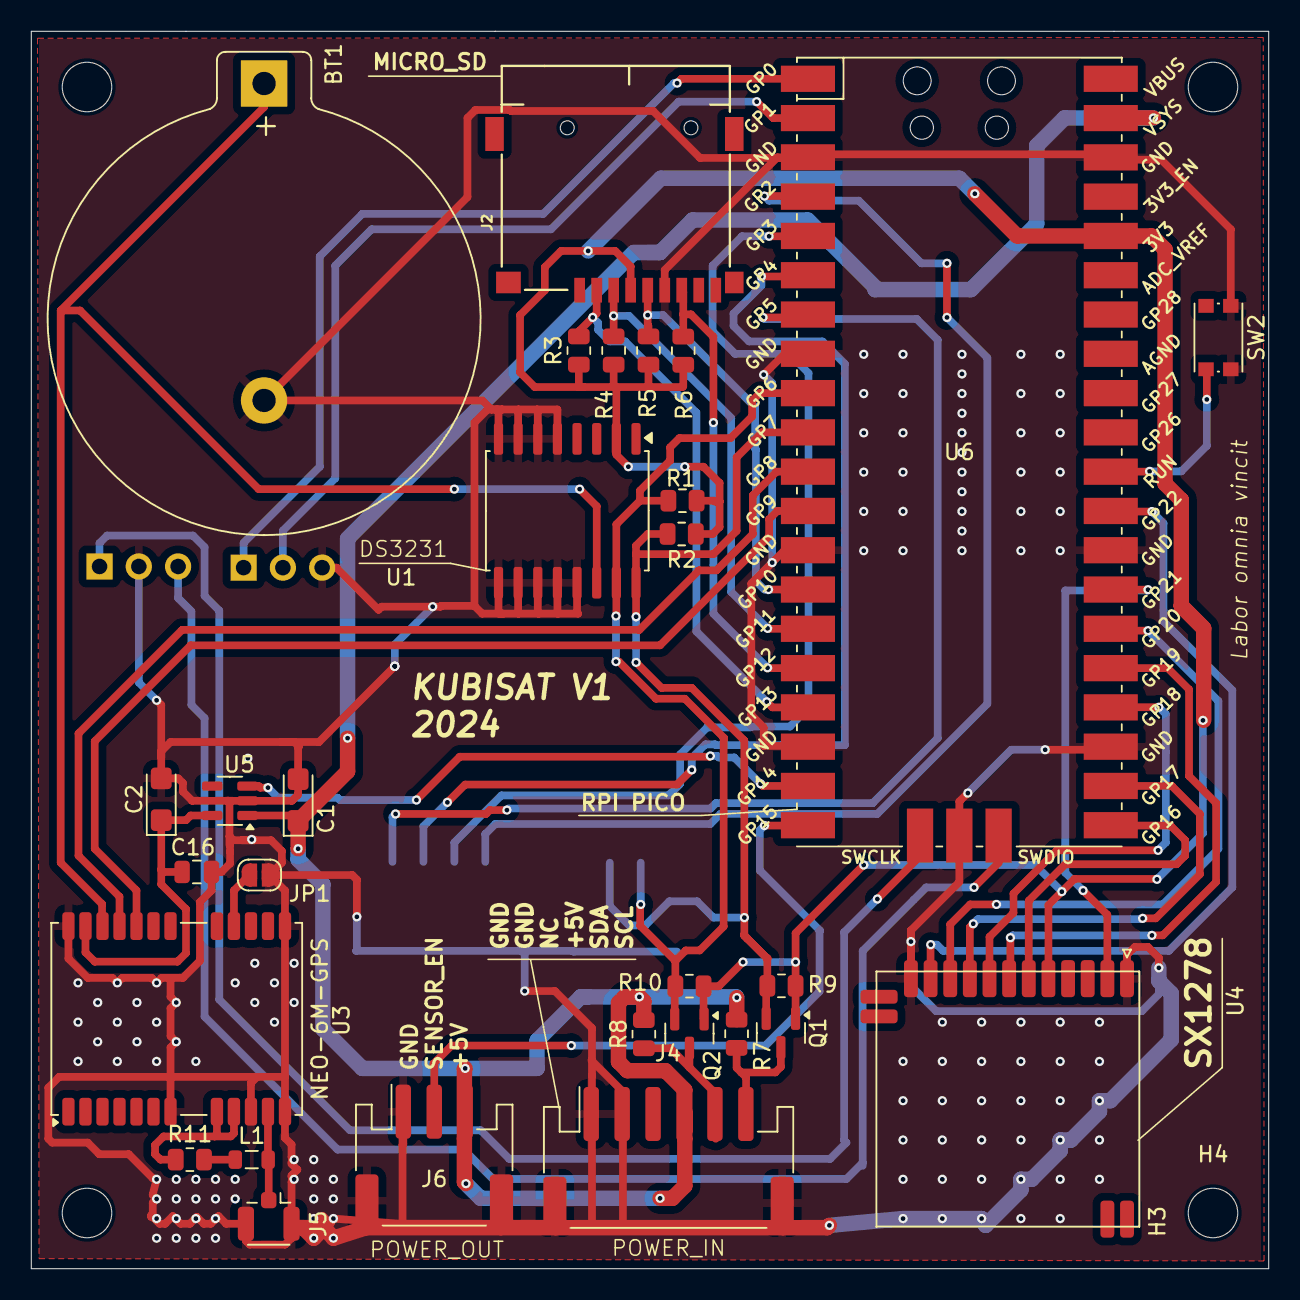
[picture p153: board kubisat_main.kicad_pcb from above]

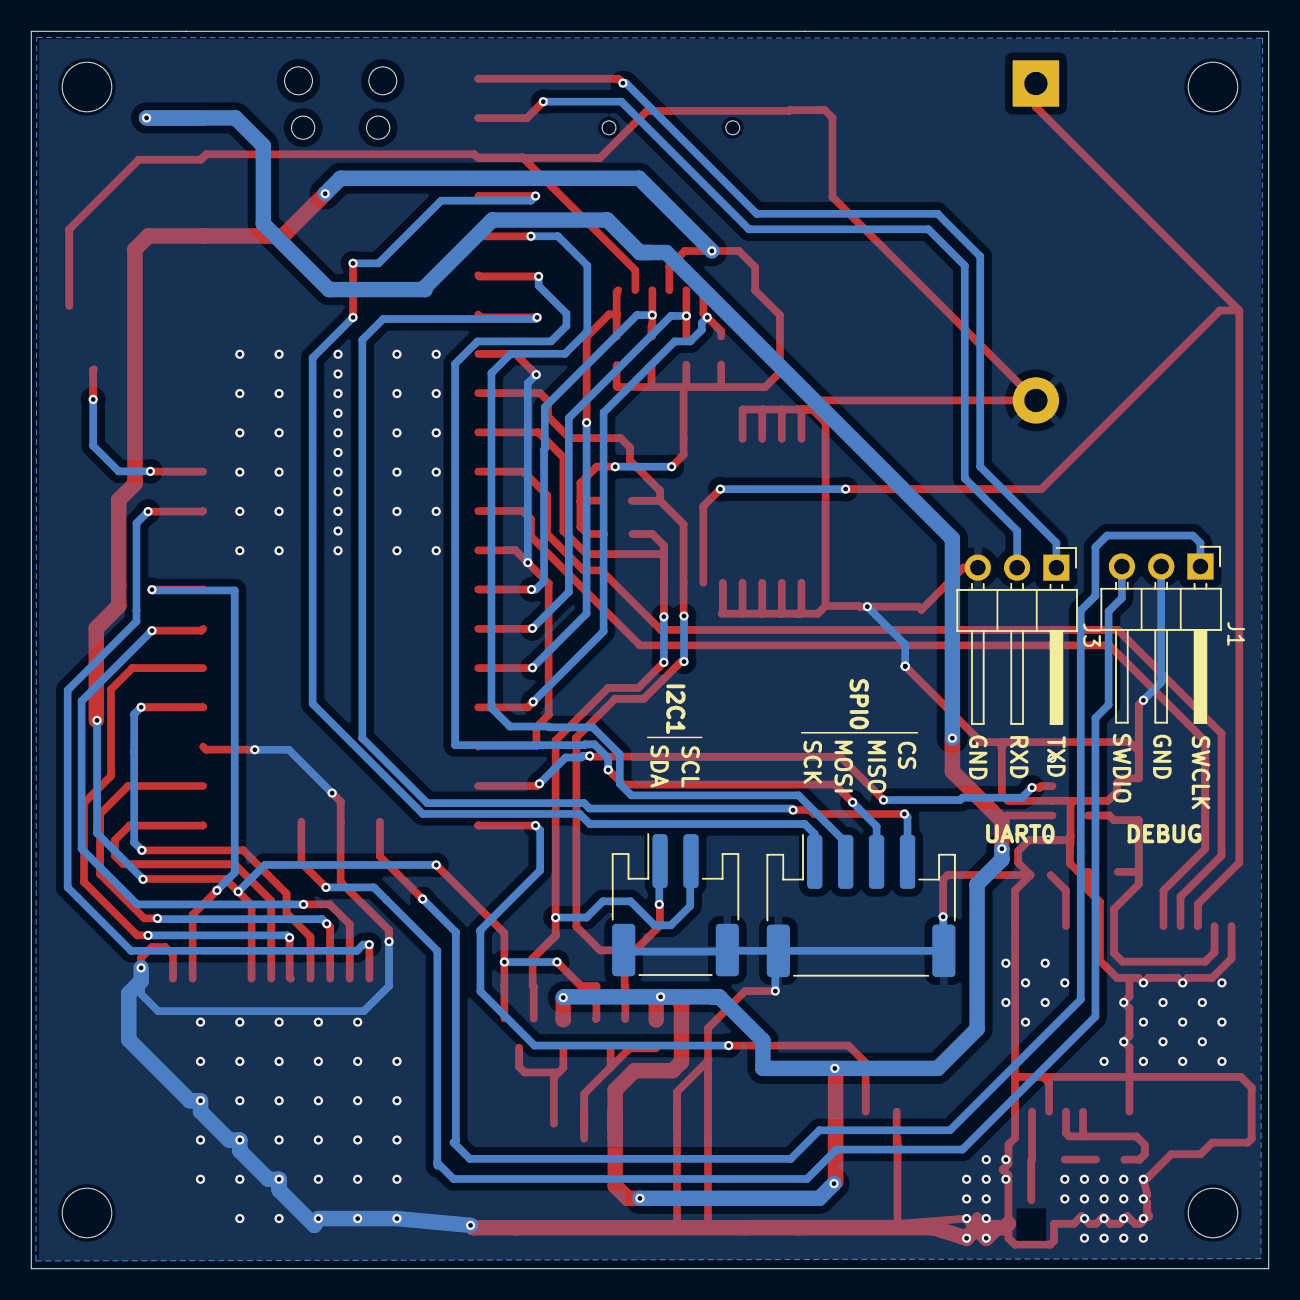
[picture p154: board kubisat_main.kicad_pcb from below]

Board: 2 copper layers, 80.0 x 80.0 mm, 37 parts (4 on the bottom side), 37 nets.
