gredzikk/kubisat/hardware/kubisat_power/kubisat_power.kicad_pcb

## KiCad design hardware/kubisat_power/kubisat_power.kicad_pcb (2024-10-21)

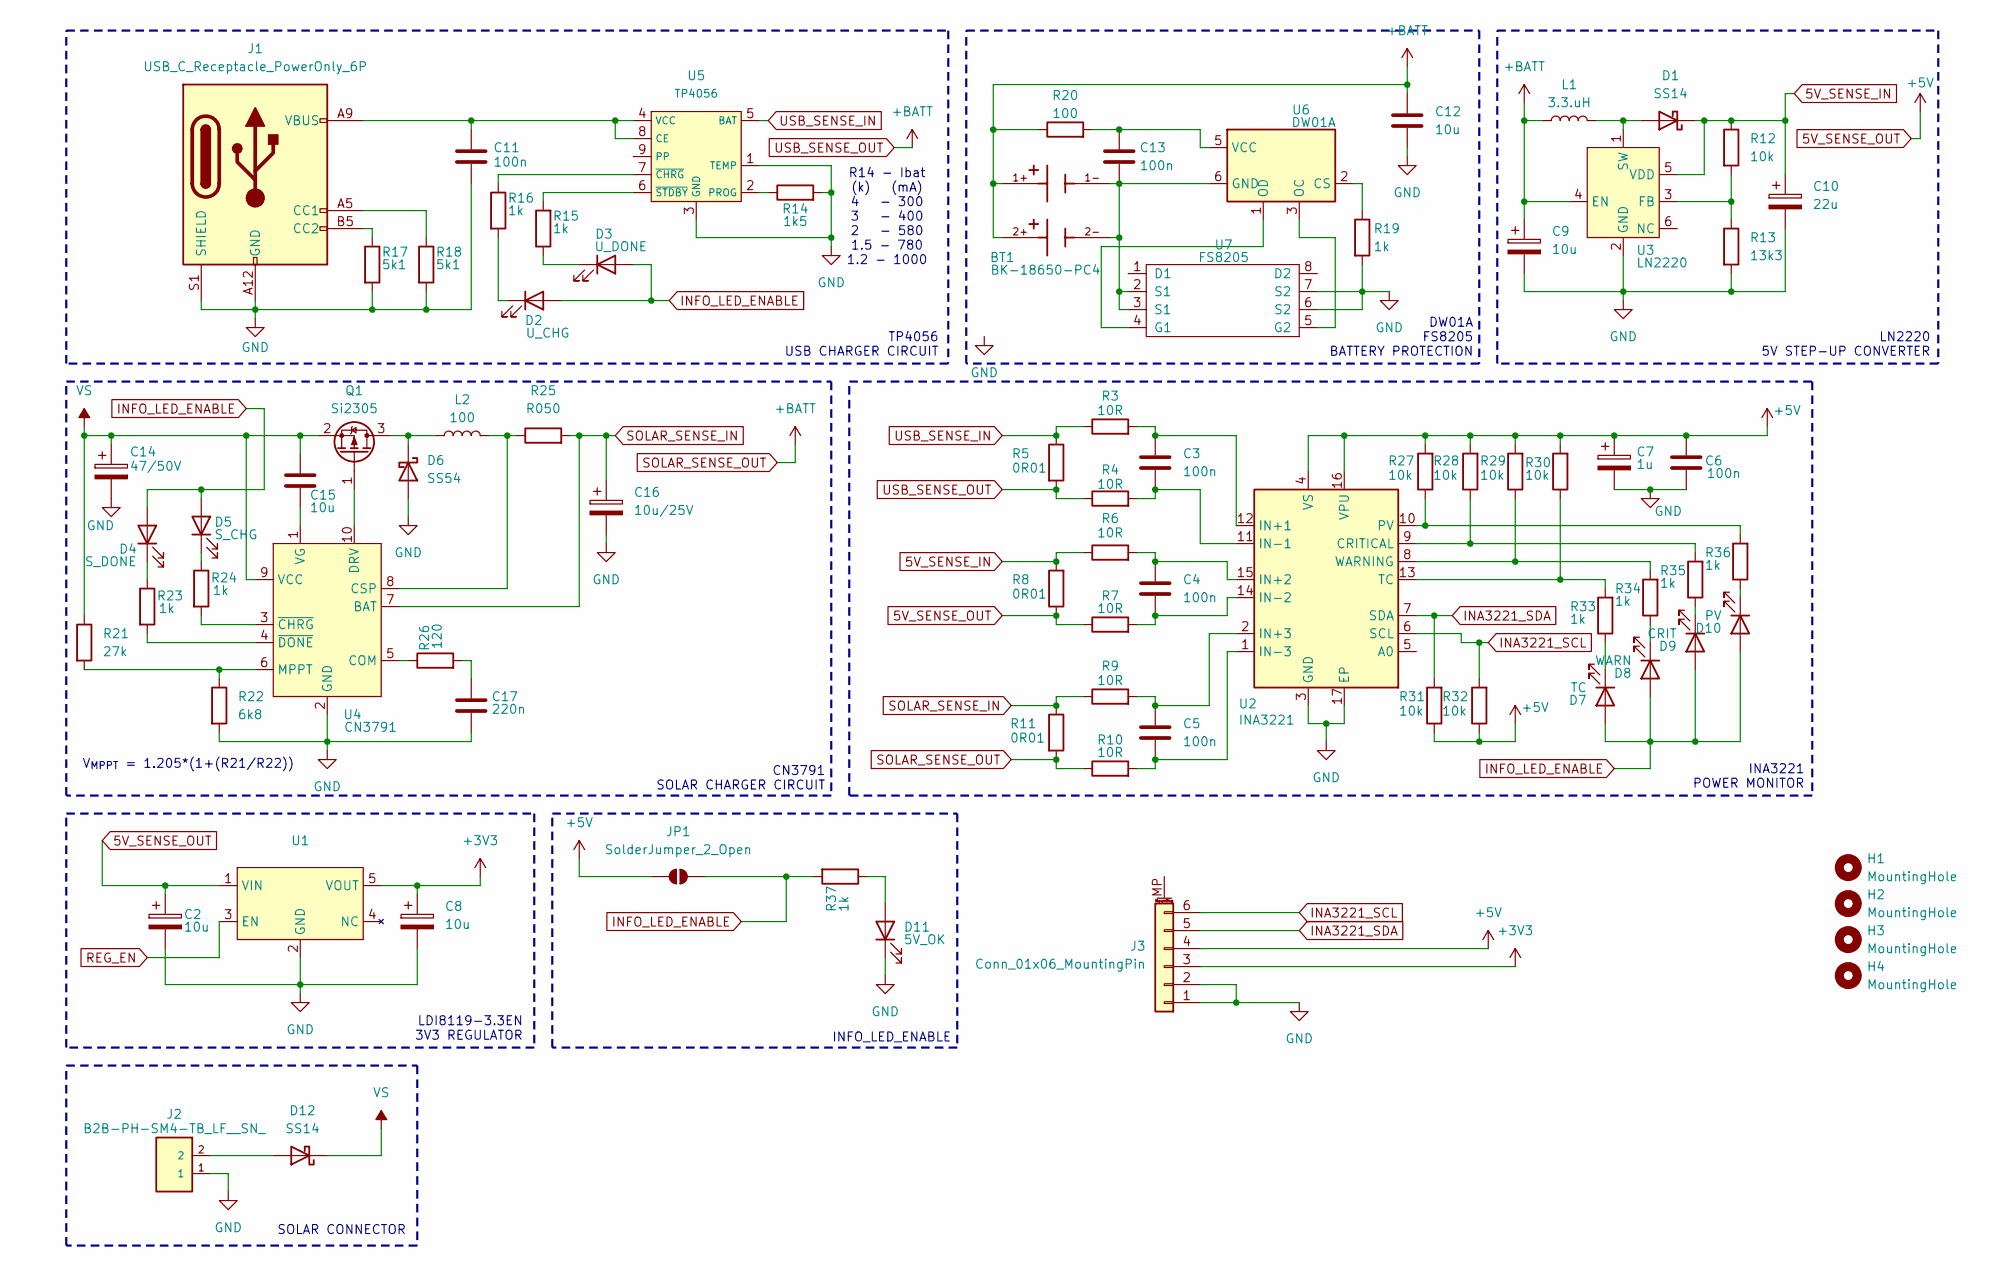
[picture p155: schematic kubisat_power.kicad_sch]

Parts:
BT1: BK-18650-PC4; BAT_BK-18650-PC4; PARTREV K
C2, C8: 10u; CP_Elec_4x5.4
C3, C4, C5, C6, C11, C13: 100n; C_0805_2012Metric
C7: 1u; CP_Elec_4x5.4
C9: 10u; C_1206_3216Metric
C10: 22u; C_1206_3216Metric
C12, C15: 10u; C_0805_2012Metric
C14: 47/50V; C_Elec_6.3x5.8
C16: 10u/25V; C_1210_3225Metric
C17: 220n; C_0805_2012Metric
D1, D12: SS14; D_SMA
D2: U_CHG; LED_0805_2012Metric
D3: U_DONE; LED_0805_2012Metric
D4: S_DONE; LED_0805_2012Metric
D5: S_CHG; LED_0805_2012Metric
D6: SS54; D_SMA
D7: TC; LED_0805_2012Metric
D8: WARN; LED_0805_2012Metric
D9: CRIT; LED_0805_2012Metric
D10: PV; LED_0805_2012Metric
D11: 5V_OK; LED_0805_2012Metric
H1, H2, H3, H4: MountingHole; MountingHole_3.2mm_M3_DIN965
J1: USB_C_Receptacle_PowerOnly_6P; GCT_USB4140-GF-0230-C_REV0.4
J2: B2B-PH-SM4-TB_LF__SN_
J3: Conn_01x06_MountingPin; JST_PH_S6B-PH-SM4-TB_1x06-1MP_P2.00mm_Horizontal
JP1: SolderJumper_2_Open; SolderJumper-2_P1.3mm_Open_RoundedPad1.0x1.5mm
L1: 3.3.uH; L_Cenker_CKCS5040
L2: 100; L_Bourns_SRP7028A_7.3x6.6mm
Q1: Si2305; SOT-23
R3, R4, R6, R7, R9, R10: 10R; R_0805_2012Metric
R5, R8, R11: 0R01; R_2512_6332Metric_Pad1.40x3.35mm_HandSolder
R12, R27, R28, R29, R30, R31, R32: 10k; R_0805_2012Metric
R13: 13k3; R_0805_2012Metric
R14: 1k5; R_0805_2012Metric
R15, R16, R19, R23, R24, R33, R34, R35, R36, R37: 1k; R_0805_2012Metric
R17, R18: 5k1; R_0805_2012Metric
R20: 100; R_0805_2012Metric
R21: 27k; R_0805_2012Metric
R22: 6k8; R_0805_2012Metric
R25: R050; R_2512_6332Metric_Pad1.40x3.35mm_HandSolder
R26: 120; R_0805_2012Metric
U1: SOT-23-5
U2: INA3221; Texas_RGV0016A_VQFN-16-1EP_4x4mm_P0.65mm_EP2.1x2.1mm
U3: LN2220; TSOT-23-6_HandSoldering
U4: CN3791; SSOP-10-1EP_3.9x4.9mm_P1mm_EP2.1x3.3mm
U5: TP4056; SOIC-8-1EP_3.9x4.9mm_P1.27mm_EP2.29x3mm
U6: DW01A; SOT-23-6
U7: FS8205; TSSOP-8_3x3mm_P0.65mm; LCSC C32254

Connections:
5V_SENSE_IN: C10.1, D1.1 (K), R6.1, R8.2, R12.1, U3.5 (VDD)
+3V3: C8.1, J3.3, U1.5 (VOUT)
GND: C2.2, C6.2, C7.2, C8.2, C9.2, C10.2, C11.2, C12.2, C14.2, C16.2, C17.2, D6.2 (A), D11.1 (K), J1.A12 (GND), J1.B12 (GND), J1.S1 (SHIELD), J2.1, J3.1, J3.2, R13.2, R14.2, R17.2, R18.2, R19.2, R22.2, U1.2 (GND), U2.3 (GND), U2.17 (EP), U3.2 (GND), U4.2 (GND), U5.1 (TEMP), U5.3 (GND), U7.6 (S2), U7.7 (S2)
INA3221_SCL: J3.6, R32.2, U2.6 (SCL)
INA3221_SDA: J3.5, R31.2, U2.7 (SDA)
INFO_LED_ENABLE: D2.2 (A), D3.2 (A), D4.2 (A), D5.2 (A), D7.2 (A), D8.2 (A), D9.2 (A), D10.2 (A), JP1.2 (B), R37.2
unnamed: C17.1, R26.2
unnamed: D1.2 (A), L1.2, U3.1 (SW)
unnamed: D2.1 (K), R16.2
unnamed: D3.1 (K), R15.1
unnamed: D4.1 (K), R23.1
unnamed: D5.1 (K), R24.1
unnamed: D6.1 (K), L2.1, Q1.3 (D)
unnamed: D7.1 (K), R33.1
unnamed: D8.1 (K), R34.1
unnamed: D9.1 (K), R35.1
unnamed: D10.1 (K), R36.1
unnamed: D11.2 (A), R37.1
unnamed: D12.2 (A), J2.2
unnamed: J1.A5 (CC1), R18.1
unnamed: J1.B5 (CC2), R17.1
unnamed: Q1.1 (G), U4.10 (DRV)
unnamed: R28.1, R35.2, U2.9 (CRITICAL)
unnamed: C3.1, R3.2, U2.12 (IN+1)
unnamed: C4.1, R6.2, U2.15 (IN+2)
unnamed: C5.1, R9.2, U2.2 (IN+3)
unnamed: C3.2, R4.2, U2.11 (IN-1)
unnamed: C4.2, R7.2, U2.14 (IN-2)
unnamed: C5.2, R10.2, U2.1 (IN-3)
unnamed: R27.1, R36.2, U2.10 (PV)
unnamed: R30.1, R33.2, U2.13 (TC)
unnamed: R29.1, R34.2, U2.8 (WARNING)
unnamed: R12.2, R13.1, U3.3 (FB)
unnamed: R26.1, U4.5 (COM)
unnamed: L2.2, R25.1, U4.8 (CSP)
unnamed: R21.2, R22.1, U4.6 (MPPT)
unnamed: C15.2, U4.1 (VG)
unnamed: R24.2, U4.3 (~CHRG)
unnamed: R23.2, U4.4 (~DONE)
unnamed: C11.1, J1.A9 (VBUS), J1.B9 (VBUS), U5.4 (VCC), U5.8 (CE)
unnamed: R14.1, U5.2 (PROG)
unnamed: R16.1, U5.7 (~CHRG)
unnamed: R15.2, U5.6 (~STDBY)
unnamed: R19.1, U6.2 (CS)
unnamed: BT1.1-, BT1.2-, C13.2, U6.6 (GND), U7.2 (S1), U7.3 (S1)
unnamed: U6.3 (OC), U7.5 (G2)
unnamed: U6.1 (OD), U7.4 (G1)
unnamed: C13.1, R20.2, U6.5 (VCC)
REG_EN: U1.3 (EN)
SOLAR_SENSE_IN: C16.1, R9.1, R11.1, R25.2, U4.7 (BAT)
USB_SENSE_IN: R3.1, R5.1, U5.5 (BAT)
VS: C14.1, C15.1, D12.1 (K), Q1.2 (S), R21.1, U4.9 (VCC)

Notes on the sheet:
INFO_LED_ENABLE
CN3791 SOLAR CHARGER CIRCUIT
R14 - Ibat (k) (mA) 4 - 300 3 - 400 2 - 580 1.5 - 780 1.2 - 1000
LN2220 5V STEP-UP CONVERTER
LDI8119-3.3EN 3V3 REGULATOR
TP4056 USB CHARGER CIRCUIT
V_{MPPT} = 1.205*(1+(R21/R22))
DW01A FS8205 BATTERY PROTECTION
SOLAR CONNECTOR
INA3221 POWER MONITOR

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
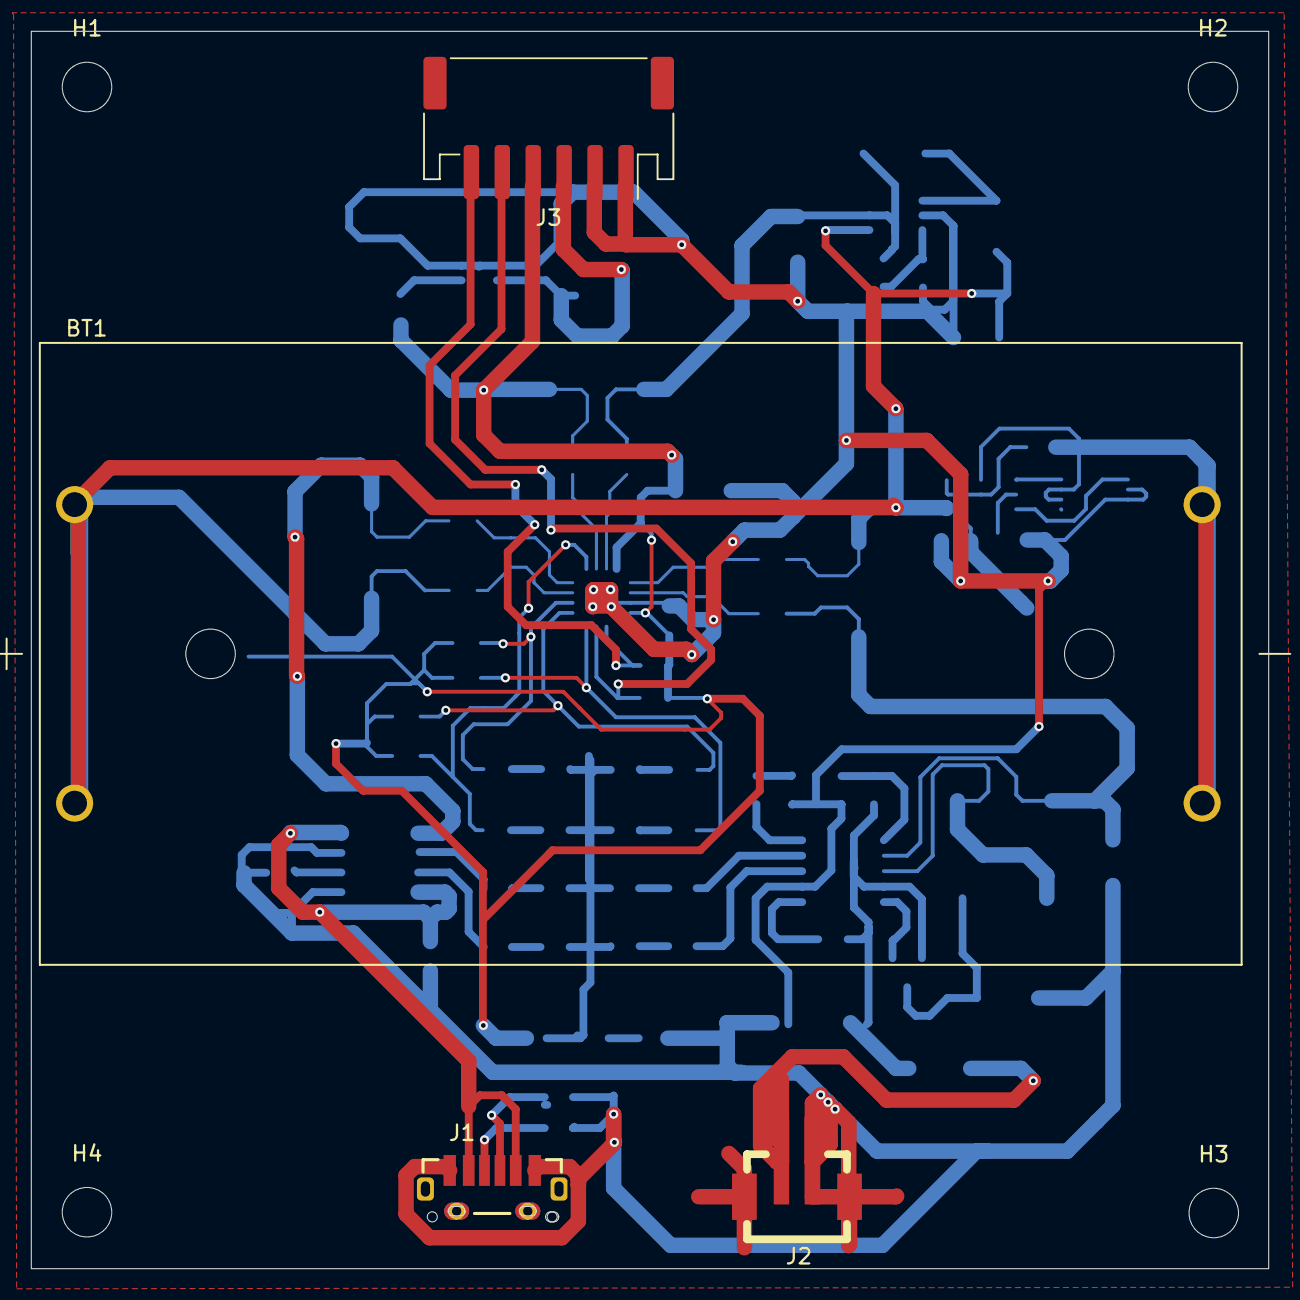
[picture p156: board kubisat_power.kicad_pcb from above]

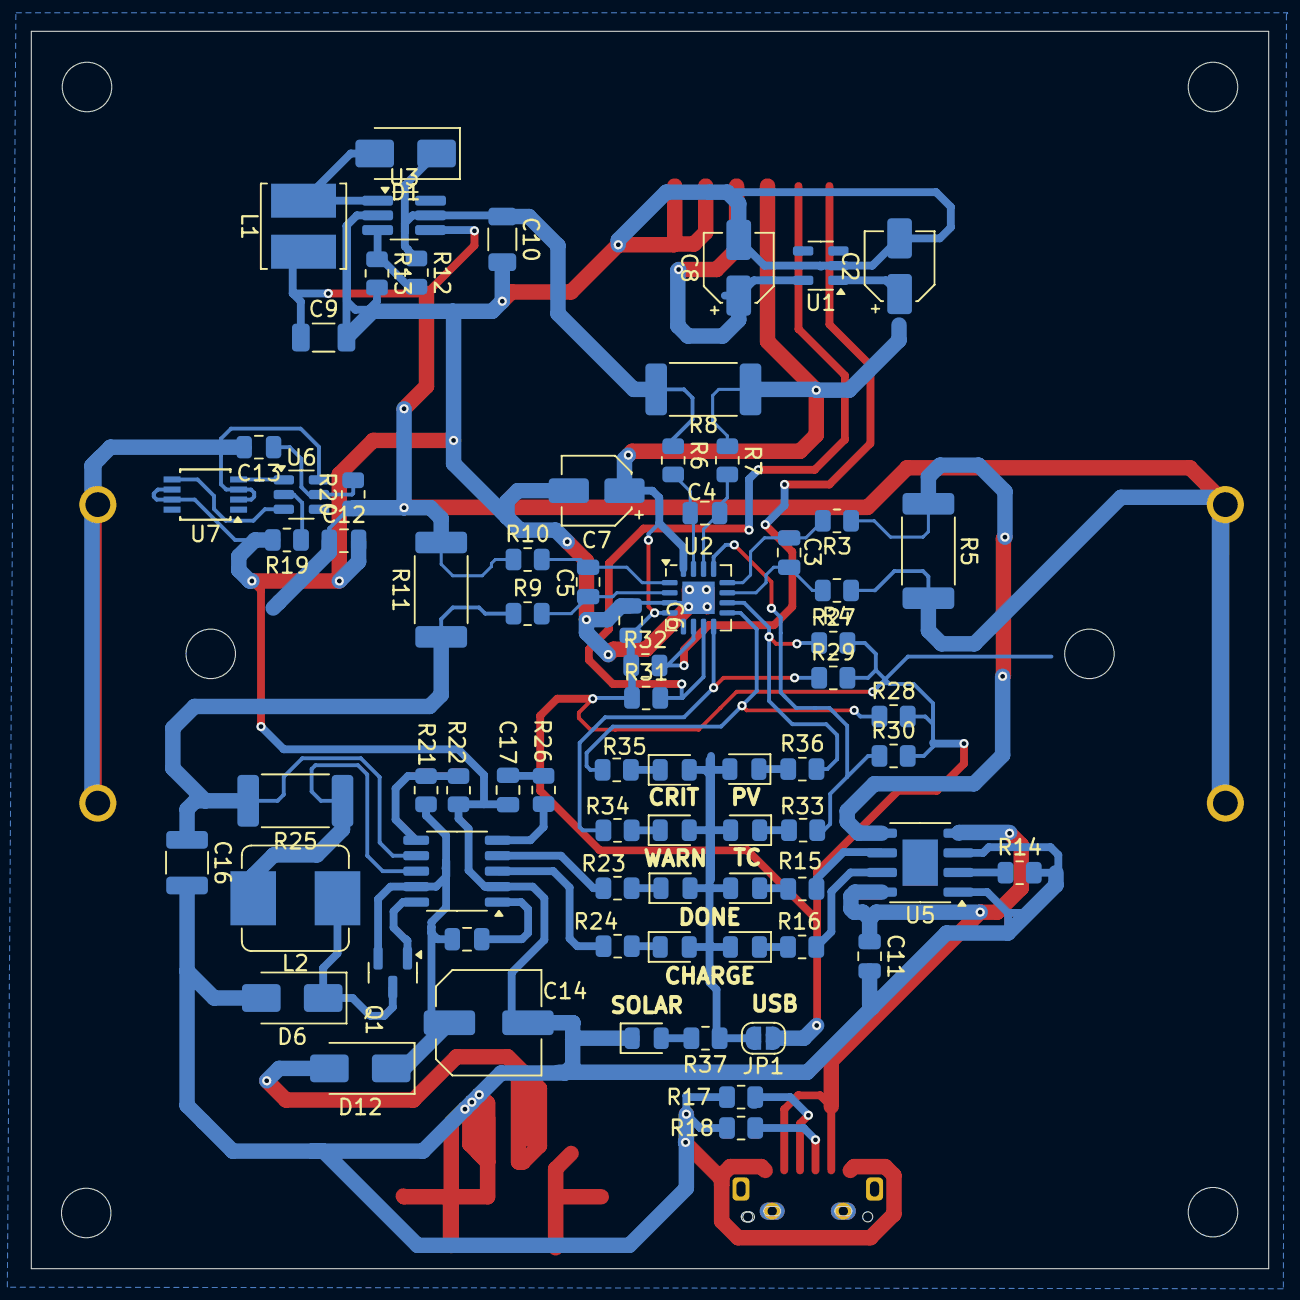
[picture p157: board kubisat_power.kicad_pcb from below]

Board: 2 copper layers, 80.0 x 80.0 mm, 82 parts (74 on the bottom side), 53 nets.
