gredzikk/kubisat/software/rpi-pico/pico-lora-master/src/LoRa-RP2040.h

#ifndef LORA_H
#define LORA_H

// // #include <Arduino.h>
// #include <SPI.h>

#include "pico/stdlib.h"
#include "pico/binary_info.h"
#include "hardware/gpio.h"
#include "hardware/spi.h"
#include "string.h"
#include "Print.h"

//rp2040-zero

/*
#define PIN_MISO 4
#define PIN_CS   1
#define PIN_SCK  2
#define PIN_MOSI 3

#define SPI_PORT spi0
#define READ_BIT 0x80

#define LORA_DEFAULT_SPI           spi0
#define LORA_DEFAULT_SPI_FREQUENCY 8E6
#define LORA_DEFAULT_SS_PIN        1
#define LORA_DEFAULT_RESET_PIN     29
#define LORA_DEFAULT_DIO0_PIN      0
#endif

#define PA_OUTPUT_RFO_PIN          11
#define PA_OUTPUT_PA_BOOST_PIN     12
*/

//pi pico
#define PIN_MISO 16
#define PIN_CS   17
#define PIN_SCK  18
#define PIN_MOSI 19

#define SPI_PORT spi0
#define READ_BIT 0x80

#define LORA_DEFAULT_SPI           spi0
#define LORA_DEFAULT_SPI_FREQUENCY 8E6
#define LORA_DEFAULT_SS_PIN        17
#define LORA_DEFAULT_RESET_PIN     15
#define LORA_DEFAULT_DIO0_PIN      13

#endif

#define PA_OUTPUT_RFO_PIN          11
#define PA_OUTPUT_PA_BOOST_PIN     12


static void __empty();

//class LoRaClass : public Stream {
class LoRaClass : public Print {
public:
  LoRaClass();

  int begin(long frequency);
  void end();

  int beginPacket(int implicitHeader = false);
  int endPacket(bool async = false);

  int parsePacket(int size = 0);
  int packetRssi();
  float packetSnr();
  long packetFrequencyError();

  int rssi();

  // from Print
  virtual size_t write(uint8_t byte);
  virtual size_t write(const uint8_t *buffer, size_t size);

  // from Stream
  virtual int available();
  virtual int read();
  virtual int peek();
  virtual void flush();

  void onCadDone(void (*callback)(bool));
  void onReceive(void (*callback)(int));
  void onTxDone(void (*callback)());

  void receive(int size = 0);
  void channelActivityDetection(void);

  void idle();
  void sleep();

  // size_t print(const char* c);

  void setTxPower(int level, int outputPin = PA_OUTPUT_PA_BOOST_PIN);
  void setFrequency(long frequency);
  void setSpreadingFactor(int sf);
  void setSignalBandwidth(long sbw);
  void setCodingRate4(int denominator);
  void setPreambleLength(long length);
  void setSyncWord(int sw);
  void enableCrc();
  void disableCrc();
  void enableInvertIQ();
  void disableInvertIQ();

  void setOCP(uint8_t mA); // Over Current Protection control

  void setGain(uint8_t gain); // Set LNA gain

  // deprecated
  void crc() { enableCrc(); }
  void noCrc() { disableCrc(); }

  uint8_t random();

  void setPins(int ss = LORA_DEFAULT_SS_PIN, int reset = LORA_DEFAULT_RESET_PIN, int dio0 = LORA_DEFAULT_DIO0_PIN);
  void setSPI(spi_inst_t &spi);
  void setSPIFrequency(uint32_t frequency);

  void dumpRegisters();

private:
  void explicitHeaderMode();
  void implicitHeaderMode();

  void handleDio0Rise();
  bool isTransmitting();

  int getSpreadingFactor();
  long getSignalBandwidth();

  void setLdoFlag();

  uint8_t readRegister(uint8_t address);
  void writeRegister(uint8_t address, uint8_t value);
  uint8_t singleTransfer(uint8_t address, uint8_t value);

  static void onDio0Rise(uint, uint32_t);

private:
  // SPISettings _spiSettings;
  spi_inst_t *_spi;
  int _ss;
  int _reset;
  int _dio0;
  long _frequency;
  int _packetIndex;
  int _implicitHeaderMode;
  void (*_onReceive)(int);
  void (*_onCadDone)(bool);
  void (*_onTxDone)();
};

extern LoRaClass LoRa;
