gredzikk/kubisat/software/kubisat_firmware/includes.h

// Copyright (c) 2025 Jakub Grędzicki
// Licensed under the MIT License. See LICENSE file in the project root for full license information.

#ifndef INCLUDES_H
#define INCLUDES_H

#include <stdio.h>
#include "pico/stdlib.h"
#include "hardware/spi.h"
#include "hardware/i2c.h"
#include "hardware/uart.h"
#include "pico/multicore.h"
#include "event_manager.h"
#include "lib/powerman/PowerManager.h"
#include <pico/bootrom.h>

#include "ISensor.h"
#include "lib/sensors/BH1750/BH1750_WRAPPER.h"
#include "lib/sensors/BME280/BME280_WRAPPER.h"
#include "lib/clock/DS3231.h"
#include <iostream>
#include <iomanip>
#include <queue>
#include <chrono>
#include "protocol.h"
#include "LoRa-RP2040.h"
#include <atomic>
#include <iostream>
#include <map>
#include "pin_config.h"
#include "utils.h"
#include "communication.h"
#include "build_number.h"
#include "lib/location/gps_collector.h"
#include "lib/storage/storage.h"
#include "lib/storage/pico-vfs/include/filesystem/vfs.h"
#include "telemetry_manager.h"
#include "system_state_manager.h"

#endif
