gredzikk/kubisat/software/rpi-pico/FULL-TEST/all_sensors_test/ISensor.h

// ISensor.h
#ifndef ISENSOR_H
#define ISENSOR_H

#include <cstdint>
#include "hardware/i2c.h"
#include <map>
#include <string>

enum class SensorType {
    LIGHT,      // BH1750
    POWER,      // INA3221
    TIME,       // DS3231
    ENVIRONMENT // BME280
};

enum class DataType {
    LIGHT_LEVEL,
    CURRENT_CH1,
    CURRENT_CH2,
    CURRENT_CH3,
    VOLTAGE_CH1,
    VOLTAGE_CH2,
    VOLTAGE_CH3,
    TIMESTAMP,
    TEMPERATURE,
    PRESSURE,
    HUMIDITY,
    RADIO_RSSI,
    RADIO_SNR
};

class ISensor {
public:
    virtual ~ISensor() = default;
    virtual bool init() = 0;
    virtual float readData(DataType type) = 0;
    virtual bool isInitialized() const = 0;
    virtual SensorType getType() const = 0;
    virtual bool configure(const std::map<std::string, std::string>& config) = 0;

};

class SensorWrapper {
public:
    static SensorWrapper& getInstance();
    bool initSensor(SensorType type, i2c_inst_t* i2c = nullptr);
    bool configureSensor(SensorType type, const std::map<std::string, std::string>& config);
    float readSensorData(SensorType sensorType, DataType dataType);

private:
    std::map<SensorType, ISensor*> sensors;
    SensorWrapper();
};

#endif // ISENSOR_H
