gredzikk/kubisat/(commit log)

2024-08-22 3d model v2, added BOM
2024-09-11 added image and pdf sources, updated schematic
2024-09-26 complete schematic, todo add solar connectors
2024-09-29 changed battery holder
2024-10-01 completed schematic with solar connectors, changed 3v3 regulator
2024-10-02 arranged elements on board, made some traces
2024-10-02 more traces
2024-10-03 added MCU based on arduino zeros ATSAMD21G18A
2024-10-21 added software - ina3221 and camera scripts
2024-10-22 added arduino code, more items on main schematic
2024-10-23 added elements and traces to main pcb
2024-10-24 added microsd footprint
2024-10-28 added new code to serialize and deserialize sensor data to hex format, added not yet working unit tests
2024-10-29 working cpp version, todo add physical sensor data reading to test working of this
2024-11-06 added pico-lora github library and configured to work on 2 separate picos
2024-11-07 working terminal prototype
2024-11-15 added elements to cpu schematic
2024-11-15 added pcb elements
2024-11-25 changed strucutre, split main into 2 sseparate boards
2024-11-26 completed (?) mainboard schematic
2024-11-27 finished main board
2025-02-26 added sensors board
2025-03-18 added 3d models of boards
2026-10-19 Bump kubisat_operator to SEQ+CRC protocol and UI catch-up.
    Point the nested operator gitlink at the commit that adds integrity framing, retries, and health/IMU/8.4 support.
